Tangineering/DC-Balancer-Board-Teensy/controller_design/README.md

# controller_design — Robust H∞ / Youla-H Power Balance Controller

Design workspace for the controller that replaced `PI_Controller_Power()` in
`teensy_controller/teensy_controller.ino`, following
*A Practical Youla Gain-Tuning Framework for H∞ Controller Realization*
(`references/A_Practical_Youla_Gain_Tuning_Framework_for_H__Controller_Realization_20260603.pdf`).

**Status (2026-07-10): designed, implemented, and host-validated.** The Youla-H
controller ships in the firmware (`USE_YOULA_SHARE_CONTROLLER = 1`; legacy PI retained
as a fallback path). Remaining work is bench calibration → regenerate (see the
recalibration loop in `controller_synthesis.md` §7).

## Contents (read in this order)

| File | What it is |
|---|---|
| [`system_model.md`](system_model.md) | **Step 1 — the plant.** Droop circuit → programmable Thevenin source → parallel-source share statics → disturbance/uncertainty/noise budget → sampled-loop dynamics → design plant $G_P(s)$, parameter table with sources + `TODO(calibrate)`, bench-ID plan (§9). |
| [`validate_model.py`](validate_model.py) | Numerical validation of the plant derivation (stdlib Python; all checks pass). Found the firmware `k_eq` MDAC-saturation bug. |
| [`controller_synthesis.md`](controller_synthesis.md) | **Step 2 — the controller.** H∞ mixed-sensitivity setup, γ results, Youla-H $T(0)=1$ step, order reduction, discretization, the full validation table (60-corner sweep, margins, time domain, legacy-PI comparison), C++ mapping, recalibration loop. |
| [`hinf_synthesis.py`](hinf_synthesis.py) | Self-contained H∞ synthesis library (Riccati via Hamiltonian/Schur, DGKF central controller, H∞ norm, balanced truncation, c2d). Run directly for its self-tests. |
| [`synthesize_controller.py`](synthesize_controller.py) | **The pipeline.** Regenerates the firmware coefficients + reference vectors + figures data and re-runs every validation gate. Run after any parameter change. |
| [`plot_results.py`](plot_results.py) | Renders the three thesis figures from the CSVs. |
| [`bench_calibration_manual.md`](bench_calibration_manual.md) | **Step 3 — the bench.** Equipment, safety rules, and CAL-1…5 procedures for measuring every `TODO(calibrate)` value with State 98, plus the constant-update map and regeneration sequence, and a record-sheet template. |
| [`full_order_validation.md`](full_order_validation.md) | **Empirical validation of the simplified plant.** Full-order model (complete TPS61288 DS §9.2.2.5 dynamics, 11 states) vs the §6d design plant: derivation, 432-point envelope study, closed-loop equivalence with the shipped controller. |
| [`tps61288_full_model.py`](tps61288_full_model.py) | Builds the full-order model and runs the gate-checked comparison battery (Norton≡Eq.7, DC gain, crossover cross-check, Bode/envelope, discrete CL). Emits `fullorder_*.csv` + `fullorder_metrics.txt`. |
| [`full_order_model.m`](full_order_model.m) | MATLAB mirror of the full-order comparison (same state-space assembly); writes `MATLAB_fullorder_validation.txt` + `figures/MATLAB_fullorder_*.png`. |
| [`droop_plant.m`](droop_plant.m) | MATLAB cross-validation harness for the **shipped** controller: re-runs the synthesis with the exact shipped weights, parses `share_controller_coeffs.h`, and re-runs the corner/step/ramp battery on it. Writes `MATLAB_validation.txt` + three `figures/MATLAB_*.png` automatically. |
| `MATLAB_validation.txt` | GENERATED by `droop_plant.m` — the cross-validation log. (`MATLAB_results.txt` is the pre-alignment run kept for the record.) |
| [`reference_vectors.h`](reference_vectors.h) | GENERATED — Python-reference I/O replayed by the C++ unit test. |
| `synthesis_metrics.txt` | GENERATED — numeric summary of the current design. |
| `figures/` | Thesis figures (SVG) + raw CSV data: plant diagrams, loop shapes, controller Bode, step/ramp time domain. |

Firmware pieces live in `teensy_controller/`: `share_controller.h` (runtime),
`share_controller_coeffs.h` (GENERATED coefficients).

## Environment

```
uv venv ctrl-venv && uv pip install --python ctrl-venv numpy scipy matplotlib
ctrl-venv/Scripts/python hinf_synthesis.py        # library self-tests
ctrl-venv/Scripts/python validate_model.py        # plant-model checks
ctrl-venv/Scripts/python synthesize_controller.py # full pipeline + artifact regen
ctrl-venv/Scripts/python plot_results.py          # figures
cd ../test && mingw32-make                        # firmware host tests (MSYS2)
```

## Key results

- Plant: $\alpha = r + \Delta V_0 r(1-r)/(k_d I_{tot})$ — exactly unity nominal gain,
  delay-dominated dynamics ($T_d \approx 1$ ms at the 1 kHz loop).
- H∞: $\gamma_{opt} = 0.653$; Youla-H shifts the Y gain +0.0036 % → $T(0) = 1$ exact.
- Implemented controller: integrator ($k_I = 111.9$) + 3 biquad states at $T_s = 1$ ms.
- Robustness: all 60 parameter corners stable; worst $M_2 = 0.59$; delay margin 11.7 ms.
- vs legacy PI at the worst corner (discrete $\|S\|_\infty$): **1.87 vs 26.9**.
