Tangineering/DC-Balancer-Board-Teensy/controller_design_MIMO/mimo_comparison.md

# MIMO vs. Decentralized — Comparison Results (Phase 5)

> ## ⚠ STALE — built on a retired plant (2026-08-16)
>
> Every number in this document was produced against the **pre-calibration** drive plant.
> The drive channel was measured on 2026-08-16 (`calibration/motor_id_20260815.md`), moving
> `G22(0)` 3.7085 → 1.4112 (m/s)/A, the drive pole −0.1219 → −0.0914 rad/s and `G12(0)`
> −2.757e-2 → −1.326e-2, with the clamp 20 A → 12 A. Drive-channel and coupling figures
> throughout are therefore stale — including the "slowest closed-loop mode 0.1219 rad/s"
> row in the headline table, which *is* the old drive pole and moves with it.
>
> `compare_controllers.py` cannot regenerate this document as it stands: it hard-crashes at
> stage 6 on a 20 A clamp assertion, and the MIMO controller it compares against no longer
> passes its own synthesis gates on the calibrated plant. Restoring the comparison is a new
> synthesis round, not a re-run. Scope and per-stage detail: `README.md` staleness banner.
>
> The document is kept as the published record of the ±20 A round.

**Status:** complete. All numbers in this document are emitted by
`compare_controllers.py` into `comparison_metrics.txt`; the metric key is quoted in every
table. Figures are produced by `plot_mimo_results.py` from the CSVs in `figures/`.

**Reproduce:**

```
ctrl-venv/Scripts/python.exe compare_controllers.py     # ~50 s, writes comparison_metrics.txt + figures/*.csv
ctrl-venv/Scripts/python.exe plot_mimo_results.py       # ~5 s,  writes figures/fig_*.svg
```

This document mirrors the rigour convention of `controller_design/full_order_validation.md`:
setup first, then the metric tables with their provenance keys, then a findings section that
answers the questions posed in `papers/Droop_Control/sections/06_mimo_outlook.tex`, then the
honest caveats, then a claim-slot map. **`06_mimo_outlook.tex` itself is NOT edited by this
round** — this document is the evidence base a later writing round would draw on.

> **±20 A recalibration round — 2026-08-04.** `MOTOR_I_CMD_MAX` / `I_CLAMP` moved
> **5 A → 20 A** and both controllers were re-synthesized. **Every number in this document
> is regenerated at ±20 A.** The superseded ±5 A figures are not deleted — §14 is a dated
> summary of what changed and why, and individual tables carry the old value where the
> comparison is instructive. Read §14 first if you have the ±5 A version in mind.

---

## 1. What is compared

| | **`dec`** (decentralized baseline) | **`dec500`** (rate-confound variant) | **`mimo`** (centralized) |
|---|---|---|---|
| Structure | `blkdiag(K_share, K_drive)` | same | full 2×2 |
| Share half | shipped Youla-H share controller, **1 kHz** | same controller re-discretized (Tustin) at **500 Hz** | — |
| Drive half | Phase-3 SISO Youla-H drive controller, **500 Hz** | same | — |
| Whole | — | — | Phase-4 2×2 H∞ / Youla-H, **500 Hz** |
| Continuous states | 9 (4 share + 5 drive) | 9 | **9** (2 exact integrators + **7** modal) |
| Anti-windup | share: back-calculation on the integrator (the shipped scheme); drive: **Hanus self-conditioning** (required — see §7) | same | `Du⁻¹·δ` back-calculation on the integrator subspace + authority clamp |
| Metric keys | `ctrl.dec.*` | — | `ctrl.mimo.*` |

The essential fairness condition: **both controllers are closed against the same coupled
2×2 plant**, using the same closed-loop assembly routine (`loop_matrices`, copied verbatim
from `synthesize_mimo_controller.py`), the same corner sets, and the same simulations. The
decentralized controller is never evaluated on a diagonal plant — that would flatter it by
construction.

### 1.1 Corner sets

* **Tier 1** (stability): the full `plant_mimo.tier1_corners()` cross product, 10 OPs × 24
  share corners × 24 drive corners = 5760, of which **4992 are feasible**
  (`tier1.n_feasible`) and 768 are skipped as unidirectional-switch-clamped operating points
  (`tier1.n_infeasible_skipped`).
* **Tier 2** (performance): the rep set is **copied verbatim** from
  `synthesize_mimo_controller.py:549–596` — 6 share reps × 4 drive reps × the OP grid, minus
  infeasible combinations = **208 corners** (`tier2.n_corners`), of which **168 are
  in-envelope** (`tier2.n_corners_in_envelope`) and 40 fall in the two documented waiver
  families (24 FC-cruise, 16 K-out-of-envelope). The waiver policy and its physical
  justification are copied along with the rep set, so the two controllers are judged on
  identical terms.

### 1.2 Rates and simulation

Time-domain results use a **multirate discrete simulator**, base step **0.1 ms**, plant
ZOH-discretized at the base rate per corner, controller outputs held between ticks. `dec`
runs its two halves at their native 1 kHz / 500 Hz; `mimo` runs single-rate at 500 Hz;
`dec500` exists purely to isolate the rate difference as a confound.

Frequency-domain results use **continuous** physical-coordinate controllers, recovered from
the emitted headers by exact inverse-Tustin plus the analytic `KI/s` integrator, so the two
controllers are compared as 2×2 systems `e = [Δα_err; Δv_err] → u = [Δr; Δi_cmd]`.

**All time-domain signals are small-signal deviations about the operating point** (nominal
OP: `I_tot0 = 2 A`, `r0 = 0.5`, `ΔV0 = +0.2 V`, `v0 = 2 m/s`). Every step amplitude is stated
in the tables, and the actuator-limited cases are flagged.

---

## 2. Metric 1 — coupling quantification (plant only)

This is the evidence for "is the decentralized design justified or merely convenient".

| Quantity | nominal (2 A, r=0.5) | light load (0.5 A) | FC cruise (r=0.85) | key |
|---|---|---|---|---|
| peak \|G_s,12\|/\|G_s,11\| | 1.5710 | **25.136** | 1.0451 | `coupling.*.max_G12_over_G11` |
| same, at DC | 1.5710 | 25.136 | 1.0451 | `coupling.*.G12_over_G11_at_dc` |
| cond(G_s) at DC | 21.238 | 51.064 | 27.588 | `coupling.*.cond_Gs_at_dc` |
| cond(G_s), in-band (DC…200 rad/s) | 101.9 | 6429.5 | 67.5 | `coupling.*.max_cond_Gs_inband` |
| ∂α/∂I_tot [share/A] | −0.04167 | **−0.66667** | −0.02125 | `coupling.*.dalpha_dItot` |

Over the whole feasible OP × ΔV0 grid (26 of 30 points feasible,
`coupling.dalpha_dItot.n_feasible`):

| Quantity | Value | Where | Key |
|---|---|---|---|
| worst \|∂α/∂I_tot\| | **1.120 share/A** | 0.5 A, r0=0.7, ΔV0=−0.4 V | `coupling.dalpha_dItot.max_abs_feasible` |
| worst DC cond(G_s) | 51.15 | — | `coupling.grid.max_cond_Gs_at_dc` |
| worst in-band cond(G_s) | 8834.6 | 0.5 A, r0=0.3, ΔV0=+0.4 V | `coupling.grid.max_cond_Gs_inband` |
| worst \|G_s,12\|/\|G_s,11\| | 25.14 | 0.5 A, r0=0.5, ΔV0=+0.2 V | `coupling.grid.max_G12_over_G11` |
| max \|RGA − I\| | **2.23e−16** | all cases, all frequencies | `coupling.max_RGA_departure_from_I` |

**Structure.** The design plant is *structurally upper-triangular* (`G21 ≡ 0`: the droop
ratio does not move the wheel speed), so the RGA is the identity to machine precision at
every frequency and every corner. RGA-based interaction measures therefore say *nothing*
here — a one-directional coupling is invisible to the RGA. This is a real methodological
point for the paper: **the RGA is the wrong instrument for this plant**, and the correct
instruments are the directional ratio |G12|/|G11| and the closed-loop cross-transfer
‖T_{α←v_ref}‖ (§3).

**These ratios are SCALED quantities and moved 4× with the clamp.** `G_s,12` carries
`Du(2,2)` (5 → 20 A) while `G_s,11` carries the unchanged `Du(1,1)`. The **physical**
coupling is identical to the ±5 A round; what changed is the units the synthesis and these
tables express it in. ±5 A values: 0.393 / 6.284 / 0.261 nominal / light-load / FC-cruise.

**Magnitude.** The coupling is not negligible and is strongly operating-point-dependent: at
the nominal 2 A load the drive-to-share path is now **1.6×** the direct path — it was 39 % of
it at ±5 A — and at 0.5 A it is **25×** the direct path, because ∂α/∂I_tot scales as
1/I_tot². That the nominal ratio crossed 1 is the substantive change: at the design point a
full-authority motor transient now has **more** authority over the share than a full-authority
droop command does. It is also **sign-uncertain**:
it is exactly zero at ΔV0 = 0 and flips sign with ΔV0, whose sign is not known
(±0.4 V budget). That single fact bounds everything a MIMO feedforward can buy — see §9.

*Note on the condition number:* the "in-band" window (DC…200 rad/s) is used deliberately.
cond(G_s(jω)) → ∞ as ω → ∞ for any strictly-proper plant whose two channels roll off at
different orders, so the full-sweep maximum (`coupling.*.max_cond_Gs_full_sweep`,
3.7e3–1.9e4) measures roll-off asymmetry, not coupling, and would be misleading in a table.

**Figures:** `fig_coupling_sigma.svg` (σ̄/σ̲ of G_s + the |G12|/|G11| overlay),
`fig_coupling_cond.svg`, `fig_coupling_gain_grid.svg`.

---

## 3. Metric 2 — worst-corner sensitivity, identical Tier-2 set

### 3.1 Nominal plant

| Quantity | `dec` | `mimo` | key |
|---|---|---|---|
| ‖S_o‖∞ (σ̄ peak) | 1.3974 | **1.2287** | `nominal.*.sigma_So_peak` |
| \|S11\| peak (share) | 1.2523 | **1.2114** | `nominal.*.S11_peak` |
| \|S22\| peak (drive) | 1.3851 | **1.2285** | `nominal.*.S22_peak` |
| ‖T_{α←v_ref}‖∞ [share/(m/s)] | 0.25676 | **0.00131** | `nominal.*.T_alpha_from_vref_peak` |
| slowest closed-loop mode [rad/s] | 0.00400 | **0.1219** | `nominal.*.max_real_cl_pole` |
| σ̄(S_u) peak (input node) | 1.3852 | **1.2385** | `compute_Su.py` |

The `dec` column is **unchanged from the ±5 A round** — every quantity here is a linear
frequency-domain one, and the decentralized controller was not re-synthesized (its clamp
metadata moved, its dynamics did not). Only the MIMO column moves.

At the nominal design point the MIMO controller reduces the closed-loop cross-coupling
transfer by a factor of **195** (±5 A: 293). This is the headline "MIMO buys coupling rejection" number —
and §9 explains exactly why it does not survive the ΔV0 sign flip.

### 3.2 Tier-2 corner family (168 in-envelope corners)

| Quantity | `dec` | `mimo` | key |
|---|---|---|---|
| worst σ̄(S_o), in-envelope | 2.5535 | **1.8754** | `tier2.*.worst_sigma_So_in_envelope` |
| worst \|S11\| peak | 1.5769 | **1.3721** | `tier2.*.worst_S11_peak_in_envelope` |
| worst \|S22\| peak | 2.4062 | **1.6743** | `tier2.*.worst_S22_peak_in_envelope` |
| worst ‖T_{α←v_ref}‖∞ | 0.8480 | **0.8020** | `tier2.*.worst_T_alpha_from_vref_in_envelope` |
| continuous-unstable corners | 0 | 0 | `tier2.*.n_unstable` |
| worst σ̄(S_o), FC-cruise (waived) | 2.4960 | **1.7471** | `tier2.*.waived_FC_cruise_worst_sigma_So` |
| worst σ̄(S_o), K-out-of-envelope (waived) | **5.7702** | 4.9334 | `tier2.*.waived_K_out_of_envelope_worst_sigma_So` |
| σ̄(S_u), worst Tier-2 corner (input node) | 1.8640 | **1.4749** | `compute_Su.py` |

Head-to-head: MIMO has the lower σ̄(S_o) at **167 of 168** in-envelope corners
(`tier2.mimo_better_sigma_So_count`; ±5 A: 156 of 168). The Phase-4 numbers reproduce exactly
(worst in-envelope 1.8754; waived K-out-of-envelope 4.9334), confirming the harness assembles
the MIMO loop the same way its synthesis script did.

**Two ±20 A reversals worth naming.** (a) The MIMO controller now wins the **worst-corner
cross-coupling transfer** too (0.8020 vs 0.8480) — at ±5 A the decentralized pair won that
row (0.8480 vs 1.1467). (b) The MIMO controller is now **better than** the decentralized pair
on the waived K-out-of-envelope family (4.93 vs 5.77) where at ±5 A it was nearly 2× worse
(10.82 vs 5.77). Both are consequences of the it.5 weight re-tune
(`mimo_synthesis.md` §3.2), which bought corner robustness at the price of γ and of a little
nominal performance.
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
