Tangineering/DC-Balancer-Board-Teensy/controller_design/figures/MATLAB-Fig-1.png

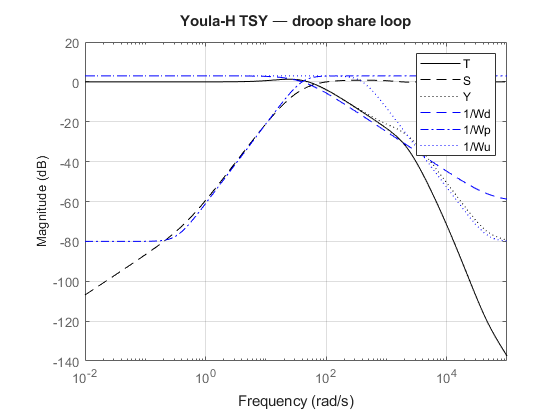
controller_design/figures/MATLAB-Fig-1.png
