Tangineering/DC-Balancer-Board-Teensy/controller_design/figures/MATLAB-Fig-2.png

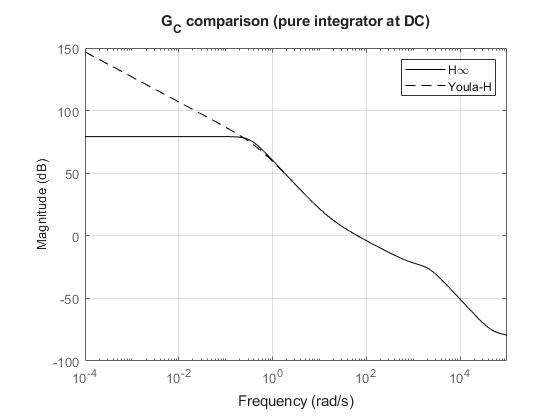
controller_design/figures/MATLAB-Fig-2.png
