Tangineering/DC-Balancer-Board-Teensy/controller_design/figures/MATLAB_Gc_shipped_vs_matlab.png

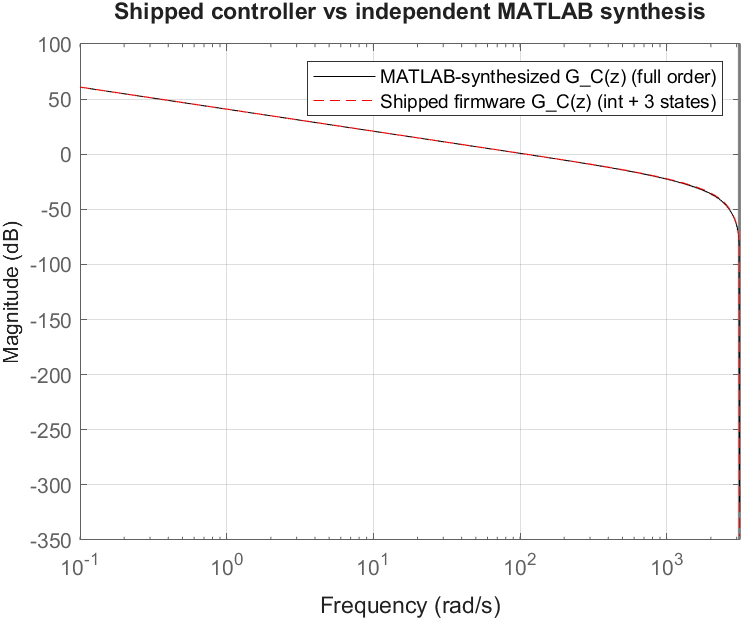
controller_design/figures/MATLAB_Gc_shipped_vs_matlab.png
