Tangineering/DC-Balancer-Board-Teensy/controller_design/figures/MATLAB_loopshapes_exactweights.png

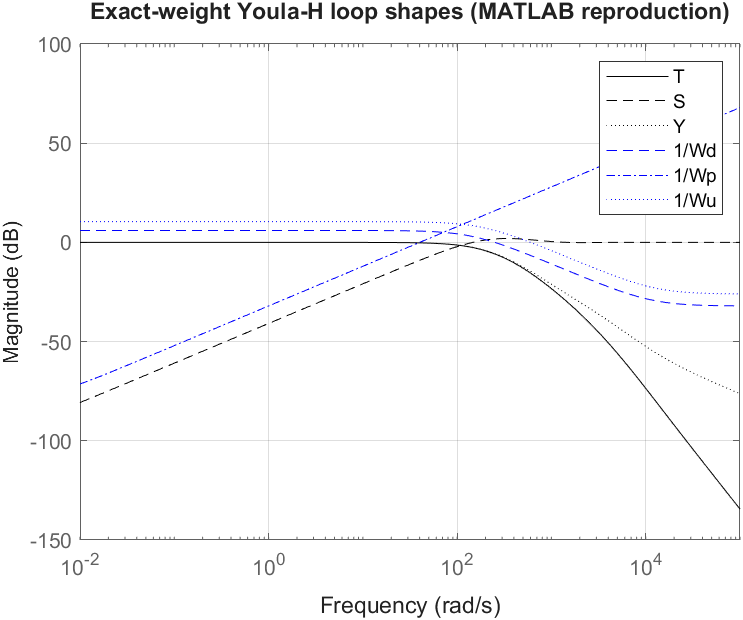
controller_design/figures/MATLAB_loopshapes_exactweights.png
