Tangineering/DC-Balancer-Board-Teensy/controller_design_MIMO/figures/MATLAB_mimo_corner_scatter.png

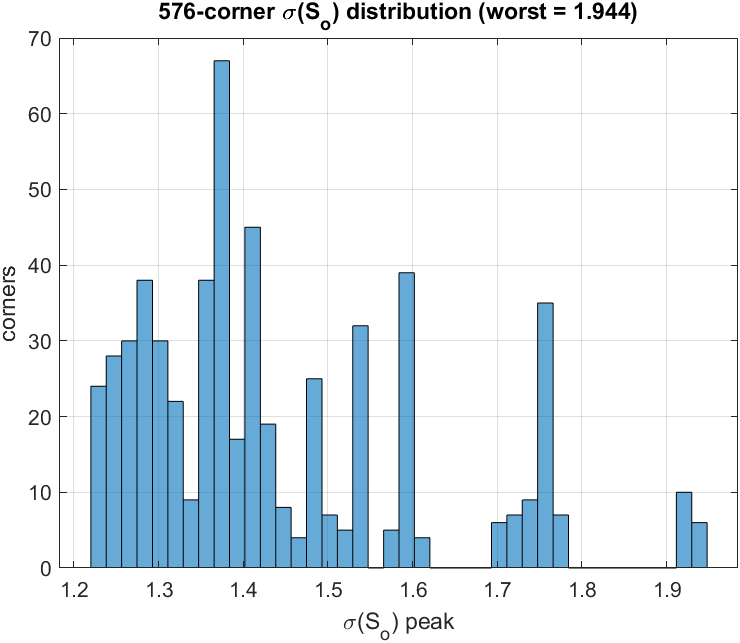
controller_design_MIMO/figures/MATLAB_mimo_corner_scatter.png
