Tangineering/DC-Balancer-Board-Teensy/controller_design_MIMO/figures/MATLAB_mimo_sigmaS.png

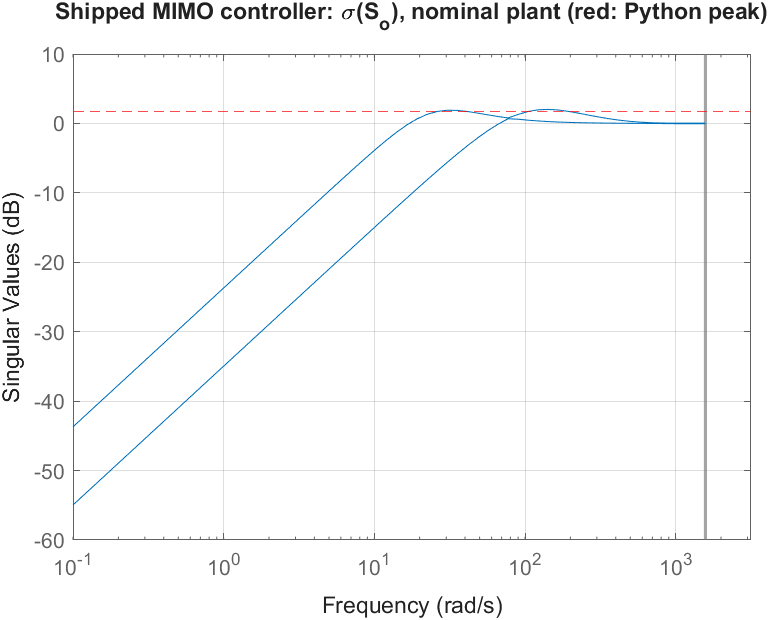
controller_design_MIMO/figures/MATLAB_mimo_sigmaS.png
