Tangineering/DC-Balancer-Board-Teensy/docs/balancer_board_showcase_20260817/balancer_board_showcase_20260817/03_setpoint_governor/TP0116/bus_and_share.png

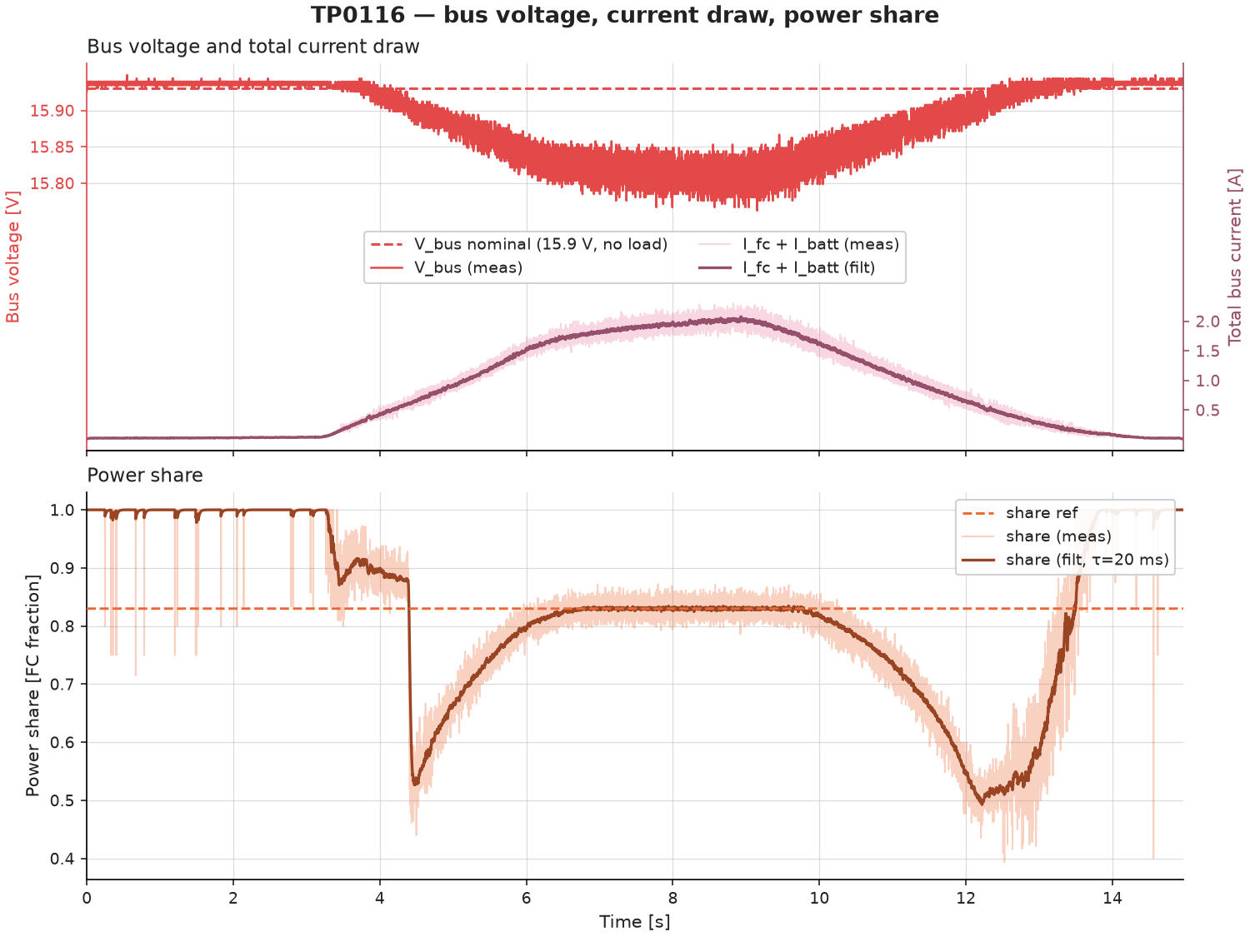
docs/balancer_board_showcase_20260817/balancer_board_showcase_20260817/03_setpoint_governor/TP0116/bus_and_share.png
