Tangineering/DC-Balancer-Board-Teensy/docs/balancer_board_showcase_20260817/balancer_board_showcase_20260817/04_open_closed_loop_handoff/handoff_threshold_bracket.png

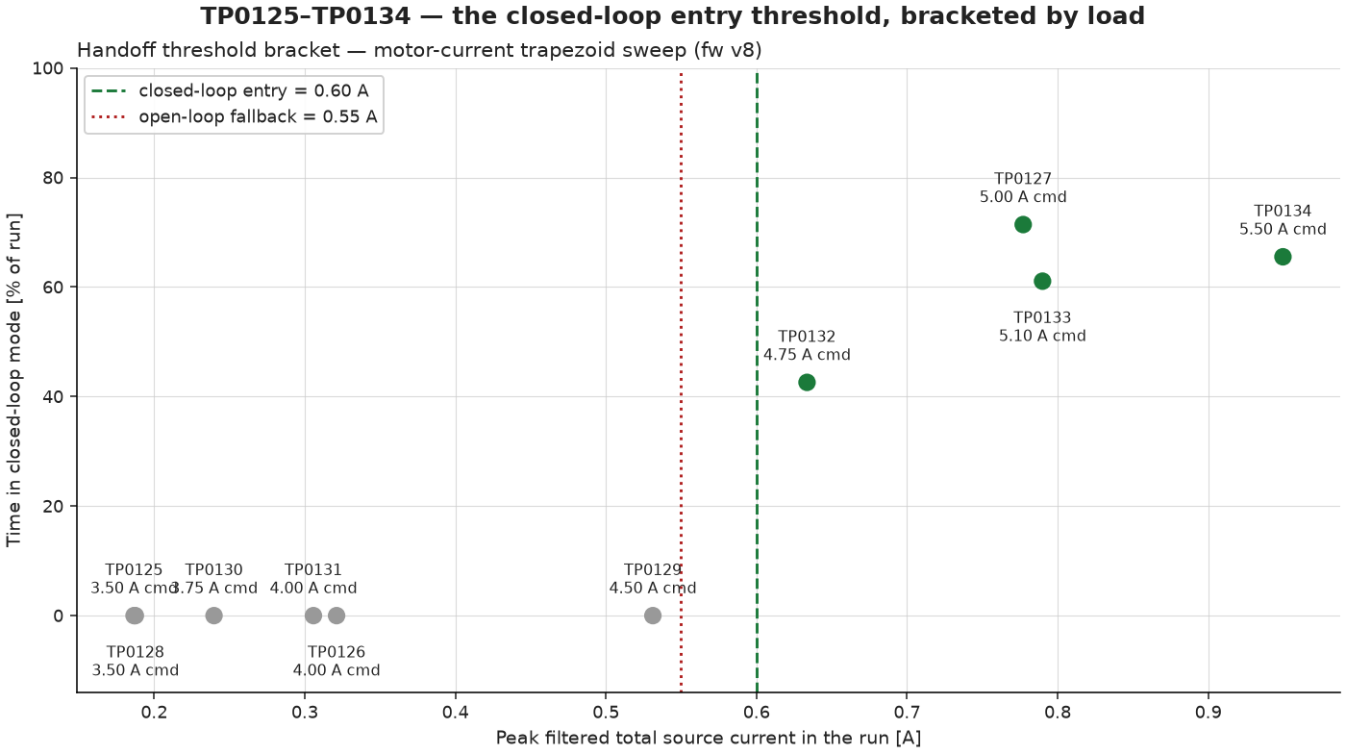
docs/balancer_board_showcase_20260817/balancer_board_showcase_20260817/04_open_closed_loop_handoff/handoff_threshold_bracket.png
