Tangineering/DC-Balancer-Board-Teensy/docs/balancer_board_showcase_20260817/balancer_board_showcase_20260817/04_open_closed_loop_handoff/TP0129/bus_and_share.png

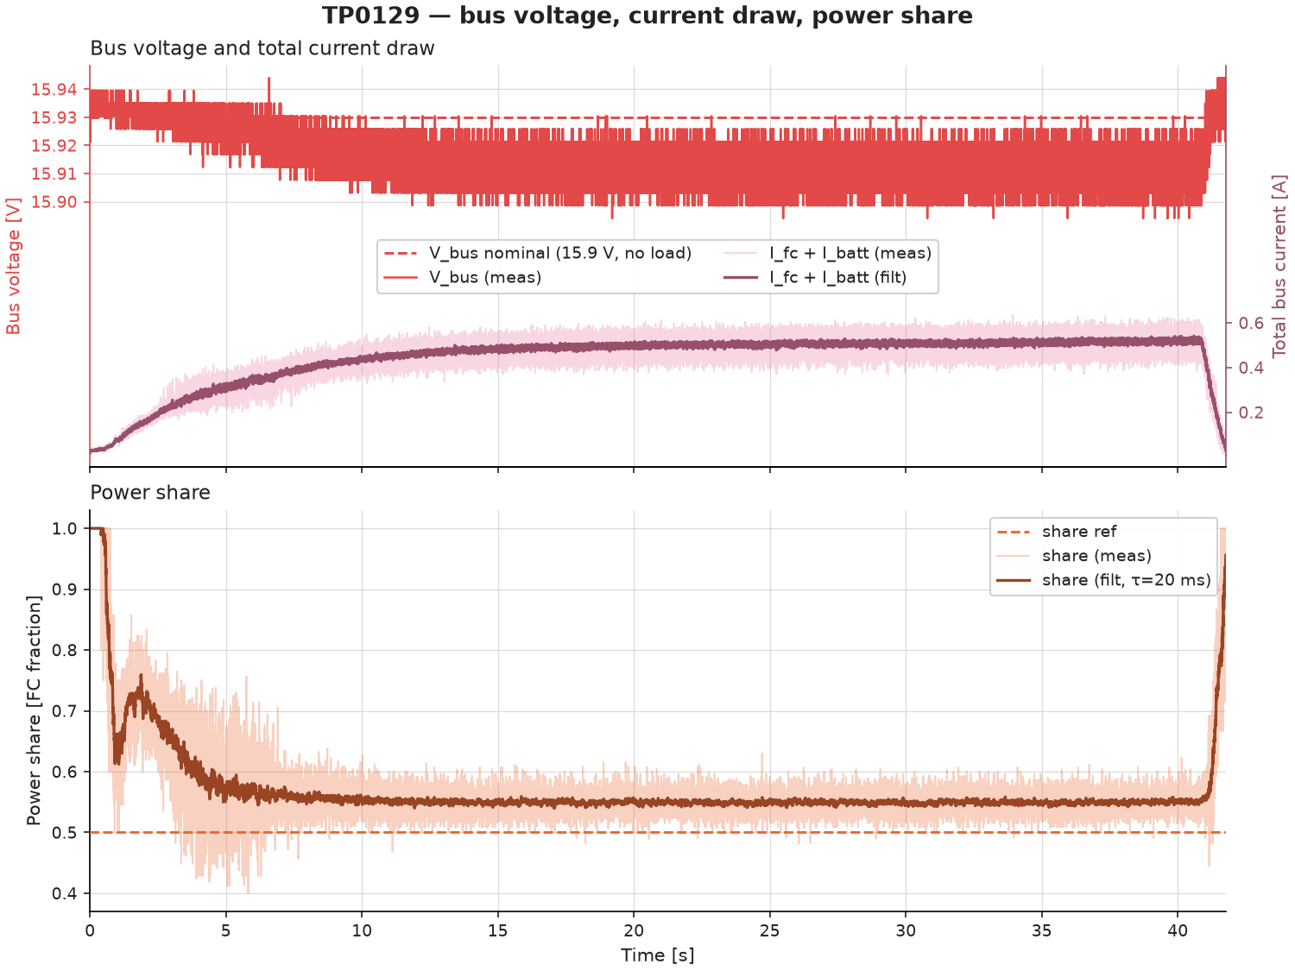
docs/balancer_board_showcase_20260817/balancer_board_showcase_20260817/04_open_closed_loop_handoff/TP0129/bus_and_share.png
