Tangineering/DC-Balancer-Board-Teensy/docs/modeling/asymmetry_fit_20260901/by_firmware.png

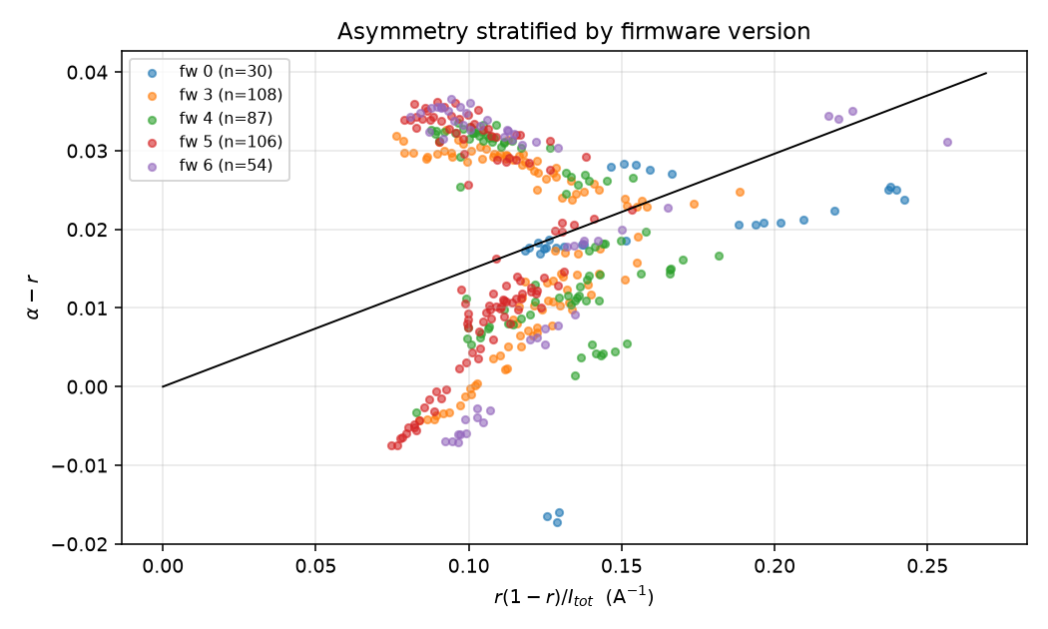
docs/modeling/asymmetry_fit_20260901/by_firmware.png
