Tangineering/DC-Balancer-Board-Teensy/docs/modeling/asymmetry_fit_20260901/r_vs_alpha.png

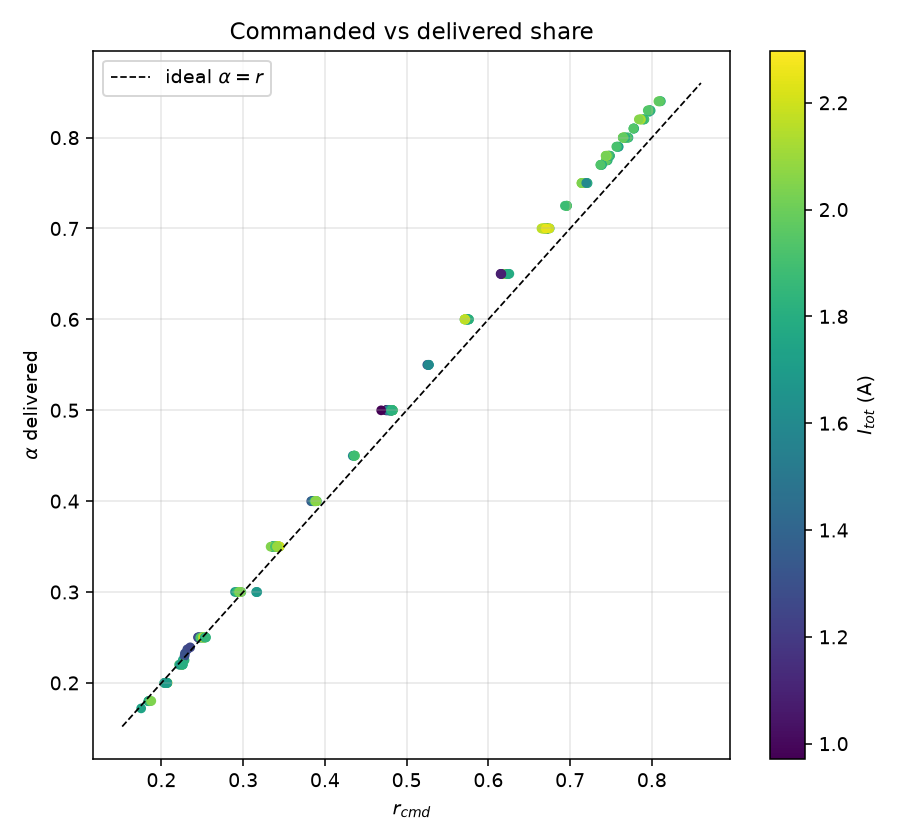
docs/modeling/asymmetry_fit_20260901/r_vs_alpha.png
