Tangineering/DC-Balancer-Board-Teensy/docs/modeling/bond-graph-bgt/00_top_level.png

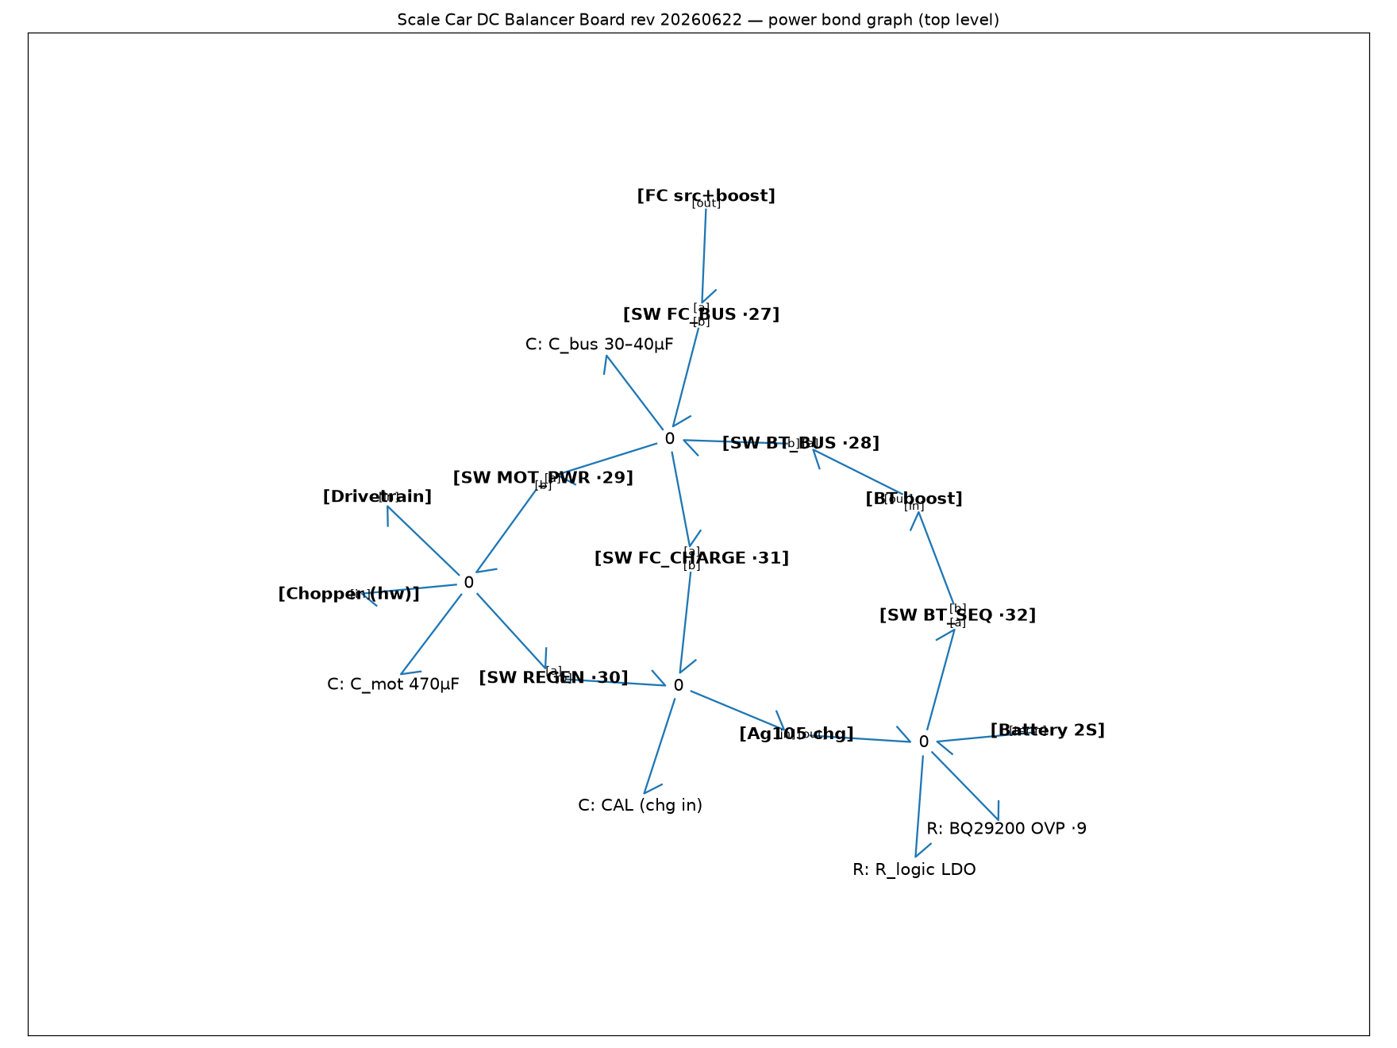
docs/modeling/bond-graph-bgt/00_top_level.png
