Tangineering/DC-Balancer-Board-Teensy/docs/modeling/bond-graph-bgt/01_fc_source_boost.png

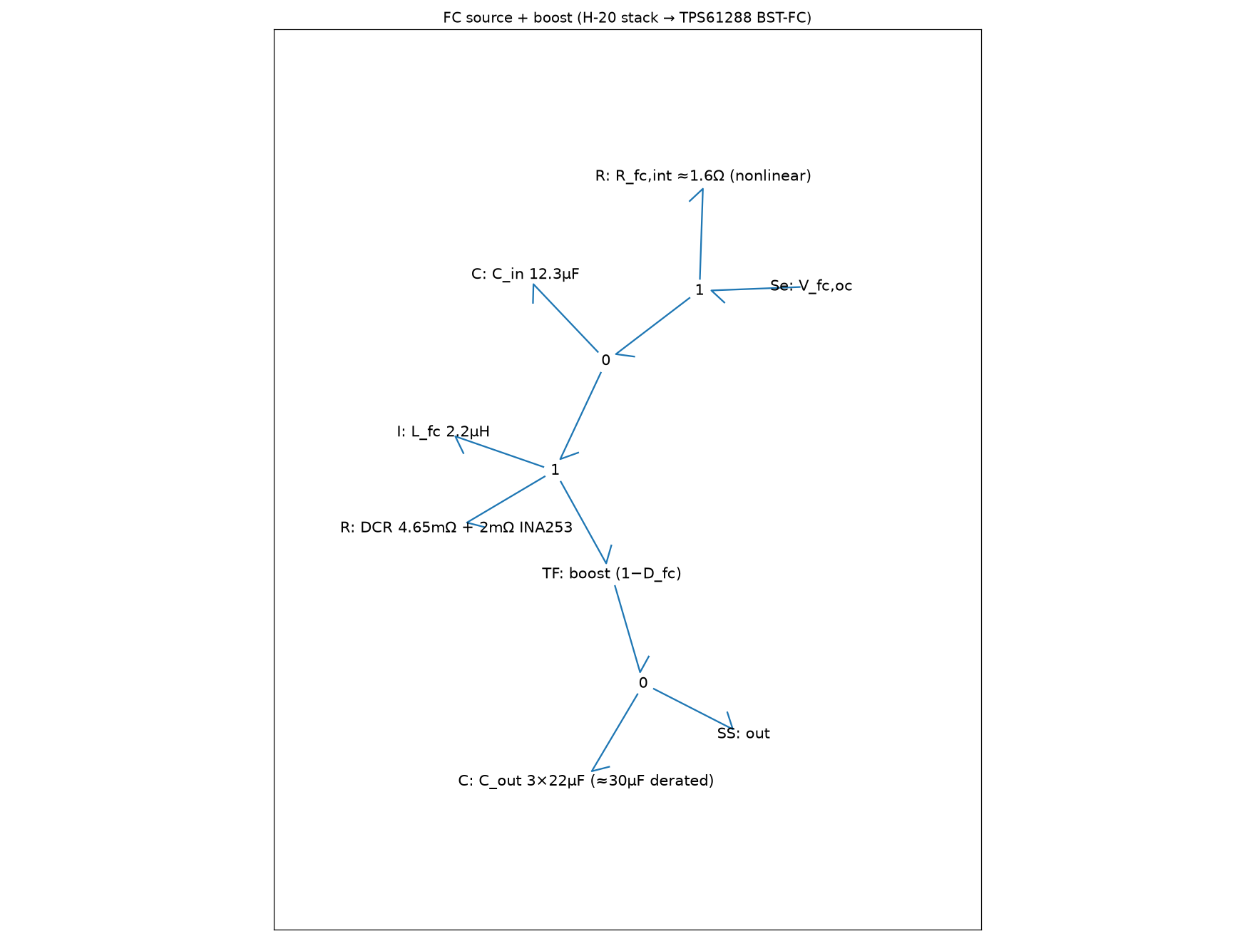
docs/modeling/bond-graph-bgt/01_fc_source_boost.png
