Tangineering/DC-Balancer-Board-Teensy/docs/modeling/bond-graph-bgt/02_bt_boost.png

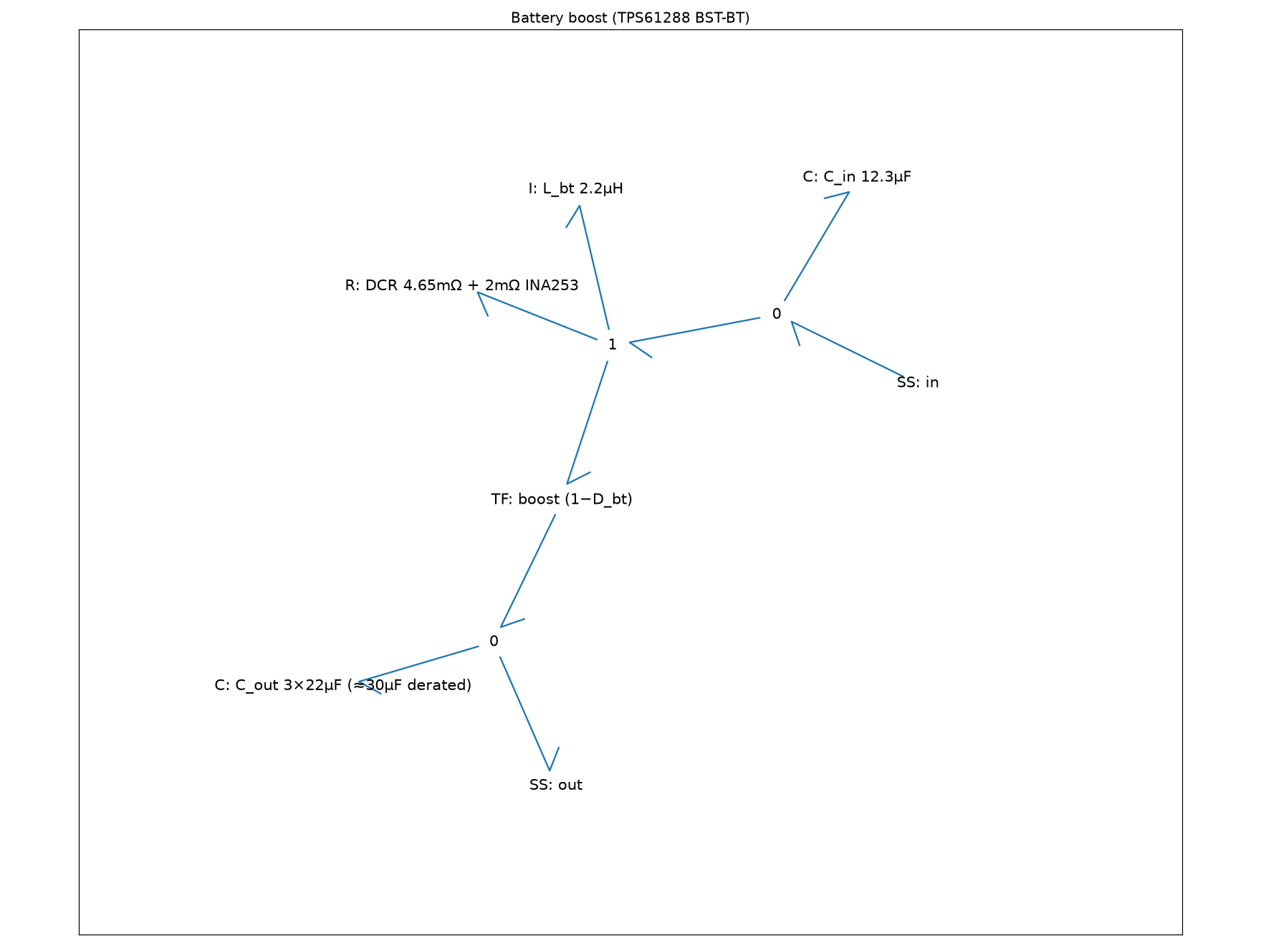
docs/modeling/bond-graph-bgt/02_bt_boost.png
