Tangineering/DC-Balancer-Board-Teensy/docs/modeling/bond-graph-bgt/03_battery_pack.png

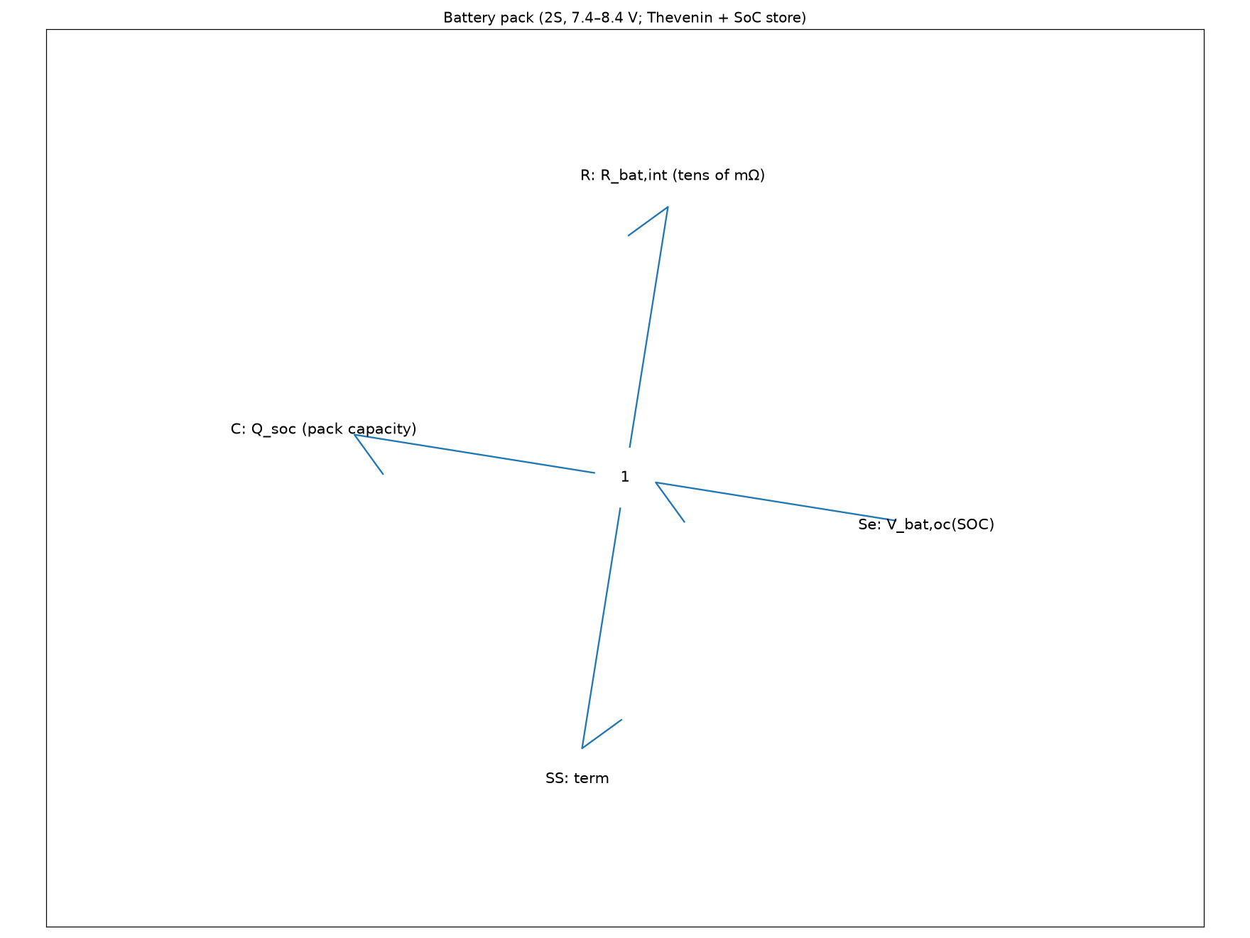
docs/modeling/bond-graph-bgt/03_battery_pack.png
