Tangineering/DC-Balancer-Board-Teensy/docs/modeling/bond-graph-bgt/05_drivetrain_vehicle.png

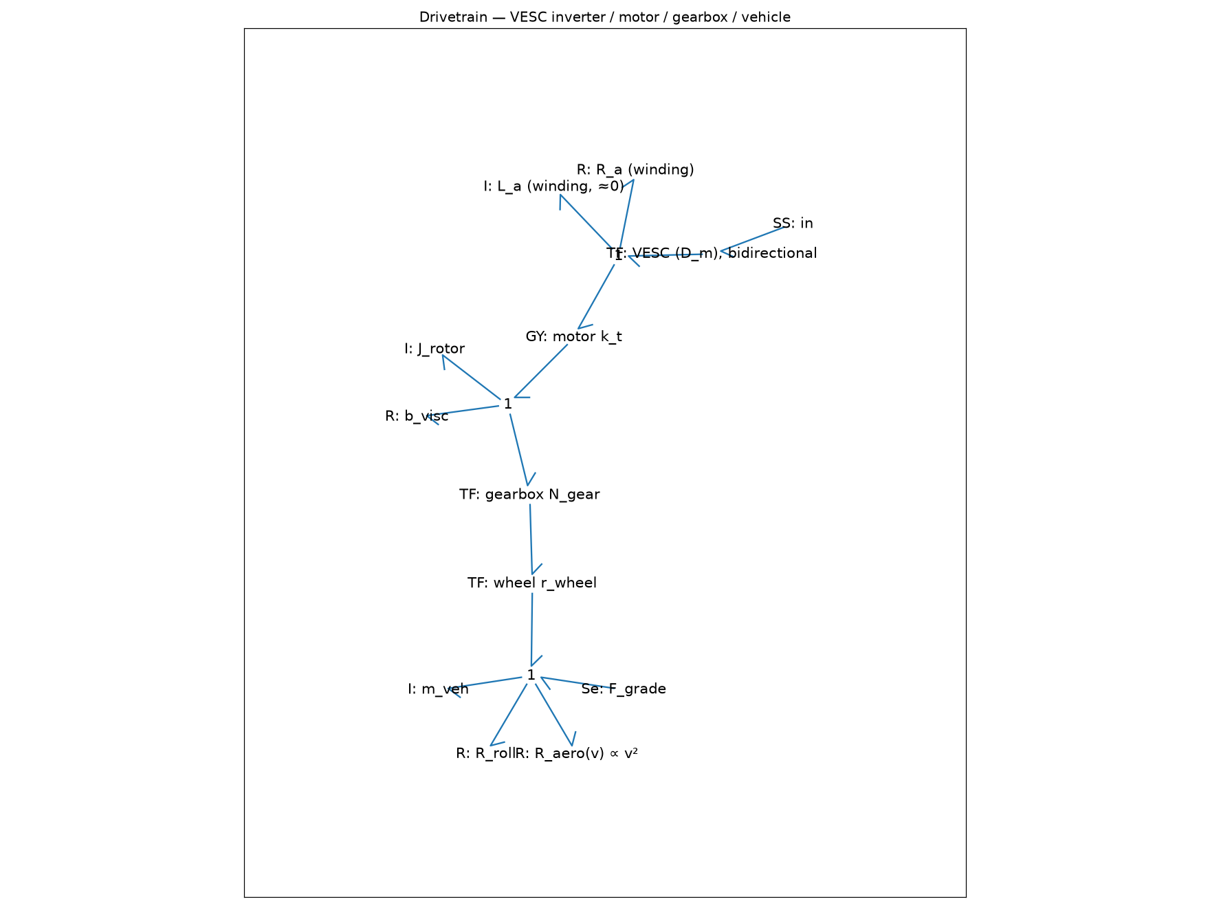
docs/modeling/bond-graph-bgt/05_drivetrain_vehicle.png
