Tangineering/DC-Balancer-Board-Teensy/docs/modeling/bond-graph-bgt/06_drivetrain_bench.png

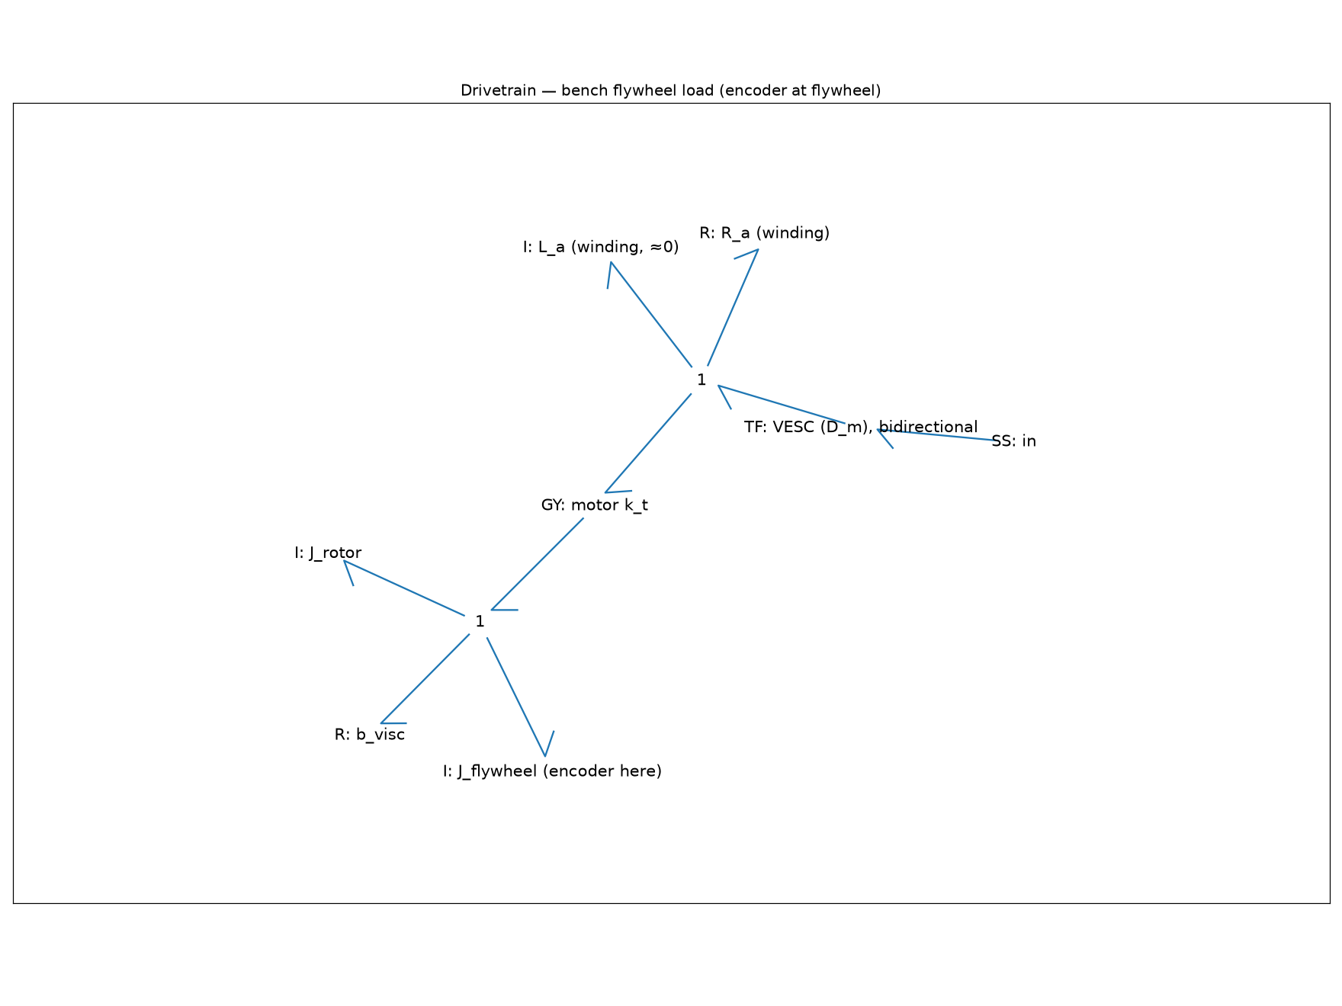
docs/modeling/bond-graph-bgt/06_drivetrain_bench.png
