Tangineering/DC-Balancer-Board-Teensy/docs/modeling/bond-graph-bgt/07_brake_chopper.png

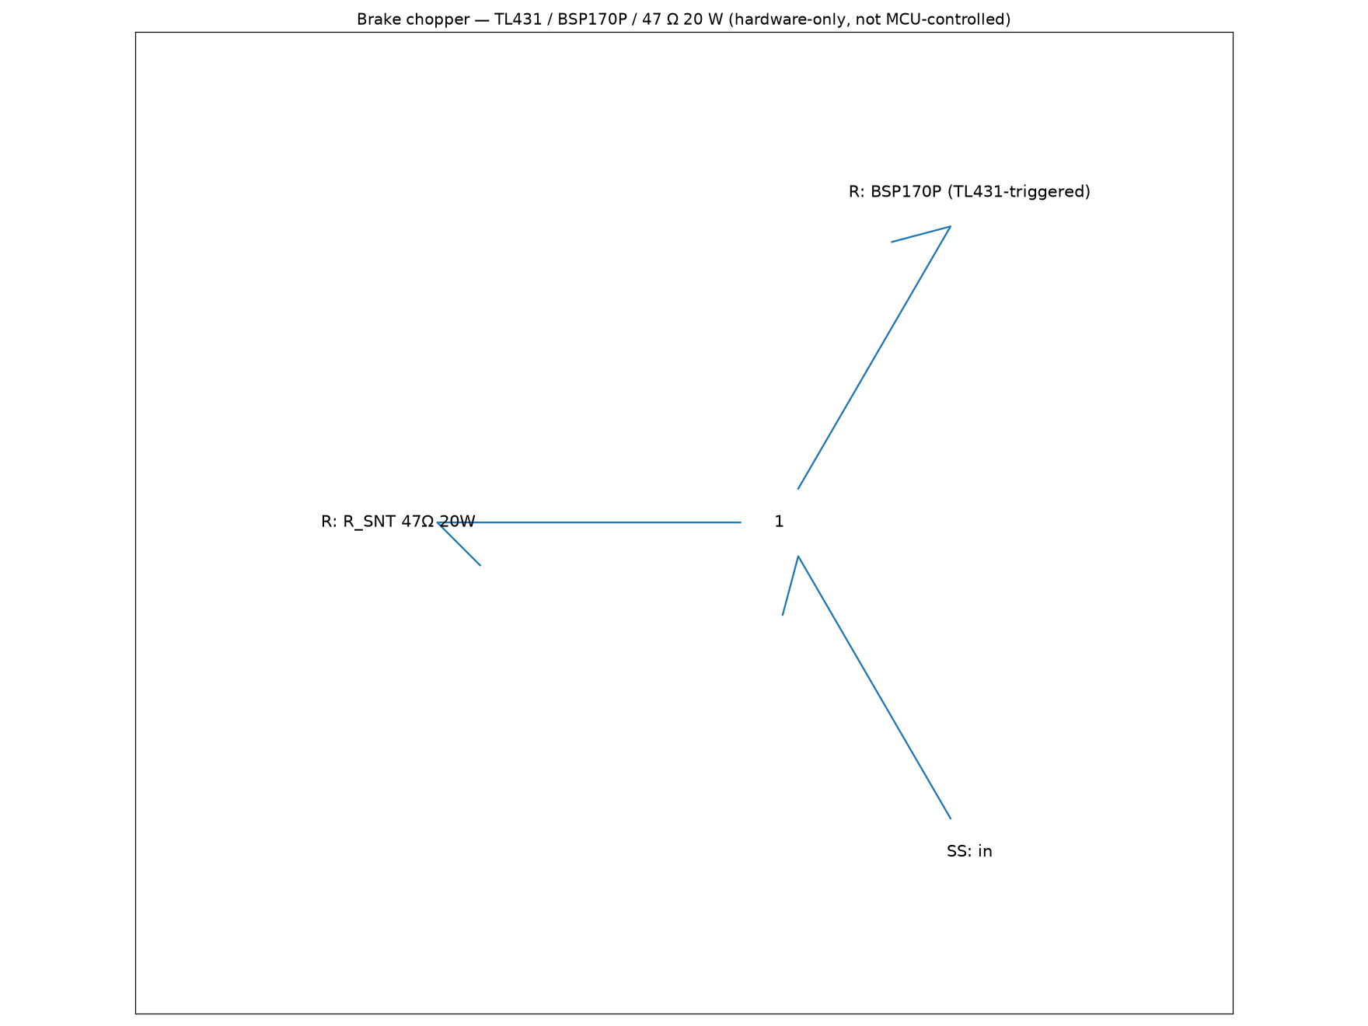
docs/modeling/bond-graph-bgt/07_brake_chopper.png
