Tangineering/DC-Balancer-Board-Teensy/docs/modeling/bond-graph-bgt/08_ag105_charger.png

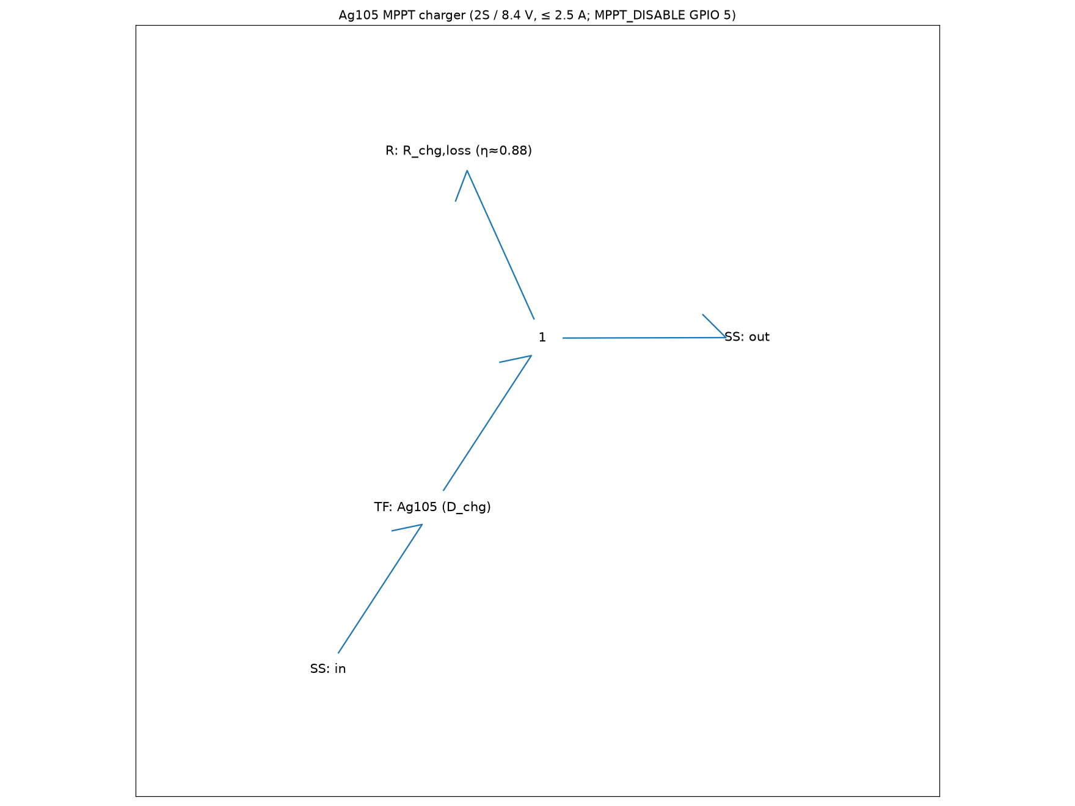
docs/modeling/bond-graph-bgt/08_ag105_charger.png
