Tangineering/DC-Balancer-Board-Teensy/docs/modeling/sdp_alpha_sweep_20260901/plots/ems-ftp75-sdp/alpha_31_0.220110/walk_hil_charger_and_soc.png

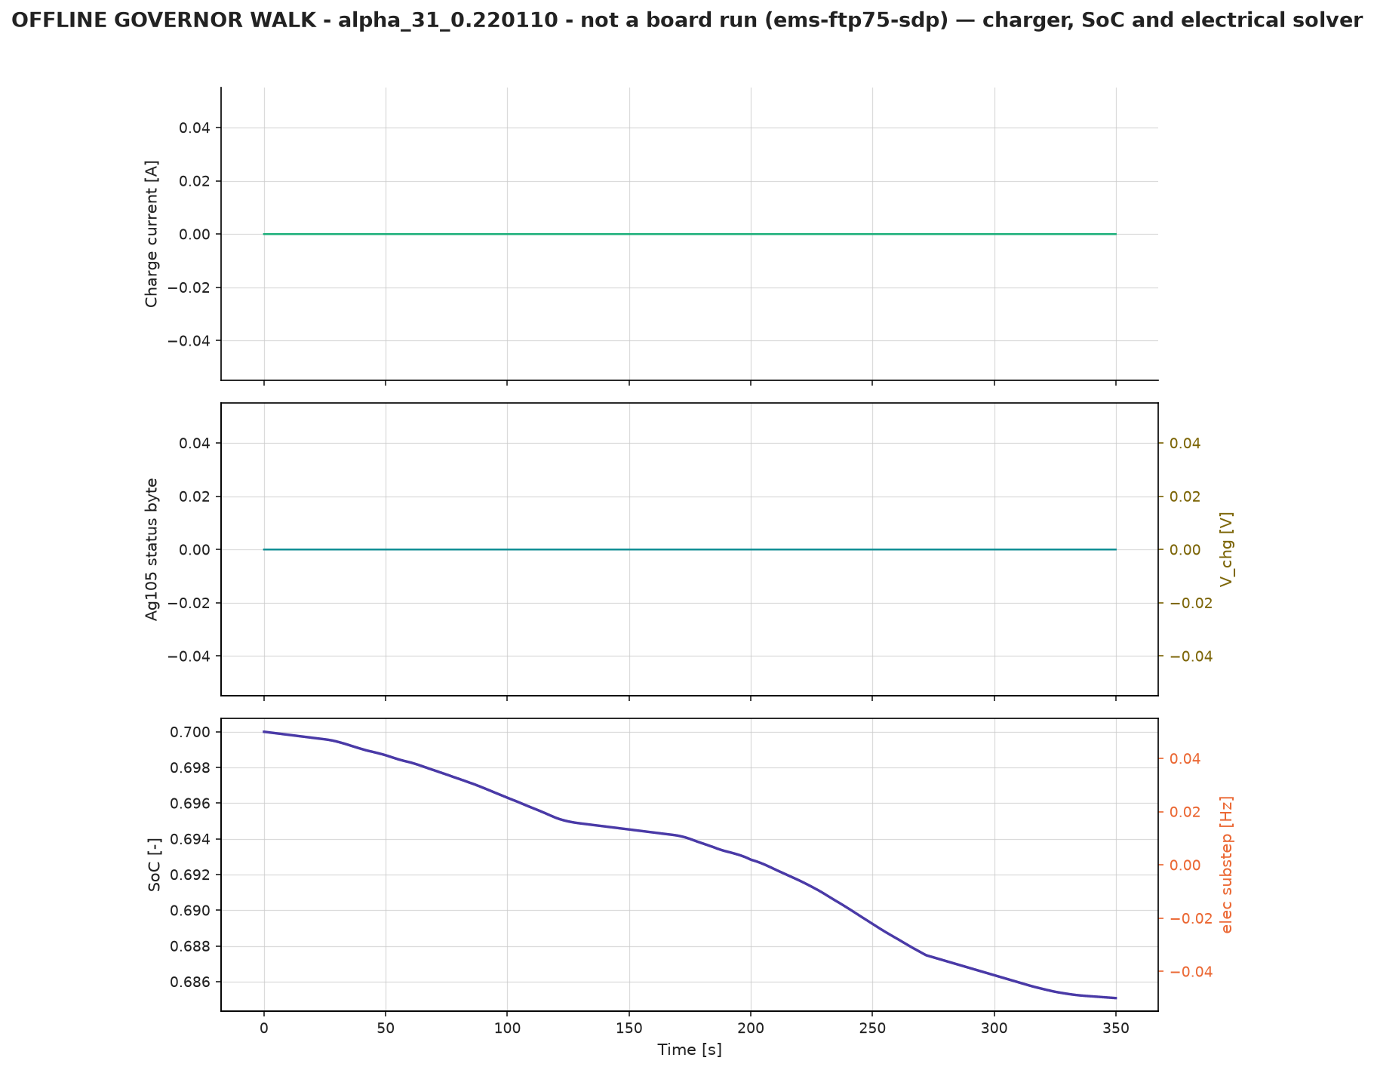
docs/modeling/sdp_alpha_sweep_20260901/plots/ems-ftp75-sdp/alpha_31_0.220110/walk_hil_charger_and_soc.png
