Tangineering/DC-Balancer-Board-Teensy/docs/modeling/sdp_alpha_sweep_20260901/plots/ems-ftp75-sdp/alpha_32_0.229680/walk_currents_and_share.png

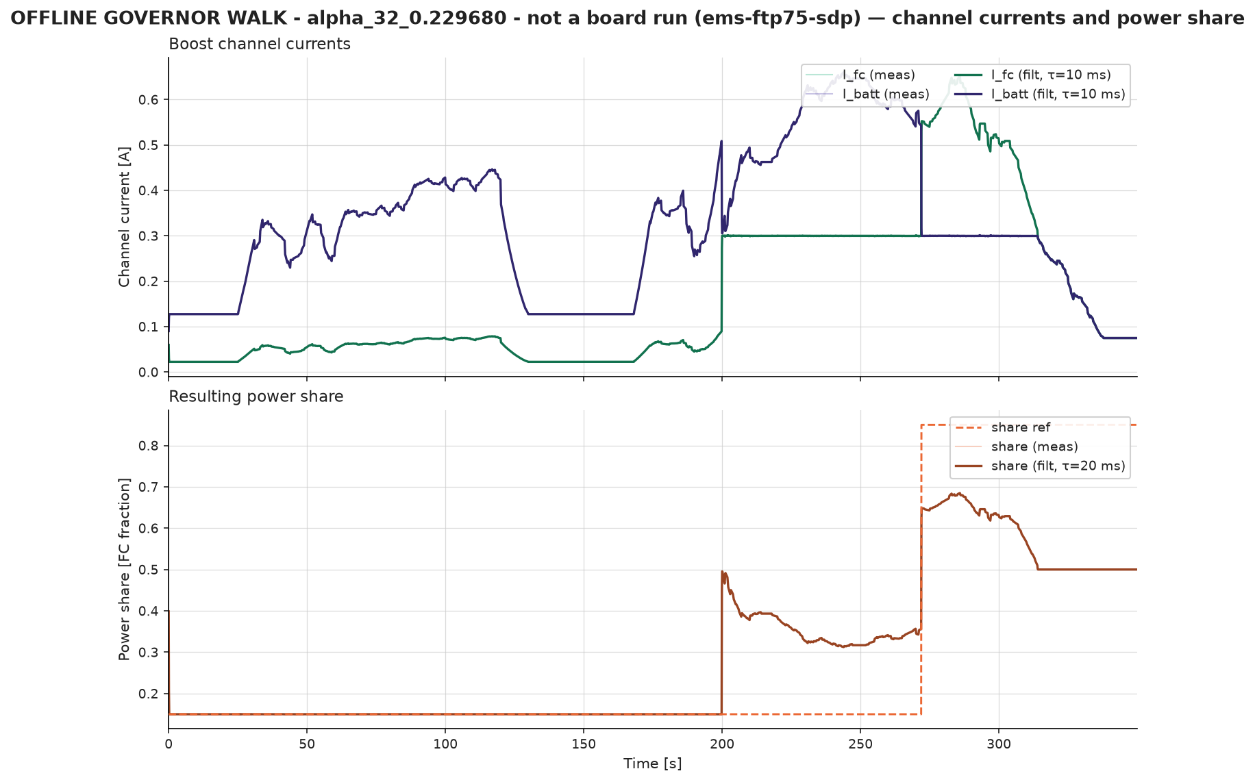
docs/modeling/sdp_alpha_sweep_20260901/plots/ems-ftp75-sdp/alpha_32_0.229680/walk_currents_and_share.png
