Tangineering/DC-Balancer-Board-Teensy/docs/modeling/sdp_alpha_sweep_20260901/plots/ems-ftp75-sdp/alpha_36_0.240446/walk_currents_and_share.png

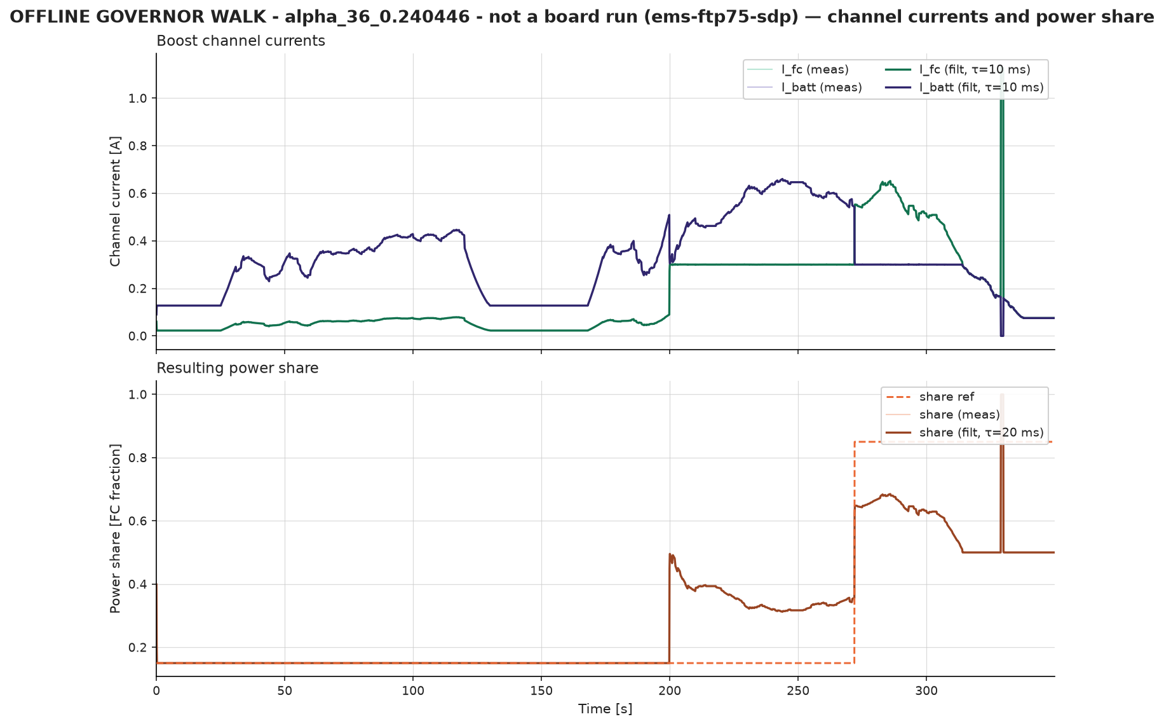
docs/modeling/sdp_alpha_sweep_20260901/plots/ems-ftp75-sdp/alpha_36_0.240446/walk_currents_and_share.png
