Tangineering/DC-Balancer-Board-Teensy/docs/modeling/sdp_alpha_sweep_20260901/plots/ems-sdp/alpha_07_0.120056/walk_hil_charger_and_soc.png

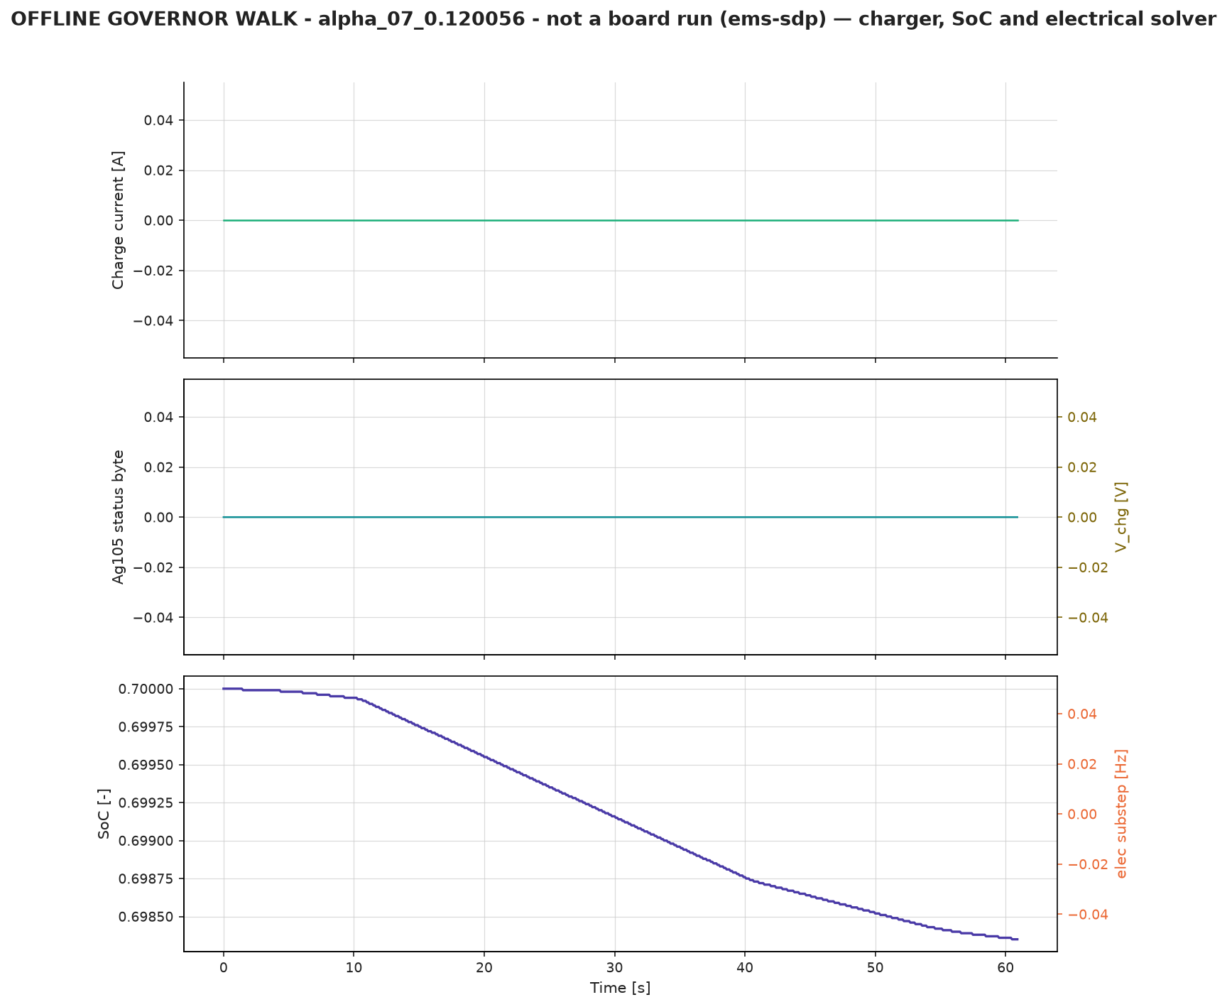
docs/modeling/sdp_alpha_sweep_20260901/plots/ems-sdp/alpha_07_0.120056/walk_hil_charger_and_soc.png
