Tangineering/DC-Balancer-Board-Teensy/docs/modeling/sdp_alpha_sweep_20260901/plots/ems-sdp/alpha_16_0.316546/walk_currents_and_share.png

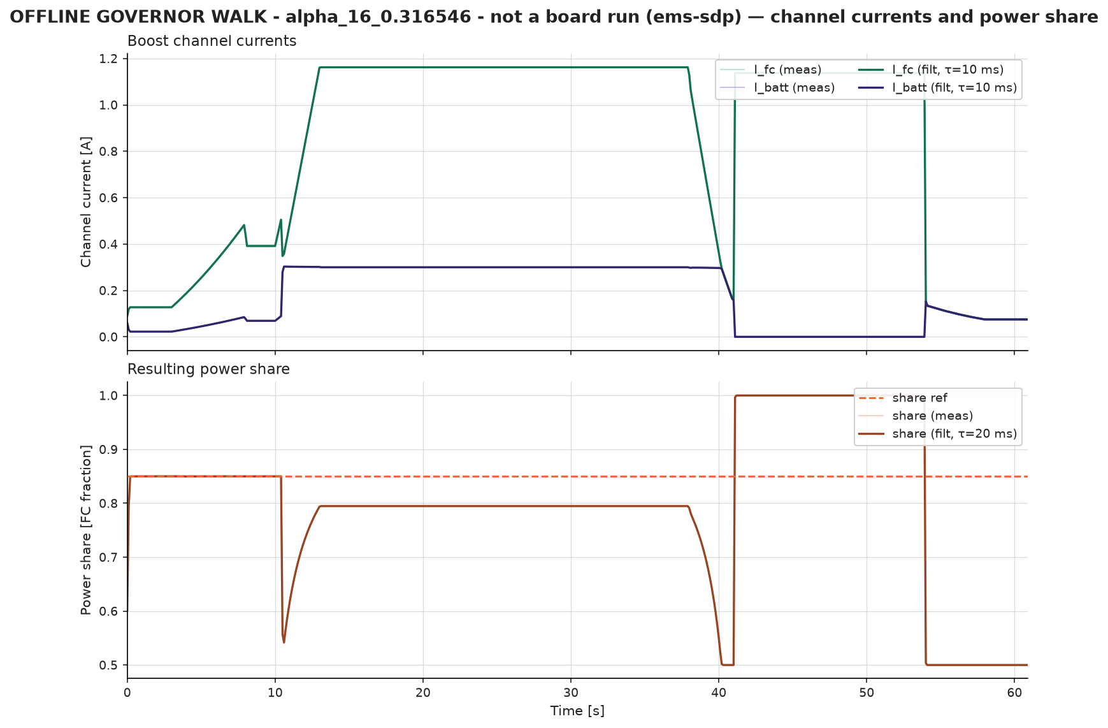
docs/modeling/sdp_alpha_sweep_20260901/plots/ems-sdp/alpha_16_0.316546/walk_currents_and_share.png
