Tangineering/DC-Balancer-Board-Teensy/docs/modeling/sdp_alpha_sweep_20260901/sweep_h2_vs_dsoc_refined_ems-sdp.png

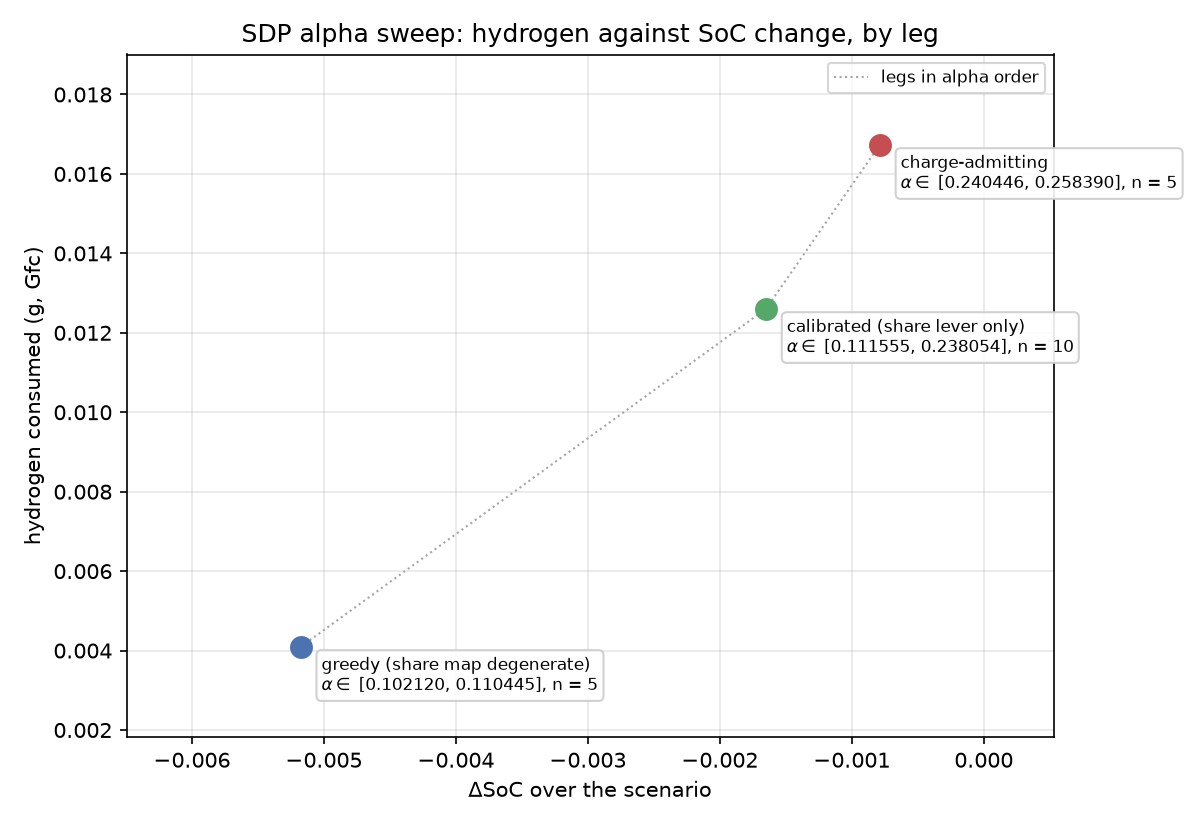
docs/modeling/sdp_alpha_sweep_20260901/sweep_h2_vs_dsoc_refined_ems-sdp.png
