Tangineering/DC-Balancer-Board-Teensy/docs/modeling/sdp_alpha_sweep_eta088_20260902/plots/ems-ftp75-sdp/alpha_00_0.051400/walk_currents_and_share.png

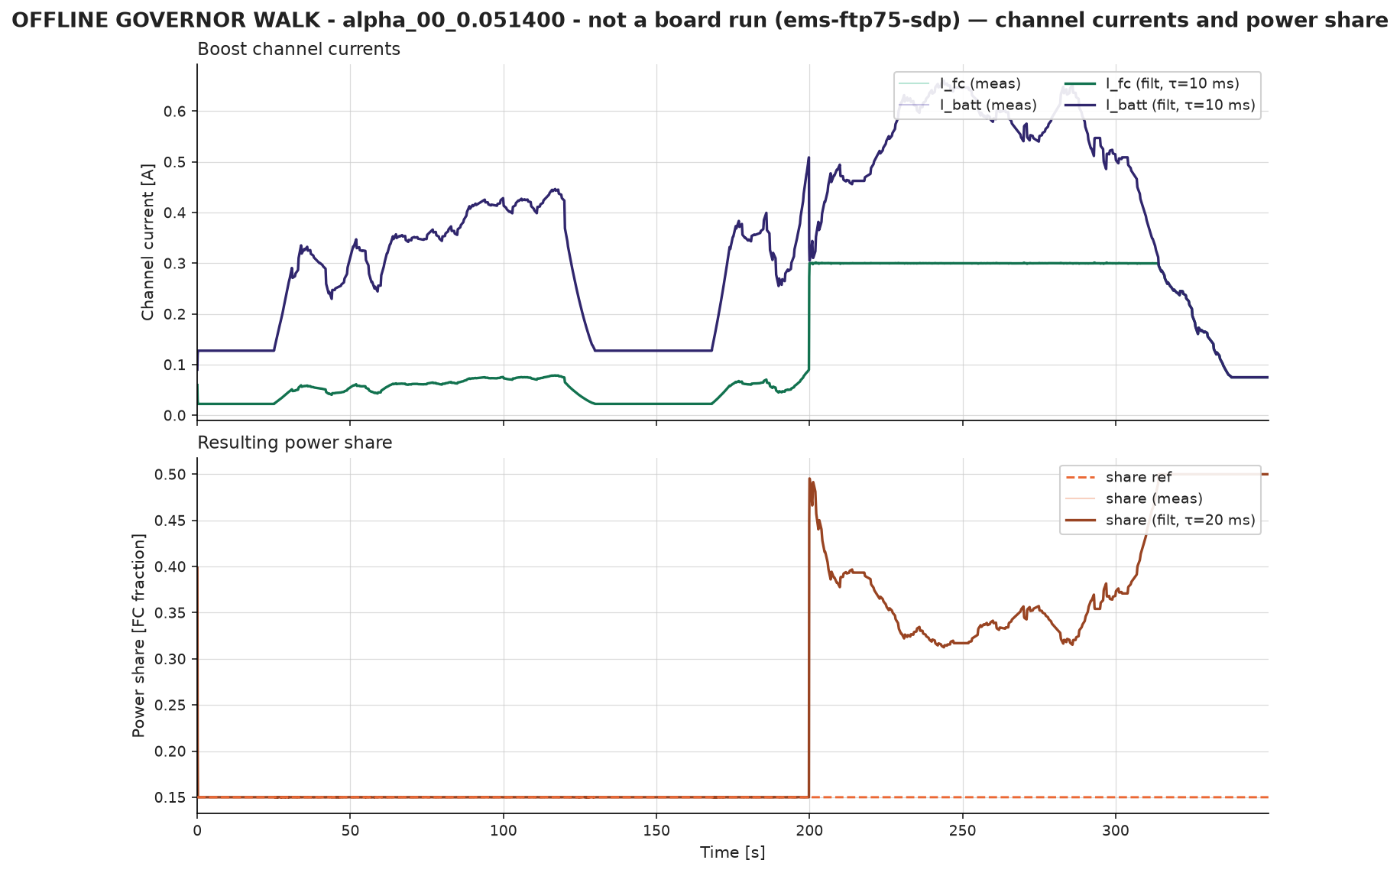
docs/modeling/sdp_alpha_sweep_eta088_20260902/plots/ems-ftp75-sdp/alpha_00_0.051400/walk_currents_and_share.png
