Tangineering/DC-Balancer-Board-Teensy/docs/modeling/sdp_alpha_sweep_eta088_20260902/plots/ems-ftp75-sdp/alpha_00_0.051400/walk_hil_charger_and_soc.png

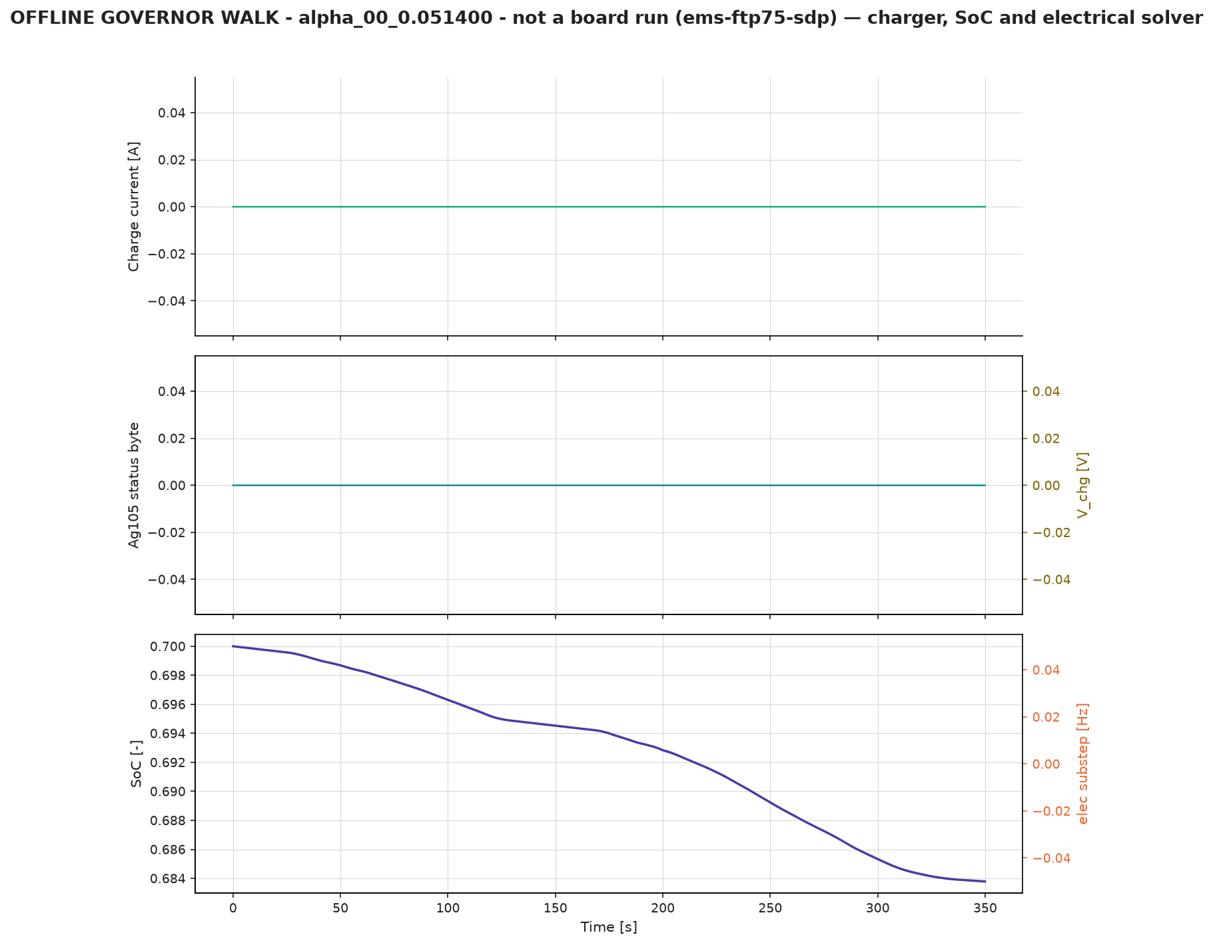
docs/modeling/sdp_alpha_sweep_eta088_20260902/plots/ems-ftp75-sdp/alpha_00_0.051400/walk_hil_charger_and_soc.png
