Tangineering/DC-Balancer-Board-Teensy/docs/modeling/sdp_alpha_sweep_h20_20260909/sweep_h2_vs_alpha_all_ems-ftp75-sdp.png

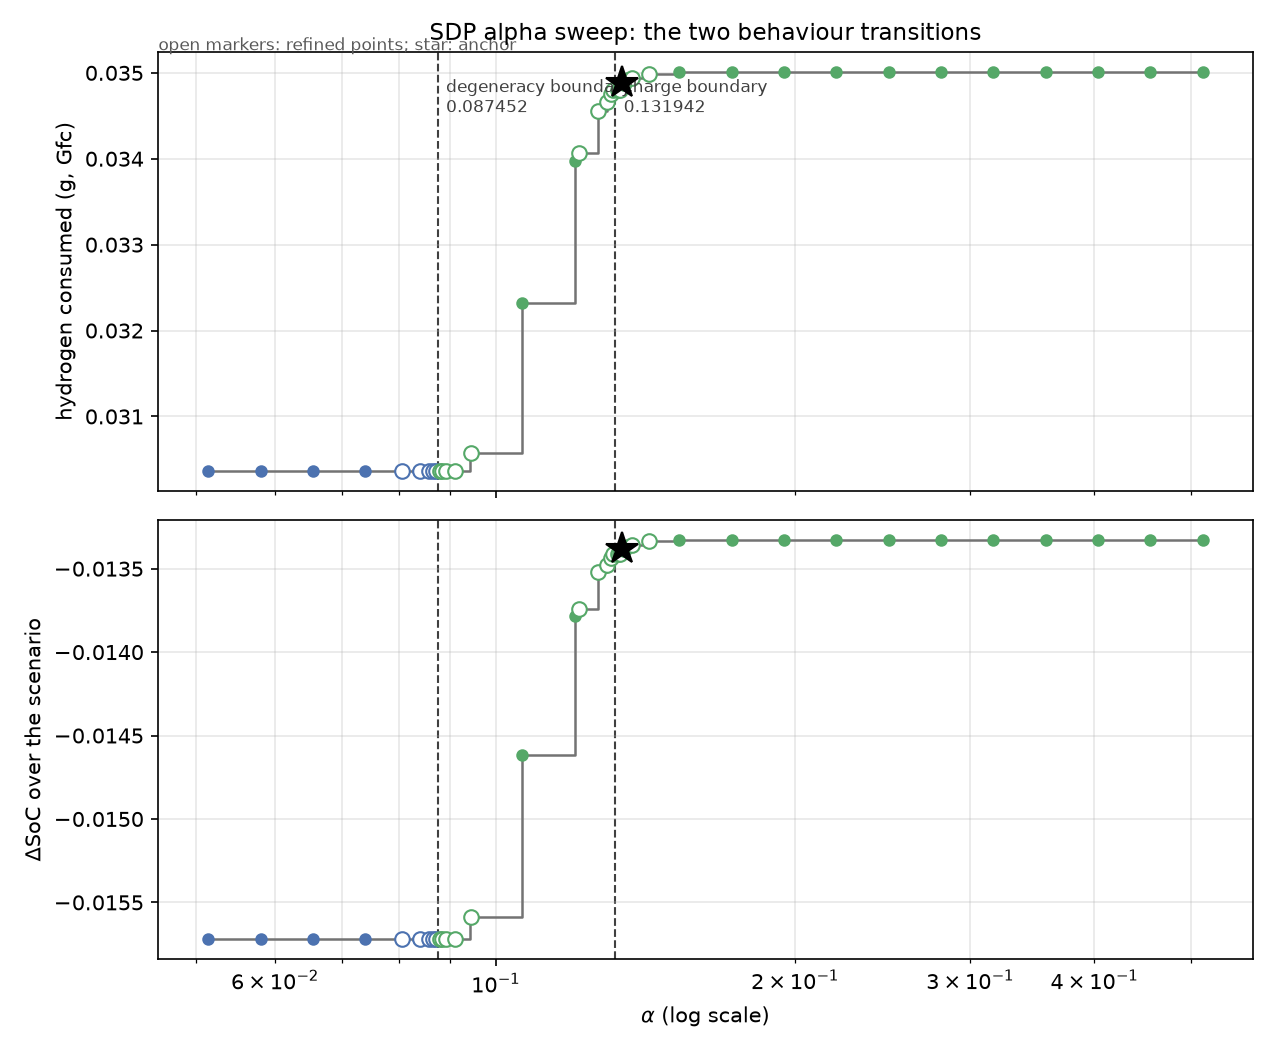
docs/modeling/sdp_alpha_sweep_h20_20260909/sweep_h2_vs_alpha_all_ems-ftp75-sdp.png
