Tangineering/DC-Balancer-Board-Teensy/docs/reviews/charger_eval_2026-11-05/round2/figs/fig4_taumax_vs_C.png

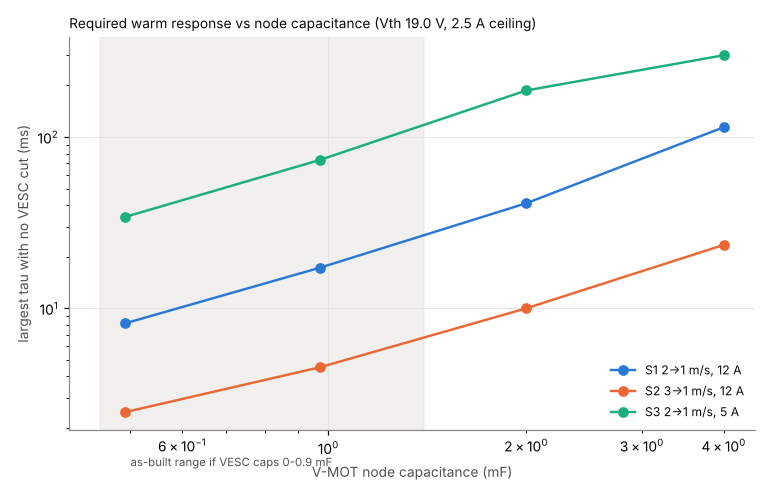
docs/reviews/charger_eval_2026-11-05/round2/figs/fig4_taumax_vs_C.png
