Tangineering/DC-Balancer-Board-Teensy/docs/reviews/charger_eval_2026-11-05/round4/work/evm/p150-15.png

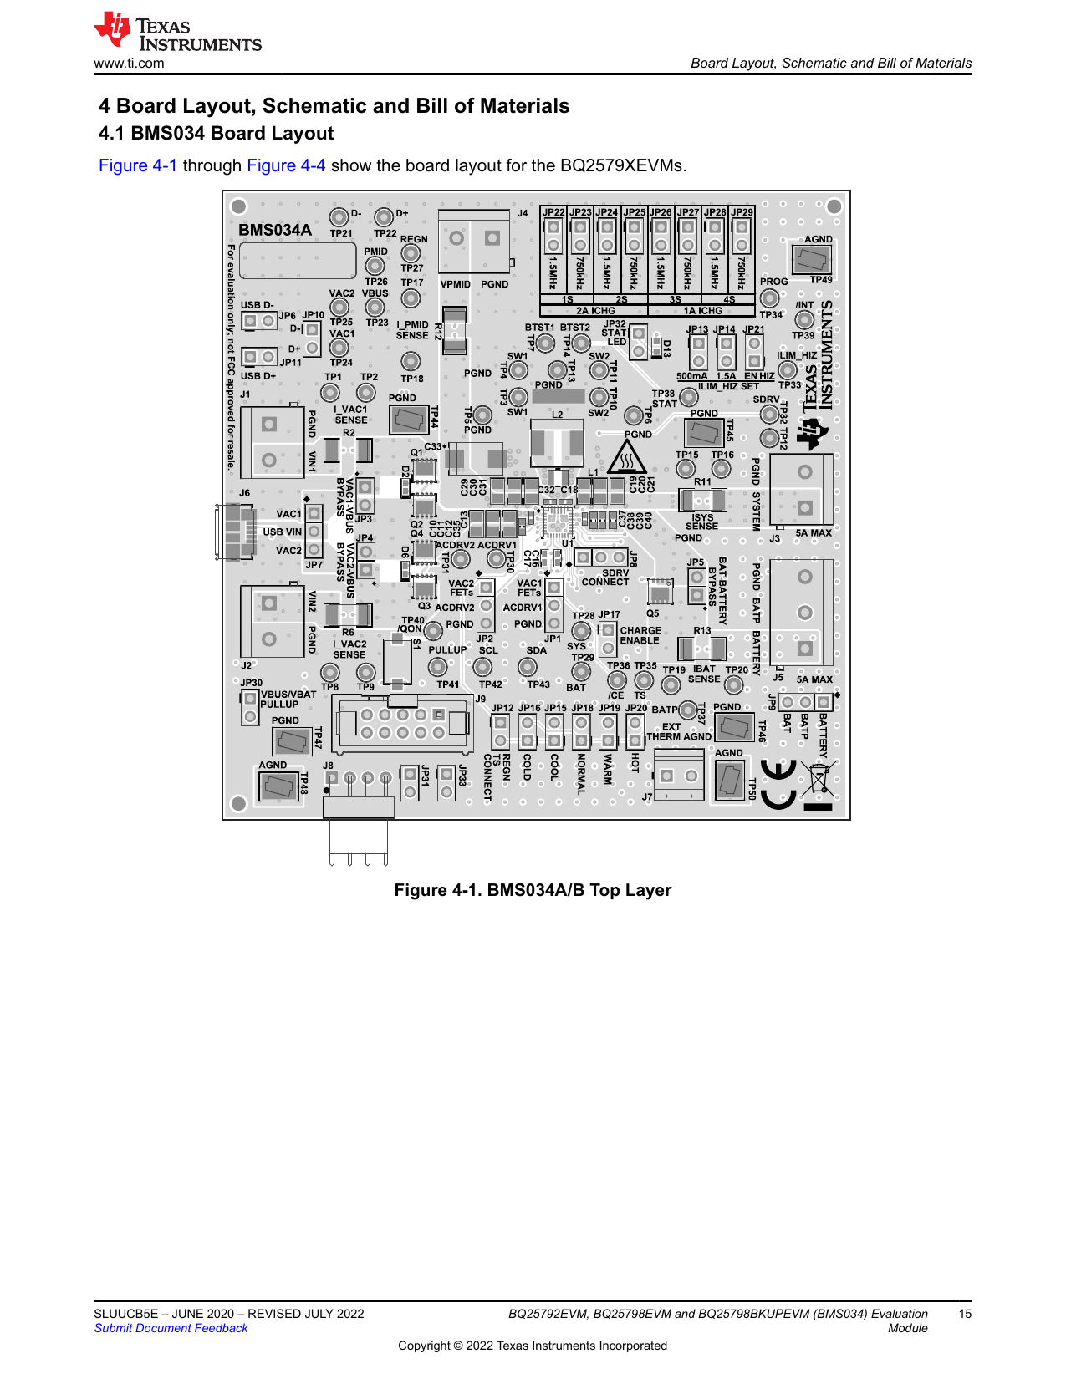
docs/reviews/charger_eval_2026-11-05/round4/work/evm/p150-15.png
