Tangineering/DC-Balancer-Board-Teensy/docs/reviews/charger_eval_2026-11-05/round4/work/evm/p150-17.png

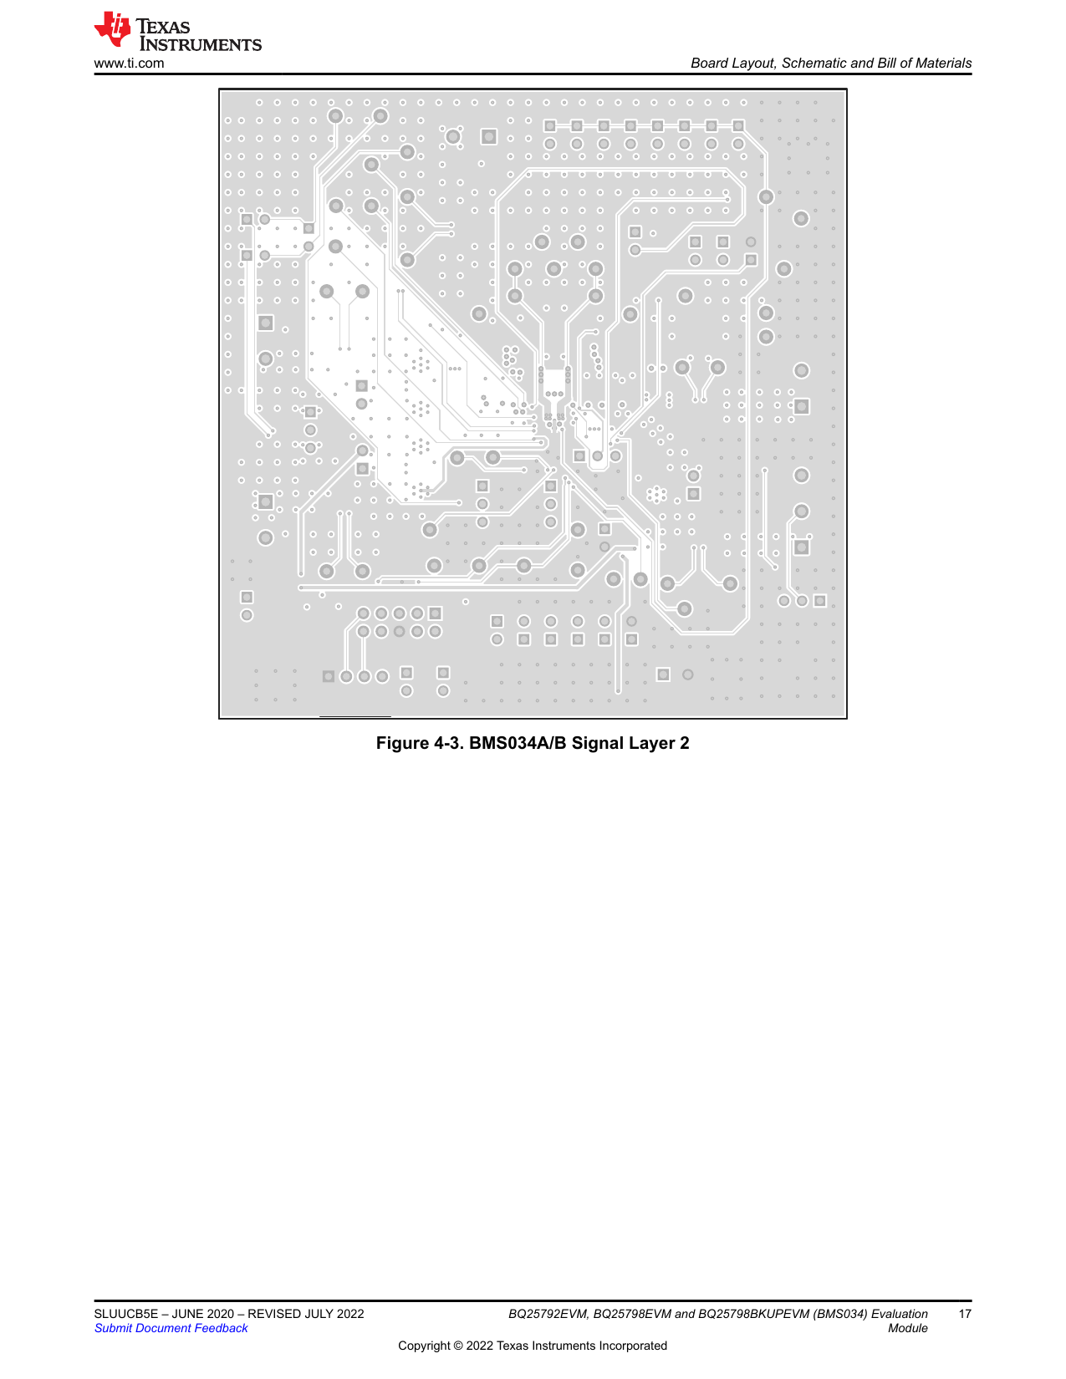
docs/reviews/charger_eval_2026-11-05/round4/work/evm/p150-17.png
