Tangineering/DC-Balancer-Board-Teensy/docs/reviews/charger_eval_2026-11-05/round4/work/mb_mech_map.png

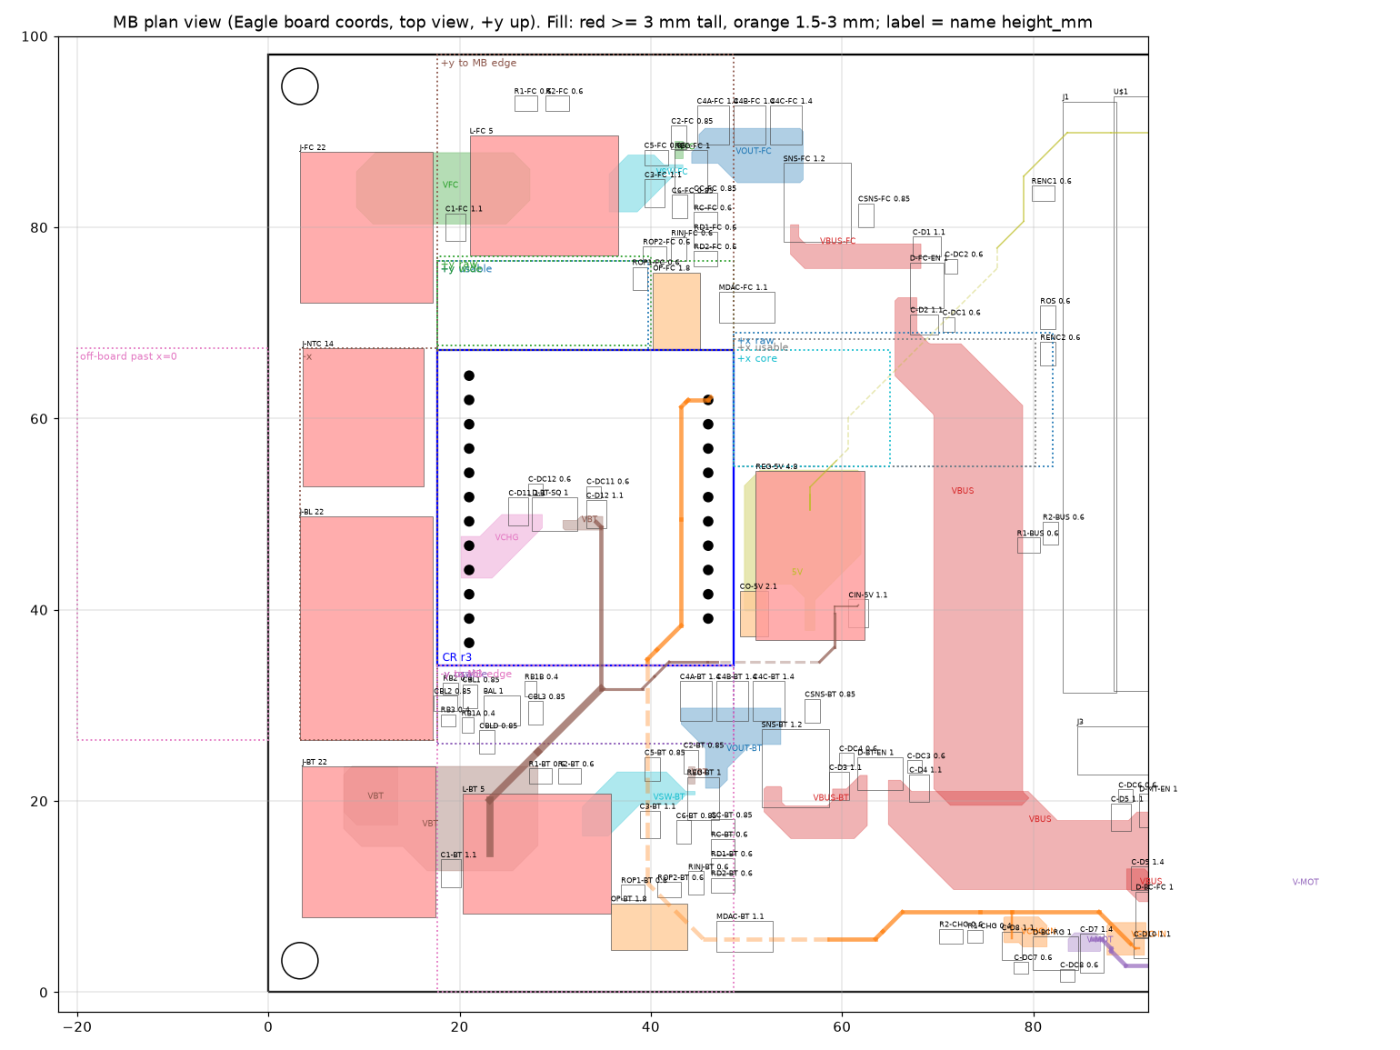
docs/reviews/charger_eval_2026-11-05/round4/work/mb_mech_map.png
