Tangineering/DC-Balancer-Board-Teensy/docs/reviews/charger_eval_2026-11-05/round4/work/r7_evm_on_cr_map.png

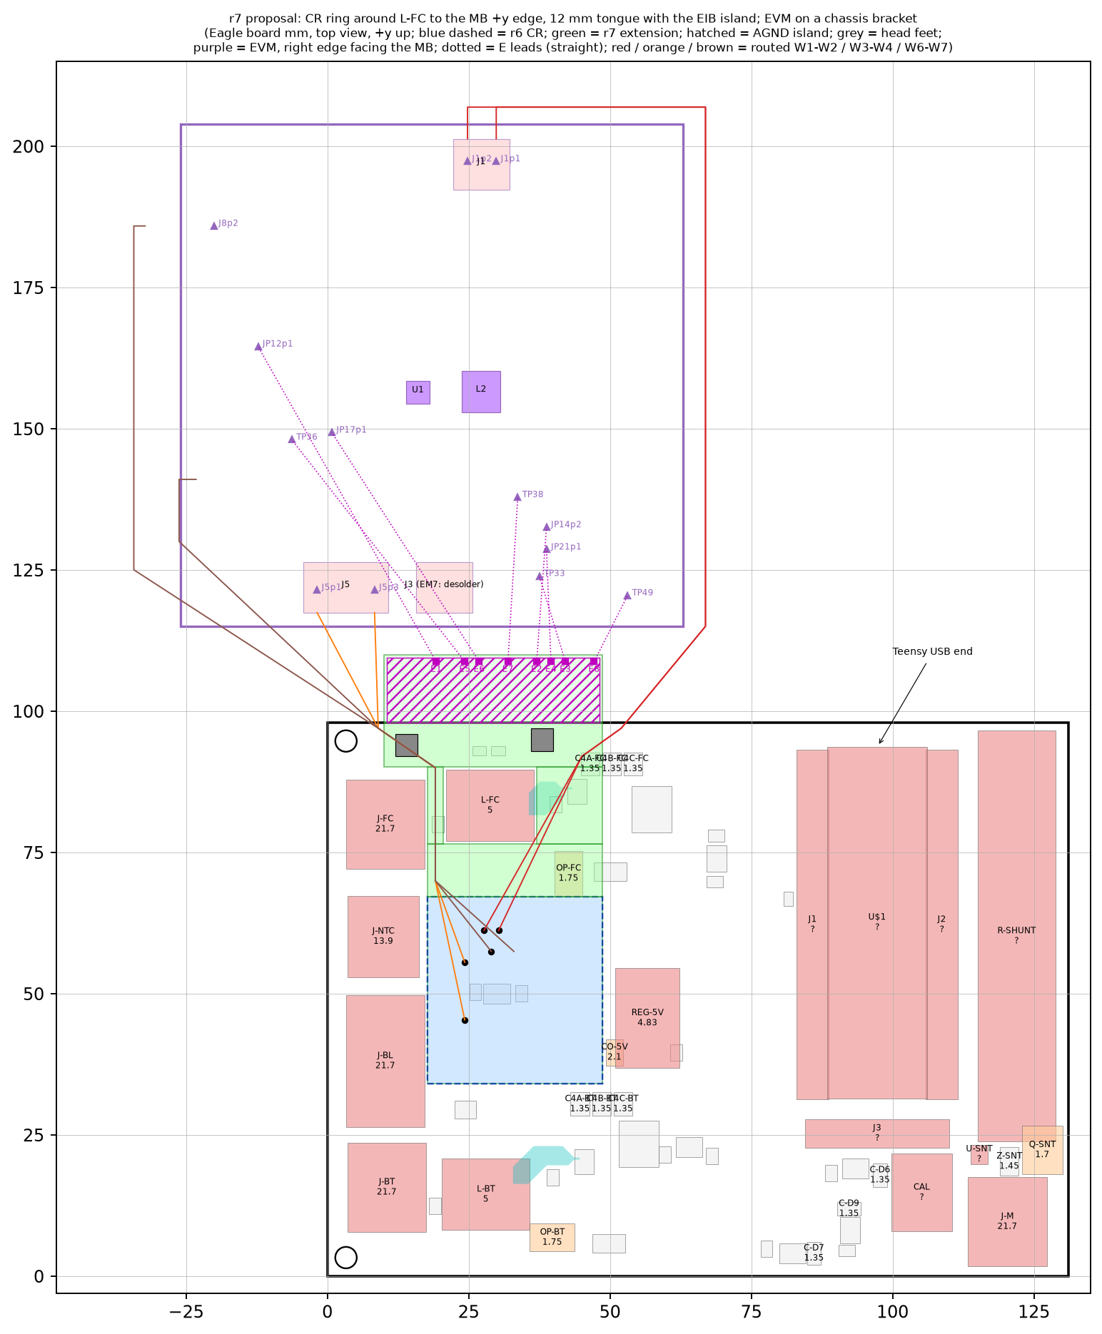
docs/reviews/charger_eval_2026-11-05/round4/work/r7_evm_on_cr_map.png
