Tangineering/DC-Balancer-Board-Teensy/docs/reviews/charger_eval_2026-11-05/round4/work/svg_png/carrier_layout_r7.png

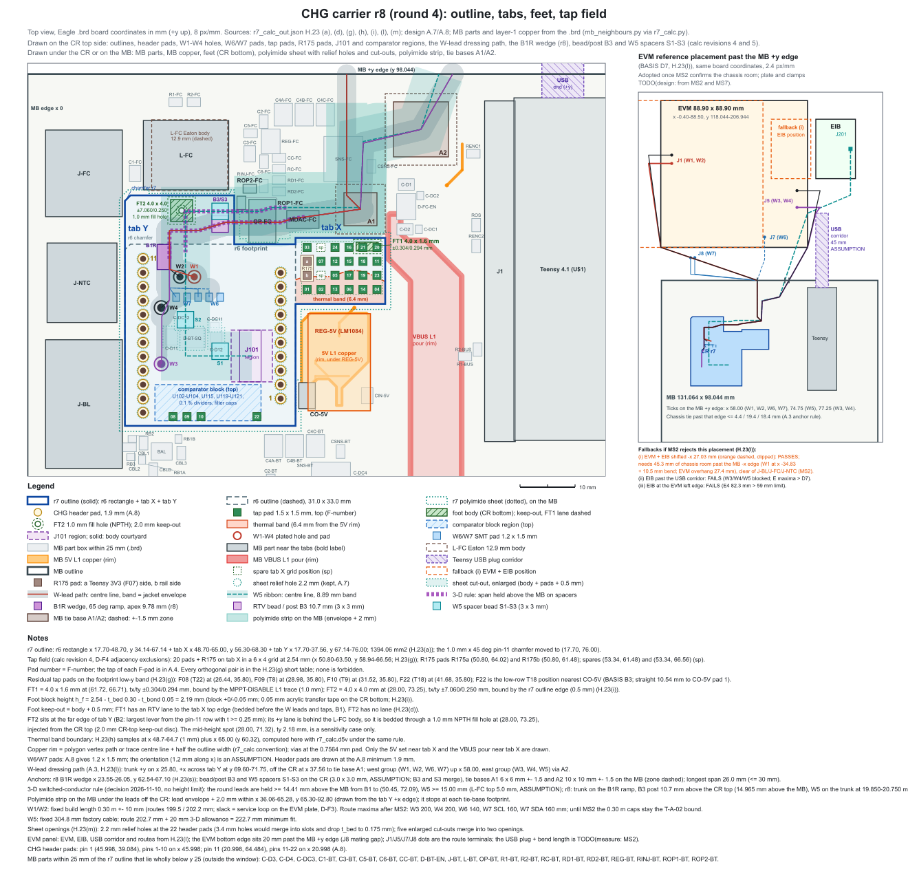
docs/reviews/charger_eval_2026-11-05/round4/work/svg_png/carrier_layout_r7.png
