Tangineering/DC-Balancer-Board-Teensy/docs/reviews/cr_routing_2026-11-12/cr_outline_request_mb_layout_2026-11-12.png

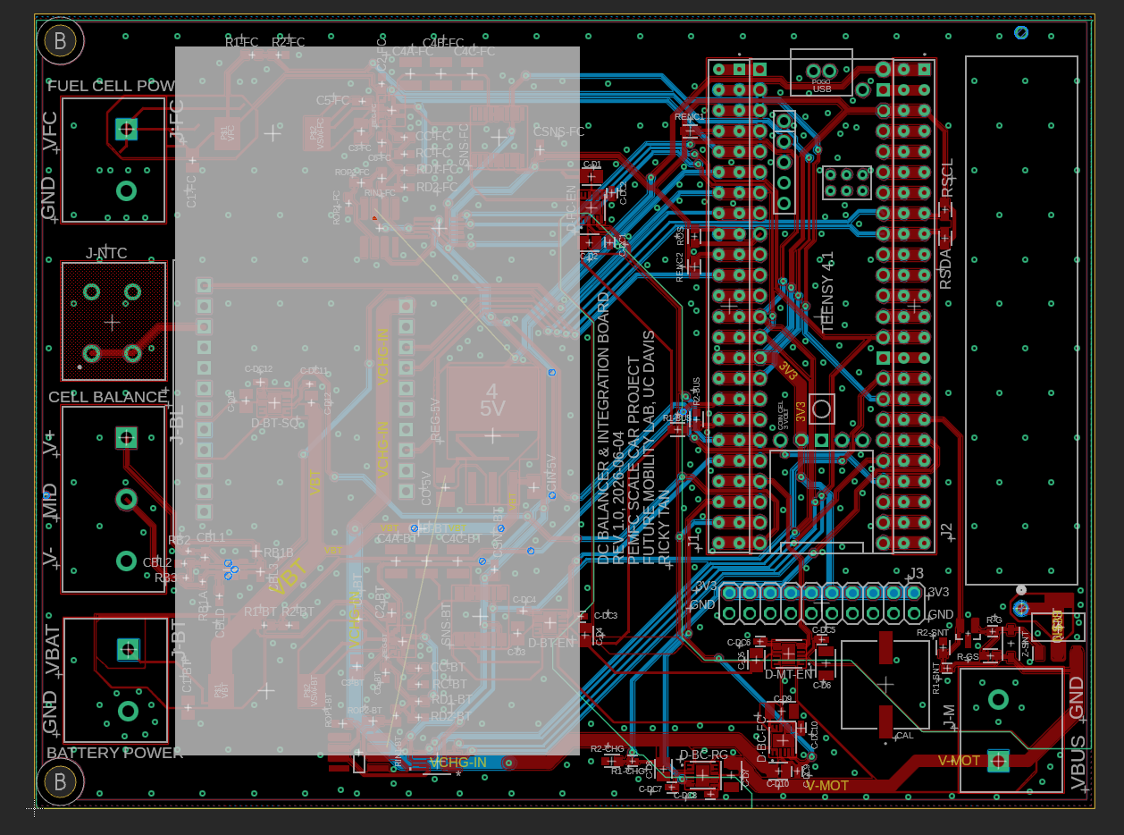
docs/reviews/cr_routing_2026-11-12/cr_outline_request_mb_layout_2026-11-12.png
