Tangineering/DC-Balancer-Board-Teensy/docs/reviews/cr_routing_2026-11-12/cr_outline_request_photo_2026-11-12.webp

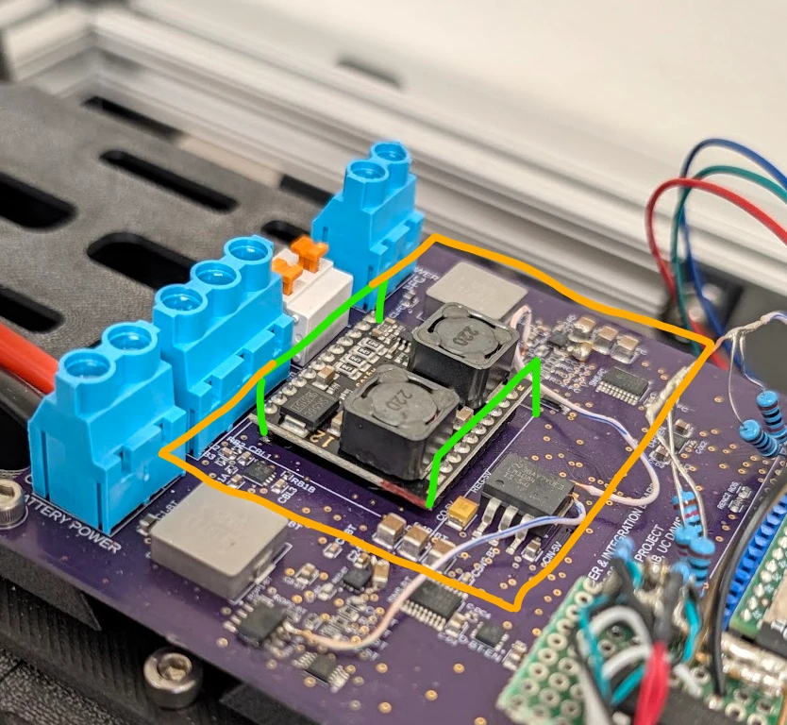
docs/reviews/cr_routing_2026-11-12/cr_outline_request_photo_2026-11-12.webp
