Tangineering/DC-Balancer-Board-Teensy/docs/reviews/fw36_regen_2026-11-04/figs/fc_batt_trend.png

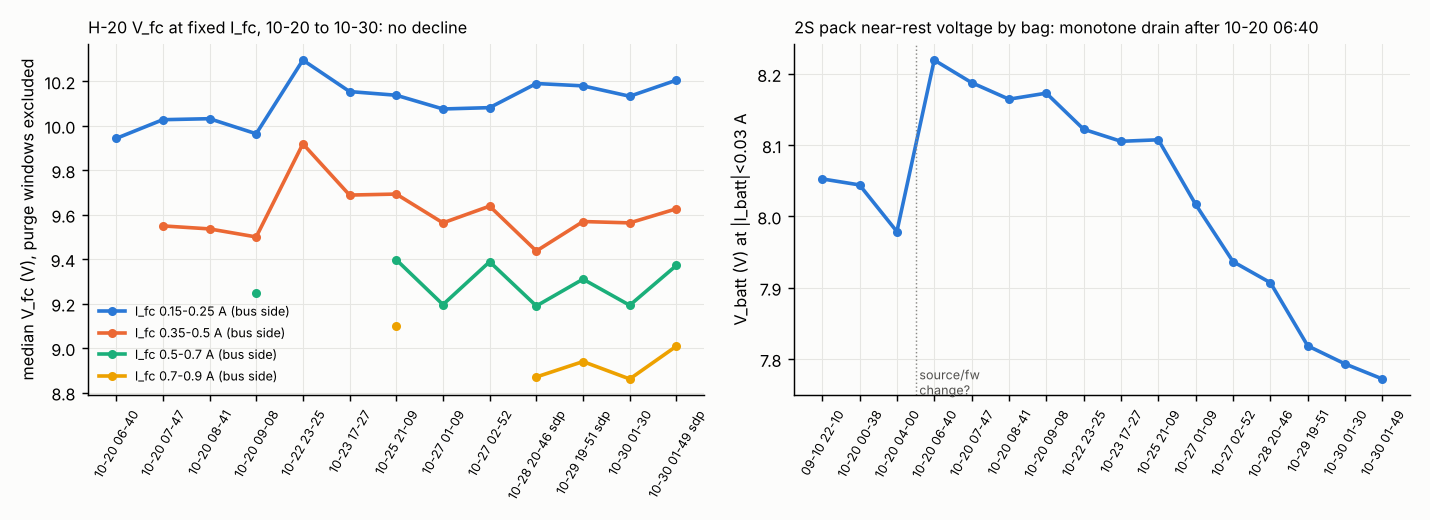
docs/reviews/fw36_regen_2026-11-04/figs/fc_batt_trend.png
