Tangineering/DC-Balancer-Board-Teensy/docs/reviews/fw36_regen_2026-11-04/figs/noise_coherence_transfer.png

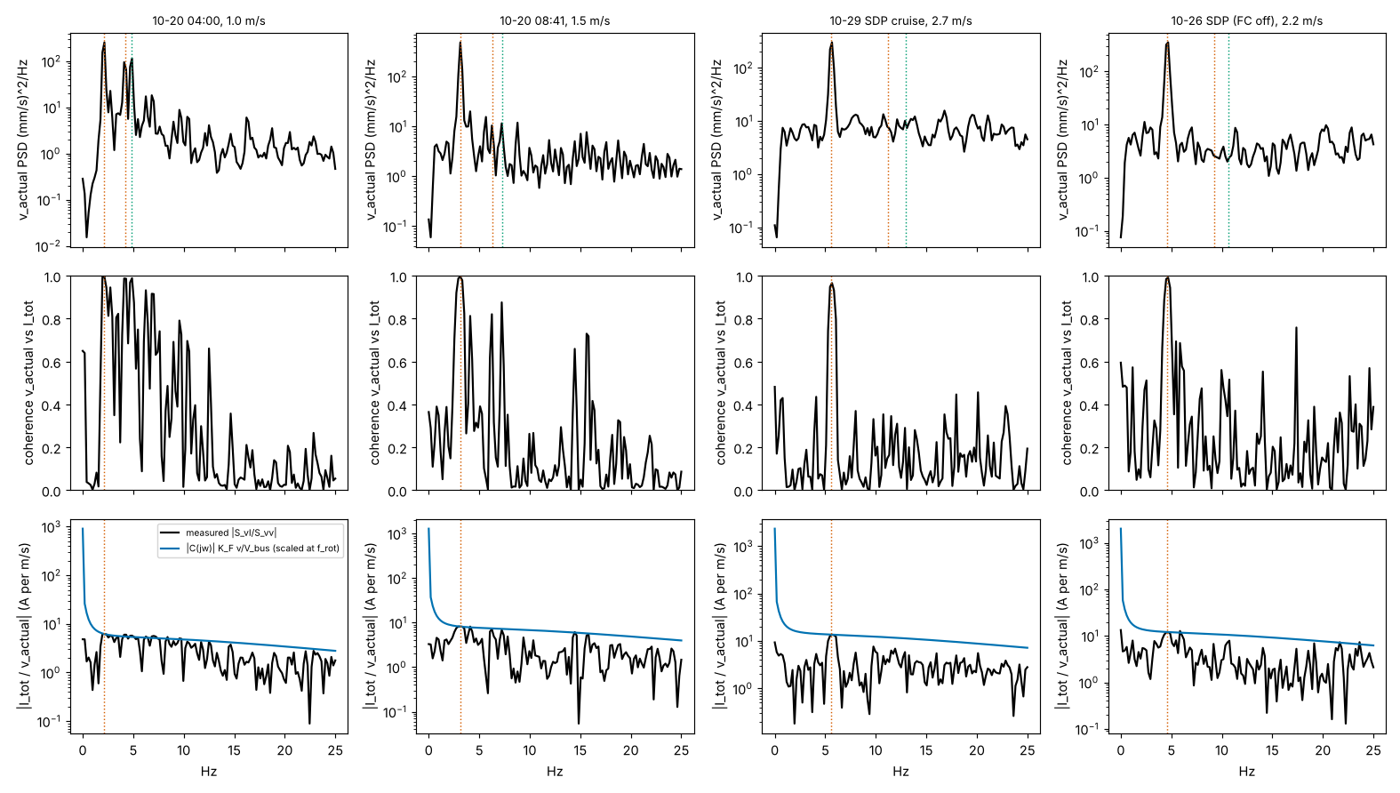
docs/reviews/fw36_regen_2026-11-04/figs/noise_coherence_transfer.png
