Tangineering/DC-Balancer-Board-Teensy/docs/reviews/fw36_regen_2026-11-04/figs/ocfc_1029.png

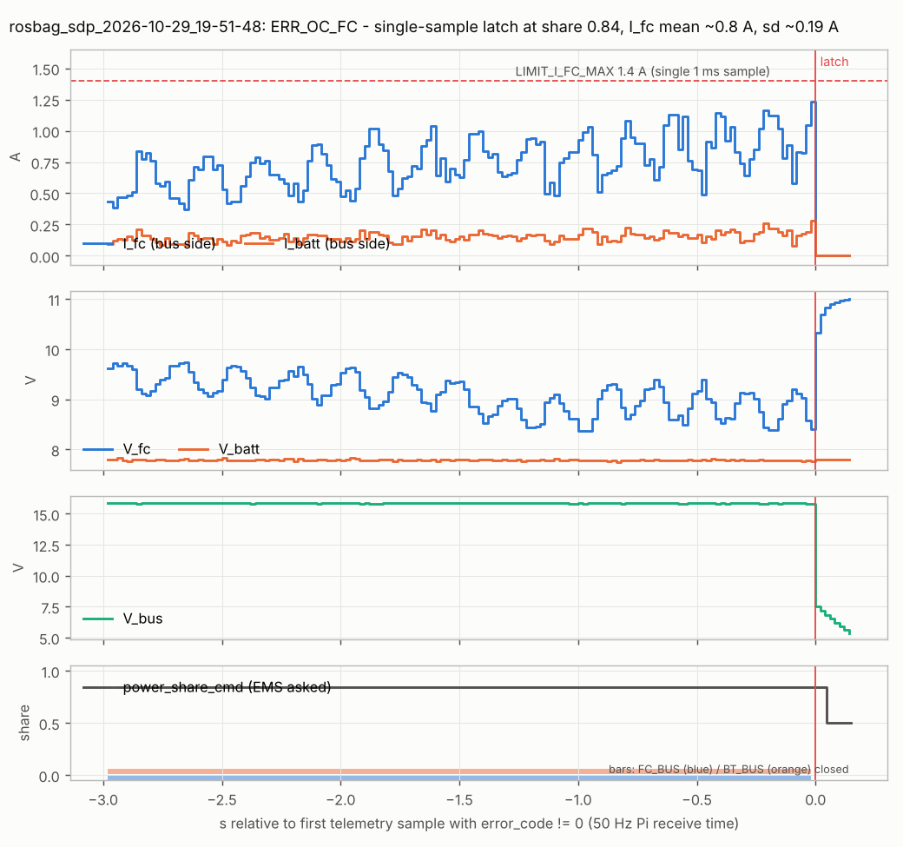
docs/reviews/fw36_regen_2026-11-04/figs/ocfc_1029.png
