Tangineering/DC-Balancer-Board-Teensy/docs/reviews/fw36_regen_2026-11-04/figs/purge_two_source_vs_fc_only.png

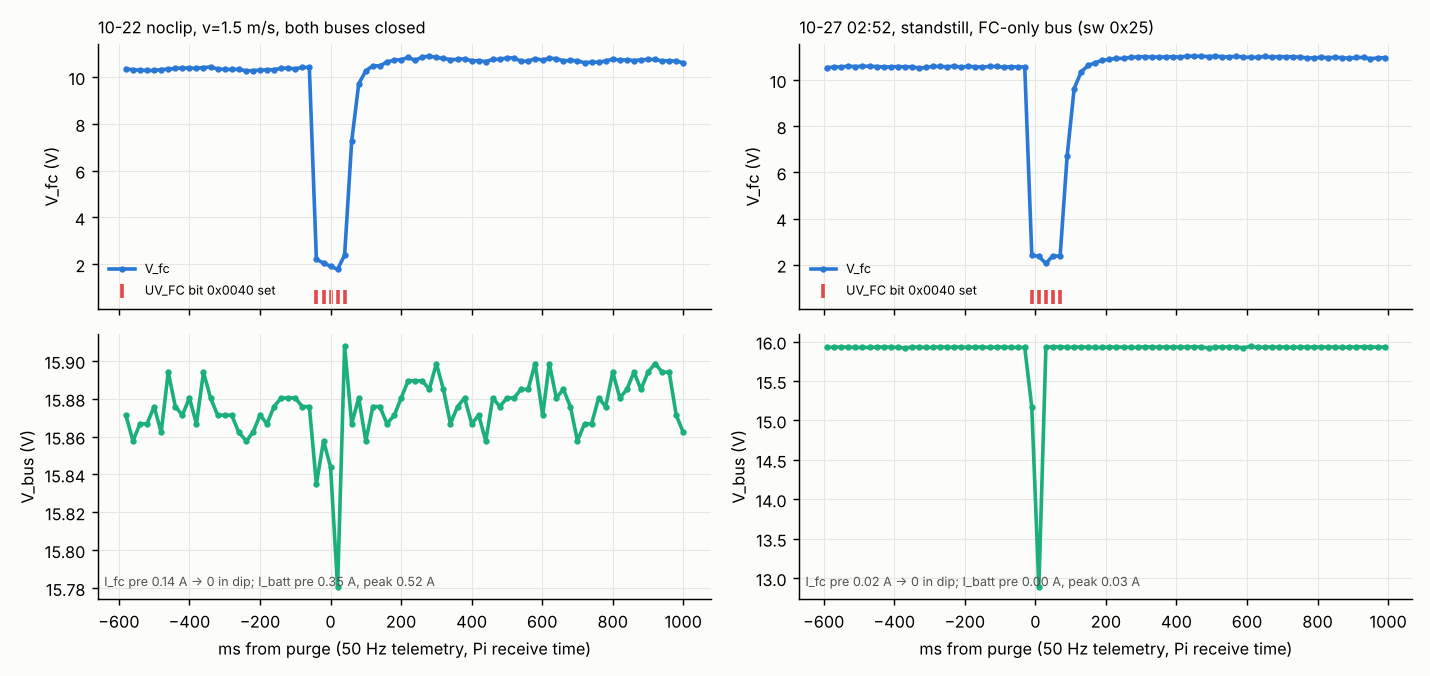
docs/reviews/fw36_regen_2026-11-04/figs/purge_two_source_vs_fc_only.png
