Tangineering/DC-Balancer-Board-Teensy/docs/reviews/fw36_regen_2026-11-04/figs/sdp1029_regen_flicker.png

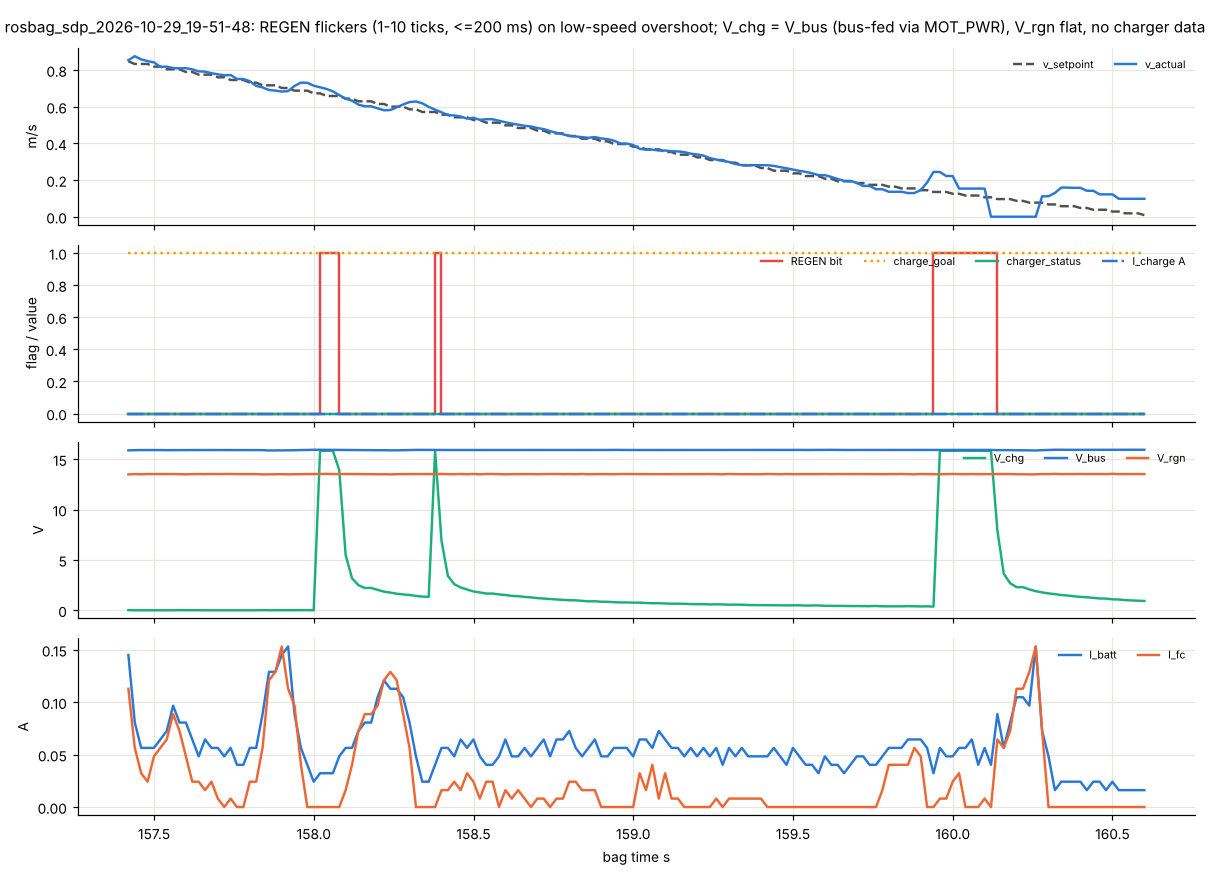
docs/reviews/fw36_regen_2026-11-04/figs/sdp1029_regen_flicker.png
