Tangineering/DC-Balancer-Board-Teensy/docs/reviews/noise_fw37_2026-11-05/figs/beforeafter_1x_vs_speed.png

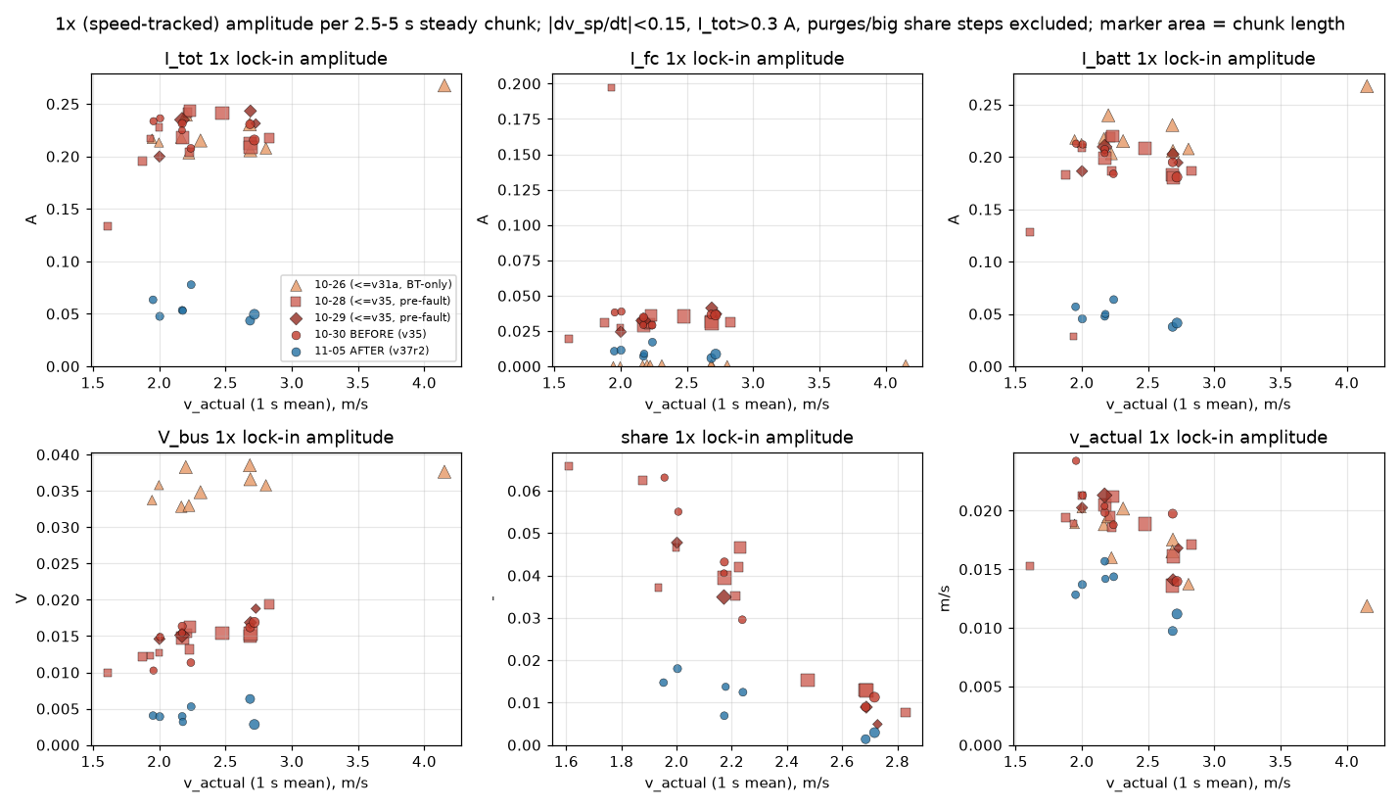
docs/reviews/noise_fw37_2026-11-05/figs/beforeafter_1x_vs_speed.png
