Tangineering/DC-Balancer-Board-Teensy/docs/reviews/noise_fw37_2026-11-05/figs/brief_share_masks.png

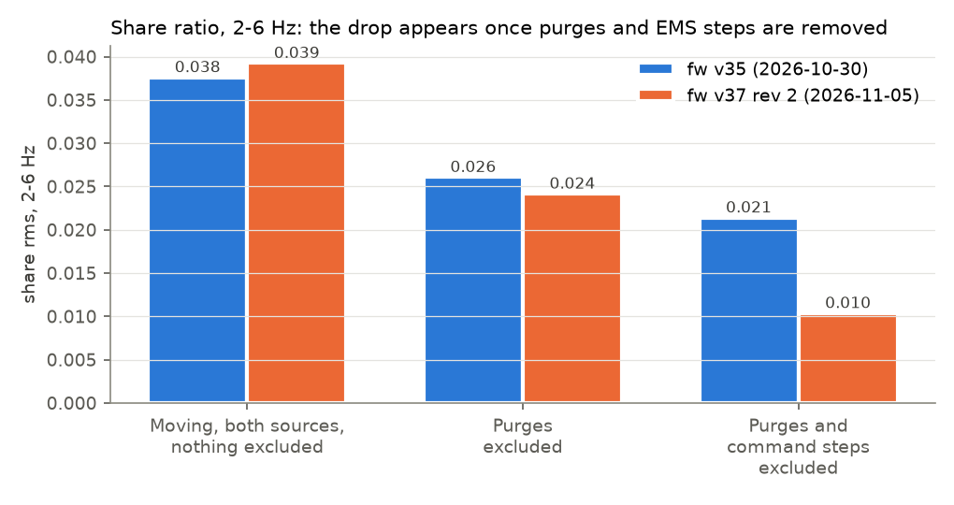
docs/reviews/noise_fw37_2026-11-05/figs/brief_share_masks.png
