Tangineering/DC-Balancer-Board-Teensy/docs/reviews/noise_fw37_2026-11-05/figs/brief_vbus_spectrogram.png

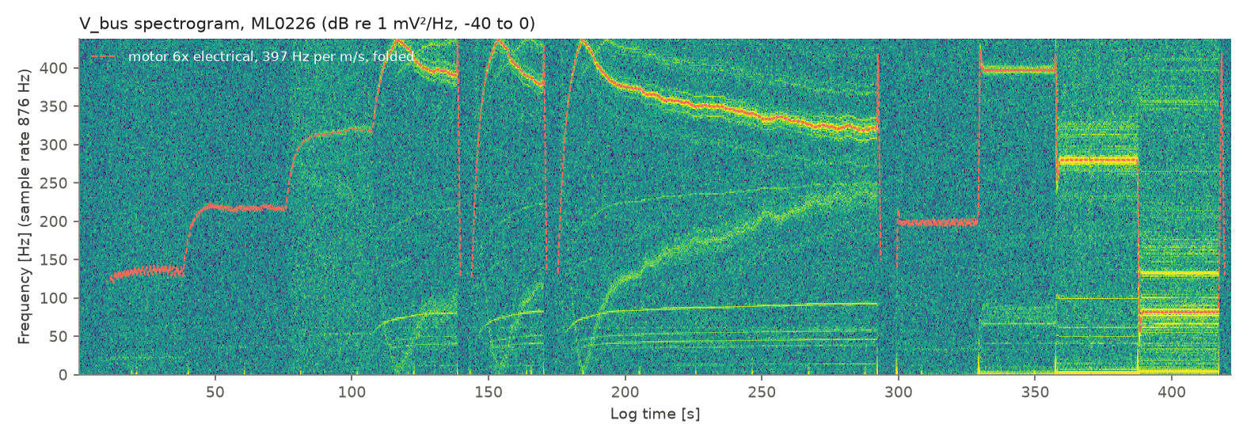
docs/reviews/noise_fw37_2026-11-05/figs/brief_vbus_spectrogram.png
