Tangineering/DC-Balancer-Board-Teensy/docs/reviews/noise_fw37_2026-11-05/figs/freeform_dup_image.png

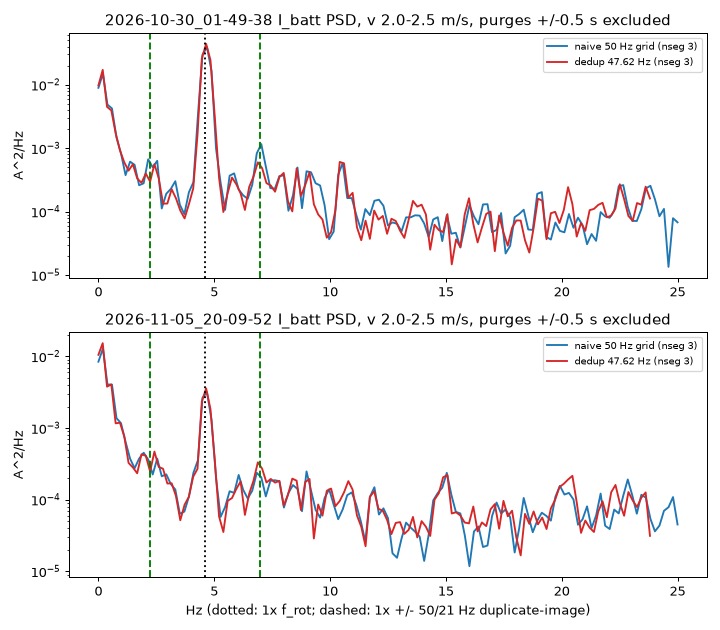
docs/reviews/noise_fw37_2026-11-05/figs/freeform_dup_image.png
