Tangineering/DC-Balancer-Board-Teensy/docs/reviews/noise_fw37_2026-11-05/figs/freeform_rail_share_vs_load.png

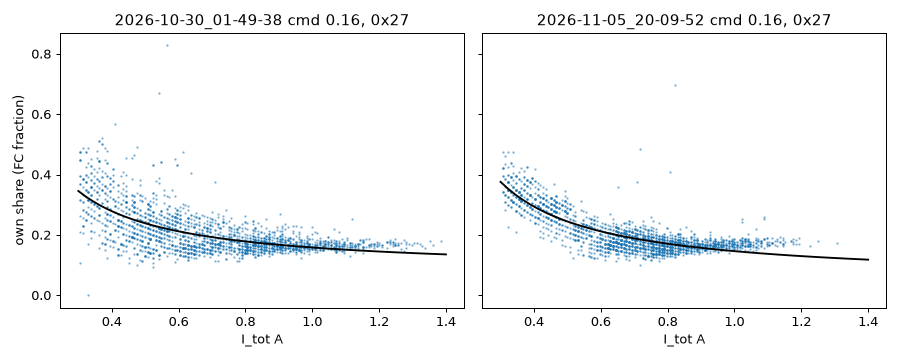
docs/reviews/noise_fw37_2026-11-05/figs/freeform_rail_share_vs_load.png
