Tangineering/DC-Balancer-Board-Teensy/docs/reviews/noise_fw37_2026-11-05/figs/sharemodel_kd_and_floor_schedule.png

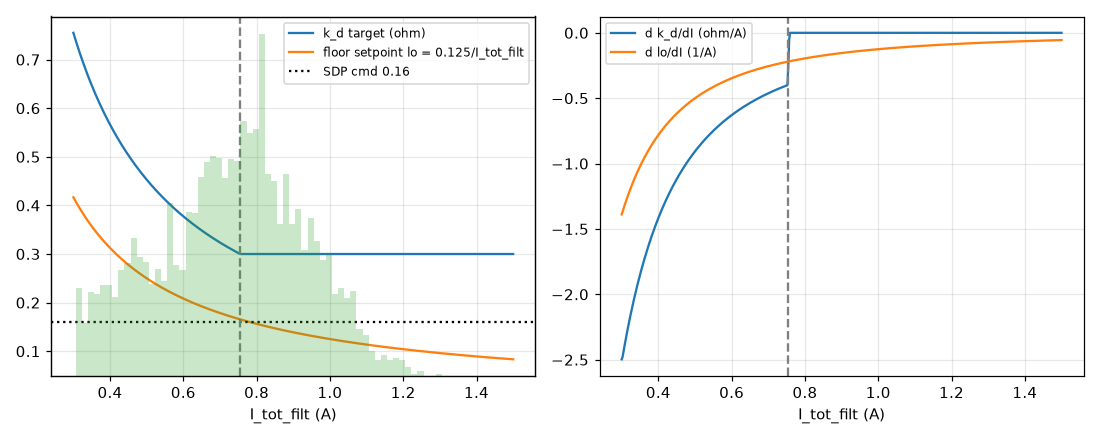
docs/reviews/noise_fw37_2026-11-05/figs/sharemodel_kd_and_floor_schedule.png
