Tangineering/DC-Balancer-Board-Teensy/docs/reviews/noise_fw37_2026-11-05/figs/sharespec_peel_psd.png

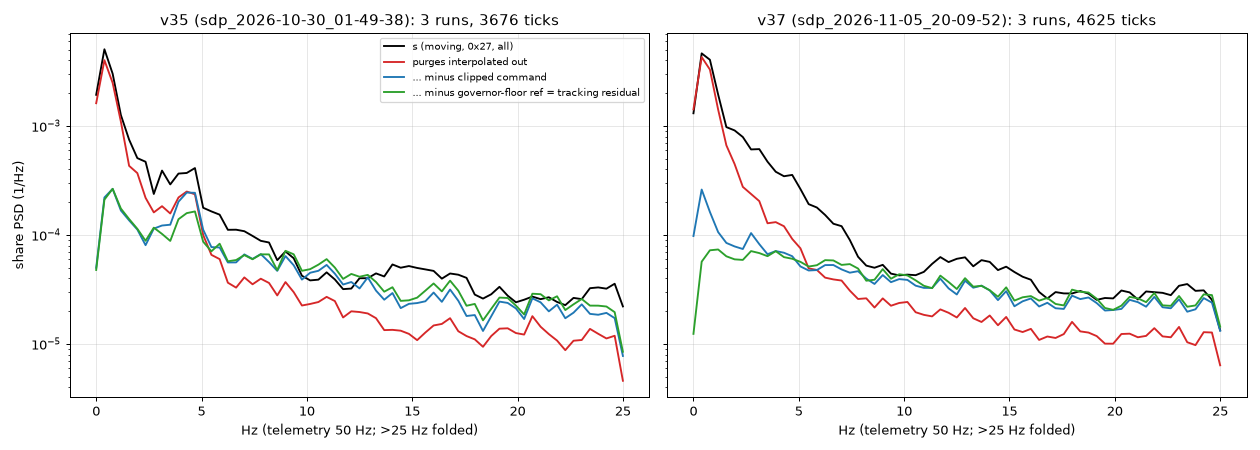
docs/reviews/noise_fw37_2026-11-05/figs/sharespec_peel_psd.png
