Tangineering/DC-Balancer-Board-Teensy/docs/reviews/noise_fw37_2026-11-05/figs/vbus_bagtest_residual_dependence.png

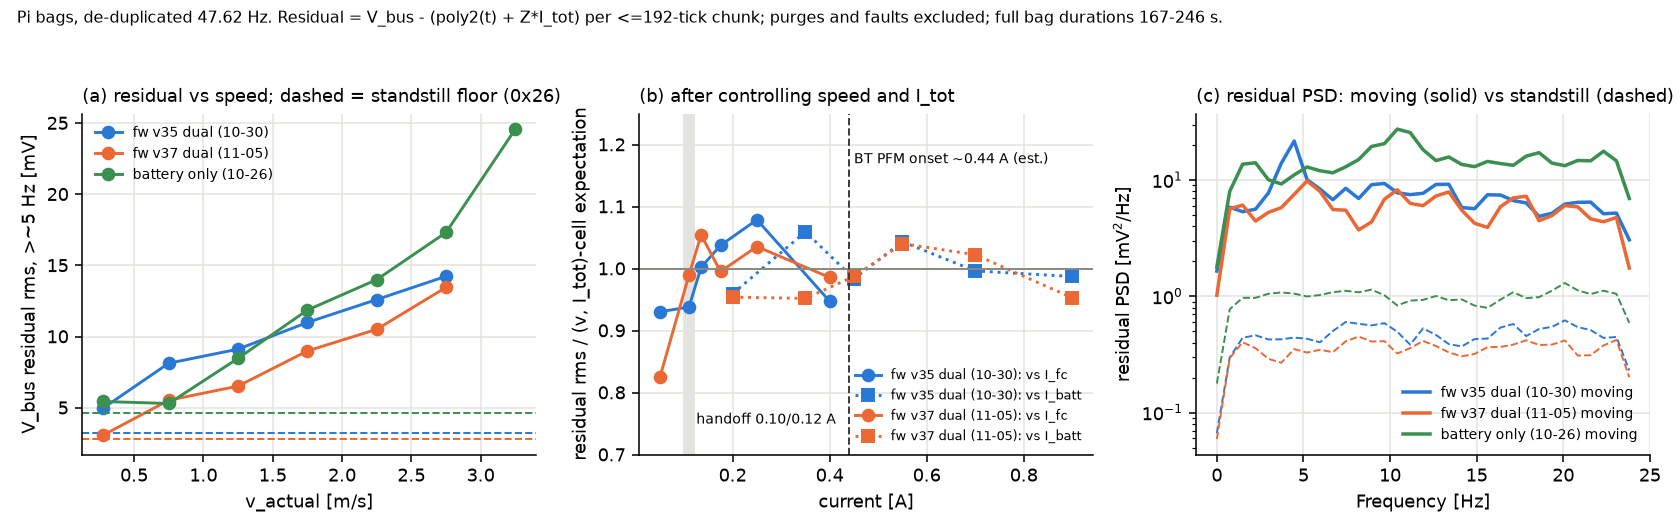
docs/reviews/noise_fw37_2026-11-05/figs/vbus_bagtest_residual_dependence.png
