Tangineering/DC-Balancer-Board-Teensy/docs/reviews/noise_fw37_2026-11-05/figs/vbus_rt1987_drop_and_spectra.png

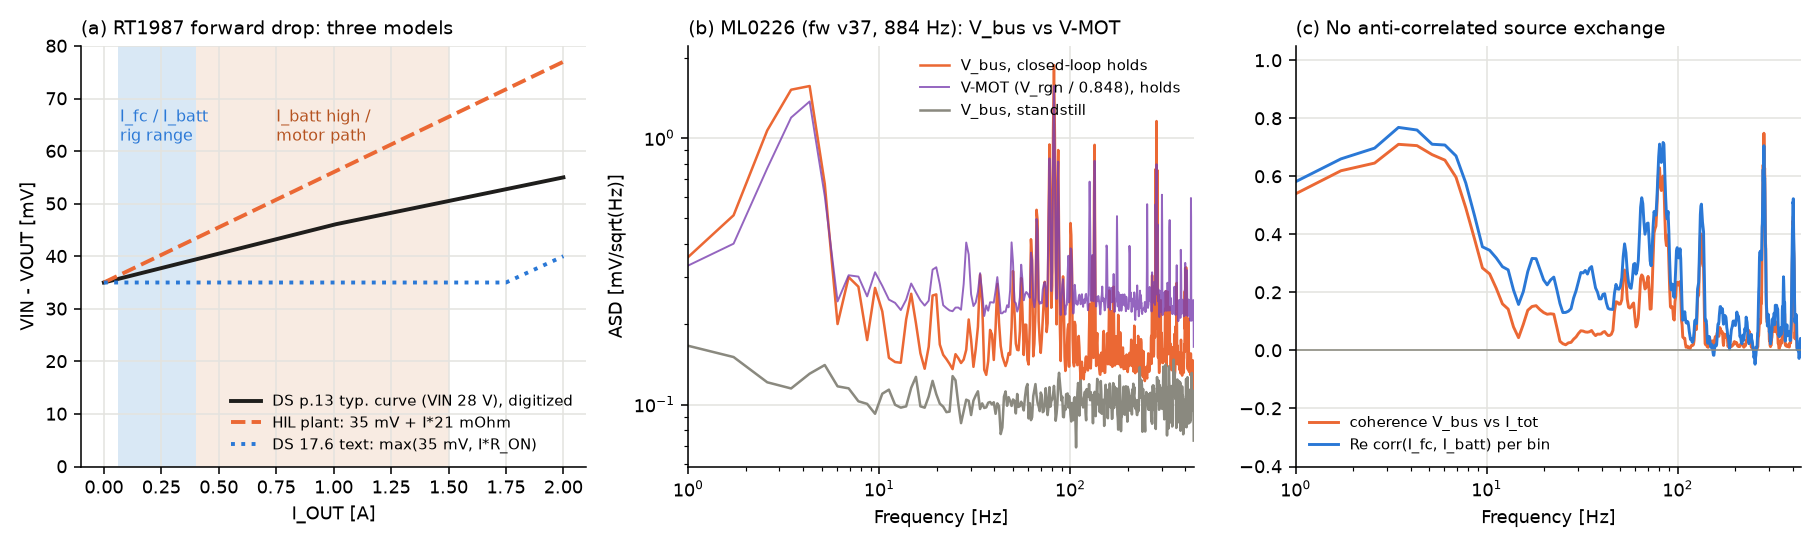
docs/reviews/noise_fw37_2026-11-05/figs/vbus_rt1987_drop_and_spectra.png
