Tangineering/DC-Balancer-Board-Teensy/docs/reviews/noise_fw37_2026-11-05/figs/vbus_switching_budget.png

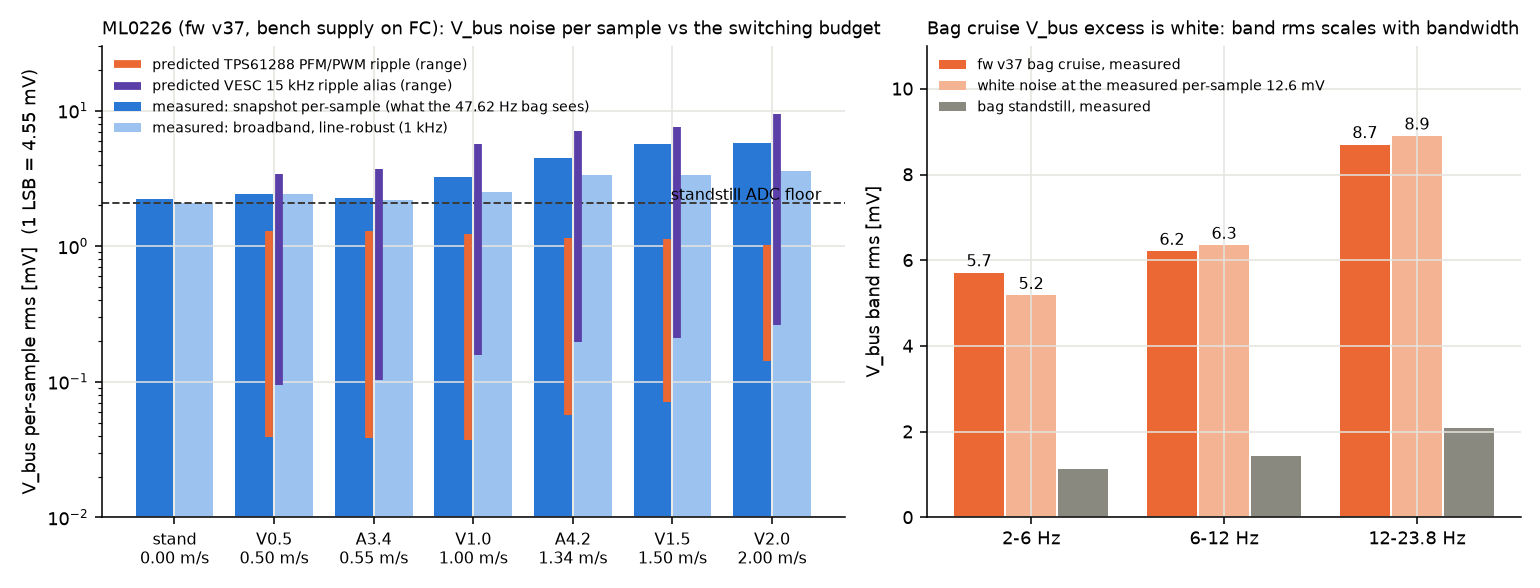
docs/reviews/noise_fw37_2026-11-05/figs/vbus_switching_budget.png
