Tangineering/DC-Balancer-Board-Teensy/docs/share_sweep_whitepaper/figs/capture12.jpg

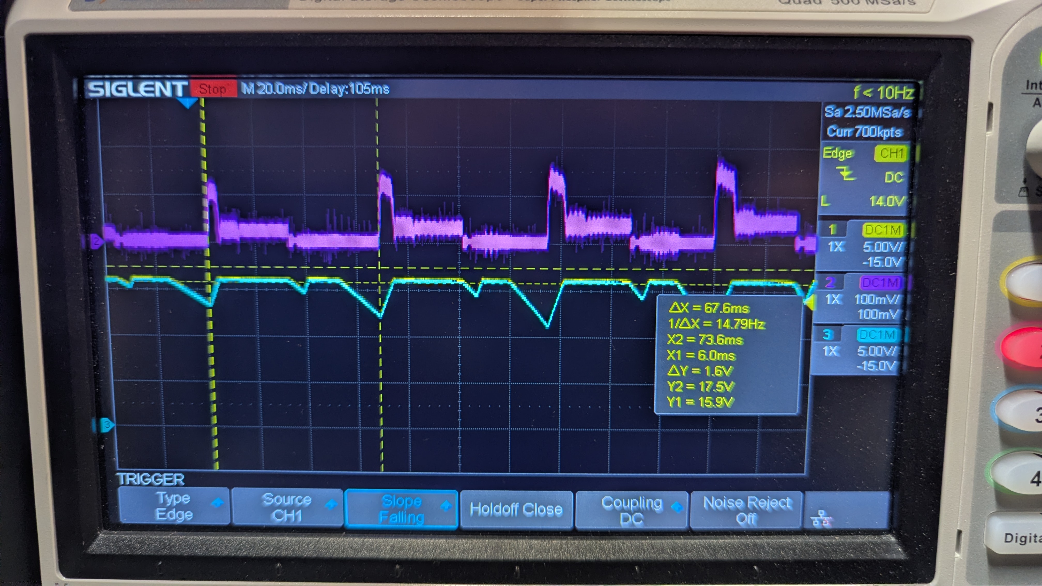
docs/share_sweep_whitepaper/figs/capture12.jpg
