Tangineering/DC-Balancer-Board-Teensy/docs/share_sweep_whitepaper/figs/fig_fc_knee.png

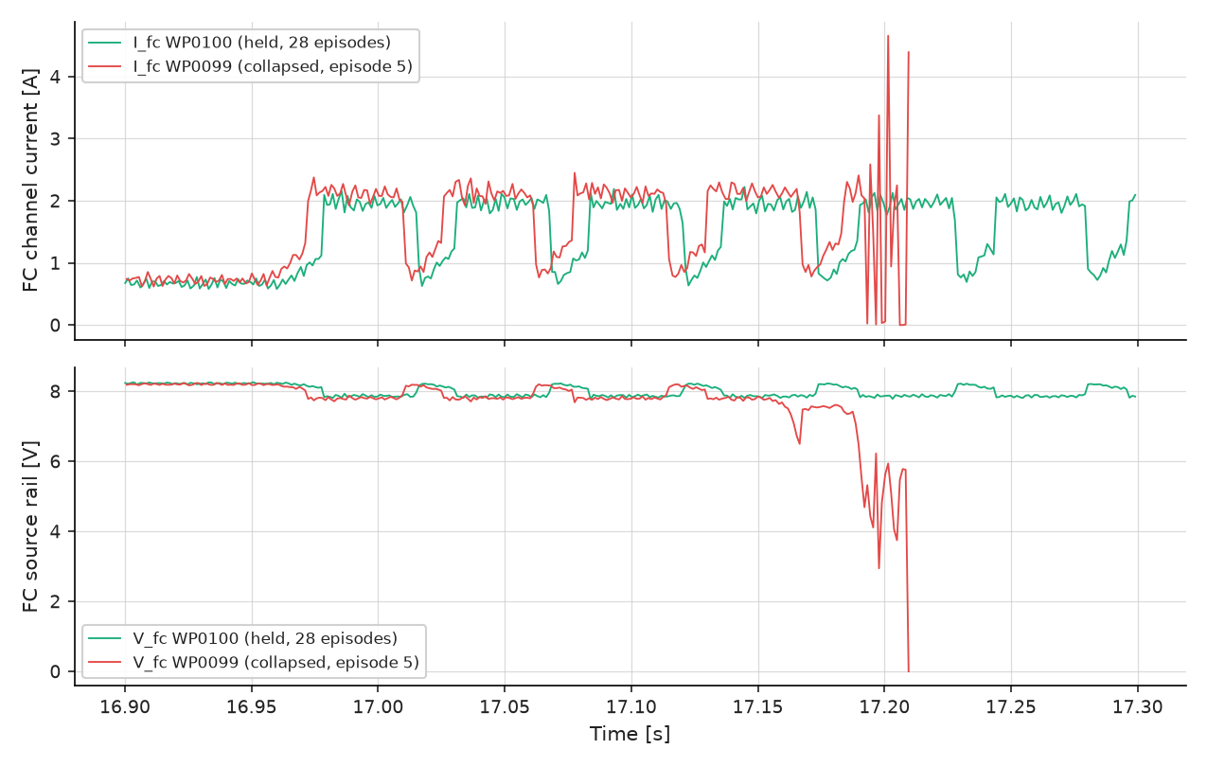
docs/share_sweep_whitepaper/figs/fig_fc_knee.png
