Tangineering/DC-Balancer-Board-Teensy/docs/share_sweep_whitepaper/figs/fig_sweep_summary.png

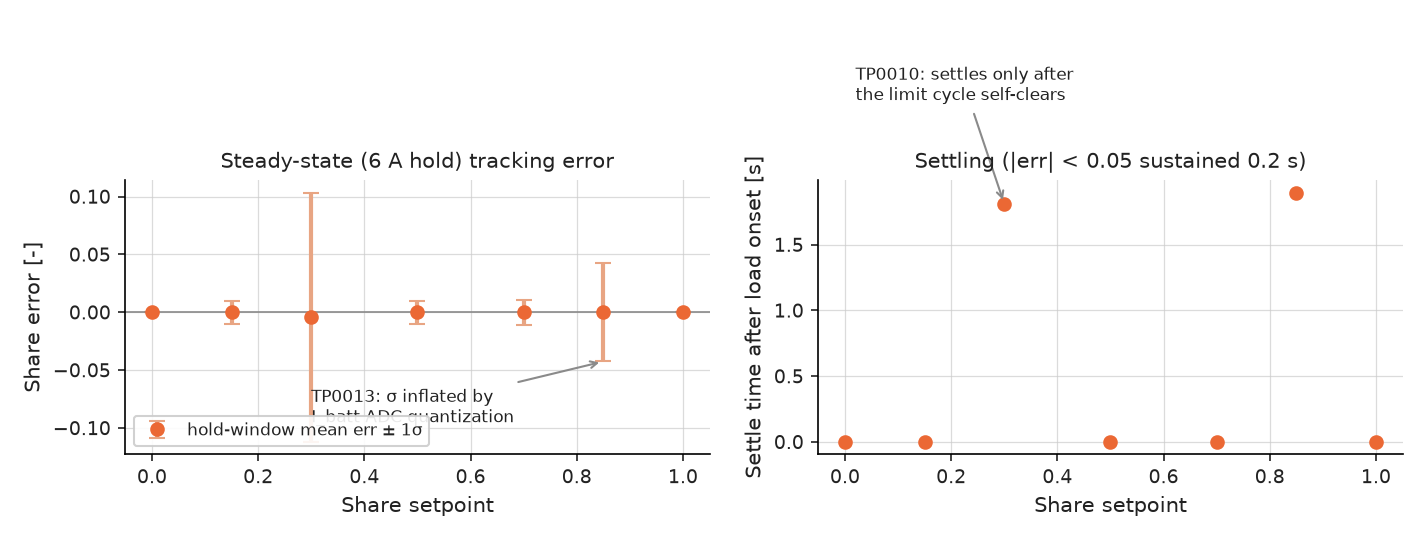
docs/share_sweep_whitepaper/figs/fig_sweep_summary.png
