Tangineering/DC-Balancer-Board-Teensy/docs/share_sweep_whitepaper/figs/fig_tp0010_cycle.png

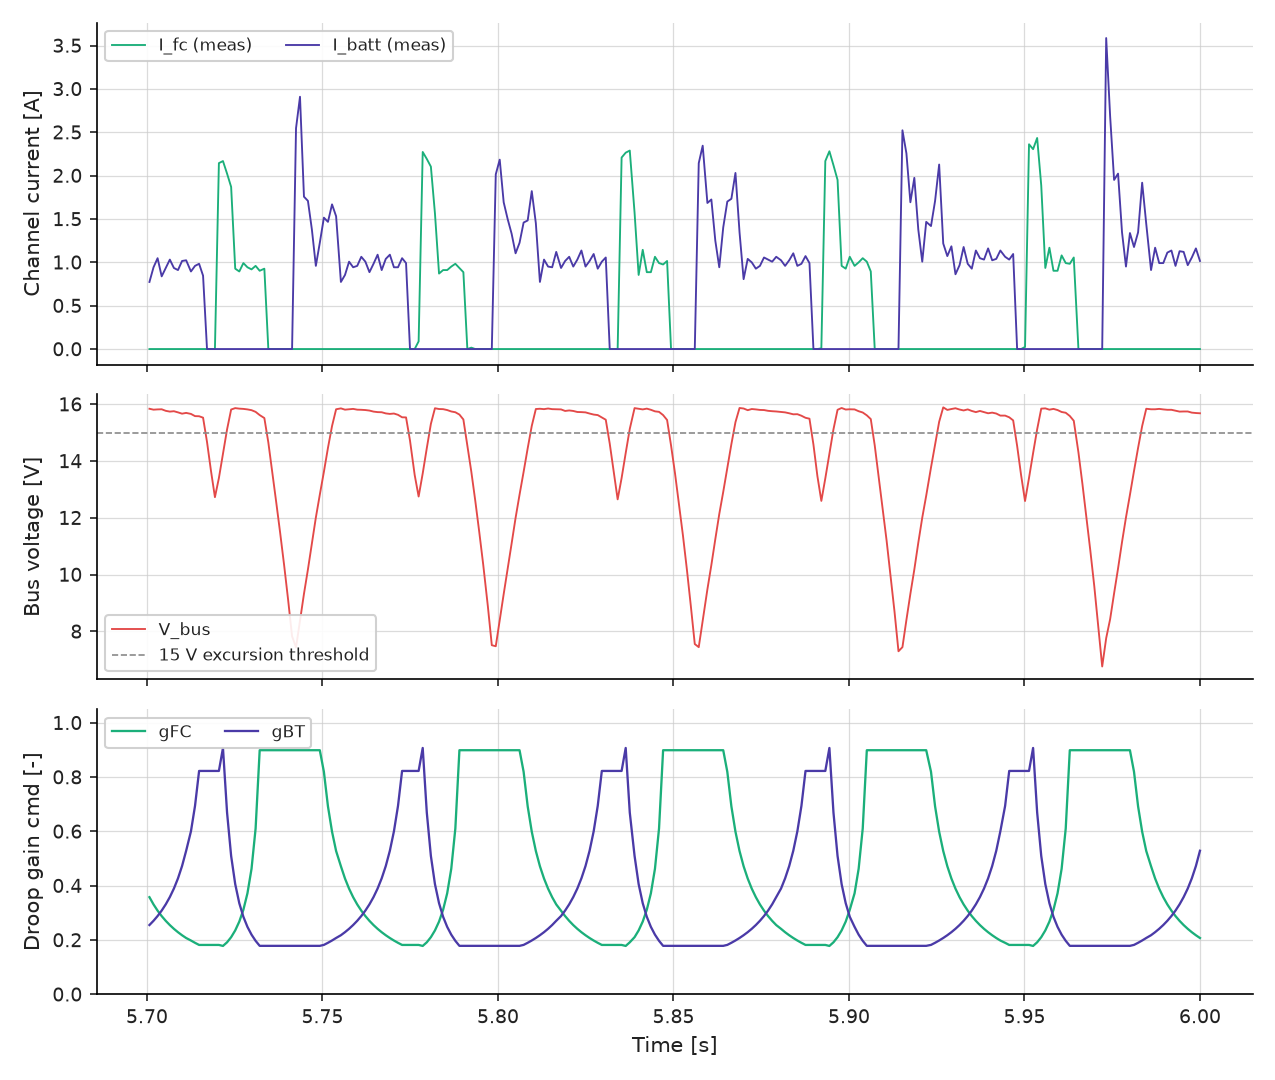
docs/share_sweep_whitepaper/figs/fig_tp0010_cycle.png
