Tangineering/DC-Balancer-Board-Teensy/docs/share_sweep_whitepaper/figs/fig_tp0013_dropout.png

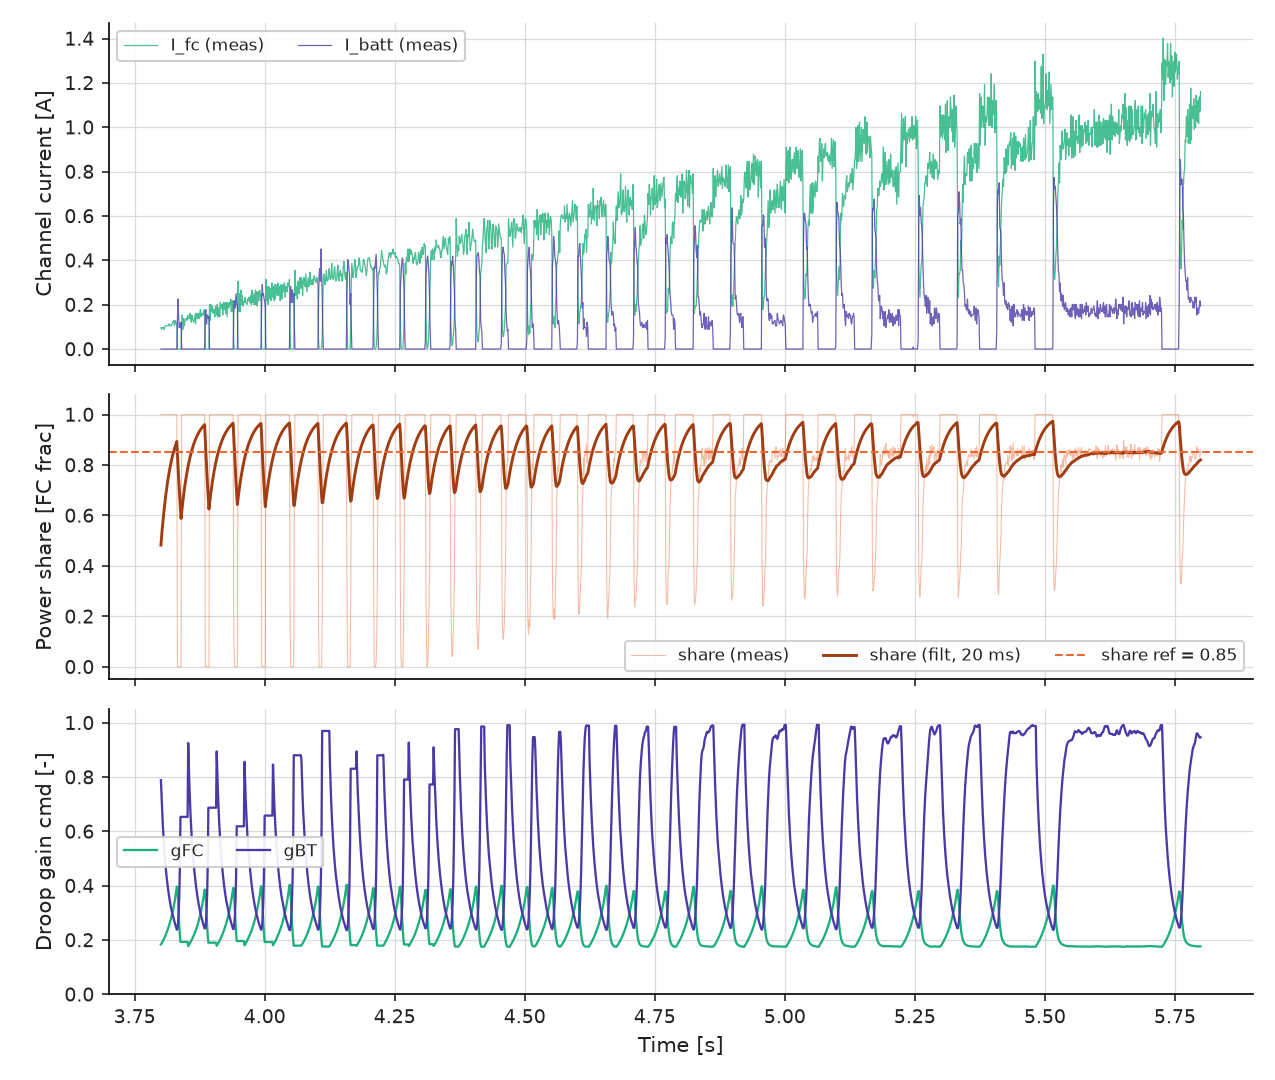
docs/share_sweep_whitepaper/figs/fig_tp0013_dropout.png
