Tangineering/DC-Balancer-Board-Teensy/docs/share_sweep_whitepaper/figs/fig_tp0016_window.png

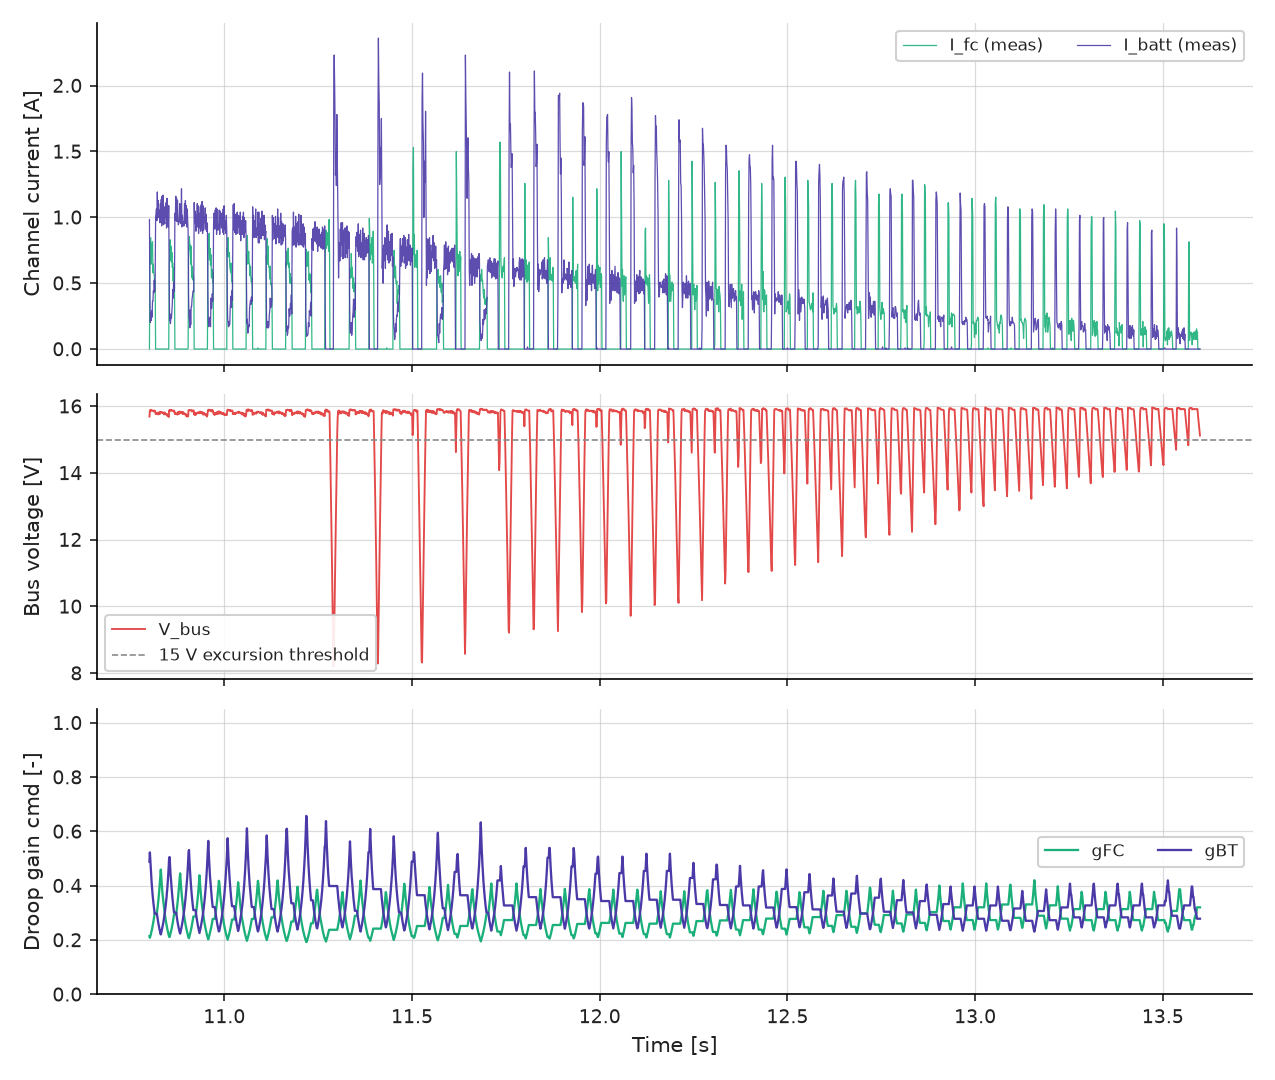
docs/share_sweep_whitepaper/figs/fig_tp0016_window.png
