Tangineering/DC-Balancer-Board-Teensy/docs/share_sweep_whitepaper/figs/fig_tp0037_gap.png

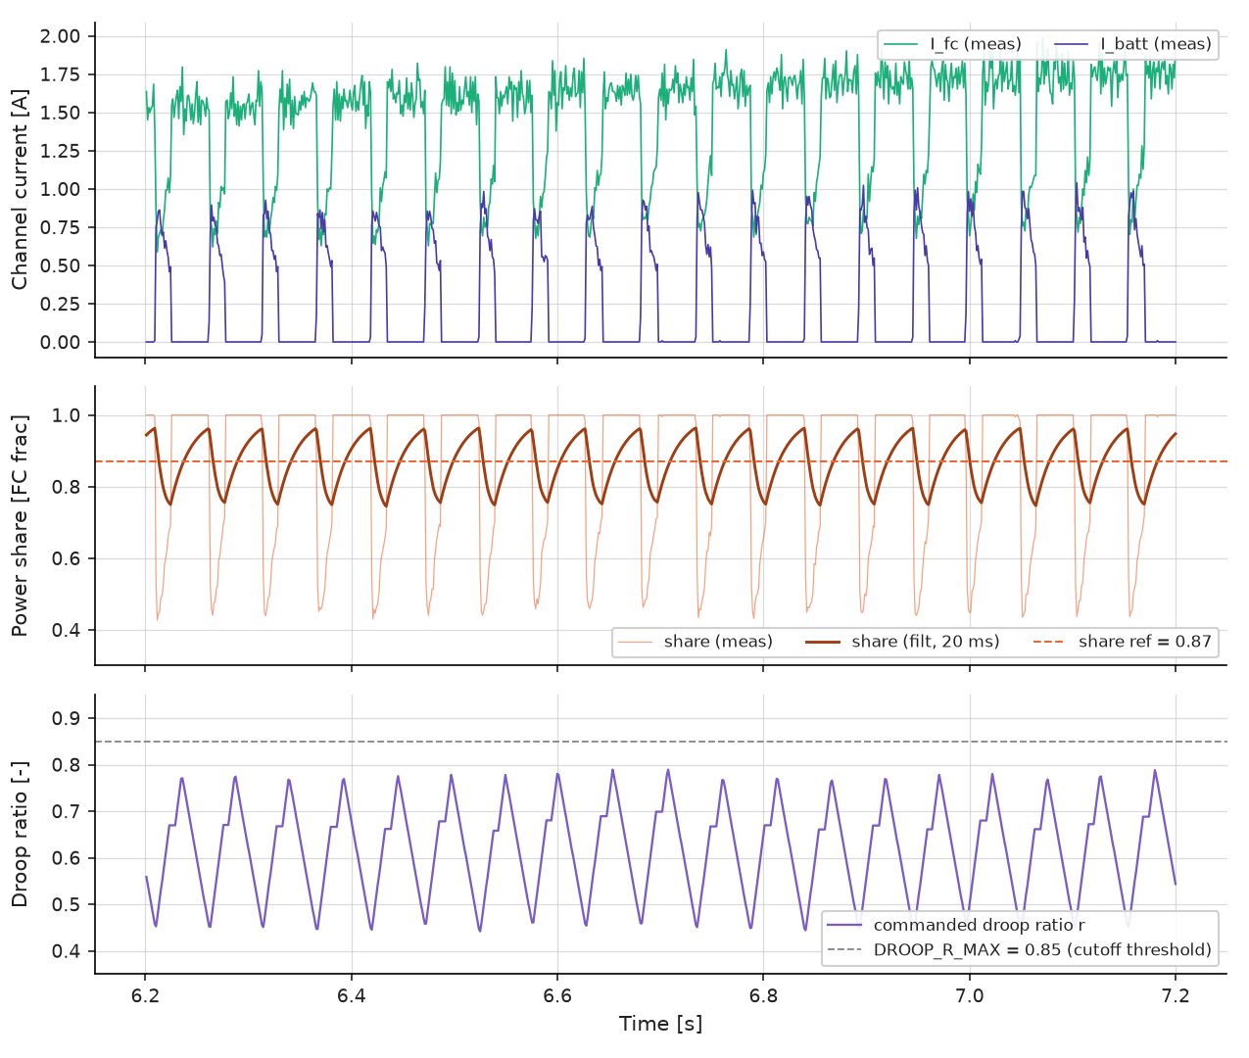
docs/share_sweep_whitepaper/figs/fig_tp0037_gap.png
