Tangineering/DC-Balancer-Board-Teensy/docs/share_sweep_whitepaper/figs/fig_tp0053_relay.png

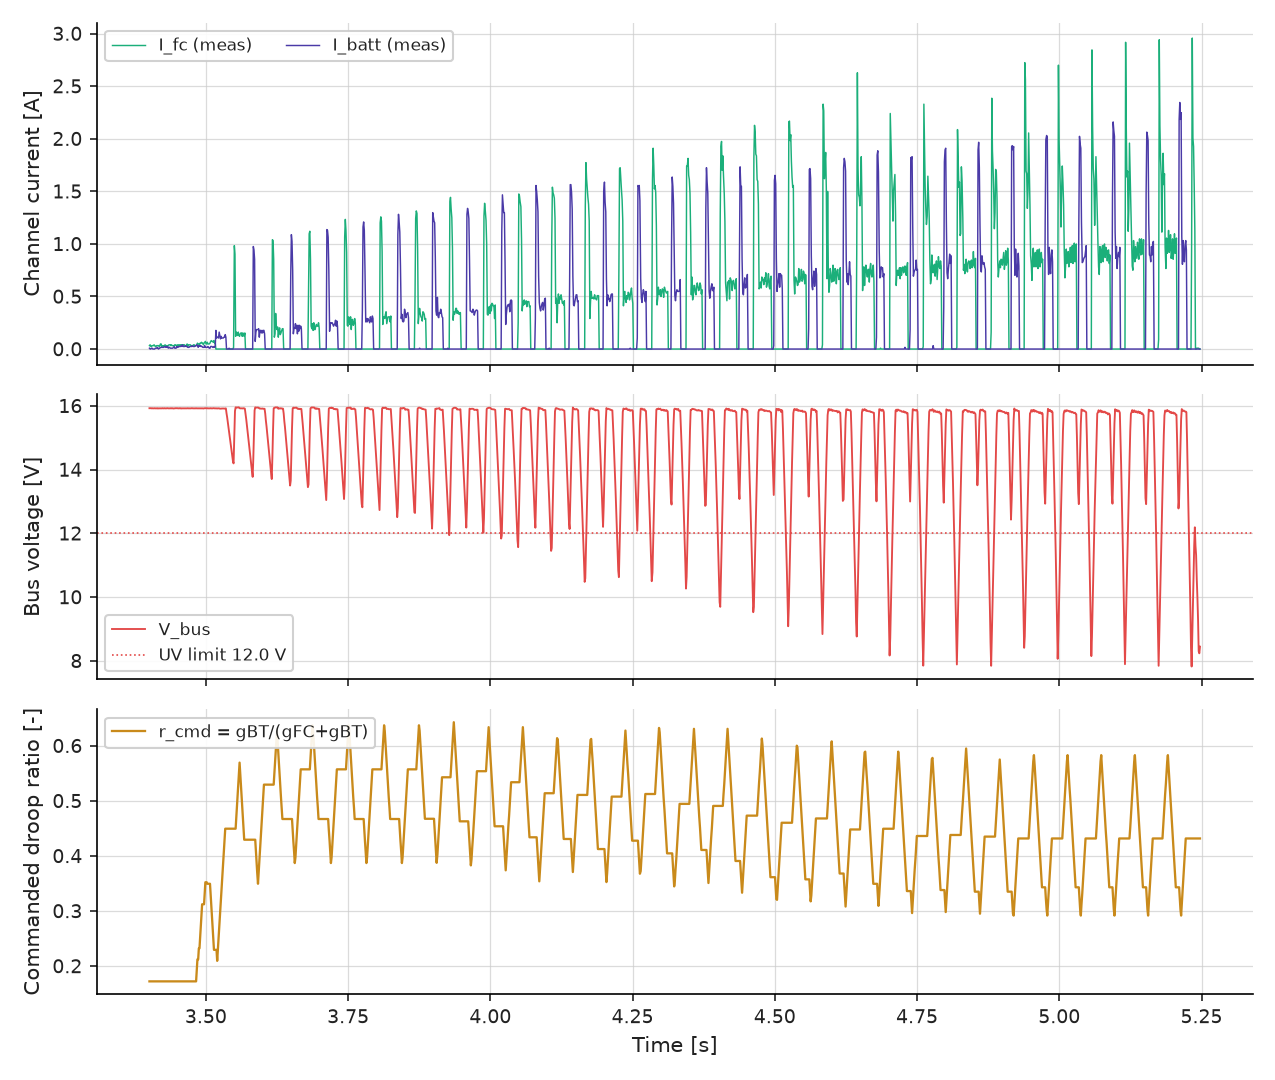
docs/share_sweep_whitepaper/figs/fig_tp0053_relay.png
