Tangineering/DC-Balancer-Board-Teensy/docs/share_sweep_whitepaper/figs/fig_tp0115_handover.png

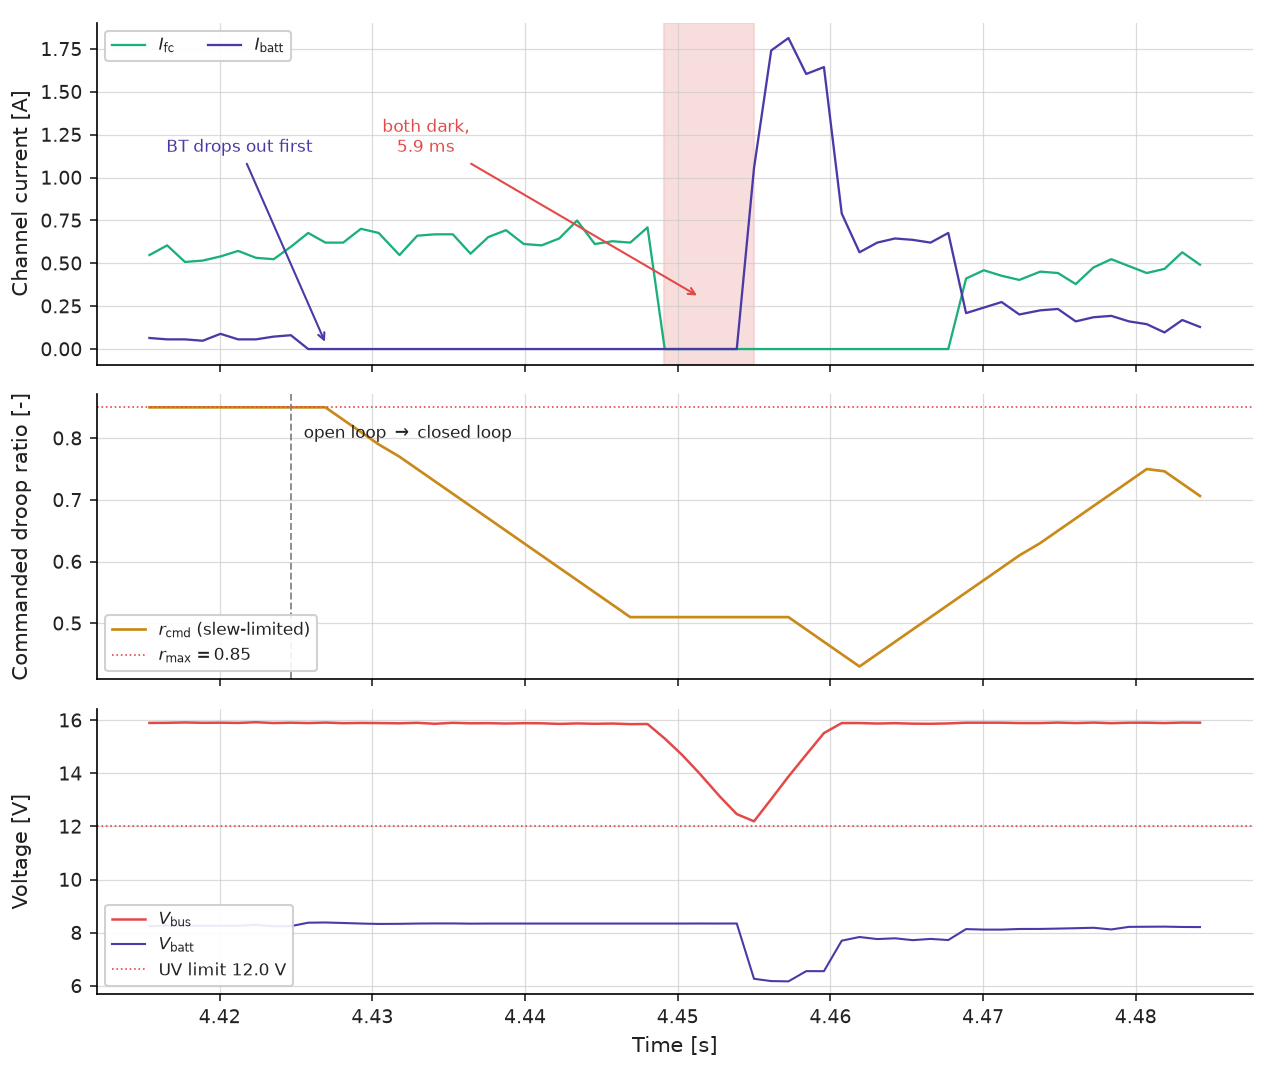
docs/share_sweep_whitepaper/figs/fig_tp0115_handover.png
