Tangineering/DC-Balancer-Board-Teensy/docs/share_sweep_whitepaper/figs/fig_v5sweep_summary.png

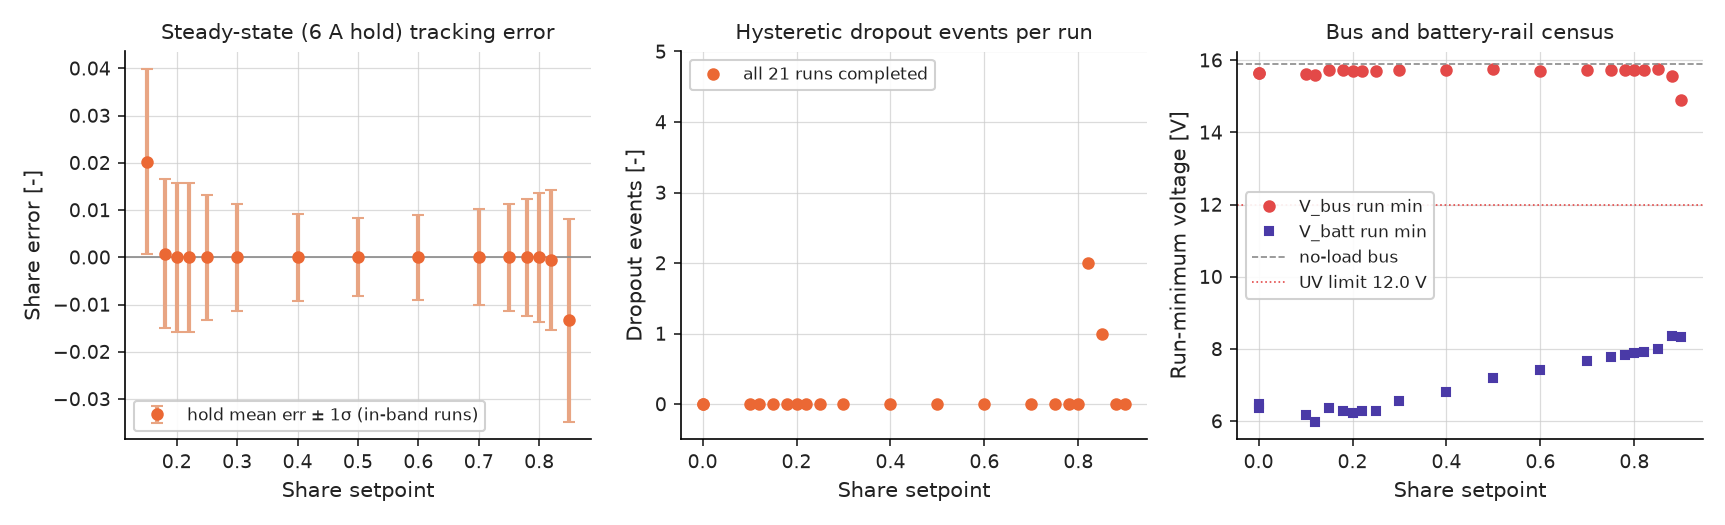
docs/share_sweep_whitepaper/figs/fig_v5sweep_summary.png
