Tangineering/DC-Balancer-Board-Teensy/docs/share_sweep_whitepaper/figs/fig_vbatt_threshold.png

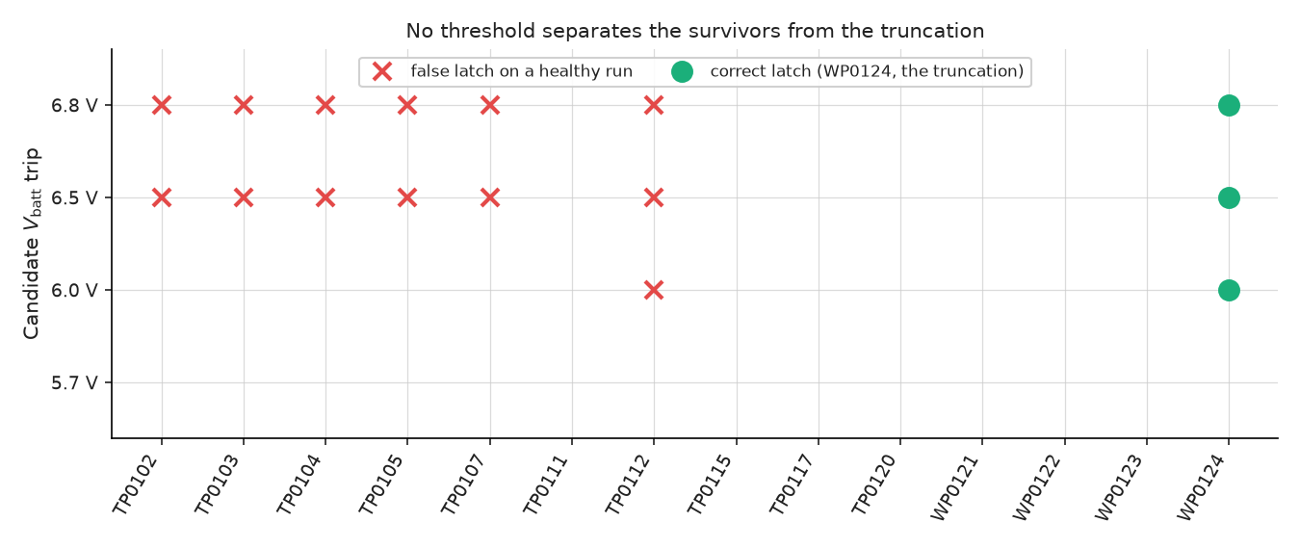
docs/share_sweep_whitepaper/figs/fig_vbatt_threshold.png
