Tangineering/DC-Balancer-Board-Teensy/docs/share_sweep_whitepaper/figs/fig_wp0039_ratchet.png

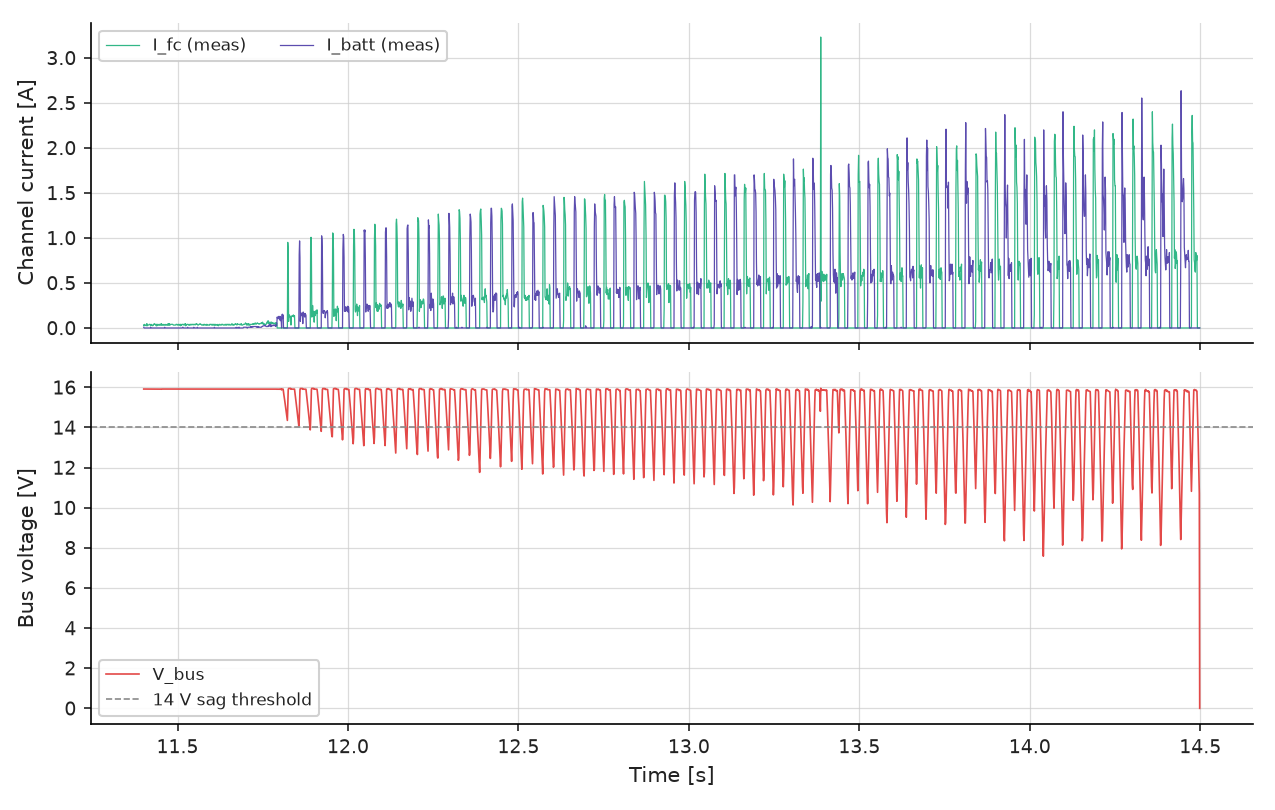
docs/share_sweep_whitepaper/figs/fig_wp0039_ratchet.png
