Tangineering/DC-Balancer-Board-Teensy/docs/share_sweep_whitepaper/figs/fig_wp0040_governor.png

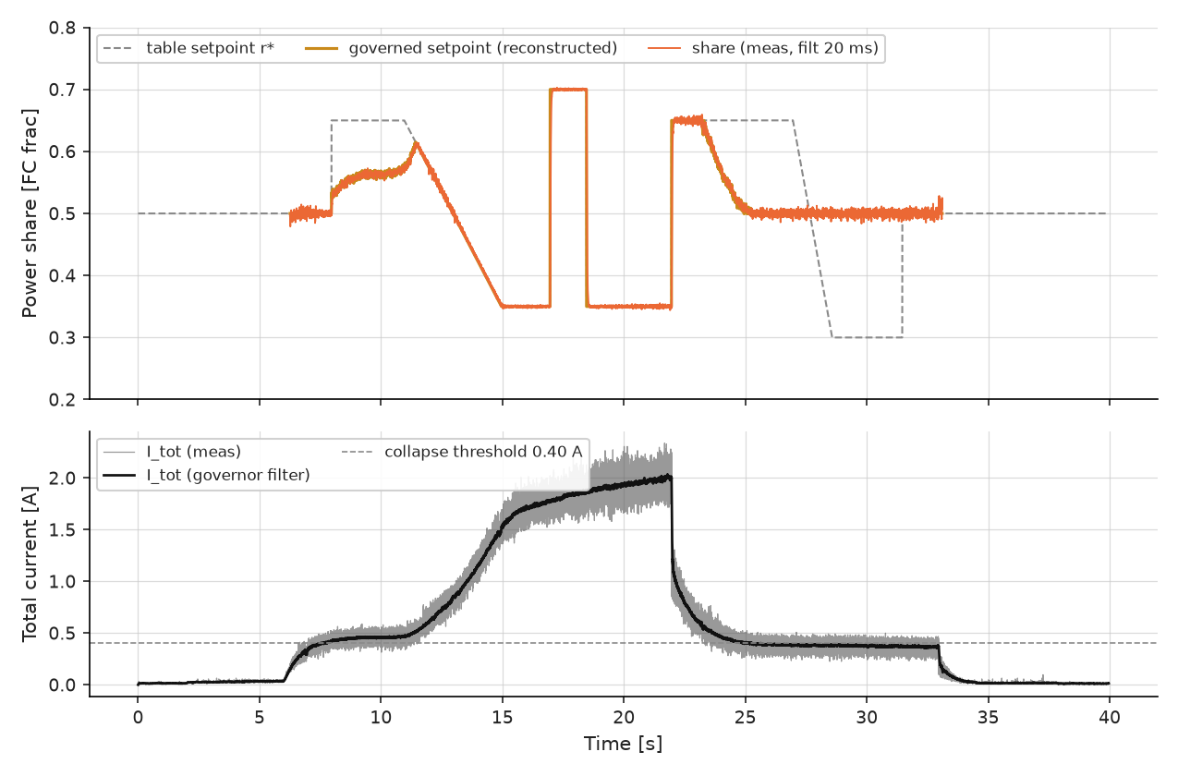
docs/share_sweep_whitepaper/figs/fig_wp0040_governor.png
