Tangineering/DC-Balancer-Board-Teensy/docs/share_sweep_whitepaper/figs/fig_wp0072_cycle.png

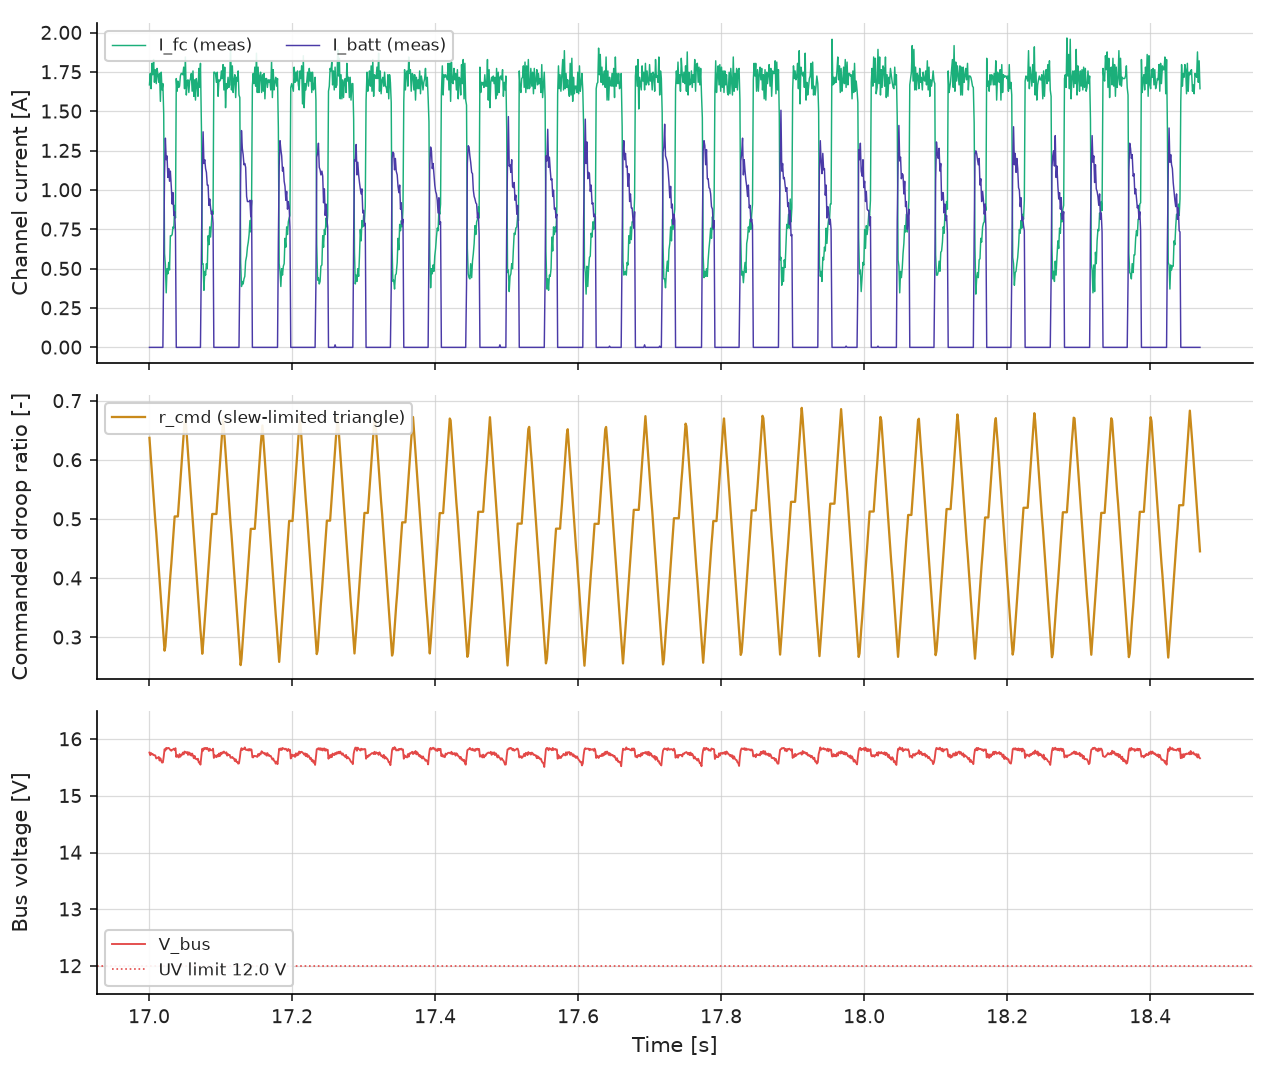
docs/share_sweep_whitepaper/figs/fig_wp0072_cycle.png
