Tangineering/DC-Balancer-Board-Teensy/docs/share_sweep_whitepaper/figs/fig_wp0100_r6.png

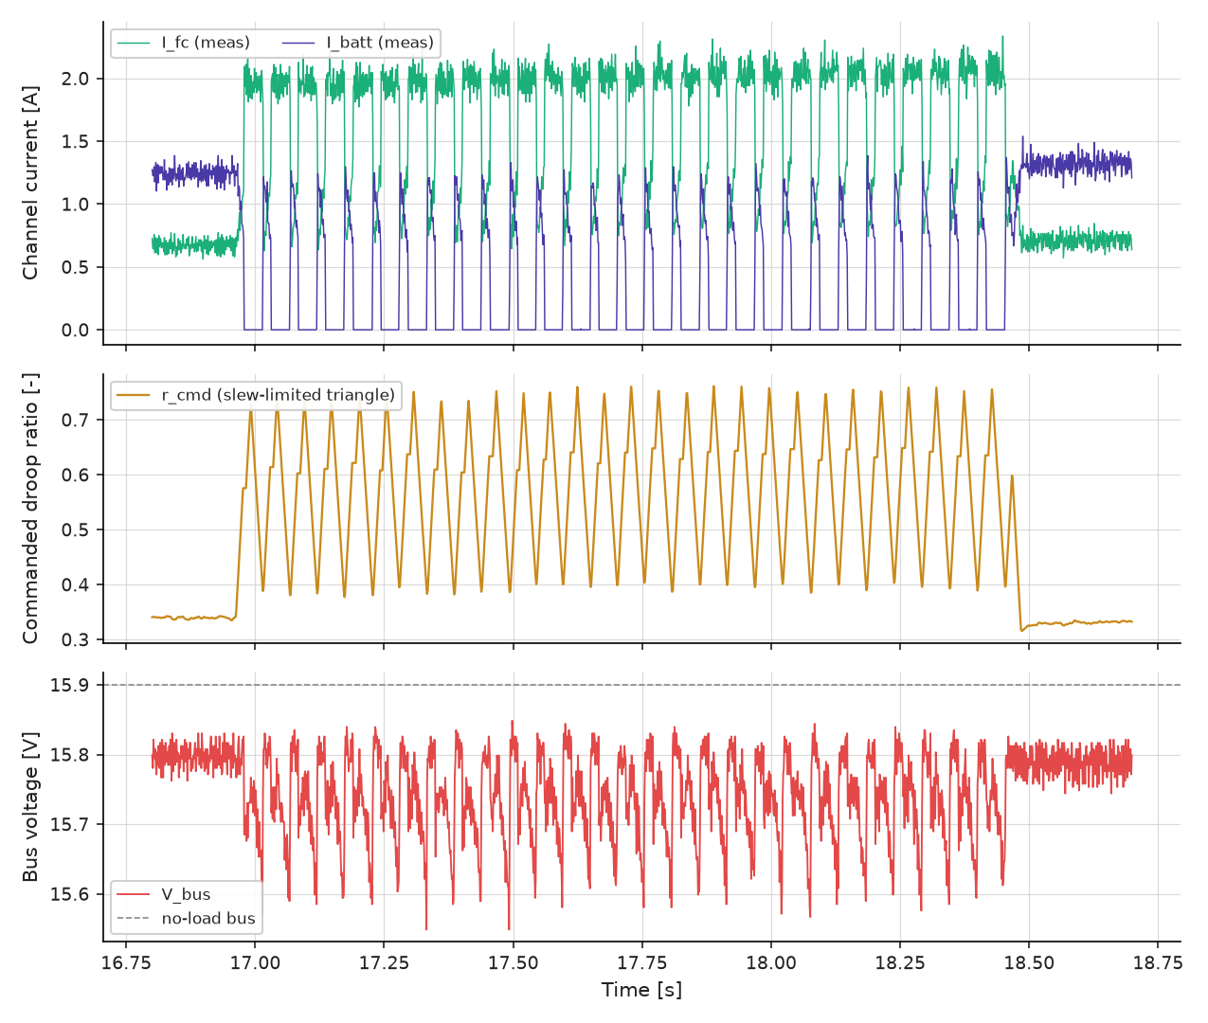
docs/share_sweep_whitepaper/figs/fig_wp0100_r6.png
