Tangineering/DC-Balancer-Board-Teensy/docs/share_sweep_whitepaper/figs/fig_wp0101_cut.png

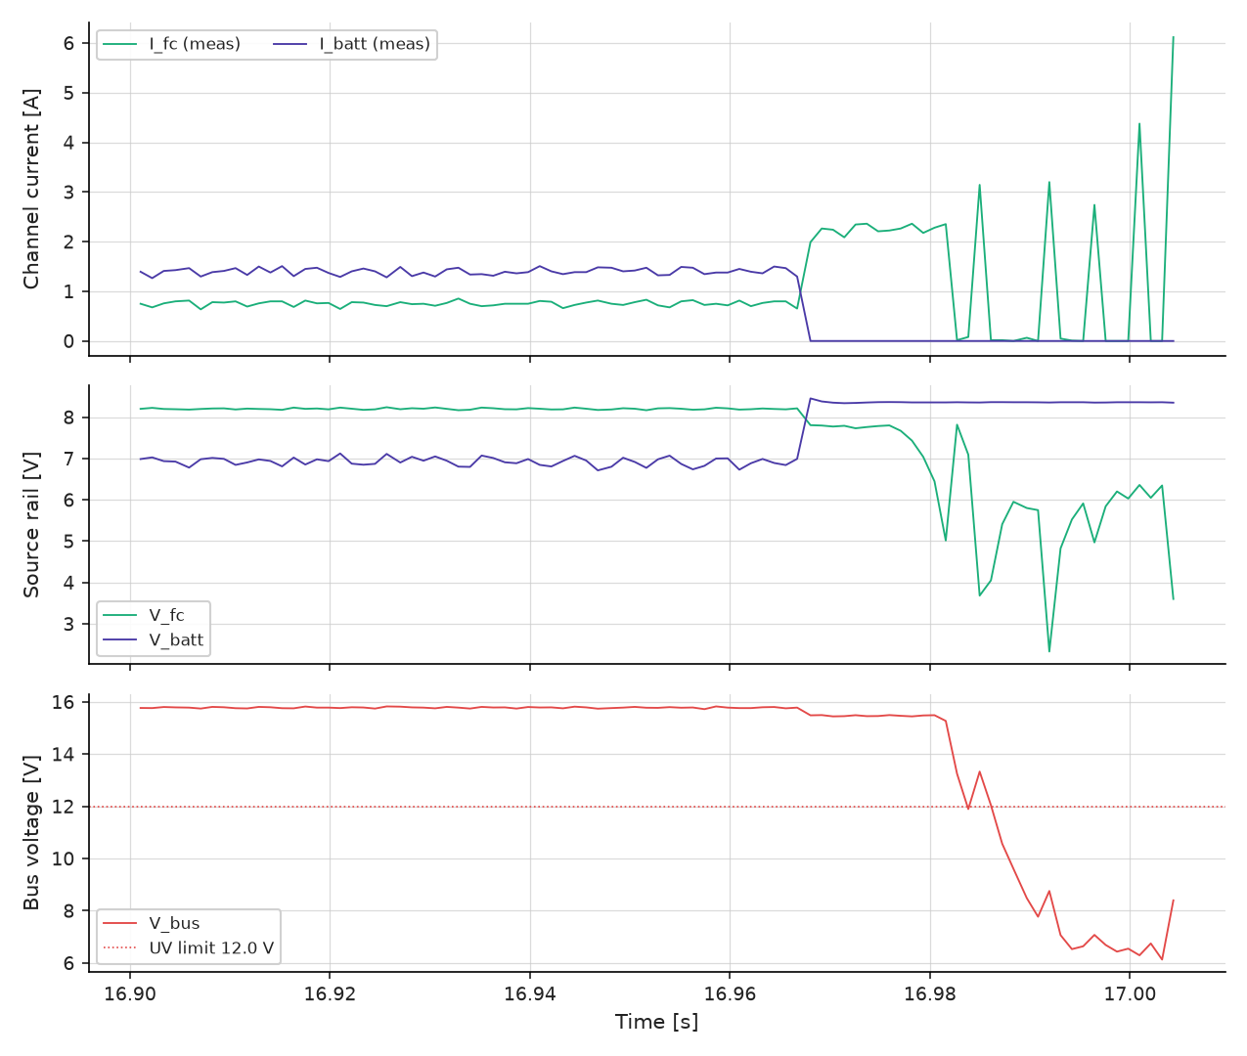
docs/share_sweep_whitepaper/figs/fig_wp0101_cut.png
