Tangineering/DC-Balancer-Board-Teensy/docs/share_sweep_whitepaper/figs/fig_wp0124_brownout.png

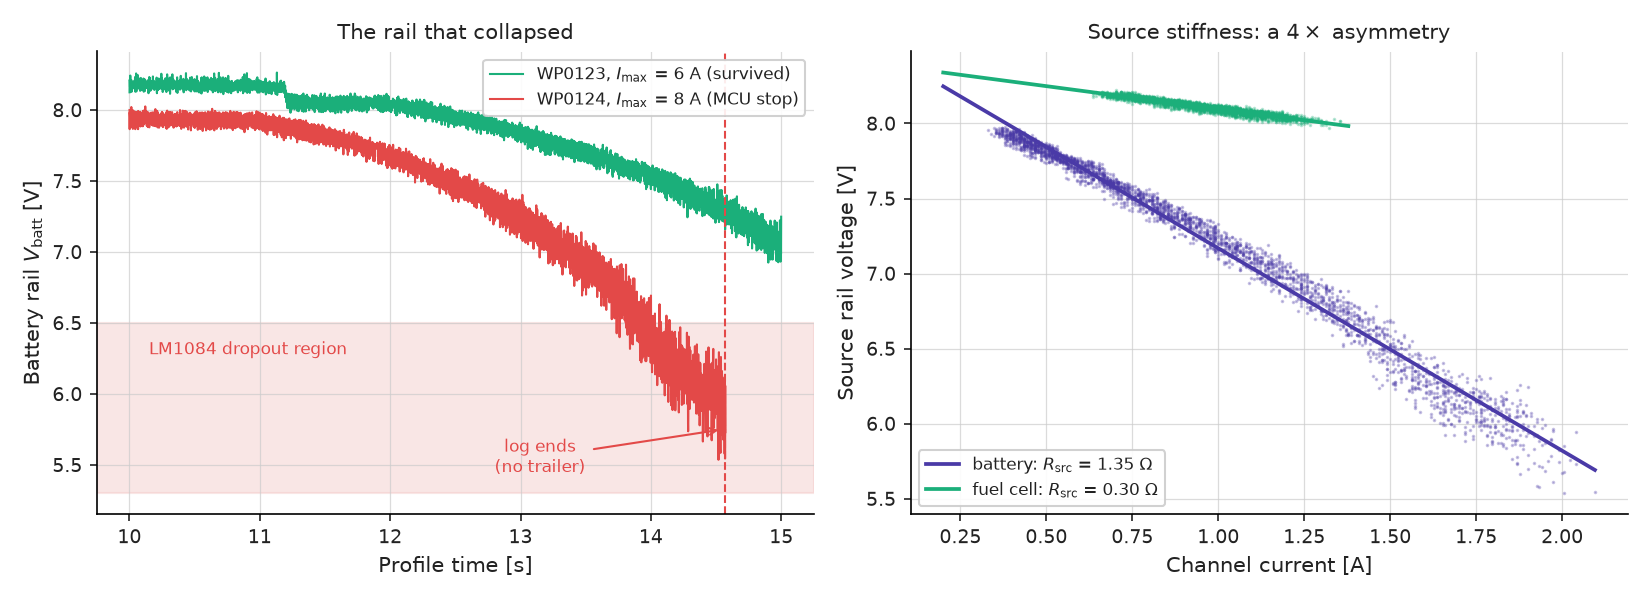
docs/share_sweep_whitepaper/figs/fig_wp0124_brownout.png
