Tangineering/DC-Balancer-Board-Teensy/docs/share_sweep_whitepaper/figs/fig_wp_boundary.png

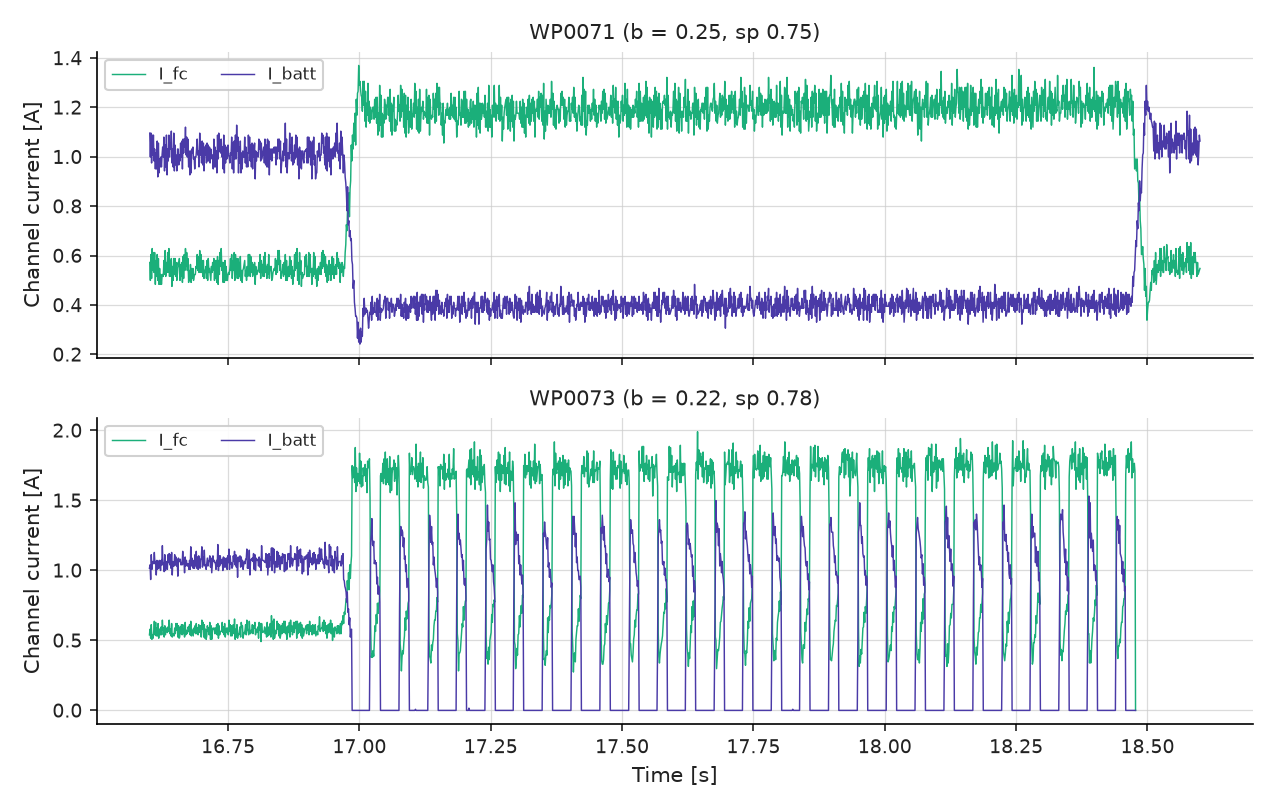
docs/share_sweep_whitepaper/figs/fig_wp_boundary.png
