Tangineering/DC-Balancer-Board-Teensy/hardware/charger_evm_r8/cr/placement_F.png

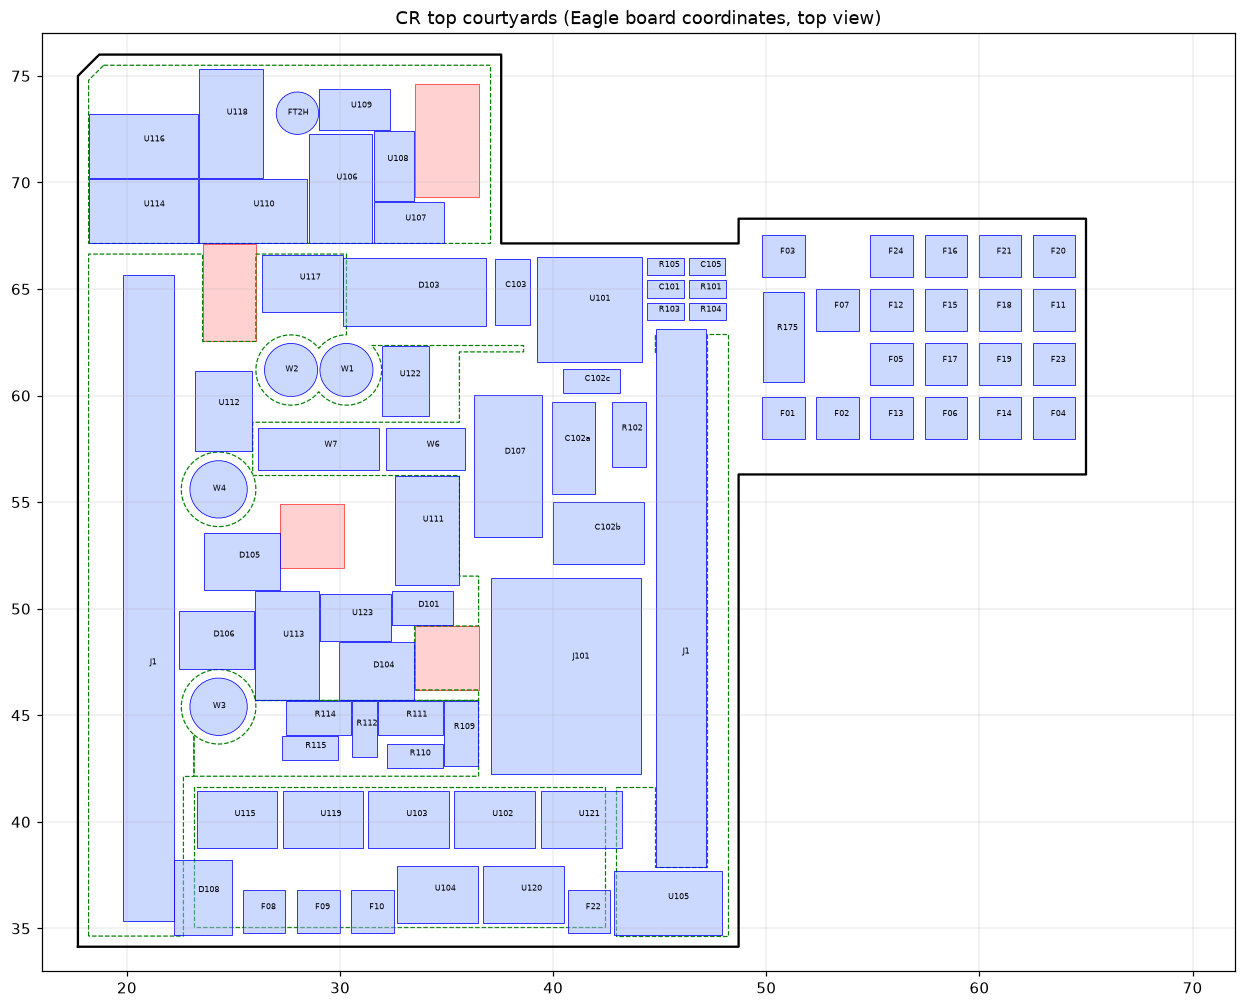
hardware/charger_evm_r8/cr/placement_F.png
