Tangineering/DC-Balancer-Board-Teensy/hardware/charger_evm_r8/cr/route_top.png

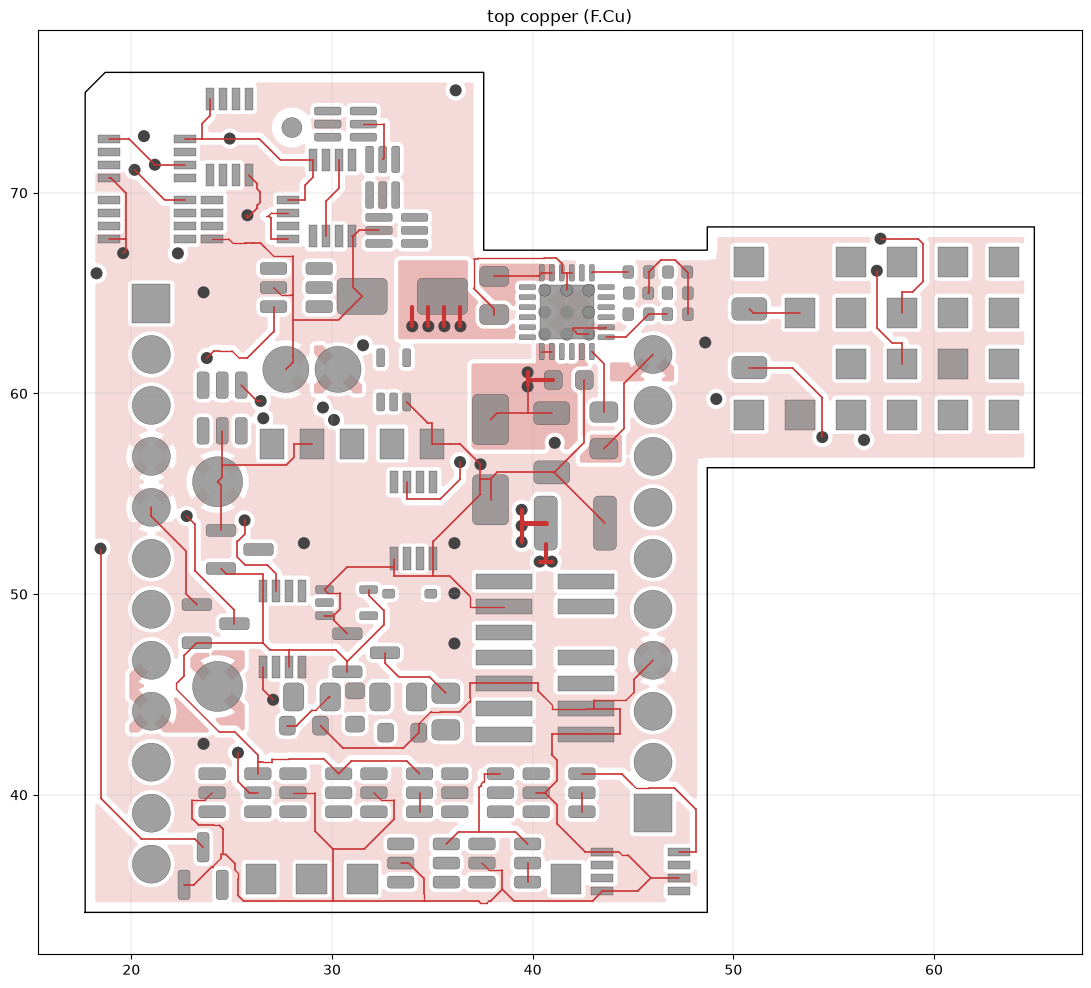
hardware/charger_evm_r8/cr/route_top.png
