Tangineering/DC-Balancer-Board-Teensy/hardware/charger_evm_r8/eib/route_bottom.png

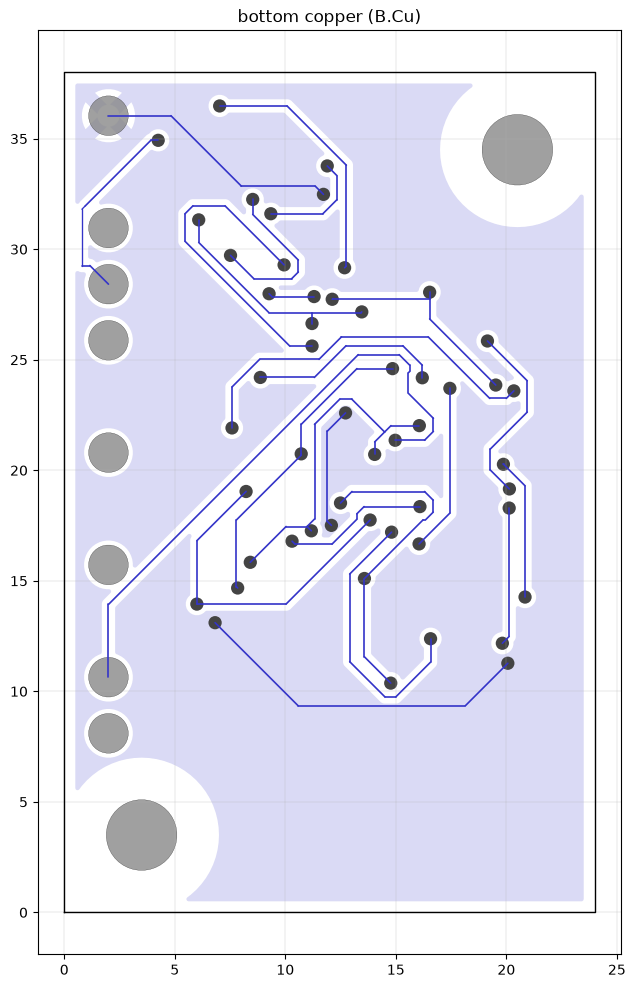
hardware/charger_evm_r8/eib/route_bottom.png
