Tangineering/DC-Balancer-Board-Teensy/hardware/charger_evm_r8/figures/cr_routed_2026-11-13/cr-F_Cu.png

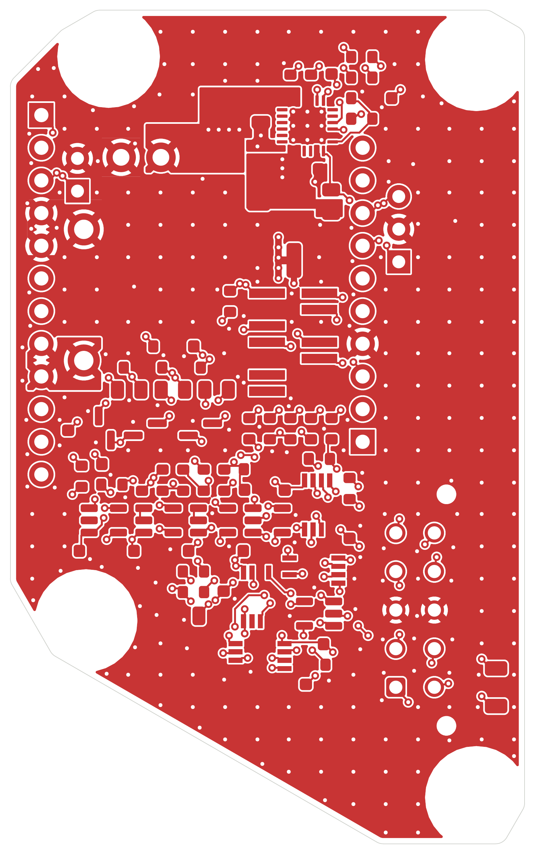
hardware/charger_evm_r8/figures/cr_routed_2026-11-13/cr-F_Cu.png
