Tangineering/DC-Balancer-Board-Teensy/hardware/charger_evm_r8/bom_2026-11-11/ordering_bom.csv

Internal SKU | Part | PCB Names | Specification | Category | Manufacturer | Mft. SKU | Vendor | Vendor SKU | Link | Datasheet | BOM Qty | BOM Units | Cost / BOM Unit | Assembly Cost | Pricing Status | MOQ (for price) | Ready to Order | Ordered | Received | Board Operating Current [mA] | Voltage Min [V] | Voltage Max [V] | Series Min Voltage [V] | Series Max Voltage [V] | Max Current [mA] | Max Power [W] | Board Power [W] | Max Pulse Current [mA] | Max Operating Temp [C] | Max Junction Temp [C] | Junction - SP Resistance [C/W] | Naive Junction Temp Rise [C] | Max Other Resistance [C/W] | Notes | Total Assembly Cost: | $0.00 | PCB components: | 98 | PCB unique parts: | 52
 | BQ25798 evaluation module | EVM | BQ25798EVM, I2C 1-4 cell 5 A buck-boost charger EVM | Charger EVM | Texas Instruments | BQ25798EVM | TI | BQ25798EVM | https://www.ti.com/tool/BQ25798EVM | https://www.ti.com/lit/pdf/sluucb5 | 2.00 | ea |  |  | not verified |  | FALSE | FALSE | FALSE |  |  |  |  |  |  |  |  |  |  |  |  |  |  | Order qty = design qty 2 (section E lists no spare). The TI tool page loaded on 2026-11-11 but its order section (price, inventory) did not render; design section E records USD 156.45 and 162 in stock from 2026-11-05 (not re-read today). Digi-Key listing not checked (site blocked). Datasheet link is the EVM user guide SLUUCB5 (TODO(verify) URL).
 | eFuse | U101 | 60 V eFuse, adjustable OVP, VQFN-24 4x4 | CR IC | Texas Instruments | TPS26630RGER | Digikey |  | https://www.digikey.com/en/products/detail/texas-instruments/TPS26630RGER/10820326 | https://www.ti.com/lit/ds/symlink/tps2663.pdf | 2.00 | ea |  |  | not verified |  | FALSE | FALSE | FALSE |  |  | 60 |  |  |  |  |  |  |  |  |  |  |  | Order qty = design qty 1 + spare 1. Link and Vendor SKU from the digikey.com search-engine index, not read on the live page; confirm before ordering. Price and stock not read: digikey.com, mouser.com, newark.com, arrow.com and octopart.com served bot-check or 403 pages to the built-in browser on 2026-11-11. Search-index snippet (undated) reported Digi-Key stock 0 with a restock date in 2027; availability is a risk - TODO(verify).
 | Comparator with 1.242 V reference | U102,U103,U119,U120 | Comparator + ref, push-pull, SOT-23-6 | CR IC | Texas Instruments | TLV3012BIDBVR | Digikey | 296-TLV3012BIDBVRCT-ND | https://www.digikey.com/en/products/detail/texas-instruments/TLV3012BIDBVR/19236305 | https://www.ti.com/lit/ds/symlink/tlv3012.pdf | 6.00 | ea |  |  | not verified |  | FALSE | FALSE | FALSE |  |  |  |  |  |  |  |  |  |  |  |  |  |  | Order qty = design qty 4 + spare 2. r9 (2026-11-12): U104, U115 and U121 are removed by the tap review (decisions_2026-11-12/cr_tap_review_2026-11-12.md); EIB U203 and U204 are DNP (round2 dec2-eib) and not ordered. U117 was removed with DNP tier 3 (D-31). Link and Vendor SKU from the digikey.com search-engine index, not read on the live page; confirm before ordering. Price and stock not read: digikey.com, mouser.com, newark.com, arrow.com and octopart.com served bot-check or 403 pages to the built-in browser on 2026-11-11.
 | Triple inverter | U105 | SN74LVC3G04, SSOP-8 (DCT) | CR IC | Texas Instruments | SN74LVC3G04DCTR | Digikey |  | https://www.digikey.com/en/products/detail/texas-instruments/SN74LVC3G04DCTR/484594 | https://www.ti.com/lit/ds/symlink/sn74lvc3g04.pdf | 2.00 | ea |  |  | not verified |  | FALSE | FALSE | FALSE |  |  |  |  |  |  |  |  |  |  |  |  |  |  | Order qty = design qty 1 + spare 1. r9 (2026-11-12): U105 uses sections 1 (FCCNN, SAFETY-1) and 2 (P5N) under the dec2-gate 5-LVC mapping, so it stays DCT (dec2-assembly rule 2b). Link and Vendor SKU from the digikey.com search-engine index, not read on the live page; confirm before ordering. Only the tape-and-reel SKU 296-13278-2-ND was seen in the index; the cut-tape SKU was not seen, so Vendor SKU is blank. Price and stock not read: digikey.com, mouser.com, newark.com, arrow.com and octopart.com served bot-check or 403 pages to the built-in browser on 2026-11-11.
 | Dual OR gate | U106,U110 | SN74LVC2G32, SSOP-8 (DCT) | CR IC | Texas Instruments | SN74LVC2G32DCTR | Digikey | 296-13267-1-ND | https://www.digikey.com/en/products/detail/texas-instruments/SN74LVC2G32DCTR/484828 | https://www.ti.com/lit/ds/symlink/sn74lvc2g32.pdf | 3.00 | ea |  |  | not verified |  | FALSE | FALSE | FALSE |  |  |  |  |  |  |  |  |  |  |  |  |  |  | Order qty = design qty 2 + spare 1. r9 (2026-11-12): U106 uses both sections (U106A buffers CE_DRV, U106B forms RFC_OFF; dec2-gate item 3), so it stays DCT; the dec2-assembly change U106 -> SN74LVC1G32DBVR is void. U110 forms GATE and ILIM_REL. Link and Vendor SKU from the digikey.com search-engine index, not read on the live page; confirm before ordering. Price and stock not read: digikey.com, mouser.com, newark.com, arrow.com and octopart.com served bot-check or 403 pages to the built-in browser on 2026-11-11.
 | 3-input AND gate | U107 | SN74LVC1G11, SOT-23-6 (DBV) | CR IC | Texas Instruments | SN74LVC1G11DBVR | Digikey |  | https://www.digikey.com/en/products/result?keywords=SN74LVC1G11DBVR | https://www.ti.com/lit/ds/symlink/sn74lvc1g11.pdf | 2.00 | ea |  |  | not verified |  | FALSE | FALSE | FALSE |  |  |  |  |  |  |  |  |  |  |  |  |  |  | Order qty = design qty 1 + spare 1. r9 (2026-11-12): U108 and U109 are removed (dec2-gate 5-LVC mapping); U107 forms QF = QUAL AND FCCN AND P5N. Package DCK -> DBV by the dec2-assembly rule 2b (single gates to SOT-23 DBV); was SN74LVC1G11DCKR. TODO(verify: TI SN74LVC1G11 Pin Functions table) the DBV pinout against the DCK pinout, and re-check B.8 pin by pin. No Digi-Key product page URL was found; Link is the Digi-Key keyword search; Vendor SKU blank. Price and stock not read: digikey.com, mouser.com, newark.com, arrow.com and octopart.com served bot-check or 403 pages to the built-in browser on 2026-11-11.
 | Dual AND gate | U118 | SN74LVC2G08, SSOP-8 (DCT) | CR IC | Texas Instruments | SN74LVC2G08DCTR | Digikey | 296-13263-1-ND | https://www.digikey.com/en/products/detail/texas-instruments/SN74LVC2G08DCTR/484829 | https://www.ti.com/lit/ds/symlink/sn74lvc2g08.pdf | 2.00 | ea |  |  | not verified |  | FALSE | FALSE | FALSE |  |  |  |  |  |  |  |  |  |  |  |  |  |  | Order qty = design qty 1 + spare 1. r9 (2026-11-12): U114 and U116 are removed (dec2-gate 5-LVC mapping); U118 forms H1U = H1 AND UVB (gate A) and FCCP = FCC_ON AND FCCNN (gate B, SAFETY-1). Link and Vendor SKU from the digikey.com search-engine index, not read on the live page; confirm before ordering. Price and stock not read: digikey.com, mouser.com, newark.com, arrow.com and octopart.com served bot-check or 403 pages to the built-in browser on 2026-11-11.
 | Triple open-drain inverter | U201 | SN74LVC3G06, SSOP-8 (DCT) | EIB IC | Texas Instruments | SN74LVC3G06DCTR | Digikey |  | https://www.digikey.com/en/products/result?keywords=SN74LVC3G06DCTR | https://www.ti.com/lit/ds/symlink/sn74lvc3g06.pdf | 2.00 | ea |  |  | not verified |  | FALSE | FALSE | FALSE |  |  |  |  |  |  |  |  |  |  |  |  |  |  | Order qty = design qty 1 + spare 1. No Digi-Key product page URL was found; Link is the Digi-Key keyword search; Vendor SKU blank. Price and stock not read: digikey.com, mouser.com, newark.com, arrow.com and octopart.com served bot-check or 403 pages to the built-in browser on 2026-11-11.
 | Single open-drain inverter | U202 | SN74LVC1G06, SC70-5 (DCK) | EIB IC | Texas Instruments | SN74LVC1G06DCKR | Digikey | 296-8484-1-ND | https://www.digikey.com/en/products/detail/texas-instruments/SN74LVC1G06DCKR/377452 | https://www.ti.com/lit/ds/symlink/sn74lvc1g06.pdf | 2.00 | ea |  |  | not verified |  | FALSE | FALSE | FALSE |  |  |  |  |  |  |  |  |  |  |  |  |  |  | Order qty = design qty 1 + spare 1. Link and Vendor SKU from the digikey.com search-engine index, not read on the live page; confirm before ordering. Price and stock not read: digikey.com, mouser.com, newark.com, arrow.com and octopart.com served bot-check or 403 pages to the built-in browser on 2026-11-11.
 | N-MOSFET 60 V logic level | Q201,Q202 | 60 V, 320 mA, SOT-23 | EIB discrete | onsemi | 2N7002KT1G | Digikey | 2N7002KT1GOSCT-ND | https://www.digikey.com/en/products/detail/onsemi/2N7002KT1G/1792138 | https://www.onsemi.com/pdf/datasheet/2n7002k-d.pdf | 5.00 | ea |  |  | not verified |  | FALSE | FALSE | FALSE |  |  | 60 |  |  |  |  |  |  |  |  |  |  |  | Order qty = design qty 2 + spare 3. Link and Vendor SKU from the digikey.com search-engine index, not read on the live page; confirm before ordering. Index snippets disagree on stock (one shows backorder). Price and stock not read: digikey.com, mouser.com, newark.com, arrow.com and octopart.com served bot-check or 403 pages to the built-in browser on 2026-11-11.
 | P-MOSFET 50 V | Q203 | 50 V, 130 mA, SOT-23, |VGS(th)| <= 2.0 V required | EIB discrete | onsemi | BSS84LT1G | Digikey | BSS84LT1GOSCT-ND | https://www.digikey.com/en/products/result?keywords=BSS84LT1G | https://www.onsemi.com/pdf/datasheet/bss84lt1-d.pdf | 3.00 | ea |  |  | not verified |  | FALSE | FALSE | FALSE |  |  | 50 |  |  |  |  |  |  |  |  |  |  |  | Order qty = design qty 1 + spare 2. Vendor SKU from the search-engine index; no product page URL found (Link is the keyword search). Index notes BSS84LT1 (without G) is obsolete: order the G part. VGS(th) max <= 2.0 V TODO(verify: onsemi datasheet), T-A-05. Price and stock not read: digikey.com, mouser.com, newark.com, arrow.com and octopart.com served bot-check or 403 pages to the built-in browser on 2026-11-11.
 | Schottky diode, SMA | D103 | 100 V, 2 A Schottky, SMA (DO-214AC); IFSM 75 A; IR <= 1 uA at 25 C / <= 1 mA at 125 C (VR = 100 V) | CR discrete | STMicroelectronics | STPS2H100A | Digikey |  | https://www.digikey.com/en/products/detail/stmicroelectronics/STPS2H100A/691857 | https://www.st.com/resource/en/datasheet/stps2h100.pdf | 2.00 | ea |  |  | not verified |  | FALSE | FALSE | FALSE |  |  | 100 |  |  |  |  |  |  |  |  |  |  |  | Order qty = design qty 1 + spare 1. candidate - T-A-05 datasheet check required. Selection: section E rule (IR at 23.6 V/60 C first, then IFSM >= 75 A, then VF at >= 20 A pulse). Datasheet DocID6115 Rev 8 (June 2013) Tables 2 and 4: VRRM 100 V; IF(AV) 2 A; IFSM 75 A (tp 10 ms sine) - meets >= 75 A with zero margin; IR max 1 uA at Tj 25 C and 1 mA max (0.4 mA typ) at Tj 125 C, both at VR = VRRM; the 23.6 V / 60 C value is not tabulated - read it from the IR(VR) curve in T-A-05. VF max 0.79 V at 2 A/25 C, 0.88 V at 4 A/25 C; no >= 20 A pulse VF point in the table (Fig. 14 curve only). ST product page shows status ACTIVE (read 2026-11-11). Bench-only fallback per design: Diodes Inc. B340A-13-F (not ordered here). Link and Vendor SKU from the digikey.com search-engine index, not read on the live page; confirm before ordering. Price and stock not read: digikey.com, mouser.com, newark.com, arrow.com and octopart.com served bot-check or 403 pages to the built-in browser on 2026-11-11. The netlist (gen/netlist.py, cr.net) and design section E leave the D103 MPN open ('selected in T-A-05', bench fallback B340A-13-F); STPS2H100A is the ordering candidate only, TODO(verify: T-A-05).
 | TVS diode, unidirectional, SMA | D107 | 400 W TVS, VRWM 33 V, VBR 36.70-40.60 V at 1 mA, Vc 53.3 V at 7.5 A, IR <= 1 uA at VRWM | CR discrete | Littelfuse | SMAJ33A | Digikey |  | https://www.digikey.com/en/products/detail/littelfuse-inc/SMAJ33A/762508 | https://www.littelfuse.com/products/overvoltage-protection/tvs-diodes/surface-mount/smaj | 2.00 | ea |  |  | not verified |  | FALSE | FALSE | FALSE |  |  | 33 |  |  |  |  |  |  |  |  |  |  |  | Order qty = design qty 1 + spare 1. candidate - T-A-05 datasheet check required. Littelfuse SMAJ series datasheet rev BA.10/21/20, Electrical Characteristics: VR 33.0 V (>= 30 V), VBR min 36.70 V (>= 36 V), VBR max 40.60 V at IT 1 mA, Vc 53.3 V at Ipp 7.5 A (<= 60 V; the T-C-04 residual current is lower than 7.5 A, so Vc there is lower), IR max 1 uA at VR and 25 C. IR at 23.6 V and 60 C is not tabulated - T-A-05 item. Product URL taken from a digikey.com.br index entry (product id 762508 is global); Price and stock not read: digikey.com, mouser.com, newark.com, arrow.com and octopart.com served bot-check or 403 pages to the built-in browser on 2026-11-11.
 | Low-leakage diode pair | D104,D105,D106 | BAV199, 75 V 160 mA series pair, SOT-23 | CR discrete | Nexperia | BAV199,215 | Digikey | 1727-2909-1-ND | https://www.digikey.com/en/products/detail/nexperia-usa-inc/BAV199-215/763223 | https://assets.nexperia.com/documents/data-sheet/BAV199.pdf | 7.00 | ea |  |  | not verified |  | FALSE | FALSE | FALSE |  |  | 75 |  |  |  |  |  |  |  |  |  |  |  | Order qty = design qty 3 + spare 2 + 2 for the T-C-15 pin-38/39 clamp fallback. D108 removed with the T22 input stage (D-38, 2026-11-12). Link and Vendor SKU from the digikey.com search-engine index, not read on the live page; confirm before ordering. Index snippet (undated) showed Digi-Key out of stock with restock 08-Dec-2026; listed direct substitutes are Diodes BAV199-7-F and onsemi BAV199LT1G - TODO(verify) leakage equivalence in T-A-05 before substituting. Price and stock not read: digikey.com, mouser.com, newark.com, arrow.com and octopart.com served bot-check or 403 pages to the built-in browser on 2026-11-11.
 | Resistor, precision | R109 | 487 kOhm 0.1 % 25 ppm/K 0805 thin film | CR resistor | Vishay Dale | TNPW0805487KBEEA | Digikey |  | https://www.digikey.com/en/products/result?keywords=TNPW0805487KBEEA | https://www.vishay.com/docs/28758/tnpw_e3.pdf | 1.00 | ea |  |  | not verified |  | FALSE | FALSE | FALSE |  |  |  |  |  |  |  |  |  |  |  |  |  |  | Order qty = design qty 1 (section E lists no spare). Range checked in Vishay TNPW e3 datasheet doc 28758 (rev 10-Apr-2026) Table 'Temperature coefficient and resistance range': 0805 0.1 %/25 ppm: 3.5 Ohm to 1 MOhm (E192); 487 k in range. No Digi-Key product page URL was found; Link is the Digi-Key keyword search; Vendor SKU blank. Price and stock not read: digikey.com, mouser.com, newark.com, arrow.com and octopart.com served bot-check or 403 pages to the built-in browser on 2026-11-11.
 | Resistor, precision | R111 | 442 kOhm 0.1 % 25 ppm/K 0805 thin film | CR resistor | Vishay Dale | TNPW0805442KBEEA | Digikey |  | https://www.digikey.com/en/products/result?keywords=TNPW0805442KBEEA | https://www.vishay.com/docs/28758/tnpw_e3.pdf | 1.00 | ea |  |  | not verified |  | FALSE | FALSE | FALSE |  |  |  |  |  |  |  |  |  |  |  |  |  |  | Order qty = design qty 1 (section E lists no spare). Range checked in Vishay TNPW e3 datasheet doc 28758 (rev 10-Apr-2026) Table 'Temperature coefficient and resistance range': 0805 0.1 %/25 ppm: 3.5 Ohm to 1 MOhm; 442 k in range. No Digi-Key product page URL was found; Link is the Digi-Key keyword search; Vendor SKU blank. Price and stock not read: digikey.com, mouser.com, newark.com, arrow.com and octopart.com served bot-check or 403 pages to the built-in browser on 2026-11-11.
 | Resistor, precision | R110,R112 | 56.2 kOhm 0.1 % 25 ppm/K 0603 thin film | CR resistor | Vishay Dale | TNPW060356K2BEEA | Digikey |  | https://www.digikey.com/en/products/result?keywords=TNPW060356K2BEEA | https://www.vishay.com/docs/28758/tnpw_e3.pdf | 2.00 | ea |  |  | not verified |  | FALSE | FALSE | FALSE |  |  |  |  |  |  |  |  |  |  |  |  |  |  | Order qty = design qty 2 (section E lists no spare). Range checked in Vishay TNPW e3 datasheet doc 28758 (rev 10-Apr-2026) Table 'Temperature coefficient and resistance range': 0603 0.1 %/25 ppm: 3.5 Ohm to 332 kOhm; 56.2 k in range. No Digi-Key product page URL was found; Link is the Digi-Key keyword search; Vendor SKU blank. Price and stock not read: digikey.com, mouser.com, newark.com, arrow.com and octopart.com served bot-check or 403 pages to the built-in browser on 2026-11-11.
 | Resistor, precision | R114 | 1.00 MOhm 0.1 % 25 ppm/K 0805 thin film | CR resistor | Vishay Dale | TNPW08051M00BEEA | Digikey |  | https://www.digikey.com/en/products/result?keywords=TNPW08051M00BEEA | https://www.vishay.com/docs/28758/tnpw_e3.pdf | 1.00 | ea |  |  | not verified |  | FALSE | FALSE | FALSE |  |  |  |  |  |  |  |  |  |  |  |  |  |  | Order qty = design qty 1 (section E lists no spare). Range checked in Vishay TNPW e3 datasheet doc 28758 (rev 10-Apr-2026) Table 'Temperature coefficient and resistance range': 0805 0.1 %/25 ppm: up to 1 MOhm; 1.00 M is the range top. No Digi-Key product page URL was found; Link is the Digi-Key keyword search; Vendor SKU blank. Price and stock not read: digikey.com, mouser.com, newark.com, arrow.com and octopart.com served bot-check or 403 pages to the built-in browser on 2026-11-11.
 | Resistor, precision | R115 | 104 kOhm 0.1 % 25 ppm/K 0603 thin film | CR resistor | Vishay Dale | TNPW0603104KBEEA | Digikey |  | https://www.digikey.com/en/products/result?keywords=TNPW0603104KBEEA | https://www.vishay.com/docs/28758/tnpw_e3.pdf | 1.00 | ea |  |  | not verified |  | FALSE | FALSE | FALSE |  |  |  |  |  |  |  |  |  |  |  |  |  |  | Order qty = design qty 1 (section E lists no spare). Range checked in Vishay TNPW e3 datasheet doc 28758 (rev 10-Apr-2026) Table 'Temperature coefficient and resistance range': 0603 0.1 %/25 ppm: up to 332 kOhm; 104 k in range. No Digi-Key product page URL was found; Link is the Digi-Key keyword search; Vendor SKU blank. Price and stock not read: digikey.com, mouser.com, newark.com, arrow.com and octopart.com served bot-check or 403 pages to the built-in browser on 2026-11-11.
 | Resistor, precision | R102 | 845 kOhm 0.1 % 25 ppm/K 0805 thin film | CR resistor | Vishay Dale | TNPW0805845KBEEA | Digikey |  | https://www.digikey.com/en/products/result?keywords=TNPW0805845KBEEA | https://www.vishay.com/docs/28758/tnpw_e3.pdf | 1.00 | ea |  |  | not verified |  | FALSE | FALSE | FALSE |  |  |  |  |  |  |  |  |  |  |  |  |  |  | Order qty = design qty 1 (section E lists no spare). Range checked in Vishay TNPW e3 datasheet doc 28758 (rev 10-Apr-2026) Table 'Temperature coefficient and resistance range': 0805 0.1 %/25 ppm: up to 1 MOhm; 845 k in range. No Digi-Key product page URL was found; Link is the Digi-Key keyword search; Vendor SKU blank. Price and stock not read: digikey.com, mouser.com, newark.com, arrow.com and octopart.com served bot-check or 403 pages to the built-in browser on 2026-11-11.
 | Resistor, precision | R103 | 66.5 kOhm 0.1 % 25 ppm/K 0603 thin film | CR resistor | Vishay Dale | TNPW060366K5BEEA | Digikey |  | https://www.digikey.com/en/products/result?keywords=TNPW060366K5BEEA | https://www.vishay.com/docs/28758/tnpw_e3.pdf | 1.00 | ea |  |  | not verified |  | FALSE | FALSE | FALSE |  |  |  |  |  |  |  |  |  |  |  |  |  |  | Order qty = design qty 1 (section E lists no spare). r9 (2026-11-12): 0402 -> 0603 (dec2-assembly item 2a; was TNPW040266K5BEED); place <= 5 mm from U101 pins 7-13. Range checked in Vishay TNPW e3 datasheet doc 28758 (rev 10-Apr-2026): 0603 0.1 %/25 ppm covers 3.5 Ohm to 332 kOhm; 66.5 k in range; packaging code EA as on the other 0603 TNPW rows. No Digi-Key product page URL was found; Link is the Digi-Key keyword search; Vendor SKU blank. Price and stock not read: digikey.com, mouser.com, newark.com, arrow.com and octopart.com served bot-check or 403 pages to the built-in browser on 2026-11-11.
 | Resistor, precision | R104 | 49.9 kOhm 0.1 % 25 ppm/K 0603 thin film | CR resistor | Vishay Dale | TNPW060349K9BEEA | Digikey |  | https://www.digikey.com/en/products/result?keywords=TNPW060349K9BEEA | https://www.vishay.com/docs/28758/tnpw_e3.pdf | 1.00 | ea |  |  | not verified |  | FALSE | FALSE | FALSE |  |  |  |  |  |  |  |  |  |  |  |  |  |  | Order qty = design qty 1 (section E lists no spare). r9 (2026-11-12): 0402 -> 0603 and moved to the top side (dec2-assembly items 1 and 2a; was TNPW040249K9BEED on the bottom; D-32 retires). Range checked in Vishay TNPW e3 datasheet doc 28758 (rev 10-Apr-2026): 0603 0.1 %/25 ppm covers 3.5 Ohm to 332 kOhm; 49.9 k in range; packaging code EA as on the other 0603 TNPW rows. No Digi-Key product page URL was found; Link is the Digi-Key keyword search; Vendor SKU blank. Price and stock not read: digikey.com, mouser.com, newark.com, arrow.com and octopart.com served bot-check or 403 pages to the built-in browser on 2026-11-11.
 | Resistor, precision (MB rework) | R170,R171 (MB joints) | 10.0 kOhm 0.1 % 25 ppm/K 0805 thin film | MB rework | Vishay Dale | TNPW080510K0BEEA | Digikey |  | https://www.digikey.com/en/products/result?keywords=TNPW080510K0BEEA | https://www.vishay.com/docs/28758/tnpw_e3.pdf | 4.00 | ea |  |  | not verified |  | FALSE | FALSE | FALSE |  |  |  |  |  |  |  |  |  |  |  |  |  |  | Order qty = design qty 2 + spare 2. Range checked in Vishay TNPW e3 datasheet doc 28758 (rev 10-Apr-2026) Table 'Temperature coefficient and resistance range': 0805 0.1 %/25 ppm: 3.5 Ohm to 1 MOhm; 10.0 k in range. No Digi-Key product page URL was found; Link is the Digi-Key keyword search; Vendor SKU blank. Price and stock not read: digikey.com, mouser.com, newark.com, arrow.com and octopart.com served bot-check or 403 pages to the built-in browser on 2026-11-11.
 | Resistor | R113 | 6.49 MOhm 1 % 100 ppm/K 0603 thick film | CR resistor | Vishay Dale | CRCW06036M49FKEA | Digikey |  | https://www.digikey.com/en/products/result?keywords=CRCW06036M49FKEA | https://www.vishay.com/docs/20035/dcrcwe3.pdf | 1.00 | ea |  |  | not verified |  | FALSE | FALSE | FALSE |  |  |  |  |  |  |  |  |  |  |  |  |  |  | Order qty = design qty 1 (section E lists no spare). Vishay D/CRCW e3 doc 20035 (rev 14-Apr-2026): 1 %/100 ppm range 10 Ohm to 10 MOhm. 6.49 M within the 10 MOhm range top. No Digi-Key product page URL was found; Link is the Digi-Key keyword search; Vendor SKU blank. Price and stock not read: digikey.com, mouser.com, newark.com, arrow.com and octopart.com served bot-check or 403 pages to the built-in browser on 2026-11-11.
 | Resistor | R184 | 20.0 kOhm 1 % 100 ppm/K 0603 thick film | CR resistor | Vishay Dale | CRCW060320K0FKEA | Digikey |  | https://www.digikey.com/en/products/result?keywords=CRCW060320K0FKEA | https://www.vishay.com/docs/20035/dcrcwe3.pdf | 1.00 | ea |  |  | not verified |  | FALSE | FALSE | FALSE |  |  |  |  |  |  |  |  |  |  |  |  |  |  | Order qty = design qty 1 (section E lists no spare). r9 (2026-11-12): R117 removed with U115 (tap review). Vishay D/CRCW e3 doc 20035 (rev 14-Apr-2026): 1 %/100 ppm range 10 Ohm to 10 MOhm. No Digi-Key product page URL was found; Link is the Digi-Key keyword search; Vendor SKU blank. Price and stock not read: digikey.com, mouser.com, newark.com, arrow.com and octopart.com served bot-check or 403 pages to the built-in browser on 2026-11-11.
 | Resistor | R107,R129,R185,R186,R274 | 10.0 kOhm 1 % 100 ppm/K 0603 thick film | CR/EIB resistor | Vishay Dale | CRCW060310K0FKEA | Digikey |  | https://www.digikey.com/en/products/result?keywords=CRCW060310K0FKEA | https://www.vishay.com/docs/20035/dcrcwe3.pdf | 5.00 | ea |  |  | not verified |  | FALSE | FALSE | FALSE |  |  |  |  |  |  |  |  |  |  |  |  |  |  | Order qty = design qty 5 (section E lists no spare). r9 (2026-11-12): R118 and R120 removed with U115 and R140 with U104 (tap review); EIB R258, R260 and R261 are DNP (dec2-eib) and not ordered; R274 stays fitted. Vishay D/CRCW e3 doc 20035 (rev 14-Apr-2026): 1 %/100 ppm range 10 Ohm to 10 MOhm. No Digi-Key product page URL was found; Link is the Digi-Key keyword search; Vendor SKU blank. Price and stock not read: digikey.com, mouser.com, newark.com, arrow.com and octopart.com served bot-check or 403 pages to the built-in browser on 2026-11-11.
 | Resistor | R187 | 3.30 MOhm 1 % 100 ppm/K 0603 thick film | CR resistor | Vishay Dale | CRCW06033M30FKEA | Digikey |  | https://www.digikey.com/en/products/result?keywords=CRCW06033M30FKEA | https://www.vishay.com/docs/20035/dcrcwe3.pdf | 1.00 | ea |  |  | not verified |  | FALSE | FALSE | FALSE |  |  |  |  |  |  |  |  |  |  |  |  |  |  | Order qty = design qty 1 (section E lists no spare). Vishay D/CRCW e3 doc 20035 (rev 14-Apr-2026): 1 %/100 ppm range 10 Ohm to 10 MOhm. Range check: 3.30 MOhm is inside the 10 Ohm to 10 MOhm 1 % range (closes the 'range checked in T-A-05' note). No Digi-Key product page URL was found; Link is the Digi-Key keyword search; Vendor SKU blank. Price and stock not read: digikey.com, mouser.com, newark.com, arrow.com and octopart.com served bot-check or 403 pages to the built-in browser on 2026-11-11.
 | Resistor | R188 | 453 kOhm 1 % 100 ppm/K 0603 thick film | CR resistor | Vishay Dale | CRCW0603453KFKEA | Digikey |  | https://www.digikey.com/en/products/result?keywords=CRCW0603453KFKEA | https://www.vishay.com/docs/20035/dcrcwe3.pdf | 1.00 | ea |  |  | not verified |  | FALSE | FALSE | FALSE |  |  |  |  |  |  |  |  |  |  |  |  |  |  | Order qty = design qty 1 (section E lists no spare). r9 (2026-11-12): R190 removed with U121 (tap review). Vishay D/CRCW e3 doc 20035 (rev 14-Apr-2026): 1 %/100 ppm range 10 Ohm to 10 MOhm. No Digi-Key product page URL was found; Link is the Digi-Key keyword search; Vendor SKU blank. Price and stock not read: digikey.com, mouser.com, newark.com, arrow.com and octopart.com served bot-check or 403 pages to the built-in browser on 2026-11-11.
 | Resistor | R130,R131A | 100 Ohm 1 % 100 ppm/K 0603 thick film | CR resistor | Vishay Dale | CRCW0603100RFKEA | Digikey |  | https://www.digikey.com/en/products/result?keywords=CRCW0603100RFKEA | https://www.vishay.com/docs/20035/dcrcwe3.pdf | 2.00 | ea |  |  | not verified |  | FALSE | FALSE | FALSE |  |  |  |  |  |  |  |  |  |  |  |  |  |  | Order qty = design qty 2 (section E lists no spare). r9-12 (2026-11-12, check-in 2 ruling R2): R131B and R132 moved to the CRCW06034K99FKEA row; R130 and R131A stay 100 Ohm. r9 (2026-11-12): R143 removed with U104 (tap review). R130 now carries the U106A buffer output (CE_DRV, dec2-gate item 3). Vishay D/CRCW e3 doc 20035 (rev 14-Apr-2026): 1 %/100 ppm range 10 Ohm to 10 MOhm. No Digi-Key product page URL was found; Link is the Digi-Key keyword search; Vendor SKU blank. Price and stock not read: digikey.com, mouser.com, newark.com, arrow.com and octopart.com served bot-check or 403 pages to the built-in browser on 2026-11-11.
 | Resistor | R131B,R132 | 4.99 kOhm 1 % 100 ppm/K 0603 thick film | CR resistor | Vishay Dale | CRCW06034K99FKEA | Digikey |  | https://www.digikey.com/en/products/result?keywords=CRCW06034K99FKEA | https://www.vishay.com/docs/20035/dcrcwe3.pdf | 2.00 | ea |  |  | not verified |  | FALSE | FALSE | FALSE |  |  |  |  |  |  |  |  |  |  |  |  |  |  | Order qty = design qty 2 (section E lists no spare). r9-12 (2026-11-12, check-in 2 ruling R2, J.2 item 70(a) option (a)): R131B and R132 raised from 100 Ohm to 4.99 kOhm (design H.24(d); round4/calc/r9_calc.py R9.H24(d)); same 0603 footprint. Vishay D/CRCW e3 doc 20035: 1 %/100 ppm range 10 Ohm to 10 MOhm. The MPN follows the CRCW0603 code pattern of the other rows, TODO(verify: Vishay doc 20035 ordering code). No Digi-Key product page URL was found; Link is the Digi-Key keyword search; Vendor SKU blank. Price and stock not read.
 | Resistor | R108,R123,R252,R254,R267,R268,R269,R270,R271,EVM R272,EVM R272b | 47.0 kOhm 1 % 100 ppm/K 0603 thick film | CR/EIB resistor + EVM rework | Vishay Dale | CRCW060347K0FKEA | Digikey |  | https://www.digikey.com/en/products/result?keywords=CRCW060347K0FKEA | https://www.vishay.com/docs/20035/dcrcwe3.pdf | 11.00 | ea |  |  | not verified |  | FALSE | FALSE | FALSE |  |  |  |  |  |  |  |  |  |  |  |  |  |  | Order qty = design qty 11 (section E lists no spare). r9 (2026-11-12): R124 (FCCEIL) removed (tap review). Vishay D/CRCW e3 doc 20035 (rev 14-Apr-2026): 1 %/100 ppm range 10 Ohm to 10 MOhm. 9 on CR/EIB plus EVM R272 and R272b (EM2). No Digi-Key product page URL was found; Link is the Digi-Key keyword search; Vendor SKU blank. Price and stock not read: digikey.com, mouser.com, newark.com, arrow.com and octopart.com served bot-check or 403 pages to the built-in browser on 2026-11-11.
 | Resistor | R106s,R122,R126,R147,R250,R251,R253,R266,R275 | 1.00 kOhm 1 % 100 ppm/K 0603 thick film | CR/EIB resistor | Vishay Dale | CRCW06031K00FKEA | Digikey |  | https://www.digikey.com/en/products/result?keywords=CRCW06031K00FKEA | https://www.vishay.com/docs/20035/dcrcwe3.pdf | 10.00 | ea |  |  | not verified |  | FALSE | FALSE | FALSE |  |  |  |  |  |  |  |  |  |  |  |  |  |  | Order qty = design qty 9 + spare 1. r9 (2026-11-12): R121, R125, R127, R128, R135 and R148 removed (tap review); the R142 select-on-test kit is removed with U104, so its two 1.00 kOhm values go; R106s moves here from the 0402 row (dec2-assembly item 2a; was CRCW04021K00FKED, design qty 1 + spare 1, the spare kept). Vishay D/CRCW e3 doc 20035 (rev 14-Apr-2026): 1 %/100 ppm range 10 Ohm to 10 MOhm. Power: the R106s design dissipation <= 11.5 mW (H.23(n)) was 18 % of the CRCW0402 P70 0.063 W; the CRCW0603 P70 figure TODO(verify: doc 20035). No Digi-Key product page URL was found; Link is the Digi-Key keyword search; Vendor SKU blank. Price and stock not read: digikey.com, mouser.com, newark.com, arrow.com and octopart.com served bot-check or 403 pages to the built-in browser on 2026-11-11.
 | Resistor | R176,R177 | 200 Ohm 1 % 100 ppm/K 0603 thick film | CR resistor | Vishay Dale | CRCW0603200RFKEA | Digikey |  | https://www.digikey.com/en/products/result?keywords=CRCW0603200RFKEA | https://www.vishay.com/docs/20035/dcrcwe3.pdf | 3.00 | ea |  |  | not verified |  | FALSE | FALSE | FALSE |  |  |  |  |  |  |  |  |  |  |  |  |  |  | Order qty = design qty 2 + spare 1. Vishay D/CRCW e3 doc 20035 (rev 14-Apr-2026): 1 %/100 ppm range 10 Ohm to 10 MOhm. No Digi-Key product page URL was found; Link is the Digi-Key keyword search; Vendor SKU blank. Price and stock not read: digikey.com, mouser.com, newark.com, arrow.com and octopart.com served bot-check or 403 pages to the built-in browser on 2026-11-11.
 | Resistor | R189 | 1.00 MOhm 1 % 100 ppm/K 0603 thick film | CR resistor | Vishay Dale | CRCW06031M00FKEA | Digikey |  | https://www.digikey.com/en/products/result?keywords=CRCW06031M00FKEA | https://www.vishay.com/docs/20035/dcrcwe3.pdf | 1.00 | ea |  |  | not verified |  | FALSE | FALSE | FALSE |  |  |  |  |  |  |  |  |  |  |  |  |  |  | Order qty = design qty 1 (section E lists no spare). r9 (2026-11-12): R144 removed with U104 and R191 with U121 (tap review); EIB R262 and R263 are DNP (dec2-eib) and not ordered. R179 removed with the T22 input stage (D-38, 2026-11-12). Vishay D/CRCW e3 doc 20035 (rev 14-Apr-2026): 1 %/100 ppm range 10 Ohm to 10 MOhm. No Digi-Key product page URL was found; Link is the Digi-Key keyword search; Vendor SKU blank. Price and stock not read: digikey.com, mouser.com, newark.com, arrow.com and octopart.com served bot-check or 403 pages to the built-in browser on 2026-11-11.
 | Resistor | R116 | 10.0 MOhm 1 % 100 ppm/K 0603 thick film | CR resistor | Vishay Dale | CRCW060310M0FKEA | Digikey |  | https://www.digikey.com/en/products/result?keywords=CRCW060310M0FKEA | https://www.vishay.com/docs/20035/dcrcwe3.pdf | 1.00 | ea |  |  | not verified |  | FALSE | FALSE | FALSE |  |  |  |  |  |  |  |  |  |  |  |  |  |  | Order qty = design qty 1 (section E lists no spare). r9 (2026-11-12): R119 removed with U115 (tap review); EIB R259 is DNP (dec2-eib) and not ordered. Vishay D/CRCW e3 doc 20035 (rev 14-Apr-2026): 1 %/100 ppm range 10 Ohm to 10 MOhm. Range check: 10.0 MOhm is the top of the 1 %/100 ppm range (inside). No Digi-Key product page URL was found; Link is the Digi-Key keyword search; Vendor SKU blank. Price and stock not read: digikey.com, mouser.com, newark.com, arrow.com and octopart.com served bot-check or 403 pages to the built-in browser on 2026-11-11.
 | Resistor | R273,R276 | 10.0 Ohm 1 % 100 ppm/K 0603 thick film | EIB resistor | Vishay Dale | CRCW060310R0FKEA | Digikey |  | https://www.digikey.com/en/products/result?keywords=CRCW060310R0FKEA | https://www.vishay.com/docs/20035/dcrcwe3.pdf | 3.00 | ea |  |  | not verified |  | FALSE | FALSE | FALSE |  |  |  |  |  |  |  |  |  |  |  |  |  |  | Order qty = design qty 2 + spare 1. Vishay D/CRCW e3 doc 20035 (rev 14-Apr-2026): 1 %/100 ppm range 10 Ohm to 10 MOhm. Spare is the R276 spare of section E. 10 Ohm is the bottom of the 1 %/100 ppm range (inside). No Digi-Key product page URL was found; Link is the Digi-Key keyword search; Vendor SKU blank. Price and stock not read: digikey.com, mouser.com, newark.com, arrow.com and octopart.com served bot-check or 403 pages to the built-in browser on 2026-11-11.
 | Resistor | R255 | 48.7 kOhm 1 % 100 ppm/K 0603 thick film | EIB resistor | Vishay Dale | CRCW060348K7FKEA | Digikey |  | https://www.digikey.com/en/products/result?keywords=CRCW060348K7FKEA | https://www.vishay.com/docs/20035/dcrcwe3.pdf | 1.00 | ea |  |  | not verified |  | FALSE | FALSE | FALSE |  |  |  |  |  |  |  |  |  |  |  |  |  |  | Order qty = design qty 1 (section E lists no spare). Vishay D/CRCW e3 doc 20035 (rev 14-Apr-2026): 1 %/100 ppm range 10 Ohm to 10 MOhm. No Digi-Key product page URL was found; Link is the Digi-Key keyword search; Vendor SKU blank. Price and stock not read: digikey.com, mouser.com, newark.com, arrow.com and octopart.com served bot-check or 403 pages to the built-in browser on 2026-11-11.
 | Resistor | R257 | 59.0 kOhm 1 % 100 ppm/K 0603 thick film | EIB resistor | Vishay Dale | CRCW060359K0FKEA | Digikey |  | https://www.digikey.com/en/products/result?keywords=CRCW060359K0FKEA | https://www.vishay.com/docs/20035/dcrcwe3.pdf | 1.00 | ea |  |  | not verified |  | FALSE | FALSE | FALSE |  |  |  |  |  |  |  |  |  |  |  |  |  |  | Order qty = design qty 1 (section E lists no spare). Vishay D/CRCW e3 doc 20035 (rev 14-Apr-2026): 1 %/100 ppm range 10 Ohm to 10 MOhm. No Digi-Key product page URL was found; Link is the Digi-Key keyword search; Vendor SKU blank. Price and stock not read: digikey.com, mouser.com, newark.com, arrow.com and octopart.com served bot-check or 403 pages to the built-in browser on 2026-11-11.
 | Resistor | EVM R21 | 0 Ohm jumper 0603 | EVM rework | Vishay Dale | CRCW06030000Z0EA | Digikey |  | https://www.digikey.com/en/products/result?keywords=CRCW06030000Z0EA | https://www.vishay.com/docs/20035/dcrcwe3.pdf | 2.00 | ea |  |  | not verified |  | FALSE | FALSE | FALSE |  |  |  |  |  |  |  |  |  |  |  |  |  |  | Order qty = design qty 1 + spare 1. r9 (2026-11-12): R137 (FCI_OK) removed (dec2-gate 5-LVC mapping); the row now carries EVM R21 (EM3) only. Section E lists one spare (+1) for the whole EVM R23/R256/R272/R272b/R21 group without naming a value; this BOM allocates it to the 0 Ohm link (allocation is a BOM choice, TODO(verify) by the operator). Jumper rating 2.0 A (doc 20035). No Digi-Key product page URL was found; Link is the Digi-Key keyword search; Vendor SKU blank. Price and stock not read: digikey.com, mouser.com, newark.com, arrow.com and octopart.com served bot-check or 403 pages to the built-in browser on 2026-11-11.
 | Resistor | EVM R23 | 49.9 kOhm 1 % 100 ppm/K 0603 thick film | EVM rework | Vishay Dale | CRCW060349K9FKEA | Digikey |  | https://www.digikey.com/en/products/result?keywords=CRCW060349K9FKEA | https://www.vishay.com/docs/20035/dcrcwe3.pdf | 1.00 | ea |  |  | not verified |  | FALSE | FALSE | FALSE |  |  |  |  |  |  |  |  |  |  |  |  |  |  | Order qty = design qty 1 (section E lists no spare). Vishay D/CRCW e3 doc 20035 (rev 14-Apr-2026): 1 %/100 ppm range 10 Ohm to 10 MOhm. EM4 replacement for EVM R23. No Digi-Key product page URL was found; Link is the Digi-Key keyword search; Vendor SKU blank. Price and stock not read: digikey.com, mouser.com, newark.com, arrow.com and octopart.com served bot-check or 403 pages to the built-in browser on 2026-11-11.
 | Resistor | EVM R256 | 200 kOhm 1 % 100 ppm/K 0603 thick film | EVM rework | Vishay Dale | CRCW0603200KFKEA | Digikey |  | https://www.digikey.com/en/products/result?keywords=CRCW0603200KFKEA | https://www.vishay.com/docs/20035/dcrcwe3.pdf | 1.00 | ea |  |  | not verified |  | FALSE | FALSE | FALSE |  |  |  |  |  |  |  |  |  |  |  |  |  |  | Order qty = design qty 1 (section E lists no spare). Vishay D/CRCW e3 doc 20035 (rev 14-Apr-2026): 1 %/100 ppm range 10 Ohm to 10 MOhm. EM5, tacked across JP21. No Digi-Key product page URL was found; Link is the Digi-Key keyword search; Vendor SKU blank. Price and stock not read: digikey.com, mouser.com, newark.com, arrow.com and octopart.com served bot-check or 403 pages to the built-in browser on 2026-11-11.
 | Resistor | MB RSDA,MB RSCL | 2.70 kOhm 1 % 100 ppm/K 0603 thick film | MB rework | Vishay Dale | CRCW06032K70FKEA | Digikey |  | https://www.digikey.com/en/products/result?keywords=CRCW06032K70FKEA | https://www.vishay.com/docs/20035/dcrcwe3.pdf | 4.00 | ea |  |  | not verified |  | FALSE | FALSE | FALSE |  |  |  |  |  |  |  |  |  |  |  |  |  |  | Order qty = design qty 2 + spare 2. Vishay D/CRCW e3 doc 20035 (rev 14-Apr-2026): 1 %/100 ppm range 10 Ohm to 10 MOhm. PM9 I2C pull-up change on the MB. No Digi-Key product page URL was found; Link is the Digi-Key keyword search; Vendor SKU blank. Price and stock not read: digikey.com, mouser.com, newark.com, arrow.com and octopart.com served bot-check or 403 pages to the built-in browser on 2026-11-11.
 | Resistor | R101 | 8.06 kOhm 1 % 100 ppm/K 0603 thick film | CR resistor | Vishay Dale | CRCW06038K06FKEA | Digikey |  | https://www.digikey.com/en/products/result?keywords=CRCW06038K06FKEA | https://www.vishay.com/docs/20035/dcrcwe3.pdf | 1.00 | ea |  |  | not verified |  | FALSE | FALSE | FALSE |  |  |  |  |  |  |  |  |  |  |  |  |  |  | Order qty = design qty 1 (section E lists no spare). r9 (2026-11-12): 0402 -> 0603 (dec2-assembly item 2a; was CRCW04028K06FKED). Vishay D/CRCW e3 doc 20035 (rev 14-Apr-2026): 1 %/100 ppm range 10 Ohm to 10 MOhm. No Digi-Key product page URL was found; Link is the Digi-Key keyword search; Vendor SKU blank. Price and stock not read: digikey.com, mouser.com, newark.com, arrow.com and octopart.com served bot-check or 403 pages to the built-in browser on 2026-11-11.
 | Resistor | R105 | 27.4 kOhm 1 % 100 ppm/K 0603 thick film | CR resistor | Vishay Dale | CRCW060327K4FKEA | Digikey |  | https://www.digikey.com/en/products/result?keywords=CRCW060327K4FKEA | https://www.vishay.com/docs/20035/dcrcwe3.pdf | 1.00 | ea |  |  | not verified |  | FALSE | FALSE | FALSE |  |  |  |  |  |  |  |  |  |  |  |  |  |  | Order qty = design qty 1 (section E lists no spare). r9 (2026-11-12): 0402 -> 0603 (dec2-assembly item 2a; was CRCW040227K4FKED). Vishay D/CRCW e3 doc 20035 (rev 14-Apr-2026): 1 %/100 ppm range 10 Ohm to 10 MOhm. No Digi-Key product page URL was found; Link is the Digi-Key keyword search; Vendor SKU blank. Price and stock not read: digikey.com, mouser.com, newark.com, arrow.com and octopart.com served bot-check or 403 pages to the built-in browser on 2026-11-11.
 | Resistor | R175 | 68.0 Ohm 1 % 100 ppm/K 1206 thick film, 0.25 W | CR resistor | Vishay Dale | CRCW120668R0FKEA | Digikey |  | https://www.digikey.com/en/products/result?keywords=CRCW120668R0FKEA | https://www.vishay.com/docs/20035/dcrcwe3.pdf | 2.00 | ea |  |  | not verified |  | FALSE | FALSE | FALSE |  |  |  |  |  |  |  |  |  |  |  |  |  |  | Order qty = design qty 1 + spare 1. Doc 20035: CRCW1206 P70 0.25 W. No Digi-Key product page URL was found; Link is the Digi-Key keyword search; Vendor SKU blank. Price and stock not read: digikey.com, mouser.com, newark.com, arrow.com and octopart.com served bot-check or 403 pages to the built-in browser on 2026-11-11.
 | Capacitor, MLCC | C110,C111,C114-C116,C119,C126,C130-C132,C201,C202,C205 | 100 nF 50 V X7R 0603 | CR/EIB capacitor | Murata Electronics | GRM188R71H104KA93D | Digikey |  | https://www.digikey.com/en/products/result?keywords=GRM188R71H104KA93D | https://www.murata.com/en-us/products/productdetail?partno=GRM188R71H104KA93D | 18.00 | ea |  |  | not verified |  | FALSE | FALSE | FALSE |  |  | 50 |  |  |  |  |  |  |  |  |  |  |  | Order qty = design qty 13 + spare 5. r9 (2026-11-12): C109, C112, C113, C120, C121 and C133 removed with the tap-review comparators and timers, and C117, C118, C122 and C123 with U108, U109, U114 and U116 (dec2-gate 5-LVC mapping); EIB C203 and C204 are DNP (dec2-eib) and not ordered. C134 and C135 removed with U122 and U123 (D-38, 2026-11-12). Voltage from the Murata part code (TODO(verify) on the spec sheet; murata.com returned 403). No Digi-Key product page URL was found; Link is the Digi-Key keyword search; Vendor SKU blank. Price and stock not read: digikey.com, mouser.com, newark.com, arrow.com and octopart.com served bot-check or 403 pages to the built-in browser on 2026-11-11.
 | Capacitor, MLCC | C102c | 100 nF 100 V X7R 0603 | CR capacitor | Murata Electronics | GRM188R72A104KA35D | Digikey |  | https://www.digikey.com/en/products/result?keywords=GRM188R72A104KA35D | https://www.murata.com/en-us/products/productdetail?partno=GRM188R72A104KA35D | 1.00 | ea |  |  | not verified |  | FALSE | FALSE | FALSE |  |  | 100 |  |  |  |  |  |  |  |  |  |  |  | Order qty = design qty 1 (section E lists no spare). Candidate per section E (checked in T-A-05). Voltage from the Murata part code (TODO(verify) on the spec sheet; murata.com returned 403). No Digi-Key product page URL was found; Link is the Digi-Key keyword search; Vendor SKU blank. Price and stock not read: digikey.com, mouser.com, newark.com, arrow.com and octopart.com served bot-check or 403 pages to the built-in browser on 2026-11-11.
 | Capacitor, MLCC | C103 | 1.0 uF 50 V X7R 0805 | CR capacitor | Murata Electronics | GRM21BR71H105KA12L | Digikey |  | https://www.digikey.com/en/products/result?keywords=GRM21BR71H105KA12L | https://www.murata.com/en-us/products/productdetail?partno=GRM21BR71H105KA12L | 1.00 | ea |  |  | not verified |  | FALSE | FALSE | FALSE |  |  | 50 |  |  |  |  |  |  |  |  |  |  |  | Order qty = design qty 1 (section E lists no spare). Voltage from the Murata part code (TODO(verify) on the spec sheet; murata.com returned 403). No Digi-Key product page URL was found; Link is the Digi-Key keyword search; Vendor SKU blank. Price and stock not read: digikey.com, mouser.com, newark.com, arrow.com and octopart.com served bot-check or 403 pages to the built-in browser on 2026-11-11.
 | Capacitor, MLCC | C125 | 10 uF 10 V X7R 0805 | CR capacitor | Murata Electronics | GRM21BR71A106KE51L | Digikey |  | https://www.digikey.com/en/products/result?keywords=GRM21BR71A106KE51L | https://www.murata.com/en-us/products/productdetail?partno=GRM21BR71A106KE51L | 1.00 | ea |  |  | not verified |  | FALSE | FALSE | FALSE |  |  | 10 |  |  |  |  |  |  |  |  |  |  |  | Order qty = design qty 1 (section E lists no spare). Voltage from the Murata part code (TODO(verify) on the spec sheet; murata.com returned 403). No Digi-Key product page URL was found; Link is the Digi-Key keyword search; Vendor SKU blank. Price and stock not read: digikey.com, mouser.com, newark.com, arrow.com and octopart.com served bot-check or 403 pages to the built-in browser on 2026-11-11.
 | Capacitor, MLCC | C101 | 22 nF 50 V X7R 0603 | CR capacitor | Murata Electronics | GRM188R71H223KA01D | Digikey |  | https://www.digikey.com/en/products/result?keywords=GRM188R71H223KA01D | https://www.murata.com/en-us/products/productdetail?partno=GRM188R71H223KA01D | 1.00 | ea |  |  | not verified |  | FALSE | FALSE | FALSE |  |  | 50 |  |  |  |  |  |  |  |  |  |  |  | Order qty = design qty 1 (section E lists no spare). r9 (2026-11-12): 0402 -> 0603 (dec2-assembly item 2a; was GRM155R71H223KA12D). TODO(verify: Murata) GRM188R71H223KA01D (22 nF 50 V X7R 0603): part number from the decision record, not read on a Murata or distributor page. No Digi-Key product page URL was found; Link is the Digi-Key keyword search; Vendor SKU blank. Price and stock not read: digikey.com, mouser.com, newark.com, arrow.com and octopart.com served bot-check or 403 pages to the built-in browser on 2026-11-11. Datasheet URL follows the Murata product-page pattern for the 0603 part, not opened, TODO(verify: Murata).
 | Capacitor, MLCC | C106,C107 | 470 pF 50 V C0G 0603 | CR capacitor | Murata Electronics | GRM1885C1H471JA01D | Digikey |  | https://www.digikey.com/en/products/result?keywords=GRM1885C1H471JA01D | https://www.murata.com/en-us/products/productdetail?partno=GRM1885C1H471JA01D | 2.00 | ea |  |  | not verified |  | FALSE | FALSE | FALSE |  |  | 50 |  |  |  |  |  |  |  |  |  |  |  | Order qty = design qty 2 (section E lists no spare). Voltage from the Murata part code (TODO(verify) on the spec sheet; murata.com returned 403). No Digi-Key product page URL was found; Link is the Digi-Key keyword search; Vendor SKU blank. Price and stock not read: digikey.com, mouser.com, newark.com, arrow.com and octopart.com served bot-check or 403 pages to the built-in browser on 2026-11-11.
 | Capacitor, MLCC | C108,C129 | 1.0 nF 50 V C0G 0603 | CR capacitor | Murata Electronics | GRM1885C1H102JA01D | Digikey |  | https://www.digikey.com/en/products/result?keywords=GRM1885C1H102JA01D | https://www.murata.com/en-us/products/productdetail?partno=GRM1885C1H102JA01D | 2.00 | ea |  |  | not verified |  | FALSE | FALSE | FALSE |  |  | 50 |  |  |  |  |  |  |  |  |  |  |  | Order qty = design qty 2 (section E lists no spare). Voltage from the Murata part code (TODO(verify) on the spec sheet; murata.com returned 403). No Digi-Key product page URL was found; Link is the Digi-Key keyword search; Vendor SKU blank. Price and stock not read: digikey.com, mouser.com, newark.com, arrow.com and octopart.com served bot-check or 403 pages to the built-in browser on 2026-11-11.
 | Capacitor, MLCC | C252 (on EVM) | 2.2 nF 50 V C0G 0603 | EVM rework | Murata Electronics | GRM1885C1H222JA01D | Digikey |  | https://www.digikey.com/en/products/result?keywords=GRM1885C1H222JA01D | https://www.murata.com/en-us/products/productdetail?partno=GRM1885C1H222JA01D | 1.00 | ea |  |  | not verified |  | FALSE | FALSE | FALSE |  |  | 50 |  |  |  |  |  |  |  |  |  |  |  | Order qty = design qty 1 (section E lists no spare). EM5, tacked across JP21. C152 (same MPN) is DNP and not ordered. Voltage from the Murata part code (TODO(verify) on the spec sheet; murata.com returned 403). No Digi-Key product page URL was found; Link is the Digi-Key keyword search; Vendor SKU blank. Price and stock not read: digikey.com, mouser.com, newark.com, arrow.com and octopart.com served bot-check or 403 pages to the built-in browser on 2026-11-11.
 | Capacitor, MLCC | C (MB) x2, C (EVM) x5 | 10 uF 35 V X5R 0805 | MB + EVM rework | Murata Electronics | GRM21BR6YA106KE43L | Digikey |  | https://www.digikey.com/en/products/result?keywords=GRM21BR6YA106KE43L | https://www.murata.com/en-us/products/productdetail?partno=GRM21BR6YA106KE43L | 12.00 | ea |  |  | not verified |  | FALSE | FALSE | FALSE |  |  | 35 |  |  |  |  |  |  |  |  |  |  |  | Order qty = design qty 7 + spare 5. Section E: C (MB) 2 (+2) and C (EVM) 5 (+3). Voltage from the Murata part code (TODO(verify) on the spec sheet; murata.com returned 403). No Digi-Key product page URL was found; Link is the Digi-Key keyword search; Vendor SKU blank. Price and stock not read: digikey.com, mouser.com, newark.com, arrow.com and octopart.com served bot-check or 403 pages to the built-in browser on 2026-11-11.
 | Capacitor, MLCC | C102a | 1.0 uF 100 V X7R 1206 | CR capacitor | Murata Electronics | GRM31CR72A105KA01L | Digikey |  | https://www.digikey.com/en/products/detail/murata-electronics/GRM31CR72A105KA01L/965923 | https://www.murata.com/en-us/products/productdetail?partno=GRM31CR72A105KA01L | 1.00 | ea |  |  | not verified |  | FALSE | FALSE | FALSE |  |  | 100 |  |  |  |  |  |  |  |  |  |  |  | Order qty = design qty 1 (section E lists no spare). Voltage rating 100 V: confirmed by distributor listings in the search index (Future Electronics, Digi-Key title '1 uF +/-10% 100V Ceramic Capacitor X7R 1206'); the Murata spec sheet and DC-bias curve were not read (T-A-04/T-A-05). FLAG: Octopart and LionCircuits mark it NRND and Future Electronics showed 0 global stock (index, undated). Nearest drop-in candidate if unavailable: TDK C3216X7R2A105K160AA (1206, 1 uF, 100 V, X7R) - TODO(verify: TDK datasheet). Product URL from a digikey.jp index entry. Price and stock not read: digikey.com, mouser.com, newark.com, arrow.com and octopart.com served bot-check or 403 pages to the built-in browser on 2026-11-11.
 | Capacitor, MLCC | C102b | 4.7 uF 100 V X7S 1210; effective >= 3 uF at 23.6 V required | CR capacitor | TDK Corporation | C3225X7S2A475K200AB | Digikey |  | https://www.digikey.com/en/products/result?keywords=C3225X7S2A475K200AB | https://product.tdk.com/en/search/capacitor/ceramic/mlcc/info?part_no=C3225X7S2A475K200AB | 1.00 | ea |  |  | not verified |  | FALSE | FALSE | FALSE |  |  | 100 |  |  |  |  |  |  |  |  |  |  |  | Order qty = design qty 1 (section E lists no spare). Full MPN of the section E 'C3225X7S2A475K class'. Voltage rating 100 V: confirmed by distributor listings in the search index (Future Electronics, Avnet, RS); TDK datasheet and DC-bias curve not read (T-A-04/T-A-05). FLAG: Buerklin marks it 'not suitable for new designs', 0 stock, 52-week lead time; LCSC 0 stock (index, undated). Nearest drop-in candidate if unavailable: Murata GRM32ER72A475KA35L (1210, 4.7 uF, 100 V, X7R) - TODO(verify: Murata spec sheet, DC bias at 23.6 V); design alternative 2 x 2.2 uF 100 V 1210. No Digi-Key product page URL was found; Link is the Digi-Key keyword search; Vendor SKU blank. Price and stock not read: digikey.com, mouser.com, newark.com, arrow.com and octopart.com served bot-check or 403 pages to the built-in browser on 2026-11-11.
 | Header, 2x7 1.27 mm SMT vertical, unshrouded, keyed by omitted pin 6 | J101 | FTSH 2x7, 1.27 mm pitch, -01 post 3.05 mm (mates FFSD), 10 uin Au post, -DV double vertical, position 6 omitted (polarized-position option) | CR connector | Samtec | FTSH-107-01-L-DV | Digikey | SAM1161-07-ND | https://www.digikey.com/en/products/detail/samtec-inc/FTSH-107-01-L-DV/1110220 | https://suddendocs.samtec.com/catalog_english/ftsh_smt.pdf | 2.00 | ea |  |  | not verified |  | FALSE | FALSE | FALSE |  |  |  |  |  |  |  |  |  |  |  |  |  |  | Order qty = design qty 1 + spare 1. candidate - T-A-05 datasheet check required. Pin 6 removal: the FTSH catalogue sheet (F-226) OPTION field '-"XXX" = Polarized Position (specify position of omitted pin)' is the factory way to omit position 6; the stock part listed here has all 14 pins, so ORDER the polarized variant from Samtec (exact suffix string, e.g. a '-06' position code, TODO(verify: Samtec quote); the sheet notes some options are non-standard and non-returnable). Fit: body length 7 x 1.27 = 8.89 mm (FTSH formula) fits the 9.4 mm (y) courtyard; body width across the rows is not dimensioned on the catalogue sheet - the design estimate is ~3.4 mm against the 3.9 mm (x) courtyard, TODO(verify: Samtec FTSH-1xx-01-x-DV footprint drawing); the SMT tails span 5.84 mm overall and the pads stay inside the 7.5 mm J101 region (x 37.0-44.5). The -K keying shroud is not chosen here because its envelope is not dimensioned on the sheet. Vendor SKU and Link: Digi-Key index (SKU SAM1161-07-ND is for the 14-pin standard part). Price and stock not read: digikey.com, mouser.com, newark.com, arrow.com and octopart.com served bot-check or 403 pages to the built-in browser on 2026-11-11.
 | Header, 2x7 1.27 mm SMT vertical, keying shroud | J201 | FTSH 2x7, 1.27 mm, -01 post, -DV, -K keying shroud for mating with FFSD notch (-N) | EIB connector | Samtec | FTSH-107-01-L-DV-K | Digikey | SAM9449-ND | https://www.digikey.com/en/products/detail/samtec-inc/FTSH-107-01-L-DV-K/6678186 | https://suddendocs.samtec.com/catalog_english/ftsh_smt.pdf | 2.00 | ea |  |  | not verified |  | FALSE | FALSE | FALSE |  |  |  |  |  |  |  |  |  |  |  |  |  |  | Order qty = design qty 1 + spare 1. candidate - T-A-05 datasheet check required. Shrouded and keyed as section E prefers: F-226 '-K = Keying Shroud for mating with FFSD (Style -01 only, 05 thru 25 pins/row only, -DV only)'; 7 pins/row is inside 05-25. The FFSD notch polarization (-N) is the matching key. Space on the EIB is not tight; shroud envelope TODO(verify: Samtec drawing). Link and Vendor SKU from the digikey.com search-engine index, not read on the live page; confirm before ordering. Price and stock not read: digikey.com, mouser.com, newark.com, arrow.com and octopart.com served bot-check or 403 pages to the built-in browser on 2026-11-11.
 | Cable assembly, 14-way 1.27 mm IDC both ends, 12.0 in | W5 | FFSD 2x7 socket strip, double end, 12.00 in (0.305 m), notch polarization, 30 AWG flat cable | Cable | Samtec | FFSD-07-D-12.00-01-N | Digikey |  | https://www.digikey.com/en/products/result?keywords=FFSD-07-D-12.00-01-N | https://suddendocs.samtec.com/catalog_english/ffsd.pdf | 2.00 | ea |  |  | not verified |  | FALSE | FALSE | FALSE |  |  |  |  |  |  |  |  |  |  |  |  |  |  | Order qty = design qty 1 + spare 1. candidate - T-A-05 datasheet check required (polarisation option and conductor-1 orientation at both ends). FFSD sheet F-226: 7 pins/row is NOT in the standard size list (04, 05, 06, 08, 10, 11, 12, 13, 15, 17, 20, 25; 'Other sizes contact Samtec'), and the series is 'non-standard, non-returnable'; however Samtec product pages for FFSD-07-D-15.19-01-N and FFSD-07-D-17.95-01-N and Digi-Key listings FFSD-07-D-06.00-01-N / -10.00-01-N (SAM11153-ND) exist, so 07 is built. Socket body 7 x 1.27 + 4.19 = 13.08 mm long, 3.05 mm wide, 5.08 mm tall (sheet); 2.7 A/pin; -40 to +105 C. No Digi-Key product page for the 12.00 length was found; a Digi-Key related-item entry showed USD 12.73 (not read on a live page; not used). Price and stock not read: digikey.com, mouser.com, newark.com, arrow.com and octopart.com served bot-check or 403 pages to the built-in browser on 2026-11-11.
 | Polarising plug for FFSD socket hole 6 | W5 key | Plug that blocks socket hole 6 to key the W5 socket against the pin-6-omitted J101 | Cable accessory | Samtec | NOT IDENTIFIED | Samtec |  | https://www.samtec.com/products/ffsd | https://suddendocs.samtec.com/catalog_english/ffsd.pdf | 4.00 | ea |  |  | not verified |  | FALSE | FALSE | FALSE |  |  |  |  |  |  |  |  |  |  |  |  |  |  | Order qty = design qty 2 + spare 2. No catalogue polarizing plug was found: the FFSD sheet F-226 lists only the notch polarization (-N, which needs the FTSH -K shroud) and no hole plug. Action: ask Samtec for an FFSD hole-6 polarizing plug or a factory-plugged position (TODO(verify: Samtec), T-A-05); otherwise fit J101 with the -K shroud if T-A-05/T-A-06 shows it fits the x 37.0-44.5 region. Design rule: no glued-pin fallback at 1.27 mm unless T-A-05 confirms it seats. MPN deliberately not invented.
 | Receptacle housing, KK 254, 4 position | W7 mate (J8) | 2.54 mm KK 254 crimp housing, 4 pos, polarizing key; terminals series 2759/6459/41572 (and 4809/8088 for parts made after 4/19/2012) | Cable | Molex | 22-01-3047 | Digikey |  | https://www.digikey.com/en/products/result?keywords=22-01-3047 | https://www.molex.com/en-us/products/part-detail/22013047 | 1.00 | ea |  |  | not verified |  | FALSE | FALSE | FALSE |  |  |  |  |  |  |  |  |  |  |  |  |  |  | Order qty = design qty 1 (section E lists no spare). Molex 0022013047. Housing accepts 22-30 AWG terminals (Molex drawing per index). No Digi-Key product page URL was found; Link is the Digi-Key keyword search; Vendor SKU blank. Price and stock not read: digikey.com, mouser.com, newark.com, arrow.com and octopart.com served bot-check or 403 pages to the built-in browser on 2026-11-11.
 | Crimp terminal, KK 254 | W7 mate (J8 pins 2/3) | Crimp socket, 22-30 AWG, tin | Cable | Molex | 08-50-0114 | Digikey | WM1114-ND | https://www.digikey.com/en/products/detail/molex/08-50-0114/WM1114-ND/26475 | https://www.molex.com/en-us/products/part-detail/08500114 | 2.00 | ea |  |  | not verified |  | FALSE | FALSE | FALSE |  |  |  |  |  |  |  |  |  |  |  |  |  |  | Order qty = design qty 2 (section E lists no spare). FLAG: Digi-Key index shows 08-50-0114 (0008500114) as OBSOLETE. Nearest drop-in: Molex 08-50-0113 (0008500113, same 2759 terminal, 22-30 AWG, reel/cut tape, ACTIVE per index, Digi-Key WM1114CT-ND) - TODO(verify). 28 AWG is inside 22-30 AWG, which answers the section E crimp-range question at catalogue level; the crimp tool and its 28 AWG setting remain a T-A-05 item. Consider ordering 5 or more because hand crimps fail. Link and Vendor SKU from the digikey.com search-engine index, not read on the live page; confirm before ordering. Price and stock not read: digikey.com, mouser.com, newark.com, arrow.com and octopart.com served bot-check or 403 pages to the built-in browser on 2026-11-11.
 | Header, Micro-Fit 3.0 2x5 through-hole (J-TAP) | J102 (J-TAP tap connector on the CR) | Molex Micro-Fit 3.0 43045-1012, vertical header, 3.00 mm pitch, dual row, 10 circuits, PCB polarizing pegs, tin, 8.5 A per contact, through-hole, hand-soldered last; mates with 43025/214755/214756 (Molex part page 430451012). Molex 43045 PCB layout matches the footprint: 1.02 mm holes, 3.00 mm pitch and row spacing, pegs 3.00 mm outboard of the end columns and 0.94 mm beyond the last-circuit row (footprint pegs at (-3, 3.94) and (15, 3.94)), recommended PCB 1.57 mm. (Superseded 2026-11-13: "orientation (vertical or right-angle), PCB pegs or locks and cavity numbering TODO(verify: Molex 43045 drawing)") | CR connector | Molex | 43045-1012 | Digikey |  | https://www.digikey.com/en/products/result?keywords=43045-1012 |  | 1.00 | ea |  |  | not verified |  | FALSE | FALSE | FALSE |  |  |  |  |  |  |  |  |  |  |  |  |  |  | Order qty = design qty 1 (no spare listed). r9 (2026-11-12): new row (round2 dec2-tapconn); refdes J102 as in the gen/netlist.py r9 working copy. Cavity map (cols 1-5; r9-13 re-map; D-46): row A T2 T17 T17r T5 T13; row B T6 T1 T7b T16 T10 (superseded in r9-13: row A T1 T7b T17r T5 T13; row B T6 T2 T17 T16 T10). Polarization required (r9-14): it excludes a 180 deg rotation of the plug, which would exchange T6/T13, T2/T10, T5/T1, T17/T16 and T17r/T7b; only a column reversal within each row (a mirrored capture, not a mating error) puts T6 on T10 (design A.8) (superseded in r9-14: a 180 deg flip puts T6 on T10). Closed 2026-11-13, operator ruling 2026-11-13 (Review 1/2: J102, J1-TSW, W6-W7 (connector and lead-pad geometry), local_923ffa1c-f985-43ad-8510-7faea2e5f5d7, chat 2026-11-13): header P/N 43045-1012 (operator: "That was a typo, I meant 43045-1012"); circuits 1-5 lie in the row away from the pegs and 6-10 in the peg-side row, 6 opposite 1; the footprint is the Molex drawing rotated 180 deg (not mirrored), so the D-46 cavity map above is physically correct; the latch is on the peg edge facing +x with about 3.6 mm to the trimmed edge (operator: "That is enough room"). T5 (A4) is diagonal to T10 (B5): the gate rule (T5/T6/T10 pairwise non-adjacent) is met, the recommended diagonal separation is not - open item for operator confirmation. Link is the Digi-Key keyword search for 43045-1012; Vendor SKU blank; price and stock not read. (Superseded 2026-11-13: "MPN deliberately no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
 | Cable assembly, Micro-Fit 3.0 2x5 (J-TAP lead set) | J102 mate: J-TAP leads T1, T2, T5, T6, T7b, T10, T13, T16, T17, T17r | Molex Micro-Fit 3.0 female-to-pigtail OTS cable assembly, 10 circuits, dual row, 150 mm, tin, active (Molex page); wire gauge, insulation and housing P/N TODO(verify: Molex 2147561101). (Superseded 2026-11-13: "Molex Micro-Fit 3.0 cable assembly; circuits, rows, single or double end, wire gauge, length and housing P/N TODO(verify: Molex 2147581101)") | Cable | Molex | 2147561101 | Digikey |  | https://www.digikey.com/en/products/result?keywords=2147561101 |  | 1.00 | ea |  |  | not verified |  | FALSE | FALSE | FALSE |  |  |  |  |  |  |  |  |  |  |  |  |  |  | Order qty = 1 (round2 dec2-tapconn). Amended 2026-11-13, operator ruling 2026-11-13 (Review 1/2: J102, J1-TSW, W6-W7 (connector and lead-pad geometry), local_923ffa1c-f985-43ad-8510-7faea2e5f5d7, chat 2026-11-13): MPN changed from 2147581101 to 2147561101 (operator: "For the cable, 2147581101 is actually the male version of the cable, and we need female." and "(A). 2147561101 is the correct cable and is in stock at Digikey"); option A keeps the 43045-1012 male header on the CR, option B (a female receptacle on the CR) is rejected. In stock at Digi-Key per the operator; Digi-Key SKU and price not verified. (Superseded 2026-11-13: "Order qty = 1 (round2 dec2-tapconn, operator: in stock)" for 2147581101.) Far ends: the operator's workshop .100 in crimp terminals into J1/J2 (not ordered; they replace TSW-101-07-G-S). T1 and T2 end at the R170/R171 MB joints C-D6/C-D2; wire gauge against those joints TODO(verify: Molex 2147561101) (A.4 assumed 26 AWG; the Molex page does not show the gauge or insulation). T1/T7b and T17/T17r are twisted by hand. Link is the Digi-Key keyword search for 2147561101; Vendor SKU blank. (Superseded 2026-11-13: "The Molex, Digi-Key and Mouser pages did not load in the decision session, so no specification was read. No Digi-Key product page URL was found; Link is the Digi-Key keyword search; Vendor SKU blank.")
 | Header strip 1x10 | J1: CR CHG column x 45.998 (pins 1-10), body on the CR underside | TSW 1x10, 2.54 mm, 0.64 mm square post, -07 (post 5.84 mm into the SSQ socket, tail 2.54 mm through the CR), -L plating (10 uin Au mating, matte Sn tail), through-hole | CR connector | Samtec | TSW-110-07-L-S | Digikey |  | https://www.digikey.com/en/products/result?keywords=TSW-110-07-L-S | https://suddendocs.samtec.com/catalog_english/tsw_th.pdf | 1.00 | ea |  |  | not verified |  | FALSE | FALSE | FALSE |  |  |  |  |  |  |  |  |  |  |  |  |  |  | Order qty = design qty 1 (section E lists no spare). r9 (2026-11-12): plating -G -> -L (cr_decision_mating_connector_2026-11-12.md item 4: Samtec 2-piece stack, SSQ sockets on the MB, TSW on the CR, 11.05 mm seated; -G is not on the current TSW sheet); was TSW-110-07-G-S with Digi-Key SKU 612-TSW-110-07-G-S-ND. Soldered from the CR top while plugged into the SSQ sockets. A 1x22 cut 10 + 12 is acceptable per section E. No Digi-Key product page URL was found; Link is the Digi-Key keyword search; Vendor SKU blank. Price and stock not read: digikey.com, mouser.com, newark.com, arrow.com and octopart.com served bot-check or 403 pages to the built-in browser on 2026-11-11.
 | Header strip 1x12 | J1: CR CHG column x 20.998 (pins 11-22), body on the CR underside | TSW 1x12, 2.54 mm, 0.64 mm square post, -07 (post 5.84 mm into the SSQ socket, tail 2.54 mm through the CR), -L plating (10 uin Au mating, matte Sn tail), through-hole | CR connector | Samtec | TSW-112-07-L-S | Digikey |  | https://www.digikey.com/en/products/result?keywords=TSW-112-07-L-S | https://suddendocs.samtec.com/catalog_english/tsw_th.pdf | 1.00 | ea |  |  | not verified |  | FALSE | FALSE | FALSE |  |  |  |  |  |  |  |  |  |  |  |  |  |  | Order qty = design qty 1 (section E lists no spare). r9 (2026-11-12): plating -G -> -L (cr_decision_mating_connector_2026-11-12.md item 4: Samtec 2-piece stack, SSQ sockets on the MB, TSW on the CR, 11.05 mm seated; -G is not on the current TSW sheet); was TSW-112-07-G-S with Digi-Key SKU 612-TSW-112-07-G-S-ND. Soldered from the CR top while plugged into the SSQ sockets. No Digi-Key product page URL was found; Link is the Digi-Key keyword search; Vendor SKU blank. Price and stock not read: digikey.com, mouser.com, newark.com, arrow.com and octopart.com served bot-check or 403 pages to the built-in browser on 2026-11-11.
 | Socket strip 1x10 | MB CHG column x 45.998 (pins 1-10) | SSQ 1x10, 2.54 mm, standard-force contacts (-01), -L plating (10 uin Au mating, matte Sn tail), body 8.51 mm on the MB top, through-hole; mates TSW-110-07-L-S | MB connector | Samtec | SSQ-110-01-L-S | Digikey |  | https://www.digikey.com/en/products/result?keywords=SSQ-110-01-L-S | https://suddendocs.samtec.com/catalog_english/ssq.pdf | 1.00 | ea |  |  | not verified |  | FALSE | FALSE | FALSE |  |  |  |  |  |  |  |  |  |  |  |  |  |  | Order qty = design qty 1 (no spare listed). r9 (2026-11-12): new row (cr_decision_mating_connector_2026-11-12.md item 4). Soldered to the MB CHG holes after the Ag105 removal, bodies flat and square. Insertion 5.84 mm against the SSQ range 3.68-6.35 mm (decision record). Datasheet URL follows the Samtec URL pattern and was not opened, TODO(verify). No Digi-Key product page URL was found; Link is the Digi-Key keyword search; Vendor SKU blank. Price and stock not read: digikey.com, mouser.com, newark.com, arrow.com and octopart.com served bot-check or 403 pages to the built-in browser on 2026-11-11.
 | Socket strip 1x12 | MB CHG column x 20.998 (pins 11-22) | SSQ 1x12, 2.54 mm, standard-force contacts (-01), -L plating (10 uin Au mating, matte Sn tail), body 8.51 mm on the MB top, through-hole; mates TSW-112-07-L-S | MB connector | Samtec | SSQ-112-01-L-S | Digikey |  | https://www.digikey.com/en/products/result?keywords=SSQ-112-01-L-S | https://suddendocs.samtec.com/catalog_english/ssq.pdf | 1.00 | ea |  |  | not verified |  | FALSE | FALSE | FALSE |  |  |  |  |  |  |  |  |  |  |  |  |  |  | Order qty = design qty 1 (no spare listed). r9 (2026-11-12): new row (cr_decision_mating_connector_2026-11-12.md item 4). Soldered to the MB CHG holes after the Ag105 removal, bodies flat and square. Insertion 5.84 mm against the SSQ range 3.68-6.35 mm (decision record). Datasheet URL follows the Samtec URL pattern and was not opened, TODO(verify). No Digi-Key product page URL was found; Link is the Digi-Key keyword search; Vendor SKU blank. Price and stock not read: digikey.com, mouser.com, newark.com, arrow.com and octopart.com served bot-check or 403 pages to the built-in browser on 2026-11-11.
 | Jumper shunt 2.54 mm | EVM JP4 | 1x2 closed-top shunt, 2.54 mm, gold flash, 3 A | EVM rework | Sullins Connector Solutions | SPC02SYAN | Digikey | S9001-ND | https://www.digikey.com/en/products/detail/sullins-connector-solutions/SPC02SYAN/76375 | https://www.digikey.com/en/products/detail/sullins-connector-solutions/SPC02SYAN/76375 | 2.00 | ea |  |  | not verified |  | FALSE | FALSE | FALSE |  |  |  |  |  |  |  |  |  |  |  |  |  |  | Order qty = design qty 1 + spare 1. Fit on the EVM JP4 header TODO(verify), T-A-05 (EM11). Datasheet column points to the product page (no PDF opened). Link and Vendor SKU from the digikey.com search-engine index, not read on the live page; confirm before ordering. Price and stock not read: digikey.com, mouser.com, newark.com, arrow.com and octopart.com served bot-check or 403 pages to the built-in browser on 2026-11-11.
 | Hook-up wire 20 AWG red | W1 (VCHGOUT) | 20 AWG stranded tinned copper 10/30, PVC UL1007/UL1569 300 V, OD 1.75 mm (listing), 100 ft | Wire | Alpha Wire | 3053 RD005 | Digikey |  | https://www.digikey.com/en/products/result?keywords=3053%20RD005 | https://www.alphawire.com/Products/Wire/Hook-Up-Wire/PVC/3053 | 1.00 | spool |  |  | not verified |  | FALSE | FALSE | FALSE |  |  |  |  |  |  |  |  |  |  |  |  |  |  | Need 1 m (r8 W1/W2 spec); sellable unit is a 100 ft (30.5 m) spool (RD005 = 100 ft). OD 1.75 mm per RS listing (index) - at the top of the 1.60-1.75 mm window; T-A-02 measures it. FLAG: stranding 10/30, not the 19/32 or 7/28 named in the r8 spec - operator ruling or alternative TODO(verify), T-A-02/T-A-05. Note the solid 3053/1 variant (OD 1.63 mm) is NOT acceptable (solid conductor). No Digi-Key product page URL was found; Link is the Digi-Key keyword search; Vendor SKU blank. Price and stock not read: digikey.com, mouser.com, newark.com, arrow.com and octopart.com served bot-check or 403 pages to the built-in browser on 2026-11-11.
 | Hook-up wire 20 AWG black | W2 (GND) | As 3053 RD005, black, 100 ft | Wire | Alpha Wire | 3053 BK005 | Digikey |  | https://www.digikey.com/en/products/result?keywords=3053%20BK005 | https://www.alphawire.com/Products/Wire/Hook-Up-Wire/PVC/3053 | 1.00 | spool |  |  | not verified |  | FALSE | FALSE | FALSE |  |  |  |  |  |  |  |  |  |  |  |  |  |  | Need 1 m; sellable unit 100 ft spool. Same flags as 3053 RD005 (stranding 10/30; OD 1.75 mm at the window top). MPN by the Alpha colour-suffix scheme, TODO(verify) the listing. No Digi-Key product page URL was found; Link is the Digi-Key keyword search; Vendor SKU blank. Price and stock not read: digikey.com, mouser.com, newark.com, arrow.com and octopart.com served bot-check or 403 pages to the built-in browser on 2026-11-11.
 | Hook-up wire 18 AWG PTFE red | W3 (VCHG) | 18 AWG stranded PTFE, UL Style 1213, 600 V, -60 to 200 C, 100 ft | Wire | Alpha Wire | 5857 RD005 | Digikey |  | https://www.digikey.com/en/products/detail/alpha-wire/5857-RD005/424172 | https://www.alphawire.com/Products/Wire/Hook-Up-Wire/PTFE/5857 | 1.00 | spool |  |  | not verified |  | FALSE | FALSE | FALSE |  |  |  |  |  |  |  |  |  |  |  |  |  |  | Need 1 m; sellable unit 100 ft spool. Conductor diameter (<= 1.35 mm for the 1.5 mm W3/W4 holes) TODO(verify: Alpha datasheet), T-A-05. Index snippet showed about USD 491.56 per 100 ft (not read today); a shorter put-up or another PTFE 18 AWG source may cost less - operator choice. Product URL from a digikey.co.uk index entry. Price and stock not read: digikey.com, mouser.com, newark.com, arrow.com and octopart.com served bot-check or 403 pages to the built-in browser on 2026-11-11.
 | Hook-up wire 18 AWG PTFE black | W4 (GND) | As 5857 RD005, black, 100 ft | Wire | Alpha Wire | 5857 BK005 | Digikey |  | https://www.digikey.com/en/products/result?keywords=5857%20BK005 | https://www.alphawire.com/Products/Wire/Hook-Up-Wire/PTFE/5857 | 1.00 | spool |  |  | not verified |  | FALSE | FALSE | FALSE |  |  |  |  |  |  |  |  |  |  |  |  |  |  | Need 1 m; sellable unit 100 ft spool. MPN by the Alpha colour-suffix scheme, TODO(verify) the listing. Same conductor-diameter check as 5857 RD005. No Digi-Key product page URL was found; Link is the Digi-Key keyword search; Vendor SKU blank. Price and stock not read: digikey.com, mouser.com, newark.com, arrow.com and octopart.com served bot-check or 403 pages to the built-in browser on 2026-11-11.
 | Hook-up wire 26 AWG colour A (white) | W6 conductor | 26 AWG stranded hook-up wire, 100 ft | Wire | Alpha Wire | 3049 WH005 | Digikey |  | https://www.digikey.com/en/products/detail/alpha-wire/3049-WH005/266595 | https://www.alphawire.com/Products/Wire/Hook-Up-Wire/PVC/3049 | 1.00 | spool |  |  | not verified |  | FALSE | FALSE | FALSE |  |  |  |  |  |  |  |  |  |  |  |  |  |  | r9 (2026-11-12): the taps now run in the J-TAP cable assembly (Molex 2147561101; superseded 2026-11-13: Molex 2147581101), so this spool serves W6 only (26 AWG twisted pair, <= 0.30 m until MS2, then <= 150 mm); sellable unit 100 ft spool. Was 'Need >= 2.5 m per colour (section E: >= 5 m in two colours)' for taps T1-T24. Insulation/UL style TODO(verify). Product URL from an azcus.digikey.com index entry. Price and stock not read: digikey.com, mouser.com, newark.com, arrow.com and octopart.com served bot-check or 403 pages to the built-in browser on 2026-11-11.
 | Hook-up wire 26 AWG colour B (blue) | W6 shield conductor | 26 AWG stranded hook-up wire, 100 ft | Wire | Alpha Wire | 3049 BL005 | Digikey |  | https://www.digikey.com/en/products/detail/alpha-wire/3049-BL005/266585 | https://www.alphawire.com/Products/Wire/Hook-Up-Wire/PVC/3049 | 1.00 | spool |  |  | not verified |  | FALSE | FALSE | FALSE |  |  |  |  |  |  |  |  |  |  |  |  |  |  | r9 (2026-11-12): the tap shields T7b and T17r now run in the J-TAP cable assembly and T9 is removed (tap review), so this spool serves the W6 second conductor only (bonded at the CR end); sellable unit 100 ft spool. Was 'Need >= 2.5 m'. Product URL from a digikey.com.mx index entry. Price and stock not read: digikey.com, mouser.com, newark.com, arrow.com and octopart.com served bot-check or 403 pages to the built-in browser on 2026-11-11.
 | Kynar (PVDF) wire 28 AWG red | E leads (EVM to EIB), twisted triple conductor 1 | 28 AWG silver-plated copper, PVDF (Kynar) jacket ~0.005 in, UL 1422, 105 C, 100 ft | Wire | Jonard Tools | R28R-0100 | Digikey | K391-ND | https://www.digikey.com/en/products/detail/jonard-tools/R28R-0100/K391-ND/221676 | https://www.digikey.com/en/products/detail/jonard-tools/R28R-0100/K391-ND/221676 | 1.00 | spool |  |  | not verified |  | FALSE | FALSE | FALSE |  |  |  |  |  |  |  |  |  |  |  |  |  |  | Need 2 m (E leads; r9: E4 and E6 are not built, dec2-eib, so 2 m is an upper bound) + 1 m (one conductor of the twisted triple) + allowance; sellable unit 100 ft spool. FLAG: the r7 spec prefers stranded 7/36; the Jonard listing gives a 0.32 mm conductor with no strand count, which matches SOLID 28 AWG - stranded PVDF 28 AWG was found only as TE 44A0111-28-x on 3000 m spools. TODO(verify: stock listing). Link and Vendor SKU from the digikey.com search-engine index, not read on the live page; confirm before ordering. Price and stock not read: digikey.com, mouser.com, newark.com, arrow.com and octopart.com served bot-check or 403 pages to the built-in browser on 2026-11-11.
 | Kynar (PVDF) wire 28 AWG black | Twisted triple conductor 2 | As R28R-0100, black | Wire | Jonard Tools | R28BLK-0100 | Digikey |  | https://www.digikey.com/en/products/detail/jonard-tools/R28BLK-0100/221675 | https://www.digikey.com/en/products/detail/jonard-tools/R28BLK-0100/221675 | 1.00 | spool |  |  | not verified |  | FALSE | FALSE | FALSE |  |  |  |  |  |  |  |  |  |  |  |  |  |  | Need 1 m + twist allowance for the 3-conductor 28 AWG twisted triple (no ready-made 3-conductor twisted 28 AWG cable was found; the triple is workshop-twisted from the three colours). Sellable unit 100 ft spool. Same solid-conductor flag as R28R-0100. Link and Vendor SKU from the digikey.com search-engine index, not read on the live page; confirm before ordering. Price and stock not read: digikey.com, mouser.com, newark.com, arrow.com and octopart.com served bot-check or 403 pages to the built-in browser on 2026-11-11.
 | Kynar (PVDF) wire 28 AWG yellow | Twisted triple conductor 3 | As R28R-0100, yellow | Wire | Jonard Tools | R28Y-0100 | Digikey | K392-ND | https://www.digikey.com/en/products/detail/jonard-tools/R28Y-0100/K392-ND/221677 | https://www.digikey.com/en/products/detail/jonard-tools/R28Y-0100/K392-ND/221677 | 1.00 | spool |  |  | not verified |  | FALSE | FALSE | FALSE |  |  |  |  |  |  |  |  |  |  |  |  |  |  | Need 1 m + twist allowance (twisted triple). Sellable unit 100 ft spool. Link and Vendor SKU from the digikey.com search-engine index, not read on the live page; confirm before ordering. Price and stock not read: digikey.com, mouser.com, newark.com, arrow.com and octopart.com served bot-check or 403 pages to the built-in browser on 2026-11-11.
 | Bus wire 24 AWG (0.51 mm) tinned copper | T-F-13 via fallback; PM4 step 1a MB overlay | 24 AWG solid tinned copper bus bar wire (0.51 mm), 100 ft | Wire | Alpha Wire | 299 SV005 | Digikey | 299SV005-ND | https://www.digikey.com/en/products/detail/alpha-wire/299-SV005/1666206 | https://www.alphawire.com/Products/Wire/Hook-Up-Wire/Bus-Bar/299 | 1.00 | spool |  |  | not verified |  | FALSE | FALSE | FALSE |  |  |  |  |  |  |  |  |  |  |  |  |  |  | Need 0.2 m (T-F-13) + 0.05 m (+0.05) overlay wire (kept separate on the spool); sellable unit 100 ft spool. 24 AWG nominal 0.511 mm = the 0.5 mm spec (TODO(verify) the overlay finished height <= 0.8 mm). Product URL from a digikey.co.uk index entry. Price and stock not read: digikey.com, mouser.com, newark.com, arrow.com and octopart.com served bot-check or 403 pages to the built-in browser on 2026-11-11.
 | Bus wire 20 AWG tinned copper | EVM JP3 link | 20 AWG solid tinned copper bus bar wire | Wire | Alpha Wire | 297 | Digikey |  | https://www.digikey.com/en/products/result?keywords=Alpha%20Wire%20297 | https://www.alphawire.com/Products/Wire/Hook-Up-Wire/Bus-Bar/297 | 1.00 | spool |  |  | not verified |  | FALSE | FALSE | FALSE |  |  |  |  |  |  |  |  |  |  |  |  |  |  | EM11 JP3 soldered link (section E 'EVM JP3 / JP5 links'). Alpha 297 is 20 AWG solid tinned copper, 0.032 in (Alpha product page, index). Mft. SKU is the series number; the length suffix of the smallest put-up is TODO(verify). A few cm needed. No Digi-Key product page URL was found; Link is the Digi-Key keyword search; Vendor SKU blank. Price and stock not read: digikey.com, mouser.com, newark.com, arrow.com and octopart.com served bot-check or 403 pages to the built-in browser on 2026-11-11.
 | Bus wire 18 AWG tinned copper | EVM JP5 link | 18 AWG solid tinned copper bus bar wire | Wire | Alpha Wire | 296 | Digikey |  | https://www.digikey.com/en/products/result?keywords=Alpha%20Wire%20296 | https://www.alphawire.com/Products/Wire/Hook-Up-Wire/Bus-Bar/296 | 1.00 | spool |  |  | not verified |  | FALSE | FALSE | FALSE |  |  |  |  |  |  |  |  |  |  |  |  |  |  | EM11 JP5 soldered link. Alpha 296 is 18 AWG solid tinned copper (AWC listing, index). Length suffix TODO(verify). A few cm needed. No Digi-Key product page URL was found; Link is the Digi-Key keyword search; Vendor SKU blank. Price and stock not read: digikey.com, mouser.com, newark.com, arrow.com and octopart.com served bot-check or 403 pages to the built-in browser on 2026-11-11.
 | Electronics RTV, non-slumping, alkoxy cure | A.3 W1-W4 strain-relief beads | DOWSIL 3145 RTV MIL-A-46146 adhesive/sealant, clear, 90 ml tube | Material | Dow | DOWSIL 3145 RTV Clear 90 ml (Dow 2768003) | Graco Roberts |  | https://www.gracoroberts.com/silicones/dowsil-3145-rtv-clear-silicone-adhesive-sealant-90ml/ | https://www.dow.com/en-us/pdp.dowsil-3145-rtv-mil-a-46146-adhesive-sealant-clear.html | 1.00 | tube |  |  | not verified |  | FALSE | FALSE | FALSE |  |  |  |  |  |  |  |  |  |  |  |  |  |  | 1 tube. Distributor listings (index) describe it as one-part, non-sag, non-corrosive, MIL-A-46146; the Dow TDS statement 'non-corrosive to copper' and the alkoxy cure system TODO(verify: Dow TDS), T-A-05. Not found on Digi-Key; Dow material number 2768003 from Rapid Online (index). Datasheet URL is the Dow product page pattern, TODO(verify). Price and stock not read: digikey.com, mouser.com, newark.com, arrow.com and octopart.com served bot-check or 403 pages to the built-in browser on 2026-11-11. r9 (2026-11-12): the A.4 tap beads are removed with the tap field (r9-4; design section E 'Adhesive (r5)' row), so this tube serves the A.3 W1-W4 strain-relief beads only.
 | Adhesive transfer tape 0.05 mm acrylic | B1R wedge bond (A.3, H.23(s)) | 3M 467MP, 200MP acrylic adhesive, 0.05 mm (2 mil) without liner, 1/2 in wide piece | Material | 3M | 467MP 0.5" x 4" | Digikey |  | https://www.digikey.com/en/products/detail/3m-tc/467MP-0-5-4-5/4341011 | https://www.3m.com/3M/en_US/p/d/b40071696/ | 1.00 | ea |  |  | not verified |  | FALSE | FALSE | FALSE |  |  |  |  |  |  |  |  |  |  |  |  |  |  | Section E: 1 sheet. 3M lists 0.05 mm total thickness without liner (Digi-Key data shows 2.3 mil adhesive - TODO(verify) which applies to this SKU). Exact Digi-Key listing (title '0.50 in x 4.00 in', id 4341011, from a digikey.de index entry) and its pack quantity TODO(verify); index notes it is not kept in stock. Adhesion to PA66/PBT and solder mask, temperature rating: T-A-05. Price and stock not read: digikey.com, mouser.com, newark.com, arrow.com and octopart.com served bot-check or 403 pages to the built-in browser on 2026-11-11. r9 (2026-11-12): the FT1/FT2 CR-side bond and the T-A-09 step 0 coupon are withdrawn (r9-5: no feet, no sheet, no coupon); the sheet serves the B1R wedge bond only and retires with B1R if the lead decisions remove it (design section E 'Foot transfer tape (r7)' row).
 | Kapton tape | Hardware line; pin 7-10 tip patch | 3M 5413 polyimide film tape, 1 mil film, silicone adhesive, 2.7 mil total, 1/4 in x 36 yd | Material | 3M | 5413 AMBER 1/4 IN X 36 YD | Digikey | 3M15375-ND | https://www.digikey.com/en/products/detail/3m/5413-AMBER-1-4-IN-X-36-Y/1819260 | https://www.3m.com/3M/en_US/p/d/b40071645/ | 1.00 | roll |  |  | not verified |  | FALSE | FALSE | FALSE |  |  |  |  |  |  |  |  |  |  |  |  |  |  | 1 roll. r9 (2026-11-12): the thermocouple-bond use is removed with the thermocouple (stackup_fabrules_decisions_2026-11-12.md section 3a); the tape stays. Link and Vendor SKU from the digikey.com search-engine index, not read on the live page; confirm before ordering. 3M datasheet URL TODO(verify). Price and stock not read: digikey.com, mouser.com, newark.com, arrow.com and octopart.com served bot-check or 403 pages to the built-in browser on 2026-11-11.
 | Standoff M3 x 10 mm nylon | EIB mount on the EVM plate | Hex standoff, M3 thread, female-female, 10.00 mm, natural nylon | Hardware | Keystone Electronics | 25510 | Digikey | 36-25510-ND | https://www.digikey.com/en/products/detail/keystone-electronics/25510/1532188 | https://www.keyelco.com/product.cfm/product_id/1102 | 2.00 | ea |  |  | not verified |  | FALSE | FALSE | FALSE |  |  |  |  |  |  |  |  |  |  |  |  |  |  | Order qty = design qty 2 (section E lists no spare). r7: x 2 (EIB pair only; the four EVM standoffs are deleted). Keystone datasheet URL TODO(verify). Link and Vendor SKU from the digikey.com search-engine index, not read on the live page; confirm before ordering. Price and stock not read: digikey.com, mouser.com, newark.com, arrow.com and octopart.com served bot-check or 403 pages to the built-in browser on 2026-11-11.
 | Screw M3 x 6 mm nylon pan head | EIB standoff screws | M3x0.5, 6.00 mm below head, slotted pan head, nylon | Hardware | Keystone Electronics | 29341 | Digikey | 36-29341-ND | https://www.digikey.com/en/products/detail/keystone-electronics/29341/1532216 | https://www.keyelco.com/ | 4.00 | ea |  |  | not verified |  | FALSE | FALSE | FALSE |  |  |  |  |  |  |  |  |  |  |  |  |  |  | 4 screws for 2 female-female standoffs (EIB side and plate side); screw length vs the EIB and plate thickness TODO(verify), T-A-06. Link and Vendor SKU from the digikey.com search-engine index, not read on the live page; confirm before ordering. Price and stock not read: digikey.com, mouser.com, newark.com, arrow.com and octopart.com served bot-check or 403 pages to the built-in browser on 2026-11-11.
 | Wire ferrule 0.75 mm2 | W3/W4 or W1/W2 terminal ends (if terminated in a screw terminal) | Insulated ferrule, 0.75 mm2 (18 AWG), 8 mm sleeve, gray, AI 0,75-8 GY | Hardware | Phoenix Contact | 3200894 | Digikey |  | https://www.digikey.com/en/products/detail/phoenix-contact/3200894/349956 | https://www.phoenixcontact.com/en-us/products/ferrule-ai-075-8-gy-3200894 | 10.00 | ea |  |  | not verified |  | FALSE | FALSE | FALSE |  |  |  |  |  |  |  |  |  |  |  |  |  |  | Section E lists ferrules 0.5/0.75 mm2 without a count; 10 assumed (ASSUMPTION). Link and Vendor SKU from the digikey.com search-engine index, not read on the live page; confirm before ordering. Price and stock not read: digikey.com, mouser.com, newark.com, arrow.com and octopart.com served bot-check or 403 pages to the built-in browser on 2026-11-11.
 | Wire ferrule 0.5 mm2 | 20 AWG lead ends (if terminated in a screw terminal) | Insulated ferrule, 0.5 mm2 (20 AWG), 8 mm sleeve, white, AI 0,5-8 WH | Hardware | Phoenix Contact | AI 0,5-8 WH | Digikey |  | https://www.digikey.com/en/products/result?keywords=AI%200%2C5-8%20WH | https://www.phoenixcontact.com/ | 10.00 | ea |  |  | not verified |  | FALSE | FALSE | FALSE |  |  |  |  |  |  |  |  |  |  |  |  |  |  | Count assumed 10 (ASSUMPTION). Phoenix order number for the loose (non-taped) AI 0,5-8 WH TODO(verify); 1200104 found in the index is the taped S1 variant and 3203066 is a 0.34 mm2 part (not this). No Digi-Key product page URL was found; Link is the Digi-Key keyword search; Vendor SKU blank. Price and stock not read: digikey.com, mouser.com, newark.com, arrow.com and octopart.com served bot-check or 403 pages to the built-in browser on 2026-11-11.
 | Heat-shrink tubing | Tap lead far ends, W-lead ends | Polyolefin heat-shrink, 2:1, sizes for 26-18 AWG | Hardware | NOT IDENTIFIED | NOT IDENTIFIED | Digikey |  | https://www.digikey.com/en/products/result?keywords=heat%20shrink%20tubing%20kit |  | 1.00 | kit |  |  | not verified |  | FALSE | FALSE | FALSE |  |  |  |  |  |  |  |  |  |  |  |  |  |  | Section E Hardware line, no size or MPN given; no candidate was verified this round (search did not return a usable listing). Select a 2:1 polyolefin kit covering 1.0-3.2 mm recovered sizes - TODO(verify), T-A-05. r9 (2026-11-12): the TSW-101 tap pins are retired; the far ends use the operator's crimp terminals.
 | Cable tie, miniature | W-lead anchors A1/A2, chassis tie | Panduit Pan-Ty miniature, 2.5 mm wide, natural, 100-pack | Hardware | Panduit Corp | PLT1M-C | Digikey | 298-1020-ND | https://www.digikey.com/en/products/detail/panduit-corp/PLT1M-C/280033 | https://www.panduit.com/ | 1.00 | pack |  |  | not verified |  | FALSE | FALSE | FALSE |  |  |  |  |  |  |  |  |  |  |  |  |  |  | One 100-pack (PLT1M-C is a 100-piece pack, TODO(verify)). Fit through the 6 x 6 mm tie base TODO(verify). Link and Vendor SKU from the digikey.com search-engine index, not read on the live page; confirm before ordering. Price and stock not read: digikey.com, mouser.com, newark.com, arrow.com and octopart.com served bot-check or 403 pages to the built-in browser on 2026-11-11.
 | Adhesive cable-tie base 6 x 6 mm | A1 (on MB solder mask) | Adhesive-backed tie mount, ~6 x 6 mm footprint | Hardware | NOT IDENTIFIED | NOT IDENTIFIED | Digikey |  | https://www.digikey.com/en/products/result?keywords=adhesive%20cable%20tie%20mount |  | 2.00 | ea |  |  | not verified |  | FALSE | FALSE | FALSE |  |  |  |  |  |  |  |  |  |  |  |  |  |  | Section E: 2 tie bases (+2) = one A1 and one A2 plus spares; this row is A1 + spare. No adhesive mount <= 6 x 6 mm was found (smallest seen: 12.7 x 12.7 mm Essentra MFTH class). Tie-base size, adhesive and temperature rating TODO(verify: adhesive tie-base datasheet), T-A-05.
 | Adhesive cable-tie base 10 x 10 mm | A2 (on MB solder mask) | Adhesive-backed tie mount, ~10 x 10 mm footprint | Hardware | NOT IDENTIFIED | NOT IDENTIFIED | Digikey |  | https://www.digikey.com/en/products/result?keywords=adhesive%20cable%20tie%20mount |  | 2.00 | ea |  |  | not verified |  | FALSE | FALSE | FALSE |  |  |  |  |  |  |  |  |  |  |  |  |  |  | A2 + spare. No adhesive mount <= 10 x 10 mm was found this round (smallest seen 12.7 mm square). TODO(verify), T-A-05.
 | B1R wedge | B1R (trunk ramp) | Machined G10/FR-4 or PEEK wedge, footprint x 23.55-26.05, y 62.54-67.10, ramp 65 deg to apex 9.78 mm above CR top | Workshop | workshop |  |  |  |  |  | 2.00 | ea |  |  | not verified |  | FALSE | FALSE | FALSE |  |  |  |  |  |  |  |  |  |  |  |  |  |  | Section E: 1 (+1). Workshop-made; no Digi-Key or Mouser raw-stock listing was found this round (search returned only McMaster-Carr/Rock West stock pages), so Manufacturer = workshop and the MPN is blank. Candidate stock: G-10/FR-4 bar (McMaster-Carr G-10/FR4 bars) or PEEK; temperature rating checked in T-A-05; workshop cost TODO(verify).
 | Insulating posts | B3, S1, S2 | Insulating posts: B3 holds trunk jacket bottom 10.7 mm above CR top; S1, S2 at the 8 mm W5 fold | Workshop | workshop |  |  |  |  |  | 6.00 | ea |  |  | not verified |  | FALSE | FALSE | FALSE |  |  |  |  |  |  |  |  |  |  |  |  |  |  | Section E: 3 (+3). Workshop-made; no Digi-Key or Mouser raw-stock listing was found this round (search returned only McMaster-Carr/Rock West stock pages), so Manufacturer = workshop and the MPN is blank. Heights from A.3 and the T-A-06 dry fit.
 | Off-CR insulating support | Off-CR support (3-D switched-conductor rule) | Insulating support, geometry TODO(design: T-A-06 dry fit) | Workshop | workshop |  |  |  |  |  | 1.00 | ea |  |  | not verified |  | FALSE | FALSE | FALSE |  |  |  |  |  |  |  |  |  |  |  |  |  |  | Section E: 1. Workshop-made; no Digi-Key or Mouser raw-stock listing was found this round (search returned only McMaster-Carr/Rock West stock pages), so Manufacturer = workshop and the MPN is blank.
 | EVM plate and clamps | EVM plate, 2 clamp bars or 4 corner L-clamps, lateral stops | Insulating plate carrying the EVM on its bumpons and the EIB on two M3 standoffs; clamps press <= 2.0 mm EVM edge lips; stops <= 0.3 mm play | Workshop | workshop |  |  |  |  |  | 1.00 | set |  |  | not verified |  | FALSE | FALSE | FALSE |  |  |  |  |  |  |  |  |  |  |  |  |  |  | Section E: 1 set. Workshop-made; no Digi-Key or Mouser raw-stock listing was found this round (search returned only McMaster-Carr/Rock West stock pages), so Manufacturer = workshop and the MPN is blank. Geometry TODO(design: from MS2, MS5 and MS7); materials and temperature ratings checked in T-A-05.
 | Silicone pads 0.5 mm | EVM plate clamp pads | 0.5 mm silicone pad sheet for the EVM clamps | Workshop | workshop |  |  |  |  |  | 1.00 | sheet |  |  | not verified |  | FALSE | FALSE | FALSE |  |  |  |  |  |  |  |  |  |  |  |  |  |  | Section E (EVM plate row). No catalogue item verified this round; MPN blank. TODO(verify).
 | Carrier PCB (CR) | CR | 4-layer, 1.6 mm, 1 oz outer / 0.5 oz inner (OSH Park 4-layer, D-29), ENIG; plug-on rectangle x 18.584-67, y 7-94 (MB frame), 48.416 x 87 mm, 4212 mm2, no NPTH | PCB | OSH Park | CR PCB (from PM0 Gerbers) | OSH Park |  |  |  | 5.00 | board |  |  | not verified |  | FALSE | FALSE | FALSE |  |  |  |  |  |  |  |  |  |  |  |  |  |  | Section E: 5 boards. r9 (2026-11-12, r9-5): the plug-on outline and the OSH Park 4-layer rule file (D-29) replace the r7 outline (bounding box 47.30 x 41.86 mm, 1394.06 mm2, three concave corners, one 1.0 mm NPTH), the 2 oz outer / 1 oz inner copper and 'OSH Park / PCBWay' (design section E 'CR PCB' row). Price TODO(verify: fab quote) (design allowance USD 70, not used in the total).
 | EVM interface PCB (EIB) | EIB | 2-layer, 1 oz, ENIG, 36.0 x 24.0 mm | PCB | OSH Park / PCBWay | EIB PCB (from PM0 Gerbers) | OSH Park / PCBWay |  |  |  | 5.00 | board |  |  | not verified |  | FALSE | FALSE | FALSE |  |  |  |  |  |  |  |  |  |  |  |  |  |  | Section E: 5 boards (same panel as the CR). Price TODO(verify: fab quote).
 | Stencil and solder paste | CR top side (reflow assembly) | Stencil for the CR top side with window-pane apertures on the U101 exposed pad; solder paste for the reflow oven; stencil thickness, aperture rules and paste type TODO(verify: stencil vendor and paste datasheet) | Assembly | NOT IDENTIFIED | NOT IDENTIFIED | stencil vendor / distributor |  |  |  | 1.00 | set |  |  | not verified |  | FALSE | FALSE | FALSE |  |  |  |  |  |  |  |  |  |  |  |  |  |  | r9 (2026-11-12, r9-5): new row; design section E 'Stencil and solder paste (r9-5)': 1 stencil (CR top) + paste, no candidate MPN; stencil thickness, aperture rules and paste type TODO(verify: stencil vendor and paste datasheet), T-A-05. Allowance TODO(verify: quote).
