Tangineering/DC-Balancer-Board-Teensy/docs/reviews/charger_bq25798_custom_board_2026-11-10/bom.csv

refdes | qty_per_board | spares_for_5_board_build | value | rating | package | MPN | manufacturer | distributor | unit_price_usd_qty1 | unit_price_usd_qty5 | price_basis | stock | date_checked | source_url | class_IC | carried_over_from_round3_refdes | scope
U501 | 1 | 2 | BQ25798 charger | VBUS/PMID/VAC/SW1 30 V abs max | VQFN-HR 29 (RQM) 4x4x1.0 | BQ25798RQMR | Texas Instruments | TI store | 5.038 | 5.038 | verified, TI store 2026-11-10, 1-99 tier | 415146 | 2026-11-10 | https://www.ti.com/product/BQ25798/part-details/BQ25798RQMR ; https://www.ti.com/storeservices/cart/opninventory?opn=BQ25798RQMR | S | EVM U1 | b
L501 | 1 | 1 | 1.0 uH | Isat >= 6.5 A required; 11.1 A per UG Table 4-1, basis TODO(verify: TDK DS) | 7.1x6.5x3.0 mm | SPM6530T-1R0M120 | TDK | distributor | 3.0 | 3.0 | allowance set in design document section 4, not a quote | TODO(verify: stock) | 2026-11-10 |  | S | EVM L2 | b
C511 C512 C529 C530 C531 | 5 | 3 | 10 uF X7R | 50 V (input side, >= 35 V rule; VBUS/PMID <= 23.63 V eFuse OVP) | 1210 (1206 acceptable) | GRM32ER71H106KA12L (candidate, TODO(verify: Murata DS and DC-bias at 23.6 V; T-A-04 gates C_VBUS >= 2 uF and C_PMID >= 4 uF, SLUSDV2C 6.3)); no 0805 fallback (35 V X5R 0805 deleted: outside the 1210/1206 footprint and area plan, DC-bias case not made) | Murata | distributor | 1.0 | 1.0 | allowance set in design document section 4, not a quote | TODO(verify: stock) | 2026-11-10 |  | S | EVM C11 C12 C29-C31 | b
C513 C514 C532 C518 | 4 | 4 | 0.1 uF X7R | 50 V (TDK code 1H, TODO(verify: TDK DS)); C513 VBUS, C514 VAC1/VAC2 and C532 PMID are input side: >= 35 V rule, node max 23.63 V eFuse OVP (PMID follows VBUS through the RBFET); C518 SYS is output side (SYS 23 V abs max, SLUSDV2C 6.1) and shares the 0402 MPN | 0402 | C1005X7R1H104K050BE | TDK | distributor | TODO(verify: price) | TODO(verify: price) | TODO(verify: price) | TODO(verify: stock) | 2026-11-10 |  | S | EVM C13 C14(+C15) C32 C18 | b
C519 C520 C521 C522 C523 | 5 | 3 | 10 uF X5R | 25 V | 0805 | C2012X5R1E106K125AB | TDK | distributor | TODO(verify: price) | TODO(verify: price) | TODO(verify: price) | TODO(verify: stock) | 2026-11-10 |  | S | EVM C19-C23 | b
C538 C539 | 2 | 2 | 10 uF X5R | 25 V | 0603 | GRT188R61E106ME13D | Murata | distributor | TODO(verify: price) | TODO(verify: price) | TODO(verify: price) | TODO(verify: stock) | 2026-11-10 |  | S | EVM C38 C39 | b
C506 C508 | 2 | 2 | 47 nF X7R | 25 V | 0402 | GRM155R71E473KA88D | Murata | distributor | TODO(verify: price) | TODO(verify: price) | TODO(verify: price) | TODO(verify: stock) | 2026-11-10 |  | S | EVM C6 C8 | b
C535 | 1 | 2 | 4.7 uF X5R | 16 V | 0603 | GRM188R61C475KAAJD | Murata | distributor | TODO(verify: price) | TODO(verify: price) | TODO(verify: price) | TODO(verify: stock) | 2026-11-10 |  | S | EVM C35 | b
C536 | 1 | 2 | 1.0 nF C0G, SDRV to GND | 50 V | 0402 | GRM1555C1H102JA01D | Murata | distributor | TODO(verify: price) | TODO(verify: price) | TODO(verify: price) | TODO(verify: stock) | 2026-11-10 |  | S | EVM C36 (re-wired, SLUSDV2C rev C) | b
R515 | 1 | 2 | 100 Ohm 1 % | - | 0603 | RC0603FR-07100RL | Yageo | distributor | TODO(verify: price) | TODO(verify: price) | TODO(verify: price) | TODO(verify: stock) | 2026-11-10 |  | S | EVM R15 | b
R529 | 1 | 2 | 6.04 kOhm 1 %, PROG 2S 1.5 MHz | - | 0603 | CRCW06036K04FKEA (candidate, TODO(verify: Vishay range)) | Vishay | distributor | TODO(verify: price) | TODO(verify: price) | TODO(verify: price) | TODO(verify: stock) | 2026-11-10 |  | S | EVM R29 (EVM BOM lists 6.20 k) | b
R507 R510 (DNP) | 0 | 2 | 2.0 Ohm | - | 0603 | CRCW06032R00JNEA | Vishay | distributor | TODO(verify: price) | TODO(verify: price) | TODO(verify: price) | - | 2026-11-10 |  | S | EVM R7 R10 | b
C505 C507 (DNP) | 0 | 2 | 2.2 nF C0G | 50 V | 0603 | GRM1885C1H222JA01D | Murata | distributor | TODO(verify: price) | TODO(verify: price) | TODO(verify: price) | - | 2026-11-10 |  | S | EVM C5 C7 | b
R541 C541 (DNP) | 0 | 0 | 2.0 Ohm + 2.2 uF | C541 >= 50 V | 1206/1210 | TODO(verify) | - | - | TODO(verify: price) | TODO(verify: price) | TODO(verify: price) | - | 2026-11-10 |  | S | EVM RSNUB1 CSNUB1 | b
R506 (DNP) | 0 | 0 | 0 Ohm | - | 0402 | - | - | - | TODO(verify: price) | TODO(verify: price) | TODO(verify: price) | - | 2026-11-10 |  | S | new | b
U301 | 1 | 1 | eFuse 60 V, adjustable OVP | IN abs max 67 V | VQFN-24 (RGE) 4x4 | TPS26630RGER | Texas Instruments | TI store | 4.812 | 4.812 | TI store 2026-11-10, price of the TPS26630RGERG4 page; TODO(verify: TPS26630RGER price) | 53000 (RGER) | 2026-11-10 | https://www.ti.com/product/TPS2663/part-details/TPS26630RGERG4 (price of RGERG4; no RGER part-details page) ; https://www.ti.com/storeservices/cart/opninventory?opn=TPS26630RGER | I | U101 | b
R301 | 1 | 1 | 8.06 kOhm 1 % | - | 0402 | CRCW04028K06FKED | Vishay | distributor | TODO(verify: price) | TODO(verify: price) | TODO(verify: price) | TODO(verify: stock) | 2026-11-10 |  | I | R101 | b
R305 | 1 | 1 | 27.4 kOhm 1 % | - | 0402 | CRCW040227K4FKED | Vishay | distributor | TODO(verify: price) | TODO(verify: price) | TODO(verify: price) | TODO(verify: stock) | 2026-11-10 |  | I | R105 | b
R302 | 1 | 1 | 845 kOhm 0.1 % | limiting element voltage TODO(verify: Vishay TNPW DS) | 0805 | TNPW0805845KBEEA | Vishay | distributor | 0.5 | 0.5 | round-3 allowance (wiring design E), not verified | TODO(verify: stock) | 2026-11-10 |  | I | R102 | b
R303 | 1 | 1 | 66.5 kOhm 0.1 % | - | 0402 | TNPW040266K5BEED | Vishay | distributor | 0.5 | 0.5 | round-3 allowance (wiring design E), not verified | TODO(verify: stock) | 2026-11-10 |  | I | R103 | b
R304 | 1 | 1 | 49.9 kOhm 0.1 % | - | 0402 | TNPW040249K9BEED | Vishay | distributor | 0.5 | 0.5 | round-3 allowance (wiring design E), not verified | TODO(verify: stock) | 2026-11-10 |  | I | R104 | b
C301 | 1 | 1 | 22 nF X7R | 50 V | 0402 | GRM155R71H223KA12D | Murata | distributor | TODO(verify: price) | TODO(verify: price) | TODO(verify: price) | TODO(verify: stock) | 2026-11-10 |  | I | C101 | b
C302a | 1 | 1 | 1.0 uF X7R | 100 V | 1206 | GRM31CR72A105KA01L (candidate) | Murata | distributor | 0.3 | 0.3 | round-3 allowance (wiring design E), not verified | TODO(verify: stock) | 2026-11-10 |  | I | C102a | b
C302b | 1 | 1 | 4.7 uF X7R/X7S | 100 V | 1210 | C3225X7S2A475K class (candidate) | TDK | distributor | 0.8 | 0.8 | round-3 allowance (wiring design E), not verified | TODO(verify: stock) | 2026-11-10 |  | I | C102b | b
C302c | 1 | 1 | 100 nF X7R | 100 V | 0603 | GRM188R72A104KA35D (candidate) | Murata | distributor | TODO(verify: price) | TODO(verify: price) | TODO(verify: price) | TODO(verify: stock) | 2026-11-10 |  | I | C102c | b
D307 | 1 | 1 | TVS, unidirectional | VRWM >= 30 V, VBR(min) >= 36 V | SMA | SMAJ33A class (MPN selected in T-A-05) | TODO(verify) | distributor | 0.5 | 0.5 | round-3 allowance (wiring design E), not verified | TODO(verify: stock) | 2026-11-10 |  | I | D107 | b
C303 | 1 | 1 | 1.0 uF X7R | 50 V | 0805 | GRM21BR71H105KA12L | Murata | distributor | TODO(verify: price) | TODO(verify: price) | TODO(verify: price) | TODO(verify: stock) | 2026-11-10 |  | I | C103 | b
D303 | 1 | 1 | Schottky | >= 40 V; IR <= 0.1 mA at 23.6 V / 60 C | SMA | selected in T-A-05; bench-only fallback B340A-13-F | Diodes Inc. (fallback) | distributor | 0.5 | 0.5 | round-3 allowance (wiring design E), not verified | TODO(verify: stock) | 2026-11-10 |  | I | D103 | b
C305 R306 (DNP) | 0 | 0 | footprints | - | 0402/0603 | - | - | - | TODO(verify: price) | TODO(verify: price) | TODO(verify: price) | - | 2026-11-10 |  | I | C105 R106 | b
U401 | 1 | 1 | triple open-drain inverter | VCC 3.3 V | SSOP-8 (DCT) | SN74LVC3G06DCTR | Texas Instruments | TI store | 0.83 | 0.83 | verified, TI store 2026-11-10, 1-99 tier | 43837 | 2026-11-10 | https://www.ti.com/product/SN74LVC3G06/part-details/SN74LVC3G06DCTR | S | U201 | b
U402 | 1 | 1 | single open-drain inverter | VCC 3.3 V | SC70-5 (DCK) | SN74LVC1G06DCKR | Texas Instruments | TI store | 0.109 | 0.109 | verified, TI store 2026-11-10, 1-99 tier | 874 | 2026-11-10 | https://www.ti.com/product/SN74LVC1G06/part-details/SN74LVC1G06DCKR | S | U202 | b
Q401 Q402 | 2 | 3 | N-MOSFET, logic level | 60 V | SOT-23 | 2N7002KT1G | onsemi | distributor | 0.2 | 0.2 | round-3 allowance (wiring design E), not verified | TODO(verify: stock) | 2026-11-10 |  | S | Q201 Q202 | b
Q403 | 1 | 2 | P-MOSFET, |VGS(th)| <= 2.0 V | 50 V | SOT-23 | BSS84LT1G | onsemi | distributor | 0.2 | 0.2 | round-3 allowance (wiring design E), not verified | TODO(verify: stock) | 2026-11-10 |  | S | Q203 | b
R518 | 1 | 1 | 5.23 kOhm 1 % | - | 0402 | CRCW04025K23FKED | Vishay | distributor | TODO(verify: price) | TODO(verify: price) | TODO(verify: price) | TODO(verify: stock) | 2026-11-10 |  | S | EVM R18 | b
R524 | 1 | 1 | 30.1 kOhm 1 % | - | 0402 | CRCW040230K1FKED | Vishay | distributor | TODO(verify: price) | TODO(verify: price) | TODO(verify: price) | TODO(verify: stock) | 2026-11-10 |  | S | EVM R24 | b
R525 (XOR R526, by T-E-09) | 1 | 1 | 10.0 kOhm 1 %, NTC simulator | - | 0402 | CRCW040210K0FKED | Vishay | distributor | TODO(verify: price) | TODO(verify: price) | TODO(verify: price) | TODO(verify: stock) | 2026-11-10 |  | S | EVM R25 via JP18 | b
R526 (XOR R525, by T-E-09) | 0 | 2 | 0 Ohm, pack NTC link | - | 0603 | CRCW06030000Z0EA | Vishay | distributor | TODO(verify: price) | TODO(verify: price) | TODO(verify: price) | TODO(verify: stock) | 2026-11-10 |  | S | EVM J7 / lead W6 | b
R523 | 1 | 1 | 49.9 kOhm 1 % | - | 0603 | CRCW060349K9FKEA | Vishay | distributor | TODO(verify: price) | TODO(verify: price) | TODO(verify: price) | TODO(verify: stock) | 2026-11-10 |  | S | EVM R23 (EM4) | b
R456 | 1 | 1 | 200 kOhm 1 % | - | 0603 | CRCW0603200KFKEA | Vishay | distributor | TODO(verify: price) | TODO(verify: price) | TODO(verify: price) | TODO(verify: stock) | 2026-11-10 |  | S | R256 (EM5) | b
C452 | 1 | 1 | 2.2 nF C0G | 50 V | 0603 | GRM1885C1H222JA01D | Murata | distributor | TODO(verify: price) | TODO(verify: price) | TODO(verify: price) | TODO(verify: stock) | 2026-11-10 |  | S | C252 (EM5) | b
R455 | 1 | 1 | 48.7 kOhm 1 % | - | 0603 | CRCW060348K7FKEA | Vishay | distributor | TODO(verify: price) | TODO(verify: price) | TODO(verify: price) | TODO(verify: stock) | 2026-11-10 |  | S | R255 | b
R457 | 1 | 1 | 59.0 kOhm 1 % | - | 0603 | CRCW060359K0FKEA | Vishay | distributor | TODO(verify: price) | TODO(verify: price) | TODO(verify: price) | TODO(verify: stock) | 2026-11-10 |  | S | R257 | b
R521 (DNP) | 0 | 0 | 10.0 kOhm | - | 0603 | - | - | - | TODO(verify: price) | TODO(verify: price) | TODO(verify: price) | - | 2026-11-10 |  | S | new | b
U302 U303 U304 U315 U319 U320 U321 U403 U404 | 9 | 2 | comparator + 1.242 V reference, push-pull | V+ 3.3 V | SOT-23-6 (DBV) | TLV3012BIDBVR | Texas Instruments | TI store | 2.079 | 2.079 | verified, TI store 2026-11-10, 1-99 tier | 29409 | 2026-11-10 | https://www.ti.com/product/TLV3012B/part-details/TLV3012BIDBVR | M (7 I; U403 U404 S) | U102-U104 U115 U119-U121 U203 U204 | b
U317 (DNP) | 0 | 0 | comparator, FCI_OK option | - | SOT-23-6 (DBV) | TLV3012BIDBVR | Texas Instruments | TI store | 2.079 | 2.079 | verified, TI store 2026-11-10, 1-99 tier | 29409 | 2026-11-10 | https://www.ti.com/product/TLV3012B/part-details/TLV3012BIDBVR | I | U117 (DNP) | b
R309 | 1 | 1 | 487 kOhm 0.1 % | - | 0805 | TNPW0805487KBEEA | Vishay | distributor | 0.5 | 0.5 | round-3 allowance (wiring design E), not verified | TODO(verify: stock) | 2026-11-10 |  | I | R109 | b
R311 | 1 | 1 | 442 kOhm 0.1 % | - | 0805 | TNPW0805442KBEEA | Vishay | distributor | 0.5 | 0.5 | round-3 allowance (wiring design E), not verified | TODO(verify: stock) | 2026-11-10 |  | I | R111 | b
R310 R312 | 2 | 1 | 56.2 kOhm 0.1 % | - | 0603 | TNPW060356K2BEEA | Vishay | distributor | 0.5 | 0.5 | round-3 allowance (wiring design E), not verified | TODO(verify: stock) | 2026-11-10 |  | I | R110 R112 | b
R314 | 1 | 1 | 1.00 MOhm 0.1 % | - | 0805 | TNPW08051M00BEEA | Vishay | distributor | 0.5 | 0.5 | round-3 allowance (wiring design E), not verified | TODO(verify: stock) | 2026-11-10 |  | I | R114 | b
R315 | 1 | 1 | 104 kOhm 0.1 % | - | 0603 | TNPW0603104KBEEA | Vishay | distributor | 0.5 | 0.5 | round-3 allowance (wiring design E), not verified | TODO(verify: stock) | 2026-11-10 |  | I | R115 | b
R313 | 1 | 1 | 6.49 MOhm 1 % | - | 0603 | CRCW06036M49FKEA | Vishay | distributor | TODO(verify: price) | TODO(verify: price) | TODO(verify: price) | TODO(verify: stock) | 2026-11-10 |  | I | R113 | b
R341 | 1 | 1 | 61.9 kOhm 1 % | - | 0603 | CRCW060361K9FKEA | Vishay | distributor | TODO(verify: price) | TODO(verify: price) | TODO(verify: price) | TODO(verify: stock) | 2026-11-10 |  | I | R141 | b
R342 (select-on-test kit) | 1 | 0 | 0.604 / 0.715 / 0.825 / 1.00 / 1.21 / 1.40 kOhm 1 %, 2 of each per build | - | 0603 | CRCW0603xxxxFKEA kit | Vishay | distributor | TODO(verify: price) | TODO(verify: price) | TODO(verify: price) | TODO(verify: stock) | 2026-11-10 |  | I | R142 kit | b
R343 | 1 | 1 | 100 Ohm 1 % | - | 0603 | CRCW0603100RFKEA | Vishay | distributor | TODO(verify: price) | TODO(verify: price) | TODO(verify: price) | TODO(verify: stock) | 2026-11-10 |  | I | R143 | b
R387 | 1 | 1 | 3.30 MOhm 1 % | - | 0603 | CRCW06033M30FKEA | Vishay | distributor | TODO(verify: price) | TODO(verify: price) | TODO(verify: price) | TODO(verify: stock) | 2026-11-10 |  | I | R187 | b
R388 R390 | 2 | 1 | 453 kOhm 1 % | - | 0603 | CRCW0603453KFKEA | Vishay | distributor | TODO(verify: price) | TODO(verify: price) | TODO(verify: price) | TODO(verify: stock) | 2026-11-10 |  | I | R188 R190 | b
R317 R384 | 2 | 1 | 20.0 kOhm 1 % | - | 0603 | CRCW060320K0FKEA | Vishay | distributor | TODO(verify: price) | TODO(verify: price) | TODO(verify: price) | TODO(verify: stock) | 2026-11-10 |  | I | R117 R184 | b
R316 R319 R459 | 3 | 1 | 10.0 MOhm 1 % | - | 0603 | CRCW060310M0FKEA | Vishay | distributor | TODO(verify: price) | TODO(verify: price) | TODO(verify: price) | TODO(verify: stock) | 2026-11-10 |  | M (R459 S) | R116 R119 R259 | b
R337 | 1 | 1 | 0 Ohm, FCI_OK link | - | 0603 | CRCW06030000Z0EA | Vishay | distributor | TODO(verify: price) | TODO(verify: price) | TODO(verify: price) | TODO(verify: stock) | 2026-11-10 |  | I | R137 | b
R334 R360-R363 C324 C327 (DNP) | 0 | 0 | FCI_OK option parts | - | 0603 | per WD E | - | - | TODO(verify: price) | TODO(verify: price) | TODO(verify: price) | - | 2026-11-10 |  | I | R134 R160-R163 C124 C127 | b
C336 C337 C453 (DNP) | 0 | 0 | 100 pF C0G, comparator-input filter footprints at N_FNP, N_RNP, N_CSP; fit per T-K-09 step 5 (design document section 2.5.6) | 50 V | 0603 | GRM1885C1H101JA01D (candidate, TODO(verify: Murata DS)) | Murata | distributor | TODO(verify: price) | TODO(verify: price) | TODO(verify: price) | - | 2026-11-10 |  | M (C453 S) | new | b
D304 D305 D306 D308 | 4 | 2 | low-leakage diode pair | - | SOT-23 | BAV199,215 | Nexperia | distributor | 0.2 | 0.2 | round-3 allowance (wiring design E), not verified | TODO(verify: stock) | 2026-11-10 |  | I | D104-D106 D108 | b
C306 C307 | 2 | 1 | 470 pF C0G | 50 V | 0603 | GRM1885C1H471JA01D | Murata | distributor | TODO(verify: price) | TODO(verify: price) | TODO(verify: price) | TODO(verify: stock) | 2026-11-10 |  | I | C106 C107 | b
C308 C329 | 2 | 1 | 1.0 nF C0G | 50 V | 0603 | GRM1885C1H102JA01D | Murata | distributor | TODO(verify: price) | TODO(verify: price) | TODO(verify: price) | TODO(verify: stock) | 2026-11-10 |  | I | C108 C129 | b
C340 | 1 | 1 | 10 nF X7R | 50 V | 0603 | GRM188R71H103KA01D | Murata | distributor | TODO(verify: price) | TODO(verify: price) | TODO(verify: price) | TODO(verify: stock) | 2026-11-10 |  | I | C140 | b
U305 | 1 | 1 | triple inverter | 3.3 V | SSOP-8 (DCT) | SN74LVC3G04DCTR | Texas Instruments | TI store | 0.818 | 0.818 | verified, TI store 2026-11-10, 1-99 tier | 21705 | 2026-11-10 | https://www.ti.com/product/SN74LVC3G04/part-details/SN74LVC3G04DCTR | I | U105 | b
U306 U310 | 2 | 1 | dual OR | 3.3 V | SSOP-8 (DCT) | SN74LVC2G32DCTR | Texas Instruments | TI store | 0.761 | 0.761 | verified, TI store 2026-11-10, 1-99 tier | 1801 | 2026-11-10 | https://www.ti.com/product/SN74LVC2G32/part-details/SN74LVC2G32DCTR | I | U106 U110 | b
U307 U308 U309 | 3 | 1 | 3-input AND | 3.3 V | SC70-6 (DCK) | SN74LVC1G11DCKR | Texas Instruments | TI store | 0.161 | 0.161 | verified, TI store 2026-11-10, 1-99 tier | 2547 | 2026-11-10 | https://www.ti.com/product/SN74LVC1G11/part-details/SN74LVC1G11DCKR | I | U107-U109 | b
U311 U313 | 2 | 1 | retriggerable monostable | 3.3 V | SSOP-8 (DCT) | SN74LVC1G123DCTR | Texas Instruments | TI store | 1.703 | 1.703 | verified, TI store 2026-11-10, 1-99 tier | 2735 | 2026-11-10 | https://www.ti.com/product/SN74LVC1G123/part-details/SN74LVC1G123DCTR | M (U311 S, U313 I) | U111 U113 | b
U314 U316 U318 | 3 | 1 | dual AND | 3.3 V | SSOP-8 (DCT) | SN74LVC2G08DCTRE4 (DCTR stock 0 on 2026-11-10) | Texas Instruments | TI store | 0.861 | 0.861 | verified, TI store 2026-11-10, 1-99 tier | DCTRE4 142215; DCTRG4 5103; DCTR 0 | 2026-11-10 | https://www.ti.com/product/SN74LVC2G08/part-details/SN74LVC2G08DCTRE4 | I | U114 U116 U118 | b
U322 | 1 | 1 | single AND | 3.3 V | SC70-5 (DCK) | SN74LVC1G08DCKR | Texas Instruments | TI store | 0.069 | 0.069 | verified, TI store 2026-11-10, 1-99 tier | 734408 | 2026-11-10 | https://www.ti.com/product/SN74LVC1G08/part-details/SN74LVC1G08DCKR | I | U122 | b
U323 | 1 | 1 | single Schmitt inverter | 3.3 V | SC70-5 (DCK) | SN74LVC1G14DCKR | Texas Instruments | TI store | 0.108 | 0.108 | verified, TI store 2026-11-10, 1-99 tier | 596127 | 2026-11-10 | https://www.ti.com/product/SN74LVC1G14/part-details/SN74LVC1G14DCKR | I | U123 | b
C350 | 1 | 1 | 3.3 uF X7R, QUAL timing | 16 V | 0805 | GRM21BR71C335KA73L | Murata | distributor | TODO(verify: price) | TODO(verify: price) | TODO(verify: price) | TODO(verify: stock) | 2026-11-10 |  | S | C150 | b
C351 | 1 | 1 | 330 nF X7R, heartbeat timing | 16 V | 0603 | GRM188R71C334KA01D | Murata | distributor | TODO(verify: price) | TODO(verify: price) | TODO(verify: price) | TODO(verify: stock) | 2026-11-10 |  | I | C151 | b
R375 | 1 | 1 | 68.0 Ohm 1 % 0.25 W | - | 1206 | CRCW120668R0FKEA | Vishay | distributor | TODO(verify: price) | TODO(verify: price) | TODO(verify: price) | TODO(verify: stock) | 2026-11-10 |  | I | R175 | b
C325 | 1 | 1 | 10 uF X7R | 10 V | 0805 | GRM21BR71A106KE51L | Murata | distributor | TODO(verify: price) | TODO(verify: price) | TODO(verify: price) | TODO(verify: stock) | 2026-11-10 |  | I | C125 | b
R345 R346 (DNP) | 0 | 0 | I2C pull-up footprints | - | 0603 | - | - | - | TODO(verify: price) | TODO(verify: price) | TODO(verify: price) | - | 2026-11-10 |  | I | R145 R146 | b
R307 R318 R320 R329 R340 R385 R386 R458 R460 R461 R474 | 11 | 3 | 10.0 kOhm 1 % | - | 0603 | CRCW060310K0FKEA | Vishay | distributor | TODO(verify: price) | TODO(verify: price) | TODO(verify: price) | TODO(verify: stock) | 2026-11-10 |  | M (R458 R460 R461 S) | R107 R118 R120 R129 R140 R185 R186 R258 R260 R261 R274 | b
R308 R323 R324 R452 R454 R467 R468 R469 R470 R471 R472 R472b | 12 | 3 | 47.0 kOhm 1 % | - | 0603 | CRCW060347K0FKEA | Vishay | distributor | TODO(verify: price) | TODO(verify: price) | TODO(verify: price) | TODO(verify: stock) | 2026-11-10 |  | M (R4xx and R323 S) | R108 R123 R124 R252 R254 R267-R271 R272 R272b | b
R321 R322 R325 R326 R327 R328 R335 R347 R348 R475 | 10 | 3 | 1.00 kOhm 1 % | - | 0603 | CRCW06031K00FKEA | Vishay | distributor | TODO(verify: price) | TODO(verify: price) | TODO(verify: price) | TODO(verify: stock) | 2026-11-10 |  | M (R325 R347 R348 R475 S) | R121 R122 R125-R128 R135 R147 R148 R275 | b
R333 R336 R350 R351 R378 | 5 | 2 | 100 kOhm 1 % | - | 0603 | CRCW0603100KFKEA | Vishay | distributor | TODO(verify: price) | TODO(verify: price) | TODO(verify: price) | TODO(verify: stock) | 2026-11-10 |  | M (R350 S) | R133 R136 R150 R151 R178 | b
R344 R379 R389 R391 R462 R463 | 6 | 2 | 1.00 MOhm 1 % | - | 0603 | CRCW06031M00FKEA | Vishay | distributor | TODO(verify: price) | TODO(verify: price) | TODO(verify: price) | TODO(verify: stock) | 2026-11-10 |  | M (R462 R463 S) | R144 R179 R189 R191 R262 R263 | b
C309 C330 C310-C323 C326 C331-C335 C401-C404 | 26 | 5 | 100 nF X7R | 50 V | 0603 | GRM188R71H104KA93D | Murata | distributor | TODO(verify: price) | TODO(verify: price) | TODO(verify: price) | TODO(verify: stock) | 2026-11-10 |  | M (C401-C404 S) | C109 C130 C110-C123 C126 C131-C135 C201-C204 | b
U312 (DNP) | 0 | 1 | load switch 18 V | - | SOT-23-6 (DBV) | TPS22810DBVR | Texas Instruments | TI store | 0.492 | 0.492 | verified, TI store 2026-11-10, 1-99 tier | 105 | 2026-11-10 | https://www.ti.com/product/TPS22810/part-details/TPS22810DBVR | I | U112 (DNP) | b
D301 C352 R392 (DNP) | 0 | 0 | Schottky; 2.2 nF C0G; 680 Ohm 0.25 W | - | SOD-323 / 0603 / 1206 | BAT54HT1G; GRM1885C1H222JA01D; CRCW1206680RFKEA | onsemi; Murata; Vishay | distributor | TODO(verify: price) | TODO(verify: price) | TODO(verify: price) | - | 2026-11-10 |  | I | D101 C152 R_KA (DNP) | b
H301 pads 1-10 | 1 | 1 | 1x10 0.64 mm square-pin header, 2.54 mm pitch, tall stack: pin length >= 10.8 mm (H_u 5.1 mm) to >= 13.8 mm (H_u 8.1 mm) | pin current >= 3 A (pins 4, 10) TODO(verify: Samtec, O-10) | TH | TSW-110 long-post lead style (S1) or MTSW-110 movable body (S2), class only; TODO(verify: Samtec drawing, lead style for the chosen H_u) | Samtec | distributor | 3.0 | 3.0 | allowance set in design document section 4, not a quote | TODO(verify: stock) | 2026-11-10 |  | I | CHG header pins (TSW-110-07-G-S in r1) | b
H301 pads 11-22 | 1 | 1 | 1x12 0.64 mm square-pin header, 2.54 mm pitch, tall stack as pads 1-10 | >= 2.0 A (pins 14, 15, 18, 19) TODO(verify: Samtec) | TH | TSW-112 long-post lead style (S1) or MTSW-112 movable body (S2), class only; TODO(verify: Samtec drawing) | Samtec | distributor | 3.0 | 3.0 | allowance set in design document section 4, not a quote | TODO(verify: stock) | 2026-11-10 |  | I | CHG header pins (TSW-112-07-G-S in r1) | b
MB socket strips, option K | 2 | 0 | 1x10 + 1x12 elevated female socket strips for 0.64 mm posts, seat height h_k = H_u - 2.54 mm (2.6-5.6 mm) | tail fits the 1.10 mm MB drill TODO(verify: drawing) | TH | ESQ-110 / ESQ-112 elevated class (K2) or Harwin M20 female + long-pin male (K3), candidates only; TODO(verify: Samtec/Harwin drawing, tail, accepted pin range, seat height) | Samtec / Harwin (candidate) | distributor | 6.0 | 6.0 | allowance set in design document section 4, not a quote | TODO(verify: stock) | 2026-11-10 |  | I | new (sec_mechanics 1.3.4 option K; SSW class in r1) | mb
F01-F21 tap pins (F22 F23 DNP; F24 spare, no pin) | 21 | 10 | single 0.64 mm male pin, wire soldered | - | TH | TSW-101-07-G-S | Samtec | distributor | 0.5 | 0.5 | allowance set in design document section 4, not a quote | TODO(verify: stock) | 2026-11-10 |  | I | Tap pins | b
Support feet | 2 | 2 | nylon M3 female-female hex spacer (length = H_u from dry fit M3; 5-8 mm for the r2 gap band, standard catalogue lengths), one end bonded to the MB mask, so the top thread is blind; nylon M3 pan-head screw + nylon M3 flat washer from the CCB top | no threadlocker and no nut (blind female thread); thread engagement <= spacer thread depth - 0.5 mm TODO(verify: spacer drawing); tighten to T_s with a torque screwdriver, T_s TODO(verify: nylon screw datasheet; T_s below the bond torsion breakaway of T-K-18) | - | TODO(verify: spacer length after the dry fit; screw length from engagement rule) | - | distributor | 1.0 | 1.0 | allowance set in design document section 4, not a quote | - | 2026-11-10 |  | I | Hardware (6 standoffs become 2 feet) | b
Foot adhesive | 1 | 0 | epoxy with a datasheet shear strength and solder-mask adhesion; no threadlocker on the foot screws | - | - | TODO(verify: adhesive datasheet) | - | distributor | 15.0 | 15.0 | allowance set in design document section 4, not a quote | - | 2026-11-10 |  | I | new | build
Torque screwdriver (tool, not in the roll-up) | 0 | 0 | adjustable, range covering T_s for M3 nylon screws | - | - | TODO(verify: operator tool availability) | - | distributor | TODO(verify: price) | TODO(verify: price) | TODO(verify: price) | - | 2026-11-10 |  | I | new | build
Polyimide sheet | 1 | 1 | 0.125 mm polyimide film, silicone PSA, CCB outline + 1 mm including rect A | - | - | no MPN (WD E) | - | distributor | 10.0 | 10.0 | round-3 allowance (wiring design E), not verified | - | 2026-11-10 |  | I | Polyimide sheet (r5) | build
RTV | 1 | 0 | neutral-cure silicone RTV: tap strain relief and inductor staking | - | - | Dow 3145 / 3140 class (WD E) | Dow (class) | distributor | 15.0 | 15.0 | round-3 allowance (wiring design E), not verified | - | 2026-11-10 |  | I | Adhesive (r5) | build
Thermocouple | 1 | 0 | fine type-K, Kapton-bondable | - | - | - | - | distributor | 15.0 | 15.0 | round-3 allowance (wiring design E), not verified | - | 2026-11-10 |  | I | Thermocouple (r6) | build
Fan | 1 | 0 | axial DC fan for the low-y inlet, 25-30 mm frame class; >= 3.9-11.8 CFM free-air rating; static pressure above the bare-channel 5.4-12.7 Pa by the duct and obstacle losses (layout_calc_out.txt 8.9; design document 1.6.3); supply voltage matched to the bench supply | not on the LM1084 / CO-5V rail | - | TODO(verify: fan MPN, airflow and static-pressure curve, current) | - | distributor | 10.0 | 10.0 | allowance set in design document section 4, not a quote | - | 2026-11-10 |  | I | new (r2) | build
Fan lead and connector | 1 | 0 | 2-wire fan lead with an inline 2-pin connector to the bench supply (or to the optional own regulator); no CCB or MB connector | - | - | TODO(verify: connector MPN) | - | distributor | 3.0 | 3.0 | allowance set in design document section 4, not a quote | - | 2026-11-10 |  | I | new (r2) | build
Fan mount and duct | 1 | 0 | bracket or printed frame holding the fan at the low-y edge, frame edge >= 2.35 mm above the MB; optional side baffles; no contact with MB copper | - | - | no MPN (operator-made) | - | distributor | 5.0 | 5.0 | allowance set in design document section 4, not a quote | - | 2026-11-10 |  | I | new (r2) | build
Fan regulator (DNP option) | 0 | 0 | own regulator for the fan when the bench supply voltage does not match the fan; never the LM1084 / CO-5V rail | - | - | TODO(verify: only if needed) | - | - | TODO(verify: price) | TODO(verify: price) | TODO(verify: price) | - | 2026-11-10 |  | I | new (r2) | build
Soak thermocouples | 1 | 0 | lot of 6 fine type-K thermocouples for the fan-on / fan-off soak (U501 top, L1 PGND pour, L501, MB under the cell, inlet air, outlet air; design document 3.7.3a) | - | - | - | - | distributor | 20.0 | 20.0 | allowance set in design document section 4, not a quote | - | 2026-11-10 |  | I | new (r2) | build
Anemometer (tool, not in the roll-up) | 0 | 0 | vane or hot-wire anemometer for the inlet and gap velocity | - | - | TODO(verify: instrument availability) | - | - | TODO(verify: price) | TODO(verify: price) | TODO(verify: price) | - | 2026-11-10 |  | I | new (r2) | build
U501 heatsink (DNP option) | 0 | 0 | top-side heatsink on the U501 mould compound, R_sa <= 60 C/W, clear of L501; thermal adhesive or clip | - | - | TODO(verify: heatsink and adhesive datasheets) | - | - | TODO(verify: price) | TODO(verify: price) | TODO(verify: price) | - | 2026-11-10 |  | S | new (r2) | b
Gap pad (not fitted) | 0 | 0 | compressed thermal gap pad of r1 (section 3.7.4); superseded by forced air on the testbench (operator statement, 2026-11-10); never booked in r1 | - | - | - | - | - | TODO(verify: price) | TODO(verify: price) | TODO(verify: price) | - | 2026-11-10 |  | I | r1 option, not fitted | b
Wire | 1 | 0 | 26 AWG two colours >= 5 m; 28 AWG Kynar 2 m; 30 AWG Kynar 0.3 m; 28 AWG twisted triple 1 m; 0.5 mm tinned Cu 0.25 m | - | - | - | - | distributor | 10.0 | 10.0 | allowance set in design document section 4, not a quote | - | 2026-11-10 |  | I | Wire (18/20 AWG lead wire deleted) | build
Stencil | 1 | 0 | stainless top-side SMT stencil; U501 apertures per SLUSDV2C p.150 | - | - | fab quote TODO(verify) | - | PCB fab | 25.0 | 25.0 | allowance set in design document section 4, not a quote | - | 2026-11-10 |  | S (U501 apertures) / I | new | build
MB C-D8 C-D10 (PM2) | 2 | 2 | 10 uF X5R | 35 V | 0805 | GRM21BR6YA106KE43L | Murata | distributor | 0.5 | 0.5 | round-3 allowance (wiring design E), not verified | TODO(verify: stock) | 2026-11-10 |  | I | C (MB) | mb
MB R170 R171 (PM3) | 2 | 2 | 10.0 kOhm 0.1 % | - | 0805 | TNPW080510K0BEEA | Vishay | distributor | 0.5 | 0.5 | round-3 allowance (wiring design E), not verified | TODO(verify: stock) | 2026-11-10 |  | I | R170 R171 | mb
MB RSDA RSCL (PM9) | 2 | 2 | 2.70 kOhm 1 % | - | 0603 | CRCW06032K70FKEA | Vishay | distributor | TODO(verify: price) | TODO(verify: price) | TODO(verify: price) | TODO(verify: stock) | 2026-11-10 |  | I | MB RSDA RSCL | mb
MB R172 F101 (DNP keep-alive) | 0 | 1 | 33 Ohm 0.25 W + ~50 mA fast fuse | - | 1206 / 0603 | CRCW120633R0FKEA + fuse TODO(verify: T-A-05) | - | distributor | TODO(verify: price) | TODO(verify: price) | TODO(verify: price) | - | 2026-11-10 |  | I | R172 F101 | mb
Overlay wire (PM4 step 1a, conditional) | 0 | 1 | 0.5 mm tinned copper 0.05 m | - | - | - | - | - | TODO(verify: price) | TODO(verify: price) | TODO(verify: price) | - | 2026-11-10 |  | I | Overlay wire (r6) | mb
Fallback-2 fused link (DNP) | 0 | 0 | SMD fuse >= 5 A + 20 AWG link | - | 1206-2410 | selected in T-A-05 | - | - | TODO(verify: price) | TODO(verify: price) | TODO(verify: price) | - | 2026-11-10 |  | I | Fallback-2 fused link | mb
CCB PCB | 1 | 0 | L-shaped ~1219 mm2 (31.0 x 42.26 mm bounding box), 4-layer, 1.6 mm, 1 oz outer / 1 oz inner (stack ST1) or 2 oz inner (stack ST2), ENIG (design document section 3.1.3) | - | - | fab quote TODO(verify) | - | PCB fab | 70-120 per lot of 5 | 70-120 per lot of 5 | allowance set in design document section 4 (round-3 CR allowance USD 70); not a quote | - | 2026-11-10 | https://docs.oshpark.com/services/four-layer/ (published 1 oz-outer reference, USD 10 per sq in per 3 copies) | I | CR PCB (EIB panel deleted) | lot
