Tangineering/DC-Balancer-Board-Teensy/hardware/charger_evm_r8/fab/eib_2026-11-11/assembly/eib-bom.csv

Refs | Value | Footprint | MPN | Manufacturer | DNP | Qty
C201,C202,C203,C204,C205 | 100nF 50V X7R | charger_r8_eib:C_0603_1608Metric_CrtYd0.10 | GRM188R71H104KA93D | Murata |  | 5
E1 | E1 REGN (JP12) | charger_r8_eib:LeadPad_PTH_D1.0mm_P1.8mm |  |  |  | 1
E2 | E2 ILIM feed | charger_r8_eib:LeadPad_PTH_D1.0mm_P1.8mm |  |  |  | 1
E3 | E3 ILIM hold | charger_r8_eib:LeadPad_PTH_D1.0mm_P1.8mm |  |  |  | 1
E4 | E4 ILIM sense | charger_r8_eib:LeadPad_PTH_D1.0mm_P1.8mm |  |  |  | 1
E5 | E5 nCE drive | charger_r8_eib:LeadPad_PTH_D1.0mm_P1.8mm |  |  |  | 1
E6 | E6 nCE sense | charger_r8_eib:LeadPad_PTH_D1.0mm_P1.8mm |  |  |  | 1
E7 | E7 STAT (TP38) | charger_r8_eib:LeadPad_PTH_D1.0mm_P1.8mm |  |  |  | 1
E8 | E8 AGND (TP49) | charger_r8_eib:LeadPad_PTH_D1.0mm_P1.8mm |  |  |  | 1
J201 | W5 header | charger_r8_eib:Samtec_FTSH-107-01-DV_2x07_P1.27mm_SMD | Samtec FTSH/SHF-107 class (T-A-05) | Samtec |  | 1
Q201,Q202 | 2N7002K | charger_r8_eib:SOT-23_CrtYd0.10 | 2N7002KT1G | onsemi |  | 2
Q203 | BSS84 | charger_r8_eib:SOT-23_CrtYd0.10 | BSS84LT1G | onsemi |  | 1
R250,R251,R253,R266,R275 | 1.00k 1% | charger_r8_eib:R_0603_1608Metric_CrtYd0.10 | CRCW06031K00FKEA | Vishay Dale |  | 5
R252,R254,R267,R268,R269,R270,R271 | 47.0k 1% | charger_r8_eib:R_0603_1608Metric_CrtYd0.10 | CRCW060347K0FKEA | Vishay Dale |  | 7
R255 | 48.7k 1% | charger_r8_eib:R_0603_1608Metric_CrtYd0.10 | CRCW060348K7FKEA | Vishay Dale |  | 1
R257 | 59.0k 1% | charger_r8_eib:R_0603_1608Metric_CrtYd0.10 | CRCW060359K0FKEA | Vishay Dale |  | 1
R258,R260,R261,R274 | 10.0k 1% | charger_r8_eib:R_0603_1608Metric_CrtYd0.10 | CRCW060310K0FKEA | Vishay Dale |  | 4
R259 | 10.0M 1% | charger_r8_eib:R_0603_1608Metric_CrtYd0.10 | CRCW060310M0FKEA | Vishay Dale |  | 1
R262,R263 | 1.00M 1% | charger_r8_eib:R_0603_1608Metric_CrtYd0.10 | CRCW06031M00FKEA | Vishay Dale |  | 2
R264,R265 | 470 1% | charger_r8_eib:R_0603_1608Metric_CrtYd0.10 | CRCW0603470RFKEA | Vishay Dale |  | 2
R273,R276 | 10.0 1% | charger_r8_eib:R_0603_1608Metric_CrtYd0.10 | CRCW060310R0FKEA | Vishay Dale |  | 2
U201 | SN74LVC3G06 | charger_r8_eib:Texas_DCT0008A_SSOP-8_TI-land_CrtYd0.10 | SN74LVC3G06DCTR | Texas Instruments |  | 1
U202 | SN74LVC1G06 | charger_r8_eib:Texas_DCK-5_SC-70-5_CrtYd0.10 | SN74LVC1G06DCKR | Texas Instruments |  | 1
U203,U204 | TLV3012B | charger_r8_eib:SOT-23-6_CrtYd0.10 | TLV3012BIDBVR | Texas Instruments |  | 2
