Tangineering/DC-Balancer-Board-Teensy/hardware/charger_evm_r8/fab/eib_2026-11-11/kikit_pcbway/bom.csv

Item # | Designator | Qty | Manufacturer | Mfg Part # | Description / Value | Footprint | Type | Your Instructions / Notes
1 | C201,C202,C203,C204,C205 | 5 | Murata | GRM188R71H104KA93D | 100nF 50V X7R | charger_r8_eib:C_0603_1608Metric_CrtYd0.10 | SMD
2 | E1 | 1 |  |  | E1 REGN (JP12) | charger_r8_eib:LeadPad_PTH_D1.0mm_P1.8mm | thru-hole
3 | E2 | 1 |  |  | E2 ILIM feed | charger_r8_eib:LeadPad_PTH_D1.0mm_P1.8mm | thru-hole
4 | E3 | 1 |  |  | E3 ILIM hold | charger_r8_eib:LeadPad_PTH_D1.0mm_P1.8mm | thru-hole
5 | E4 | 1 |  |  | E4 ILIM sense | charger_r8_eib:LeadPad_PTH_D1.0mm_P1.8mm | thru-hole
6 | E5 | 1 |  |  | E5 nCE drive | charger_r8_eib:LeadPad_PTH_D1.0mm_P1.8mm | thru-hole
7 | E6 | 1 |  |  | E6 nCE sense | charger_r8_eib:LeadPad_PTH_D1.0mm_P1.8mm | thru-hole
8 | E7 | 1 |  |  | E7 STAT (TP38) | charger_r8_eib:LeadPad_PTH_D1.0mm_P1.8mm | thru-hole
9 | E8 | 1 |  |  | E8 AGND (TP49) | charger_r8_eib:LeadPad_PTH_D1.0mm_P1.8mm | thru-hole
10 | J201 | 1 | Samtec | Samtec FTSH/SHF-107 class (T-A-05) | W5 header | charger_r8_eib:Samtec_FTSH-107-01-DV_2x07_P1.27mm_SMD | SMD
11 | Q201,Q202 | 2 | onsemi | 2N7002KT1G | 2N7002K | charger_r8_eib:SOT-23_CrtYd0.10 | SMD
12 | Q203 | 1 | onsemi | BSS84LT1G | BSS84 | charger_r8_eib:SOT-23_CrtYd0.10 | SMD
13 | R250,R251,R253,R266,R275 | 5 | Vishay Dale | CRCW06031K00FKEA | 1.00k 1% | charger_r8_eib:R_0603_1608Metric_CrtYd0.10 | SMD
14 | R255 | 1 | Vishay Dale | CRCW060348K7FKEA | 48.7k 1% | charger_r8_eib:R_0603_1608Metric_CrtYd0.10 | SMD
15 | R257 | 1 | Vishay Dale | CRCW060359K0FKEA | 59.0k 1% | charger_r8_eib:R_0603_1608Metric_CrtYd0.10 | SMD
16 | R259 | 1 | Vishay Dale | CRCW060310M0FKEA | 10.0M 1% | charger_r8_eib:R_0603_1608Metric_CrtYd0.10 | SMD
17 | R262,R263 | 2 | Vishay Dale | CRCW06031M00FKEA | 1.00M 1% | charger_r8_eib:R_0603_1608Metric_CrtYd0.10 | SMD
18 | R264,R265 | 2 | Vishay Dale | CRCW0603470RFKEA | 470 1% | charger_r8_eib:R_0603_1608Metric_CrtYd0.10 | SMD
19 | R252,R254,R267,R268,R269,R270,R271 | 7 | Vishay Dale | CRCW060347K0FKEA | 47.0k 1% | charger_r8_eib:R_0603_1608Metric_CrtYd0.10 | SMD
20 | R258,R260,R261,R274 | 4 | Vishay Dale | CRCW060310K0FKEA | 10.0k 1% | charger_r8_eib:R_0603_1608Metric_CrtYd0.10 | SMD
21 | R273,R276 | 2 | Vishay Dale | CRCW060310R0FKEA | 10.0 1% | charger_r8_eib:R_0603_1608Metric_CrtYd0.10 | SMD
22 | U201 | 1 | Texas Instruments | SN74LVC3G06DCTR | SN74LVC3G06 | charger_r8_eib:Texas_DCT0008A_SSOP-8_TI-land_CrtYd0.10 | SMD
23 | U202 | 1 | Texas Instruments | SN74LVC1G06DCKR | SN74LVC1G06 | charger_r8_eib:Texas_DCK-5_SC-70-5_CrtYd0.10 | SMD
24 | U203,U204 | 2 | Texas Instruments | TLV3012BIDBVR | TLV3012B | charger_r8_eib:SOT-23-6_CrtYd0.10 | SMD
