Tangineering/DC-Balancer-Board-Teensy/references/TI_BQ25798_design_files/TIDA-050047/altium_TIDM752/REV_A1/Project Outputs/PD_BQ_Ref_Design_PD_BQ_Ref_Design_BOM.xlsx

Line # | Designator | Fitted | Quantity | Value | PartNumber | Manufacturer | Description | PackageReference | Manufacturer 1 | Manufacturer Part Number 1 | Manufacturer Lifecycle 1 | Supplier 1 | Supplier Part Number 1 | Supplier Unit Price 1 | Supplier Subtotal 1 | Supplier 2 | Supplier Part Number 2 | Supplier Unit Price 2 | Supplier Subtotal 2
 | !PCB1 | Fitted | 1 |  | BMS046_ | Any | Printed Circuit Board
 | C1, C7 | Fitted | 2 | 0.047uF | GRM155R71E473KA88D | MuRata | CAP, CERM, 0.047 uF, 25 V, +/- 10%, X7R, 0402 | 0402 | Murata (https://octopart-clicks.com/click/altium?sku=490-3254-6-ND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) | GRM155R71E473KA88D (https://octopart-clicks.com/click/altium?sku=490-3254-6-ND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) | Volume Production | Digi-Key | 490-3254-6-ND (https://octopart-clicks.com/click/altium?sku=490-3254-6-ND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) | 0.0249 | 4.98 | Digi-Key | 490-3254-1-ND (https://octopart-clicks.com/click/altium?sku=490-3254-1-ND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) | 0.0249 | 4.98
 | C2, C3, C4, C5, C8, C9, C10, C20, C21, C23, C24 | Fitted | 11 | 10uF | GRT188R61E106ME13D | MuRata | CAP, CERM, 10 uF, 25 V, +/- 20%, X5R, 0603 | 0603 | Murata (https://octopart-clicks.com/click/altium?sku=490-12323-6-ND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) | GRT188R61E106ME13D (https://octopart-clicks.com/click/altium?sku=490-12323-6-ND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) | Volume Production | Digi-Key | 490-12323-6-ND (https://octopart-clicks.com/click/altium?sku=490-12323-6-ND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) | 0.13089 | 143.98 | Digi-Key | 490-12323-1-ND (https://octopart-clicks.com/click/altium?sku=490-12323-1-ND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) | 0.13089 | 143.98
 | C6, C11, C12, C19, C25 | Fitted | 5 | 0.1uF | C1005X7R1H104K050BE | TDK | CAP, CERM, 0.1 uF, 50 V,+/- 10%, X7R, 0402 | 0402 | TDK (https://octopart-clicks.com/click/altium?sku=445-173610-6-ND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) | C1005X7R1H104K050BE (https://octopart-clicks.com/click/altium?sku=445-173610-6-ND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) | Volume Production | Digi-Key | 445-173610-6-ND (https://octopart-clicks.com/click/altium?sku=445-173610-6-ND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) | 0.04204 | 21.02 | Digi-Key | 445-173610-1-ND (https://octopart-clicks.com/click/altium?sku=445-173610-1-ND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) | 0.04204 | 21.02
 | C13, C14, C15, C16, C17 | Fitted | 5 | 10uF | C2012X5R1E106K125AB | TDK | CAP, CERM, 10 uF, 25 V, +/- 10%, X5R, 0805 | 0805 | TDK (https://octopart-clicks.com/click/altium?sku=445-5984-1-ND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) | C2012X5R1E106K125AB (https://octopart-clicks.com/click/altium?sku=445-5984-1-ND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) | Volume Production | Digi-Key | 445-5984-1-ND (https://octopart-clicks.com/click/altium?sku=445-5984-1-ND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) | 0.11434 | 57.17 | Digi-Key | 445-5984-6-ND (https://octopart-clicks.com/click/altium?sku=445-5984-6-ND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) | 0.11434 | 57.17
 | C18 | Fitted | 1 | 4.7uF | GRM188R61C475KAAJ | MuRata | CAP, CERM, 4.7 uF, 16 V, +/- 10%, X5R, 0603 | 0603 | Murata (https://octopart-clicks.com/click/altium?sku=490-10481-6-ND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) | GRM188R61C475KAAJD (https://octopart-clicks.com/click/altium?sku=490-10481-6-ND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) | Volume Production | Digi-Key | 490-10481-6-ND (https://octopart-clicks.com/click/altium?sku=490-10481-6-ND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) | 0.155 | 15.5 | Digi-Key | 490-10481-1-ND (https://octopart-clicks.com/click/altium?sku=490-10481-1-ND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) | 0.155 | 15.5
 | C22 | Fitted | 1 | 1000pF | C0402C102K5RACTU | Kemet | CAP, CERM, 1000 pF, 50 V, +/- 10%, X7R, 0402 | 0402 | Kemet (https://octopart-clicks.com/click/altium?sku=399-1032-1-ND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) | C0402C102K5RAC-TU (https://octopart-clicks.com/click/altium?sku=399-1032-1-ND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) |  | Digi-Key | 399-1032-1-ND (https://octopart-clicks.com/click/altium?sku=399-1032-1-ND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) |  |  | Newark | 53M7151
 | C26 | Fitted | 1 | 100uF | T520B107M006ATE015 | Kemet | CAP, TA, 100 uF, 6.3 V, +/- 20%, 0.015 ohm, SMD | 3528-21 | KEMET (https://octopart-clicks.com/click/altium?sku=399-5306-6-ND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) | T520B107M006ATE015 (https://octopart-clicks.com/click/altium?sku=399-5306-6-ND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) | Volume Production | Digi-Key | 399-5306-6-ND (https://octopart-clicks.com/click/altium?sku=399-5306-6-ND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) | 0.8366 | 83.66 | Digi-Key | 399-5306-1-ND (https://octopart-clicks.com/click/altium?sku=399-5306-1-ND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) | 0.8366 | 83.66
 | C27, C28 | Fitted | 2 | 47uF | GRM32ER61A476KE20L | MuRata | CAP, CERM, 47 uF, 10 V, +/- 10%, X5R, 1210 | 1210 | Murata (https://octopart-clicks.com/click/altium?sku=490-3887-1-ND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) | GRM32ER61A476KE20L (https://octopart-clicks.com/click/altium?sku=490-3887-1-ND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) | Volume Production | Digi-Key | 490-3887-1-ND (https://octopart-clicks.com/click/altium?sku=490-3887-1-ND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) | 0.9439 | 188.78 | Digi-Key | 490-3887-6-ND (https://octopart-clicks.com/click/altium?sku=490-3887-6-ND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) | 0.9439 | 188.78
 | C29, C30 | Fitted | 2 | 4.7uF | GRM32ER71H475KA88L | MuRata | CAP, CERM, 4.7 uF, 50 V, +/- 10%, X7R, 1210 | 1210 | Murata (https://octopart-clicks.com/click/altium?sku=490-1864-6-ND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) | GRM32ER71H475KA88L (https://octopart-clicks.com/click/altium?sku=490-1864-6-ND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) | Volume Production | Digi-Key | 490-1864-6-ND (https://octopart-clicks.com/click/altium?sku=490-1864-6-ND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) | 0.2744 | 54.88 | Digi-Key | 490-1864-1-ND (https://octopart-clicks.com/click/altium?sku=490-1864-1-ND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) | 0.2744 | 54.88
 | C31 | Fitted | 1 | 0.01uF | GRM216R71H103KA01D | MuRata | CAP, CERM, 0.01 uF, 50 V, +/- 10%, X7R, 0805 | 0805 | Murata (https://octopart-clicks.com/click/altium?sku=490-1664-1-ND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) | GRM216R71H103KA01D (https://octopart-clicks.com/click/altium?sku=490-1664-1-ND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) | Volume Production | Digi-Key | 490-1664-1-ND (https://octopart-clicks.com/click/altium?sku=490-1664-1-ND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) | 0 | 0 | Digi-Key | 490-1664-6-ND (https://octopart-clicks.com/click/altium?sku=490-1664-6-ND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) | 0 | 0
 | C32 | Fitted | 1 | 2200pF | GRM188R71H222KA01D | MuRata | CAP, CERM, 2200 pF, 50 V, +/- 10%, X7R, 0603 | 0603 | Murata (https://octopart-clicks.com/click/altium?sku=490-1500-2-ND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) | GRM188R71H222KA01D (https://octopart-clicks.com/click/altium?sku=490-1500-2-ND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) | Volume Production | Digi-Key | 490-1500-2-ND (https://octopart-clicks.com/click/altium?sku=490-1500-2-ND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) | 0 | 0 | Digi-Key | 490-1500-1-ND (https://octopart-clicks.com/click/altium?sku=490-1500-1-ND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) | 0 | 0
 | C33 | Fitted | 1 | 0.01uF | 06031C103KAT2A | AVX | CAP, CERM, 0.01 uF, 100 V, +/- 10%, X7R, 0603 | 0603 | AVX (https://octopart-clicks.com/click/altium?sku=478-1205-1-ND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) | 06031C103KAT2A (https://octopart-clicks.com/click/altium?sku=478-1205-1-ND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) |  | Digi-Key | 478-1205-1-ND (https://octopart-clicks.com/click/altium?sku=478-1205-1-ND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) |  |  | Newark | 96K4758
 | C34 | Fitted | 1 | 22pF | GRM1885C1H220JA01D | MuRata | CAP, CERM, 22 pF, 50 V, +/- 5%, C0G/NP0, 0603 | 0603 | Murata (https://octopart-clicks.com/click/altium?sku=490-1411-6-ND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) | GRM1885C1H220JA01D (https://octopart-clicks.com/click/altium?sku=490-1411-6-ND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) | Volume Production | Digi-Key | 490-1411-6-ND (https://octopart-clicks.com/click/altium?sku=490-1411-6-ND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) | 0.0367 | 3.67 | Digi-Key | 490-1411-1-ND (https://octopart-clicks.com/click/altium?sku=490-1411-1-ND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) | 0.0367 | 3.67
 | C35, C36, C37 | Fitted | 3 | 10uF | CL05A106MP5NUNC | Samsung Electro-Mechanics | CAP, CERM, 10 uF, 10 V, +/- 20%, X5R, 0402 | 0402 | Samsung (https://octopart-clicks.com/click/altium?sku=1276-1450-6-ND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) | CL05A106MP5NUNC (https://octopart-clicks.com/click/altium?sku=1276-1450-6-ND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) | Volume Production | Digi-Key | 1276-1450-6-ND (https://octopart-clicks.com/click/altium?sku=1276-1450-6-ND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) | 0.0754 | 22.62 | Digi-Key | 1276-1450-1-ND (https://octopart-clicks.com/click/altium?sku=1276-1450-1-ND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) | 0.0754 | 22.62
 | C38, C39 | Fitted | 2 | 22uF | C2012X5R1V226M125AC | TDK | CAP, CERM, 22 uF, 35 V, +/- 20%, X5R, 0805 | 0805 | TDK (https://octopart-clicks.com/click/altium?sku=445-14428-1-ND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) | C2012X5R1V226M125AC (https://octopart-clicks.com/click/altium?sku=445-14428-1-ND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) | Volume Production | Digi-Key | 445-14428-1-ND (https://octopart-clicks.com/click/altium?sku=445-14428-1-ND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) | 0.5908 | 118.16 | Digi-Key | 445-14428-6-ND (https://octopart-clicks.com/click/altium?sku=445-14428-6-ND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) | 0.5908 | 118.16
 | C40, C43 | Fitted | 2 | 0.1uF | GMK105BJ104KV-F | Taiyo Yuden | CAP, CERM, 0.1 uF, 35 V, +/- 10%, X5R, 0402 | 0402 | Taiyo Yuden (https://octopart-clicks.com/click/altium?sku=587-1994-6-ND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) | GMK105BJ104KV-F (https://octopart-clicks.com/click/altium?sku=587-1994-6-ND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) | Volume Production | Digi-Key | 587-1994-6-ND (https://octopart-clicks.com/click/altium?sku=587-1994-6-ND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) | 0.0526 | 10.52 | Digi-Key | 587-1994-1-ND (https://octopart-clicks.com/click/altium?sku=587-1994-1-ND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) | 0.0526 | 10.52
 | C41, C42 | Fitted | 2 | 330pF | GRM033R71H331KA12D | MuRata | CAP, CERM, 330 pF, 50 V, +/- 10%, X7R, 0201 | 0201 | Murata (https://octopart-clicks.com/click/altium?sku=490-17085-1-ND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) | GRM033R71H331KA12D (https://octopart-clicks.com/click/altium?sku=490-17085-1-ND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) | Volume Production | Digi-Key | 490-17085-1-ND (https://octopart-clicks.com/click/altium?sku=490-17085-1-ND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) | 0.0154 | 3.08 | Digi-Key | 490-17085-6-ND (https://octopart-clicks.com/click/altium?sku=490-17085-6-ND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) | 0.0154 | 3.08
 | C44 | Fitted | 1 | 4.7uF | GRM188R6YA475KE15D | MuRata | CAP, CERM, 4.7 uF, 35 V, +/- 10%, X5R, 0603 | 0603 | Murata (https://octopart-clicks.com/click/altium?sku=490-7205-6-ND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) | GRM188R6YA475KE15D (https://octopart-clicks.com/click/altium?sku=490-7205-6-ND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) | Volume Production | Digi-Key | 490-7205-6-ND (https://octopart-clicks.com/click/altium?sku=490-7205-6-ND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) | 0.2004 | 20.04 | Digi-Key | 490-7205-1-ND (https://octopart-clicks.com/click/altium?sku=490-7205-1-ND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) | 0.2004 | 20.04
 | C45, C46, C47, C48 | Fitted | 4 | 0.01uF | C0402C103J5RACTU | Kemet | CAP, CERM, 0.01 uF, 50 V, +/- 5%, X7R, 0402 | 0402 | KEMET (https://octopart-clicks.com/click/altium?sku=399-7758-1-ND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) | C0402C103J5RACTU (https://octopart-clicks.com/click/altium?sku=399-7758-1-ND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) | Volume Production | Digi-Key | 399-7758-1-ND (https://octopart-clicks.com/click/altium?sku=399-7758-1-ND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) | 0.16688 | 83.44 | Digi-Key | 399-7758-6-ND (https://octopart-clicks.com/click/altium?sku=399-7758-6-ND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) | 0.16688 | 83.44
 | D1 | Fitted | 1 | Green | LTST-C190GKT | Lite-On | LED, Green, SMD | 1.6x0.8x0.8mm | Lite-On | LTST-C190GKT
 | D2 | Fitted | 1 | 40V | CDBC540-G | Comchip Technology | Diode, Schottky, 40 V, 5 A, SMC | SMC | Comchip (https://octopart-clicks.com/click/altium?sku=641-1126-1-ND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) | CDBC540-G (https://octopart-clicks.com/click/altium?sku=641-1126-1-ND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) | Volume Production | Digi-Key | 641-1126-1-ND (https://octopart-clicks.com/click/altium?sku=641-1126-1-ND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) | 0.396 | 39.6 | Digi-Key | 641-1126-6-ND (https://octopart-clicks.com/click/altium?sku=641-1126-6-ND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) | 0.396 | 39.6
 | J1, J2 | Fitted | 2 |  | ED120/2DS | On-Shore Technology | Terminal Block, 5.08 mm, 2x1, Brass, TH | 2x1 5.08 mm Terminal Block |  |  |  | Digi-Key | ED1609-ND
 | J3 | Fitted | 1 |  | N2510-6002-RB | 3M | Header (shrouded), 100mil, 5x2, High-Temperature, Gold, TH | 5x2 Shrouded header | 3M (https://octopart-clicks.com/click/altium?sku=MHC10K-ND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) | N2510-6002-RB (https://octopart-clicks.com/click/altium?sku=MHC10K-ND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) |  | Digi-Key | MHC10K-ND (https://octopart-clicks.com/click/altium?sku=MHC10K-ND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) |  |  | Newark | 18M6808
 | J4 | Fitted | 1 |  | 0393570002 | Molex | Terminal Block, 3.5 mm, 2x1, Tin, TH | Terminal Block, 3.5 mm, 2x1, TH |  |  |  | Digi-Key | WM7877-ND |  |  | Newark | 72K2104
 | J5 | Fitted | 1 |  | TSM-105-01-L-DV-P | Samtec | Header, 2.54mm, 5x2, Gold, SMT | Header, 2.54mm, 5x2, SMT | Samtec (https://octopart-clicks.com/click/altium?sku=SAM8741-ND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) | TSM-105-01-L-DV-P (https://octopart-clicks.com/click/altium?sku=SAM8741-ND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) | Volume Production | Digi-Key | SAM8741-ND (https://octopart-clicks.com/click/altium?sku=SAM8741-ND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) | 1.24 | 124.32 | Newark | 77P7037 (https://octopart-clicks.com/click/altium?sku=77P7037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) | 0.697 | 69.7
 | J6 | Fitted | 1 |  | DX07S024JJ2R1300 | JAE Electronics | Receptacle, USB 3.1 Type C, R/A, Gold, SMT | Receptacle, USB 3.1 Type C, R/A, SMT | JAE Electronics (https://octopart-clicks.com/click/altium?sku=670-2794-1-ND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) | DX07S024JJ2R1300 (https://octopart-clicks.com/click/altium?sku=670-2794-1-ND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) | Volume Production | Digi-Key | 670-2794-1-ND (https://octopart-clicks.com/click/altium?sku=670-2794-1-ND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) | 2.03 | 203.28 | Digi-Key | 670-2794-6-ND (https://octopart-clicks.com/click/altium?sku=670-2794-6-ND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) | 2.03 | 203.28
 | J7 | Fitted | 1 |  | PEC04SAAN | Sullins Connector Solutions | Header, 100mil, 4x1, Tin, TH | Header, 4x1, 100mil, TH |  |  |  | Digi-Key | S1012E-04-ND
 | JP1, JP2, JP3, JP4 | Fitted | 4 |  | PEC02SAAN | Sullins Connector Solutions | Header, 100mil, 2x1, Tin, TH | Header, 2 PIN, 100mil, Tin |  |  |  | Digi-Key | S1012E-02-ND
 | L1 | Fitted | 1 | 1uH | IHLP2020BZER1R0M11 | Vishay-Dale | Inductor, Shielded Drum Core, Powdered Iron, 1 uH, 7 A, 0.0181 ohm, SMD | 5.49x2x5.18mm |  |  |  | Digi-Key | 541-1218-1-ND
 | L2 | Fitted | 1 | 4.7uH | 74437368047 | Wurth Elektronik | Inductor, Shielded Drum Core, Powdered Iron, 4.7 uH, 7 A, 0.015 ohm, SMD | 10x3.8x10mm |  |  |  | Digi-Key | 732-3389-1-ND |  |  | Newark | 82T3283
 | L3 | Fitted | 1 | 21 ohm | FBMJ2125HM210NT | Taiyo Yuden | Ferrite Bead, 21 ohm @ 100 MHz, 6 A, 0805 | 0805 |  |  |  | Digi-Key | 587-1765-1-ND
 | R1 | Fitted | 1 | 100 | RC0603FR-07100RL | Yageo | RES, 100, 1%, 0.1 W, 0603 | 0603 | Yageo (https://octopart-clicks.com/click/altium?sku=311-100HRCT-ND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) | RC0603FR-07100RL (https://octopart-clicks.com/click/altium?sku=311-100HRCT-ND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) | Volume Production | Digi-Key | 311-100HRCT-ND (https://octopart-clicks.com/click/altium?sku=311-100HRCT-ND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) | 0.009 | 0.9 | Digi-Key | 311-100HRDKR-ND (https://octopart-clicks.com/click/altium?sku=311-100HRDKR-ND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) | 0.009 | 0.9
 | R2 | Fitted | 1 | 2.21k | CRCW04022K21FKED | Vishay-Dale | RES, 2.21 k, 1%, 0.063 W, AEC-Q200 Grade 0, 0402 | 0402 |  |  |  | Digi-Key | 541-2.21KLCT-ND |  |  | Newark | 52K6795
 | R3 | Fitted | 1 | 5.23k | CRCW04025K23FKED | Vishay-Dale | RES, 5.23 k, 1%, 0.063 W, AEC-Q200 Grade 0, 0402 | 0402 |  |  |  | Digi-Key | 541-5.23KLCT-ND |  |  | Newark | 52K7121
 | R4 | Fitted | 1 | 137k | RC0603FR-07137KL | Yageo | RES, 137 k, 1%, 0.1 W, 0603 | 0603 | Yageo (https://octopart-clicks.com/click/altium?sku=311-137KHRCT-ND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) | RC0603FR-07137KL (https://octopart-clicks.com/click/altium?sku=311-137KHRCT-ND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) | Volume Production | Digi-Key | 311-137KHRCT-ND (https://octopart-clicks.com/click/altium?sku=311-137KHRCT-ND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) | 0.009 | 0.9 | Digi-Key | 311-137KHRDKR-ND (https://octopart-clicks.com/click/altium?sku=311-137KHRDKR-ND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) | 0.009 | 0.9
 | R5 | Fitted | 1 | 30.1k | CRCW040230K1FKED | Vishay-Dale | RES, 30.1 k, 1%, 0.063 W, AEC-Q200 Grade 0, 0402 | 0402 |  |  |  | Digi-Key | 541-30.1KLCT-ND |  |  | Newark | 52K6954
 | R6 | Fitted | 1 | 100k | RC0603FR-07100KL | Yageo | RES, 100 k, 1%, 0.1 W, 0603 | 0603 | Yageo (https://octopart-clicks.com/click/altium?sku=311-100KHRDKR-ND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) | RC0603FR-07100KL (https://octopart-clicks.com/click/altium?sku=311-100KHRDKR-ND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) | Volume Production | Digi-Key | 311-100KHRDKR-ND (https://octopart-clicks.com/click/altium?sku=311-100KHRDKR-ND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) | 0.009 | 0.9 | Digi-Key | 311-100KHRCT-ND (https://octopart-clicks.com/click/altium?sku=311-100KHRCT-ND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) | 0.009 | 0.9
 | R7 | Fitted | 1 | 10.0k | CRCW040210K0FKED | Vishay-Dale | RES, 10.0 k, 1%, 0.063 W, AEC-Q200 Grade 0, 0402 | 0402 | Vishay / Dale (https://octopart-clicks.com/click/altium?manufacturer=Vishay%20%2F%20Dale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) | CRCW040210K0FKED (https://octopart-clicks.com/click/altium?manufacturer=Vishay%20%2F%20Dale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) |  | Digi-Key | 541-10.0KLCT-ND (https://octopart-clicks.com/click/altium?manufacturer=Vishay%20%2F%20Dale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) |  |  | Newark | 52K6595
 | R8 | Fitted | 1 | 6.04k | RC0603FR-076K04L | Yageo | RES, 6.04 k, 1%, 0.1 W, 0603 | 0603 | Yageo (https://octopart-clicks.com/click/altium?sku=311-6.04KHRCT-ND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) | RC0603FR-076K04L (https://octopart-clicks.com/click/altium?sku=311-6.04KHRCT-ND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) | Volume Production | Digi-Key | 311-6.04KHRCT-ND (https://octopart-clicks.com/click/altium?sku=311-6.04KHRCT-ND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) | 0.009 | 0.9 | Digi-Key | 311-6.04KHRDKR-ND (https://octopart-clicks.com/click/altium?sku=311-6.04KHRDKR-ND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) | 0.009 | 0.9
 | R9 | Fitted | 1 | 10.5k | CRCW060310K5FKEA | Vishay-Dale | RES, 10.5 k, 1%, 0.1 W, AEC-Q200 Grade 0, 0603 | 0603 | Vishay/Dale (https://octopart-clicks.com/click/altium?sku=541-10.5KHCT-ND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) | CRCW060310K5FKEA (https://octopart-clicks.com/click/altium?sku=541-10.5KHCT-ND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) |  | Digi-Key | 541-10.5KHCT-ND (https://octopart-clicks.com/click/altium?sku=541-10.5KHCT-ND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) |  |  | Newark | 52K8068
 | R10 | Fitted | 1 | 17.4k | CRCW060317K4FKEA | Vishay-Dale | RES, 17.4 k, 1%, 0.1 W, AEC-Q200 Grade 0, 0603 | 0603 | Vishay/Dale (https://octopart-clicks.com/click/altium?sku=541-17.4KHCT-ND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) | CRCW060317K4FKEA (https://octopart-clicks.com/click/altium?sku=541-17.4KHCT-ND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) |  | Digi-Key | 541-17.4KHCT-ND (https://octopart-clicks.com/click/altium?sku=541-17.4KHCT-ND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) |  |  | Newark | 52K8186
 | R11 | Fitted | 1 | 10.0 | ERJ-8ENF10R0V | Panasonic | RES, 10.0, 1%, 0.25 W, AEC-Q200 Grade 0, 1206 | 1206 | Panasonic (https://octopart-clicks.com/click/altium?sku=P10.0FCT-ND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) | ERJ8ENF10R0V (https://octopart-clicks.com/click/altium?sku=P10.0FCT-ND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) | Volume Production | Digi-Key | P10.0FCT-ND (https://octopart-clicks.com/click/altium?sku=P10.0FCT-ND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) | 0.0329 | 3.29 | Digi-Key | P10.0FDKR-ND (https://octopart-clicks.com/click/altium?sku=P10.0FDKR-ND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) | 0.0329 | 3.29
 | R12 | Fitted | 1 | 51.1 | CRCW060351R1FKEA | Vishay-Dale | RES, 51.1, 1%, 0.1 W, AEC-Q200 Grade 0, 0603 | 0603 | Vishay / Dale (https://octopart-clicks.com/click/altium?manufacturer=Vishay%20%2F%20Dale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) | CRCW060351R1FKEA (https://octopart-clicks.com/click/altium?manufacturer=Vishay%20%2F%20Dale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) |  | Digi-Key | 541-51.1HCT-ND (https://octopart-clicks.com/click/altium?manufacturer=Vishay%20%2F%20Dale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) |  |  | Newark | 52K8594
 | R13 | Fitted | 1 | 665k | CRCW0603665KFKEA | Vishay-Dale | RES, 665 k, 1%, 0.1 W, AEC-Q200 Grade 0, 0603 | 0603 | Vishay/Dale (https://octopart-clicks.com/click/altium?sku=541-665KHCT-ND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) | CRCW0603665KFKEA (https://octopart-clicks.com/click/altium?sku=541-665KHCT-ND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) |  | Digi-Key | 541-665KHCT-ND (https://octopart-clicks.com/click/altium?sku=541-665KHCT-ND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) |  |  | Mouser | 71-CRCW0603-665K-E3
 | R14 | Fitted | 1 | 10.2k | CRCW060310K2FKEA | Vishay-Dale | RES, 10.2 k, 1%, 0.1 W, AEC-Q200 Grade 0, 0603 | 0603 | Vishay/Dale (https://octopart-clicks.com/click/altium?sku=541-10.2KHCT-ND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) | CRCW060310K2FKEA (https://octopart-clicks.com/click/altium?sku=541-10.2KHCT-ND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) |  | Digi-Key | 541-10.2KHCT-ND (https://octopart-clicks.com/click/altium?sku=541-10.2KHCT-ND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) |  |  | Newark | 52K8067
 | R15 | Fitted | 1 | 130k | CRCW0603130KFKEA | Vishay-Dale | RES, 130 k, 1%, 0.1 W, AEC-Q200 Grade 0, 0603 | 0603 | Vishay/Dale (https://octopart-clicks.com/click/altium?sku=541-130KHCT-ND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) | CRCW0603130KFKEA (https://octopart-clicks.com/click/altium?sku=541-130KHCT-ND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) |  | Digi-Key | 541-130KHCT-ND (https://octopart-clicks.com/click/altium?sku=541-130KHCT-ND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) |  |  | Newark | 52K8127
 | R16 | Fitted | 1 | 1.96k | CRCW06031K96FKEA | Vishay-Dale | RES, 1.96 k, 1%, 0.1 W, AEC-Q200 Grade 0, 0603 | 0603 | Vishay / Dale (https://octopart-clicks.com/click/altium?manufacturer=Vishay%20%2F%20Dale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) | CRCW06031K96FKEA (https://octopart-clicks.com/click/altium?manufacturer=Vishay%20%2F%20Dale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) |  | Digi-Key | 541-1.96KHCT-ND (https://octopart-clicks.com/click/altium?manufacturer=Vishay%20%2F%20Dale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) |  |  | Newark | 52K8051
 | R17 | Fitted | 1 | 37.4k | CRCW060337K4FKEA | Vishay-Dale | RES, 37.4 k, 1%, 0.1 W, AEC-Q200 Grade 0, 0603 | 0603 | Vishay/Dale (https://octopart-clicks.com/click/altium?sku=541-37.4KHCT-ND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) | CRCW060337K4FKEA (https://octopart-clicks.com/click/altium?sku=541-37.4KHCT-ND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) |  | Digi-Key | 541-37.4KHCT-ND (https://octopart-clicks.com/click/altium?sku=541-37.4KHCT-ND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) |  |  | Newark | 52K8462
 | R21, R22, R24, R25 | Fitted | 4 | 2.20k | CRCW02012K20FKED | Vishay-Dale | RES, 2.20 k, 1%, 0.05 W, 0201 | 0201 | Vishay/Dale (https://octopart-clicks.com/click/altium?sku=541-2.20KAABCT-ND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) | CRCW02012K20FKED (https://octopart-clicks.com/click/altium?sku=541-2.20KAABCT-ND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) |  | Digi-Key | 541-2.20KAABCT-ND (https://octopart-clicks.com/click/altium?sku=541-2.20KAABCT-ND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) |  |  | Newark | 01X1849
 | R23, R28, R30, R31, R32 | Fitted | 5 | 10.0k | CRCW020110K0FKED | Vishay-Dale | RES, 10.0 k, 1%, 0.05 W, 0201 | 0201 | Vishay/Dale (https://octopart-clicks.com/click/altium?sku=541-10.0KAABCT-ND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) | CRCW020110K0FKED (https://octopart-clicks.com/click/altium?sku=541-10.0KAABCT-ND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) |  | Digi-Key | 541-10.0KAABCT-ND (https://octopart-clicks.com/click/altium?sku=541-10.0KAABCT-ND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) |  |  | Newark | 71R4422
 | R26, R27, R29 | Fitted | 3 | 0 | CRCW02010000Z0ED | Vishay-Dale | RES, 0, 5%, 0.05 W, 0201 | 0201 | Vishay / Dale (https://octopart-clicks.com/click/altium?sku=72M6743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) | CRCW02010000Z0ED (https://octopart-clicks.com/click/altium?sku=72M6743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) |  | Newark | 72M6743 (https://octopart-clicks.com/click/altium?sku=72M6743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)
 | TP1 | Fitted | 1 |  | 5000 | Keystone | Test Point, Miniature, Red, TH | Red Miniature Testpoint | Keystone Electronics (https://octopart-clicks.com/click/altium?sku=36-5000-ND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) | 5000 (https://octopart-clicks.com/click/altium?sku=36-5000-ND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) | Volume Production | Digi-Key | 36-5000-ND (https://octopart-clicks.com/click/altium?sku=36-5000-ND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) | 0.3015 | 30.15 | Newark | 07J9695 (https://octopart-clicks.com/click/altium?sku=07J9695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) | 0.23 | 23
 | TP2, TP3 | Fitted | 2 |  | 5016 | Keystone | Test Point, Compact, SMT | Testpoint_Keystone_Compact | Keystone Electronics (https://octopart-clicks.com/click/altium?sku=36-5016CT-ND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) | 5016 (https://octopart-clicks.com/click/altium?sku=36-5016CT-ND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) | Volume Production | Digi-Key | 36-5016CT-ND (https://octopart-clicks.com/click/altium?sku=36-5016CT-ND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) | 0.2897 | 57.94 | Digi-Key | 36-5016DKR-ND (https://octopart-clicks.com/click/altium?sku=36-5016DKR-ND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) | 0.2897 | 57.94
 | U1 | Fitted | 1 |  | BQ25792RQM | Texas Instruments | BQ2579x HotRod | VQFN-HR29 | Texas Instruments | BQ25792RQM
 | U2 | Fitted | 1 |  | TLV75533PDBVR | Texas Instruments | 500-mA, Low IQ, Small Size, Low Dropout Regulator, DBV0005A (SOT-23-5) | DBV0005A
 | U3 | Fitted | 1 |  | TPS54531DDAR | Texas Instruments | 3.5V to 28V Input, 5A, 570kHz Step-Down Converter with Eco-mode, DDA0008E (SOIC-8) | DDA0008E
 | U4 | Fitted | 1 |  | TPS25750DRJK | Texas Instruments | USB Type-C and USB PD Controller with Integrated Power Switches Optimized for Power Applications | VQFN32 | Texas Instruments | TPS25750DRJK
 | U5 | Fitted | 1 |  | CAT24C256WI-G | ON Semiconductor | 256 kb I2C CMOS Serial EEPROM, SOIC-8 | SOIC-8 | ON Semiconductor (https://octopart-clicks.com/click/altium?sku=06R0552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) | CAT24C256WI-G (https://octopart-clicks.com/click/altium?sku=06R0552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) | Volume Production | Newark | 06R0552 (https://octopart-clicks.com/click/altium?sku=06R0552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) | 0.662 | 66.2 | Mouser | 698-CAT24C256WI-G (https://octopart-clicks.com/click/altium?sku=698-CAT24C256WI-G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) | 0.662 | 66.2
 | U6 | Fitted | 1 |  | TVS2200DRVR | Texas Instruments | 22-V Precision Surge Protection Clamp, DRV0006A (WSON-6) | DRV0006A
