Tangineering/DC-Balancer-Board-Teensy/docs/operations/checklists/FCHEV_NextSteps_Plan_2026-04-16A.xlsx

Sheet: Master Plan
FCHEV Scaled Car — What's Done & What's Next | Rev 2026-04-16A
Pi 5 + Ubuntu 24.04 + ROS2 Jazzy | Waiting for: Teensy 4.1 + Windows 11 Laptop
COMPLETED ✓ — Everything done on Pi today
Phase | What was done | Status | Notes
Phase 1 | Pi OS flash (Ubuntu 24.04 Server), SSH setup, timezone | ✓ Done | Username: pi5 Hostname: kuro
Phase 2 | Static IP 192.168.1.100 on eth0 via nmcli | ✓ Done | Activates when Ethernet cable plugged in
Phase 3 | Python + scipy/numpy, project folders created, all code files scp'd | ✓ Done | ~/fchev/ folder structure complete
Phase 4 | Simple EMS script confirmed starts and stops cleanly | ✓ Partial | Full test needs Teensy hardware
Phase 5 | ROS2 Jazzy base installed on Pi, ROS_DOMAIN_ID=42 | ✓ Done | source /opt/ros/jazzy/setup.bash in .bashrc
Phase 6 | fchev_ems ROS2 package built, all 4 nodes registered | ✓ Done | sdp, simple, teensy_bridge, drive_cycle
Phase 7 | WSL2 + Ubuntu installed on Windows 10 laptop | ⏸ Partial | ROS2 installed but multi-machine blocked by WSL2 networking
Phase 8 | Multi-machine Pi + Laptop same ROS2 graph | ⏸ Blocked | Needs Windows 11 laptop — WSL2 mirrored networking required
NEXT STEPS — In order of priority
Priority | Task | Needs | Est. Time | Phase | Notes
1 — NOW | Order Teensy 4.1 + W5500 Ethernet module | Amazon/PJRC | — | Hardware | pjrc.com/teensy41 — get W5500 shield or breakout
2 — NOW | Get Windows 11 laptop | Any Win11 PC | — | Hardware | Needed for WSL2 mirrored networking + rqt GUI
3 — NOW | Write Teensy firmware (.ino file) | Arduino IDE | 2-3 hrs | Phase 4 | 54-byte UDP packet, static IP 192.168.1.50
4 — NEXT | Install WSL2 + ROS2 on Windows 11 laptop | Win11 laptop | 30 min | Phase 7 | One command: wsl --install. WSLg handles GUI automatically.
5 — NEXT | Multi-machine test: Pi topics on laptop | Win11 + Pi on WiFi | 20 min | Phase 8 | ros2 topic list on laptop should show /vehicle_state etc.
6 — NEXT | Flash Teensy, connect to Pi via Ethernet | Teensy + cable | 30 min | Phase 4 | ping 192.168.1.50 from Pi confirms connection
7 — NEXT | Run simple EMS bring-up test with real Teensy | Teensy connected | 30 min | Phase 4 | python3 simple_ems_test_2026-03-16A.py
8 — NEXT | Test ROS2 nodes individually + full launch file | Teensy + Win11 | 30 min | Phase 9 | ros2 launch fchev_ems fchev_launch.py ems:=simple
9 — NEXT | rosbag2 recording + rqt live dashboard setup | Teensy + Win11 | 20 min | Phase 10 | 5 rqt plot panels: speed, power, SOC, voltages, EMS perf
10 — LATER | Hardware bring-up: connect FC + battery | Full hardware rig | 30 min | Phase 11 | Safety critical — read all red rows in checklist first
11 — LATER | Post-run analysis: bag → CSV → MATLAB | rosbag2 recording | 20 min | Phase 12 | pip install rosbags on laptop, run data_analysis.py
12 — LATER | Write Fuzzy EMS ROS2 node | MATLAB fuzzy logic | 1-2 days | Future | Same interface as sdp_ems_node, swap with ems:=fuzzy
13 — LATER | Write SMPC EMS ROS2 node | SMPC solver | 1-2 wks | Future | Most complex — needs prediction model + optimizer
14 — LATER | Dissertation comparison runs | All hardware working | — | Future | SDP vs Simple vs Fuzzy vs SMPC on same drive cycle

Sheet: Teensy Firmware Plan
Teensy 4.1 Firmware Plan — What to Write and How
The Teensy firmware is the last major piece of code needed before hardware bring-up
HARDWARE NEEDED
Item | Part | Where to buy | Approx Cost | Notes
1 | Teensy 4.1 | pjrc.com or Amazon | $30 | Get with pins soldered if possible
2 | W5500 Ethernet module | Amazon | $10 | WIZnet W5500 breakout board — NOT W5100
3 | Ethernet cable | Any | $5 | Short patch cable, direct Pi eth0 to W5500
4 | Jumper wires | Amazon/Adafruit | $5 | Female-female, 6 needed for W5500 wiring
5 | USB micro cable | Any | $5 | For flashing Teensy from laptop
W5500 WIRING TO TEENSY 4.1
W5500 Pin | Teensy 4.1 Pin | Wire Color (suggest) | Notes
MOSI | Pin 11 | Yellow | SPI data out
MISO | Pin 12 | Green | SPI data in — most common swap mistake
SCK | Pin 13 | Orange | SPI clock
CS/SS | Pin 10 | Blue | Chip select — active LOW
3.3V | 3.3V | Red | Do NOT use 5V — W5500 is 3.3V
GND | GND | Black | Any GND pin on Teensy
FIRMWARE STRUCTURE — What the .ino file must do
Section | What it does | Key variables / functions
Network config | Set static IP, MAC, Pi IP address | byte ip[]={192,168,1,50} byte pi_ip[]={192,168,1,100} byte mac[]={0xDE,0xAD,0xBE,0xEF,0xFE,0xED}
setup() | Init Ethernet, open UDP socket, init ADCs | Ethernet.begin(mac,ip) Udp.begin(5001) // listen for Pi commands Serial.begin(115200)
Read sensors (loop) | Read ADC pins, convert to physical units using calibration constants | V_batt = analogRead(A0) * SCALE_VBATT I_fc = analogRead(A1) * SCALE_IFC V_fc = analogRead(A2) * SCALE_VFC V_bus = analogRead(A3) * SCALE_VBUS
Build TX packet | Pack all sensor readings into 54-byte struct, compute XOR checksum | struct.header = 0xAA struct.V_batt = V_batt // float32 // ... all 10 float fields struct.checksum = xor(bytes 1-52)
Send to Pi (50Hz) | Send 54-byte UDP packet to Pi port 5000 | Udp.beginPacket(pi_ip, 5000) Udp.write(tx_buf, 54) Udp.endPacket()
Receive from Pi | Check for 22-byte command packet from Pi, validate checksum | if(Udp.parsePacket()){ Udp.read(rx_buf, 22) if(rx_buf[0]==0xBB && checksum_ok) parse_command()
Apply commands | Set droop MDACs, motor speed, charger enable based on Pi command | power_share = rx.power_share mode = rx.mode_cmd set_droop_mdac(power_share) set_motor_speed(rx.v_setpoint)
Safety watchdog | If no Pi packet for >500ms, enter SAFE mode | if(millis()-last_rx_ms > 500) enter_safe_mode() // stop motor, disable FC
Fault detection | Check overcurrent, undervoltage, overvoltage every loop | if(I_fc > 3.5) fault |= FAULT_OC_FC if(V_batt < 6.2) fault |= FAULT_UV_BATT if(V_bus > 18.5) fault |= FAULT_OV_BUS
Calibration constants | ADC raw counts to physical units — MUST measure for your resistor dividers | #define SCALE_VBATT (8.4/1023.0 * ADC_REF) // Measure actual R1/R2 values with multimeter // Then calculate: SCALE = Vmax / 1023.0

Sheet: Windows 11 Laptop Plan
Windows 11 Laptop Setup — Phase 7 & 8 (Will Take ~1 Hour Total)
Everything that was painful on Windows 10 is automatic on Windows 11
WHAT WINDOWS 11 FIXES AUTOMATICALLY
Problem on Win10 | How Win11 fixes it
rqt GUI needs VcXsrv + DISPLAY config | WSLg built-in — Linux GUI apps open on Windows desktop automatically
WSL2 on 172.23.x.x subnet, Pi on 192.168.x.x | Mirrored networking — WSL2 gets same IP as Windows (192.168.1.59)
ROS2 DDS discovery blocked across subnets | Same subnet = DDS multicast works, no CycloneDDS config needed
X11 forwarding through WSL2 broken | Not needed — WSLg handles everything
Port proxy rules needed for communication | Not needed — direct communication on same subnet
STEP BY STEP — Windows 11 Setup (Phase 7 + 8)
✓ | Step | Command / Action | Expected Result | Time
☐ | 7.1 | Open PowerShell as Admin: wsl --install -d Ubuntu-24.04 | Ubuntu 24.04 downloads and installs Restart when prompted | 10 min
☐ | 7.2 | After restart — Ubuntu opens automatically Set username and password | yourname@laptop:~$ prompt | 2 min
☐ | 7.3 | In Ubuntu: sudo apt update && sudo apt upgrade -y | All packages updated | 5 min
☐ | 7.4 | sudo curl -sSL https://raw.githubusercontent.com/ros/rosdistro/master/ros.key -o /usr/share/keyrings/ros-archive-keyring.gpg echo "deb [arch=$(dpkg --print-architecture) signed-by=/usr/share/keyrings/ros-archive-keyring.gpg] http://packages.ros.org/ros2/ubuntu $(. /etc/os-release && echo $UBUNTU_CODENAME) main" | sudo tee /etc/apt/sources.list.d/ros2.list > /dev/null | ros2.list created | 2 min
☐ | 7.5 | sudo apt update sudo apt install ros-jazzy-desktop -y | ROS2 Jazzy desktop installed (~2GB) | 20 min
☐ | 7.6 | echo 'source /opt/ros/jazzy/setup.bash' >> ~/.bashrc echo 'export ROS_DOMAIN_ID=42' >> ~/.bashrc source ~/.bashrc | ros2 topic list works echo $ROS_DOMAIN_ID shows 42 | 1 min
☐ | 7.7 | rqt | rqt GUI opens on Windows desktop automatically (no VcXsrv needed!) | 1 min
☐ | 8.1 | On Pi SSH: ros2 run demo_nodes_py talker On laptop WSL2: ros2 topic list | /chatter visible on laptop! (KEY MILESTONE — multi-machine working) | 5 min
☐ | 8.2 | On laptop WSL2: ros2 topic echo /chatter | Hello World messages streaming from Pi | 1 min
☐ | 8.3 | Stop talker on Pi (Ctrl+C) Launch full system on Pi: ros2 launch fchev_ems fchev_launch.py ems:=simple | All nodes start on Pi /vehicle_state /ems_command visible on laptop | 2 min
☐ | 8.4 | On laptop WSL2 — open rqt and add plots: Plugins → Visualization → Plot Add: /ems_diagnostics/data[0] (P_fc) Add: /vehicle_state/data[14] (SOC) | Live scrolling plots of Pi EMS data on your Windows 11 screen | 5 min
☐ | 8.5 | On laptop WSL2 — tune alpha live: ros2 param set /sdp_ems_node alpha 5000.0 | Parameter changes on Pi immediately No restart needed | 1 min

Sheet: Pi File Structure
Current Pi File Structure — What's on the Pi Right Now
Path on Pi | File / Folder | Status | Purpose
~/fchev/EMS/Simple_1/ | simple_ems_test_2026-03-16A.py | ✓ Ready | Standalone UDP simple EMS — Phase 4 test
~/fchev/EMS/SDP/ | sdp_ems_standalone_2026-03-16A.py | ✓ Ready | Standalone UDP SDP — no ROS2 needed
~/fchev/EMS/SDP/ | CostToGo_J_scaled_2026-03-16A.mat | ✓ Ready | Precomputed SDP cost-to-go matrix
~/fchev/EMS/SMPC/ | (empty) | ⬜ Future | SMPC algorithm files go here
~/fchev/EMS/Fuzzy/ | (empty) | ⬜ Future | Fuzzy logic files go here
~/fchev/EMS/Simple_2/ | (empty) | ⬜ Future | Second simple EMS variant
~/fchev/ROS2/ | teensy_bridge_node_2026-03-16A.py | ✓ Ready | UDP ↔ ROS2 bridge
~/fchev/ROS2/ | drive_cycle_node_2026-03-16A.py | ✓ Ready | Drive cycle CSV publisher
~/fchev/ROS2/ | sdp_ems_node_2026-03-16A.py | ✓ Ready | SDP ROS2 node
~/fchev/ROS2/ | simple_ems_node_2026-04-06A.py | ✓ Ready | Simple EMS ROS2 node
~/fchev/ROS2/ | fchev_launch_2026-03-16A.py | ✓ Ready | Full system launch file
~/fchev/logs/ | (empty — fills during runs) | ✓ Ready | rosbag2 recordings + CSV logs
~/fchev/drive_cycles/ | (empty) | ⬜ Needed | Add UDDS.csv and other drive cycles here
~/ros2_ws/src/fchev_ems/fchev_ems/ | teensy_bridge_node.py | ✓ Built | In ROS2 package — ros2 run works
~/ros2_ws/src/fchev_ems/fchev_ems/ | sdp_ems_node.py | ✓ Built | In ROS2 package
~/ros2_ws/src/fchev_ems/fchev_ems/ | simple_ems_node.py | ✓ Built | In ROS2 package
~/ros2_ws/src/fchev_ems/fchev_ems/ | drive_cycle_node.py | ✓ Built | In ROS2 package
~/ros2_ws/src/fchev_ems/launch/ | fchev_launch.py | ✓ Built | In ROS2 package
⚠ IMPORTANT: Add a drive cycle CSV to ~/fchev/drive_cycles/ before running Phase 9. Format: two columns — time_s, v_mps
