Tangineering/DC-Balancer-Board-Teensy/docs/operations/checklists/FCHEV_SSH_ROS2_Plan_2026-04-06A.xlsx

Sheet: Architecture Overview
FCHEV Scaled Car — SSH + ROS2 Data Architecture Plan | Rev 2026-04-06A
Pi 5 runs EMS + ROS2 nodes | Laptop connects via SSH + ROS2 over WiFi/Ethernet | All data logged via rosbag2 on Pi, viewed live on laptop via rqt
ARCHITECTURE DECISION: Where does ROS2 run?
Option | ROS2 Location | EMS Location | Laptop Role | Pros | Cons | Latency Risk
A | Pi only | Pi only | SSH terminal + rqt over network | Simple setup. No ROS2 install on laptop. Pi fully autonomous. | Pi CPU does everything. If Pi overloads, EMS suffers. | Low
B | Pi + Laptop (same ROS_DOMAIN_ID) | Pi only | Full ROS2 node — rqt, rosbag2, topic echo, param set | Best monitoring. Swap EMS params live from laptop. Rich tooling. | ROS2 must be installed on laptop. More setup. | Low (UDP)
C | Laptop only | Laptop only | Runs EMS. Sends commands to Pi bridge node. | More compute for EMS (SMPC). Laptop does heavy lifting. | Network latency in EMS loop. Pi becomes dumb bridge. | Medium
WHAT THIS MEANS FOR YOUR SETUP (Option A → then B)
Layer | Device | What runs there | Connection to next layer | Notes
1 | Teensy 4.1 | Firmware: sensors, actuators, UDP packets (54 bytes @ 50Hz) | Ethernet UDP → Pi port 5000 | Already written. Unchanged.
2 | Raspberry Pi 5 | teensy_bridge_node → /vehicle_state @ 50Hz drive_cycle_node → /drive_cycle @ 20Hz sdp_ems_node → /ems_command @ 20Hz rosbag2 record → all topics saved to disk | WiFi or direct Ethernet → Laptop Same ROS_DOMAIN_ID=42 | Pi is master. All EMS + logging here.
3 | Laptop (Windows) | SSH terminal for Pi control rqt for live plots rosbag2 play for data replay Matlab/Python for post-analysis | SSH (port 22) ROS2 UDP (port 7400+) | ROS2 on laptop = Option B SSH only = Option A
DATA FLOW: What gets logged and where you see it
Signal / Topic | Source Node | Rate (Hz) | Stored on Pi rosbag2 | Live on Laptop rqt | Post-analysis | Units
/vehicle_state[0] v_actual | teensy_bridge | 50 | ✓ | ✓ Plot | ✓ CSV export | m/s
/vehicle_state[1] V_batt | teensy_bridge | 50 | ✓ | ✓ Plot | ✓ CSV export | V
/vehicle_state[2] I_batt | teensy_bridge | 50 | ✓ | ✓ Plot | ✓ CSV export | A
/vehicle_state[3] I_charge | teensy_bridge | 50 | ✓ | ✓ Plot | ✓ CSV export | A
/vehicle_state[4] V_fc | teensy_bridge | 50 | ✓ | ✓ Plot | ✓ CSV export | V
/vehicle_state[5] I_fc | teensy_bridge | 50 | ✓ | ✓ Plot | ✓ CSV export | A
/vehicle_state[6] V_bus | teensy_bridge | 50 | ✓ | ✓ Plot | ✓ CSV export | V
/vehicle_state[7] P_motor | teensy_bridge | 50 | ✓ | ✓ Plot | ✓ CSV export | W
/vehicle_state[8] share_echo | teensy_bridge | 20 | ✓ | ✓ Plot | ✓ CSV export | 0–1
/vehicle_state[9] share_actual | teensy_bridge | 50 | ✓ | ✓ Plot | ✓ CSV export | 0–1
/vehicle_state[10] droop_FC | teensy_bridge | 20 | ✓ | Optional | ✓ CSV export | counts
/vehicle_state[11] droop_BT | teensy_bridge | 20 | ✓ | Optional | ✓ CSV export | counts
/vehicle_state[12] charger_status | teensy_bridge | 10 | ✓ | Optional | ✓ CSV export | enum
/vehicle_state[13] fault_flags | teensy_bridge | 20 | ✓ | ✓ Alert | ✓ CSV export | bits
/vehicle_state[14] SOC | teensy_bridge | 20 | ✓ | ✓ Plot | ✓ CSV export | 0–1
/drive_cycle[0] v_ref | drive_cycle_node | 20 | ✓ | ✓ Plot | ✓ CSV export | m/s
/drive_cycle[1] P_demand | drive_cycle_node | 20 | ✓ | ✓ Plot | ✓ CSV export | W
/drive_cycle[2] elapsed_s | drive_cycle_node | 20 | ✓ | Optional | ✓ CSV export | s
/ems_command[0] v_setpoint | sdp_ems_node | 20 | ✓ | ✓ Plot | ✓ CSV export | m/s
/ems_command[1] power_share | sdp_ems_node | 20 | ✓ | ✓ Plot | ✓ CSV export | 0–1
/ems_command[3] mode | sdp_ems_node | 20 | ✓ | ✓ Plot | ✓ CSV export | enum
/ems_diagnostics[0] P_fc | sdp_ems_node | 20 | ✓ | ✓ Plot | ✓ CSV export | W
/ems_diagnostics[1] P_batt | sdp_ems_node | 20 | ✓ | ✓ Plot | ✓ CSV export | W
/ems_diagnostics[5] solve_ms | sdp_ems_node | 20 | ✓ | ✓ Plot | ✓ CSV export | ms
/comms_status[0] pkts_rx | teensy_bridge | 1 | ✓ | Optional | ✓ CSV export | count
/comms_status[1] pkts_dropped | teensy_bridge | 1 | ✓ | ✓ Alert | ✓ CSV export | count
/comms_status[3] link_ok | teensy_bridge | 1 | ✓ | ✓ Alert | ✓ CSV export | 0/1
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
