Tangineering/DC-Balancer-Board-Teensy/references/PCB Manufacturing Files/Scale Car Board BOM.txt

Partlist exported from Fusion Hub: Tangineering   Project: Future Mobility Lab  Board: Scale Car Board at 6/9/2026 4:01 PM

Qty Value                           Device                             Package              Parts                                                                              Description                                                           AVAILABILITY CATEGORY  CATEGORY_L1 CATEGORY_L2 CHECK_PRICES                                                       COPYRIGHT                                                DATASHEET                                                                                DESCRIPTION                                                                                                                                                               HEIGHT                           MANUFACTURER       MANUFACTURER_NAME          MANUFACTURER_PART_NUMBER                     MAXIMUM_PACKAGE_HEIGHT MF               MOUSER_PART_NUMBER   MOUSER_PRICE-STOCK                                                                                             MP                                                                                                         MPN OPERATING_TEMP OPERATING_TEMPERATURE PACKAGE PARTREV PART_STATUS PITCH PRICE  RATING          REFDES ROHS_COMPLIANCE ROHS_COMPLIANT SERIES  SNAPEDA_LINK                                                        SNAPEDA_PACKAGE_ID STANDARD                     SUB-CATEGORY THERMALLOSS TOLERANCE TYPE       VALUE VENDOR VOLTAGE_RATING          VPN
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
