Tangineering/DC-Balancer-Board-Teensy/docs/reviews/charger_eval_2026-11-05/round4/work/evm/parts/onshore_ED120XDS-1.png

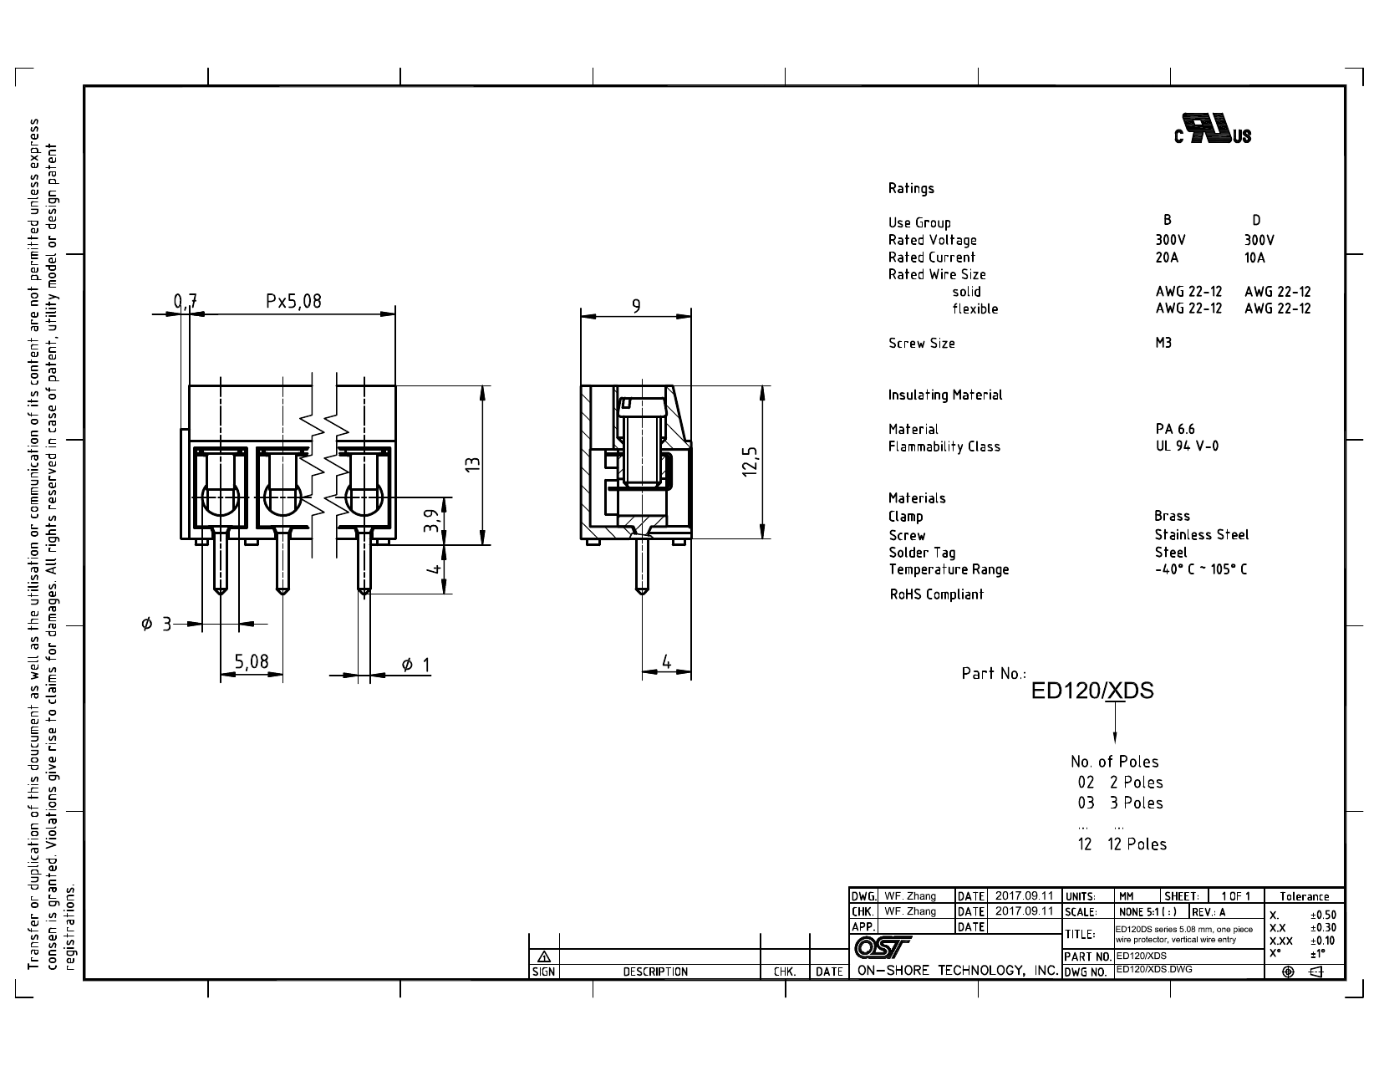
docs/reviews/charger_eval_2026-11-05/round4/work/evm/parts/onshore_ED120XDS-1.png
