Tangineering/DC-Balancer-Board-Teensy/docs/reviews/noise_fw37_2026-11-05/figs/beforeafter_matched_order_spectra.png

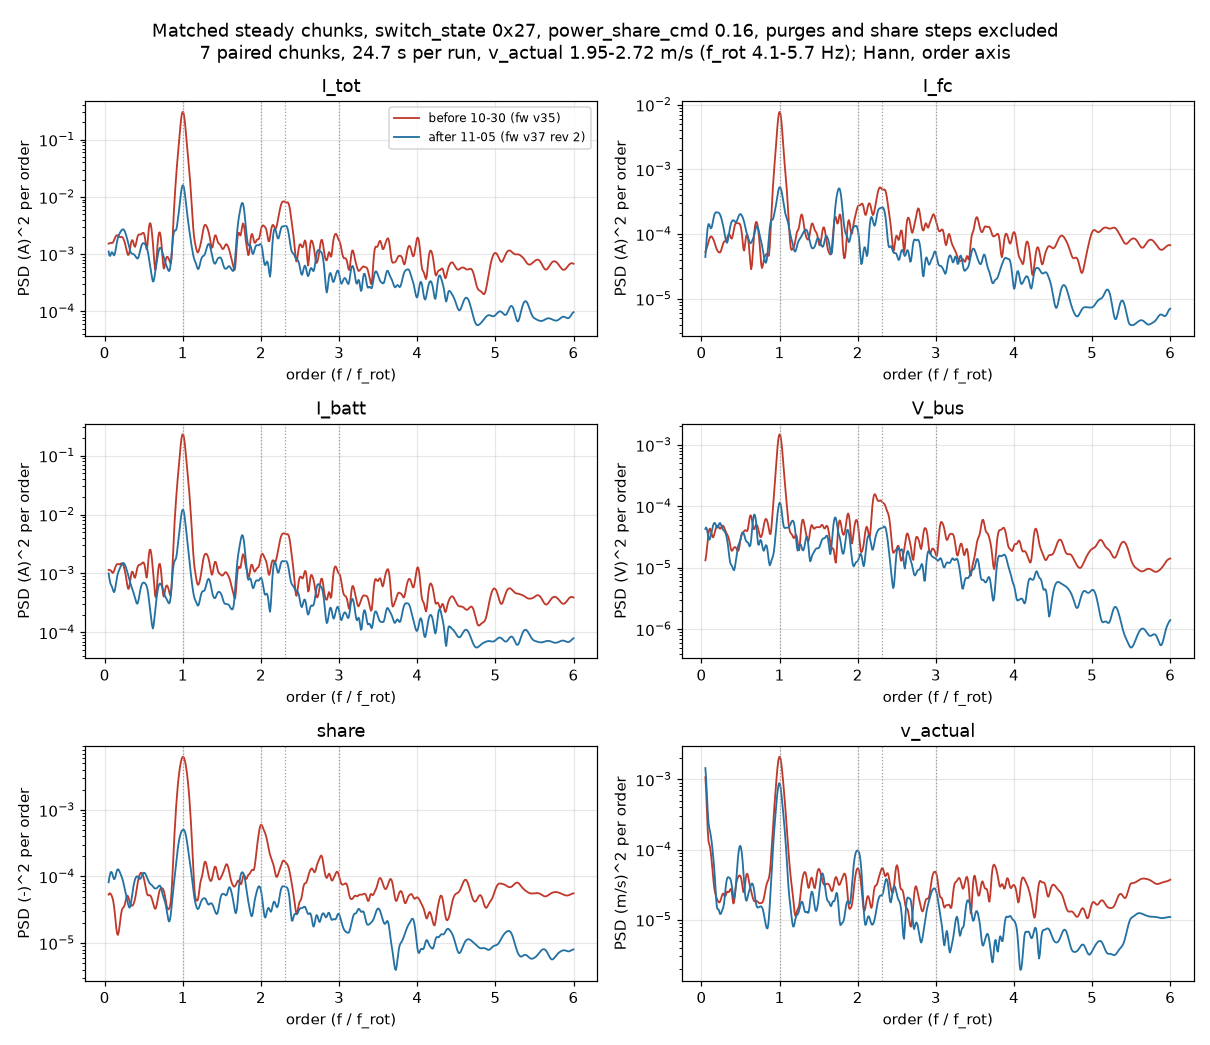
docs/reviews/noise_fw37_2026-11-05/figs/beforeafter_matched_order_spectra.png
