Tangineering/DC-Balancer-Board-Teensy/docs/share_sweep_whitepaper/figs/fig_run_order.png

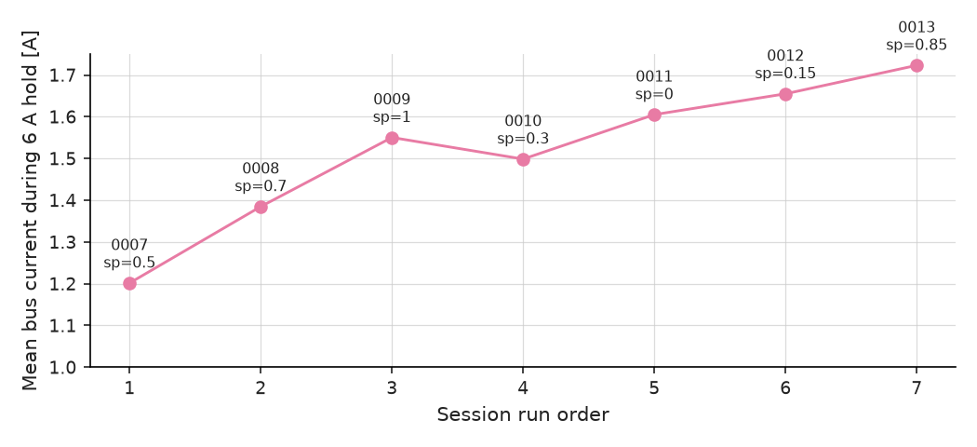
docs/share_sweep_whitepaper/figs/fig_run_order.png
