Tangineering/DC-Balancer-Board-Teensy/hardware/charger_evm_r8/fab/eib_2026-11-11/docs/eib.step

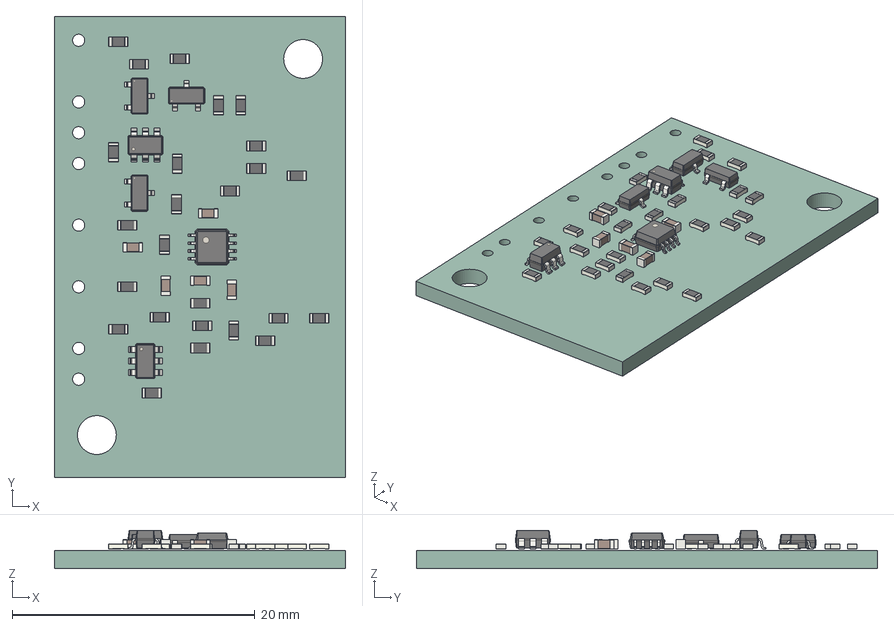
[picture p122: CAD file, 2026-11-11]
hardware/charger_evm_r8/fab/eib_2026-11-11/docs/eib.step
24.0 x 38.0 x 3.15 mm
R_0603_1608Metric x 25
C_0603_1608Metric x 5
SOT-23 x 3
SSOP-8_2.95x2.8mm_P0.65mm
SOT-23-6 x 2
eib_PCB
