Tangineering/DC-Balancer-Board-Teensy/(list of files, cad)

Other CAD files:
hardware/charger_evm_r8/fab/eib_2026-11-13/docs/eib.step
