Tangineering/DC-Balancer-Board-Teensy/docs/charger_bq25798_wiring_design_2026-11-05.md

# BQ25798EVM in place of the Ag105: wiring, carrier and operating design (board rev 20260622), round 4 r8

**Status (2026-11-10, revision r8 after the final independent audit run 001 (`docs/reviews/charger-design/run-001-2026-11-10.md`); r7 after the round-4 carrier change and review round 7; r6 after review round 6; r5 after review round 5; r4 after review round 4; r3 after review round 3; r2 after review round 2; r1 after review round 1).** Round 4 (r7) lets the carrier extend past the 31 x 33 mm Ag105 footprint; the EVM stays the power stage. Design document, not built. Nothing has been ordered,
desoldered or flashed. fw v37 rev 2 stays on the bench board (`AG105_VBATN_ISOLATED 0`, no regen charging). This file is
the **single source of truth** for Path A with the BQ25798EVM. Where it disagrees with
`docs/reviews/charger_eval_2026-11-05/round2/design_BQ25798.md` (the round-2 designer's record), this file wins. It does not
replace the decision record `docs/charger_replacement_evaluation_2026-11-05.md`. It implements that study's chosen part
under the operator's 2026-11-05 rulings R1-R9 below.

Supporting files, round 3 (all under `docs/reviews/charger_eval_2026-11-05/round3/`). **r7:** these files stay the record of r1-r6; the r6 SVGs and `calc/r3_calc.py` remain in `round3/`:

| File | Content |
|---|---|
| `wiring_bq25798.svg` | Wiring diagram: motherboard, carrier, EVM interface board, EVM, every lead and tap |
| `carrier_schematic.svg` | Schematic of the carrier and the EVM interface board (net labels; pin numbers in section B.8) |
| `calc/r3_calc.py` (+ `r3_calc_out.txt`, `r3_calc_out.json`) | Every number in section H, stdlib Python, sources in the header |
| `calc/make_svgs.py` | Generator for the two SVGs (edit the generator, not the SVGs) |
| `calc/pin_identity_check.py` | r6: CHG header pin-identity gate (parses the `.brd`, compares a KiCad pad export; catches a y-mirrored capture, T-A-06 step 0) |
| `review_loop.md` | The review-design loop: round-3 self-review passes and the round-1 to round-6 independent reviews with dispositions |

**r7:** supporting files, round 4 (all under `docs/reviews/charger_eval_2026-11-05/round4/`):

| File | Content |
|---|---|
| `carrier_layout_r7.svg` | Top view of the carrier on the r7 outline over the motherboard (tab X, tab Y, FT1/FT2, tap field, comparator block), with the EVM reference placement as a second panel |
| `wiring_bq25798.svg` | The round-3 wiring diagram with the r7 changes; it supersedes `round3/wiring_bq25798.svg` for r7 |
| `carrier_schematic.svg` | The round-3 carrier and EIB schematic with the r7 changes (R276); it supersedes `round3/carrier_schematic.svg` for r7 |
| `calc/r7_calc.py` (+ `r7_calc_out.txt`, `r7_calc_out.json`) | Every number in section H.23, stdlib Python; reads the `.brd` through `calc/mb_neighbours.py` and the MB solder-mask Gerbers; it also reads the `.brd` directly and the round-4 notes and scripts tagged BASIS (`work/r7_design_basis.md`), EVMG (`work/evm_geometry.md`, `work/evm_calc/evm_geom_out.txt`), MBM (`work/mb_mechanical.md`, `work/mb_pinload.py`), STK, MIN (`work/proposal_minimal.md`, `work/minimal_calc/*.py`) and EIBM (`work/eib_merge_calc.py`, `work/eib_merge_failsafe.md` Table 9); sources in the header |
| `calc/make_svgs_r7.py` | Generator for the three r7 SVGs (edit the generator, not the SVGs) |
| `calc/mb_neighbours.py` (+ `mb_neighbours_out.txt`, `mb_neighbours_out.json`) | MB geometry around the CHG footprint from the `.brd`: board outline, plain holes, neighbouring parts and top- and bottom-layer copper |
| `calc/stackup_area.py` (+ `stackup_area_out.txt`) | Area booking, single-sided placement test and the 2-layer versus 4-layer electrical comparison of `work/stackup_area.md` |
| `work/evm_geometry.md` | EVM outline, mounting provisions (fiducials, bumpons), connector, test-point and JP21 positions from the SLUUCB5E rev E vector figures |
| `work/evm_calc/evm_geom.py` (+ `evm_geom_out.txt`) | Extraction of the EVM positions from the SLUUCB5E rev E vector layer figures (Figs 4-1 to 4-4) with a per-axis scale calibration; source of `work/evm_geometry.md` and of the A.5 and H.23(k) EVM positions |
| `work/mb_mechanical.md` | MB mechanical, thermal and copper map around the CHG footprint: extension zones and their rejection reasons, thermal estimate, pin-load model |
| `work/eib_merge_failsafe.md` | Effect of an EIB merge onto the carrier on each fail-safe argument; pickup criterion (Table 9); G1 island merge conditions |
| `work/stackup_area.md` | Layer count, stack-up and area booking of the extended carrier |
| `review_loop.md` | The round-4 review-design loop: the design phase (fact-finding, proposals and assessment, decisions and calculation, in-place revision), review round 7 and the final independent audit |
| `work/r7_design_basis.md` | The r7 decisions D1-D11 with their addenda (sections 10 and 11) and the coined terms; the inputs tagged BASIS in `calc/r7_calc.py` |
| `work/proposal_minimal.md`, `work/proposal_tapside.md`, `work/proposal_evm_on_cr.md` (+ `work/minimal_calc/`, `work/tapside_calc.py` with `tapside_calc_out.txt`, `work/r7_evm_on_cr_calc.py` with `r7_evm_on_cr_calc_out.txt` and `r7_evm_on_cr_map.png`) | The three candidate carrier layouts and their calculations; the minimal proposal was adopted (tag MIN in `calc/r7_calc.py`) |
| `work/mb_pinload.py`, `work/eib_merge_calc.py` (+ `eib_merge_calc_out.txt`) | The pin-group load model (tag MBM) and the E1/C205 loop-inductance model (tag EIBM) that `calc/r7_calc.py` uses |
| `work/r7_review7_findings.json`, `work/r7_review7_dispositions.md` | Review round 7: the verified findings with the verifier's fix, and the dispositions D-F1 to D-F7 that settle conflicting fixes, with D-H, the operator statement of 2026-11-10 that the MB and its PCBs have no maximum height |
| `work/r7_check/`, `work/r7_check2/`, `work/r7_check3/`, `work/r7_check4/` | Independent re-computations of the H.23 figures |
| `work/mb_mech_calc.py` (+ `mb_mech_calc_out.txt`, `mb_mech_calc_out.json`, `mb_mech_map.png`), `work/mb_support_spots.py` (+ `mb_support_spots_out.txt`), `work/heights_40mm.txt` | The calculations behind `work/mb_mechanical.md`: the MB part heights near the CHG footprint, the extension-zone map and the candidate far-end support spots |
| `work/evm/` | SLUUCB5E rev E (`sluucb5e.pdf`, its text extract and page renders) and the EVM BOM extract, the inputs of `work/evm_geometry.md` |
| `work/svg_png/` | PNG renders of the three r7 SVGs |
| `calc/apply_patches.py`, `work/r7_patches/` | The text patch sets of the r7 revision rounds and the script that applies each set to this document atomically |
| `work/r8_patches/` (r8) | The r8 patch sets (r8_E hardware FLT path and K; r8_G firmware requirements, F/G/H.16/H.21 and their tests; r8_M mechanics, W leads and marker conversions; r8_T tests, records and relabels; r8_Z integration) and `design_pre_r8.md`, the r7 text before r8 |
| `calc/r7_calc.py` revisions 5 and 6 (r8) | H.23(n)-(w) for the audit fixes (revision 5) and H.23(x) for the r8 integration figures (revision 6); every line printed by revision 4 is unchanged |

## 0. Rulings applied, verdict, and what changed

### 0.1 Operator rulings (2026-11-05)

| ID | Ruling | Where it lands |
|---|---|---|
| R1 | Regen harvesting and FC charging are both hard requirements | F, H.7, H.8 |
| R2 | Path A on the current board with the BQ25798EVM | whole document |
| R3' | No circular charging loop (bus -> charger -> pack -> BT boost -> bus) and no runaway. The charger may stay powered through Run only with a fail-safe Teensy-commanded hard inhibit plus a hardware comparator backstop | B.1, B.6, F.3 |
| R4 | PCB and pack survived 2026-11-04 | D (no damage repair) |
| R5 | MCU hardware watchdog is required future work; no unattended charger session until its forced-hang test passes. **r4 consequence:** a Teensy hang inside an FC window cannot survive the next purge (F.4), so **no FC-charge window, attended or not, runs before T-W-01 passes**; R1's FC charging therefore depends on R5, and this design treats the watchdog as a precondition of FC charging, not as future work | G.3, F.4, T-W-01, T-D-14 |
| R6 | FC charging only in windows between H-20 purges. A predicted purge interrupts the window so the battery is back on the bus before the dip | F.4, H.8 |
| R7 | Regen and FC charging may run concurrently (IO CSV row 31 to be amended) | F.2, F.3, D.3 |
| R8 | The BT-current trip residual (INA253 floor ~0.1 A, residual loop up to ~0.29 A) is accepted for now | J.1 |
| R9 | The VBT->VCHG keep-alive is last resort. Design without it, give the test that decides it and any lower-drain alternative | B.5, H.9-H.10, H.15, T-B-09 |

### 0.2 Verdict

**On paper the design is feasible. No datasheet fact blocks it. The circular loop is impossible by construction in every
mode, with any single fault (section F.3), except the R8 residual, which the operator has accepted.** **r6:** the pack can no
longer be overcharged by a corrupted charger register with live but faulty firmware: the board's own BQ29200 cell OVP (4.35 V/cell,
factory-trimmed) now drops /CE and holds ILIM_HIZ in hardware through the carrier (B.1 term OVN, 1.6-4.9 s response), so the
BQ25798 VBAT_OVP, which follows VREG, is no longer the only voltage backstop (finding vreg-corruption-no-fixed-pack-ovp). The hard inhibit no
longer depends on a live MCU: a hardware heartbeat monostable drops /CE and holds ILIM_HIZ within TW_HB_MAX of a Teensy
hang (20-46 ms widened band, H.17, set by T-C-10), and the Run-entry qualification window is time-limited in hardware (B.1,
U111). Every inhibit node is observed at the far end, on the EVM pin itself (B.6). The ILIM_HIZ hard converter-off depends
on EN_EXTILIM = 1, which firmware never writes and verifies every 20 ms (G.1); whether HIZ survives EN_EXTILIM = 0 is open
until T-B-21.

**r7 (round 4):** the carrier (CR) now extends past the 31 x 33 mm Ag105 footprint by two tabs, tab X toward the Teensy and
tab Y toward L-FC. A bonded foot supports the far end of each tab (FT1, FT2; A.7). The EVM and the EIB are unchanged in
function; both move onto one insulating EVM plate on the chassis (A.7, C EM23). Every fail-safe argument of r1-r6 holds
unchanged (the J.1 mechanical mitigation of the VCHG-IN segment holds with the A.3 W-lead dressing path of r7 review 7, which keeps every W lead >= 2 mm in plan from the pin-10 joint and the IN strip); the only EIB circuit change is the damping resistor R276 in series with E1 (A.5, B.6). Revision r7 settles six design
points:

- Side, extent and support: tab X (x 48.70-65.00, y 56.30-68.30) and tab Y (x 17.70-37.56, y 67.14-76.00) give a
  1394.06 mm² r7 outline, and FT1 and FT2 carry the tab ends (H.23(a), H.23(i)).
- EVM on or beside the CR: no; the 88.90 x 88.90 mm EVM fits neither on the CR nor beside it on the MB, so the EVM plate
  stands past the MB +y edge (A.7, H.23(l)).
- EIB merge onto the CR: no; the EVM plate stands on the chassis and the CR sits on the MB, so the two are not one rigid
  co-mount, which is a G1 condition (J.2 item 60). At the H.23(l) reference placement, seven of the eight EVM points of the
  E leads lie 64.3-129.4 mm from the CR edge, and JP12 pin 1 (E1) lies 55.8 mm from it (`round4/calc/r7_calc.py` H.23(u), revision 5 (**superseded in r8:** hand calculation): the plan
  distance from each `round4/work/evm_geometry.md` Table 1 point to the nearest r7 outline point, the tab Y corner
  (37.56, 76.00); **superseded in r7:** 69.4-130.1 mm, of which every point but E1 was measured to the tab X top edge). A merge would export the
  unbuffered ILIM_HIZ node, REGN, /CE and STAT over those lengths, so the EIB stays (B.6).
- Layer count: the CR stays a 4-layer, 1.6 mm, double-sided board at 73.55 % top and 69.04 % bottom area use, against
  101.8-109.9 % single-sided (H.23(e)).
- Retired constraints: the footprint confinement, the r6 area budget, the named bottom keep-out and the MB power-copper shadow
  retire; the bottom clearance rule replaces the last two (A.7).
- Modifications: every EVM modification (EM) and every MB modification (PM) stays necessary; the text of EM5 and EM23 changes,
  and PM0, PM1, PM3, PM4, PM6 and PM7 gain r7 steps (C, D.1).

The r7 outline is not frozen before the operator survey T-A-08 (MS1-MS8) passes. MS2 decides the EVM placement and the W-lead
maxima (A.3, A.7).

**r8 (audit run 001, `docs/reviews/charger-design/run-001-2026-11-10.md`):** the adjudicated findings change no fail-safe
argument of r1-r7. Revision r8 settles seven points:

- FLT pad bridges: R106s 1.00 kOhm 1 % between U101 FLT and the F17 pad holds the FLT sink current at <= 3.377 mA, a factor
  of 2.96 below the 10 mA absolute maximum (tps2663.pdf sec 6.1), and the FLT LOW readback at <= 0.325 V (H.23(n); A.4, A.8, B.4).
- T3 timing: the REG03-05 raise write completes 1.359 ms after the edge at 100 kHz, against the 1.5 ms FR-07 deadline; the
  REG01-07 verification follows the write as four field reads, outside that deadline (H.23(o); G.1, FR-46).
- Flash and SD admission: the flash commit and the SD close have separate gates; Idle admits on battery support, and only
  the SD close and sync may run in State 99 phase 3 (G.3, FR-43).
- W1/W2 conductor: 20 AWG stranded copper, insulation OD 1.60-1.75 mm, twisted at a 20-25 mm pitch; in the modelled
  envelope the IN peak at a hard short is 33.79 V at 290 mm, against the 36 V limit (H.23(p); A.3).
- B1 riser and stacking: a machined insulating wedge B1R replaces the B1 spot and holds the trunk on the full requirement
  profile (minimum margin 0.504 mm, H.23(s)); W5 rests on the trunk, and the stack top is 20.750 mm above the MB, which is
  information under D-H (H.23(t); A.3).
- Firmware and test definitions: the FR-12(b) pin-38 criterion separates the stuck-path test from complete discharge
  (H.23(q)); the FR-12(b3) Idle probe (FR-23 exception EX1) and the FR-23 FLT-LOW diagnostic read (EX2) become explicit
  exceptions to the FR-23 gate; T1 steps 8b-8c (F.5), T-B-16 and T-F-16 are restated (F.5, I) (**superseded in r8:** "the
  FR-48 Idle probe"; "T1 step 8b, T-B-16 and T-F-16 are restated (G.2, I)").
- Traceability: every hand calculation of the r7 closing pass is a calc row of `round4/calc/r7_calc.py` revision 5
  (H.23(u)-(w)), the r8 integration figures are revision 6 (H.23(x)), the r8 verification-round figures are revision 7 (H.23(y)), and the TPS26630 datasheet is local (`references/Datasheets/tps2663.pdf`, K).

The design is not yet *proven*, because some of the numbers that decide whether regen is captured come from no primary
document. Each one is in the test registry (section I) with a pass criterion and a named design change if it fails. The
decisive tests are:

1. **T-E-03** (VESC over-voltage behaviour with V-MOT held at 19 V): decides regen for any charger on this rig.
2. **T-B-09** (keep-alive decision, R9): VCHG decays below the RT1987 UVLO and the BQ25798 battery-short threshold within
   0.17-0.78 s of cruise (H.9). Whether a burst then restarts fast enough is not in any datasheet. The pass criterion is the
   V-MOT peak (<= 20.5 V) with a current source into the measured C_VMOT (T-E-04 first) behind a series resistor equal to the
   input-path resistance (r3); the regen-armed budget for dead time plus response is only 0.33-0.80 ms once the 0.12-0.19 ohm
   input path is counted (H.7, H.19). The analysis says a keep-alive is **likely needed for regen in the regen-armed
   cruise mode**, and **not needed** for FC charging or for regen inside an FC window. The design carries a Run-gated
   keep-alive as a do-not-populate option (B.5) that draws nothing when parked.
3. **T-B-06 / T-B-10 / T-B-12** (inhibit latency, warm response, VINDPM reload after a raise): none is specified by TI.
4. **T-B-19 / T-E-11** (charge current 3.10 A accepted by the pack, and the efficiency at 19 V in): the regen capability
   margin rests on them (H.7).
5. **T-E-01 / T-E-12 / T-E-06** (purge statistics at 1 kHz, under window load and under traction swings; BT boost output
   against the FC-only bus; RT1987 hand-off delay): they size the pre-emption lead and decide whether the battery picks up a
   purge in time. **r3:** an FC-only bus cannot ride through a purge (the purging stack is its only source), so every early
   purge inside a window, and every pre-emption that misses the hand-off, is a State 99 (F.4). T_LEAD is sized from the
   measured onset-error tail against an operator-set State-99 ceiling per hour of window time. **r6:** until T-F-07/T-F-07b and
   T-E-01 have measured the battery rescue at 1 kHz, the rescue close is compiled out (`PURGE_RESCUE_ENABLED 0`) and every
   early purge inside a window is a State 99 counted against that ceiling (F.4).
6. **T-F-08** (BT_BUS close transient from an FC-only bus): decides lever 3(i) or 3(ii) in F.4 before any FC window runs
   with traction load.
7. **T-B-21** (does ILIM_HIZ < 0.75 V still stop switching with EN_EXTILIM = 0?) and **T-A-01b** (is the pin-7 tap free of
   the encoder nets?): they decide whether the hard converter-off is register-independent and whether the /CE readback pin
   is clean.
8. **T-B-20** (r3: VBUS valid -> REGN -> PG_STAT -> ILIM ADC read timing, no maximum in SLUSDV2C): sets T_REGN_MAX, on which the
   Run-entry sequence and the far-end monitors are now anchored.
9. **T-C-04** (r3: eFuse IN-side spike at a hard short): the r2 100 nF on U101 IN let the IN pin reach up to 134 V in the ideal
   simulation (H.19); the r3 local bulk brings it to <= 33 V, which T-C-04 confirms at reduced voltage first.
10. **T-W-01** (r4: MCU watchdog forced-hang test, R5): **gates every FC-charge window.** With the MCU hung in a window the
   heartbeat stops the charger, but BT_BUS stays open and FC_BUS/MOT_PWR stay closed, so the next purge (period 10.34 s)
   collapses the FC-only bus under a frozen MCU, and D-MT-EN can then re-energise the drained V-MOT node by itself (F.4
   "Teensy hang inside a window"). Only a watchdog reset that drops every EN before the stack recovers removes that path
   (RTWDOG target 50 ms against a 100-140 ms purge, G.3). The alternative is the hot-standby battery option (F.4). Until T-W-01
   passes, R1's FC charging is not available; regen harvesting is unaffected.
11. **T-A-05b / T-E-13** (r4): the D-BC-RG OVP trip measured against the D107 TVS breakdown (D107 must never become the regen
   sink), and the Teensy BT_VOLTAGE calibration that decides whether VREG may return from the interim 8.32 V to 8.40 V without a
   nuisance OV_BATT latch at the end of every charge (H.20).
12. **T-F-17 / T-C-09** (r6): the BQ29200 pack-OV permit (OUT high level at an 8.7 V pack against the Schmitt threshold, the open-tap
   and unpowered cases) and the timer-domain latency (<= 1 ms with SD, USB and I2C stress) that the brake feed-forward, T3 and the
   pre-emption step budget now rest on (FR-45).

### 0.3 What changed

Round 3 r0 against the round-2 record (kept for history):

| # | Change | Reason |
|---|---|---|
| 1 | Permit network rewritten for R6/R7 (B.1) | R7 lets REGEN stay closed in an FC window |
| 2 | Concurrent regen + FC mode with a firmware-raised, hardware-blanked input ceiling (F.2) | R7; a static FC ceiling would trip the VESC on the 3 -> 1 m/s brake (H.7) |
| 3 | Purge scheduler and pre-emption (F.4); bus-sag comparator UVB | R6 |
| 4 | FC windows open warm from REGEN (no cold FC close) | R7 |
| 5 | No M8 keep-alive in the baseline; Run-gated keep-alive option | R9 |
| 6 | eFuse TI TPS26630RGER | study condition 7 |
| 7 | Carrier in the vacated CHG footprint | removes six bodge wires at the pads |
| 8-11 | SN74LVC3G06 open-drain stages from REGN; BQ25798 trickle and 2.5 V/cell findings; JP7 removal; C-D8/C-D10 are 0805 | datasheet findings |

**Round 3 r1 (this revision), from the 53 verified findings of review round 1** (about 45 distinct issues; several were raised twice under different keys) (the per-finding log is in
`round3/review_loop.md`, "Review round 1"; disagreements are in section L of this document):

| # | Change | Finding keys |
|---|---|---|
| r1-1 | **Purge pre-emption, early purge and Run exit re-ordered:** P5 LOW, then FC_CHARGE and FCCEIL LOW in one tick, then VINDPM 19.0 V read back, then BT_BUS HIGH. New invariant **I-9: the FC_CHARGE and BT_BUS EN nets are never HIGH together**; the existing single-sample `FAULT_SWITCH_CONFLICT` stays as the backstop | preempt-fcc-btb-overlap, preempt-switch-conflict-latch |
| r1-2 | **ILIM_HIZ release now needs two healthy switches in series:** EVM R21 removed, JP14 opened; an EIB P-MOSFET Q203 feeds the release current from REGN through R255, and Q201 still holds the pin down from a separate driver (U202) on its own ribbon conductor. A broken lead, an open resistor or a dead driver now leaves the converter in HIZ | eib-wireoff-releases-converter |
| r1-3 | **Far-end readbacks on the EVM pins:** ILIM_HIZ through a comparator (U203) on a separate sense joint, re-sourcing pin 33; /CE through a comparator (U204) to pin 8 | readback-misses-evm-side, eib-wireoff-releases-converter |
| r1-4 | **Hardware heartbeat:** CHG_HB (pin 21) retriggers a monostable U113; /CE drive and ILIM release are both ANDed with it. A Teensy hang inhibits charging and stops the converter within 30-40 ms in every mode | p5-static-arm-hang |
| r1-5 | **QUAL is a hardware one-shot (U111, SN74LVC1G123, ~0.3-0.4 s) cleared by P5;** firmware raises QUAL only after EN_CHG = 0 is written and read back | qual-window-single-barrier |
| r1-6 | **BTB sensed by a comparator (U115) at 0.39-0.44 V**, below the RT1987 VEN_F minimum 0.6 V, failing to "BT may be on" | btb-sense-threshold-gap, permit-tap-failsafe-and-en-threshold |
| r1-7 | **Every input on a removable conductor fails safe:** pull-downs on every EIB driver input, BTB and T8 pull-ups, RGN/FCC pull-downs, H1q gated by UVB so a lost VBUS tap drops the regen permit, Kelvin T9 backed by R143 | open-input-failsafe, comparator-divider-open-faults, btok-sense-wire-open |
| r1-8 | **H2c = FCC . BTB_OFF . BT_OK . FCI_OK . ((UVB . FCCEIL) + H1)**: a bus sag no longer cuts a raised regen burst | uvb-blocks-raised-regen |
| r1-9 | **FR-08 trips only in the dangerous direction**; the safe direction is a non-latching window shed | fr08-uvb-unobservable |
| r1-10 | **Regen image ICHG 3.10 A (0x0136)**; capability = min(input limit, ICHG limit), restated in H.7; CV-taper regen derate (FR-25) | regen-capability-ichg-bound, regen-capability-ignores-ichg |
| r1-11 | **T3 raise is level-sensitive and staged** (IINDPM, ICHG, then VINDPM 18.2 V, ratcheted to 19.0 V); FR-24 hold-off deleted; T4 restore re-keyed on charger state; false-restore guard | raise-vindpm-unload-transient, restore-threshold-vindpm-band |
| r1-12 | **FR-07 normative:** pin-34 interrupt, one non-blocking I2C engine, transaction cap, EEPROM commit deferred in windows, 2.7 kOhm extra pull-ups and 400 kHz; I2C goes straight to EVM J8 on its own cable W7 | raise-latency-i2c-budget, t3-latency-blocking-i2c, eib-mounting-and-tp-placement |
| r1-13 | **BT_BUS close transient quantified** (H.6) and the RT1987 enabled-but-blocking state analysed; pre-emption readiness no longer requires battery current before the purge; purge-rescue predicate with a 12.0 V floor bounded by the RT1987 SCP envelope | btbus-reclose-inrush-unquantified, preempt-bt-trcb-conduction, early-purge-refusal-band |
| r1-14 | **eFuse output Schottky D103 + C103 1 uF; OVP re-selected to 23.1 V (22.6-23.6 V)**; IMON clamp diode removed (R129 10 kOhm + C129) | efuse-out-schottky-missing, efuse-ovp-above-bq-rating, imon-clamp-leakage |
| r1-15 | **ILIM bands recomputed with leakage**; EVM R23 replaced by 49.9 kOhm to halve the leakage error | ilim-band-leakage-omitted |
| r1-16 | **FC-window traction margin:** window admission bound on the commanded current, an upstream setpoint hold, a peak-hold governor, optional hardware FC-current shed (U117, DNP) | ocfc-margin-traction-transient-fc-window |
| r1-17 | **Divider tops protected:** 10.0 kOhm series resistors (R170/R171) at the V-MOT and VBUS solder joints; BAV199 input clamps | t1-t2-unprotected-power-taps, comparator-divider-open-faults |
| r1-18 | **Buildability:** pin-level netlist (B.8), layout constraints with the 22 hole coordinates (A.8), KiCad capture gate PM0 + T-A-06, fabricated EIB on chassis standoffs, kitted BOM, copper weight, second VIN+ link W8 | carrier-no-buildable-layout, eib-mounting-and-tp-placement, bom-mpns-incomplete, carrier-copper-unspecified |
| r1-19 | EVM JP30 removed; EM IDs unique; carrier designators renumbered into 1xx (no collision with MB RB1/RB2); stale designators fixed; tap returns terminated | evm-c43-25v-vbus-ldo, evm-c43-25v-on-input, duplicate-em-ids, rb2-designator-collides-with-mb, stale-designators-*, tap-twisted-gnd-unterminated |
| r1-20 | Telemetry v5 fields for the new modes; BT_BUS ownership in windows; FC-window POR flag; standby draw line; pin 34 / WDOG1_B rule; registry pass/fail for every row; T9 to the SNS-BT ground | telemetry-ems-gaps, t2-bt-bus-ownership, fc-window-por-latches-fc-clamp, run-quiescent-draw-unaccounted, pin34-wdog1b-pad, registry-missing-pass-fail, btok-kelvin-* |

**Round 3 r2 (this revision), from the verified findings of review round 2** (44 finding keys, about 38 distinct issues; the
per-finding log is in `round3/review_loop.md`, "Review round 2"; dispositions that differ from the finding are in section L):

| # | Change | Finding keys |
|---|---|---|
| r2-1 | **EVM ILIM feed joint fixed (blocker):** EVM R21 is now a 0 ohm link (not removed), the JP14 shunt stays out and JP14 pin 1 (REGN) is removed, so E2 on JP14 pin 2 reaches ILIM_HIZ | evm-jp14-feed-joint-floating |
| r2-2 | **REG14 never written:** read-only masked verify every 20 ms and before every EN_CHG/QUAL edge; a mismatch drops P5 and latches a trip; one token-gated corrective write is the only recovery; T-B-21 tests whether HIZ survives EN_EXTILIM = 0 | reg14-write-reopens-extilim |
| r2-3 | **Pre-emption, T5 and T6 keep P5 HIGH (T2 drops it only across the FCC close):** FC_CHARGE and FCCEIL drop together, the regen soft layer is written, then BT_BUS closes; a brake in progress (above or below H1) keeps being absorbed. P5 LOW only on the VINDPM-write failure branch, T1, T7, T8 and trips. I-1 rewritten | preempt-p5-low-drops-brake-absorption, preempt-drops-subh1-regen |
| r2-4 | **T2 needs a live FC survivor** before BT_BUS opens: selector disarmed, FC_BUS re-closed through the guarded release, unblanked, FC_REG HIGH, BT current <= 0.5 A; post-drop V_bus check; the window latch owns FC_BUS HIGH too | t2-btbus-open-without-fc-conduction |
| r2-5 | **Early-purge rescue predicate evaluated at conduction**, with a 0.2 V/ms sag floor: at the H.8 sag rates it always refuses (H.6), so an early purge rides through on the FC or ends in State 99 (**superseded by r3-13: no FC ride-through exists**); an SCP gap is a fault outcome; "never a hot-plug" deleted; early-purge classification needs V_bus < 14.16 V or a V_fc onset | rescue-predicate-checked-before-tdon, early-purge-trigger-misattribution |
| r2-6 | **Setpoint hold released on the readiness predicate** (no I_batt condition), derived timeout T_HOLD_MAX, slew-limited release on timeout | setpoint-hold-conduction-deadlock |
| r2-7 | **Window rules:** windows re-open mid-interval (schedule locked, T_LEAD + T_WIN_MIN before t_pred); one admission/close test G with hysteresis, in stack power against the H-20 P_MAX; churn bound; duty restated as an upper bound | window-reopen-rule-limits-fc-duty, fc-window-budget-vs-h20-pmax |
| r2-8 | **FR-08 uses HB_dead and TW_QQ_MAX** from T-C-10; monostable bands widened for X7R tempco and DC bias (H.17); no mask in the T1 self-test | fr08-hb-latency-false-trip |
| r2-9 | **/CE readback moved to pin 7** (MB ROS removed, tap on its pin-7 pad; no pull-up on that net); pin 8 and RENC2 left on the encoder net; readbacks `INPUT_PULLDOWN`; EIB 3V3 on two ribbon conductors with a 10 kOhm bleed; I2C pull-ups moved to the MB (RSDA/RSCL 2.7 kOhm, CR R145/R146 DNP), so no external source back-powers the carrier rail | eib-pin8-backpower-unpowered-outputs, cr-3v3-single-tap-backpower, pin8-encoder-net-occupancy, pin8-tap-on-encoder-net |
| r2-10 | **Permit logic:** H1 term in H2c and RFC_OFF qualified by RGN; the QUAL one-shot only acts with FCC LOW (ILIM_PRE = GATE OR (QQ AND FCCN)); one added SN74LVC2G08 (U118); R119 10.0 MOhm; U203 threshold 0.59-0.65 V (below VIL_ILIM_HIZ 0.75 V) | h2c-h1-term-not-rgn-qualified, qual-clr-edge-bypasses-gate, btb-pullup-backdrives-en, ilim-sense-threshold-above-hiz-vil |
| r2-11 | **eFuse output:** D103 sized for the hard short; OUT below -0.3 V in a hard short accepted under SLVSE94G §9.5.1 pending TI E2E; T-C-04 records and checks survival; TVS branch deleted; D103 chosen by IR at 23.6 V/60 C in T-A-05 | efuse-out-schottky-missing-reopen, tc04-out-spike-criterion-unattainable |
| r2-12 | **W8 deleted** (no unfused flying lead on the unprotected VCHG-IN segment); J.1 entry | w8-unfused-hot-lead |
| r2-13 | **Single-point grounds:** ribbon GND through R273 10 ohm, W7 a twisted triple with GND at the CR end only, T7 omitted, T7b/T17r CR-end shields; T-F-11 measures signal-ground currents; T-F-04c the INA253 FC offset | ground-loops-parallel-returns, evm-agnd-parallel-return, ina253-adc-offset-from-charger-return, w7-gnd-termination |
| r2-14 | **Telemetry:** BQ25798 ADC continuous whenever the charger is powered in Run (IBAT/IBUS, 12 ms scan); pack-side charge counter and charger-input energy counter | telemetry-ems-gaps-reopen |
| r2-15 | **Buildability:** 10-pin and 12-pin header strips; 3 x 8 tap field placed between the columns; SMT J101; bottom keep-out; area budget (H.18, double-sided); four divider tops moved to TNPW0805; R116 10.0 MOhm; designators added | chg-header-strips-10-12, carrier-no-buildable-layout-reopen, bom-resistor-mpns-out-of-range, svg-netlist-designator-gaps, p5-name-collision (tap holes renamed F01-F24) |
| r2-16 | **Standby and 3V3 budgets recomputed:** Run draw 3.4-4.9 mA, 55-78 mW; 3V3 1.82 mA | run-quiescent-draw-unaccounted-reopen, h15-3v3-load-understated |
| r2-17 | **Smaller fixes:** TP41 not TP42; JP3/JP5 soldered links (R13 in the CV drop); EVM input 50.4 uF; T-A-04 criterion from §6.3; CSV row 16 with FCI_OK and H1 . RGN; I2C bus clear; LVC slow-edge exception with a test; every TODO tied to a test | evm-tp42-is-scl, evm-power-shunts-unsourced, evm-input-cap-figure, t-a-04-criterion-not-datasheet, csv-h2-text-omits-fciok, csv-row16-omits-fciok, i2c-bus-recovery-missing, lvc-slow-edges-reset, todo-outside-registry, warm-response-pass-criteria-inconsistent |

**Round 3 r3 (this revision), from the verified findings of review round 3** (34 finding keys, about 31 distinct issues; the
per-finding log is in `round3/review_loop.md`, "Review round 3"; dispositions that differ from the finding are in section L.3):

| # | Change | Finding keys |
|---|---|---|
| r3-1 | **Run entry and the far-end monitors re-anchored on REGN.** One predicate `regnExpected` (FR-23) replaces "V_chg > 10.2 V for > 200 ms": PG_STAT = 1, or a /CE-sense HIGH seen with P5 LOW, or T_REGN_MAX elapsed since VBUS_PRESENT / the last EN_HIZ clear, with EN_HIZ (shadow) 0, FLT HIGH, fresh I2C (stale I2C fails toward the trip after T_REGN_MAX). T1 step 5 waits for it; PG_STAT = 1 with /CE sense still LOW latches the trip; no marker by T_REGN_MAX -> retry, 3 misses -> `CHG_NO_REGN`. FR-08(b) merged into FR-08(b); a non-latching "charger unbiased" state with a cause code covers HIZ, poor source, eFuse latch | t1-ce-check-before-regn, fr08-powered-predicate-ignores-regn, ce-sense-gating-before-regn |
| r3-2 | **Redundant /CE pull-up:** R272 (R42 site, link to TP27) and R272b (TP36, own link to the JP12 REGN pin), each 47.0 kOhm; U204's ground-referenced sense kept so a lifted E6 still reads "/CE LOW" | ce-pullup-link-sense-divider-fails-low |
| r3-3 | **Heartbeat is a completion token:** CHG_HB toggles only inside the 1 kHz monitor tick when FR-08, the timed `detectFaults()` checks and fresh ADC samples all completed; same rule for the R5 watchdog feed | heartbeat-proves-loop-not-monitor |
| r3-4 | **Run-entry proof of the ILIM release chain:** pin 33 HIGH within 5 ms of QQ start and LOW within TW_QQ_MAX x 1.1 after QUAL (T1 step 6) | u203-stuck-held-latent-no-entry-test |
| r3-5 | **BTB_OFF stuck HIGH is latent** (H2c cannot reveal it under I-9): F.3 and FR-08(c) corrected; bench proof T-C-12 at every rebuild and every 6 months; J.2 entry | btb-off-stuck-high-undetectable |
| r3-6 | **Bus sag vs H1:** T3 is qualified by "V_bus not falling" (dV/dt > -0.1 V/ms over 2 ms and V_bus > 14.16 V); otherwise the event is a sag (FCCEIL LOW, VINDPM 18.2 V, chg_src `sag`); T8 added to the I-4 exemptions; F.4 early-purge step 1 restated | early-purge-sag-asserts-h1, h1-asserts-on-bus-sag |
| r3-7 | **T3/T4 FCCEIL race closed:** the raise worker re-asserts FCCEIL LOW before each raising write; T4 step 2 only with no raise pending and H1 rb LOW in one critical section | t3-t4-fcceil-race |
| r3-8 | **BT sense common cause:** FR-38 flags a dead INA253 BT channel from the share loop's commanded battery current and refuses FC windows until reboot; J.1 entry next to R8 | ina253-bt-common-cause |
| r3-9 | **eFuse IN spike:** C102a 1 uF 100 V 1206 + C102b 4.7 uF 50 V 1210 + C102c 100 nF 100 V at U101 IN, D107 TVS fitted by default; IN peak 134 V -> 33 V worst in the ideal simulation (H.19); T-C-04 at 8/12 V first | efuse-in-spike-c102-undersized |
| r3-10 | **CR underside:** whole CR footprint controlled; tails flush <= 0.5 mm everywhere; tap field F01-F24 becomes top-side SMT pads (no holes, no cable-tie slot); bottom parts passives only, <= 1.0 mm, outside the MB power-copper shadow (+1 mm); polyimide sheet on the MB under the CR; T-A-06 overlay against all MB layer-1 copper; T-F-12 low-voltage DMM tap-net checks | cr-bottom-over-mb-power-traces |
| r3-11 | **Input-path resistance** R_PATH_RG 0.12-0.19 ohm counted: warm budget 0.33/0.80 ms regen-armed, 0.63/1.52 ms raised (H.19); V-MOT static max 19.72 V (VESC margin 1.63 V); false-restore guard 19.91 V; bench rigs carry a physical series resistor; T-F-13 measures R_path and the MB via heating | input-path-ir-drop-omitted, mb-vchgin-vias-current-rating |
| r3-12 | **BT_OK self-test split:** a BT_OK failure refuses FC windows only; R142 select-on-test per unit (falling trip >= measured floor + 4 mV, rising <= 29 mV) | btok-selftest-floor-overlap |
| r3-13 | **Early purge = State 99, stated plainly:** FC ride-through deleted; pre-emption exposure sized from the measured onset-error tail against an operator-set State-99 ceiling; hot-standby battery path recorded as an operator option | early-purge-fc-ridethrough-infeasible |
| r3-14 | **Window admission follows the Pi:** rule (h) charge_goal > 0.05; a `chgFull` latch on CHG_STAT 111b; FC_CHG_MAX_MS / FC_CHG_COOLDOWN_MS restored as backstops; windows override the share command and say so in telemetry | window-ignores-ems-intent-and-termination |
| r3-15 | **Scheduler unlock** chosen per purge model (time-, charge- or load-bin based); no unlock on traction swings; T-E-01 traction run; locked fraction scored on UDDS and full-scale FTP-75 | scheduler-unlock-on-load-starves-windows |
| r3-16 | **CR power pads placed:** W1/W2 (31.5/28.9, 61.2), W3/W4 (24.3, 45.4/55.6), W6/W7 as SMT pads at y 57.5; U101 centred (41.8, 64.1); J101 y 43.2-61.1 | cr-power-pad-coords-on-pin-column |
| r3-17 | **EVM R20 and JP13 pin 1 removed** (second stray-shunt REGN path to ILIM_HIZ); R256/C252 across JP21 pins 1-2; J3/J4 insulated | evm-jp13-regn-pin-stray-shunt, r256-c252-agnd-landing-unspecified, evm-j3-j4-live-terminals |
| r3-18 | **Ribbon keyed:** J101 position 6 (a GND) omitted, a polarising plug in socket hole 6, pin-1 marks; power-off continuity and a 20 mA-limited first power-up (T-C-13) | j101-unkeyed-ribbon-reversal |
| r3-19 | **U203 pin-referred:** R258 100 kOhm -> 10.0 kOhm; pin trip 0.587-0.650 V (17 mV above the R23-open held level) | u203-threshold-ignores-sense-offset |
| r3-20 | **Smaller fixes:** TPS26630PWPR fallback deleted (it does not exist); IO CSV row 20 reserved and row 19 note; T18 behind R172 10 ohm; D103 class >= 40 V and the B340A labelled bench-only; FR-20 TODO tied to T-B-14b; FR-33..e renamed FR-33..36; BAV199 rail residual restated (T-C-07 < 0.8 V); EIB 36 x 24 mm with a layout table and H.18b; U117 values with R161 select-on-test | tps26630-pwp-alternate-nonexistent, csv-pin20-reservation-missing, t18-5v-tap-unprotected, d103-fallback-contradicts-criteria, todo-outside-registry-reopen, fr08b-label-collision, bav199-clamps-backfeed-cr-rail, eib-layout-unbudgeted, u117-option-values-missing |

**Round 3 r4 (this revision), from the verified findings of review round 4** (32 finding keys, about 31 distinct issues; two keys,
i2-vs-preempt-stepb-failure-branch and preempt-vindpm-failure-blocks-step-d, describe one defect; the per-finding log is in
`round3/review_loop.md`, "Review round 4"; dispositions that differ from the finding are in section L.4):

| # | Change | Finding keys |
|---|---|---|
| r4-1 | **FC windows gated on the R5 watchdog:** T-W-01 is a decisive test and a precondition of every FC window (attended or not); RTWDOG target 50 ms (below the 100 ms minimum purge duration, so a hang before or during a purge resets the MCU before the stack recovers); T-D-02(a) checks the hang -> heartbeat path only and ends the hang before the predicted purge; the hang-in-a-purge residual is characterised on a bench FC emulator (new T-D-14), never on the vehicle; all-EN release order on a watchdog reset checked in T-W-01; J.2 residual for a purge-coincident hang | hang-fc-window-r5-gates-r1, hang-fc-window-purge-reclose-death5 |
| r4-2 | **I-2 rewritten** with a proven barrier in place of the VINDPM read-back (P5 LOW >= 1 ms with /CE sense HIGH, or after an FR-08(b) trip REGEN read back LOW, FCC read back LOW in both); step D guard at max(A + 2 ms, P5-LOW edge + 1 ms); a VINDPM failure is not a refusal; `soft_layer_missing` holds P5 LOW and refuses windows until a verified image; four FR-22 cases | i2-vs-preempt-stepb-failure-branch, preempt-vindpm-failure-blocks-step-d |
| r4-3 | **I-4 split:** inhibit-only signals (P5, QUAL, FCCEIL LOW, HB stop) and fault paths (T7, the latch actions of FR-08/FR-33/FR-35/FR-36/FR-14(d) and the new T10) are never gated by H1; normal REGEN/FCC drops stay gated | i4-blocks-state99-under-h1 |
| r4-4 | **FR-12 split:** the INA253 BT floor and BT_OK are captured at bring-up P0 with both bus switches LOW, the D-MT-EN short check runs between P0 and the end of P2 (MOT_PWR LOW anyway, ratio test), inside the shared `busBringupTick()`; nothing toggles MOT_PWR or BT_BUS in Idle | fr12-idle-selftests-need-motpwr-btbus-low |
| r4-5 | **New T10 "charger trip inside a window":** P5/QUAL/FCCEIL/FC_CHARGE/REGEN LOW in one tick, an independent proof that the charger cannot convert (/CE sense HIGH, or V_chg decayed), then BT_BUS HIGH through the pre-emption path, window latch released; deadline -> controlled State 99 before the purge | charger-trip-in-window-leaves-bt-bus-open |
| r4-6 | **ILIM leg of the heartbeat self-tested** at Run entry (second QUAL pulse after the image is verified, HB paused while QQ releases) | hb-selftest-skips-ilim-leg |
| r4-7 | **Pin 35 `INPUT_PULLUP` as the only FLT pull-up, R106 DNP** (an open T16 now reads "no fault", no back-feed into the CR rail); FLT plausibility checks | pin35-flt-floats-on-open-tap |
| r4-8 | **EIB E-pad row** with empty pads around E1 (REGN); bare-EIB isolation check | eib-e1-regn-adjacent-to-ilim-feed |
| r4-9 | I-2 sub-bus clause restated on observable signals; B.5 fallback-2 trade-off restated (the loss is the reverse block, not a forward disconnect) | i2-btboff-precondition-unobservable, fallback2-dbtsq-disconnect-claim |
| r4-10 | **D107 re-specified** VBR(min) >= 36 V, VRWM >= 30 V, Vc <= 60 V (SMBJ33A/SMCJ33A class); C102b 4.7 uF **100 V**; T-C-04 limit < 60 V and below every IN-side rating; new T-A-05b measures the D-BC-RG OVP trip against D107 | d107-tvs-crowbars-vmot-regen |
| r4-11 | **OV_BATT error budget:** interim VREG 8.32 V (0x0340, ~4.16 V/cell) until T-E-13 calibrates the BT_VOLTAGE chain (`BT_CAL_GAIN`, FR-40); 10 min CV hold test T-F-14 | ov-batt-cv-margin-ignores-adc-error |
| r4-12 | **ILIM POR conversion error** measured (T-B-23); the register IINDPM already caps the regen clamp at 1.70 A | ilim-clamp-por-adc-error-omitted |
| r4-13 | **Rail and ribbon protection:** R175 68 ohm 1206 in the CR 3V3 feed (decoupling downstream), R176/R177 200 ohm per ribbon 3V3 conductor, R264/R265 470 ohm, ribbon conductors 9/10 swapped (ILIM_REL_B between REL_A and GND); T18 behind F101 fuse + R172 33 ohm 1206 | cr-eib-3v3-feed-unprotected-short, ribbon-adjacent-short-ilimrelb-rfcoff, tlv3012-ribbon-driver-short-current, r172-0805-short-dissipation |
| r4-14 | **Pin 22 `INPUT_DISABLE`** (keeper off) before any analogRead | pin22-adc-keeper-imon-error |
| r4-15 | **FC-window raise race fixed at its cause:** brake feed-forward writes the FC-image maximum IINDPM 0.90 A at the `vesc.setCurrent()` chokepoint before a brake reaches the VESC; F.3/H.7 figures corrected (integrated: 18.91 V at 1.5 ms, 18.9 W, 0.90 A, 0.4 mF; 19.65 V at 23 W); false-restore guard becomes a state predicate | fc-window-raise-ignores-governor-floor |
| r4-16 | **Purge lock tolerance split and tied to T_LEAD:** PURGE_EARLY_MAX = T_LEAD - T_HANDOFF_MAX - margin = 55 ms (static_assert), late bound 100 ms; T-E-01 scored with one number | purge-lock-tolerance-exceeds-tlead |
| r4-17 | **FR-15b: no FC-only bus outside a window while FC_REG is HIGH and a purge is possible** (`fcPurgeExposure()` defers every share-loop BT cut); the pre-emption also re-closes any FC-only topology standing at t_pred - T_LEAD | preempt-btbus-not-owned-through-purge |
| r4-18 | **FR-11 one-sided and evaluated only in quiet intervals** (suspended while braking, H1 or V-MOT near VBUS) | fr11-trips-on-concurrent-regen |
| r4-19 | **Sag-to-raise re-entry** after a sag that turns out to be a brake; `chg_src` from calibrated V_rgn - V_bus; split charge counters | sag-path-no-return-to-raise, chg-src-misattributes-subh1-regen |
| r4-20 | **CR high-y band re-planned:** U101 rotated 90 degrees CCW (IN toward the freed strip), J101 a 1.27 mm 2x7 (y 43.2-52.5), C102a/b/c + D107 in x 37-45 / y 52.5-61.6, D103/C103 region >= 7.5 x 3 mm; per-region placement table (A.8) | efuse-cluster-no-room-at-pad10 |
| r4-21 | **Smaller fixes:** SVG W5 legend (pin 6 = KEY) and carrier title; 26 AWG >= 5 m in two colours; W3/W4 holes 1.5 mm; JP3/JP5 links into the plated holes with a rating check; PM4 as an ordered procedure | svg-w5-pin6-legend-gnd, bom-26awg-wire-quantity, w3w4-hole-vs-18awg-silicone, evm-jp3-jp5-link-pin-rating, pm4-header-solder-sequence-ambiguous |

**Round 3 r5 (this revision), from the verified findings of review round 5** (24 finding keys, about 20 distinct issues; two
pairs are duplicates, rt1987-ovp-otp-restart-contradiction / rt1987-ovp-latch-vs-autorestart-contradiction and
ribbon-4-5-stat-sink-abs-max / ribbon-adjacent-short-stat-cedrv, and two clusters overlap, the three brake feed-forward keys and the
two flash/watchdog keys; the per-finding log is in `round3/review_loop.md`, "Review round 5"; dispositions that differ from the
finding are in section L.5):

| # | Change | Finding keys |
|---|---|---|
| r5-1 | **Brake feed-forward rewritten (FR-41, F.3 items 1-5):** fires only below -I_ff = 1.0 A (same tick, no duration test); the brake command goes out unmodified while IINDPM ramps **measurement-gated** (I_fc held <= I_cap - m_ff, H.21(b)); the traction peak-hold is never cleared on the brake edge; a BRAKE state suspends only the G-based close (every non-G close stays live); a positive command is held (<= 1 ms, else P5 LOW) until IINDPM = min(0.90 A, G) is ACKed; reversal-headroom test; the governor proxy is traction-only and duty-weighted; new T-B-24, T-G-02d | ff-brake-edge-clears-peakhold-on-ripple, gov-cmd-proxy-abs-closes-window-on-brake, ff-iindpm-step-overlaps-traction-ocfc |
| r5-2 | **Independent pre-emption backstop FR-42** in the 1 kHz monitor (frozen deadlines, T_BACKSTOP 85 ms static_assert, age and step-dwell caps, the shared `forcePreemptToBattery()`), a stage-mask term of FR-28; T-C-14 | preempt-deadline-outside-completion-token |
| r5-3 | **Flash writes gated to quiescent states and the watchdog windowed (FR-43, G.3):** PJRC eeprom.c masks interrupts for up to ~1.2 s per commit; RTWDOG 50 ms only while the charger heartbeat runs; `mcuFlashOpBegin()` bracket; never in State 2/3/99; armed-state stall budget 5 ms; T-W-01 extended, new T-W-02 | rtwdog-50ms-vs-blocking-flash-ops, flash-commit-stalls-hb-and-wdt-in-run |
| r5-4 | **Early purge restated from the bags:** no FC ride-through (I_fc 0 A), but a load-dependent battery rescue (4 of 4 held at aux load); the step-2 shed clamps the motor command <= 0; `SAG_MIN_POST_ONSET` provisional; T_LEAD sized with P(rescue fails \| load); T-E-01/T-F-07 per load bin | purge-fc-only-ridethrough-bag-evidence |
| r5-5 | **T10 proof for FR-08(b):** far-end ILIM held + CHG_IIN/IBUS < 0.1 A; the V_chg decay (37-102 ms) kept for the shorted-input suspicion | t10-fr08b-proof-relies-on-slow-decay |
| r5-6 | **RT1987 OVP/OTP latch vs auto-restart:** FR-30/T9 restart-mode independent (any V_chg collapse-and-return with REGEN HIGH is a POR); T-A-05b measures the mode | rt1987-ovp-otp-restart-contradiction, rt1987-ovp-latch-vs-autorestart-contradiction |
| r5-7 | **Fallback 2 is a fused link** C-D12 pad 1 -> C-D11 pad 1 (>= 5 A, >= 16 V, interrupting rating >= the T-A-05c pack fault current), never a 0 ohm bridge | fallback2-pack-unfused-on-w3-and-bridge-rating |
| r5-8 | **EIB R275 1.00 kOhm in series with STAT** (4-5 short 2.6-2.9 mA vs 6 mA abs max); ribbon short list complete; FR-44 STAT plausibility | ribbon-4-5-stat-sink-abs-max, ribbon-adjacent-short-stat-cedrv |
| r5-9 | **CR high-y band re-planned and courtyard-checked** (H.21(k)): W1/W2 to (30.3/27.7, 61.2), D103/D107 SMA, C102b and D103 by a <= 2 nH loop rule, pocket parts 0402 top-only, J101 y 42.13-51.53 | efuse-cluster-no-room-at-pad10-reopen |
| r5-10 | **Build procedure and mechanics:** PM4 step 2b trims and measures W1-W4 before seating; adhesive strain relief + chassis tie within 30 mm and a pull check; polyimide sheet specified (silicone adhesive, cut-outs) and on the BOM with the RTV; mated-socket dry fit and cable exit | pm4-header-solder-sequence-ambiguous-reopen, cr-end-strain-relief-anchor, bom-polyimide-adhesive-unspecified, j101-mated-socket-envelope |
| r5-11 | **Smaller fixes:** IMON/CHG_VOLTAGE ground offset (A.6, T-F-15); ICHG upper bound 3.21 A in the ratings (H.11, H.14, EM12, T-B-16); EIB E-pad row with E7 isolated (12 positions, 27.94 mm); JP17 pin 2 removed; IO CSV rows 28, 30, 41; B.8 power holes/pads, U112 pins, BAV199 pinning marked unverified; W1/W2 pad 2.3 mm | imon-vchg-ground-offset-under-charge-current, ichg-upper-tolerance-omitted-in-ratings, eib-e6-e7-ce-stat-bridge, layout-table-dimension-gaps, evm-jp17-stray-shunt, csv-rows-28-30-41-carrier-taps-unrecorded, b8-netlist-omits-cr-holes-pads |

**Round 3 r6, from the verified findings of review round 6** (16 finding keys, 16 distinct issues, none a blocker;
the per-finding log is in `round3/review_loop.md`, "Review round 6"; dispositions that differ from the finding are in section L.6):

| # | Change | Finding keys |
|---|---|---|
| r6-1 | **Firmware-independent pack-OV permit:** the fitted BQ29200 OUT (net BAL-NOK, pin 8) reaches the carrier on tap T22 (F08) through R178 100 kOhm, a BAV199 clamp and an R179 1.00 MOhm pull-up into a Schmitt inverter U123 (SN74LVC1G14) -> OVN; U122 (SN74LVC1G08) forms ARM_OK' = ARM_OK AND OVN, which replaces ARM_OK at both U114 inputs, so a cell above 4.35 V for 1.6-4.9 s, an open T22 or an unpowered BQ29200 forces /CE HIGH and holds ILIM_HIZ in every mode; firmware latches `CHG_PACK_OV` on the unexpected /CE-sense HIGH (FR-47). FR-46: same-transaction read-back of REG01:02 and REG05 after every VINDPM/IINDPM/ICHG write and before every P5/QUAL/EN_CHG rising edge. FR-40 corrected (VBAT_OVP follows VREG). New F.3/B.7 rows, T-F-17, T-B-25, T-A-01c | vreg-corruption-no-fixed-pack-ovp |
| r6-2 | **D-BT-SQ short detected in Idle and in service:** an ACK from 0x6B in Idle, or a BQ25798 VBAT ADC within 0.2 V of pin-25 V_batt after >= 1 s of regen-armed cruise, latches `CHG_DBTSQ_SHORT` (operator pack disconnect); F.3 row; T-D-15 (FR-48) | dbtsq-short-unfused-pack-on-vchg |
| r6-3 | **Battery-side copper on a 3.21 A basis:** A.8 restated (CR VCHG / W3-W4 tie / GND star >= 3.5 A; 1 oz fallback 2.0 mm); VBAT+ and GND header pins >= 2.0 A each; MB VBT path 4-wire Kelvin measurement before PM4 (T-A-06c) with a tinned-copper overlay branch; a thermocouple bonded under the polyimide sheet in PM4 and logged in T-F-16 | cr-and-mb-battery-path-copper-sized-below-ichg |
| r6-4 | **T-C-04 step 2 probes the MB end:** scope U101 IN, the C-D8 pad and pin 38 on a feed that reproduces the minimum MB capacitance; pass C-D8 node < 35 V, every VCHG-IN node < 40 V; D107 restated as protecting U101 only; H.5 MB-end row; fail branch = an RC snubber or more MB-side capacitance, never a low-VBR TVS and never more C102 alone | tc04-in-spike-criterion-omits-mb-vchgin-ratings |
| r6-5 | **C105 deleted (DNP footprint):** SLVSE94G §8.3.9 forbids an IMON bypass capacitor; R129/C129 remain the only filter; IMON calibrated at 0.3/0.6/0.9/1.7 A in T-B-14 and the FR-11 band set from the measured gain and offset at the window currents | imon-bypass-cap-against-datasheet |
| r6-6 | **FCC and RGN read through comparators:** U119 FCC_OFF (EN < REF/3, 3.30 MOhm pull-up, R134 DNP) drives FCCN for W, QQF and RFC_OFF; U120 FCC_ON and U121 RGN_ON (EN > 1.75-1.88 V, above VEN_R max 1.4 V) drive H2c, H1R and H1q; U105 sections 1 and 3 spare; pins 27, 29, 30, 31, 32 never `INPUT_PULLUP` (CSV rows, FR-01, FR-49 boot pad check); T-C-12/T-D-01 sweep 0.5-2.2 V and open taps | fcc-rgn-lvc-threshold-vs-rt1987-en-band |
| r6-7 | **Pins 38/39 over range:** above 29.3 V of source the pins exceed 3.3 V (14-52 uA of clamp current at 33-36 V); no FR-08/FR-30/T10 decision is taken from a pin reading at full scale, or within 5 ms after; BAV199 clamp fallback; bench test T-C-15 | pin38-39-adc-overvoltage-on-vmot-excursion |
| r6-8 | **Two time budgets:** a 1 kHz timer domain (FR-45, sole owner of the pin 38-41 / V_bus ADC acquisition, double-buffered) runs the feed-forward ramp, the FR-41(vii) deadline, the FR-14(d) shed, T3 and its raise worker, FR-08(a)/(b) timing, the FR-42 compare and the A-D step transitions; FR-27's 5 ms applies to `loop()` only; t_exec re-derived from T_TICK_MAX (4.0 ms; T_HANDOFF_MAX 27.4 ms, margin 17.6 ms, PURGE_EARLY_MAX 55 ms unchanged, T_BACKSTOP >= 77.4 ms); T-C-09 latency rows | loop-budget-5ms-breaks-1ms-tick-deadlines |
| r6-9 | **Rescue predicate without the fixed 0.2 V/ms floor:** SAG_FLOOR[C_VMOT] (provisional 0.005 V/ms, static_assert < the survivable rate), slope measured after the step-2 shed, V_bus at the evaluation tick; an H2c/V_bus < 14.16 V classification is always refused at 0.97 mF; `PURGE_RESCUE_ENABLED 0` until T-F-07/T-F-07b and T-E-01 pass, so each in-window early purge is a State 99 meanwhile; the bags' 0.02 A is withdrawn as a measurement; new T-F-07b (close transient at the bag deltas) | purge-fc-only-ridethrough-bag-evidence-reopen |
| r6-10 | **`chg_src` gated on braking and auto-zeroed:** regen only while braking (or H1 rb HIGH), against a learned offset + slope baseline of V_rgn - V_bus (learned in VFWD regulation, VESC \|I_in\| < 0.5 A); sub-threshold braking charge to a third counter `chg_q_mixed_mc`; `uncal` before convergence; T-E-05b, T-B-12 VFWD bound | chg-src-misattributes-subh1-regen-reopen |
| r6-11 | **Reversal headroom is a BRAKE-exit close only (Option A):** G stays the sole admission test; F.3 item 5, F.4, FR-14(a), FR-41(viii), H.21 and J.2 item 32 aligned; host tests pin it | ff-headroom-admission-contradicts-single-g-test |
| r6-12 | **Reversal hold completes on the write ACK** (deadline 1.0 ms at 400 kHz, 1.5 ms at 100 kHz, + the T-B-24 settle); the read-back is checked on the next tick before any further raise; fallback-induced closes counted | ff-reversal-hold-unattainable-at-100khz |
| r6-13 | **Coordinate convention stated (Eagle, top view, +y up);** PM0 imports the `.brd` and copies the CHG footprint; scripted pin-identity gate `calc/pin_identity_check.py` and a physical punch-through print check in T-A-06; outline chamfer at the pin-11 corner | cr-coordinate-convention-mirror-ambiguity |
| r6-14 | **EIB E-pad row re-ordered and lead maxima re-derived** from a drawn placement (SLUUCB5E Fig 4-1 scaled): E8 - E3 E4 E2 - E7 - E1 - E5 E6; per-lead pass/fail with criticality classes in T-A-02/T-A-06 | eib-e-lead-max-lengths-geometrically-infeasible |
| r6-15 | T-A-05 J101 region restated (x 37.0-44.5, y 42.13-51.53 = 7.5 x 9.4 mm) | t-a-05-stale-j101-region-dims |
| r6-16 | A.6: W2 lands ~8 mm from pad 14; a >= 2.5 mm L1 GND pour W2 -> pads 14/15 outside the analog divider bottoms, checked in T-A-06 | a6-w2-not-beside-star-pads |

**Round 4 r7 (this revision), from the operator's 2026-11-10 constraint change** (the carrier may extend sideways past the
footprint) and the round-4 calculation H.23 (`round4/calc/r7_calc.py`). Superseded r6 text stays in place, marked inline. The
Source column names the constraint change, the H.23 row, or the finding key of an error that r7 corrects:

| # | Change | Source |
|---|---|---|
| r7-1 | **Carrier outline extended:** r7 outline = r6 rectangle + tab X (x 48.70-65.00, y 56.30-68.30) + tab Y (x 17.70-37.56, y 67.14-76.00), 1394.06 mm², bounding box 47.30 x 41.86 mm; tab Y trimmed clear of ROP1-FC (0.501 mm) and L-FC (0.862 mm to the 12.9 mm Eaton body, TODO(verify: Eaton HCM1A1305V3 drawing)); no MB part under either tab; pin-11 chamfer relocated to (17.70, 76.00); the three concave tab-root corners take the fab router radius (MS8); the r6 31.0 x 33.0 mm outline is superseded (A.1, A.7, D.1 PM0) | constraint change; H.23(a), H.23(b) |
| r7-2 | **Far-end feet fitted by default:** FT1 4.0 x 1.6 mm at (61.72, 66.705) under tab X, FT2 4.0 x 4.0 mm at (28.00, 73.250) under tab Y, PA66/PBT, h_f 2.19 mm (+0/-0.05 mm; **superseded in r7:** h_f 2.24 mm with an unstated bond line); each foot is bonded to the CR underside with 0.05 mm acrylic transfer tape and gap-checked dry before the 22 MB joints (PM4 (2d), bed 0.15-0.45 mm), then bedded on a flowable alkoxy-cure RTV (nominal 0.30 mm) after them; FT2 is bedded through a 1.0 mm fill hole; worst pin under a 10 N tab X tip push 2.69 N without foot, 0.52-1.99 N with foot (ORDER OF MAGNITUDE); the relaxed 4 x 4 mm FT1 spot is an operator option only; the feet are fitted by operator ruling, with the rationale and the FT2 decision rule in A.7 (A.7, D.1 PM4, E, J.2 items 55 and 58) | constraint change; H.23(i) |
| r7-3 | **Polyimide sheet kept** and cut to the r7 sheet outline: r7 outline + 1 mm, trimmed to >= 0.5 mm from every MB part body and MB pad at CO-5V, J-NTC, L-FC, OP-FC and ROP1-FC; 29 vertices, 1554.6 mm², bounding box 49.30 x 43.86 mm (A.7, D.1 PM4, E) | H.23(m) |
| r7-4 | **Bottom clearance rule:** every CR bottom-side courtyard stays >= 1.0 mm in plan from every non-GND MB layer-1 feature (measured on copper rims) and from every MB part box, on the footprint and both tabs; it replaces the r3 MB power-copper shadow (+1 mm) and the named bottom keep-out x 24.5-36.0, y 48.5-53.5; bottom area 569.1 mm² (footprint 391.6 + tab X 44.3 + tab Y 133.2) (A.7, D.1 PM0, H.18, T-A-06) | constraint change; H.23(d) |
| r7-5 | **Layer count and allocation:** the 4-layer 1.6 mm build is unchanged; R175 and the 0.1 % divider resistors R109, R110, R111, R112, R114, R115 move to the top, and C106, C107, C108 and C140 stay on the bottom; the comparators U102-U104, U115, U119-U121 move to the footprint low-y band (the freed r6 tap-field area), and the six 0.1 % dividers sit in the footprint interior directly above it, in the divider strip x 23.15-36.50, y 42.14-45.69; the LVC gates U105, U106, U107, U110, U114, U116 and U118 go to tab Y top and U108/U109 to the footprint interior (new in r7; r6 gave the gates no region), each with its 100 nF decoupler directly underneath on the bottom; U111, U113, U122, U123, D104-D106 and D108 sit in the footprint interior; per-region top booking: band 69.5 %, interior 63.2 %, tab X 52.5 %, tab Y top 73.45 %, tab Y bottom 29.4 %, each <= 75 % (H.23(e2)); top 73.55 % (795.1 mm²), bottom 69.04 % (392.9 of 569.1 mm²); the r6 "~678 of ~881 mm²" booking and its 95-103 % use of the strict usable area (A.8) retire; the farthest outline point is 25.66 mm from the U101 loop against 36.5 mm for 2-layer parity (A.8, H.23(f)) | H.23(e), H.23(e2), H.23(f) |
| r7-6 | **Tap field moved to tab X; T18 on the footprint:** 20 pads on a 6 x 4 grid at 2.54 mm on tab X plus R175; residual pads F08 (T22), F09 (T8), F10 (T9) and F22 (T18) on the footprint low row y 35.80; F22 at (41.68, 35.80), 10.54 mm to CO-5V pad 1, joint 0.172 mm from the REG-5V box (F101/R172 derating check in T-A-05); straight-length sum 1308.0 -> 859.3 mm (-34.3 %), 898.7 mm dressed (-31.3 %; **superseded in r7:** 895.5 mm with the review-7 low-edge lane of T8, which calc revision 4 found infeasible, A.4); the assignment keeps the A.8 adjacency exclusions and has an adjacent-pad short table; tab X wires take the A.4 gap path (**superseded in r7:** 850.9 mm (-34.9 %); dressed toward +y until x > 63); the A.4 maxima stay upper bounds (A.4, A.8, B.8, D.1 PM6/PM7, H.20) | constraint change; H.23(g) |
| r7-7 | **Thermal band:** the part of tab X within 6.4 mm of the MB 5V copper rim (boundary y 60.5-62.34, 84.9 mm²) carries only pads, wires, the RTV bead and temperature-insensitive passives; MS4 confirms the split (A.7, T-A-06) | H.23(h) |
| r7-8 | **EVM mount on the EVM plate:** the EVM rests on its stock bumpons on an insulating plate, held by edge clamps with silicone pads; no drilling and no bond to EVM copper; the EIB stands on its two M3 nylon standoffs on the same plate (one mounting plate; the bumpons allow 0.03-0.12 mm of E-lead relative motion at 30 g, ASSUMED materials, and lateral stops with <= 0.3 mm play per axis bound it; each bumpon compresses <= 1.0 mm under the clamps); EVM copper to plate and chassis > 1 MOhm (T-A-02, repeated after the vehicle run in T-F-18b); the four EVM M3 standoffs are deleted; plate, clamp and stop geometry TODO(design: from MS2, MS5 and MS7) (A.1, A.7, C EM23, E, J.2 item 54) | constraint change; evm-corner-circles-are-fiducials |
| r7-9 | **EVM reference placement, corridor fallbacks and W-lead maxima:** EVM plate past the MB +y edge, EVM x -0.40-88.50, 4.97 mm from the Teensy USB corridor; corridor fallback (i) (EVM and EIB shifted -x by 27.03 mm) passes and needs 45.3 mm of chassis room past the MB -x edge; fallbacks (ii) and (iii) fail; MS2 decides; W leads keep the 0.30 m cap until MS2; the A.3 W-lead dressing path with RTV beads, MB tie bases A1/A2 and a polyimide strip (r7 review 7); spans <= 30 mm between anchors; W1/W2 fixed at 0.30 m +- 10 mm (D-F3); after MS2 W3 200, W4 200, W6 140, W7 SCL 160, W7 SDA 160 mm (fallback (i) 190/190/150/190/200 mm); W5 the fixed 304.8 mm cable with a 222.7 mm minimum fit, routed around the W3/W4 channel; J.2 item 62; **review 7 close (calc revision 4, D-H):** the 10 mm switched-conductor rule is applied as a 3-D distance with spacer heights, S1 and S2 move, and the chassis tie closes the last span, <= 2.4 / 16.4 / 17.4 mm past the MB +y edge (A.3, A.7, H.11, T-A-02, J.2 item 57) (r8: the B1R wedge, the B3 post and the W5-on-trunk stack, r8-8 and r8-9) (**superseded in r7:** the route rule after MS2: W1 230/260, W2 240/270, W3 180/170, W4 180/170, W6 110/120, W7 SCL 140/180, W7 SDA 130/170 mm (reference placement / fallback (i)); W1/W2 15.66 mOhm and W3/W4 7.54 mOhm at the reference route maxima against 19.99 and 12.57 mOhm at 0.30 m; chassis tie at the MB +y edge, 29.744 mm from the tab X top edge; W5 dressed toward +y over tab X) | constraint change; H.23(l) |
| r7-10 | **E-lead maxima, JP21 pin 1 and R276:** the unchanged r6 rule re-runs on the SLUUCB5E rev E vector positions: E8 20, E3 25, E4 30, E2 35, E7 40, E1 90 (r6 85), E5 65 (r6 60), E6 60 mm; JP21 pin 1 is the lower square post (75.312, 64.769) EVM mm, and the r6 point (902, 408) px is pin 2 (AGND); R276 10.0 ohm 1 % 0603 (CRCW060310R0FKEA) in series with E1 at the EIB E1 pad damps the E1/E8/C205 resonance (1.430 MHz at 90 mm; undamped Q 19.1, an upper bound, about 13.0 with skin effect; 0.111 with R276); static drop 1.02 mV held, worst 3.96 mV, release level 1.786 mV lower = IINDPM 2.23 mA lower (the safe direction for the converter and the eFuse; 0.13-0.17 % of the 1.33-1.76 A regen clamp, so no H.7 effect); without R276 the E1 loop current also shifts EIB AGND through the shared E8 return (20-31 mV per 10 mV of REGN ripple, 0.17 mV with R276); T-C-16 with an abort limit and a 0.2 ratio criterion (A.5, A.9, B.6, B.8, C EM5; H.22(i) is superseded by H.23(k)) | H.23(k); jp21-pin1-is-lower-post |
| r7-11 | **EIB merge onto the CR not adopted:** every r6 fail-safe argument stays on the EIB as built (EIB, W5 pin list, U203/U204, R272/R272b, E8/R273); the G1 island merge (EVM within 10-60 mm of a CR edge on one rigid co-mount) and a mezzanine over the MB are recorded as options for a later round (B.6, J.2 items 60 and 61) | constraint change |
| r7-12 | **MB vias not tented:** 368 of 368 MB vias have a 0.9596 mm stop-mask opening; the A.7 "16 tented GND vias" is superseded; the polyimide sheet and the bottom clearance rule cover the exposed via rings, and the L4 mask keeps the tab undersides off them (A.6, A.7, T-A-06, T-F-12) | mb-vias-not-tented; H.23(c2) |
| r7-13 | **r6 sheet over CO-5V:** the r6 sheet outline (outline + 1 mm) overlapped the CO-5V body by 0.400 x 3.700 mm (1.48 mm²), a drape onto the tantalum against the r5 rule "cut-outs, not a drape"; the r7 sheet trims fix it and the J-NTC clearance (A.7, D.1 PM4) | r6-sheet-overlaps-co5v; H.23(m) |
| r7-14 | **E1 load statement corrected:** E1 feeds R252, R254, R271 and the release feed through Q203/R255; of the H.15 "REGN pull-ups R254/R272/R272b" only R254 passes through E1, and R272/R272b sit on the EVM (A.5, B.6, H.15) | e1-load-misattributed |
| r7-15 | **Tap lengths from the `.brd` pads:** the r7 tap lengths run to the MB pad centres from the `.brd` (for example C-D6 pad 1 and SNS-BT pad 15), not to the part centres (A.4) | tap-points-from-brd-pads; H.23(g) |
| r7-16 | **Build procedure, BOM and records:** PM0 captures on the r7 outline with the bottom clearance rule, the foot keep-outs and the FT2 fill hole; PM1 records MS1a first, then MS1b and the MS6 CHG-hole thickness after the removal; PM3 notes C-D2 2.181 mm from tab X; PM4 keeps the W1-W4 joints in step (2b), bonds the feet in (2c), supports both tabs while the 22 MB joints are soldered, beds and cures the feet in (5), and fits the W-lead dressing, W5-W7 and the taps in (6); E adds R276, the EVM plate and the feet (total about USD 505-590; **superseded in r7:** about USD 520-630 after review round 7, which adds the foot transfer tape, the bed RTV and the W-lead anchors, spacers and strip, E); the D.4 record gains the tabs, the feet and the r7 sheet; D.3 has no IO CSV change (D.1, D.3, D.4, E) | constraint change |
| r7-17 | **Tests and open items:** T-A-02, T-A-05, T-A-06, T-A-06c, T-F-12 and T-F-16 changed; new T-A-08 (pre-capture survey MS1-MS8; MS1a is taken before PM1 because the module must be fitted, and it gates nothing (D-H); gate D-2 and the MS2 lid clearance retire; the MS6 reading at the CHG holes gates PM4, the other items gate PM0; J.2 items 46-63) (**superseded in r8:** MS1a gates PM1), T-A-09 (foot fit and bond check), T-C-16 (E1/C205 ring with and without R276), T-C-16b (comparator band pickup from the MB BT boost and the VCHG-IN hard short) and T-F-18 (tab vibration and joint integrity) with T-F-18b (EVM plate retention and E-lead joints after the same vehicle run); J.2 items 46-63; K gains the round-4 sources (I, J.2, K) | constraint change; H.23 |
| r7-18 | **Proposals for files this design does not edit (new D.5):** CLAUDE.md gains the D.4 record only once built; no `teensy_controller.ino` change; one WORK_QUEUE.md item for MS1-MS8 with their gates; no IO CSV change (D.5) | constraint change |

**Round 4 r7, review round 7 and its close** (60 verified findings: 33 confirmed and 27 partially confirmed, 0 refuted, none a
blocker; by the verifier's severity 10 major and 50 minor; 7 nits unverified and applied as well; dispositions D-F1 to D-F7 and
D-H in `round4/work/r7_review7_dispositions.md`; the close re-ran `round4/calc/r7_calc.py` as revision 4; dispositions that
differ from the finding as written are in section L.7):

| # | Change | Finding keys |
|---|---|---|
| rv7-1 | **Feet, controlled bond and gated bed (D-F1):** each foot is taped to the CR with 0.05 mm acrylic transfer tape, h_f 2.19 mm (+0/-0.05 mm); the t_bed tolerance budget (header body, CR bow, block, tape) is printed (FT1 RSS 0.171-0.529 mm); PM4 (2d) dry-seats the CR before the 22 joints with 0.05 / 0.15 / 0.45 mm feelers; bottom-silkscreen outlines, an FT1 axis tick and an FT2 locating pin place the feet; PM4 (3) is an ordered fixture procedure; the beds use a flowable alkoxy-cure RTV only (no oxime, no acetoxy, no paste), and FT2 is filled through its hole until a witness shows at three faces; T-A-09 pulls 0.4 N at each grip; the taps over FT1 are soldered last and FT1 is re-checked; the feet effect is stated (7-21 % worst-pin cut at 30 g, ORDER OF MAGNITUDE), and the propped first modes are labelled as neither bound; T-A-06 gets an FT1/FT2 exception to its air rule (A.7, D.1, E, H.23(i), I) | foot-height-stackup-unbounded, foot-height-ignores-cr-side-bond-line, foot-bed-stackup-omits-bond-line, foot-bond-thickness-assumption-dropped, foot-placement-no-locator-or-check, foot-placement-tolerance-no-aid-no-test, bed-injection-process, ft2-bed-uninspectable-and-unfillable, rtv-bom-admits-oxime-cure, ta09-pull-overloads-psa-path, feet-not-justified-by-own-numbers, vibration-figures-not-bounds, tap-pads-over-ft1-soldered-after-bond-check, tap-soldering-over-ft1-after-ta09, pm4-seating-fixture-undefined, pm4-step3-props-unspecified |
| rv7-2 | **W-lead dressing path and anchors (D-F2):** a trunk across tab Y to the MB tie base A1 replaces the straight segment to tab X; every W lead keeps >= 2 mm in plan from the pin-10 joint, the IN strip, the U101 courtyard, the +x pocket, every post tip and every tap pad, and none lies over tab X; the pin 7-10 tips get an RTV dome or a Kapton patch; the anchor rule (<= 30 mm between anchors along the lead) with the RTV beads B1/B3, the W5 spacer beads S1-S3 and the MB tie bases A1/A2 replaces the 30 mm chassis-tie rule; a polyimide strip covers the MB parts and the untented non-GND vias under the leads; MS3 covers the W-lead path (A.3, A.7, D.1 PM4, E, I T-F-12) | w-leads-cross-unfused-vchgin, w-leads-and-ribbon-cross-pin10-vchgin-post, w-lead-unsupported-span-over-mb, chassis-tie-30mm-unbuildable, chassis-tie-30mm-unachievable, chassis-tie-0p02mm-margin-untested, chassis-tie-margin-0p02mm, w1-w4-over-tap-field, w-band-over-mb-bodges |
| rv7-3 | **W5 and the USB corridor (D-F2):** W5 is the fixed 304.8 mm factory cable; its route is a minimum-fit check (222.7 mm with a 20 mm 3-D allowance), and the slack is a service loop anchored on the EVM plate; the corridor width is the Teensy receptacle silkscreen, and MS2 measures the plug overmold; W5 runs around the 4.97 mm W3/W4 channel over the EVM plate (A.3, A.7, H.23(l), J.2 item 57) | w5-cable-exceeds-route-max-untested, w5-build-max-semantics, w5-w3w4-channel-and-crush, usb-corridor-width-is-receptacle |
| rv7-4 | **W1/W2 fixed at 0.30 m +- 10 mm (D-F3):** a lead cut to its route raises the hard-short IN-side spike to 34.4 V (199.5 mm) or 34.9 V (181.6 mm), against 32.8-32.9 V at 290-300 mm and the D107 VBR(min) of 36 V; the slack is an anchored service loop; W3/W4, W6 and W7 take their route maxima after MS2 (A.3, H.23(l)) | hard-short-shorter-w1w2-not-bounded |
| rv7-5 | **Tab X tap assignment and dressing (D-F4):** the assignment minimises the straight-length sum under six adjacency exclusions (none violated); an adjacent-pad short table names the consequence and the detector of every pair; the dressed lengths run on the legal gap path, and the LM1084 crossing is tested for every tap; T8 takes a dedicated lane; T-F-12 states attainable tap-isolation criteria; PM3 routes the T2 wire on the gap path (A.4, A.8, D.1, H.23(g), I) | tabx-tap-pad-adjacency-unanalysed, tap-adjacency-hv-taps-next-to-teensy-pins, dressed-length-path-crosses-pads, a4-dressing-rule-vs-calc-path, t8-residual-tap-crosses-lm1084-misreported, t8-crosses-lm1084-unflagged, tf12-r7-tap-isolation-criterion-unattainable, pm3-t2-away-from-tab-x-contradiction |
| rv7-6 | **Per-region booking (D-F5):** H.23(e2) books the footprint low-y band, the footprint interior, tab X and tab Y (top and bottom) against 75 % each; the band keeps the comparators and the residual pads, the 0.1 % dividers sit in the interior divider strip, and U109 and then U108 move from tab Y to the interior; the gate decouplers sit underneath on tab Y bottom; the band's distances to the MB BT boost and the 5V copper are printed, and T-C-16b measures the pickup; MS4a (the CO-5V joint) and MS4b (the band end) are added, with the R175 and F101/R172 derating in T-A-05; the T-A-06 L4 mask criterion admits the bottom-side pads (0.3 r7-5, A.8, H.23(e2), H.23(f), I) | low-y-band-overbooked, r7-table-omits-tab-y-allocation, comparator-band-near-mb-bt-boost, thermal-rule-misses-comparator-band, r175-thermal-band-no-derating, ms4-survey-misses-co5v-joint-and-comparator-region, f101-r172-derating-input-not-measured, ta06-l4-mask-criterion-contradicts-bottom-parts, t-a-06-l4-mask-criterion-single-sided |
| rv7-7 | **E leads, EIB and EVM plate (D-F6):** T-C-16 gets an abort limit and a criterion tied to the prediction, with the E8 shared-return pickup booked against the E3/E4 budgets; E1 takes a bent route below U1 and L2 (70.8 mm against 90 mm); Kapton covers the E-pad joints against the USB corridor; the EVM and the EIB share one plate (not one rigid body), with a retention specification, lateral stops and the T-F-18b re-check; the G1 distance rationale is re-quantified; the one-sided R276 effect on regen absorption is stated (A.5, A.7, B.6, H.23(k), I, J.2 item 60) | r276-shared-e8-budget-tc16-criterion, tc16-bridged-run-no-abort-loose-pass, e1-dressing-vs-90mm-and-fault-limit, eib-epads-inside-usb-corridor-band, evm-eib-not-one-rigid-body, evm-plate-mount-untested-in-vibration, g1-distance-rationale-misquantified, r276-safe-direction-one-sided |
| rv7-8 | **Procedure and documentation (D-F7):** the T-A-08 gates are ordered so that none is circular (MS1b after PM1 gates nothing; MS6 at the CHG holes gates PM4), and MS2 has a pass criterion; MS5 and T-F-18 get measurable criteria and an accelerometer mass limit; the supporting-files table is complete; the superset claim of the bottom clearance rule is corrected; the sheet trims also clear the MB pads by >= 0.5 mm; small numbers, the JP21 post and the PM3 C-D2 reference are corrected (A.7, D.1, H.23(m), I, J.2) | ta08-gates-circular-or-unexecutable, ta08-ms2-no-pass-criterion, ms1-mass-after-removal-gates-removal, ms5-tf18-criteria-not-measurable, tf18-accelerometer-mass-loading-and-soft-criteria, supporting-files-table-incomplete, bottom-rule-superset-claim, sheet-trims-ignore-pads, procedure-ste-and-measurement-nits, pm3-cd2-distance-wrong-reference, stale-jp21-bottom-terminal-and-small-number-drift |
| rv7-9 | **No height limit (D-H, operator statement 2026-11-10):** the 13.14 mm Ag105 envelope and the lid clearance stop being limits; the stack top becomes information (H.23(j)); gate D-2 and the MS2 lid item retire, MS1a keeps the standoff reading, and J.2 item 59 closes; every rejection that rested on height is re-assessed on its remaining reasons, and each stays rejected (A.7, J.2 item 61) | w5-stack-height-fails-by-construction |
| rv7-10 | **Close of review 7 (calc revision 4):** the 10 mm switched-conductor rule is applied as a 3-D distance with spacer heights (trunk jacket bottom >= 10.14 mm and W5 ribbon bottom >= 10.735 mm above the CR top; J.2 item 62); S1 and S2 move clear of the J101 region and the W3/W4 jacket (longest span 26.0 mm); the chassis tie closes the last span (<= 2.4 / 16.4 / 17.4 mm past the MB +y edge with a 2 mm margin); the cut-outs clear their own pads by 0.5 mm, and the 2.2 mm relief holes stay (3.4 mm holes merge into slots); T8 takes the upper lane (89.2 mm; a low-edge lane is infeasible by 0.59 mm); the open adjacent pairs are computed, and the extended exclusion set goes to a ruling (J.2 item 63); the E1 route distances come from the calc; the E total becomes about USD 520-630 (A.3, A.4, A.5, A.7, A.8, D.1, E, H.23, I, J.2) | close round, no finding key |

**Round 4 r8 (this revision), from the final independent audit run 001** (`docs/reviews/charger-design/run-001-2026-11-10.md`, ledger
`docs/reviews/charger-design/ledger.md`; 13 adjudicated findings, 0 blocker, 3 major and 10 minor, and CHG-R1-W01 from the round-4
walkthrough; `round4/calc/r7_calc.py` revisions 5 and 6; superseded r7 text stays in place inside "superseded in r8" markers; the
dispositions that differ from the finding as written are in section L.8):

| # | Change | Finding |
|---|---|---|
| r8-1 | **R106s 1.00 kOhm 1 % between U101 FLT and the F17 pad:** an F05-F17 or F06-F17 bridge drives at most 3.377 mA into FLT (0.338 of the 10 mA absolute maximum, SLVSE94G §6.1), and the EN net stays >= 3.017 V, so the switch follows its command and the fault is masked while that EN is HIGH; FLT LOW readback = V_OL + pull-up drop, 0.153 V typical / 0.325 V maximum (H.23(n)); the A.8 rows and the A.8 placement rule, B.4, B.8, E, the A.4 T16 row and the new test T-C-05c | CHG-R1-01 |
| r8-2 | **FR-23 exception EX2, the bounded FLT-LOW diagnostic read:** one REG1B read when FLT reads LOW and V_chg > 10.2 V for > 250 ms (tCL_PLIM 202 ms maximum, SLVSE94G §6.6); NACK expected; ACK with VBUS_PRESENT_STAT 1 latches the carrier fault; the unreachable r4 plausibility rule and the F.3 T16-open row are superseded; new F.3 bridge row, H.21 row and FR-22 (xxx) | CHG-R1-01 (A-01) |
| r8-3 | **T3 write-first, read-back-after exception in G.1 and FR-46:** the REG06:07 and REG03-05 raise writes complete 1.359 ms (100 kHz) / 0.565 ms (400 kHz) after the edge, against 1.5 ms; the read-back follows as four field reads, each inside the FR-07 cap; a mismatch takes the immediate P5-LOW path; H.16 recomputed from the published schedule (H.23(o)); no V-MOT peak is published; T-C-06 adds the 100 kHz run and the ISR latency; FR-22 (xxxiii) | CHG-R1-02 |
| r8-4 | **FR-43 split into `flashWriteAllowed` and `sdOpAllowed`:** flash is admitted with FC_BUS LOW or in battery-supported Idle (BT_BUS HIGH with its EN read back HIGH, BT_REG HIGH, V_bus >= `V_BUS_CHARGED_THRESH`, `busHotPlugUnsafe()` false, selector disarmed, no cut), never in State 99, and never through `fcPurgeExposure()`; SD close and sync have their own gate, which admits State 99 phase 3; G.3, J.2 item 33, the FR-43 host tests, T-W-01 and T-W-02 | CHG-R1-D01 |
| r8-5 | **W1/W2 wire specified:** 20 AWG stranded copper (19/32 or 7/28), insulation OD 1.60-1.75 mm, twisted at a 20-25 mm pitch with the jackets touching; L' 0.399-0.661 uH/m from (mu0/pi) acosh(s/2a); IN peak 33.79 / 33.64 / 33.51 V at 290 / 300 / 310 mm (margin >= 2.21 V to 36 V); thin-wall PTFE (38.23 V) and 600 V-class insulation (plan rule) excluded; "no pair reaches 36 V" limited to the modelled envelope; A.3, B.4 (D103), H.5, H.23(l), E, T-A-02, L.7 | CHG-R1-D04 |
| r8-6 | **FR-23 exception EX1, the FR-12(b) Idle probe:** one address poll in State 1 with every charger path LOW; NACK ignored; on ACK, the ADC_EN one-shot write, the REG3B read, then ADC_EN cleared and REG2E read back; FR-22 (xxii) and T-D-15 through the production gate | CHG-R1-03 (A-07) |
| r8-7 | **T1 step 8b split, new step 8c:** after the heartbeat exercise, P5 rises with QUAL already LOW, so CLR = P5N clears QQ (pin 33 LOW within 5 ms); end-of-T1 check of P5, /CE sense, EN_CHG, QUAL and pin 33; T1 budget ~0.58-0.73 s (+128.5 ms, H.23(y) row (7); **superseded in r8:** +126.7 ms, H.23(x)); T9 inherits it; T-F-03 extended; T-C-10 to the P5 rise; FR-22 (xxxii) | CHG-R1-04 (A-03) |
| r8-8 | **B1R wedge and the CR-end strain relief:** a machined insulating wedge (x 23.55-26.05, y 62.54-67.10, 65 deg ramp face, apex 9.78 mm above the CR top) replaces the B1 bead; B3 becomes a post 10.7 mm above the CR top; the r5 bead covers >= 5.0 mm of jacket on the copper and on along the ramp; full-profile minimum margin 0.504 mm (H.23(s)); interior booking 64.0 %; A.3, A.8, D.1 PM4, E, T-A-06, T-F-12 | CHG-R1-D03 |
| r8-9 | **W5 above the trunk:** W5 rests on the trunk with RTV from (28.70, 64.01) to A1; trunk 14.965-19.850 mm and W5 19.850-20.750 mm above the MB at the B3 level; stack top 20.750 mm, information under D-H (H.23(t)); A.3, A.7, H.23(j), PM4 (6), T-A-06, T-F-12 | CHG-R1-W01 |
| r8-10 | **Foot-bond fallback:** a re-made foot h_f' = 2.19 mm + the measured removed stack t_rm (film + PSA; 2.315 mm at 0.125 mm), the PM4 (2d) gate repeated, the decision moved before soldering by the T-A-09 step 0 bond coupon, FT2 repair access after soldering limited to an RTV re-bed through the fill hole (H.23(r)); PSA thickness TODO(verify); A.7, PM4, T-A-09, J.2 item 55 | CHG-R1-05 (A-04) |
| r8-11 | **FR-12(b) split into (b1) stuck-path test, (b2) discharge wait and (b3) Idle probe:** (b1) V_chg < 12.0 V once both EN read-backs have been LOW for >= 0.5 s, a proposed criterion, TODO(verify: T-C-04) (0.183 s at the typical IQ(ON), no datasheet lower bound, H.23(q); **superseded in r8:** "worst case 0.183 s with the eFuse enabled"); (b2) no pass/fail on time, 5 s timeout (3.695 s worst case, H.23(x)); T-C-04, T-F-02, H.21, FR-22 (xxxi), J.2 item 65 | CHG-R1-D02 |
| r8-12 | **T-B-16 waveform:** 0.6 s at max(ICHG, 3.21 A) and 1.4 s at the 1.6 A FC-window ICHG (30 % duty), an optional run B at 60 % recorded separately, T-F-16 synchronised, the waveform and the TDIE < 100 C criterion labelled as qualification choices (J.2 item 64); H.14 note | CHG-R1-08 (A-05) |
| r8-13 | **Superseded markers converted:** at each listed location the live text is the current instruction and the marker holds the old text (A.1, A.3, A.4 heading, A.5, A.7, B.4 D103, C EM5/EM23, D.1 PM0/PM4, D.4 record, E CR PCB, sheet and cost lines, 0.3 r7-9 and r7-17 (verification round), H.5, H.11, H.22(i), H.23(l)/(m), T-A-02, T-A-06, T-C-04, T-F-12, J.2 item 47); the rev-2 W-lead tables are labelled history; a marker converted in r8 carries the label "superseded in r8" whichever revision first withdrew the text it holds, and a marker that r8 did not touch keeps its own label | CHG-R1-06 (A-06) |
| r8-14 | **Hand calculations moved into the calc:** E1-E8 distances (H.23(u)), the E8 pickup with and without R276 (H.23(v)), the closing-pass figures (H.23(w)) and the r8 integration figures (H.23(x)); the T-C-16 abort ratio now uses the built E1 length (17.80 at 85 mm, 9.20 at 90 mm) | CHG-R1-07 |
| r8-16 | **Verification round (r8):** the F17-F15 bridge level is undefined with R106s (A.8, T-C-05c step 8, H.23(y) row (1)); the FR-07 queue-priority rule for a posted raise, FR-41(iii), FR-22 (xxxiii) and T-C-06 (H.23(y) row (2)); FR-43: no State-99 exit to Idle in production, so a commit requested in State 99 is lost at the reset (T-W-01, J.2 item 33, T-C-06); B.4 D103 criterion (4), a 130 A pulse for <= 1 us (H.23(y) row (3)); the FR-23 exceptions renamed EX1/EX2 (the EVM leads keep E1/E2), at most four transactions after the EX1 poll and a fixed T_ADC_ONESHOT wait, at most five per EX2 episode; T-F-03 brake and fail branch, FR-04 step 8c, the T1 increment 128.5 ms (H.23(y) row (7)); B1R lateral support by the bound bundle (A.3, PM4 (6), T-F-12, H.23(y) row (4)); W5 rests on the trunk only from (28.70, 64.01), its margins located, the FT2 re-bed releases W5 (A.3, J.2 item 62, D.4, T-F-12, T-A-09, H.23(y) row (5)); J.2 item 55 coupon mandatory, t_coupon, a mask block on the coupon, PSA residue removed (T-A-09, PM4 (2c)); IQ(ON) 1.38 mA is typical, T-C-04 in the ON and latched states, the stuck-path figures in order, FR-20 `vchg_slow_decay`; T-B-16 and H.14 wording; 0.3 r7-17 marker direction; T-C-16 uses 25.6 at another built length (H.23(y) row (6)); markers that held r8 rationale now hold only old text; J.2 item 68 (f)-(i) | CHG-R1-01, -02, -D01, -D04, -03, -04, -D03, -W01, -05, -D02, -08, -06, -07 (verification round) |
| r8-15 | **TPS26630 datasheet local:** `references/Datasheets/tps2663.pdf` (SLVSE94G) is cited in K and wherever SLVSE94G values are used; item closed | CHG-R1-A02 |
| r8-16 | **Records:** D.4 record and D.5 proposals gain R106s, B1R and the W1/W2 wire; BOM lines for R106s, the B1R wedge, the B3 post, the W1/W2 wire and the bond coupon; J.2 items 64-68; supporting files, 0.2, 0.4 and L.8 | integration |

### 0.4 Review-design loop

Round 3 r0 was self-reviewed in three passes (safety, electrical, integration). Round 1 of the independent review then
produced 53 findings (about 45 distinct issues), each verified against the primaries by a second agent. All were found real.
All are applied: most as written or as amended by their verifier, ten with a different implementation, which section L
explains. Round 2 produced 44 verified findings (one blocker); all are applied (r2 table above), the differing
implementations are in section L, and the r2 closing pass re-ran `calc/r3_calc.py`, regenerated both SVGs and re-checked the
test-ID cross-references. Round 3 produced 34 verified finding keys (about 31 distinct issues, none a blocker); all are applied
(r3 table above), the differing implementations are in section L.3, and the r3 closing pass re-ran `calc/r3_calc.py` (new
section H.19), regenerated both SVGs and re-checked the FR and test-ID cross-references. Round 4 produced 32 verified finding
keys (about 31 distinct issues, none a blocker); all are applied (r4 table above), the differing implementations are in section
L.4, and the r4 closing pass re-ran `calc/r3_calc.py` (new section H.20), regenerated both SVGs and re-checked the FR and
test-ID cross-references. Round 5 produced 24 verified finding keys (about 20 distinct issues, none a blocker); all are applied
(r5 table above), the differing implementations are in section L.5, and the r5 closing pass re-ran `calc/r3_calc.py` (new section
H.21, H.11/H.14/H.15/H.18 re-booked), regenerated both SVGs and re-checked the FR and test-ID cross-references. Round 6 produced
16 verified finding keys (16 distinct issues, none a blocker); all are applied (r6 table above), the differing implementations are in
section L.6, and the r6 closing pass re-ran `calc/r3_calc.py` (new section H.22; H.8 lead table and the H.20/H.21 timing rows
re-derived), added `calc/pin_identity_check.py`, regenerated both SVGs and re-checked the FR and test-ID cross-references.
The closing consistency pass of r1 re-ran `calc/r3_calc.py`, regenerated both SVGs, checked every designator against the
EVM BOM and the MB part list, and checked that every test ID cited is defined in section I. What remains open is in
section I.

**r7:** round 4 began with a design phase, before any review round. It produced four fact-finding notes, three candidate
carrier layouts with an independent assessment of each, and the calculation H.23 (`round4/calc/r7_calc.py`). The notes are in
`round4/work/`, and the r7 table in 0.3 lists the resulting changes. The decisions are recorded in `round4/work/r7_design_basis.md`. The round-4 log, including review round 7, is `round4/review_loop.md`. **Review round 7** produced 60 verified findings (33 confirmed, 27 partially confirmed, 0 refuted, none a blocker; by the verifier's severity 10 major and 50 minor) and 7 unverified nits. All are applied (review-round-7 block in 0.3), and the differing implementations are in section L.7. The closing pass re-ran `round4/calc/r7_calc.py` as revision 4, applied the operator statement of 2026-11-10 that the MB and its PCBs have no maximum height (D-H), and applied the 10 mm switched-conductor rule as a 3-D distance (A.3).

**r8:** the final independent audit, run 001 of 2026-11-10 (`docs/reviews/charger-design/run-001-2026-11-10.md`), reviewed the r7 text in two rounds: a Codex review with finding-verifier agents and an independent first-pass reviewer, then a Codex counter-review in the same thread. It produced 13 adjudicated findings (0 blocker, 3 major, 10 minor) and seven adjacent items A-01 to A-07, each folded into one finding. The round-4 walkthrough raised one more finding, CHG-R1-W01 (the W5 and trunk vertical order). All 14 are applied in r8 (r8 block in 0.3). The agreed fix and its rejected parts in the run-001 adjudication table are binding; the dispositions that differ from the finding as written, and the choices that the agreed fix left open, are in section L.8. The r8 closing pass extended `round4/calc/r7_calc.py` to revision 6 (H.23(n)-(x); every revision-4 line unchanged), regenerated the three round-4 SVGs (R106s, the B1R wedge, the W1/W2 wire) and re-checked the test-ID cross-references of section I.

## A. Block diagram and wiring

### A.1 Assemblies

| Tag | Assembly | Notes |
|---|---|---|
| MB | Motherboard rev 20260622 with the Ag105 (`CHG`) removed | No trace cuts. Two divider-tap joints with series resistors R170/R171 (V-MOT, VBUS), one Kelvin tap at SNS-BT, two 0805 capacitor swaps, ROS removed (pin-7 tap), RSDA/RSCL changed to 2.7 kOhm; **a 0.125 mm polyimide sheet bonded over the MB area under the CR** (r3, PM4; **r7:** cut to the r7 outline + 1 mm with trims at CO-5V, J-NTC, L-FC and ROP1-FC, A.7, H.23(m)); **r6: one 30 AWG tap on BQ29200 pin 8 (net BAL-NOK) to the CR (T22, PM11), and a thermocouple under the sheet on the MB VBT trace (T-F-16)** |
| CR | **CHG adapter carrier** (r4: U101 rotated, 1.27 mm J101, 3V3 feed limiter R175), new 4-layer PCB on the r7 outline: the r6 rectangle (board x 17.70-48.70, y 34.14-67.14) + tab X toward the Teensy (x 48.70-65.00, y 56.30-68.30) + tab Y toward L-FC (x 17.70-37.56, y 67.14-76.00); bounding box x 17.70-65.00, y 34.14-76.00 = 47.30 x 41.86 mm, area 1394.06 mm² (H.23(a); A.7) (**superseded in r8:** 31.0 x 33.0 mm (board x 17.70-48.70, y 34.14-67.14)), 2 oz outer / 1 oz inner copper (4-layer build unchanged in r7), ICs on the top side, passives-only bottom side (<= 1.0 mm) inside the bottom clearance rule, which covers the footprint and both tabs (A.7, H.23(d)) (**superseded in r8:** outside a bottom keep-out and the MB power-copper shadow (A.7, H.18)); **r7: two fitted far-end support feet, FT1 (4.0 x 1.6 mm, centre (61.72, 66.705)) under tab X and FT2 (4.0 x 4.0 mm, centre (28.00, 73.250), bedded through a 1.0 mm fill hole) under tab Y, both non-conductive (A.6, A.7, H.23(i))**; 22 header pins (one 1x10 and one 1x12 strip) on the Ag105 footprint, 2.54 mm plastic body | eFuse with input bulk and TVS, **seven comparators (r6: + U119 FCC_OFF, U120 FCC_ON, U121 RGN_ON)**, permit logic with the **BQ29200 pack-OV term (r6: U122, U123)**, two monostables, top-side SMT tap pads F01-F24 (**r7:** 20 pads in a 6 x 4 grid on tab X; F08, F09, F10 and F22 on the footprint; A.4); keep-alive and FC-current-shed footprints DNP; **outline chamfer at the tab Y -x/+y corner (17.70, 76.00)**, the only chamfered corner and on the pin-11 side (r7, H.23(a)) (**superseded in r8:** r6: outline chamfer at the pin-11 corner (17.70, 67.14)) |
| EIB | **EVM interface board**, fabricated 2-layer PCB, **36 x 24 mm** (r3, H.18b: 30 x 22 mm was 84 % full), on two M3 nylon standoffs on the EVM plate, so the EIB and the EVM share one mounting plate; the bumpons allow a small relative motion, bounded by lateral stops (r7; A.5, A.7) (**superseded in r8:** on two M3 nylon standoffs on the chassis), just off the EVM's right edge (beside TP33/TP49/TP38); layout table in A.9 | U201 SN74LVC3G06, U202 SN74LVC1G06, U203/U204 TLV3012B, Q201-Q203, release and FC-leg resistors, R273 10 ohm ground link, R274 10 kOhm 3V3 bleed; **r7: R276 10.0 ohm in series with E1 at the EIB E1 pad (A.5)** |
| EVM | TI BQ25798EVM (BMS034A/B-003), SLUUCB5E | Off-board on the EVM plate, an insulating plate fixed to the chassis; the EVM rests on its stock bumpons H1-H4 and is held by edge clamps with silicone pads; no drilling of the EVM and no corner-hole standoffs, because the corner circles are fiducials, not holes (SLUUCB5E Figs 4-1 to 4-4); reference placement just past the MB +y edge, corridor fallback (i) if MS2 requires it (A.7, H.23(l)); W1/W2 at the fixed 0.30 m +- 10 mm, the other W leads at 0.30 m until MS2 and then at the route maxima of A.3 (r7) (**superseded in r8:** on M3 nylon standoffs on the chassis, >= 20 mm from the LM1084 side of MB, leads <= 0.30 m; the r7 wording 'W-lead maxima 0.30 m until MS2, then the route maxima of A.3') |

```
              VBUS tap (C-D2, R171)  V-MOT tap (C-D6, R170)    J1/J2 Teensy breakout taps (EN nets, 3V3, BT-CURR, pins
                     |                    |                     10/16/17/21/22/23/33/34/35), pin 7 at the ROS pad, Kelvin at SNS-BT
                     v                    v                                  |
  MB  D-BC-FC --+    +--------------------+----------------------------------+
  (VBUS)        |    |                                                       |
  D-BC-RG ------+--> VCHG-IN --(CHG pad 10 pin)-------> CR: eFuse U101 (+D103) --W1/W2 20 AWG pair--> EVM J1 VIN1/GND
  (V-MOT)            pin 38 divider                       | H1, UVB, BT_OK, BTB comparators; permit logic; QUAL one-shot; heartbeat
                                                          |--W5 14-way ribbon (2x 3V3, STAT, CE_DRV, ILIM_REL_A/B, RFC_OFF, ILIM/CE sense)--> EIB --> EVM TP27/TP33/TP36/TP38/TP49, JP14 pin 2, JP17, JP21
                                                          |--W7 twisted triple (SCL, GND shield, SDA)--> EVM J8 pins 2/3
  D-BT-SQ <-------- VCHG <--(CHG pads 18/19)------------- CR <--W3/W4 18 AWG pair-- EVM J5 BATTERY/GND
  (to VBT pack)
  Teensy 5 (CHG_ARM) / 6 (STAT) / 18-19 (I2C) reach CR through CHG pads 11 / 3 / 8-7.
```

The full drawing is `round3/wiring_bq25798.svg`. **r7:** the regenerated drawing is `round4/wiring_bq25798.svg`; the r7 carrier layout is `round4/carrier_layout_r7.svg` and the schematic `round4/carrier_schematic.svg` (generator `round4/calc/make_svgs_r7.py`).

### A.2 Carrier header pins (the 22 Ag105 holes)

Pad coordinates and nets: `references/Scale_Car_Board_20260624.sch`, `.brd` 20260625 (element CHG at (47.498, 34.544) mm,
R180; 2.54 mm pitch, one column of 10 pins (1-10) and one column of 12 pins (11-22), 25.00 mm apart, 1.1 mm drill). Pin numbers are the Ag105 pin numbers; board coordinates are in
A.8. **r6 (finding cr-coordinate-convention-mirror-ambiguity): every coordinate in this document is an Eagle `.brd` board coordinate,
top view, origin at the MB origin, +x right, +y UP.** KiCad's PCB editor counts y downward, so a hand-typed coordinate must be
entered as -y, or (PM0) the capture is done in the frame of the imported `.brd`; the 22-hole pattern is symmetric under a y-mirror,
so a mirrored capture still fits the MB with every pin reversed in its column and only the pin-identity gate of T-A-06 catches it.

| CHG pin (pad) | MB net | CR net | Function on CR |
|---|---|---|---|
| 10 (VIN+) | VCHG-IN (D-BC-FC/D-BC-RG VOUT, C-D8, C-D10, R1-CHG to pin 38) | `VCHGIN` | eFuse U101 IN/IN_SYS; UVLO/OVP divider top. The only input path (W8 deleted in r2: the segment has no current limit in Run, J.1) |
| 4 (VIN-) | GND | `GND` | **Power star point** (input return) |
| 14, 15 (VBAT-1/2) | GND | `GND` | **Power star point** (battery return), both pins |
| 18, 19 (VBAT+1/2) | VCHG (C-D11, D-BT-SQ VIN) | `VCHG` | Battery lead W3; keep-alive option output |
| 8 (SDA) | SDA, Teensy 18, RSDA (10 kOhm as built, **2.7 kOhm after PM9**) to 3V3 | `SDA` | W7; CR R145 footprint DNP (pull-ups live on the MB 3V3 side only, so the CR rail is never fed through I2C) |
| 7 (SCL) | SCL, Teensy 19, RSCL (10 kOhm as built, **2.7 kOhm after PM9**) to 3V3 | `SCL` | W7; CR R146 footprint DNP |
| 3 (STAT) | CHRG-STAT, Teensy 6 | `STAT` | R107 10 kOhm pull-up to 3V3; ribbon W5 pin 4 |
| 11 (MPPTD) | MPPT-DISABLE, Teensy 5 | `CHG_ARM` (logic net, written "P5" in the equations) | R108 47 kOhm pull-down; logic input to U105 and U114 |
| 13 (THERM) | N$34 -> J-NTC pin 1 | `TS_EXT` | Lead W6 to EVM J7 pin 1, only if a pack NTC is fitted (T-E-09) |
| 1, 2, 5, 6, 9, 12, 16, 17, 20, 21, 22 | unconnected on MB | none | Mechanical anchors only (soldered) |

### A.3 Power and signal leads (CR <-> EVM, CR <-> EIB, MB <-> CR)

| ID | From | To | Net | Wire | Max length | Routing / termination |
|---|---|---|---|---|---|---|
| W1 | CR hole `VCHGOUT` at board **(30.3, 61.2)** (after U101/D103; r5: moved 1.2 mm -x to free the OUT strip, finding efuse-cluster-no-room-at-pad10-reopen) | EVM **J1 pin 2 (VIN1)** | charger input | **r8 (H.23(p)):** 20 AWG stranded copper, 19/32 or 7/28 strands, insulation OD 1.60-1.75 mm as measured (PVC 300 V hook-up class, UL1007/UL1569; any insulation whose measured OD lies in that range is admissible; the class name alone does not guarantee the range, because its H.23(p) row spans OD 1.55-1.80 mm, so the T-A-02 measured OD decides), red. Thin-wall PTFE/ETFE (OD 1.10-1.45 mm) is excluded: its L' minimum of 0.164 uH/m gives an IN peak of 38.23 V at 290 mm, above D107 VBR(min) 36 V. 600 V-class PVC or silicone (OD 1.95-2.60 mm) is excluded unless the dressing path is re-routed: an OD above 1.787 mm breaks the 2.0 mm plan dressing rule (**superseded in r8:** 20 AWG, PTFE or silicone, red) | a fixed build length of 0.30 m +- 10 mm at every placement; the slack is a service loop anchored on the EVM plate (r7 review 7 note below, D-F3) (**superseded in r8:** 0.30 m (r7: until MS2; then 230 mm, or 260 mm in corridor fallback (i))) | Twisted with W2 at a pitch of 20-25 mm, jackets touching (r8, H.23(p)) (**superseded in r8:** >= 1 twist / 25 mm). CR end soldered into a 1.3 mm plated hole with a 2.3 mm pad (fully inserted, no splayed strands, trimmed and measured before the CR is seated, PM4 step 2b, T-F-12). **r5 strain relief (finding cr-end-strain-relief-anchor):** the CR has no tie slot, so the CR end is held by an adhesive bead (the RTV of BOM line "Adhesive") that bonds >= 5.0 mm of jacket from the joint, on the CR top copper and on along the B1R ramp face where the copper run is shorter (r8, H.23(s): W1 has 4.71 mm and W2 2.36 mm of copper run; A.3 r8 riser note), and by the anchor rule of the A.3 r7 review 7 note: every unsupported span between two anchors is <= 30 mm along the lead, and the chassis tie closes the last span and sits <= 2.4 mm past the MB +y edge for W1/W2 (A.3 review 7 close note) (**superseded in r8:** over the wire jackets and the CR top copper for >= 5 mm, plus a chassis cable tie within 30 mm of the CR edge (r7: at the MB +y edge, 29.744 mm from the tab X top edge, H.23(l)); the intermediate r7 rule: the chassis tie is an extra anchor with no distance limit); pull check in T-F-12; EVM end 0.5 mm² ferrule in the J1 screw terminal (ED120/2DS, UG BOM p.22) |
| W2 | CR hole `GND` at **(27.7, 61.2)** (beside W1, r5) | EVM **J1 pin 1 (GND)** | input return | as W1 (r8 wire specification, H.23(p)), black (**superseded in r8:** 20 AWG, black) | fixed 0.30 m +- 10 mm, as W1 (D-F3) (**superseded in r8:** 0.30 m (r7: until MS2; then 240 / 270 mm)) | As W1 |
| W3 | CR hole `VCHG` at **(24.3, 45.4)** (inboard of pins 18/19; over the MB VCHG pour, same net) | EVM **J5 pin 1 (BATTERY)** | charger output | 18 AWG, red/white | 0.30 m until MS2; then 200 / 190 mm on the W-lead dressing path (r7 review 7 note below) (**superseded in r8:** r7 rev-2: until MS2; then 180 / 170 mm) | Twisted with W4; 0.75 mm² ferrules; J5 is ED120/3DS. **r4 (finding w3w4-hole-vs-18awg-silicone):** CR end in a **1.5 mm** finished plated hole with a 2.5 mm pad (fine-strand 18 AWG silicone is ~1.2-1.35 mm), fully inserted with no splayed strands (T-A-06, T-F-12) |
| W4 | CR hole `GND` at **(24.3, 55.6)** (inboard of pins 14/15) | EVM **J5 pin 3 (GND)** | battery return | 18 AWG, black | 0.30 m until MS2; then 200 / 190 mm, as W3 (**superseded in r8:** r7 rev-2: until MS2; then 180 / 170 mm) | As W3. J5 pin 2 (EXT_BATP) stays empty (JP9 2-3, EM9) |
| W5 | CR **J101** (r4: **2x7 SMT, 1.27 mm pitch**, keyed; position 6 omitted if unshrouded) | EIB **J201** (r4: mating 2x7 1.27 mm header, keyed) | signal bundle | r4 (finding efuse-cluster-no-room-at-pad10): **14-way 0.635 mm (0.025 in) flat cable with 1.27 mm-pitch IDC sockets at both ends** (a factory cable assembly of the Samtec FFSD class, 0.30 m; MPN, keying option and polarising plug checked in T-A-05), **red stripe = conductor 1**. **r5 (finding j101-mated-socket-envelope):** the socket is a straight (top-entry) IDC; the flat cable leaves the mated socket vertically, folds once toward -x at >= 8 mm above the CR top and follows the W5 branch of the W-lead dressing path (r7 review 7 note below); it never crosses tab X; **r8 (H.23(t)):** S1 and S2 hold it at the 8 mm fold, and from (28.70, 64.01) to A1 it rests on top of the round-lead trunk, bonded with RTV (A.3 r8 stacking note) (**superseded in r8:** is folded once toward -x over the tap field at >= 8 mm above the CR top, and runs along W1/W2; the r7 rev-2 route: folded once toward +y, over tab X at the same fold height with W1/W2, crossing the MB +y edge in the W-lead band x 56-68.91, dressed clear of the tap pads; the r7 review 7 close rule: from S2 on, spacers hold it >= 10.735 mm above the CR top); it never bears on LM1084/CO-5V (+x side) or on the IN-strip parts; the mated envelope is dry-fitted in T-A-06 | a fixed 0.30 m (304.8 mm) factory cable; the route sets a minimum fit, not a build maximum: route + 20 mm 3-D allowance (ASSUMPTION) = 222.7 mm, or 204.6 mm in fallback (i); the 82.1 mm (100.2 mm) slack is a service loop anchored on the EVM plate (D-F2) (**superseded in r8:** 0.30 m (r7: factory cable kept; route-rule maximum 200 mm, or 180 mm in fallback (i), so the cable fits)) | **1 3V3 (B, via CR R176 200 ohm), 2 3V3 (A, via CR R177 200 ohm)**, 3 GND, 4 STAT (**r5: through EIB R275 1.00 kOhm at the E7 end**), 5 CE_DRV, **6 KEY (no pin at J101, no net at J201)**, 7 ILIM_REL_A, 8 ILIM_REL_B, **9 GND, 10 RFC_OFF** (r4: swapped so ILIM_REL_B's only neighbours are ILIM_REL_A and a GND, finding ribbon-adjacent-short-ilimrelb-rfcoff), 11 ILIM_SENSE, 12 GND, 13 CE_SENSE, 14 GND. Keying: a shrouded keyed J101/J201 pair is preferred where it fits the A.7 J101 region; an unshrouded J101 keeps position 6 pulled with a polarising plug in socket hole 6 (finding j101-unkeyed-ribbon-reversal): a 180 degree rotation puts the plug on pin 9 and a shift of up to two rows on pin 2, 4, 8 or 10, and none of them mates; a larger shift leaves rows hanging off and fails T-C-13. Pin-1 triangles on both silkscreens. The four GND conductors (3, 9, 12, 14) are bonded to the CR plane at J101; at J201 they join and reach EIB AGND only through **R273 10 ohm** (single DC ground of the EIB = E8/TP49, A.6). **Adjacent-conductor shorts (r4):** 2-3 (3V3-GND) is held to 16 mA by R177; 7-8 is the same signal; 8-9 pulls ILIM_REL_B LOW (held, safe); 9-10 pulls RFC_OFF LOW (FC clamp, safe); 10-11 makes pin 33 follow RFC_OFF (100 ohm against 470 ohm): released while GATE expected 0 trips FR-08(a), held while released expected is caught by the T1 step-6 proof; 12-13 / 13-14 read /CE LOW and trip FR-08(b). **r5 (findings ribbon-4-5-stat-sink-abs-max, ribbon-adjacent-short-stat-cedrv): the list is now complete.** 1-2 is one rail; 5-6 and 6-7 touch the key position (no net); **3-4** (STAT to GND): pin 6 reads "charging" permanently, no damage (R275 caps any STAT-pin current at 3.2 mA), caught by the FR-44 STAT plausibility rule; **4-5** (STAT to CE_DRV): without R275 the open-drain STAT pin would sink 14.6-31.8 mA against its 6 mA absolute maximum (SLUSDV2C §6.1) and /CE would sit in the LVC undefined band; with R275 the STAT current is 2.6-2.9 mA and U201 1A stays >= 2.72 V (VIH 2.0 V), so /CE keeps following the command; pin 6 then reads CE_DRV while STAT is released, caught by FR-44 (H.21); **11-12** (ILIM_SENSE to GND): U203 sinks 6.7 mA through R265 (<= 10 mA), pin 33 reads held: FR-08 safe-direction "permit stuck LOW" while released is expected, and the T1 step-6 proof fails, so no arming (T-C-05, T-C-07 sweep every n / n+1 pair; 3-4 and 4-5 only after R275 is fitted and checked). On the CR it runs on S1 and S2 and then on top of the trunk (r8, H.23(t)); from the MB tie base A1 it runs with the east group; past the MB +y edge it runs over the EVM plate, apart from W3/W4 and clear of L2, TODO(verify: EVM L2 position, MS2) (**superseded in r8:** Lay it along W1/W2, not across the EVM inductor L2; the r7 wording 'on the CR it runs on spacers beside the trunk') |
| W6 | CR SMT pads `TS_EXT` (33.0, 57.5) + `GND` (35.0, 57.5) | EVM **J7 pin 1 (EXT_TS)** | thermistor | 26 AWG twisted pair; second conductor bonded at the CR end only (shield), cut back and insulated at J7; J7 pin 2 empty | 0.30 m until MS2; then 140 / 150 mm (A.3 r7 review 7 table) (**superseded in r8:** r7 rev-2: until MS2; then 110 / 120 mm) | **Only if** an NTC is fitted at J-NTC (T-E-09); then EVM JP18 removed (EM18) |
| W7 | CR SMT pads `SCL` (27.0, 57.5), `GND` (29.0, 57.5), `SDA` (31.0, 57.5) (r3; traces from pins 7/8) | EVM **J8 pins 2 (SCL), 3 (SDA)** | I2C | 3-conductor 28 AWG twisted triple SCL-GND-SDA; Molex KK 254 housing 22-01-3047 with two crimps 08-50-0114 at J8 pins 2/3 | 0.30 m until MS2; then SCL 160 / 190 mm, SDA 160 / 200 mm (A.3 r7 review 7 table) (**superseded in r8:** r7 rev-2: until MS2; then SCL 140 / 180 mm, SDA 130 / 170 mm) | **GND conductor bonded at the CR pad only**, cut back and insulated at the J8 end (shield; J8 pins 1 and 4 empty), so I2C rides the power-return offset (<= ~20 mV at 3.1 A, H.11) and adds no parallel ground path (finding ground-loops-parallel-returns, w7-gnd-termination). Separate from W5 so the far-corner J8 is reached directly |
| W8 | - | - | - | **do not populate (r2)** | - | Deleted: it was an unfused flying lead on the VCHG-IN segment that has no current limit in Run (B.4, J.1). Conditional fallback only if T-A-05 rates the pad-10 pin below 3 A and no better pin exists: 20 AWG from C-D8 pad 1 to a re-added CR pad, with a ~3 A fast fuse within 10 mm of C-D8 (fuse I2t checked against the eFuse 202 ms limit dwell at 2.41 A, T-A-05), sleeved, tied away from the board edge |

Currents: W1/W2 carry at most the eFuse limit (2.41 A for <= 202 ms, H.5) and normally <= 1.76 A (the regen ILIM clamp
maximum, H.4). W3/W4 carry <= **3.21 A** (r5, finding ichg-upper-tolerance-omitted-in-ratings: regen-image ICHG 3.10 A + 3.5 %, the
SLUSDV2C §6.5 buck-mode ICHG_ACC upper bound at 2 A extrapolated; unspecified above 2 A, T-B-19 measures). Drops and losses in H.11.

**r8 (marker conversion):** the r7 review 7 notes below replace the straight route from each CR hole to the tab X top edge, the chassis tie at the MB +y edge with its 0.256 mm and 0.02 mm margins and the maxima of the following table (D-F2, D-F3); the straight route crossed the pin-10 post, the IN strip and the tap field. The paragraph, the table and the resistance paragraph that follow are the r7 rev-2 basis and are kept as history only (**superseded in r8:** **r7 (W-lead routes and maxima, H.23(l)):** the CR ends of W1-W7 are unchanged; the tabs do not shorten the EVM leads, only the EVM placement does. Every W lead leaves the CR over tab X and crosses the MB +y edge at x 56-68.91 mm. The upper limit keeps the chassis cable tie at the MB +y edge within 30 mm of the CR edge: the tie sits 29.744 mm from the tab X top edge where a lead crosses at x <= 65.00 (margin 0.256 mm) and 29.98 mm from the tab X corner (65.00, 68.30) where W3, W4 and W5 cross at x 68.75 at the reference placement (margin 0.02 mm). Until MS2 confirms the EVM reference placement (A.7), the 0.30 m caps of the table stay the T-A-02 bound. The **route rule** sets the build maximum of a W lead to 1.25 x its routed length (CR pad, tab X, MB +y edge, terminal approach on its wire-entry side, terminal), rounded up to 10 mm. After MS2, the route-rule maxima become the build maxima. The table below gives the route-rule figures for the reference placement and for corridor fallback (i), in which the EVM and the EIB shift 27.03 mm toward -x (45.3 mm of chassis room past the MB -x edge, A.7). Corridor fallbacks (ii) and (iii) fail (H.23(l)).)

| Lead (**superseded in r8:** r7 rev-2 basis, history only) | Reference placement: route / build max (mm) | Corridor fallback (i): route / build max (mm) |
|---|---|---|
| W1 | 181.6 / **230** | 207.5 / **260** |
| W2 | 189.1 / **240** | 215.1 / **270** |
| W3 | 139.2 / **180** | 128.2 / **170** |
| W4 | 143.8 / **180** | 133.3 / **170** |
| W6 | 81.9 / **110** | 92.8 / **120** |
| W7 SCL | 109.2 / **140** | 136.2 / **180** |
| W7 SDA | 103.0 / **130** | 129.9 / **170** |
| W5 (0.30 m factory cable) | 159.8 / **200** | 141.6 / **180** |

(**superseded in r8:** r7 rev-2 basis, history only; the r7 review 7 notes below give the live resistance, clearance and channel figures: At the reference build maxima the W1/W2 pair has 15.66 mOhm (28.2 mV and 50.7 mW at 1.80 A). The W3/W4 pair has 7.54 mOhm (23.4 mV and 72.5 mW at 3.10 A; 24.2 mV and 77.7 mW at 3.21 A). At the 0.30 m caps used in H.11, the pairs have 19.99 mOhm and 12.57 mOhm. Every fallback (i) maximum of W1-W4, W6 and W7 is <= 0.30 m, so H.11 bounds it as well. Every reference route keeps >= 10.10 mm from the MB switched conductors (VSW-FC/VSW-BT pours, L-FC/L-BT bodies, REG-FC/REG-BT boxes). At the reference placement W3/W4 pass between the EVM right edge and the USB corridor in a channel 4.97 mm wide; the outer size of the twisted 18 AWG pair is TODO(measure: MS2/MS7).)

**r7 review 7 (W-lead dressing path, D-F2; H.23(l)).** The **W-lead dressing path** replaces the straight segment from each CR hole to the tab X top edge. Every W lead leaves its CR joint inside the A.3 RTV bead and joins the **trunk**, which runs +y on the footprint along x 25.80. W3 runs up x 24.40 from its hole and pairs with W4 at y 57.00; W6/W7 join at y 59.20 and W1/W2 at y 62.60. The trunk passes onto tab Y and turns +x at y 69.60, on the -y side of the FT2 fill-hole disc. It rises to y 71.10 past the U101 courtyard and the +x pocket, and to y 71.75 past the tap pads. It leaves the CR at the tab Y +x edge (x 37.56) and reaches the MB tie base A1 at (60.50, 73.50) without crossing tab X.

From A1 the **west group** (W1, W2, W6, W7) runs to (58.00, 76.00) and straight up x 58.00 to the MB +y edge. The **east group** (W3, W4, W5) runs up x 61.00 to (61.00, 85.50), clear of D-FC-EN and C-D1, and then to the MB tie base A2 at (71.50, 88.00). It crosses the MB +y edge within 30 mm of A2. W5 rises at J101 and folds once toward -x at >= 8 mm above the CR top to (28.70, 46.83). It runs +y over the footprint interior to (28.70, 73.10), then +x at y 73.10. It steps to y 73.80 over x 42.00-44.50, clear of the tap pads, and from (28.70, 64.01) rests on top of the trunk until A1 (r8, H.23(t); stacking note below) (**superseded in r8:** and stays at its fold height until A1; the r7 review 7 close text 'at >= 15.00 mm above the MB over tab Y and down to the fold height at (47.25, 73.80), under the 3-D rule below'). From A1 it lies flat on the MB with the east group.

The **dressing rule** keeps every W lead >= 2 mm in plan from the pin-10 joint, the IN strip (C102a/b/c, R102, D107), the U101 courtyard and the +x pocket. The same 2 mm applies to every 1x10 and 1x12 post tip and every tap pad, and no W lead lies over the tab X tap field. The designed path meets the rule at the jacket edge: minimum 2.02 mm (W5), 2.08 mm (W3) and 2.09 mm for the other leads. It keeps 2.03 mm from the tap-field courtyard. **r8 (H.23(p)):** with the r8 W1/W2 insulation OD of up to 1.75 mm the worst lead is W1 at 2.017 mm from the +x pocket and the trunk half-width is 2.443 mm; the largest W1/W2 OD that keeps the 2.0 mm rule on this path is 1.787 mm. The r7 jacket envelopes are ASSUMPTIONS (half-width 2.37 mm for the trunk, 1.73 mm for the west group, 2.00 mm for the east group and the W3/W4 pair, 1.00 mm for one 18 AWG lead; TODO(measure: MS2/MS7)). The MB rework points C-D2 with R171, D-FC-EN with its EN bodge resistor, and C-D1 keep >= 1.5 mm: 4.21 mm, and 2.03 mm for W5.

W5 has two exceptions to the 2 mm rule. Over the J101 region (x 37.00-40.75) the ribbon edge lies 0.775 mm in plan from C102b, because A.8 sets the J101 region 0.50 mm below the IN strip. There the ribbon is >= 8 mm above the CR top, held by the spacer bead S1. On tab Y the ribbon overlaps the L-FC body by 0.68 mm in plan; the 3-D rule below sets the ribbon bottom there >= 15.00 mm above the MB, and in r8 the ribbon rests on the trunk at 19.850 mm above the MB (H.23(t)). The 3-D rule closes the L-FC overlap; the C102b exception stays open (J.2 item 62) (**superseded in r8:** >= 12.3 mm above the MB (L-FC body height TODO(verify: L-FC datasheet)). Both exceptions wait for an operator ruling (J.2 item 62)). r8 (H.23(y) row (5)): W5 passes over the FT2 fill hole on top of the trunk, 19.41 mm above the MB, bonded to the trunk with RTV. To re-bed FT2 after PM4 (6), cut the W5-to-trunk RTV locally over the fill hole and lift W5; re-bond W5 to the trunk after the bed cures (T-F-12, T-A-09) (**superseded in r8:** "W5 also passes over the FT2 fill hole at its fold height, so a re-bed of FT2 first lifts W5 from S2 and S3.")

The 10 mm switched-conductor clearance of the r7 rev-2 routes cannot be met on the CR. The designed path keeps 3.39 mm from the L-FC body, and W5 overlaps it in plan by 0.68 mm. The L-FC body lies 0.862 mm past the tab Y +y edge, and the 2 mm dressing rule closes every other exit from the footprint. A raster search over every plan path that keeps the 2 mm rule gives at best 5.12 mm for the trunk bundle and 9.34 mm for a single lead. From A1 on, every lead keeps 10.38-13.01 mm. The 10 mm figure has no stated pickup basis; the decision of 2026-11-10 below applies the rule as a 3-D distance (**superseded in r8:** so its acceptance on the CR is an open operator ruling (J.2 item 62)).

**r7 review 7 close (3-D switched-conductor rule, decision 2026-11-10; H.23(l)).** The 10 mm switched-conductor rule is applied
as a 3-D distance. The switched conductors are the VSW-FC and VSW-BT pours, the L-FC and L-BT bodies and the REG-FC and REG-BT
boxes. Where the plan distance d from a jacket edge to a switched conductor is < 10 mm, insulating spacers or RTV beads hold
the jacket bottom at >= H + sqrt(10² - d²) above the MB top, and at >= H + 10 mm where the two overlap in plan. H is the
conductor top: 0 mm for the pours, 1.0 mm for REG-FC/REG-BT (VQFN-HR, `TPS61288LRQQR.pdf`) and 5.0 mm for L-FC/L-BT
(ASSUMPTION from the HCM1A1305V3 size code, TODO(verify: Eaton HCM1A1305V3 drawing), MS3 caliper). The decision rests on the
operator statement of 2026-11-10 that the MB and its PCBs have no maximum height (D-H). The L-FC body controls every lead:

- The round leads W1-W4, W6 and W7 share one run from B1 (25.80, 64.50) to (50.45, 72.09). On the CR the jacket bottom must be
  >= 14.41 mm above the MB, that is 10.14 mm above the CR top; the worst point is (36.00, 71.10), 3.39 mm in plan from L-FC.
  Off the CR, from (37.75, 71.10) to (50.45, 72.09), it must be >= 14.35 mm above the MB. The required height is 5.48 mm at
  B1, 13.72 mm at y 69.60, 14.41 mm at x 36.5, 13.45 mm at x 41.5, 11.95 mm at x 44.0, 8.61 mm at x 46.7 and 3.27 mm at
  x 49.2. **r8 (H.23(s), H.23(t)):** these figures use the r7 trunk half-width 2.374 mm. With the r8 half-width 2.443 mm
  (W1/W2 OD 1.75 mm, H.23(p)) the requirement starts at (25.80, 64.450), 0.050 mm before B1, and reaches its CR maximum of
  14.433 mm above the MB (10.168 mm above the CR top) at (36.00, 71.10); it is 14.432 mm at x 36.5, 13.495 mm at x 41.5 and
  12.018 mm at x 44.0.
- W5, from (28.70, 65.67) to (47.25, 73.80), needs a ribbon bottom >= 15.00 mm above the MB. **r8 (H.23(t)):** the ribbon
  rests on the trunk there, 19.850 mm above the MB at the B3 level, 4.850 mm above that requirement; the W5 minimum
  margin over its own requirement, 1.866 mm, lies at (28.70, 64.01) (H.23(y) row (5); **superseded in r8:** "and meets its
  own requirement with 1.866 mm of margin").
  It still overlaps L-FC by 0.68 mm in plan (**superseded in r8:** The ribbon therefore rises from its 8 mm fold to
  >= 10.735 mm above the CR top (+2.73 mm).)
- From A1 on, no spacer is needed (10.38-13.01 mm in plan).

**r8 (B1 riser and CR-end strain relief, CHG-R1-D03; H.23(s)).** On the r7 trunk the requirement rises from 1.216 mm above
the CR top at B1 to 7.555 mm, reached 2.675 mm past B1 (H.23(w)(1)). A level post at B1 and the r5 jacket bead cannot both
hold: W2 reaches B1 4.26 mm from its joint, so its 5.0 mm bead ends at (25.80, 65.24), 0.74 mm past B1, where the jacket must
stand 4.538 mm above the CR top (H.23(s)). The trunk therefore climbs a ramp from the CR copper. The **B1 riser (B1R)** is a
machined insulating wedge (G10/FR-4 laminate or PEEK, ASSUMPTION) bonded to the CR top with the 0.05 mm acrylic transfer tape
of the feet (A.7). B1R replaces the 3.0 x 3.0 mm B1 bead spot. Its footprint is x 23.55-26.05, y 62.54-67.10 (11.40 mm²; the
+x edge lies on the W2 pad exclusion x 26.05). Its ramp face rises at 65 degrees from the toe at y 62.54 to an apex 9.78 mm
above the CR top at y 67.10 (H.23(s)). r8 (lateral support, H.23(y) row (4)): the 2.50 mm face supports 51 % of the 4.885 mm
trunk width; the trunk centreline x 25.80 lies 0.25 mm inside the +x face edge, so the trunk overhangs 2.19 mm on +x and
0.19 mm on -x. The H.23(s) profile check holds for a cohesive round bundle whose lowest line lies on the face, because its
lower surface then stands at or above the face plane across the whole width (0.013 mm at the +x face edge). RTV therefore
binds every trunk lead into one round bundle and bonds the bundle to the ramp face from the toe to the apex, so no lead
overhangs the face edge on its own. The wedge is not widened: a wider block in the footprint interior needs a new part-box
and exclusion check (J.2 item 68).

The leads leave the CR copper at the toe and lie on the ramp face. From the apex the trunk spans free for 10.4 mm along its
path, through T2 at a rise of 5.1 degrees, to B3. **B3** becomes an insulating post that holds the trunk jacket bottom
10.7 mm above the CR top (14.965 mm above the MB): the CR maximum of the requirement, 10.168 mm, plus a 0.50 mm design margin
(ASSUMPTION: sag, wedge and post height tolerance), rounded up to 0.1 mm. From B3 the trunk runs level to the tab Y +x edge
(x 37.56). The full profile meets the requirement plus the margin at every 0.05 mm from T1 to x 37.56. The minimum margin is
0.504 mm at T2 (25.80, 69.60), where 9.497 mm is required and 10.001 mm is built above the CR top (H.23(s)).

The 65 degree slope is chosen because it is the shallowest computed slope at which W1 and W2 still join the trunk on the CR
copper: the ramp height at T1 is 0.13 mm, below the 0.800 mm W1/W2 jacket radius. At 55 and 60 degrees the latest toe is
y 60.25 and 61.45, and W1/W2 would join a raised trunk; at 70 degrees the apex rises to 10.39 mm (H.23(s)). Lead stiffness
can only lift a lead above the ramp face, so a lead that does not follow the face still meets the 3-D rule. The T-A-06
item (8) dry fit confirms that the leads can be dressed onto the 65 degree face.

**Strain relief (r8 restatement of the r5 bead).** RTV bonds >= 5.0 mm of each lead jacket from its joint, on the CR copper
up to the toe and on along the ramp face. The wedge is bonded to the CR, so the bead keeps its CR-end function on the ramp.
W1 and W2 have 4.71 mm and 2.36 mm of copper run, so their bead continues on the ramp face. W3, W4, W6 and W7 have
5.42-17.45 mm of copper run and complete the bead on the copper. The jacket length from the joint to the apex is 15.36 mm
(W1), 13.01 mm (W2) and >= 16.21 mm for the other leads (H.23(s)). With B1R in place of the B1 spot the footprint interior
books 184.9 of 288.8 mm² = 64.0 % (<= 75 %); the tab Y booking is unchanged, because B3 keeps its spot (H.23(s)).

**r8 (W5 and trunk stacking, CHG-R1-W01; H.23(t)).** The W5 ribbon (8.89 mm wide, 0.9 mm thick, ASSUMPTION) and the
round-lead trunk overlap in plan from the trunk start at y 57.00 on the x 25.80 run to A1. W5 lies above the trunk over the
whole overlap. Below the riser the trunk top (9.150 mm above the MB) lies under the W5 fold (12.265 mm above the MB). From
(28.70, 64.01), where the trunk top passes the fold height, W5 rests on the trunk top and is bonded to it with RTV; the B3/S3
union spot carries both runs. The W5 bottom is the largest of the fold height, the W5 3-D requirement and the trunk top. The
trunk bundle thickness T_b is 4.885 mm, twice the r8 trunk half-width of 2.443 mm (H.23(p); ASSUMPTION as in H.23(l),
TODO(measure: MS2/MS7)). At the B3 level the trunk occupies 14.965-19.850 mm and W5 19.850-20.750 mm above the MB. The stack
top is 20.750 mm above the MB (16.485 mm above the CR top) at (32.80, 73.10); it is information only (D-H). W5 meets its own
3-D requirement everywhere with >= 1.866 mm of margin; the minimum lies at (28.70, 64.01), where W5 first rides on the
trunk (requirement 10.416 mm above the MB); over tab Y the margin is 4.850 mm (19.850 - 15.00) (H.23(y) row (5);
**superseded in r8:** "requirement (>= 15.00 mm above the MB over tab Y) with 1.866 mm of margin"). At the off-CR controlling points the requirement,
the trunk bottom and the W5 bottom are 13.495, 14.399 and 19.285 mm above the MB at x 41.5, and 12.018, 12.527 and 17.412 mm
at x 44.0 (H.23(t)). S1 and S2 hold the ribbon at the 8 mm fold, because both lie before the trunk start (y 57.00).

A lead that runs straight from 14.41 mm above the MB at B3 down to the MB top at A1 stands 10.751 mm above the MB at x 41.5,
against the 13.452 mm required there (H.23(w)(2), r7 basis). An insulating support therefore holds the trunk, with W5 on it,
on the profile off the CR. Its position and form are TODO(design: T-A-06 dry fit): a support on the MB clear of every MB part
box (the OP-FC box x 40.22-45.12, y 67.30-75.28 lies under the run), or a rigid insulating bridge from the tab Y +x edge. As
information (H.23(s)): with the trunk held 14.965 mm above the MB from the tab Y +x edge, a straight descent to the MB top at
A1 meets the requirement plus 0.50 mm when the support reaches (40.75, 71.10), 3.1 mm along the trunk past the CR edge.
T-F-12 measures the jacket-bottom heights over the full profile: the B1R check points of H.23(s), T2, B3 and the off-CR
controlling points. The plan raster bound (5.12 mm for the bundle, 9.34 mm for one lead) stays as information.

(**superseded in r8:** The requirement reaches 7.56 mm above the CR top only 2.7 mm past B1 (hand calculation from the H.23(l) profile). B1 and B3
are therefore insulating spacer posts that hold the trunk level at >= 10.14 mm above the CR top from B1 to the tab Y +x edge.
S2 and S3 hold the W5 ribbon level at >= 10.735 mm above the CR top, and S1 keeps the 8 mm fold at J101. A lead that runs
straight from 14.41 mm at B3 down to the MB top at A1 stands at about 10.8 mm at x 41.5, against the 13.45 mm required there
(hand calculation along the path). An insulating support therefore holds both runs on the H.23(l) profile off the CR,
between x 37.75 and 46.7. Its position and form are TODO(design: T-A-06 dry fit): a support on the MB clear of every MB part
box (the OP-FC box x 40.22-45.12, y 67.30-75.28 lies under the run), or a rigid insulating bridge from the tab Y +x edge to
past x 46.7. T-F-12 measures the jacket-bottom heights at the controlling points. The plan raster bound (5.12 mm for the
bundle, 9.34 mm for one lead) stays as information.)

The **anchor rule** replaces the r5 chassis-tie rule: the unsupported lead length between two anchors is <= 30 mm, measured along the lead. The anchors are the A.3 joint beads, the B1R riser and the B3 bead on the CR (r8; **superseded in r8:** two CR RTV beads), three W5 spacer beads and two MB tie bases:

- the **B1R** riser wedge (r8, footprint x 23.55-26.05, y 62.54-67.10; it carries the CR-end bead of every lead that reaches it) and the RTV bead **B3** at (35.00, 70.80) (3.0 x 3.0 mm footprint, ASSUMPTION) on the B3 post that holds the trunk jacket bottom 10.7 mm above the CR top (r8, H.23(s)) (**superseded in r8:** RTV beads (3.0 x 3.0 mm footprint, ASSUMPTION): B1 at (25.80, 64.50) and B3 at (35.00, 70.80) (r7 review 7 close: each also an insulating spacer post that holds the trunk >= 10.14 mm above the CR top, 3-D rule above));
- W5 **spacer beads**: **S1** at (35.00, 47.69) and **S2** at (28.70, 53.42), each an RTV bead onto an insulating spacer on the CR that holds the ribbon at its fold height, and **S3** at (35.00, 73.10), which merges with B3 into one spot where W5 rests on the trunk and one bead bonds both runs (r8, H.23(t); **superseded in r8:** "each an RTV bead onto an insulating spacer on the CR that holds the ribbon at its fold height: S1, S2 and S3") (**superseded in r7:** S1 at (36.00, 46.83) and S2 at (28.70, 55.00); calc revision 4 moved them, below);
- **tie base A1**, 6 x 6 mm, centred at (60.50, 73.50) +- 1.5 mm, and **tie base A2**, 10 x 10 mm, centred at (71.50, 88.00) +- 1.5 mm, each bonded on the MB solder mask (sizes ASSUMPTION, TODO(verify: adhesive tie-base datasheet)).

The longest span between anchors is 26.0 mm, S2 to S3, with the revision-4 S2; the W5 spans are S1-S2 12.9, S2-S3 26.0, S3-A1 25.6, A1-A2 22.7 and A2 to the MB +y edge 10.6 mm, measured in plan; the r8 trunk span from the B1R apex to the B3 post edge is 10.4 mm (H.23(s)) (**superseded in r8:** 25.8 mm (B3 to A1)). Each tie-base zone (the base +- 1.5 mm) lies on the MB outside the CR shadow, clear of every MB part box (A1 0.51 mm from SNS-FC, A2 1.72 mm from CSNS-FC) and of every non-GND via. Under A1 the VBUS-FC layer-1 copper lies under solder mask; under A2 there is only the GND pour. Calc revision 4 moved S1 to (35.00, 47.69) and S2 to (28.70, 53.42). The old S2 also overlapped the W3/W4 trunk jacket by 0.51 mm. S1 now keeps 0.50 mm from the J101 region and from the divider strip and 7.33 mm from the nearest jacket. S2 keeps 1.33 mm from the W6/W7 pad exclusion and 0.51 mm from the W3/W4 jacket, against the >= 0.5 mm rule. The 3.0 x 3.0 mm footprints stay ASSUMPTIONS, and the T-A-06 dry fit confirms them. (**superseded in r8:** The S1 and S2 footprints are ASSUMPTIONS that reach 0.50 mm into the J101 region and 0.25 mm from the W6/W7 pads; the T-A-06 dry fit places them clear of both). The chassis tie past the MB +y edge is no longer exempt. It closes the last span from the last MB anchor, so it sits <= 4.4 mm past the MB +y edge for the west group (W1, W2, W6, W7; last span 25.6 mm), <= 18.4 mm for W3/W4 (11.6 mm) and <= 19.4 mm for W5 (10.6 mm). With a 2 mm margin the limits are 2.4, 16.4 and 17.4 mm, so the west-group tie sits effectively at the MB +y edge. No further MB tie base is added: a 6 x 6 mm +- 1.5 mm base, the A1 size, has no position on the west run, because C4C-FC, SNS-FC and the FC-CURR vias at (58.93, 83.57) and (60.71, 90.42) block it. The only fit is a 4 x 4 mm +- 1.0 mm base at (58.80, 95.00), 0.03 mm from C4C-FC (H.23(l)). MS2 records the tie positions against these limits. (**superseded in r8:** The chassis tie past the MB +y edge is an extra anchor with no distance limit, so the run from the last tie base to the chassis tie is exempt from the 30 mm rule. That run also meets the rule when the chassis tie sits within 4.4 mm (west group), 18.4 mm (W3/W4) or 19.4 mm (W5) past the MB +y edge; MS2 records the position.)

A **polyimide strip** (0.125 mm film with silicone adhesive, cut from the polyimide sheet stock) lies on the MB under the leads, from the tab Y +x edge to the MB +y edge. It follows the lead path within x 36.06-65.28, y 65.30-92.80 (lead envelope + 2.0 mm, via pad rims included) and stops at each tie-base footprint, so each base bonds to the MB solder mask. It covers CSNS-FC, MDAC-FC, OP-FC, ROP1-FC and SNS-FC where the leads cross them. It also covers nine untented non-GND vias (H.23(c2)): 3V3 (43.43, 71.63), (46.23, 71.63) and (61.79, 79.18); CS-MDAC-FC (49.99, 72.60); FC-CURR (51.16, 74.67), (58.93, 83.57) and (60.71, 90.42); MOSI (53.46, 73.29); and SCK (53.85, 72.14). It further covers 3V3 (51.10, 69.13) and MISO (54.00, 69.60), which W5 would cross if it touched down before A1. Both lie inside the strip extent, so the strip covers 11 non-GND vias (calc revision 4). The CR-top tips of pins 7-10 (pin 10 VCHG-IN, 0.940 mm proud, H.23(j)) get a cured dome of the BOM RTV or a Kapton patch before any lead is dressed (PM4 (6), T-F-12).

**r7 review 7 (lengths, D-F2 and D-F3; H.23(l)).** The following table gives the routes on the dressing path and the build length or maximum of each lead.

| Lead | Reference placement: route / build length or maximum (mm) | Corridor fallback (i): route / build length or maximum (mm) |
|---|---|---|
| W1 | 199.5 / fixed **0.30 m +- 10 mm** (slack 100.5) | 225.5 / fixed **0.30 m +- 10 mm** (slack 74.5) |
| W2 | 202.2 / fixed **0.30 m +- 10 mm** (slack 97.8) | 228.2 / fixed **0.30 m +- 10 mm** (slack 71.8) |
| W3 | 156.6 / **200** | 150.8 / **190** |
| W4 | 156.3 / **200** | 151.0 / **190** |
| W6 | 106.8 / **140** | 119.2 / **150** |
| W7 SCL | 123.7 / **160** | 150.7 / **190** |
| W7 SDA | 125.8 / **160** | 152.8 / **200** |
| W5 (fixed 304.8 mm factory cable) | 202.7 / minimum fit **222.7** (slack 82.1) | 184.6 / minimum fit **204.6** (slack 100.2) |

W1 and W2 keep a fixed build length of 0.30 m +- 10 mm at every placement (D-F3). A shorter W1/W2 lowers the lead inductance and raises the hard-short IN-side spike at U101 (H.5). **r8 (H.23(p)):** with the r8 W1/W2 wire of the table above (L' 0.399-0.661 uH/m from L' = (mu0/pi) acosh(s/2a) over the specified conductor, insulation OD and twist pitch) the IN peak at the lowest L' is 33.79 V at 290 mm, 33.64 V at 300 mm and 33.51 V at 310 mm, with a lead peak of up to 130 A; the margin to D107 VBR(min) 36 V is 2.21 V at 290 mm. The OUT-ring quarter period is <= 0.711 us, below the 1 us fast-trip response. The statement that no W1/W2 pair reaches 36 V holds only inside this modelled envelope (20 AWG 19/32 or 7/28, OD 1.60-1.75 mm, pitch 20-25 mm, 290-310 mm, the H.19(b) source grid); thin-wall PTFE at 290 mm would reach 38.23 V. The r3-r6 basis of H.5, H.19 and T-C-04 still holds. The r8 wire was not evaluated at a shortened route, so W1/W2 are never shortened (**superseded in r8:** on the unsourced 0.5 uH/m basis: cut to the 199.5 mm route, W1 gives 34.4 V; cut to the r7 rev-2 route of 181.6 mm, it gives 34.9 V, 1.1 V below D107 VBR(min) 36 V. At 290-300 mm the spike stays at 32.8-32.9 V, so the r3-r6 basis of H.5, H.19 and T-C-04 holds). The W1/W2 slack is a service loop anchored on the EVM plate. W3/W4, W6 and W7 keep the 0.30 m cap until MS2 and then take their route maxima; corridor fallbacks (ii) and (iii) still fail.

The route of W5 is a minimum-fit check, not a build maximum: route + a 20 mm 3-D allowance for the J101 rise and fold and the J201 drop (ASSUMPTION, T-A-06). The 0.30 m factory cable leaves 82.1 mm of slack at the reference placement and 100.2 mm in fallback (i). The slack is a service loop anchored on the EVM plate beside the EIB, and no slack lies over the CR. At 310 mm each, the W1/W2 pair has 20.65 mOhm (37.2 mV and 66.9 mW at 1.80 A), 0.66 mOhm above the H.11 figure at 0.30 m. At the 200 mm route maxima the W3/W4 pair has 8.38 mOhm (26.0 mV and 80.5 mW at 3.10 A; 26.9 mV and 86.3 mW at 3.21 A).

The USB corridor width is the Teensy 4.1 receptacle silkscreen outline from the MB `.brd`, not the plug overmold. The overmold width, thickness and length, the boot width and the bend direction are TODO(measure: MS2). W3/W4 use the 4.97 mm channel between the EVM right edge (x 88.50) and the corridor. W5 is routed around the channel over the EVM plate, so W3/W4 and W5 do not share it. The channel criterion is a clear width over y 118.04-138.73, between the EVM right edge with any clamp body and the measured plug envelope, of >= the measured W3/W4 pair OD + 1.0 mm (MS2). When it fails, corridor fallback (i) applies (A.7).

### A.4 Taps from CR to MB (CR tap solder field F01-F24: top-side SMT pads 1.5 x 1.5 mm, no holes, 6 x 4 grid at 2.54 mm on tab X plus residual pads F08, F09, F10 and F22 on the footprint (r7; **superseded in r7:** 3 x 8 grid at 2.54 mm); strain relief by an adhesive bead over the wire jackets, no cable-tie slot; r3)

All 26 AWG unless stated. Lengths from the `.brd` coordinates (CR centre about (33.5, 50.5) mm; J1 at (85.9, 62.0), J2 at
(108.7, 62.0), C-D2 at (68.6, 69.9), C-D6 at (97.8, 17.9), SNS-BT at (55.1, 23.6) mm). J1/J2 are Amphenol 87606-324LF
**female** Dubox receptacles (MB BOM; 2 x 24, two positions per Teensy pin). Position map derived from the Teensy 4.1 pin
order and checked against the nets the `.sch` gives for J1.07/08 (pin 2, net ENC_A with RENC1), J1.19/20 (pin 8, net ENC_B
with RENC2), J1.17/18 (net ENC-EN, the far side of ROS); **T-A-01** confirms every position used here and **T-A-01b** the
pin-7 tap. Pin 7 has no J1/J2 position: its net N$21 is only Teensy pin 7 and ROS pad 2 (`.sch`), so T20 lands on the ROS pad
after ROS is removed (PM10). A tap ends in a single 0.64 mm square male pin (Samtec TSW-101-07-G-S cut
header pin, wire soldered and heat-shrunk) pushed into the second position of the pair; if T-A-01 finds a position
unusable, solder the tap to the pin's second position on the MB pad.

**r7 (tap field on tab X, H.23(g)):** the r6 tap field (3 x 8 grid, envelope x 23.15-42.43, y 35.05-41.63, A.7) is superseded. Twenty pads (F01-F07, F11-F21, F23, F24) and R175 occupy a 6 x 4 grid at 2.54 mm on tab X, with centres at x 50.80 / 53.34 / 55.88 / 58.42 / 60.96 / 63.50 mm and y 58.94 / 61.48 / 64.02 / 66.56 mm. The pad envelope is x 50.050-64.250, y 58.190-67.310. Its low pad edge is 2.233 mm from the MB 5V copper rim (rule >= 2.0 mm). R175 stands vertical in grid column 1, rows 2-3 (courtyard x 49.650-51.950, y 60.375-65.125). Its pad R175a (row 3, y 64.02) is the F07 / Teensy 3V3 side and sits beside F07; its pad R175b (row 2, y 61.48) is the CR rail side. Two grid positions stay spare: (53.34, 61.48) and (53.34, 66.56) (**superseded in r7:** (53.34, 64.02) and (50.80, 66.56)). A.8 gives the pad assignment, its adjacency exclusions and the adjacent-pad short table. Four residual pads stay on the footprint low row y 35.80: F08 (T22) at x 26.44, F09 (T8) at x 28.98, F10 (T9) at x 31.52 and F22 (T18) at x 41.68. The CR field column of the table gives each pad centre. Grid row 1, part of row 2 and part of the R175 courtyard lie inside the thermal band (A.7); the band admits pads, wires, the RTV bead and temperature-insensitive passives such as R175. The F20 (T20) and F21 (T21) pads lie over the FT1 body on the CR underside (x 59.720-63.720, y 65.905-67.505); D.1 (PM4, PM6) and T-A-09 set their soldering order against the FT1 bed check.

**r7 lengths (information):** each r7 straight length runs from the pad centre to the `.brd` pad of the MB point, for example C-D6 pad 1 at (97.790, 16.412) and SNS-BT pad 15 at (55.443, 26.492), not to the part centres above. The sum over the 20 taps (T7b follows T1; T18, T19 and F24 are options) falls from 1308.0 mm (r6) to 859.3 mm straight (-34.3 %) and 898.7 mm dressed (-31.3 %) on the path that the dressing rule allows (**superseded in r7:** 895.5 mm dressed with the review-7 T8 lane; before review 7, 850.9 mm straight (-34.9 %) and 856.7 mm dressed, on a dressed path that ran over the row-1 pads). The Length column keeps the r6 maxima. They stay valid upper bounds, because every r7 straight and dressed length is at most 59.5 % of its maximum (T8, 89.2 mm dressed against 0.15 m) (**superseded in r7:** 57 %, T8 86.0 mm in the review-7 lane) (**superseded in r7:** "because every r7 straight and dressed length is shorter"; the T8 dressed length exceeds its r6 straight length).

**r7 dressing rule:** wires from tab X stay at y > 56 until x > 63. No tap wire passes over the REG-5V box (x 50.97-62.31, y 36.87-54.51: the LM1084 leads, body and tab), over CO-5V or over a CR header post (**superseded in r7:** "never pass over the LM1084 body", scoped to wires from tab X). The straight lines of T1 and T7b cross the REG-5V box (**superseded in r7:** "T1, T7b and T5"; T5 now sits at (58.42, 58.94) and its straight line clears the box). A tab X wire whose straight jacket crosses another pad, R175, the REG-5V box or CO-5V takes the **gap path**. The gap path leaves the pad into the adjacent inter-row gap (y 60.21, 62.75 or 65.29) and runs toward +x in that gap to x 64.77. x 64.77 lies half a pitch past column 6 and beyond the 64.50 mm courtyard edge; only there does the wire turn to its MB point (**superseded in r7:** "These three wires are dressed toward +y in the inter-row gaps, never across neighbouring pads"; the r7 dressed lengths were computed on a pad -> (63.50, pad y) path that ran over the row-1 pads). The gap y 60.21 carries 8 wires (T1, T7b, T4, T5, T12, T13, T16, T17r), the gap y 62.75 carries T6 and the gap y 65.29 carries 7 (T2, T11, T14, T15, T17, T21, F24). One 26 AWG jacket (OD ~1.0 mm, ASSUMPTION) fills a 1.04 mm gap, so the further wires of a gap stack above it; no stripped conductor extends past its own pad. The residual row is checked by the same rule. The straight T8 path from F09 to J2.31 crosses the REG-5V box and CO-5V and passes over the pin-1 post. T8 therefore takes the **upper lane** (calc revision 4): from F09 (28.98, 35.80) toward +y to (28.98, 37.55), along y 37.55 to x 43.43, down to (43.43, 34.64), along y 34.64 to x 63.50, then to J2.31 (89.2 mm dressed, 82.8 mm straight). The jacket (radius 0.5 mm, ASSUMPTION) keeps 0.50 mm from the F22 pad and lies inside the CR low edge (0 mm). It keeps 1.73 mm from the REG-5V box, 2.13 mm from CO-5V and 2.05 mm from the pin-1 post square (1.22 mm from its 1.9 mm CR pad land). It passes over the comparator band at y 37.55 over x 28.98-42.43, a wire over parts that is not booked as area, and it crosses the T18 option path. (**superseded in r7:** the review-7 **low-edge lane**, from F09 toward -y to y 34.40, 86.0 mm dressed; its jacket overhung the CR low edge by up to 0.24 mm and passed 0.15 mm below the F10 and F22 pads. A low-edge lane is infeasible by 0.59 mm: the jacket centre needs y >= 34.64 to stay on the CR and y <= 34.05 to keep 0.5 mm from the pads.) The straight T22 and T9 paths clear the REG-5V box, CO-5V and every header post. The tap wires are fitted after the FT1 bed has cured (PM4 order, A.7). T18 could not follow the dressing rule from tab X, so F22 sits on the footprint low row. Its straight path (10.54 mm) passes beside the pin-1 post, 0.240 mm from the post square, and crosses that post's 1.9 mm CR pad land; the wire is dressed over the CR top there. The F22 pad courtyard is 5.33 mm from the J101 box. The T18 joint at CO-5V pad 1 sits 0.172 mm (centreline end) from the REG-5V box, so F101 and R172 at that joint receive a temperature-derating check in T-A-05.

| ID | CR field | MB point | Net (Teensy pin) | CR use | Length | Notes |
|---|---|---|---|---|---|---|
| T1 | F01 (**r7:** (50.80, 58.94); 63.4 mm straight, 70.1 mm dressed on the gap path (**superseded in r7:** 67.3 mm dressed)) | **C-D6 pad 1** (V-MOT) through **R170 10.0 kOhm 0.1 % 0805** soldered at the joint | V-MOT | H1 IN+ divider top (R109) | 0.15 m | The tap wire carries only a high-impedance signal; twisted with T7b |
| T7b | F02 (**r7:** (53.34, 58.94); 59.5 mm straight, 65.2 mm dressed on the gap path (**superseded in r7:** 62.5 mm dressed)) | **C-D6 pad 2** (GND) | GND | shield of the T1 pair, **bonded at the CR end only** (insulated at C-D6) | 0.15 m | Twisted with T1; carries no return current (A.6) |
| T2 | F03 (**r7:** (50.80, 66.56), beside R175a; 17.2 mm straight, 20.7 mm dressed (**superseded in r7:** (58.42, 66.56), 9.9 mm straight)) | **C-D2 pad 1** (VBUS) through **R171 10.0 kOhm 0.1 % 0805** at the joint | VBUS | H1 IN- (R111) and UVB (R114) divider tops; one wire for both (B.2) | 0.10 m | A lost T2 drops UVB and with it H1q |
| T3 | F04 (**r7:** (63.50, 58.94); 28.5 mm straight (**superseded in r7:** (55.88, 61.48), 36.3 mm)) | J1.39 | D-BT-EN net (28, BT_BUS_ENABLE) | `BTB` into U115 IN- via R120 10 kOhm; R119 10.0 MOhm pull-up (r2) | 0.12 m | |
| T4 | F05 (**r7:** (55.88, 61.48); 39.2 mm straight, 41.8 mm dressed (**superseded in r7:** (58.42, 58.94), 35.6 mm)) | J1.43 | D-BC-RG net (30, REGEN_ENABLE) | `RGN` tap via R121 1 kOhm into **U121 RGN_ON** (r6: divider R190 453 kOhm / R191 1.00 MOhm, trip 1.75-1.88 V at the EN net, above VEN_R max 1.4 V); R133 100 kOhm pull-down kept (open tap = off); KA option enable on the raw tap | 0.12 m | r6: pin 30 never `INPUT_PULLUP` (FR-49) |
| T5 | F06 (**r7:** (58.42, 58.94); 37.2 mm straight, 41.1 mm dressed (**superseded in r7:** (55.88, 58.94), 39.2 mm straight, 41.0 mm dressed)) | J1.45 | D-BC-FC net (31, FC_CHARGE_ENABLE) | `FCC` tap via R122 1 kOhm into **U119 FCC_OFF** (R186 10.0 kOhm, R187 3.30 MOhm pull-up: an open tap reads "may be on") and **U120 FCC_ON** (R188 453 kOhm / R189 1.00 MOhm); **R134 DNP** (r6, finding fcc-rgn-lvc-threshold-vs-rt1987-en-band: a pull-down there would make an open tap read "proven off") | 0.12 m | r6: pin 31 never `INPUT_PULLUP` (FR-49) |
| T6 | F07 (**r7:** (53.34, 64.02), beside R175a; 34.8 mm straight, 36.2 mm dressed (**superseded in r7:** (53.34, 61.48), 34.3 mm)) | J1.29 | 3V3 | CR + EIB logic supply (the only source of that rail) **through R175 68 ohm 1206 at F07** (r4, finding cr-eib-3v3-feed-unprotected-short: a CR or ribbon short is held to <= 48.5 mA, 0.16 W, instead of browning out the Teensy, INA253 and MDAC 3.3 V net; CR rail 3.18 V at 1.82 mA, H.20) | 0.12 m | <= 1.82 mA (H.15); no other conductor feeds the rail (r2: I2C pull-ups on the MB, CE_RB on a pull-up-free pin; r4: no CR pull-up on pin 35) |
| T22 | F08 (r6; the capture puts F08 at the low-y tap-field position nearest BAL, x ~26.4; **r7:** residual pad on the footprint low row, (26.44, 35.80); 5.4 mm straight) | **BQ29200 (BAL) pin 8 OUT, net BAL-NOK** (board (25.86, 30.44), the outer toe of the 0.85 x 0.35 mm DRB pad; no trace leaves it), **30 AWG Kynar**, RTV dot over the joint, Kapton over BAL (PM11) | BAL-NOK (no Teensy pin; hardware only, CLAUDE.md §4 forbids only a firmware BAL-NOK input) | R178 100 kOhm -> N_BAL (D108 BAV199 clamp, R179 1.00 MOhm pull-up to 3V3) -> U123 Schmitt inverter -> **OVN** (r6, finding vreg-corruption-no-fixed-pack-ovp) | 0.05 m | A bridge to pin 7 (VDD, 0.3 mm gap) reads OV permanently (charging refused, announces itself); an open joint reads OV (R179). T-A-01c checks pad access and that J-BL is plugged |
| T8 | F09 (**r7:** residual pad on the footprint, (28.98, 35.80); 82.8 mm straight, 89.2 mm dressed in the upper lane (**superseded in r7:** 86.0 mm in the low-edge lane)) | J2.31 | BT-CURR (41, BT_CURRENT, INA253 BT out) | U104 IN- via R140 10 kOhm; R144 1.00 MOhm pull-up on the CR side | 0.15 m | Twisted with T9 at F09/F10 only: the T8 upper lane and the T9 straight path part there (**superseded in r7:** the T8 low-edge lane) |
| T9 | F10 (**r7:** residual pad on the footprint, (31.52, 35.80); 25.7 mm straight to SNS-BT pad 15) | **SNS-BT GND / REF1 pad** (or its nearest via; T-A-01) | GND, Kelvin | U104 reference divider bottom (R142); R143 100 ohm to the CR plane as backup | 0.12 m | Not to J2.03 (finding btok-kelvin); twisted with T8 |
| T10 | F11 (**r7:** (63.50, 64.02); 23.6 mm straight) | J1.23 | pin 10 -> `CHG_QUAL` | U111 B input via R147 1 kOhm, R123 47 kOhm pull-down | 0.12 m | |
| T11 | F12 (**r7:** (55.88, 64.02); 54.3 mm straight, 55.5 mm dressed (**superseded in r7:** (58.42, 64.02), 51.7 mm)) | J2.19 | pin 17 -> `CHG_FCCEIL` | logic input, R124 47 kOhm pull-down | 0.15 m | |
| T12 | F13 (**r7:** (55.88, 58.94); 60.1 mm straight, 63.0 mm dressed (**superseded in r7:** (60.96, 58.94), 55.6 mm)) | J2.47 | pin 33 <- `CHG_ILIM_RB` (far-end ILIM_HIZ sense, U203) | readback, R125 1 kOhm | 0.15 m | |
| T13 | F14 (**r7:** (60.96, 58.94); 54.4 mm straight, 56.7 mm dressed (**superseded in r7:** (63.50, 58.94), 52.1 mm)) | J2.45 | pin 34 <- `CHG_H1_RB` | readback, R126 1 kOhm | 0.15 m | pin 34 must stay GPIO (G.3); `INPUT_PULLDOWN` |
| T14 | F15 (**r7:** (58.42, 64.02); 51.6 mm straight, 52.8 mm dressed (**superseded in r7:** (63.50, 61.48), 46.7 mm)) | J2.21 | pin 16 <- `CHG_H2_RB` (H2c) | readback, R127 1 kOhm | 0.15 m | |
| T15 | F16 (**r7:** (58.42, 66.56); 54.3 mm straight, 56.4 mm dressed (**superseded in r7:** (55.88, 66.56), 56.7 mm)) | J2.07 | pin 23 <- `CHG_BTOK_RB` | readback, R128 1 kOhm | 0.15 m | |
| T16 | F17 (**r7:** (58.42, 61.48); 56.7 mm straight, 58.1 mm dressed) | J2.43 | pin 35 <- `CHG_EFUSE_FLT` | readback; **r4: pull-up is the Teensy pad (`INPUT_PULLUP`), CR R106 DNP** (finding pin35-flt-floats-on-open-tap: an open T16 or a missing pull-up now reads "no fault", which keeps FR-08 armed; a CR-side pull-up would back-feed the CR rail through the Teensy pad pull-up when T6 opens); **r8 (CHG-R1-01):** CR **R106s 1.00 kOhm 1 %** in series between U101 FLT and the F17 pad, placed on the tab X bottom beside the F17 pad (A.8 r8 R106s placement; **superseded in r8:** placed behind the pad), holds a powered F05-F17 or F06-F17 bridge to <= 3.377 mA of FLT sink current against the 10 mA absolute maximum (tps2663.pdf sec 6.1; H.23(n), B.4, A.8) | 0.15 m | |
| T17 | F18 (**r7:** (60.96, 64.02); 51.9 mm straight, 53.0 mm dressed (**superseded in r7:** (60.96, 66.56), 51.1 mm)) | J2.09 | pin 22 (A8) <- `CHG_IIN` | eFuse IMON via R129 10 kOhm, C129 1 nF at the pin side | 0.15 m | Twisted with T17r |
| T17r | F19 (**r7:** (60.96, 61.48); 49.4 mm straight, 50.5 mm dressed (**superseded in r7:** (60.96, 64.02), 49.7 mm)) | J2.29 | GND | shield of the T17 pair, **bonded at the CR end only** (insulated at J2.29) | 0.15 m | Twisted with T17 |
| T20 | F20 (**r7:** (63.50, 66.56), over the FT1 body; 18.3 mm straight (**superseded in r7:** (55.88, 64.02), 26.3 mm)) | **MB ROS pad 2** (net N$21, Teensy pin 7; ROS removed, PM10) | pin 7 <- `CHG_CE_RB` (far-end /CE sense, U204) | via **CR R148 1.00 kOhm** (+ EIB R264 470 ohm, r4); Teensy `INPUT_PULLDOWN` | 0.10 m | No pull-up on this net, so a dead U204 or an open conductor reads LOW = "/CE LOW" (announces itself through FR-08(b)); pin 8 / RENC2 / the encoder net are untouched |
| T21 | F21 (**r7:** (60.96, 66.56), over the FT1 body; 50.5 mm straight, 52.2 mm dressed (**superseded in r7:** (63.50, 66.56), 48.0 mm)) | J2.11 | pin 21 -> `CHG_HB` (heartbeat) | U113 B input via R135 1 kOhm, R136 100 kOhm pull-down | 0.15 m | |
| T18 | F22 (**r7:** residual pad on the footprint low row, (41.68, 35.80); 10.5 mm straight) | **CO-5V pad 1** (+5 V) through **F101 (0603 fast fuse, ~50 mA class) + R172 33 ohm 1206** soldered at the joint (r4), Kapton over them | 5V (battery-derived, LM1084) | keep-alive option source | 0.05 m | **Fit only if T-B-09 fails.** r4 (finding r172-0805-short-dissipation): the r3 10 ohm 0805 would have taken 2.5 W in a tap short; now the prospective short is 152 mA and F101 opens it (opening time at 0.15 A <= the R172 short-time overload rating, both from their datasheets in T-A-05); drop 46 mV at 1.4 mA, KA VCHG minimum 3.58 V > the RT1987 UVLO-rising maximum 3.35 V (H.20) |
| T19 | F23 (**r7:** (63.50, 61.48); 47.8 mm straight (**superseded in r7:** (60.96, 61.48), 50.2 mm)) | J2.33 | pin 40 FC_CURRENT (INA253 FC out) | U117 option input | 0.15 m | **Fit only with the U117 option** (FR-14 fail branch) |
| - | F24 (**r7:** (55.88, 66.56); 35.6 mm straight, 39.0 mm dressed (**superseded in r7:** (53.34, 66.56), 37.8 mm)) | J1.07 (pin 2) | spare | - | - | Optional `PURGE_SENSE` (T-E-02) **only if pin 2 passes T-A-01b** (J1.07 is the ENC_A net with RENC1) |

Teensy pins 5, 6, 18, 19 need no tap: they reach CR through CHG pads 11, 3, 8, 7. Pin 20 stays free for the MCU watchdog
WDOG1_B (G.3). **Pin 8 is not used (r2):** its net ENC_B still carries RENC2 and, after the 2026-08-16 reroute and the fitted
74HC14 (both unrecorded as to wiring), possibly the live encoder-B signal; a push-pull U204 output there could fight it and
back-power the EIB through RENC2 (findings pin8-tap-on-encoder-net, eib-pin8-backpower-unpowered-outputs). **Pin 7 is used
instead** through the ROS pad: removing ROS isolates pin 7 from the retired ENC-EN net whatever that net now carries. Pin 2
(ENC_A, RENC1) stays free unless T-A-01b clears it. With pin 7 assigned and pin 20 reserved, the only spare Teensy pins are 2 and 8, both on
encoder nets (recorded, J.2).

### A.5 EIB wiring to the EVM (28 AWG Kynar; EIB on the EVM plate beside the EVM's right edge, r7; on the chassis in r6)

**r6 (finding eib-e-lead-max-lengths-geometrically-infeasible): positions and lengths re-derived from a drawn placement.** SLUUCB5E
Fig 4-1 (top layer, silkscreen) rendered at 150 dpi and scaled from the J8 2.54 mm pitch (8.66 px/mm; read from the render, about
+-2 mm, `calc/r3_calc.py` H.22(i)): EVM right edge x = 1017 px; TP49 (970, 308), TP33 (941, 441), JP21 pin 2, the upper post (AGND), (902, 408) (r7: pin 1 is the lower square post; **superseded in r7:** JP21 pin 1 (902, 408)), JP14 pin 2
(869, 432), TP38 (822, 474), TP27 (490, 300), JP12 REGN pin (598, 862), TP36 (740, 812), JP17 /CE pin (727, 752) px (y down in the
render). **JP13/JP14/JP21** sit top-right in a row under the "ILIM_HIZ SET" legend, left of TP33 and above TP38; **JP17** ("CHARGE
ENABLE") is centre-bottom, directly above TP36 (/CE) and TP35 (TS). **Drawn placement:** the EIB pad column runs vertically 7 mm off
the EVM right edge, top to bottom E8, (empty), E3, E4, E2, (empty), E7, (empty), E1, (empty), E5, E6 (A.9), with E3 5 mm above the
level of TP33. The r5 row (E3 at one end, E8 at the other, 27.94 mm apart) put E8 above TP49 and every other pad above TP33, so E5
landed ~57 mm from TP36, E7 ~33 mm from TP38 and E1 ~66 mm from TP27, past their r5 maxima; the r6 order puts E8 and E3 together at
the top and runs the row downward toward TP38 and TP36. Build maximum = straight distance x 1.25 (routing around parts), rounded up
to 5 mm. **T-A-02** confirms each point by net and **T-A-06** records every final length against these maxima on the dry fit.

**r7 (vector EVM positions, H.23(k)):** the EVM points now come from the SLUUCB5E rev E vector layer figures (Figs 4-1 to 4-4), in the EVM frame of `round4/work/evm_geometry.md` Table 1 (mm, top view, origin at the lower-left board corner, +y up). The r6 rendered-figure scale (8.66 px/mm) was 2.5 % (x) and 2.2 % (y) high (`round4/work/evm_geometry.md` section 7.1), so the r6 straight distances were 0.7-2.9 % short (E8 to E5); the r6 pixel positions above are superseded. JP21 pin 1 (ILIM_HIZ) is the lower square post at (75.312, 64.769) EVM mm; the r6 point (902, 408) px is the upper post, pin 2 (AGND). The EIB placement relative to the EVM is unchanged: pad column 7 mm off the EVM right edge (x 95.90 EVM mm), E3 at y 68.499 (5 mm above TP33), rows 2.54 mm apart downward. The r6 rule (straight x 1.25, rounded up to 5 mm) re-runs on the vector positions. E1 rises from 85 to 90 mm and E5 from 60 to 65 mm; the other six maxima are unchanged. The three sense and hold leads E3, E4 and E6 have a pickup criterion (`round4/work/eib_merge_failsafe.md` Table 9: sustained EMF <= 10 % of the smallest margin). Each uses at most 0.51 of its length limit: E3 0.27 of 92 mm, E4 0.51 of 59 mm, E6 0.31 of 196 mm. The EIB stands on the EVM plate with the EVM (A.7), so the two ends of every E lead share one mount. The EVM is held by friction on compliant bumpons, so the E leads see a small relative motion: 0.03-0.12 mm at 30 g without slip (ASSUMED: bumpon stiffness 50-200 N/mm, EVM mass 50-80 g, TODO(measure: MS7)). If the clamp friction is exceeded, the lateral stops bound the motion at 0.3 mm (A.7). Both values are far below the smallest slack within a build maximum, 6.4 mm in plan for E8, so the loop areas and the pickup ratios above stay valid.

| ID | EIB point (row position) | EVM point | Net | Straight / **build max** | Class | Notes |
|---|---|---|---|---|---|---|
| E8 | `AGND` (1) | **TP49** (AGND) | ground for the stages | 13.5 / **20 mm** (**r7:** 13.6 / **20 mm**) | length-critical (ground reference) | TP49 replaces TP48 (TP48 is ~88 mm away in the far corner) |
| E3 | `ILIM_HOLD` (Q201 drain, R257 bottom via Q202) (3) | **TP33** | ILIM_HIZ hold-down and FC leg | 16.5 / **25 mm** (r5: 20) (**r7:** 16.7 / **25 mm**) | length-critical (high-impedance node) | Away from SW and L2 |
| E4 | `ILIM_SNS` (U203 input via R258) (4) | **JP21 pin 1 (ILIM_HIZ)** (JP21 open; R256/C252 share the post on their own joint; **r7:** the lower square post, (75.312, 64.769) EVM mm) | far-end sense | 20.3 / **30 mm** (**r7:** 20.6 / **30 mm**) | length-critical (10 MOhm pull-up sense) | Separate joint from E2/E3, so a detached control joint is seen |
| E2 | `ILIM_FEED` (R255 output) (5) | **JP14 pin 2** (on ILIM_HIZ through EVM R21 = 0 ohm; JP14 shunt out, JP14 pin 1 removed, EVM R20 and JP13 pin 1 removed, EM3) | release current | 24.1 / **35 mm** (**r7:** 24.6 / **35 mm**) | semi-critical (48.7 kOhm feed) | Lead off = no release current = HIZ |
| E7 | `STAT` (7) | **TP38** | STAT | 29.5 / **40 mm** (r5: 30) (**r7:** 29.9 / **40 mm**) | static (R275 in series) | To ribbon pin 4 through R275 |
| E1 | `REGN` (9) | **JP12 REGN pin** (r6: shorter than TP27, 67 vs 77 mm straight, rendered-figure distances; **r7:** JP12 pin 1, the square post, at (39.370, 13.741) EVM mm) | REGN | **r7:** 69.0 / **90 mm** (**superseded in r7:** 67.3 / **85 mm**; r5: 65) | static (gate pull-up supply, 100 nF C205 at the EIB) | **r7:** E1 supplies the Q201/Q202 gate pull-ups R252 and R254, the Q203 gate resistor R271 and the release feed through Q203/R255 (B.6); of the H.15 "REGN pull-ups R254/R272/R272b", only R254 passes through E1, because R272/R272b sit on the EVM (**superseded in r7:** Supply for the Q201-Q203 gate pull-ups only); **r7: E1 enters the EIB through R276 (below)**; **r7:** an EVM-edge route is at least 96.05 mm long, over the 90 mm maximum (**superseded in r7:** dressed along the EVM bottom edge, away from L2 and the SW nodes). E1 runs from the E1 pad to one bend near (51.0, 30.6) EVM mm and then to JP12 pin 1, below U1 and L2; its length is 70.8 mm against the 90 mm maximum. The bend keeps E1 5.02 mm from the JP17 pin-1 joint (E6, /CE), 6.57 mm from the centre of the vacated JP17 pin-2 hole, 10.20 mm from TP36 (E5), 9.03 mm from the U1 outline and 17.12 mm from the L2 outline. The straight line (69.0 mm) would pass 1.97 mm from JP17 pin 1 and 0.11 mm from the centre of the vacated JP17 pin-2 hole, that is through the hole. `round4/calc/r7_calc.py` H.23(k), revision 4, on the `round4/work/evm_geometry.md` Table 1 positions (**superseded in r7:** a hand calculation that stated the pin-2 figure as a distance to the hole); T-A-06 records the length |
| E5 | `nCE_DRV` (U201 1Y) (11) | **TP36** | /CE drive | **r7:** 49.1 / **65 mm** (**superseded in r7:** 47.7 / **60 mm**; r5: 50) | static (open drain, 47k pull-ups) | |
| E6 | `nCE_SNS` (U204 input via R262) (12) | **JP17 pin on the /CE side** (JP17 removed, EM1) | far-end sense | 44.3 / **60 mm** (**r7:** 45.4 / **60 mm**) | length-critical (1 MOhm divider sense) | Separate joint from E5; twisted loosely with E5 (same net, no crosstalk concern) and kept >= 10 mm from L2 |

**r7: R276 (E1 damping, H.23(k)).** The EIB carries **R276 10.0 ohm 1 % 0603 (CRCW060310R0FKEA, the R273 MPN)** in series with E1 at the EIB E1 pad, between the E1 lead and the EIB REGN node (C205). Without R276, E1 with its E8 return and C205 (100 nF) is a series LC at 1.471 MHz (85 mm) or 1.430 MHz (90 mm), against the 1.5 MHz BQ25798 switching frequency (JP24/EM19). On the DC wire resistance the undamped Q is 19.3 (85 mm) and 19.1 (90 mm), or 25.5 and 25.6 with the E8 return at its 20 mm maximum. With the skin-effect resistance (Rac/Rdc 1.71 at 1.43 MHz) these fall to 13.1 and 13.0 (18.4 and 18.5). All are upper bounds, because the model omits the proximity effect and the frequency dependence of the C205 ESR. With R276 the Q is 0.108 (85 mm) and 0.111 (90 mm): the loop is overdamped (zeta 4.6 and 4.5). R276 with C205 is also a 159 kHz low-pass, so a 1.5 MHz REGN ripple reaches C205 at 0.106 of its EVM amplitude; T-C-16 checks the ring. E8 is the only DC ground of the EIB (A.6), so the E1 loop current returns through it. Without R276, the E8 drop at f0 is 20.0-31.4 mV per 10 mV of REGN ripple with a return of the E1 length, and up to 41.7 mV with the E8 return at its 20 mm maximum (E8 partial inductance 19.09 nH at its 20 mm maximum; `round4/calc/r7_calc.py` H.23(v), revision 5, on the H.23(k) loop; **superseded in r8:** 20-31 mV per 10 mV of REGN ripple (E8 partial inductance 19.1 nH at its 20 mm maximum; hand calculation on the H.23(k) loop)). That drop shifts EIB AGND, which carries the U203/U204 REF and the Q201 hold, against TP49. It therefore draws on the E3 (75 mV) and E4 (48 mV) budgets of `round4/work/eib_merge_failsafe.md` Table 8. With R276 the drop is 0.170-0.176 mV per 10 mV of ripple (H.23(v); **superseded in r8:** 0.17 mV). The static drop across R276 is 1.02 mV at the H.15 E1 load (0.102 mA, held, R254 only, REGN 4.8 V) and at most 3.96 mV (0.396 mA, released into the regen clamp, REGN 5.2 V). In the held states Q203 is off and Q201 sets the hold level, so the drop changes nothing. In the released states the drop lowers the ILIM_HIZ release level by at most 1.786 mV, which lowers IINDPM by at most 2.23 mA. This is the safe direction for the converter and the eFuse (less input current). For regen absorption (H.7) it is the adverse direction, but 2.23 mA is 0.13-0.17 % of the 1.33-1.76 A regen clamp, so no H.7 margin changes. The gate drives are unaffected at the mV level.

Parts fitted on the EVM itself (not on the EIB): **R256 200 kOhm and C252 2.2 nF C0G (0603) tacked between the JP21 header
posts, pin 1 (ILIM_HIZ) to pin 2 (AGND)** (r3, finding r256-c252-agnd-landing-unspecified: JP21 pin 2 is the AGND end of the
"ENABLE HIZ" shunt position, SLUUCB5E Fig 4-6, so the parts land on AGND and not on PGND, SLUUCB5E layout note 7); **R272
47.0 kOhm** from the /CE pad of the vacated R42 footprint to **TP27 (REGN)** with a <= 10 mm Kynar link L1, and **R272b
47.0 kOhm** from the **TP36 (/CE)** loop base to the **JP12 REGN pin** with its own <= 15 mm Kynar link L2 (r3, finding
ce-pullup-link-sense-divider-fails-low). The two pull-ups share no joint and no conductor, so /CE stays >= 4.17 V with either
one open (H.19); with both open, R263 pulls /CE LOW and U204 announces it (B.6). R272b is deliberately not on the EIB: there it
would pull the EIB side of E6 up and make a lifted E6 read "/CE HIGH", masking a stuck-LOW /CE. Identify every point by net with
a meter before soldering (T-A-02).

### A.6 Ground scheme (single-point bonding, r2)

- **Power star:** CR GND plane, tied to MB GND at CHG pads 4 (VIN-) and 14/15 (VBAT-). W4 returns between pads 14 and 15. **r6
  (finding a6-w2-not-beside-star-pads):** since r5, W2 sits at (27.7, 61.2), ~18.4 mm from pad 4 and ~8.0 mm from pad 14, so the
  input return reaches the star through the CR GND copper: a >= 2.5 mm L1 GND pour (2 oz) runs from W2 to pads 14/15, routed
  outside the H1/UVB/CHG divider bottoms and the R105/IMON ground end (so the 1.76 A input return does not pass under an analog
  return), with the L2 plane below it; T-A-06 checks this copper. On 2 oz copper the extra ~8 mm adds < 1 mOhm (no budget change).
  The BQ25798EVM joins PGND and AGND at net-tie NT1 (SLUUCB5E Fig 4-5, next to C41/AGND) and senses current high-side only (R2,
  R13 and internal RSNS; study §1.1 H1), so VIN- = VBAT- is the requirement R-GND and is met. The pack negative is PCB ground
  by design (operator, 2026-11-04).
- **Logic return:** the CR plane itself, bonded to MB GND at CHG pads 4/14/15 (T7 omitted in r2). The divider bottoms of H1 and
  UVB are on the CR plane. T7b and T17r are shields bonded at the CR end only, so no tap wire carries motor or charger return
  current. A plane offset delta shifts the H1
  trip by only about 0.07 x delta (both inputs see it), so 10 mV costs 0.7 mV.
- **Kelvin for BT_OK:** the INA253 BT output is 6-34 mV at the threshold, so a few mV of offset matters. The INA253 output is
  referenced to its own GND/REF1/REF2 pins at SNS-BT (`.sch` net GND includes SNS-BT.GND, .REF1, .REF2). The U104 reference
  divider bottom (R142) therefore returns to the **T9 wire landed on the SNS-BT GND/REF1 pad**, twisted with T8. R143 (100
  ohm) ties R142's bottom to the CR plane, so an open T9 shifts the trip only to about 22 mV instead of floating it; with T9
  intact the plane offset couples with a ratio of about 2e-4. T-E-10 measures the residual offset under load.
- **EIB and EVM: one DC ground each, no parallel return (r2).** The EIB's DC ground is E8 at TP49 (EVM AGND). The four ribbon
  GND conductors (3, 9, 12, 14; position 6 is the key, r3; 9/10 swapped in r4) are bonded to the CR plane at J101 and reach EIB AGND only through R273 10 ohm: the EIB
  supply and signal returns (<= ~1 mA, H.15) drop <= 10 mV across it, while the share of the 1.4-1.6 A net EVM ground current
  that would otherwise cross the EVM AGND copper, E8 and the ribbon (finding estimate 0.1-0.3 A through 25-40 mOhm) falls below
  ~2 mA (10 ohm against W2 || W4 ~4 mOhm). W7's GND conductor is bonded at the CR end only (J8 pin 1 empty) and W6's likewise, so
  I2C and TS reference the EVM through the power returns: offset <= ~20 mV at 3.1 A (H.11), against the BQ25798 0.4 V VIL margin
  and the TS divider ratio. TI asks that ILIM and TS ground terminals stay away from high-current returns (SLUUCB5E layout note
  7); R256/C252 sit across the JP21 posts (ILIM_HIZ to AGND, r3), away from PGND. **T-F-11** measures the residual signal-ground currents (pass < 20 mA
  DC in any signal-ground conductor, < 2 mV AGND-PGND).
- **Analog taps referenced to the CR plane (r5, finding imon-vchg-ground-offset-under-charge-current):** the eFuse IMON voltage
  (R105 to the CR plane, T17r bonded at the CR end) and the CHG_VOLTAGE divider are read by the Teensy against its own AGND. The
  CR plane is bonded to MB GND at CHG pads 4/14/15, which carry the charger input return (<= 1.76 A) and the net EVM ground
  current (~1.5 A), so any MB-GND drop between those pads and the Teensy AGND appears directly on pin 22 at 1.31 A per volt
  (5 mV = 6.5 mA, 15 mV = 19.6 mA, i.e. 13-40 % of the provisional +-50 mA FR-11 band; H.21) and on pin 38 at x8.87. **T-F-15**
  measures the offset on the vehicle under charge current; FR-11 carries the measured offset in its threshold; if it exceeds
  10 mV at 1.7 A input, the fallback is a Kelvin IMON return: R105's ground end lifted off the plane and returned through T17r
  landed at the Teensy AGND end (instead of the CR end) with a 100 ohm tie to the CR plane, as T9/R143 do for BT_OK.
- **r7 (tabs, feet and the EVM plate; the topology is unchanged):** the CR L2 GND plane continues without a break into tab X and tab Y. Every tab-side pad, part and bottom passive therefore returns to the same plane, which still bonds to MB GND only at CHG pads 4/14/15. The far-end feet FT1 and FT2 are non-conductive (PA66 or PBT blocks on neutral-cure RTV beds) and add no ground contact between the CR and the MB. The MB vias are not tented (H.23(c2)); the polyimide sheet and the L4 solder mask keep the tab undersides off the exposed via rings. The EVM plate is insulating, and no fastener, clamp or adhesive bonds EVM copper to the plate, the CR or the chassis (checked in T-A-02). The single-point scheme above therefore holds as written: the EVM ground reaches the CR only through W2 and W4, and the EIB ground reaches the EVM only through E8 at TP49 and the CR only through R273.

### A.7 Mechanical

- **r7 outline (round 4, H.23(a)).** The **r7 outline** is the r6 rectangle x 17.70-48.70, y 34.14-67.14 plus two tabs, with the
  pin-11 chamfer relocated. **Tab X** is the CR extension toward the Teensy, x 48.70-65.00, y 56.30-68.30 (195.60 mm²). **Tab Y**
  is the CR extension toward L-FC, x 17.70-37.56, y 67.14-76.00 (175.96 mm²). The gross area is 1394.06 mm² (r6 rectangle 1023.00
  + tab X 195.60 + tab Y 175.96 - chamfer 0.50 mm²); the bounding box is x 17.70-65.00, y 34.14-76.00 = 47.30 x 41.86 mm. The
  following table lists the vertices in board coordinates (A.8 convention), counter-clockwise from the -x/-y corner.

| Vertex | x | y | Corner |
|---|---|---|---|
| V1 | 17.70 | 34.14 | convex |
| V2 | 48.70 | 34.14 | convex |
| V3 | 48.70 | 56.30 | concave |
| V4 | 65.00 | 56.30 | convex |
| V5 | 65.00 | 68.30 | convex |
| V6 | 48.70 | 68.30 | convex |
| V7 | 48.70 | 67.14 | concave |
| V8 | 37.56 | 67.14 | concave |
| V9 | 37.56 | 76.00 | convex |
| V10 | 18.70 | 76.00 | convex (chamfer end) |
| V11 | 17.70 | 75.00 | convex (chamfer end) |

- **Concave corners (r7):** V3 (48.70, 56.30), V7 (48.70, 67.14) and V8 (37.56, 67.14) are the tab-root inside corners. The
  router leaves a fillet of its minimum inside-corner radius in each of them, TODO(verify: MS8 minimum inside-corner radius);
  T-A-06 checks the courtyard inset and the bottom clearance rule on the filleted outline.
- **Tab content (r7; per-region rules in A.8).** Tab X carries on its top the tap field (20 SMT pads on a 6 x 4 grid at 2.54 mm,
  x 50.80-63.50, y 58.94-66.56), R175 and two spare grid positions; on its bottom, only the passive classes that the thermal band admits, under the bottom
  clearance rule; and FT1. Tab Y carries on its top the LVC gates U105, U106, U107, U110, U114, U116 and U118 (U108 and U109 sit in the footprint interior, A.8, H.23(e2)); on its
  bottom, logic pull-downs, series resistors and decouplers; and FT2 with its fill hole. The residual tap pads F08 (T22), F09
  (T8), F10 (T9) and F22 (T18) stay on the footprint low row y 35.80, and the rest of the freed r6 tap-field area becomes the
  comparator region (A.8). The straight-length sum of the 20 taps falls from 1308.0 mm to 859.3 mm (-34.3 %; 898.7 mm dressed with the T8 upper lane, 895.5 mm before calc revision 4,
  H.23(g); **superseded in r7:** 850.9 mm, 856.7 mm dressed). Tap wires from tab X take the A.4 gap path and never pass over the
  REG-5V box, CO-5V or a header post (A.4). W5 folds toward -x over the footprint interior
  and joins the W-lead dressing path across tab Y; no W lead crosses tab X (A.3 r7 review 7 note) (**superseded in r8:** W5 leaves J101 toward +y and crosses tab X at its fold height with W1/W2, clear of the tap pads (A.3)). The CR ends of W1-W4, the W6/W7 pads and the
  J101 region are unchanged.
- **Tab trims and neighbours (r7, H.23(b)).** No MB part box overlaps either tab. Tab Y ends at x 37.56 so that ROP1-FC (box
  0.501 mm from the tab) and ROP2-FC (1.664 mm) stay uncovered and reachable: they set the OPA197 gain of the FC droop network,
  whose AD5443/OPA197 DMM block measurement is an open bench item. OP-FC lies 2.659 mm from tab Y. Tab Y ends at y 76.00 so that
  the L-FC body keeps 0.862 mm with the Eaton 12.9 mm body centred on its footprint origin (ASSUMPTION, TODO(verify: Eaton
  HCM1A1305V3 drawing), MS3 caliper). With the 12.6 mm silkscreen body the gap is 1.012 mm. A tab Y edge at y 76.51, 0.5 mm
  short of the L-FC silkscreen line (y 77.01), would leave only 0.352 / 0.502 mm.
  The tab X neighbours are MDAC-FC (box 1.701 mm from the top edge), REG-5V (box 1.786 mm, body 3.953 mm from the low edge) and
  C-D2 (box 2.181 mm from the right edge). The tab Y neighbours are J-FC (box 0.470 mm, body 1.570 mm from the chamfer) and
  J-NTC (1.448 mm). Neither tab covers a named rework point: the R171/T2 joint on C-D2 pad 1 lies 3.118 mm from tab X, ROP1-FC
  and ROP2-FC 0.501 and 1.664 mm from tab Y, and RENC2, BAL pad 8, RB1A, CBL2, CO-5V and the T18 point >= 14.318 mm from both.
- **Clearances on copper rims (r7, H.23(b)).** Every plan clearance to MB copper is computed on the copper rim: a trace by half
  its width, a polygon by half its outline width beyond its vertex path, a via by its 0.7564 mm pad and an MB CHG header pad by its
  1.650 mm square. The VBUS L1 polygon (outline width 1.016 mm) reaches 0.024 mm from the tab X right edge x 65.00, and the
  MPPT-DISABLE via pad at (65.024, 61.722) reaches 0.354 mm over it. The 5V via pad at (59.389, 55.579) and the 5V L1 trace rim
  lie 0.343 mm and 0.467 mm below the tab X low edge. These rims bear on nothing, because the tab underside carries no exposed
  copper over them (bottom clearance rule, L4 solder mask, polyimide sheet).
- **Rejected extension zones (r7; `round4/work/mb_mechanical.md` sections 3 and 6.4).** The -x zone and the zone past x = 0 lie
  over or beside J-BL/J-FC (21.70 mm) and J-NTC (13.90 mm), whose wire entries and screws must stay reachable. The -y zone covers
  the rework points BAL pad 8 (T22, PM11), RB1A and CBL2 and lies 2.96 mm from VSW-BT. Wide or edge-reaching +y zones cover the
  FC droop analog or a boost switching node; their raised stack is no longer an objection (D-H, re-assessment below) (**superseded in r8:** Wide or edge-reaching +y zones need a raised stack and cover the FC droop analog or a boost switching node). An extension past x 65.00 is a 34.2 mm cantilever (first
  mode estimated at 0.51-0.73 kHz) over 139 mm² of the 16 V VBUS pour, with its tip 0.5 mm from RENC2 in the unrecorded
  encoder-bodge area. Mounting the EVM on the CR covers the whole FC boost channel, which has an open undiagnosed fault.
- **Rejected zones re-assessed without a height limit (r7 review 7 close, D-H).** The operator statement of 2026-11-10 removes
  every maximum height for the MB and its PCBs. A raised stack, a taller header body or a taller connector therefore stops
  being an objection by itself. Each rejection is re-assessed on its remaining reasons (`round4/work/mb_mechanical.md`
  Table 1, `round4/work/proposal_evm_on_cr.md` section 2.1); no new layout is adopted:
  - the -x zone and the zone past x = 0 cover the J-BL/J-FC wire entries and screws and the J-NTC push buttons; a header body
    of >= 22.7 mm would clear the blocks in height, but not the access: still rejected;
  - the -y zone covers BAL pad 8 (T22, PM11), RB1A and CBL2 and lies 2.96 mm from VSW-BT; it had no height reason: still
    rejected;
  - the +y wide zone (x 17.70-48.70, y 67.14-76.51) had one height reason, a 2.75 mm header body over OP-FC. It still covers
    the FC droop analog (OP-FC, MDAC-FC, RD/RINJ and the VDROOP-FC, N$7 and N$8 nets) and blocks OP-FC and MDAC-FC, whose
    AD5443/OPA197 DMM block measurement is an open bench item: still rejected;
  - the +y and -y zones to the MB edge lie over a boost switching node (L-FC, REG-FC and VSW-FC; L-BT, REG-BT and VSW-BT) and
    cover the boost, droop or BAL parts: still rejected;
  - the extension past x 65.00 is a 34.2 mm cantilever over the 16 V VBUS pour with its tip 0.5 mm from RENC2; it had no
    height reason: still rejected;
  - the EVM on the CR covers the FC boost channel and puts the EVM mass on the 22 pins; it had no height reason: still
    rejected;
  - the mezzanine over the MB loses its height objection; its remaining reasons still reject it for this round (J.2 item 61).
- **Outline freeze (r7):** the tab outlines are frozen only after the T-A-08 survey passes (MS3: unrecorded items inside each tab
  outline + 0.5 mm and under each foot spot, L-FC body by caliper). A fail trims the tab and re-runs `round4/calc/r7_calc.py`.
- **Pin-11 chamfer (r7, relocated):** the 1.0 mm x 45 degree chamfer moves to the tab Y -x/+y corner (17.70, 76.00), edge
  (18.70, 76.00)-(17.70, 75.00). It stays the only chamfered corner and marks the pin-11 side on the CR, on the polyimide sheet
  print and on the T-A-06 1:1 print. The r6 chamfer corner (17.70, 67.14) is now a point on the straight left edge x 17.70. A
  y-mirrored capture moves the chamfer to a low-y corner and puts tab X over REG-5V (4.83 mm tall), so the mirrored CR cannot
  seat; the print check (T-A-06 step 0) still catches the mirror before ordering. The pads are unchanged, so
  `calc/pin_identity_check.py` is unchanged.
- **Header stack (r7, unchanged from r6; H.23(j)).** The strips stay Samtec TSW-110-07-G-S (column x 45.998, pins 1-10) and
  TSW-112-07-G-S (column x 20.998, pins 11-22): 2.54 mm PBT body, 0.64 mm square post, no spacer and no raised stack. The body
  seats on the 0.125 mm polyimide sheet, so the CR underside is 2.665 mm and the CR top 4.265 mm above the MB top (CR 1.6 mm,
  TODO(verify: CR fab stack-up); MB 1.6 mm, TODO(measure: MS6 caliper at the CHG holes)). The r6 PM4 orientation stays (short end
  B up through the CR, long end C down through the MB; Samtec F-226: A 10.92, B 2.54, C 5.84 mm): CR-top protrusion 0.940 mm,
  MB-bottom protrusion 4.115 mm before the PM4 step-4 cut. The W5 IDC socket and ribbon fold (>= 8.0 mm above the CR top, A.3)
  stay the tallest item. At J101 the stack top is >= 12.265 mm plus the cable thickness (TODO(verify: cable assembly drawing)). The
  nominal Ag105 envelope is 13.14 mm (`AG105_Silvertel.pdf` Figure 11 p.21) and is a reference only. **r7 review 7 close (D-H,
  operator statement 2026-11-10):** the MB and its PCBs have no maximum height, so neither the Ag105 envelope nor a lid
  clearance is a limit, and the stack top is information (H.23(j)). At J101 it is >= 12.265 mm plus the cable, that is 13.165 / 14.065 mm
  with one / two 0.9 mm ribbon thicknesses (ASSUMPTION). **r8 (H.23(t)):** W5 rests on the round-lead trunk over tab Y; at the B3 level the trunk occupies
  14.965-19.850 mm and W5 19.850-20.750 mm above the MB, so the stack top is 20.750 mm above the MB (16.485 mm above the CR
  top) at (32.80, 73.10), the highest point of the stack (information, D-H) (**superseded in r8:** Under the 3-D
  switched-conductor rule (A.3) the W5 run over tab Y sits >= 10.735 mm above the CR top, with its bottom >= 15.00 mm and its
  top >= 15.90 mm above the MB; the round leads run >= 10.14 mm above the CR top near L-FC. The W5 run over tab Y is
  therefore the highest point of the stack (information).)
  (**superseded in r7 (D-H):** the margin <= 0.875 mm before the cable, the expected
  margin of -0.03 to -0.93 mm, gate D-2, which MS1a decided before PM1, and its fallback of a right-angle or low-profile IDC
  or an MS2 lid-clearance basis, J.2 item 59.) MS1a still records the Ag105 standoff at the four corners before PM1 as the
  seating reference (`docs/reviews/battery_isolation_2026-11-07/detailed_design_IC1.md` section 15.2), with no pass/fail. The tabs and feet add no height: the header bodies set the CR height.
- The r6 rectangle is the footprint part of the r7 outline, and tab X and tab Y extend the CR past the CHG silkscreen
  (32.0 x 34.8 mm); the header-body statement below stands (r7) (**superseded in r8:** CR outline 31.0 x 33.0 mm stays inside
  the CHG silkscreen (32.0 x 34.8 mm)). The r6 rectangle is pulled 0.5 mm in on the OP-FC side,
  which still overlaps the outline by 0.3 mm (`spec.md` §7). The 2.54 mm header body clears D-BT-SQ, C-D11, C-D12, C-DC11,
  C-DC12 under the footprint (<= 1.10 mm).
- **CR outline (r3):** board x 17.70-48.70, y 34.14-67.14 mm (0.5 mm in from the silkscreen on the left/right and on the high-y
  OP-FC side, 1.3 mm in on the low-y side). Every courtyard >= 0.5 mm from it. **r7:** the pin-11 chamfer sits at the tab Y -x/+y corner (17.70, 76.00); see the r7 pin-11 chamfer bullet above (**superseded in r8:** r6 (finding cr-coordinate-convention-mirror-ambiguity):
  a 1.0 mm x 45 degree chamfer at the -x/+y corner (17.70, 67.14), next to pin 11, the only asymmetric feature of the outline: it
  marks pin 11 on the CR, on the polyimide sheet print and on the T-A-06 1:1 print, and a y-mirrored capture moves it to the -x/-y
  corner where the print check sees it. Nothing sits within 1.5 mm of that corner (pin 11 pad edge at (20.05, 64.48)).)
- **The whole CR footprint is a controlled interface (r3, finding cr-bottom-over-mb-power-traces).** MB layer-1 copper under
  the CR (`.brd`, parsed): **VBT** x 34.04-35.56 from y 31.75 to 48.65 and a 1.016 mm run at y 34.54 from x 41.9 to 47.0;
  **VCHG-IN** (no current limit in Run, J.1) on the diagonal (39.62, 34.80)-(43.18, 38.35) and x 42.42-43.94 from y 38.35 to
  61.2, then to pad 10; the **VCHG pour** x 20.14-28.65, y 43.31-49.96; the **VBT pour** x 30.81-34.98, y 48.34-49.76; logic
  traces CB-DISABLE (x 33.27, x 41.40, y 63.75), MPPT-DISABLE (y 64.48, the full width), the D-BT-SQ EN trace (x 36.32,
  y 41.7-52.3); the board-wide GND pour and 16 GND vias (**superseded in r7:** "tented"; the MB vias are not tented, H.23(c2), r7 via bullet
  below). **r7:** the controlled interface now covers both tabs (MB content under the tabs below). Rules:
  - every through-hole tail on the CR bottom (22 header pins, W1-W4) is flush-cut to <= 0.5 mm **everywhere**, not only in the
    keep-out (PM4, checked in T-A-06); **r7:** W1-W4 are the only CR through-hole parts with a tail on the CR underside (the header
    bodies cover the pin rings), and the rule applies to the whole r7 underside;
  - no bottom-side tap tails: F01-F24, W6 and W7 are top-side SMT pads (r7: unchanged; tab X lies over the MB MPPT-DISABLE,
    CB-DISABLE, CHRG-STAT, SCL, SDA and 3V3 traces);
  - bottom-side parts are **passives only, <= 1.0 mm tall** (0603/0805; >= 1.5 mm air under a 2.54 mm body), and meet the
    bottom clearance rule below (r7; bottom area H.23(d), booking A.8) (**superseded in r8:** stay outside the bottom keep-out
    and outside the projected outlines of MB VBT, the VBT pour, the VCHG pour and VCHG-IN, each grown by 1 mm (H.18: 591 mm²
    of bottom area remains for 366 mm² of passives));
  - a **0.125 mm polyimide sheet** is bonded over the MB area under the CR in PM4 step 1; it is a secondary barrier, inspected for
    chafe in T-F-12. **r5 (finding bom-polyimide-adhesive-unspecified):** polyimide film 0.125 mm (5 mil) with a silicone pressure-
    sensitive adhesive (BOM line "Polyimide sheet"), cut to the r7 sheet outline below (r7) (**superseded in r8:** cut to the CR outline + 1 mm on every side
    (x 16.70-49.70, y 33.14-68.14); this rectangle overlapped the CO-5V body),
    with 2.2 mm relief holes centred on the 22 header pads (A.8) and **cut-outs, not a drape, over the five parts under the
    footprint** (D-BT-SQ, C-D11, C-D12, C-DC11, C-DC12, each cut to its part body joined with its own pads + 0.5 mm, in two
    openings (r7 review 7 close; relief-hole bullet below) (**superseded in r8:** each cut to the part body + 0.5 mm, i.e. inside
    the bottom keep-out x 24.5-36.0, y 48.5-53.5; r7: the named keep-out retires and the five cut-outs are unchanged)) so the sheet lies flat on copper and solder mask; drawn to scale from these coordinates and
    checked on the 1:1 print in T-A-06. The parts in the cut-outs are protected by the >= 1.4 mm air gap under the 2.54 mm
    body (<= 1.10 mm parts) and by the bottom keep-out (r7: the bottom clearance rule), not by the sheet.
  - **r7 sheet outline (H.23(m)):** the r7 outline + 1 mm on every side (mitred offset), trimmed to >= 0.5 mm from every MB part
    body and every MB copper pad it would otherwise meet (SMD pads as rotated in the `.brd`, through-hole pads by their
    diameter). A sheet sliver shorter than 1.0 mm beside a trim is cut away with it. The five trims are CO-5V (x 49.700 ->
    48.800 over y 36.766-42.482), J-NTC (x 16.700 -> 16.752 over y 52.414-67.854), L-FC with the Eaton 12.9 mm body (y
    77.000 -> 76.362 over x 22.064-36.864), OP-FC (y 68.140 -> 67.480 over x 39.719-45.624) and ROP1-FC (x 38.560 -> 37.561
    from y 72.934 to the sheet top y 77.000). The trimmed sheet has 29 vertices: (16.700, 33.140), (49.700, 33.140), (49.700, 36.766), (48.800, 36.766), (48.800, 42.482), (49.700, 42.482), (49.700, 55.300), (66.000, 55.300), (66.000, 69.300), (47.700, 69.300), (47.700, 68.140), (45.624, 68.140), (45.624, 67.480), (39.719, 67.480), (39.719, 68.140), (38.560, 68.140), (38.560, 72.934), (37.561, 72.934), (37.561, 77.000), (36.864, 77.000), (36.864, 76.362), (22.064, 76.362), (22.064, 77.000), (18.286, 77.000), (16.700, 75.414), (16.700, 67.854), (16.752, 67.854), (16.752, 52.414), (16.700, 52.414).
    Its area is 1554.6 mm² and its bounding box 49.30 x 43.86 mm (r6: 33.0 x 35.0 mm; T-A-05 checks the sheet stock size).
    After the trims no MB part body or MB pad lies within 0.5 mm of the sheet. The nearest is CO-5V pad 1 at 0.500 mm, which
    a +-0.2 mm hand-cut tolerance reduces to 0.300 mm. No trimmed vertex lies inside the CR outline. The 22 relief holes are unchanged. The five cut-outs grow to their part body joined with its own pads + 0.5 mm (next bullet) (**superseded in r7:** the five cut-outs unchanged). The two foot fallback cut-outs (feet bullets below) are the only further openings.
  - **Relief holes and cut-outs against the MB pads (r7, H.23(m)):** the 22 relief holes are an exception to the pad rule.
    Each 2.2 mm hole clears the flats of its 1.650 mm square CHG pad by 0.275 mm and covers each pad corner by up to
    0.067 mm. Calc revision 4 evaluated the compliant hole. A hole that clears the pad corners by >= 0.5 mm needs a diameter
    >= 3.333 mm; a 3.4 mm hole clears the corners by 0.533 mm and the flats by 0.875 mm. At the 2.54 mm pitch the web between
    two such holes is -0.86 mm, so each column merges into one slot (x 19.30-22.70, y 34.84-66.18 and x 44.30-47.70,
    y 37.38-63.64). The 3.40 mm slot is wider than the 2.54 mm header body, so the bodies lose their seat on the sheet and
    stand 0.125 mm lower on the MB mask, while FT1 and FT2 stay on the sheet. The nominal t_bed then falls from 0.300 to
    0.175 mm, against the 0.15 mm lower limit of the PM4 (2d) gate. A square opening that clears the pad by 0.5 mm (2.65 mm)
    merges as well. The 2.2 mm holes therefore stay; the nearest hole edge lies 1.10 mm from the sheet outline.
    The five r5 cut-outs (part body + 0.5 mm) cleared their own pads by only 0.100-0.285 mm. Each now grows to its part body
    joined with its own pads + 0.5 mm, so it clears its own pads by 0.500 mm: D-BT-SQ x 27.318-32.118, y 47.849-52.226
    (+0.400 mm), C-D11 x 24.615-27.709, y 48.334-52.250 (+0.358 mm), C-D12 x 32.743-35.837, y 48.080-51.996 (+0.358 mm),
    C-DC11 x 32.771-35.301, y 51.195-53.453 (+0.215 mm) and C-DC12 x 26.675-29.205, y 51.449-53.707 (+0.215 mm). They merge
    into two openings: D-BT-SQ, C-D11 and C-DC12 on the left, and C-D12 and C-DC11 on the right. The web between the two
    openings is 0.625 mm wide (x 32.118-32.743; H.23(w)(3); **superseded in r8:** hand calculation from these coordinates). T-A-06 checks on the 1:1 print that
    the web lies flat; otherwise the web is cut away and the openings join. The nearest enlarged cut-out (C-D11) lies 2.52 mm
    from a relief-hole edge, and no other MB body lies within 0.5 mm of an enlarged cut-out. (**superseded in r7:** the five
    cut-outs kept the part body + 0.5 mm, cleared their own pads by 0.100-0.285 mm, and only the D-BT-SQ and C-DC12 cut-outs
    overlapped, x 27.718-28.990, y 51.449-52.226.)
  - **Latent r6 defect, corrected in r7 (H.23(m)):** the r6 sheet x 16.70-49.70, y 33.14-68.14 overlapped the CO-5V body
    (x 49.300-52.300, y 37.774-41.474) by 0.400 x 3.700 mm (1.48 mm²), so the r6 drawing draped the sheet onto the 2.1 mm
    tantalum against the r5 rule "cut-outs, not a drape", and it kept only 0.448 mm from the J-NTC body. The r7 trims remove both.
- **Bottom keep-out (retired in r7):** the bottom clearance rule below covers the five parts of the former keep-out
  (**superseded in r8:** board x 24.5-36.0 mm, y 48.5-53.5 mm (D-BT-SQ (29.7, 50.0), C-D11 (26.2, 50.3), C-D12 (34.3, 50.0),
  C-DC11 (34.0, 52.3), C-DC12 (27.9, 52.6), plus 0.5 mm): no bottom-side part.)
- **Bottom clearance rule (r7; replaces the r3 power-copper shadow (+1 mm) and the named bottom keep-out x 24.5-36.0,
  y 48.5-53.5).** Under the **bottom clearance rule** every CR bottom-side courtyard stays >= 1.0 mm in plan from every MB layer-1
  feature that is not GND (traces, pours and vias of any other net, measured on the copper rim including the polygon outline
  width) and from every MB part box. It applies on the footprint and on both tabs. It is a superset of the shadow. It covers the
  five parts of the retired keep-out (D-BT-SQ, C-D11, C-D12, C-DC11, C-DC12) by their MB part boxes + 1.0 mm, which exceeds
  the keep-out's part + 0.5 mm. However, it releases 2.4 mm² of the keep-out rectangle between those boxes (H.23(d): footprint
  376.9 -> 379.3 mm²); that area is >= 1.0 mm from every non-GND MB copper rim. The rule leaves 569.1 mm² of bottom area: footprint 391.6,
  tab X 44.3 and tab Y 133.2 mm², after the header bodies, the W1-W4 pads and the FT1/FT2 keep-outs (H.23(d); the foot
  keep-outs remove 34.6 mm², the 1.0 mm ring around the non-GND MB CHG header pads 4.1 mm²). The polyimide sheet stays as the
  second layer of the barrier. T-A-06 overlays the rule on the `.brd` layer-1 copper rims.
- **MB vias (r7, H.23(c2)):** the MB vias are **not tented**. All 368 vias carry the Eagle `alwaysstop` flag, and both stop-mask
  Gerbers (`soldermask_top.gbr`, `soldermask_bottom.gbr`) show a 0.9596 mm opening at every via. Under the CR the exposed via
  rings are covered by the polyimide sheet, and the bottom clearance rule keeps 1.0 mm from every non-GND via rim.
- **MB content under the tabs (r7, H.23(c)).** No MB part lies under either tab. Under tab X the MB layer 1 carries 29.16 mm² of
  non-GND copper, all logic nets: 3V3 3.41, CB-DISABLE 4.59, CHRG-STAT 4.52, CS-MDAC-FC 1.76, MPPT-DISABLE 4.63, SCL 5.11 and
  SDA 5.14 mm² (each +-0.3 mm², raster bias). Fifteen via pads overlap tab X; five are non-GND: 3V3 (56.431, 60.663), CS-MDAC-FC
  (58.420, 60.038), SCL (64.651, 58.809), CHRG-STAT (63.500, 58.928) and MPPT-DISABLE (65.024, 61.722), the last by its rim only.
  The rest is the board-wide GND pour. Under tab Y the MB carries only the GND pour: no non-GND copper and no via.
- **Area (r7, A.8, H.23(e)):** the r7 booking on the r7 outline is top 73.55 %, bottom 69.04 %; a single-sided CR needs
  101.8-109.9 %, so the CR stays double-sided and 4-layer (L2 GND plane kept intact under the bottom-side parts). U101 with
  C102a/b/c, D107, D103 and C103 stays on the top side (**superseded in r8:** **Area (H.18, r5 re-booked with the 1.27 mm J101, SMA D103/D107 and the six 0402 pocket parts):** courtyard estimate ~963 mm²
  (top-side ICs, U101, D103/D107, C102a/b, J101, SMT pads, W1-W4 holes, pocket ~624 mm² against ~881 mm² top-side free; passives
  ~340 mm² on the bottom against ~591 mm²; r3 booked ~1060 mm² with the 2.54 mm J101), so the CR is **double-sided**
  and **4-layer** (L2 GND plane kept intact under the bottom-side parts). U101 with C102a/b/c, D107, D103 and C103 stays on the
  top side.)
- Neighbours: CO-5V 0.1 mm right, LM1084 1.8 mm right (4.83 mm tall), J-NTC/J-BL left. CR parts are low-power (eFuse <= 0.17
  W, H.14). (r7: these are the neighbours of the r6 rectangle; the tab neighbours are in the r7 trims bullet above.)
- **Thermal band (r7, H.23(h)).** The **thermal band** is the part of tab X within 6.4 mm of the MB 5V layer-1 copper rim
  around REG-5V (LM1084). Its boundary runs at y 60.5-62.34 across x 48.7-65.0, and it covers 84.9 of the 195.6 mm² of tab X
  (43 %). The band carries only pads, wires, the RTV bead and temperature-insensitive passives (R175, 1 % logic series resistors
  and pull-downs); no comparator, reference, 0.1 % divider, BAV199 or timing capacitor is placed in it. Row 1 of the tap field
  (low pad edges 2.233-4.190 mm from the rim), part of row 2 (4.773-7.808 mm) and part of the R175 courtyard (5.511-10.408 mm)
  lie in the band; rows 3-4 and the FT1 body (9.953-12.310 mm) lie outside it. The estimated MB surface rise is 4.5-23.5 C at
  1 mm, 3.3-17.0 C at 5 mm and 2.4-11.9 C at 10 mm from the rim (`round4/work/mb_mechanical.md` Table 4, ESTIMATE); MS4 replaces
  the estimate and confirms the split. The 6.4 mm width is the geometric Band A (1.4-6.4 mm) of
  `round4/work/proposal_tapside.md`, carried forward; it is not a thermal criterion. At 6.4 mm the Table 4 worst estimate is
  a 15.6 C rise (linear between 17.0 C at 5 mm and 11.9 C at 10 mm). The comparator band on the footprint lies 7.10-26.38 mm
  from the same rim (H.23(f)). There the `round4/work/mb_mechanical.md` 5.3 rule applies: comparators, references, BAV199
  clamps and dividers at >= 10 mm from the rim. The 0.1 % dividers sit in the interior divider strip (>= 13.03 mm), and
  D104-D106, U123 and D108 sit in the footprint interior. A comparator courtyard at x 39.53-42.43 (7.10-10.0 mm from the rim,
  worst estimated rise 14.9 C) stands only on the MS4b reading (A.8, T-A-08).
- **Far-end support feet (r7, H.23(i)).** Each tab carries a fitted foot by default (operator ruling; rationale in the feet-effect bullet below): **FT1** under tab X near its tip and **FT2**
  under tab Y near its far edge. A foot body stays >= 0.5 mm inside the r7 outline, has no MB via pad of any net under it, and
  keeps >= 1.0 mm from every non-GND MB copper rim and every MB part box. FT1 is the largest bed area whose placement tolerance
  is >= +-0.25 mm in x and in y against that rule, at the exact max-min centre. FT2 is the 4 x 4 mm body at the largest lever
  from the pin-11 row (y 64.484) that keeps the same tolerance. The following table gives the adopted feet.

| Foot | Body (x by y), bed area | Centre | Body extent | Tolerance t (tx / ty) | Binding feature, nearest items | Keep-out (body + 0.5 mm) | Bed access |
|---|---|---|---|---|---|---|---|
| FT1 | 4.0 x 1.6 mm, 6.40 mm² | (61.72, 66.705) | x 59.720-63.720, y 65.905-67.505 | 0.294 mm (0.304 / 0.294) | MPPT-DISABLE L1 trace (nearest non-GND rim 1.294 mm); nearest part box C-D2 3.64 mm; no via pad under the body | x 59.220-64.220, y 65.405-68.005 (5.0 x 2.6 mm) | RTV lane x 59.220-64.220, y 68.005-68.300 to the tab X top edge |
| FT2 | 4.0 x 4.0 mm, 16.00 mm² | (28.00, 73.250) | x 26.000-30.000, y 71.250-75.250 | 0.250 mm (7.060 / 0.250) | r7 outline edge (0.5 mm); no non-GND copper within 3 mm; nearest part box L-FC 1.76 mm; no via pad under the body; lever 8.766 mm from the pin-11 row | x 25.500-30.500, y 70.750-75.750 (5.0 x 5.0 mm) | 1.0 mm NPTH fill hole at the foot centre; no edge lane |

  The MB signal bundle (SDA, SCL, CHRG-STAT, MPPT-DISABLE, CB-DISABLE, 3V3, CS-MDAC-FC) crosses the whole tab X tip, so no
  4 x 4 mm FT1 meets the rule there. The next FT1 height, 4.0 x 1.7 mm, reaches only t 0.244 mm. A 4 x 4 mm FT1 at (62.50,
  61.40) over masked signal traces violates the rule (copper clearance -0.127 mm); it remains an operator option only, without
  the MB-mask fallback. FT2 alternative M, the mid-height spot (28.00, 71.320) with a lever of 6.836 mm and t 2.180 mm, is
  recorded but not adopted.
- **Foot construction and bedding (r7).** Each foot is a PA66 or PBT block of height h_f = 2.54 mm - t_bed - t_bond = 2.19 mm
  at t_bed 0.30 mm and t_bond 0.05 mm (block tolerance +0/-0.05 mm). The CR-side bond is a 0.05 mm acrylic transfer tape
  (TODO(verify: tape datasheet, temperature rating)). (**superseded in r7:** h_f = 2.54 mm - t_bed = 2.24 mm with an RTV bond
  of unstated thickness, cured before seating.) The header bodies and the feet both stand on the sheet, so t_bed does not
  depend on the MB, CR or sheet thickness. The tape bonds each foot before seating, the header bodies set the CR height, and
  no wet adhesive is present while the 22 MB joints are soldered.

  The tolerance budget of t_bed (H.23(i)) has four contributors: the header body +-0.13 mm (TODO(verify: Samtec TSW
  drawing)), the CR local bow (IPC-6012 0.75 % of the lever: +-0.118 mm at FT1, +-0.066 mm at FT2), the block
  +0/-0.05 mm and the tape 0-0.05 mm. The nominal bed is 0.300 mm and the mean is 0.350 mm. The worst case is
  0.052-0.648 mm at FT1 and 0.104-0.596 mm at FT2; the RSS bands are 0.171-0.529 mm and 0.200-0.500 mm. The worst case
  therefore falls outside the 0.15-0.45 mm bed range on both sides. A foot that is too tall becomes a hard prop and
  preloads the joints; a foot that is too short leaves a bed thicker than the stiffness range of H.23(i).

  The measured gate PM4 (2d) dry-seats the CR on the sheet after the feet are taped and before the 22 joints are
  soldered. A 0.05 mm feeler must not enter under any header body; at each foot a 0.15 mm feeler must enter and a
  0.45 mm feeler must not. A Monte-Carlo estimate with uniform contributors (ORDER OF MAGNITUDE) passes 79.7 % of FT1
  builds (2.2 % too tall, 18.1 % too short) and 85.8 % of FT2 builds (0.2 % and 14.0 %). A rejected foot is re-made.
  The 0.15-0.45 mm bed range is therefore a gated range, and "the feet take no preload" holds for a build that passes (2d).

  As the placement aid, the CR bottom silkscreen carries the outline of each foot body, a long-axis tick on FT1 (long axis
  along x) and a ring around the FT2 fill hole (A.8). FT2 is square, so the outline also sets its orientation. A pin of
  0.9-1.0 mm through the CR fill hole and the foot hole locates FT2. PM4 (2c) measures the three edge distances that the
  A.7 placement tolerance bounds (FT1 0.294 / 0.304 mm, FT2 0.250 mm).

  After the 22 MB joints are soldered and inspected, a flowable alkoxy-cure silicone RTV bed fills the gap between each foot
  and the polyimide sheet (nominal 0.30 mm, gated 0.15-0.45 mm). FT1 is bedded with a syringe through its lane at the tab X top edge, before the W1-W4 leads are dressed and before W5-W7 and the
  tap wires are fitted (PM4 order: W1-W4 joints in step (2b) before seating, the feet taped (2c) and gap-checked dry (2d), 22 MB joints, inspection, FT1/FT2 beds, cure, T-A-09, then the W1-W4 dressing, W5-W7 and the taps). The +y side of FT2
  lies behind the L-FC body, so FT2 is bedded through a 1.0 mm NPTH fill hole at the foot centre (28.00, 73.250). The hole
  passes through tab Y and the foot. The RTV is injected from the CR top with a 21-22 G blunt needle (OD <= 0.82 mm) seated
  in the CR hole, until it appears at the FT2 -y, -x and +x faces; that witness, sighted from under the tab, is the FT2 fill
  inspection (the +y face lies behind L-FC). FT1 is complete when RTV shows along its -y and +x faces, sighted from the
  tab X tip. The hole lies 1.500 mm inside the foot body edge, and the CR top
  keeps a 2.0 mm copper and part keep-out disc around it (0.5 mm ring, 1.750 mm inside the r7 outline, booked in H.23(e)).
  L2-L4 keep a >= 0.5 mm copper pull-back around the hole (L2 solid GND, L4 GND pour). Under
  the hole the MB carries GND pour under solder mask (nearest non-GND rim 7.18 mm, via pad 9.89 mm, part box 3.26 mm from the
  hole edge). Each bed cures for the RTV datasheet through-cure time of a 2.0 mm path from an open edge (the FT2 centre), and
  for at least 24 h, before the T-A-09 bond check (**superseded in r7:** >= 24 h alone). The beds use the flowable
  alkoxy-cure RTV of E only. Acetoxy-cure and oxime-cure RTV are excluded (acetic acid and 2-butanone oxime attack copper),
  and a non-flowing paste is excluded (it does not wick into the gap).
  TODO(verify: RTV datasheet: alkoxy cure, copper corrosivity, viscosity, deep-section cure rate, temperature rating,
  adhesion to polyimide without primer).
- **Foot removal and bond fallback (r7; r8 re-made foot and repair access, H.23(r)).** The polyimide sheet is the sacrificial
  layer: removal means cutting the bed and peeling the sheet, and in the baseline the MB solder mask is never bonded. The bond
  of the bed RTV to polyimide is qualified before the CR is soldered, by the T-A-09 step 0 bond coupon (r8). If the coupon
  fails, the sheet gets a cut-out within the foot keep-out coordinates (FT1 x 59.220-64.220, y 65.405-68.005; FT2
  x 25.500-30.500, y 70.750-75.750), never sized to an as-found foot, and the bed bonds to the MB solder mask. The FT1 cut-out
  is no larger than its 5.0 x 2.6 mm keep-out: it exposes no non-GND copper rim and no via pad, and the sheet still covers the
  MPPT-DISABLE trace by 0.794 mm (H.23(i)). The FT2 cut-out is its 5.0 x 5.0 mm keep-out over GND pour only.

  The cut-out removes the sheet stack, film and PSA, under that foot, while the header bodies keep their seat on the sheet.
  An unchanged foot would then leave a bed of 0.275-0.575 mm and a bed stiffness down to x0.783 of the gated minimum (FT1
  11.13 against 14.22 N/mm, FT2 27.83 against 35.56 N/mm at E 1 MPa; H.23(r)). The foot is therefore re-made at
  h_f' = h_f + t_rm, where t_rm is the measured thickness of the removed stack, film and PSA together, read to +-0.01 mm:
  2.315, 2.340 and 2.365 mm at t_rm 0.125, 0.150 and 0.175 mm (block tolerance +0/-0.05 mm, H.23(r)). The sheet is 0.125 mm
  of polyimide film plus a silicone PSA whose thickness is not stated (TODO(verify: polyimide tape datasheet)); the fallback
  uses the measured t_rm, never a nominal figure. The PM4 (2d) feeler gate is repeated with the re-made foot (pass estimate
  79.7 % at FT1 and 85.8 % at FT2, ORDER OF MAGNITUDE, H.23(r)). A sheet that lifts from the MB mask in T-A-09 is a PSA
  failure, not an RTV failure: the sheet is re-pressed and T-A-09 repeated before this fallback.

  **Repair access after soldering (r8, H.23(r)).** After the 22 MB joints are soldered, the sheet under a foot cannot be
  removed without lifting the CR. At FT2 the +y face lies 0.75 mm from the tab Y +y edge and 1.612 mm in plan from the L-FC
  body (5.0 mm tall, ASSUMPTION), so no tool and no new foot pass on that side; the slot under the CR is 2.540 mm high, and
  the -x face lies 8.30 mm from the tab Y -x edge, under the tab Y bottom parts (height cap 1.0 mm). The cut-out fallback is
  therefore executable only before the 22 joints are soldered. After soldering, a failed bed is re-bedded by RTV injection
  only, FT2 through its fill hole and FT1 through its lane at the tab X top edge. A bond to polyimide that fails after
  soldering needs the CR desoldered (22 joints) before the cut-out fallback.

  (**superseded in r8:** **Foot removal and bond fallback (r7).** The polyimide sheet is the sacrificial layer: removal means cutting the bed and
  peeling the sheet, and in the baseline the MB solder mask is never bonded. If the T-A-09 bond check fails on polyimide, the
  sheet gets a cut-out within the foot keep-out coordinates (FT1 x 59.220-64.220, y 65.405-68.005; FT2 x 25.500-30.500,
  y 70.750-75.750), never sized to an as-found foot, and the bed bonds to the MB solder mask. A sheet that lifts from the MB
  mask in T-A-09 is a PSA failure, not an RTV failure: the sheet is re-pressed and T-A-09 repeated before this fallback. The FT1 cut-out is no larger than its 5.0 x
  2.6 mm keep-out: it exposes no non-GND copper rim and no via pad, and the sheet still covers the MPPT-DISABLE trace by
  0.794 mm (H.23(i)). The FT2 cut-out is its 5.0 x 5.0 mm keep-out over GND pour only.)
- **Tab stiffness and pin loads (r7, H.23(i); ORDER OF MAGNITUDE).** These figures assume a 20 GPa laminate, a clamped root and
  an RTV modulus of 1-3 MPa (ASSUMPTION, TODO(verify: RTV datasheet)); MS5, MS6 and T-F-18 decide. The unpropped resonance
  figures are upper estimates (clamped root). For tab Y the clamp along the pin-11 row y 64.484 is held by pin 11 alone within
  the tab width, so the tab Y figures are the least conservative. Tab X has a tip stiffness of 35.8 N/mm and 63.2 N/mm at the
  foot, against an RTV bed of 14-128 N/mm; its first mode is 1664-2353 Hz unpropped. Tab Y has 266.3 / 603.8 N/mm against a
  bed of 36-320 N/mm; its first mode is 4531-6407 Hz unpropped. The propped first modes are neither upper nor lower bounds.
  With k_s = E A / t (t_bed 0.30 mm) they are 1924-3336 Hz (tab X) and 4726-7204 Hz (tab Y). The bonded-thin-layer (Gent)
  factor 1 + 2S^2 raises k_s up to x8 at FT1 (S 1.90) and x23 at FT2 (S 3.33); with it the propped first modes are
  3235-7190 Hz (tab X) and 7905-17112 Hz (tab Y). (**superseded in r7:** "every resonance figure is an upper estimate".)
  The MS5 comparison uses the lowest unpropped figure, tab X 1664 Hz. The worst header-pin load at 30 g is 0.208-0.322 N
  without the feet and 0.168-0.297 N with them (r6 CR alone 0.067-0.134 N). The with-feet pin loads are upper estimates on
  the bed axis, because a stiffer (confined) bed unloads the pins. A 10 N push at the tab X tip loads the worst pin with
  2.69 N without FT1 and 0.52-1.99 N with it. At the tab Y tip (28.00, 76.00) the figures are 3.05 N and 1.63-2.82 N
  (**superseded in r7:** 3.06 N and 1.64-2.83 N).
- **Feet effect and the fitting decision (r7, H.23(i); ORDER OF MAGNITUDE, bed confinement not modelled).** The feet are
  fitted by default by operator ruling. Their effect on the distributed load is small: at 30 g they cut the worst-pin load
  by 7-21 %. Their effect on a tip push is larger. FT1 takes 2.41-8.79 N of a 10 N tab X tip push and cuts the worst-pin
  load by 26-81 %. FT1 also props the softer tab (35.8 N/mm), whose unpropped first mode 1664-2353 Hz lies inside the MS5
  band of 0.1-8 kHz. FT2 takes 0.82-5.09 N of a 10 N tab Y tip push and cuts the worst-pin load by 7-47 %. Tab Y is stiff
  (266.3 N/mm, unpropped first mode 4531-6407 Hz). FT2 is therefore kept as a margin against handling loads at the tab Y
  far edge until MS5 and T-F-18 report. When the MS5 spectrum shows no MB excitation above the logger noise floor within
  2.3-8 kHz (0.5-2 times the tab Y unpropped band, clipped at 8 kHz), FT2 may be omitted by operator ruling. Its
  footprint, keep-out and fill hole then stay on the CR.
- **CR pad placement (r3, finding cr-power-pad-coords-on-pin-column; board coordinates, checked against the A.8 hole table
  and the MB copper above):**
  - **Tap field F01-F24 (r7):** top-side SMT pads 1.5 x 1.5 mm, no hole. F01-F07, F11-F21, F23 and F24 lie on tab X (A.4,
    H.23(g)); F08 (T22), F09 (T8) and F10 (T9) keep their r3 positions (26.44, 28.98 and 31.52, y 35.80), and F22 (T18) moves
    to (41.68, 35.80) on the same low row; the rest of the r3 field becomes the comparator region (A.8, H.23(g))
    (**superseded in r8:** Tap field F01-F24: 3 x 8 top-side SMT pads 1.5 x 1.5 mm at 2.54 mm, centres x = 23.90 + k x 2.54 mm (k = 0..7),
    y = 35.80 / 38.34 / 40.88 mm (shifted 0.5 mm toward high y in r3 for the outline courtyard); envelope x 23.15-42.43,
    y 35.05-41.63. No hole, so its position over the MB VBT and VCHG-IN copper no longer matters; >= 1.15 mm to the pin-22 pad.)
  - **J101 (r4, finding efuse-cluster-no-room-at-pad10; r5 region):** SMT vertical **2x7 at 1.27 mm pitch** (A.3 W5), lengthwise
    along y, **body courtyard x 38.55-42.45, y 42.13-51.53 mm** (0.50 mm above the tap field (r7: the comparator region, same boundary y 41.63), 0.50 mm below the IN strip; unshrouded
    body ~8.9 x ~3.4 mm; a shrouded keyed 1.27 mm part is preferred if its body fits the region x 37.0-44.5, y 42.13-51.53,
    TODO(verify: Samtec FTSH/SHF drawing), T-A-05). **r5 (finding j101-mated-socket-envelope): the mated IDC socket is larger
    than the header** and may overhang the tap field (26 AWG wires, adhesive bead; r7: the comparator region and F22, whose pad courtyard lies 5.33 mm
    from the J101 region, H.23(g)) and the IN-strip parts (D107 SMA ~2.3 mm,
    C102b 1210 ~2.5 mm tall); T-A-05 records the socket's length, width and seated height from the chosen assembly drawing, and
    T-A-06 dry-fits it mated with the taps and adhesive in place (pass: >= 0.5 mm to every neighbour in plan, or the socket
    underside >= 0.5 mm above any part it overhangs; the cable exit of A.3 W5 bears on nothing). Fail: rotate J101 90 degrees
    (lengthwise along x in x 30-40, y 42.13-46.0) or shift the tap-field / IN-strip boundaries and re-run H.21(k). The r3 2.54 mm J101 (body 17.8 mm, to
    y 61.1) left the U101 IN side only a 14.6 mm² pocket at pad 10 for C102a/b/c and D107, which need ~45-50 mm² (H.20): the
    r3 placement rules could not all be met.
  - **Battery holes (r4: 1.5 mm plated, 2.5 mm pad; finding w3w4-hole-vs-18awg-silicone):** W3 `VCHG` at (24.3, 45.4), between
    the pin-19 and pin-18 rows, over the MB VCHG pour (same net); W4 `GND` at (24.3, 55.6), between the pin-15 and pin-14 rows.
    Pad edge 1.1 mm from the pin pads (x 21.95 vs 23.05), W3 1.85 mm and W4 0.85 mm from the keep-out (r7: the named keep-out retires; the bottom clearance rule governs the bottom
    courtyards around W3/W4). Each tied to its pins by a
    >= 2.5 mm pour.
  - **Input chain (r4 re-plan, r5 courtyard-checked):** **U101 rotated 90 degrees counter-clockwise** (top view) about its centre
    (41.8, 64.1) (body x 39.8-43.8, y 62.1-66.1; courtyard x 39.3-44.3, y 61.6-66.6): pins 1-6 (IN 1/2, IN_SYS 5, UVLO 6) face **-y**
    toward the freed strip (pins 1/2 at x 40.55/41.05, pin 5 at 42.55, pin 6 at 43.05, y 62.1), pins 7-12 (OVP, GND, dVdT, ILIM,
    MODE, SHDN) face **+x** toward pad 10 (x 43.8, y 62.55-65.05), pins 13-18 face +y with OUT 17/18 at the -x end (x 41.05/40.55,
    y 66.1), N.C. 19-24 face -x (SLVSE94G Table 5-1 / Fig 5-1 pin order, counter-clockwise from pin 1). VCHG-IN copper from pad 10
    to IN_SYS (pin 5) is ~3.5 mm (<= 5 mm), bridged to IN 1/2 under C102c. Placement regions and every courtyard are in the A.8 table
    (r5: checked by `calc/r3_calc.py` H.21(k) for overlaps, the CR courtyard limit, >= 0.5 mm to every pad and region gaps >= 0.5 mm;
    the r4 table failed four of its own rules). W1 `VCHGOUT` hole at **(30.3, 61.2)** and W2 `GND` hole at **(27.7, 61.2)** (r5:
    both moved 1.2 mm -x so the OUT strip can start at x 30.8; 2.3 mm pads), side by side so the twisted pair starts together, >= 2.0 mm from the MB MPPT-DISABLE trace (y 64.48) that a tail would
    otherwise approach; VCHGOUT is fused copper, so its distance from pad 10 is free. U101 never moves away from pad 10.
    **Fallback** only if the operator rejects the pitch change: the 2.54 mm J101 lengthwise along x elsewhere on the top side,
    valid only if T-A-06 shows a free 18 x 5.5 mm courtyard; a 2x6 that drops the key is not acceptable.
  - **W6 / W7 SMT pads:** a row at y 57.5: SCL (27.0), GND (29.0), SDA (31.0), TS_EXT (33.0), GND (35.0); short CR traces
    from pins 7/8/13.
  - **Overhang (r7):** none; the defined tab X and tab Y replace the conditional overhang, and the low-y and high-y edges are
    rejected extension zones (r7 bullets above) (**superseded in r8:** Overhang, only if the capture needs it: low-y edge over C4A/B-BT (1210, 1.35 mm) or high-y edge over OP-FC (SOIC, ~1.75
    mm, UNVERIFIED), no bottom-side parts in the overhang; never on the J-NTC/J-BL side or over LM1084/CO-5V (T-A-06 measures
    the heights).)
- EVM: on the EVM plate (EVM mount bullet below; the EVM has no corner holes); J2 terminal block removed (EM7); cable-tie
  W1-W7 to the chassis at 0.10 m intervals (**superseded in r8:** 4 M3 nylon standoffs in the corner holes (stock bumpons
  H1-H4 removed; hole diameter checked in T-A-02), 10 mm tall, on the chassis).
- EIB: two M3 x 10 mm nylon standoffs on the EVM plate (EIB mount bullet below) (**superseded in r8:** on the chassis), pad column 7 mm off the EVM's right edge (5-15 mm allowed), the E3 pad
  5 mm above the level of TP33 (r6 placement, A.5, A.9). W3/W4 enter EVM J5 below the EIB; the dry fit (T-A-06) confirms >= 3 mm
  between the EIB and the J5 wire entry, else the EIB moves up to 5 mm higher (E8 and E3 stay within their maxima).
- **EVM mount (r7).** The BQ25798EVM has no mounting holes: the corner circles are fiducials (SLUUCB5E Figs 4-1 to 4-4; BOM
  FID1-FID6; `round4/work/evm_geometry.md` section 3), and a hole drilled at a bumpon centre would cut the ground pour and 7-17
  stitching vias. The **EVM plate** is an insulating plate, fixed to the chassis, that carries the EVM and the EIB. The stock
  bumpons H1-H4 (3M SJ-5303, 11.18 mm diameter, 5.08 mm tall) stay fitted and rest on the plate. Two nylon clamp bars, or four
  corner L-clamps, with 0.5 mm silicone pads press edge lips of <= 2.0 mm; the clamps are notched at J8 and stay clear of
  TP48/TP49, the terminal wire faces and the fiducials. No fastener or adhesive bonds EVM copper to the plate, the CR or the
  chassis, and the EVM is not drilled. Positive lateral stops (edge fences, locating pins or the clamp lips) sit at the
  EVM board edges with at most 0.3 mm of play per axis, clear of FID1-FID6, the terminal wire faces and J8. The clamp
  preload holds the EVM by friction against the MS5 peak acceleration times the MS7 mass; the stops bound the motion if
  the friction is exceeded or the pads relax. The preload is limited so that each bumpon compresses by no more than
  1.0 mm. This keeps the 2.4 mm terminal tails at least 1 mm off the plate (2.68 mm nominal; MS7 confirms the tail
  protrusion and the board thickness). Plate, clamp and stop geometry: TODO(design: from MS2, MS5 and MS7). J2 stays removed (EM7), and
  W1-W7 stay cable-tied to the chassis at 0.10 m intervals. T-A-02 checks the clamp fit, the stop play, the bumpon
  compression and the insulation of the EVM copper (TP49, J1 pin 1) to the plate and the chassis (> 1 MOhm with W1-W7
  disconnected). T-F-18b repeats these checks after the vehicle run.
- **EIB mount (r7).** The two M3 x 10 mm nylon standoffs stand on the EVM plate, so the EVM and the EIB share one mounting
  plate. The EVM is held by friction on compliant bumpons, so the E leads see a small relative motion (0.03-0.12 mm at
  30 g, ASSUMED materials; at most the 0.3 mm stop play; A.5). Each E lead keeps at least 3 mm of slack within its A.5
  build maximum and is tacked to the EIB with an RTV dot within 10 mm of its pad. T-F-18b inspects the E-lead joints
  after the vehicle run. The r6 placement rule (pad column 7 mm off the EVM right edge, E3 5 mm above TP33) is
  unchanged. At the reference placement the EIB bottom edge lies 4.84 mm from the J5 body top (>= 3 mm, H.23(l)). The E-lead
  build maxima follow A.5 (E1 90 mm, E5 65 mm; H.23(k)).
- **EVM reference placement (r7, H.23(l)).** The EVM plate sits on the chassis just past the MB +y edge (y 98.044). The EVM
  bottom edge faces the MB with a 20.0 mm gap for the J8 housing (J8 mates from -y; its pins end 13.76 mm short of the MB edge,
  which leaves room for the KK housing and the wire exit, TODO(verify: Molex 22-01-3047 mated length), MS2). The EVM right edge
  is at x 88.50, and the board rectangle is x -0.40-88.50, y 118.044-206.944 (0.40 mm past the MB -x edge). The right edge keeps
  4.97 mm from the Teensy 4.1 USB plug corridor (x 93.47-101.09 from y 93.73; 45.0 mm plug + bend, ASSUMPTION,
  TODO(measure: MS2); **r7 review 7:** the corridor width is the Teensy 4.1 receptacle silkscreen outline from the MB `.brd`, not the plug overmold, whose width, thickness and length are TODO(measure: MS2)). The EIB, placed by the r6 rule, occupies x 93.50-117.50, y 159.65-195.65. It lies 20.92 mm beyond the end of the assumed
  corridor but inside its x band, so a USB cable that runs straight +y for more than 65.9 mm would meet it. Only the insulated cable jacket can reach the
  EIB, because the plug shell (MB GND) ends inside the 45 mm corridor, 20.92 mm short of the EIB. The USB cable is
  dressed and tied >= 5 mm clear of the EIB (T-A-02). After T-A-06, Kapton tape covers the E-pad joints on both EIB
  faces, so that loose metal (an unplugged plug or a tool) cannot short E1 (REGN) or E5 (nCE_DRV) to GND. W3/W4 pass
  between the EVM right edge and the corridor in a 4.97 mm channel (pair outer size TODO(measure: MS2/MS7)). The W leads follow the A.3 dressing path to the MB tie bases A1 and A2, every span between anchors is <= 30 mm along the lead, and the chassis tie closes the last span, <= 2.4 mm (west group), 16.4 mm (W3/W4) and 17.4 mm (W5) past the MB +y edge with a 2 mm margin (calc revision 4; it superseded 'an extra anchor with no distance limit'). W5 does not use the W3/W4 channel: it crosses the MB +y edge at x 74.75 and runs over the EVM plate to J201, A.3. The W-lead route maxima for this placement are in A.3; until MS2 confirms the placement, the r6 0.30 m caps
  stay the T-A-02 bound for W3/W4, W6 and W7, and W1/W2 keep the fixed 0.30 m +- 10 mm (D-F3) (**superseded in r8:** The chassis tie at
  the MB +y edge lies 29.744 mm from the tab X top edge, and 29.98 mm from its corner (65.00, 68.30) for W3, W4 and W5,
  which cross at x 68.75 (<= 30 mm, A.3).)
- **USB corridor fallbacks (r7, H.23(l)).** For an open-ended corridor (x 93.47-101.09 from y 93.73, no end) three fallbacks
  were evaluated:
  - (i) the EVM + EIB group shifted -x by 27.03 mm (EVM x -27.43-61.47, EIB x 66.47-90.47, E leads unchanged) passes
    geometrically: no lead is blocked; on the A.3 dressing path the maxima are W3 190, W4 190, W6 150, W7 SCL 190 and W7 SDA 200 mm; W1/W2 keep the fixed 0.30 m +- 10 mm (routes 225.5 / 228.2 mm); the W5 minimum fit is 204.6 mm on the 304.8 mm cable; the anchor rule of A.3 replaces the chassis-tie distance (**superseded in r8:** every chassis tie is <= 30 mm, and the build maxima are W1 260, W2 270, W3 170, W4 170,
    W6 120, W7 SCL 180 and W7 SDA 170 mm, with W5 at 1.25 x route = 177 mm, all within 0.30 m). It needs 45.3 mm of chassis room
    past the MB -x edge (the W1 approach point at x -34.83 plus a 10.5 mm 20 AWG bend allowance, ASSUMPTION), clear of the
    J-BL/J-FC/J-NTC harness volume;
  - (ii) the EIB on the corridor +x side (EIB x 104.09-128.09) fails. The E-lead bundle and the shared EVM plate must span the
    corridor band, and the W3/W4 J5 approach points (96.09, 142.24) and (96.09, 152.40) fall inside the corridor. W5 has no path on
    the +x side, and every E-lead maximum grows (E1 100 mm, E5 75 mm; E4 at 0.68 of its pickup-criterion limit);
  - (iii) the EIB at the EVM left edge fails: E4 (JP21 pin 1) needs a straight 82.3 mm against its 59 mm pickup-criterion limit.
  MS2 measures the chassis room and the USB plug + bend. The design adopts the reference placement, or fallback (i) when MS2
  shows that the corridor reaches the EIB or the W3/W4 channel. The "EVM rotated" variant is not evaluated (open item).

### A.8 CR layout constraints (for the KiCad capture, PM0)

Hole positions (board coordinates in mm, from the `.brd` element CHG at (47.498, 34.544), R180; pad x/y in the package are
rotated 180 degrees). Drill 1.1 mm, plated, pad >= 1.9 mm. **r6: coordinates are Eagle `.brd` board coordinates, top view, origin
at the MB origin, +x right, +y UP. In KiCad (+y down) enter y as -y, or better, capture in the frame of the imported `.brd` (PM0);
`calc/pin_identity_check.py` prints this table with the KiCad y column and checks a pad export against it (T-A-06 step 0).**

| Pin | Name | x | y | Pin | Name | x | y |
|---|---|---|---|---|---|---|---|
| 1 | VSEL | 45.998 | 39.084 | 12 | MPPTSEL | 20.998 | 61.944 |
| 2 | CSEL | 45.998 | 41.624 | 13 | THERM | 20.998 | 59.404 |
| 3 | STAT | 45.998 | 44.164 | 14 | VBAT-1 | 20.998 | 56.864 |
| 4 | VIN- | 45.998 | 46.704 | 15 | VBAT-2 | 20.998 | 54.324 |
| 5 | NC1 | 45.998 | 49.244 | 16 | VLOAD-1 | 20.998 | 51.784 |
| 6 | NC2 | 45.998 | 51.784 | 17 | VLOAD-2 | 20.998 | 49.244 |
| 7 | SCL | 45.998 | 54.324 | 18 | VBAT+1 | 20.998 | 46.704 |
| 8 | SDA | 45.998 | 56.864 | 19 | VBAT+2 | 20.998 | 44.164 |
| 9 | NC3 | 45.998 | 59.404 | 20 | LDIS | 20.998 | 41.624 |
| 10 | VIN+ | 45.998 | 61.944 | 21 | VLOAD+1 | 20.998 | 39.084 |
| 11 | MPPTD | 20.998 | 64.484 | 22 | VLOAD+2 | 20.998 | 36.544 |

Added CR pads (r3; the pin columns and the A.7 MB copper set the positions):

| Pad | Net | Type | x | y |
|---|---|---|---|---|
| W1 | VCHGOUT | 1.3 mm plated hole, **2.3 mm pad** (r5) | **30.3** (r5) | 61.2 |
| W2 | GND | 1.3 mm plated hole, **2.3 mm pad** (r5) | **27.7** (r5) | 61.2 |
| W3 | VCHG | **1.5 mm** plated hole, 2.5 mm pad (r4) | 24.3 | 45.4 |
| W4 | GND | **1.5 mm** plated hole, 2.5 mm pad (r4) | 24.3 | 55.6 |
| W7 SCL / GND / SDA | SCL, GND, SDA | SMT 1.2 x 1.5 mm | 27.0 / 29.0 / 31.0 | 57.5 |
| W6 TS_EXT / GND | TS_EXT, GND | SMT 1.2 x 1.5 mm | 33.0 / 35.0 | 57.5 |
| F01-F24 (r6; **superseded in r7:** next two rows) | taps | SMT 1.5 x 1.5 mm | ~~23.90 + k x 2.54~~ | ~~35.80 / 38.34 / 40.88~~ |
| **r7:** F01-F07, F11-F21, F23, F24 (tab X) | taps | SMT 1.5 x 1.5 mm, 6 x 4 grid at 2.54 mm (assignment below) | 50.80 + j x 2.54 (j = 0..5) | 58.94 / 61.48 / 64.02 / 66.56 |
| **r7:** F08 (T22), F09 (T8), F10 (T9), F22 (T18) (footprint low row) | taps | SMT 1.5 x 1.5 mm | 26.44 / 28.98 / 31.52 / 41.68 | 35.80 |
| **r7:** R175 (tab X, column 1, rows 2-3) | 3V3 feed limiter | 1206, vertical; courtyard x 49.650-51.950, y 60.375-65.125 | 50.80 | rows 2-3 (61.48 / 64.02) |
| **r7:** FT1 (CR underside) | foot, PA66/PBT | 4.0 x 1.6 mm body; keep-out x 59.220-64.220, y 65.405-68.005 + RTV lane to y 68.300; bottom silkscreen outline of the body (x 59.720-63.720, y 65.905-67.505) with a long-axis tick (long axis along x), the PM4 (2c) placement guide | 61.72 | 66.705 |
| **r7:** FT2 (CR underside) + fill hole | foot, PA66/PBT; 1.0 mm NPTH at its centre | 4.0 x 4.0 mm body; keep-out x 25.500-30.500, y 70.750-75.750; 2.0 mm CR-top keep-out disc around the hole; >= 0.5 mm copper pull-back around the hole on L2-L4 (L2 solid GND, L4 GND pour); bottom silkscreen outline of the body (x 26.000-30.000, y 71.250-75.250) and a ring around the fill hole, the PM4 (2c) placement guide (the square body takes its orientation from the outline) | 28.00 | 73.250 |
| U101 (centre) | - | VQFN-24, **rotated 90 degrees CCW (r4): IN/IN_SYS edge facing -y** | 41.8 | 64.1 |
| J101 (region) | - | 2x7 1.27 mm SMT (r4); r5 region (body courtyard x 38.55-42.45) | 37.0-44.5 | **42.13-51.53** (r5) |

**r7 tab X pad assignment (H.23(g); finding tabx-tap-pad-adjacency-unanalysed).** Row y 58.94: F01 T1 (50.80), F02 T7b (53.34),
F13 T12 (55.88), F06 T5 (58.42), F14 T13 (60.96), F04 T3 (63.50). Row y 61.48: R175b (50.80, the CR rail pad), spare (53.34),
F05 T4 (55.88), F17 T16 (58.42), F19 T17r (60.96), F23 T19 (63.50). Row y 64.02: R175a (50.80, the F07 / Teensy 3V3 pad),
F07 T6 (53.34), F12 T11 (55.88), F15 T14 (58.42), F18 T17 (60.96), F11 T10 (63.50). Row y 66.56: F03 T2 (50.80), spare (53.34),
F24 option (55.88), F16 T15 (58.42), F21 T21 (60.96), F20 T20 (63.50). (**superseded in r7:** the length-only assignment: Row y 58.94: F01 T1 (50.80), F02 T7b (53.34), F06 T5 (55.88), F05 T4 (58.42), F13 T12 (60.96), F14 T13 (63.50). Row y 61.48: R175 (50.80, rows 2-3), F07 T6 (53.34), F04 T3 (55.88), F17 T16 (58.42), F23 T19 (60.96), F15 T14 (63.50). Row y 64.02: R175, spare (53.34), F20 T20 (55.88), F12 T11 (58.42), F19 T17r (60.96), F11 T10 (63.50). Row y 66.56: spare (50.80), F24 option (53.34), F16 T15 (55.88), F03 T2 (58.42), F18 T17 (60.96), F21 T21 (63.50). T1/T7b and T17/T17r sit on adjacent positions, and F07 (T6) sits beside R175. It put F07 (T6) beside F02 (T7b, GND) and F04 (T3), the EN taps T3/T5 and T4/T5 side by side, F11 (T10) beside F21 (T21) and F03 (T2) beside F12, F16 and F18.)
The assignment minimises the straight-length sum under six adjacency exclusions:

- no two of T3, T4 and T5 (the RT1987 EN taps) on orthogonally adjacent positions;
- F07 (T6, the raw Teensy 3V3) beside R175, with no GND (T7b, T17r) and no EN (T3, T4, T5) neighbour;
- T10 (`CHG_QUAL`) not beside T21 (`CHG_HB`);
- T1 and T2 (the V-MOT and VBUS divider taps) not beside a raw Teensy-pin pad;
- T1/T7b and T17/T17r on adjacent positions;
- T18 off tab X.

H.23(g) finds none of the six violated. F01 (T1) has the neighbours R175b and F02 (T7b), F03 (T2) has only R175a, and F07 (T6)
has R175a and F12 (T11). R175a is the Teensy 3V3 supply node (J1.29), not a GPIO, so the T2 exclusion holds; the F03-R175a row of
the short table below gives the back-feed. F20 (T20) and F21 (T21) lie over the FT1 body (A.4). The pad envelope is x 50.050-64.250, y 58.190-67.310 (courtyard
x 49.800-64.500, y 57.940-67.560; margins to the outline: right 0.500, top 0.740, low 1.640 mm), and the low pad edge lies
2.233 mm from the MB 5V copper rim (rule >= 2.0 mm). F22 (T18) at (41.68, 35.80) runs 10.54 mm straight to CO-5V pad 1, beside
(not over) the pin-1 post (0.240 mm from the post square), and its pad courtyard lies 5.33 mm from the J101 region.

**r7 adjacent-pad short table (finding tabx-tap-pad-adjacency-unanalysed, H.23(g)).** The pad gap is 2.54 - 1.50 = 1.04 mm. Each
row assumes one hand-solder bridge or one stray strand across that gap. The 6 x 4 grid has 38 orthogonal pairs. Seven of them
contain a spare position and cannot bridge: (50.80, 61.48)-(53.34, 61.48), (53.34, 61.48)-(55.88, 61.48), (50.80, 66.56)-(53.34, 66.56),
(53.34, 66.56)-(55.88, 66.56), (53.34, 58.94)-(53.34, 61.48), (53.34, 61.48)-(53.34, 64.02) and (53.34, 64.02)-(53.34, 66.56). The
other 31 pairs and the residual-row pairs are listed below. A **push-pull pad** is a pad whose tap wire runs straight to a Teensy
output pin. The CR series resistors of A.4 sit behind the pads, so they do not limit a bridge between two tap wires. r8: R106s
(1.00 kOhm, B.4) sits between the U101 FLT output and the F17 pad, so it limits the current that a bridge at F17 drives
into FLT; it does not limit the contention between the two tap wires (H.23(n)). The
contention figures take about 40 ohm per i.MX output driver (ASSUMPTION, not measured). The T-F-12 tap-to-tap check detects
every row before the first power-up; the last column names the detector in service.

| Pair | Nets | Consequence of a bridge | Detector in service |
|---|---|---|---|
| F01 T1 - F02 T7b | V-MOT (R170 10 kOhm at the MB end) - GND | R170 carries <= 2.0 mA at 19.7 V V-MOT (the tap-to-GND case of B.2 and H.1); H1 IN+ reads 0 V | H1 state against V-MOT (T-C-02) |
| F02 T7b - F13 T12 | GND - pin 33 (ILIM_SENSE readback, R125 1 kOhm) | pin 33 reads LOW; U203 drives GND through R265 + R125 (1.47 kOhm, <= 2.3 mA) | readback plausibility (FR-08/FR-44) |
| F13 T12 - F06 T5 | pin 33 - pin 31 push-pull (FC_CHARGE_ENABLE) | pin 33 reads the pin-31 level; U203 contends with pin 31 through 1.47 kOhm (<= 2.3 mA), so the EN net follows pin 31 | readback plausibility (FR-08/FR-44) |
| F06 T5 - F14 T13 | pin 31 push-pull - pin 34 (H1 readback, R126 1 kOhm) | pin 34 reads the pin-31 level; U102 contends through R126 (<= 3.3 mA), so the EN net follows pin 31 | readback plausibility (FR-08/FR-44) |
| F14 T13 - F04 T3 | pin 34 - pin 28 push-pull (BT_BUS_ENABLE) | pin 34 reads the pin-28 level; U102 contends through R126 (<= 3.3 mA), so the EN net follows pin 28 | readback plausibility (FR-08/FR-44) |
| F05 T4 - F17 T16 | pin 30 push-pull (REGEN_ENABLE) - pin 35 (`CHG_EFUSE_FLT`, open drain, Teensy pull-up) | pin 35 reads the pin-30 level, so an eFuse fault reads "no fault" while pin 30 is HIGH; r8: an asserted FLT draws 2.657-3.377 mA from pin 30 through R106s (0.338 of the 10 mA FLT sink absolute maximum at the worst tolerance corner, SLVSE94G §6.1), and the EN net stays >= 3.017 V, above the RT1987 VEN_R maximum 1.4 V, so the switch follows its command (H.23(n)); without R106s the FLT current would be 18.4-45.6 mA with the 40 ohm driver and up to 96.2 mA with a 0 ohm driver, with the EN net at 1.48-2.65 V, so the r7 switch also stayed as commanded (H.23(n)) (**superseded in r8:** "an asserted FLT sinks pin 30 without a series resistor, which pulls the REGEN EN net only toward off") | announces itself as an apparent eFuse fault: pin 35 reads "fault" whenever pin 30 is LOW (FR-08); r8: with pin 30 LOW and the charger powered through the FC path, the FR-23 FLT-LOW diagnostic read finds the charger answering and latches the carrier fault; T-F-12 before power-up and T-C-05c (powered injection) |
| F06 T5 - F17 T16 | pin 31 push-pull (FC_CHARGE_ENABLE) - pin 35 | as the F05-F17 row, with pin 31 and the FC_CHARGE EN net (r8: FLT current and EN level through R106s as there, H.23(n)) | announces itself as an apparent eFuse fault: pin 35 reads "fault" whenever pin 31 is LOW (FR-08); r8: with pin 31 LOW and the charger powered through the regen path, the FR-23 FLT-LOW diagnostic read latches the carrier fault; T-F-12 and T-C-05c |
| F17 T16 - F19 T17r | pin 35 - GND | pin 35 reads "eFuse fault" permanently; charging is refused | announces itself (FR-08) |
| F17 T16 - F15 T14 | pin 35 - pin 16 (H2C readback, R127 1 kOhm) | r8: with FLT released, pins 35 and 16 read the U108 H2C level; with FLT asserted and U108 H2C HIGH, the node sits at 1.60-1.93 V through R127 and R106s, inside the i.MX undefined band (VIL 0.94-1.04 V, VIH 2.19-2.43 V, ASSUMPTIONs), so pins 35 and 16 can read either level (H.23(y) row (1)); an asserted FLT sinks U108 H2C through R127 and R106s (<= 1.719 mA, H.23(n); 3.377 mA without R106s) (**superseded in r8:** "pins 35 and 16 read one level"; "through R127 (<= 3.3 mA)") | readback plausibility (FR-08/FR-44); r8: T-F-12 before power-up is the detector of this pair, because the asserted-FLT level is undefined |
| F19 T17r - F23 T19 | GND - pin 40 (FC_CURRENT, INA253 FC output; U117 option) | option fitted: the INA253 FC output and pin 40 held at GND, FC current reads 0 A; option not fitted: no consequence | FC current plausibility (firmware) |
| F14 T13 - F19 T17r | pin 34 - GND | pin 34 reads LOW; U102 drives GND through R126 (<= 3.3 mA) | readback plausibility (FR-08/FR-44) |
| F19 T17r - F18 T17 | GND - pin 22 (`CHG_IIN`, eFuse IMON through R129 10 kOhm) | pin 22 reads 0 A; the IMON current returns to GND through R129 | `CHG_IIN` plausibility against the charge current (firmware) |
| R175a - F07 T6 | one net (Teensy 3V3) | none: designed 0 ohm | - |
| F07 T6 - F12 T11 | Teensy 3V3 - pin 17 push-pull (`CHG_FCCEIL`) | while pin 17 drives LOW, its output sinks the Teensy 3V3 directly: about 82.5 mA and 272 mW in the driver (40 ohm per driver ASSUMPTION, 12.3 mOhm of wire; calc revision 4; driver rating TODO(verify: i.MX RT1062 datasheet, pad output current rating), Teensy 3V3 regulator load TODO(verify: PJRC)); the node stays at the rail, so FCCEIL reads HIGH ("FC ceiling confirmed") whatever the firmware commands | none in service (no FCCEIL readback); **open, see below** |
| F12 T11 - F15 T14 | pin 17 push-pull - pin 16 (H2C readback) | pin 16 reads FCCEIL; U108 contends with pin 17 through R127 (<= 3.3 mA) | readback plausibility (FR-08/FR-44) |
| F15 T14 - F18 T17 | pin 16 - pin 22 (IMON) | pin 22 reads the H2C level; U108 drives N_IMON through R127 + R129 (11 kOhm, <= 0.3 mA) | `CHG_IIN` plausibility (firmware) |
| F18 T17 - F11 T10 | pin 22 - pin 10 push-pull (`CHG_QUAL`) | pin 22 reads the QUAL level; pin 10 drives N_IMON through R129 (<= 0.33 mA) | `CHG_IIN` plausibility (firmware) |
| F05 T4 - F12 T11 | pin 30 push-pull (REGEN_ENABLE) - pin 17 push-pull | two outputs tied without a series resistor; with the outputs opposite, 41.2 mA flows through both drivers (68 mW in each), and the EN net sits at 1.647 V with the 10 kOhm EN bodge, above the RT1987 VEN_R maximum 1.4 V (calc revision 4). D-BC-RG therefore turns on whenever pin 30 or pin 17 is HIGH: pin 17 HIGH closes REGEN while pin 30 commands it off, and pin 17 reads HIGH. U121 RGN_ON (trip 1.75-1.88 V) reads OFF at 1.65 V | none in service (U121 cannot see 1.65 V); **open, see below** |
| F12 T11 - F24 | pin 17 - J1.07 (pin 2, option) | F24 not fitted (baseline): no consequence; F24 fitted: pin 2 reads FCCEIL and pin 17 drives the ENC_A net (RENC1) | - |
| F13 T12 - F05 T4 | pin 33 - pin 30 push-pull | pin 33 reads the pin-30 level; U203 contends through 1.47 kOhm (<= 2.3 mA), so the EN net follows pin 30 | readback plausibility (FR-08/FR-44) |
| F01 T1 - R175b | V-MOT (R170) - CR 3V3 rail | R170 back-feeds <= 2.0 mA into the CR rail (rail load 1.82 mA, H.20; the surplus flows through R175 into the Teensy 3V3); H1 IN+ sees the rail, not V-MOT | H1 state against V-MOT (T-C-02) |
| R175b - R175a | CR 3V3 rail - Teensy 3V3 | R175 bypassed: a later CR or ribbon short is no longer held to 48.5 mA (r4) | none in service; T-F-12 reads R175 (68 ohm) |
| R175a - F03 T2 | Teensy 3V3 - VBUS (R171 10 kOhm at the MB end) | R171 back-feeds <= 2.0 mA into the 3V3; UVB and H1 IN- see 3.3 V in place of VBUS, so UVB drops as for a lost T2 (A.4) | announces itself (UVB LOW, T-C-02) |
| F15 T14 - F16 T15 | pin 16 - pin 23 (BT_OK readback, R128 1 kOhm) | pins 16 and 23 read one level; U108 and U104 contend through R127 + R128 (2 kOhm, <= 1.7 mA) | readback plausibility (FR-08/FR-44) |
| F18 T17 - F21 T21 | pin 22 - pin 21 push-pull (`CHG_HB`) | pin 22 reads the heartbeat; pin 21 drives N_IMON through R129 (<= 0.33 mA) | `CHG_IIN` plausibility (firmware) |
| F04 T3 - F23 T19 | pin 28 push-pull - pin 40 (U117 option) | option fitted: pin 28 and the INA253 FC output tied without a series resistor, FC current reads the EN level; option not fitted: no consequence | FC current plausibility (firmware) |
| F23 T19 - F11 T10 | pin 40 (U117 option) - pin 10 push-pull | as the F04-F23 row, with pin 10 | FC current plausibility (firmware) |
| F11 T10 - F20 T20 | pin 10 push-pull - pin 7 (CE_SENSE readback, R148 + R264, 1.47 kOhm) | pin 7 reads the QUAL level; U204 contends through 1.47 kOhm (<= 2.3 mA) | readback plausibility (FR-08(b)) |
| F24 - F16 T15 | J1.07 (pin 2, option) - pin 23 | F24 not fitted (baseline): no consequence; F24 fitted: pin 2 reads BT_OK | - |
| F16 T15 - F21 T21 | pin 23 - pin 21 push-pull | pin 23 reads the heartbeat; U104 contends through R128 (<= 3.3 mA) | readback plausibility (FR-08/FR-44) |
| F21 T21 - F20 T20 | pin 21 push-pull - pin 7 | pin 7 reads the heartbeat; U204 contends through 1.47 kOhm (<= 2.3 mA) | readback plausibility (FR-08(b)) |
| F08 T22 - F09 T8 (residual row) | BAL-NOK (BQ29200 OUT) - pin 41 / U104 IN- (BT-CURR) | no pack OV: OUT is LOW and sinks only 30-85 uA at 0.05 V, so the INA253 output (0.1 V/A x I_BT) dominates: pin 41 reads the BT current, N_BAL (via R178) follows the INA253 level below the U123 threshold, and OVN stays correct. Pack OV: OUT sources >= 100 uA at 1.75 V and up to 8 mA into a short, against the INA253 output, which `INA253A1IPWR.pdf` Figure 14 characterises only to 7 mA. Either the INA253 holds the node near its own level, so N_BAL stays LOW and the BQ29200 pack-OV term OVN is **masked** while the pack is over voltage, or OUT lifts the node toward its 6.0-9.5 V drive level and drives pin 41 above its 3.3 V supply through the pad clamp (calc revision 4) (**superseded in r7:** 'a false BT current and a false BT_OK state') | **none in service** for the masked OVN (it appears only at a pack OV); T-A-01c and the T-F-12 tap-to-tap check before power-up; **open, see below** |
| F09 T8 - F10 T9 (residual row) | BT-CURR - GND (Kelvin) | the INA253 BT output is shorted to the Kelvin GND (its current limit is not in `INA253A1IPWR.pdf`, whose Figure 14 ends at 7 mA): pin 41 and U104 IN- read 0 A, U104 BT_OK takes the 'no current' state, and the share loop loses its BT current feedback; the short current returns through the T9 wire (3.44 mOhm), so the U104 reference bottom moves by < 0.1 mV (calc revision 4) | BT current plausibility (firmware) |
| F10 T9 - F22 T18 (residual row) | not adjacent (pad gap 8.66 mm) | - | - |

Three rows carry a hazard that the H.23(g) exclusion set does not exclude. F05-F12 ties two push-pull outputs on an RT1987 EN
net, as an EN-EN pair does. F07-F12 lets a push-pull output sink the unlimited Teensy 3V3, as a GND neighbour of F07 does. The
residual-row pair F08-F09 can mask the BQ29200 pack-OV term. None of the three has a detector in service, and each stands
only behind the T-F-12 tap-to-tap check before power-up. Calc revision 4 computed the consequences in the rows above (40 ohm
per i.MX driver is an ASSUMPTION). It also ran the proposed closure, an extended exclusion set: no EN tap (T3, T4, T5) and no
F07 (T6) beside a push-pull pad (T10, T11, T21) (**superseded in r7:** TODO(calc: r7_calc.py H.23(g) with the added
exclusion)). The adopted assignment violates the extended set at T4 and T6, both beside T11. The search found a candidate with
no violation (H.23(g)). Its tab X straight sum is 887.2 mm, 1.0 mm below the adopted 888.2 mm, so the adopted assignment is
not the minimum of its own objective. Its 20-tap straight sum is 860.5 mm (+1.2 mm), and it creates the new adjacent pairs
T10-T11, T6-T2 and T6-T17. The single F12/F24 swap of review 7 also satisfies the extended set; by hand calculation it
changes the 20-tap sum by -0.14 mm (not printed by `r7_calc.py`). Neither candidate is adopted in this revision, because the
map, the short table, the dressed lengths and the PM6 dressing above are the calc-printed basis of the adopted assignment.
The choice is an operator ruling (J.2 item 63). An adopted candidate re-runs H.23(g) and replaces the map, the short table
and the T-F-12 pair list together. F08-F09 lies on the residual row, which no tab X assignment changes.

**r8 R106s placement (CHG-R1-01).** R106s (B.4, B.8) sits between U101 FLT (pin 14, net `N_FLT`) and the F17 pad (net
`CHG_EFUSE_FLT`). The H.23(n) bound holds at any position of R106s, provided that the F17 pad is the only exposed copper of
`CHG_EFUSE_FLT` apart from the R106s terminal. The layout therefore meets these rules:

- the `CHG_EFUSE_FLT` copper from the F17 pad to R106s is solder-masked over its full length and carries no test pad;
- the `N_FLT` copper from pin 14 to R106s is solder-masked over its full length and carries no test pad;
- every via on either net is tented on both sides;
- the R106s courtyard meets the courtyard rules of the region that holds it, and the T-A-06 DRC is the gate.

The placement target is the tab X bottom beside the F17 pad, joined to the pad by one tented via. The tab X bottom admits
1 % logic series resistors (the Tab X bottom row below; the A.7 thermal band rule). On the bottom, the polyimide sheet
covers the R106s terminals, and a hand-solder bridge on the top tap field cannot reach them; a top-side position in the tap
field would add new pairs to the short table above. The position must meet the bottom clearance rule (A.7, H.23(c)) and
stay out of the FT1 keep-out and its RTV lane; TODO(calc: H.23(d) bottom-clearance check of the R106s 0402 courtyard,
1.9 x 1.0 mm). If no tab X bottom position meets the rule, R106s goes on the footprint interior top as near to pin 14 as
the courtyard check allows, under the same masking rules. Booking: one 0402 courtyard (1.90 mm², the courtyard list below)
is added to the H.23(e) adopted bottom total of 392.9 mm² of 569.1 mm² (69.04 %); TODO(calc: H.23(e) and H.23(e2) with
R106s on the tab X bottom).

**Per-region placement (r5, finding efuse-cluster-no-room-at-pad10-reopen; supersedes the r4 table, which failed four of its own
rules: C102b 0.35 mm from the pad-7..10 column, the OUT strip overlapping the IN strip at D107, J101 ending where the IN strip
started, and the +x pocket 6 um from the pad-10 annulus with a bottom overflow onto the 1x10 header body).** Courtyards are IPC-7351
nominal land patterns + 0.25 mm (0402 1.9 x 1.0, 0603 3.0 x 1.45, 0805 3.4 x 1.8, 1206 4.75 x 2.3, 1210 4.75 x 3.2, SMA 6.6 x 3.1 mm),
checked by `calc/r3_calc.py` H.21(k) against each other, the CR courtyard limit (x 18.2-48.2, y 34.64-66.64; r7: the r7 outline inset 0.5 mm on its free edges, the tab roots
interior, H.23(d)), >= 0.5 mm to the
pin-3..10, W1 and W2 pads and the W6/W7 pads, and with >= 0.5 mm between regions (result: no violation). T-A-06 repeats the check
on the KiCad courtyards (the gate); a coordinate here is a placement target, not a substitute for that DRC.

| Region (board mm) | Part: courtyard x0-x1, y0-y1 | Distance rule (r5) |
|---|---|---|
| **J101** x 37.0-44.5, y 42.13-51.53 | J101 body 38.55-42.45, 42.13-51.53; mated socket per T-A-05/T-A-06 (A.7) | 0.50 mm above the tap field (top y 41.63; r7: the comparator region, same boundary), 0.50 mm below the IN strip |
| **IN strip** x 36.1-44.55, y 52.03-61.55 (below U101; x 44.55 = pad-column edge 45.05 - 0.5) | C102c 0603 horizontal 40.3-43.3, 60.10-61.55 (under pins 1-5); C102a 1206 vertical 39.8-42.1, 55.30-60.05 (VCHGIN pad at the top); R102 0805 vertical 42.65-44.45, 56.65-60.05 (N_UV pad at the top, 2.1 mm from pin 6; VCHGIN pad at the bottom); C102b 1210 horizontal 39.75-44.50, 52.05-55.25; D107 **SMA** vertical 36.60-39.70, 53.40-60.00, cathode pad at the top | C102c, C102a and the D107 cathode pad <= 3 mm (pad edge to pin-pad edge: ~1.0, 1.95 and 2.4 mm) from pins 1/2/5; **C102b by loop inductance, not distance:** its VCHGIN pad joins the pad-10/C102c pour on **L3 over the L4 GND pour (0.2 mm), 2.5 mm wide, <= 8 mm, 6 vias each end = ~0.8 nH + vias, <= 2 nH added** against the 50-150 nH MB path, which leaves the H.19 IN-spike result unchanged within ~4 % (H.21(k)); >= 0.5 mm from the pin-3..10 pads (C102b 0.55 mm from pin 7) |
| **OUT strip** x 30.8-39.3, y 62.85-66.64 (-x of U101, above the IN strip; W1/W2 moved, r5) | C103 0805 vertical 37.45-39.25, 63.20-66.60 (VCHGOUT pad at the top, ~1.3 mm from pin 18); D103 **SMA** horizontal 30.80-37.40, 63.50-66.60, cathode at the +x end | **re-derived from loop inductance (r5):** OUT 17/18 -> C103/D103 -> GND vias to the U101 thermal pad <= 2 nH added (the D103 cathode run is ~4 mm of 2.5 mm L1 pour over L2 = 0.4 nH; the hard-short lead is ~150 nH); C103 pad <= 3 mm from pins 17/18 kept; >= 0.5 mm from the W1 annulus (edge x 31.45) |
| **+x pocket** x 44.3-48.2, y 63.40-66.64, **top only** | R101, C101, R103, R104, R105 in **0402**, and the **C105 footprint DNP** (r6, SLVSE94G §8.3.9: no IMON bypass capacitor) (2 x 3 grid of 1.9 x 1.0 courtyards) | starts 0.51 mm above the pin-10 pad edge (y 62.894); ILIM/dVdT/OVP/IMON nodes <= 5 mm from pins 7-13; **no bottom overflow** (the 1x10 body occupies the CR underside to y 63.21). 0402 values and the 0.1 % TNPW0402 range for R103/R104 are checked in T-A-05 (TODO(verify: Vishay TNPW datasheet range)); fallback: 0603 R103/R104 on the bottom at y >= 63.71, x 44.3-48.2, outside the power-copper shadow (**superseded in r7:** under the bottom clearance rule, A.7) |
| **Tab X top** (r7) x 48.70-65.00, y 56.30-68.30 | the 20 tap pads, R175 and the two spare positions of the assignment above | courtyards >= 0.5 mm inside the outline (margins right 0.500, top 0.740, low 1.640 mm); thermal-band content rule (A.7): below the band boundary y 60.5-62.34 only pads, wires, the RTV bead and the passive classes of A.7; tap wires on the A.4 gap path (into the adjacent inter-row gap, toward +x to x 64.77; **superseded in r7:** "dressed toward +y until x > 63") |
| **Tab X bottom** (r7) | only the passive classes that the thermal band admits (A.7): 1 % logic series resistors and pull-downs (no comparator, reference, 0.1 % divider, BAV199 or timing capacitor), inside the 44.3 mm² left by the bottom clearance rule (H.23(d)) | bottom clearance rule (A.7) against the MB 3V3, CB-DISABLE, CHRG-STAT, CS-MDAC-FC, MPPT-DISABLE, SCL and SDA copper rims (H.23(c)); the FT1 keep-out x 59.220-64.220, y 65.405-68.005 and its RTV lane x 59.220-64.220, y 68.005-68.300 stay free |
| **Tab Y top** (r7) x 17.70-37.56, y 67.14-76.00 | LVC gates U105, U106, U107, U110, U114, U116 and U118 (driven logic only); U108 and U109 go to the footprint interior (row below) so that tab Y top stays <= 75 %; the W-lead RTV bead B3 and the W5 spacer bead S3 (H.23(l)); the 100 nF decouplers C114-C119, C122, C123 and C126 (B.8) sit directly underneath each VCC pin on the bottom; booked 112.9 of 153.7 mm² = 73.45 % (H.23(e2)); B3 and S3 lie 2.30 mm apart, so their 3 x 3 mm spots overlap and book 15.90 mm² as one union; with U108 kept on tab Y the booking is 78.0 %; with the decouplers on the top it is 93.3 % (the seven gates) or 100.6 % (U108 kept); none is adopted (**superseded in r7:** 97.7 % with the decouplers on the top, which calc revision 4 does not reproduce: it is the nine gates and their decouplers without the bead spot, 111.0 + 39.15 = 150.2 of 153.7 mm², hand calculation; r8: `round4/calc/r7_calc.py` H.23(w) row (4) reproduces 150.15 mm² = 97.7 %) | no comparator input and no timing node within 10 mm of the L-FC body; courtyards >= 0.5 mm from the outline and the chamfer; the 2.0 mm FT2 fill-hole keep-out disc at (28.00, 73.250) carries no copper and no part |
| **Tab Y bottom** (r7) | logic pull-downs, series resistors and decouplers of the tab Y gates, inside the 133.2 mm² left by the bottom clearance rule (H.23(d)); the nine gate decouplers book 39.15 mm² = 29.4 % (an upper bound, because the decouplers of U108 and U109 sit under those gates in the interior); 60.8 mm² remain for the pull-downs and series resistors at the 75 % target (H.23(e2); the T-A-06 DRC is the gate) | bottom clearance rule (tab Y has no non-GND MB copper and no MB via under it, H.23(c)); the FT2 keep-out x 25.500-30.500, y 70.750-75.750 stays free (no edge lane) |
| **Footprint low-y band** (r7: the comparator region) x 23.15-42.43, y 35.05-41.63 (126.86 mm²) | top: comparators U102-U104, U115 and U119-U121 (already top-side) and the residual tap pads F08 (T22), F09 (T8), F10 (T9) and F22 (T18) on the low row y 35.80; booked 88.2 mm² = 69.5 % (H.23(e2)); the 0.1 % dividers and U123 with D108 sit in the footprint interior (row below), because with them the band books 114 %. Bottom: the comparator input filter capacitors C106, C107, C108 and C140 and the other comparator passives of the r3 bottom set (C110-C113 and C131-C133 directly underneath their comparators) | 10.40 mm from the U101 loop band (y >= 52.03); 7.10-26.38 mm from the MB 5V copper rim (x 49.53) and 8.54-27.82 mm from the LM1084 box (x 50.97) (H.23(f)); comparators at x <= 39.53 (>= 10 mm from the 5V copper rim, `round4/work/mb_mechanical.md` 5.3) where the placement DRC allows; a comparator courtyard at x 39.53-42.43 (7.10-10.0 mm from the rim, worst estimated rise 14.9 C) stands only on the MS4b reading (T-A-08), else it moves into the interior; MB aggressors beside the band: the BT boost output loop (C4A-BT 2.58 mm, VOUT-BT copper 5.13 mm) and the VBT and VCHG-IN layer-1 traces under it (H.23(f), T-C-16b); bottom courtyards under the bottom clearance rule against the MB VBT and VCHG-IN copper; 0.50 mm below the J101 region |
| **Footprint interior** (r7, H.23(e2)): the footprint top outside the band, the J101 region, the IN and OUT strips, the U101 courtyard and the +x pocket (each + 0.5 mm), the W1-W4 pads and the W6/W7 pads (each + 0.5 mm); 288.8 mm² | top: the 0.1 % dividers R109, R110, R111, R112, R114 and R115 (moved from the bottom in r7) in the **divider strip** x 23.15-36.50, y 42.14-45.69, directly above the band and outside the W3 pad exclusion; U123 with D108, U122, the BAV199 clamps D104-D106, the monostables U111 and U113, the gates U108 and U109 (from tab Y), the DNP footprints U112, U117 and D101, the B1R wedge (r8: x 23.55-26.05, y 62.54-67.10, 11.40 mm², H.23(s)) and the W5 spacer beads S1 and S2 (H.23(l)); booked 184.9 mm² = 64.0 % (H.23(s)) (**superseded in r8:** and the W-lead RTV bead B1 and the W5 spacer beads S1 and S2 (H.23(l)); booked 182.5 mm² = 63.2 % (H.23(e2))). Bottom: R178/R179 under U123 and the decouplers C120, C121, C134 and C135 and those of U108/U109 directly underneath their ICs (r3 bottom set kept) | divider strip 6.37 mm from the U101 loop region; the interior's loop-facing corner (36.12, 51.52) lies 0.52 mm from that region (the A.8 region gap), so the dividers stay in the strip, not at that corner (H.23(f)); divider strip >= 13.03 mm from the MB 5V copper rim; bottom courtyards under the bottom clearance rule; region gaps >= 0.5 mm |

**Routing notes (r5):** SCL/SDA from pins 7/8 to the W7 pads and TS_EXT from pin 13 run on L3 under the IN strip (the strip is
VCHGIN/GND copper on L1); the N_UV node joins R102's top pad, pin 6 and R103 in the pocket; VCHGOUT runs from OUT 17/18 along the
+y edge to C103, D103 and W1 as a >= 2.5 mm L1 pour.

**r6 additions (no change to the courtyard-checked high-y band):** U119-U121 (SOT-23-6), U122/U123 (SC70-5) and D108 (SOT-23) go on
the top side in the interior between the tap field (r7: the comparator region) and the W6/W7 row (x 24-36, y 42-56, outside J101 and the W3/W4 pads), U123 and
its R178/R179/D108 input network beside F08 at the low-y edge; their 16 passives (R134 becomes DNP) go on the bottom under the same rules as the r3
passives (H.22(k): top ~678 of ~881 mm², bottom ~404 of ~591 mm²) (**superseded in r7:** U119-U121 move to the footprint low-y
band with the other comparators, U122, U123 and D108 sit in the footprint interior with R178/R179 on the bottom under U123,
and the area booking follows H.23(e) and H.23(e2), below). T-A-06 runs the placement DRC on the whole outline
(r7: the r7 outline).

**r7 area booking (H.23(e); supersedes the H.18 / H.22(k) figures).** The strict usable area (`round4/work/stackup_area.md`
section 2.2) is the courtyard limit less the header-column keep-outs, the outboard strips and the chamfer clearance. On that
area the r6 footprint build used 95 % of the top side (103 % with the power pours booked), and the r7 outline offers 1081.1 mm² of usable top area (footprint 754.1, tab X 173.3, tab Y
153.7 mm², after the 3.14 mm² FT2 fill-hole keep-out disc) and 569.1 mm² of bottom area under the bottom clearance rule (A.7).
The adopted allocation moves R175 and the six 0.1 % divider resistors R109, R110, R111, R112, R114 and R115 (42.34 mm²) from the
r3 bottom set to the top; the comparator input filter capacitors C106, C107, C108 and C140 stay on the bottom. The dividers are
the high-impedance threshold nodes and belong beside the comparators, away from the MB copper; a filter capacitor is the
low-impedance end of its node. The following table lists the adopted case beside the sensitivity cases (H.23(e)).

| Case | Top mm² | Top U | Bottom mm² | Bottom U |
|---|---|---|---|---|
| r3 bottom set kept | 752.8 | 69.63 % | 435.2 | 76.48 % |
| r7 allocation, core (0.1 % dividers + filter capacitors) + R175 | 812.5 | 75.16 % | 375.5 | 65.99 % |
| r7 allocation, extended (core + reference, REF/3, FCC_ON and RGN_ON dividers and tap capacitors) + R175 | 864.7 | 79.98 % | 323.3 | 56.81 % |
| **r7 adopted** (R175 + R109, R110, R111, R112, R114, R115) | **795.1** | **73.55 %** | **392.9 of 569.1** | **69.04 %** |

The adopted case meets the <= 75 % target on both sides. A single-sided CR would need 101.8 % (all DNP footprints removed) to
109.9 % (all footprints) of the top area, so the CR stays double-sided. The comparators U102-U104, U115 and U119-U121 were
already top-side in the r3 booking; r7 moves their placement region to the footprint low-y band, not their side.

**r7 per-region booking (H.23(e2)).** The whole-side booking above hides a local overrun. With the dividers and the U123
group, the footprint low-y band books 145.3 mm², which is 114 % of its area. Each placement region is therefore booked on its
own, against the same <= 75 % target. The courtyards are those of H.23(e), and each region is cut from the strict usable
mask. The following table lists the adopted case.

| Region | Area mm² | Content (top unless stated) | Booked mm² | U |
|---|---|---|---|---|
| Footprint low-y band | 126.86 | U102-U104, U115, U119-U121; residual pads F08-F10, F22 | 88.2 | 69.5 % |
| Footprint interior | 288.8 | R109-R112, R114, R115 (divider strip); U122, U123, D108, D104-D106, U111, U113, U108, U109; DNP U112, U117, D101; B1R wedge (r8), beads S1, S2 | 184.9 | 64.0 % (r8, H.23(s); **superseded in r8:** bead B1, 182.5 mm², 63.2 %) |
| Tab X top | 173.3 | 20 tap pad courtyards, R175 | 90.9 | 52.5 % |
| Tab Y top | 153.7 | U105, U106, U107, U110, U114, U116, U118; bead spot B3/S3 (union 15.90 mm²) | 112.9 | 73.45 % |
| Tab Y bottom | 133.2 | the nine gate decouplers (upper bound) | 39.15 | 29.4 % |

Every region meets the target. The nine LVC gates alone book 111.0 mm² = 72.2 % of tab Y top, and with the B3/S3 spot they exceed 75 %. U109 and then U108 therefore move to the interior (driven logic; the interior booking passes). The seven remaining gates book 97.0 mm² = 63.1 %, and 112.9 mm² = 73.45 % with the spot. With U108 kept on tab Y the tab Y top booking is 78.0 %. The flexible
passives R178, R179, C110, C120, C121, C134 and C135 stay on the bottom under their ICs, so the whole-side figures above do not
change. Region bookings alone would admit seven of them to the top (R178, R179, C135, C134, C120 and C121 to the interior, C110 to the band; 30.45 mm²). With those seven passives on the top, the top side would book 825.5 mm² = 76.4 % of 1081.1 mm², above the whole-side target (**superseded in r7:** 825.6 mm², a rounding difference). The
tab X figure books pad courtyards; booked as the 6 x 4 grid envelope, tab X reaches 81.6 %, but the inter-row gaps carry the
dressed wires, not parts. The bead spots B1, S1, S2 and B3/S3 are booked as 3 x 3 mm courtyards at their H.23(l) positions.

- **Header strips:** one 1x10 single-row strip in the x 45.998 column (pins 1-10, y 39.084-61.944) and one 1x12 in the
  x 20.998 column (pins 11-22, y 36.544-64.484). The 10-pin column starts one pitch in from the 12-pin column's ends, so the two
  strips are never one aligned 2-row body; each sits on its own column.
- **Copper (r6 restated, finding cr-and-mb-battery-path-copper-sized-below-ichg):** 2 oz (70 um) outer layers, 1 oz inner (4-layer,
  L2 GND). Two current bases: **`VCHGIN` and `VCHGOUT` carry the input side, <= 2.41 A** (the eFuse I_OL); **`VCHG` (pins 18/19 to
  W3), the W3/W4 tie pours and the GND star (W4 and W2 to pads 4/14/15) carry the battery-side charge current, <= 3.21 A** (regen ICHG
  3.10 A + 3.5 %, A.3, H.11), designed to >= 3.5 A. All as pours >= 2.5 mm wide on 2 oz (IPC-2221 external ~7.7 A at 10 C rise,
  H.22(c)); **fallback on 1 oz >= 2.0 mm** (~4.0 A at 10 C; the r5 1.5 mm on 1 oz, ~3.2 A, is withdrawn); the IPC-2152 chart check
  stays TODO(verify: IPC-2152 chart) in T-A-06. GND poured on the bottom layer, stitched at <= 5 mm. The W2 -> pads 14/15 pour is
  >= 2.5 mm and routed outside the analog divider bottoms (A.6).
- **Stack-up (r7, unchanged):** 4-layer, 1.6 mm: L1 2 oz (1 oz allowed by the PM0 DFM check, with the pour widths above), L2
  1 oz solid GND continuous into both tabs, L3 1 oz signals, L4 2 oz GND pour around the bottom-side parts, stitched at <= 5 mm, every L4 via tented
  (`round4/work/stackup_area.md` section 7.2). A single-sided CR needs 101.8-109.9 % of the top area (H.23(e)). A 2-layer CR
  raises the commutation-loop inductance 4-7x per mm and the coupling into the comparator inputs 46-53x. To match the 4-layer
  coupling at 5 mm, a 2-layer CR needs 36.5 mm of separation, but the farthest r7 outline point (17.70, 34.14) lies only
  25.66 mm from the U101 loop (H.23(f)). W3/W4 stay at the pin columns, so the 3.21 A battery-side current stays out of the tabs. MS8 supplies the
  fab stack-up table, the L4 tenting and the 2 oz minimum space at the U101 0.5 mm pitch.
- **MB battery path under the CR (r6):** the charge current leaves D-BT-SQ VOUT through the MB VBT pour neck (y 48.34-49.76, ~1.42 mm
  tall) and a 1.524 mm layer-1 trace from (34.29, 49.16) to (34.798, 31.75), ~14.5 mm of it under the CR and the polyimide sheet,
  laid out for the Ag105's 2.5 A. At 1 oz it is at its IPC-2221 10 C rise in free air at 3.21 A (3.2 A, H.22(c)), with less
  convection under the carrier; the `.brd` DRC assumes 1 oz (mtCopper 0.035 mm), the fab copper weight is not recorded. RT1987 is
  rated 8 A continuous, so D-BT-SQ itself is not the limit. **T-A-06c** measures the path resistance before PM4 (4-wire Kelvin,
  6.8 mOhm expected at 1 oz, 3.4 mOhm at 2 oz, H.22(c)); a thinner result, or an operator ruling for margin, takes the tinned-copper
  overlay of PM4 step 1a **before the sheet is bonded** (the last point at which the trace can be reached); a thermocouple bonded
  to the trace in PM4 step 1b is read in **T-F-16**, whose fail branch caps the regen ICHG image until the carrier is removed for the
  overlay.
- **U101 thermal pad:** >= 9 vias, 0.3 mm, to the bottom GND pour (SLVSE94G §11 layout example).
- **D103 and C103** per the OUT-strip row (r5: C103 within 3 mm of OUT 17/18; D103 by the <= 2 nH loop rule), via cluster to the bottom pour (SLVSE94G §11).
- **U101 input (r3, finding efuse-in-spike-c102-undersized; r4 placement and ratings):** C102a (1 uF 100 V 1206), C102b
  (**4.7 uF 100 V 1210**, r4), C102c (100 nF 100 V 0603) and D107 (TVS, **SMA**, r5) in the IN strip of the table above (C102a, C102c and the
  D107 cathode within 3 mm of pins 1/2/5, C102b by the <= 2 nH loop rule, r5), each with its own via pair to the L2 GND
  and the U101 thermal-pad GND (SLVSE94G §9.5.1 recommends >= 1 uF and a TVS where transients can exceed the absolute maximum).
- **Header-pin current:** the single 0.64 mm pin at pad 10 carries the full input current (<= 2.41 A, the eFuse I_OL); its
  rating is checked in T-A-05 (>= 3 A required). **r6:** the two VBAT+ pins (18/19) carry the 3.21 A battery-side current and the
  two GND pins 14/15 its return; with 60/40 sharing that is 1.93 A per pin, so **each is rated >= 2.0 A** (T-A-05), and T-F-16 logs one
  VBAT+ joint (rise < 20 C); pin 4 (VIN-) carries the input return (<= 2.41 A). **VCHG-IN copper from the pad-10 pin to U101 IN/IN_SYS <= 5 mm, solder-masked on
  both sides, no exposed test pad**; the R102 divider top taps at U101 IN_SYS (finding w8-unfused-hot-lead).
- **Analog:** U102-U104 and their dividers away from the U101 OUT/D103 loop (r7: all seven comparators and their 0.1 %
  dividers sit on the top of the footprint low-y band, 10.40 mm from the loop band, H.23(f)); the 0805 divider tops R102/R109/R111/R114 at
  least 2 mm from any logic trace; U104 divider bottom routed to the F10 (T9) pad (top-side SMT, no hole since r3; r7: residual row at (31.52, 35.80)) and to R143 only.
- Hand assembly: the VQFN-24 eFuse needs hot air or reflow; **the CR cannot be built without one of them** (or a PCB assembly
  service for U101). There is no leaded TPS26630: SLVSE94G offers it in RGE (VQFN-24) only; the PWP (HTSSOP-20) parts are the
  TPS26631/33/36/37, and the TPS26631 has 2x pulse-current support instead of the 1x active limit H.5 relies on (SLVSE94G §4).
  The r2 "TPS26630PWPR" fallback did not exist and is deleted (r3, finding tps26630-pwp-alternate-nonexistent). A leaded
  alternative would need I_OL, the fault response and the B.8 pin map re-derived and its own T-A-05/T-C-04 pass.

### A.9 EIB layout constraints (r3, finding eib-layout-unbudgeted)

| Item | Constraint |
|---|---|
| Outline | 36.0 x 24.0 mm, 2-layer, 1 oz, single-sided placement (H.18b: ~555 mm² courtyard = 64 % of 864 mm²; 30 x 22 mm was 84 %) |
| Mounting | two M3 holes at diagonally opposite corners, centres 3.5 mm in from both edges; 7 mm copper-free keep-out each (r7: the M3 nylon standoffs stand on the EVM plate, A.7) |
| E1-E8 pads | one row of 1.0 mm plated holes along the long edge facing the EVM (EVM right edge), 2.54 mm pitch, **r6 order, top to bottom (finding eib-e-lead-max-lengths-geometrically-infeasible): E8, (empty), E3, E4, E2, (empty), E7, (empty), E1, (empty), E5, E6** (12 positions, 27.94 mm between the outer centres, 30.48 mm envelope, unchanged from r5). The r5 order (E3 at one end, E8 at the other) could not meet its own E5/E7/E1 maxima from any placement that kept E3 <= 20 mm from TP33 and E8 <= 25 mm from TP49, because TP49 sits above TP33 and TP36 41 mm below it; r6 keeps E8 and E3 together at the top and runs toward TP38 and TP36 (A.5 table, H.22(i)). Isolation rules kept: **E1 (REGN)** has an empty position on both sides and is four pitches from E2 (ILIM feed) and two from E5 (/CE drive): an E1-E2 bridge would feed REGN onto ILIM_HIZ through R21 = 0 ohm and bypass Q203 + R255 (the single-switch release EM3 removed); **E7 (STAT)** has an empty position on both sides: an E6-E7 bridge would lift STAT/pin 6 to ~3.8 V and make /CE self-latching, an E7-E8 bridge would hold pin 6 at "charging" (both now impossible by adjacency: E6 and E8 are four and six pitches away); **E8-E3** are separated by an empty position (a bridge would ground ILIM_HIZ: held, safe, but it would mask a lifted E3). Remaining adjacent pairs: E3-E4 and E4-E2 (all on the ILIM_HIZ node, as in r5) and E5-E6 (both on /CE, as in r5). EIB R275 (1.00 kOhm, STAT series) sits at the E7 pad end of the E7-J201.4 trace. **r7: R276 (10.0 ohm 1 % 0603, CRCW060310R0FKEA, the R273 MPN) sits at the E1 pad, in series between the E1 lead and the EIB REGN node (C205)**; the pad order and the isolation pairs are unchanged. R276 damps the E1 + E8 + C205 series loop: at the 90 mm E1 maximum its resonance is 1.430 MHz, near the 1.5 MHz switching frequency, with an undamped Q of 19.1 (an upper bound; 13.0 with the skin-effect resistance) and 0.111 with R276 (overdamped; H.23(k), T-C-16). The empty positions carry no pad (no copper to bridge to). Bare-EIB isolation, power off, before the E leads are fitted (T-A-06): E1 to E2/E3/E5, E7 to E1/E2/E5/E6/E8, E8 to E3, each > 1 MOhm |
| J201 | r4: **2x7 1.27 mm header mating the W5 cable-assembly socket** (shrouded and keyed preferred), on the opposite long edge, keyway facing the board edge, pin-1 triangle on the silkscreen; MPN and body checked in T-A-05 (TODO(verify: Samtec FTSH/SHF drawing)); the 1.27 mm part is smaller than the r3 2.54 mm N2514, so H.18b's 64 % utilisation is an upper bound |
| REGN parts | Q201-Q203, R252, R254, R255, R257, R271 and C205 between E1/E2/E3 and the analog block, REGN traces <= 10 mm; **r7:** R276 at the E1 pad, so the order is E1 pad -> R276 -> REGN node at C205 |
| Analog | U203/U204 with R258-R263 next to the E4/E6 pads; their REF dividers and C203/C204 away from the E3/E2 nodes |
| Ground | AGND pour on the bottom layer joined to E8 only; R273 between the J201 GND pins and that pour (A.6) |
| Check | T-A-06 runs placement DRC on this outline, a 1:1 print against the EVM right edge, and measures every E-lead length on a dry fit against the A.5 build maximum (r7: E1 90 mm and E5 65 mm on the vector EVM positions; the r6 85 / 60 mm are superseded, H.23(k)) (r6: one pass/fail per lead; a length-critical lead over its maximum fails the gate, a static lead over its maximum is re-routed or the EIB moved) |

## B. Carrier and EVM interface board

### B.1 Permit logic (R6/R7; review rounds 1 and 2)

Inputs (3.3 V logic; EN nets from the RT1987 enable lines, comparators, Teensy):

| Name | Source | HIGH means | Level if its source or conductor dies |
|---|---|---|---|
| `H1` | U102 TLV3012B: V-MOT > 1.089 x VBUS + 0.30 V hysteresis | regen: the bus cannot feed V-MOT | LOW during POR (<= 1.9 ms after V+ crosses its minimum, or while V+ is below it, SBOS300C §9.4.5; nothing is specified at V+ = 0, see B.7). T1 open: R110 pulls IN+ low -> LOW. T2 open: IN- -> 0 -> **HIGH**, covered by UVB (below) |
| `UVB` | U103 TLV3012B: VBUS > 13.33 V (fall) / 13.72 V (rise), nominal | bus healthy | LOW (POR). T2 open -> LOW |
| `BT_OK` | U104 TLV3012B: INA253 BT out < 19.75 mV (I_BT < 0.06-0.34 A) | the pack is not feeding the bus | LOW. T8 open: R144 pulls IN- to 3.3 V -> LOW |
| `BTB_OFF` | U115 TLV3012B: D-BT-EN net < REF/3 (0.39-0.44 V) | the RT1987 is guaranteed off (EN < VEN_F min 0.6 V) | LOW (POR). T3 open: R119 (10.0 MOhm) pulls IN- to 3.3 V -> LOW |
| `FCC_OFF` (= net FCCN) | **r6:** U119 TLV3012B: D-BC-FC EN net (T5) < REF/3 (0.39-0.44 V) | D-BC-FC guaranteed off (EN below VEN_F min 0.6 V) | LOW = "may be on" (POR; T5 open: R187 3.30 MOhm lifts the tap to ~0.97 V) |
| `FCC_ON` | **r6:** U120 TLV3012B: D-BC-FC EN net > 1.75-1.88 V | D-BC-FC guaranteed commanded on (EN above VEN_R max 1.4 V) | LOW (POR; T5 open: 0.97 V < trip) |
| `RGN_ON` | **r6:** U121 TLV3012B: D-BC-RG EN net (T4) > 1.75-1.88 V | D-BC-RG guaranteed commanded on | LOW (POR; T4 open: R133 100 kOhm pulls the tap to 0 V) |
| `OVN` | **r6:** U123 SN74LVC1G14 Schmitt inverter of BQ29200 OUT (T22, net BAL-NOK) | no cell above VPROTECT 4.35 V for the CBLD delay | LOW = "OV" (T22 open or BQ29200 unpowered: R179 1.00 MOhm pulls the input HIGH) |
| `P5` | Teensy 5 `CHG_ARM` (via CHG pad 11) | firmware has armed after a verified image | LOW (R108 47 kOhm) |
| `QUAL` | Teensy 10 `CHG_QUAL` (one-shot trigger) | input-qualification request | LOW (R123 47 kOhm) |
| `FCCEIL` | Teensy 17 `CHG_FCCEIL` | the IINDPM/ICHG registers hold FC-window values, read back | LOW (R124 47 kOhm) = "not confirmed" |
| `HB` | Teensy 21 `CHG_HB` (heartbeat; r3: toggled only by the 1 kHz monitor tick after it has completed FR-08, the timed `detectFaults()` checks and a fresh ADC set, FR-28) | - | no edges (R136 100 kOhm pull-down) -> ARM_OK falls after tw |
| `FCI_OK` | U117 option (FC current < 1.30 A), else R137 0 ohm to 3V3 | FC channel inside its OC margin | option fitted: LOW when unpowered |

Sequential elements (SN74LVC1G123, SCES586E: Schmitt-trigger A/B inputs, glitch-free power-up reset with Q LOW, Ioff):

- **U111 QUAL one-shot:** B = QUAL (rising edge), A = GND, CLR = P5N, Rext/Cext = R150 100 kOhm / C150 3.3 uF:
  **QQ** is HIGH for tw_QQ = 0.20-0.46 s (H.17, widened for X7R tempco and DC bias; firmware constant TW_QQ_MAX, set by
  T-C-10) after a QUAL rising edge, cleared at once while P5 is HIGH. A QUAL pin frozen HIGH by a hang makes no new edge, so QQ
  ends by itself. CLR also triggers on its own rising edge if B is HIGH (SCES586E pin table): every P5 falling edge with QUAL
  HIGH fires QQ. **r2: QQ only acts through QQF = QQ AND FCCN (U118B)**, so that retrigger cannot release ILIM_HIZ in any
  topology with FCC HIGH (FC window, concurrent, ceiling blank); with FCC LOW, /CE HIGH and the VINDPM soft layer remain, and
  firmware still keeps QUAL LOW on every P5 change (I-5, T-D-13).
- **U113 heartbeat monostable:** B = HB (rising edge), A = GND, CLR tied to 3V3, Rext/Cext = R151 100 kOhm / C151 330 nF:
  **ARM_OK** stays HIGH while rising edges arrive within tw_HB = 20-46 ms (retriggerable; H.17; firmware constant TW_HB_MAX
  47 ms until T-C-10 measures it).

Equations (r6: FCCN is now the U119 comparator output FCC_OFF, the FCC term of H2c is FCC_ON, the RGN terms are RGN_ON, and
ARM_OK' = ARM_OK AND OVN replaces ARM_OK at U114):

```
FCCN     = FCC_OFF                   (U119: D-BC-FC EN < REF/3)                     r6, replaces U105 section 1
UF       = UVB AND FCCEIL                                              U116A
H1R      = H1 AND RGN_ON                                               U118A    (r2: the H1 bypass needs D-BC-RG commanded on; r6: proven on)
X        = UF OR H1R                                                   U106A
W        = FCCN AND UVB                                                U116B
H1q      = H1 AND RGN_ON AND W       (= H1 . RGN_ON . FCC_OFF . UVB)   U109     regen path; C7 qualifier; lost T2 drops it
Y1       = BT_OK AND X AND FCI_OK                                      U107
H2c      = FCC_ON AND BTB_OFF AND Y1 (= FCC_ON . BTB_OFF . BT_OK . FCI_OK . ((UVB . FCCEIL) + H1 . RGN_ON))   U108
GATE     = H1q OR H2c                                                  U110A
QQF      = QQ AND FCCN                                                 U118B    (r2: the one-shot acts only with FCC proven off)
ILIM_PRE = GATE OR QQF                                                 U110B
OVN      = NOT(BAL OUT)              (U123 Schmitt; T22 via R178 100k, D108 clamp, R179 1M pull-up)   r6
ARM_OK'  = ARM_OK AND OVN                                              U122     r6
ILIM_REL = ILIM_PRE AND ARM_OK'  -> W5 pins 7 (A) and 8 (B) -> EIB U201 ch2 -> Q203 (feed) and U202 -> Q201 (hold) -> ILIM_HIZ
CE_DRV   = P5 AND ARM_OK'        -> W5 pin 5 -> EIB U201 ch1 -> /CE                          U114A / U114B
RFC_OFF  = FCCN OR H1R           -> W5 pin 10 -> EIB U201 ch3 -> Q202 -> R257 (FC leg)        U106B
```

What each term does:
- `BTB_OFF AND BT_OK` in H2c is the **loop barrier for every mode with FCC = 1** (F.3). BTB_OFF is an analog threshold below
  the RT1987's own turn-off level, so no EN level that can leave D-BT-EN conducting reads as "off".
- `H1q` is the loop barrier for regen with the pack on the bus. `UVB` in H1q makes a lost VBUS tap (which forces H1 HIGH)
  drop the permit: UVB's divider hangs on the same T2 wire. Cost: no regen harvest while VBUS < 13.4 V, which in Run is a
  fault state anyway.
- `(UVB AND FCCEIL) OR (H1 AND RGN)` in H2c: UVB sheds the charger in microseconds if the FC-only bus sags (early purge,
  traction overload, FC boost dropout), **except** while H1 proves V-MOT > 1.089 x VBUS **and** D-BC-RG is commanded on, i.e.
  VCHG-IN is fed from V-MOT and D-BC-FC and D-MT-EN are reverse-biased, so the FC is not loaded. A sag during a raised burst
  therefore does not cut the converter mid-brake. **r2:** without the RGN term, a brake with REGEN LOW and FCC HIGH (State 98
  `J` with REGEN 0, or D-BC-RG in an OTP latch with its EN still HIGH, RT1987 DS-00 §17.8) set H1, bypassed the UVB shed and the
  FCCEIL blank and removed the FC clamp leg while VCHG-IN was fed from VBUS alone (finding h2c-h1-term-not-rgn-qualified). The
  OTP-latch case keeps RGN HIGH; there VCHG-IN follows neither source above VBUS - 35 mV, the charger draws from VBUS through
  D-BC-FC, and the FC image register, VINDPM 14.5 V and OC_FC bound it (no loop: BT_BUS LOW). T-F-09 covers REGEN LOW.
- The **ceiling blank:** in an FC window, if firmware has raised the registers to the regen values (FCCEIL LOW) and V-MOT falls
  back toward VBUS (H1 = 0), H2c = 0 and the converter stops until firmware has restored the FC values and confirms with FCCEIL
  HIGH.
- `QQF` releases ILIM_HIZ for the ADC qualification read only while the charge inhibit is on (CLR = P5N), only for tw_QQ, and
  only with FCC LOW (the Run-entry topology). A QUAL pin stuck HIGH (pin 10 fault, T10 tap shorted HIGH) can then retrigger
  QQ on a P5 fall only in regen-armed topologies, where /CE HIGH (P5 LOW) and the VINDPM 19.0 V soft layer still bar charging
  (F.3 single-fault row, T-D-13).
- `ARM_OK` qualifies both the charge enable and the converter release: no heartbeat, no charging and no switching.
- **`OVN` (r6, finding vreg-corruption-no-fixed-pack-ovp)** is the pack-voltage term no other node observed. The charger's VREG is a
  volatile register on a bus with no CRC: a single-bit address error turns a VINDPM write (0x05, written on every mode change) into a
  REG01 write that sets VREG to 16.00 V (0xBE or 0xB6 -> VREG_10:8 = 110b with REG02 0x40), and a REG09 or REG00 write into 13.44 V or
  10.88 V (H.22(a)); the BQ25798 VBAT_OVP follows VREG (103-105 %, SLUSDV2C §6.5), so it moves to ~16.5 V with it. The board's
  BQ29200 compares each cell with a factory-trimmed 4.35 V (+-10 mV at 25 C, +-25 mV over 0-60 C, SLUSA52C §7.5) after the CBLD
  330 nF delay (1.6-4.9 s with XDELAY 5.5-13.5 s/uF and +-10 % capacitance), and its OUT pin, unused until now (orphan net
  BAL-NOK), now drives OVN. ARM_OK' = ARM_OK AND OVN takes /CE HIGH and holds ILIM_HIZ in every mode with one added gate and no change
  to U114. The trip (pack 8.65-8.75 V with balanced cells) sits above `LIMIT_V_BATT_MAX` 8.5 V and the 8.646 V ADC ceiling and far
  below any corrupted VREG; the 300 mV hysteresis would let the charger cycle, so firmware latches `CHG_PACK_OV` on the first
  unexpected /CE-sense HIGH (pin 7 HIGH while P5 is HIGH, the heartbeat runs and `regnExpected`) and takes P5 LOW (FR-47). Firmware
  also reads REG01:02 and REG05 back in the same transaction after every limit write (FR-46), so a corrupted VREG lives for one
  transaction, not 20 ms. The cost is that charging needs the balance lead plugged in (J-BL, J.1), and the delay makes this a
  backstop for an overcharge that builds over seconds to minutes, not a fast clamp.
- **`FCC_OFF`, `FCC_ON`, `RGN_ON` (r6, finding fcc-rgn-lvc-threshold-vs-rt1987-en-band):** the RT1987 can turn on anywhere up to
  VEN_R 1.4 V and is guaranteed off only below VEN_F 0.6 V (DS-00 EC p.7), while a plain SN74LVC input reads 0.8-2.0 V either way.
  FCC is used with both polarities (FCC = 0 is the unsafe reading for W, H1q, QQF and RFC_OFF; FCC = 1 for H2c), so each use now has
  its own comparator whose threshold lies on the safe side of the RT1987 band: FCC_OFF only below REF/3 (0.39-0.44 V), FCC_ON and
  RGN_ON only above 1.75-1.88 V. Any intermediate EN level (a pin left `INPUT_PULLUP`, ~1 V, H.22(h)), an open tap or a comparator in
  POR reads FCC_OFF = FCC_ON = RGN_ON = 0: W = 0 and H1q = 0, QQF = 0, RFC_OFF = H1R = 0 (FC clamp kept), H2c = 0. U115 BTB_OFF was
  already built this way for D-BT-EN. The comparators add their 2-4 us propagation delay (SBOS300C §6.10) to the FCC/RGN paths,
  against the RT1987's own EN response; F.4 step A now reads "H2c = 0 within the U120 propagation delay".
- `RFC_OFF` keeps the FC clamp (0.65-0.95 A, H.4) in hardware whenever FCC = 1 and not (H1 AND RGN). It acts at any charger POR, and at
  run time **if** the BQ25798 re-reads the pin continuously (T-B-07; SLUSDV2C §7.3.4.3 says "at POR", the pin table says
  "lower of pin and register").

Truth table (X = don't care; ARM_OK' = 1 and FCI_OK = 1 unless a row says otherwise; QQ shown as the one-shot output; RFC_OFF
follows FCCN OR (H1 AND RGN_ON); r6: the FCC column means a driven EN net (FCC = 1: FCC_ON = 1, FCC_OFF = 0; FCC = 0: FCC_ON = 0,
FCC_OFF = 1) and RGN likewise; the rows marked r6 cover intermediate EN levels and the pack-OV term):

| FCC | RGN | BTB_OFF | H1 | BT_OK | UVB | FCCEIL | P5 | QQ | GATE | ILIM_REL | /CE | RFC_OFF | Meaning |
|---|---|---|---|---|---|---|---|---|---|---|---|---|---|
| 0 | 0 | X | X | X | X | X | 0 | 0 | 0 | 0 | HIGH | 1 | Idle / Init: everything off |
| 0 | 1 | X | 0 | X | X | X | 0 | 1 (<= tw) | 0 | **1** | HIGH | 1 | Run-entry qualification: pin released, charge inhibited (/CE HIGH and EN_CHG = 0 written first), time-limited |
| 0 | 1 | X | 0 | X | X | X | 1 | 0 (cleared) | 0 | 0 | LOW | 1 | firmware fault (QUAL with P5): **still converter-off** |
| 0 | 1 | 0 | 0 | X | 1 | X | 1 | 0 | 0 | 0 | LOW | 1 | regen armed, cruise: converter off |
| 0 | 1 | 0 | 1 | X | 1 | X | 1 | 0 | 1 | 1 | LOW | 1 | regen burst: converter on |
| 0 | 1 | X | 1 | X | 0 | X | 1 | 0 | 0 | 0 | LOW | 1 | regen with the bus below UVB (or T2 lost): **off** |
| 1 | X | 0 | X | X | X | X | X | 0 | 0 | 0 | P5 | H1R | BT may be on the bus with FCC: **forced off** (loop barrier) |
| 1 | X | 1 | X | 0 | X | X | X | 0 | 0 | 0 | P5 | H1R | pack current seen: off |
| 1 | X | 1 | 0 | 1 | 0 | X | X | 0 | 0 | 0 | P5 | 0 | bus sag, no brake: off |
| 1 | X | 1 | 0 | 1 | 1 | 1 | 1 | 0 | 1 | 1 | LOW | 0 | FC window charging, FC clamp in hardware |
| 1 | 1 | 1 | 1 | 1 | X | X | 1 | 0 | 1 | 1 | LOW | 1 | brake inside an FC window: converter on, regen clamp (even if UVB = 0) |
| 1 | 0 | 1 | 1 | 1 | 0 | X | X | 0 | 0 | 0 | P5 | 0 | **r2:** H1 with REGEN LOW (State 98 `J`, REGEN 0) and a bus sag: off (H1 alone no longer bypasses UVB) |
| 1 | X | 1 | X | 1 | X | X | 0 | 1 (stuck QUAL, P5 fall) | H2c | H2c | HIGH | per H1R | **r2:** QQ retrigger with FCC HIGH is masked (QQF = 0) |
| 1 | X | 1 | 0 | 1 | 1 | 0 | X | 0 | 0 | 0 | P5 | 0 | **ceiling blank** (raised registers, V-MOT back near VBUS) |
| X | X | X | X | X | X | X | X | X | X | 0 | HIGH | X | **ARM_OK = 0** (heartbeat lost): charge inhibited, converter held, in every mode |
| X | X | X | X | X | X | X | X | X | X | 0 | HIGH | X | **r6: OVN = 0** (a cell > 4.35 V for 1.6-4.9 s, T22 open, BQ29200 unpowered): ARM_OK' = 0, charge inhibited, converter held, in every mode; firmware latches `CHG_PACK_OV` |
| mid (0.45-1.74 V, or T5 open) | X | X | X | X | 1 | X | X | X | H1q = 0, H2c = 0 | 0 (QQF = 0) | P5 | H1R | **r6:** D-BC-FC EN at an intermediate level: FCC_OFF = FCC_ON = 0, so no regen permit, no FC permit, FC clamp unless H1R |
| X | mid (<= 1.74 V, or T4 open) | X | 1 | X | 1 | X | X | 0 | H1q = 0; H2c only via UVB . FCCEIL | per H2c | P5 | FCCN | **r6:** D-BC-RG EN at an intermediate level: RGN_ON = 0, so H1 neither releases the converter nor bypasses the UVB shed / FCCEIL blank |

### B.2 Comparators (values from `calc/r3_calc.py`)

| Ref | Function | Part | Network |
|---|---|---|---|
| U102 | **H1** | TLV3012BIDBVR (push-pull, POR, fail-safe inputs, SBOS300C) | IN+ = V-MOT via R170 10.0 kOhm (MB joint) + R109 487 kOhm (0805) / R110 56.2 kOhm (all 0.1 %), C106 470 pF, D104 BAV199 clamp to 3V3/GND; IN- = node T2C via R111 442 kOhm (0805) / R112 56.2 kOhm (0.1 %), C107 470 pF, D105 BAV199; R113 6.49 MOhm OUT -> IN+; REF unused (open); C110 100 nF on V+ |
| U103 | **UVB** | TLV3012BIDBVR | IN+ = node T2C via R114 1.00 MOhm (0805) / R115 104 kOhm (0.1 %), C108 1 nF (tau 94 us), D106 BAV199; R116 10.0 MOhm OUT -> IN+ (r2: CRCW0603 stops at 10 MOhm, Vishay doc 20035); IN- = own REF (1.223-1.260 V at 25 C, 100 ppm/C max, SBOS300C §6.9); C111 100 nF |
| U104 | **BT_OK** | TLV3012BIDBVR | IN+ = own REF via R141 61.9 kOhm / R142 1.00 kOhm to the T9 Kelvin (19.75 mV); R143 100 ohm from R142's bottom to the CR plane; IN- = BT-CURR via R140 10 kOhm + C140 10 nF (tau 100 us); R144 1.00 MOhm from the T8 side of R140 to 3V3; C112 100 nF |
| U115 | **BTB_OFF** | TLV3012BIDBVR | IN+ = own REF / 3 via R117 20.0 kOhm / R118 10.0 kOhm (C109 100 nF on the tap); IN- = D-BT-EN net (T3) via R120 10.0 kOhm, **R119 10.0 MOhm** to 3V3 (r2); C113 100 nF |
| **U119 (r6)** | **FCC_OFF** | TLV3012BIDBVR | as U115 on the D-BC-FC EN net: IN+ = own REF / 3 via R184 20.0 kOhm / R185 10.0 kOhm (C130 100 nF on the tap); IN- = FCC tap (T5, after R122 1 kOhm) via R186 10.0 kOhm, **R187 3.30 MOhm** to 3V3 (not 10 MOhm: the U120 divider's 1.45 MOhm to GND hangs on the same tap, and an open tap must still read "may be on", H.22(h)); output = net FCCN; C131 100 nF; R134 DNP |
| **U120 (r6)** | **FCC_ON** | TLV3012BIDBVR | IN+ = FCC tap x R189/(R188 + R189), R188 453 kOhm / R189 1.00 MOhm 1 %; IN- = own REF: trip 1.75-1.88 V at the EN net (REF tolerance and drift, 1 % resistors, Vos, hysteresis, H.22(h)), 0.35 V above VEN_R max 1.4 V; output -> U108 A; C132 100 nF |
| **U121 (r6)** | **RGN_ON** | TLV3012BIDBVR | as U120 on the D-BC-RG EN net (T4, after R121 1 kOhm; R133 100 kOhm pull-down kept): R190 453 kOhm / R191 1.00 MOhm; output -> U118A B and U109 B; C133 100 nF. U112 (keep-alive, DNP) stays on the raw RGN tap |
| U117 (DNP) | FCI_OK option | TLV3012BIDBVR | IN- = FC_CURRENT (T19) via R162 10.0 kOhm + C127 10 nF to GND (tau 100 us, as C140); IN+ = own REF via R160 10.0 kOhm / R161 1.18 kOhm 1 % (131 mV nominal), **R161 select-on-test** for a measured falling trip of 1.30 +- 0.03 A (the unselected band is 1.10-1.52 A because Vos +-9 mV is +-0.09 A at 0.1 V/A, H.19); R163 1.00 MOhm OUT -> IN+ (3.5 mV = 35 mA hysteresis); output replaces R137 into U107. Fitted only if T-F-04b fails (r3, finding u117-option-values-missing) |

Node T2C is the CR end of the single VBUS tap (T2 through R171). The H1 and UVB dividers load it together, so the two are
solved as one network in `r3_calc.py` H.1/H.2 (including the coupling through R116 when UVB switches).

- **H1 trips** (worst case: 0.1 % dividers, Vos +-9 mV, VHYS 2-8 mV, CMRR 54 dB, both UVB states): rise 17.31 V / fall 17.01 V
  nominal at VBUS 15.9 V (ratio 1.089, hysteresis 0.30 V); fall >= 16.81 V (guard 0.91 V over VBUS); at VBUS 16.39 V fall
  17.34-17.76 V and rise <= 18.05 V; at VBUS 15.2 V (loaded FC-only bus) fall >= 16.05 V (guard 0.85 V).
- **UVB trips:** fall 13.33 V nominal (band 12.89-13.78 V), rise 13.72 V (band 13.26-14.16 V), including REF drift over 0-45 C
  and the CMRR term (re-solved with R116 10.0 MOhm in r2). The fall band sits 0.34 V below the FC VINDPM floor (14.5 V - 2.6 % =
  14.12 V, T-B-13) and the rise band 1.04 V below the loaded FC-only bus (assumed >= 15.2 V, T-E-08).
- **BT_OK trip:** 19.75 mV nominal; 6.0-33.5 mV worst case = 0.06-0.34 A of BT boost forward current. The INA253A1
  zero-current output can reach 10 mV (SLOS954A §6.5 swing to GND +10 mV max, §7.5), so with an unselected R142 a false "not OK"
  at zero current is possible on an in-spec board. **r3 (finding btok-selftest-floor-overlap):** (1) **R142 is select-on-test
  per unit:** T-E-10 measures the Kelvin floor with a DMM, T-C-03 measures U104's actual falling and rising trip, and R142 is
  chosen (H.19 table, 0.604-1.40 kOhm) so that the falling trip >= floor + 4 mV and the rising trip <= 29 mV (the 0.29 A R8
  bound); the static Vos/VHYS spread then drops out and only ~0.5-1 mV of drift remains over 0-60 C. (2) A BT_OK self-test
  failure refuses **FC windows only**, never regen arming (H1q has no BT_OK term; FR-12).
- **BTB_OFF threshold:** 0.39-0.44 V worst case (REF tolerance, drift, Vos, hysteresis), 0.16 V below VEN_F min 0.6 V
  (RT1987 DS-00 EC p.7). With pin 28 driven LOW the input sits at 3 mV; with the Teensy in reset (EN net held by the 10 kOhm
  bodge pull-down) the EN net is at 3 mV and IN- at 7 mV; with pin 28 accidentally `INPUT_PULLUP` the EN net reaches about
  1.02 V, which may keep D-BT-EN on, and U115 reads it as "may be on" (permit removed). **r2 (finding btb-pullup-backdrives-en):**
  with R119 1.00 MOhm, an open 10 kOhm EN bodge pull-down plus pin 28 high-Z (reset, bootloader) left only the RT1987's own
  REN_PD (475-985 kOhm, EC p.7) against the pull-up and lifted EN to 1.06-1.63 V, inside or above the enable band: BT_BUS could
  turn on during an MCU reset. With R119 10.0 MOhm that case gives 0.15-0.30 V (< VEN_F min 0.6 V); the open-tap detection
  still works (TLV3012 bias pA), and the R119 current shifts the U115 input by only 3.3 mV. T-D-01 checks it. **r6:** U105
  sections 1 and 3 are spare, inputs tied to GND (section 1 was the FCC inverter, replaced by U119).
- **FCC_OFF / FCC_ON / RGN_ON (r6, H.22(h)):** FCC tap open: 0.97 V (R187 against the 1.45 MOhm U120 divider) -> FCC_OFF "may be on",
  FCC_ON off; tap connected with pin 31 high-Z and the 10 kOhm EN bodge open: EN 0.31-0.48 V, below VEN_F min 0.6 V (the switch stays
  off; FCC_OFF may read "may be on", the safe side); pin 31 or pin 30 left `INPUT_PULLUP` (~22 kOhm pad pull-up, TODO(verify: PJRC
  core pinMode / IMXRT1060RM PUS), T-D-01): EN 1.02 V / 0.95 V, every comparator reads the safe value. Driven LOW: ~10 mV. Driven HIGH:
  > 3 V against a 1.88 V maximum trip. The R187 current shifts the U119 input by 10 mV.
- **Input protection:** an open divider bottom (R110, R112 or R115) would put up to 22 V on a comparator input through about
  0.5-1 MOhm. The BAV199 pairs (D104-D106) clamp each input to 3V3 + one diode (36 uA at 22 V) and keep it inside the TLV3012
  7 V absolute maximum, which TI says must be enforced externally beyond (V+) (SBOS300C §6.1 note 2). BAV199 leakage
  (nA class at 25 C) on the 50-90 kOhm divider nodes shifts the trips by < 1 mV; T-A-07 measures it hot.
- **Tap faults:** R170/R171 at the MB joints make every tap wire a 10 kOhm-sourced signal: a tap shorted to GND draws 2.2 mA
  (48 mW in an 0805) instead of shorting the V-MOT node or the bus.

### B.3 Logic parts (all VCC = 3V3 via T6, 100 nF each; SN74LVC: VIH 2.0 V / VIL 0.8 V at 3.0-3.6 V, Ioff)

| Ref | Part | Function | Inputs -> output |
|---|---|---|---|
| U105 | SN74LVC3G04DCTR (SCES363L) | inverters | P5 -> P5N; **r6: sections 1 and 3 spare, inputs to GND** (FCCN now comes from U119) |
| U106 | SN74LVC2G32DCTR (SCES201N), gate A | OR | UF, H1R -> X |
| U106 | gate B | OR | FCCN (= FCC_OFF, r6), H1R -> RFC_OFF |
| U107 | SN74LVC1G11DCKR (SCES487I) | 3-AND | BT_OK, X, FCI_OK -> Y1 |
| U108 | SN74LVC1G11DCKR | 3-AND | **FCC_ON** (r6), BTB_OFF, Y1 -> **H2c** |
| U109 | SN74LVC1G11DCKR | 3-AND | H1, **RGN_ON** (r6), W -> **H1q** |
| U110 | SN74LVC2G32DCTR, gate A | OR | H1q, H2c -> GATE |
| U110 | gate B | OR | GATE, QQF -> ILIM_PRE |
| U111 | SN74LVC1G123DCTR (SCES586E) | monostable | QUAL (B), CLR = P5N -> **QQ** |
| U113 | SN74LVC1G123DCTR | monostable | HB (B), CLR = 3V3 -> **ARM_OK** |
| U114 | SN74LVC2G08DCTR (SCES198N), gate A | AND | P5, **ARM_OK'** (r6) -> **CE_DRV** |
| U114 | gate B | AND | ILIM_PRE, **ARM_OK'** (r6) -> **ILIM_REL** |
| U116 | SN74LVC2G08DCTR, gate A | AND | UVB, FCCEIL -> UF |
| U116 | gate B | AND | FCCN (= FCC_OFF), UVB -> W |
| U118 | SN74LVC2G08DCTR (SCES198N), gate A (r2) | AND | H1, **RGN_ON** (r6) -> **H1R** |
| U118 | gate B (r2) | AND | QQ, FCCN -> **QQF** |
| **U122 (r6)** | SN74LVC1G08DCKR (SCES217AA) | AND | ARM_OK, OVN -> **ARM_OK'** (to U114 pins 2 and 6) |
| **U123 (r6)** | SN74LVC1G14DCKR (SCES218AA), Schmitt input (VT+ 1.5-1.87 V, VT- 0.84-1.14 V at VCC 3 V) | inverter | N_BAL (BQ29200 OUT via R178) -> **OVN** |

Readbacks to Teensy (all `INPUT_PULLDOWN`, i.MX RT1062 pad pull-down ~100 kOhm, TODO(verify: i.MX RT1060 RM, T-C-07), so a
dead or unpowered source reads LOW): H1 -> pin 34 (R126 1 kOhm), H2c -> pin 16 (R127), BT_OK -> pin 23 (R128); the far-end
ILIM_HIZ sense U203 -> pin 33 (EIB R265 **470 ohm** (r4) + CR R125 1 kOhm) and the far-end /CE sense U204 -> **pin 7** (EIB R264 **470 ohm** (r4)
+ CR R148 1.00 kOhm, tap T20 at the vacated MB ROS pad; r2, finding eib-pin8-backpower-unpowered-outputs). Ribbon drivers:
CE_DRV (R130), ILIM_REL_A (R131A), ILIM_REL_B (R131B) and RFC_OFF (R132) leave CR through 100 ohm series resistors to damp the
0.30 m flat cable. **Edge rate (r2 restatement, finding lvc-slow-edges-reset):** every plain SN74LVC input sees a CMOS-speed
edge (<= 10 ns/V, Recommended Operating Conditions of every SN74LVC datasheet used here) **in normal operation**: no RC filter
sits in front of a plain logic input, and TLV3012B push-pull outputs switch in 10 ns typ (SBOS300C §6.10). **Exception:** when a
Teensy pin goes high-Z (reset, boot, flashing) or a tap opens, CHG_ARM (R108 47 kOhm) and FCCEIL (R124 47 kOhm) fall only through
their pull-downs, about 0.4-0.5 us/V through the 0.8-2.0 V band, so CE_DRV, ILIM_REL and H2c may chatter for microseconds while
ARM_OK is still HIGH (r6: the FCC/RGN EN nets now reach the logic only through the U119-U121 comparators, push-pull outputs, so they
leave this list; the slow BQ29200 OUT edge reaches it only through the U123 Schmitt input). The prior state is the enabled one and every chatter
edge moves toward the safe state, so no new hazard arises; the exception is accepted and tested (T-D-01: 20 resets with P5 HIGH,
no LOW-to-HIGH glitch on ILIM_REL and no new /CE LOW edge). Fallback if T-D-01 fails: Schmitt buffers (SN74LVC3G17) on CHG_ARM and
FCCEIL at the CR inputs. The two RC-timed nodes are the SN74LVC1G123 Rext/Cext pins, which are designed for it,
and its A/B inputs are Schmitt inputs.

### B.4 eFuse (VCHG-IN protection)

| Ref | Part / value | Connection | Basis (SLVSE94G, `references/Datasheets/tps2663.pdf`, r8) |
|---|---|---|---|
| U101 | **TPS26630RGER** (VQFN-24, 4 x 4 mm; 60 V, 31 mOhm, 1x active limit, adjustable OVP cutoff) | IN (1, 2), IN_SYS (5) <- VCHGIN; OUT (17, 18) -> VCHGOUT | Device comparison table p.2; IN_SYS shorted to IN when no blocking FET (Table 5-1) |
| R101 | 8.06 kOhm 1 % | ILIM (10) -> GND | I_OL = 18/R(kOhm) = 2.23 A (Eq.5); 2.05-2.41 A with the +-8 % spread from the EC table |
| R102 / R103 / R104 | 845 kOhm (0805, r2) / 66.5 kOhm / 49.9 kOhm, **0.1 %** | IN_SYS - UVLO (6) - OVP (7) - GND | Eq.9/10: UVLO 9.91 V rising (9.70-10.13 V); **OVP 23.12 V (22.61-23.63 V)**: 0.33 V above the 22.28 V design clamp, 0.37 V below the BQ25798 recommended VBUS maximum 24 V (SLUSDV2C §6.3) and below its VBUS_OVP 25.2-26.2 V |
| C101 | 22 nF X7R | dVdT (9) -> GND | >= 10 nF required (§6.3); ramp 7.3 ms at 15.9 V (Eq.2), 2.19 V/ms, 0.11 A into 51.4 uF nominal (EVM C11, C12, C29, C30, C31 5 x 10 uF + C13, C32, C14, C15 4 x 0.1 uF = 50.4 uF, SLUUCB5E Fig 4-5 / Table 4-1, + C103 1 uF); effective value at 16-21 V after EM14 from T-A-04 |
| C102a | **1.0 uF 100 V X7R 1206** (r3) | IN -> GND, within 3 mm of pins 1/2/5, via pair to L2 GND | §9.5.1: >= 1 uF on IN where the input inductance can lift IN above the absolute maximum when the FET interrupts current |
| C102b | **4.7 uF 100 V X7R/X7S 1210** (r4: 100 V because D107 may now clamp up to 60 V; r3 was 50 V); effective >= 3 uF at 23.6 V checked in T-A-04 | IN -> GND, within 5 mm of U101 IN | local bulk that absorbs the ~50-150 nH MB-trace energy (H.19: IN peak 134 V with the r2 100 nF, 67 V with 1 uF alone, <= 33 V with C102a + C102b, ideal simulation) |
| C102c | 100 nF 100 V X7R 0603 | IN -> GND, at pins 1/2 | high-frequency decoupling; >= 0.1 uF on IN (§6.3) |
| D107 | **unidirectional TVS, fitted by default; r4 (finding d107-tvs-crowbars-vmot-regen): VRWM >= 30 V, VBR(min) >= 36 V, Vc <= 60 V at the T-C-04 residual current (U101 IN abs max 67 V, §6.1), IR <= 5 uA at 23.6 V and 60 C**; class **SMAJ33A** (r5: SMA is what the courtyard-checked IN strip holds, A.8; same 33 V class, catalogue VBR 36.7-40.6 V, Vc 53.3 V at Ipp; the IN-side event is <= ~1 mJ, 0.5 x 150 nH x (117 A)², far inside an SMA rating; all confirmed from the chosen datasheet in T-A-05); **no MPN until its datasheet is in the library** | cathode IN, anode CR GND, within 3 mm of pins 1/2/5 | backstop for the IN-side spike (§9.5.1), **protecting U101 IN only (r6, finding tc04-in-spike-criterion-omits-mb-vchgin-ratings): its Vc <= 60 V sits above the RT1987 VOUT 40 V absolute maximum (DS-00 §10) and the 35 V C-D8/C-D10, so D107 does not protect the MB end of VCHG-IN; T-C-04 step (2) scores that end separately (H.5 MB-end row)**; not conditional on T-C-04, because T-C-04 step (2) is the event that would destroy U101. **Why D107 can no longer become the regen sink (r4):** D107 sits upstream of the eFuse and, with D-BC-RG closed through Run, on V-MOT through ~20 mOhm; the r3 limits (VBR(min) > 23.6 V, SMBJ26A class at 28.9 V) put its turn-on inside the reachable V-MOT range (spec.md row B: the 47 ohm chopper sinks only ~0.46 A; peak unmeasured; the U101 OVP removes the charger load at 22.6-23.6 V), where nothing limits its current (RT1987 SCP only in soft-start, §17.5). With VBR(min) >= 36 V the RT1987 OVP (33 V minimum, no maximum, DS-00 p.7) turns D-BC-RG off after tBLK_OVP 512 us typ, provided its actual trip sits >= 2 V below D107's VBR(min) (T-A-05b); D107 then conducts <= ~0.5 ms per event. **r5 (findings rt1987-ovp-otp-restart-contradiction, rt1987-ovp-latch-vs-autorestart-contradiction): DS-00 contradicts itself on what follows** (EC p.7 tBLK_OVP "Latch off. No restart." and §17.7 "re-enabled by toggling the EN pin or cycling the input power supply", against §17.4 Table 1 "OVP: Auto-restart with soft-start at fault removal"; the same split exists for OTP, §17.8 vs Table 1). D107's exposure is bounded either way (the OVP turn-off happens before any restart); what differs is whether D-BC-RG re-soft-starts into VCHG-IN on its own once V-MOT falls below the trip. T-A-05b settles it; the firmware (FR-30, T9) is written to be correct for both H.19 already shows IN <= 33 V from C102a/b alone, so the higher VBR costs no needed protection |
| C103 | 1.0 uF 50 V X7R 0805 | OUT -> GND, within 3 mm of pins 17/18 | >= 0.1 uF on OUT (§6.3); slows the turn-off edge so D103 takes the lead current |
| D103 | **>= 40 V** low-IR Schottky (r3: >= 40 V is enough against the 23.63 V OVP maximum; the r2 "45-60 V" wording excluded nothing it needed to), **SMA** (r5: the courtyard-checked OUT strip, A.8; SMB was allowed up to r4), **sized for the hard short** (r2). Selection criteria in precedence order (all from the chosen part's datasheet, checked in T-A-05): (1) IR at VR = 23.6 V and 60 C <= 0.1 mA (H.15), (2) IFSM >= 75 A, (3) VF at a >= 20 A pulse and at 3 A from the curve, (4) (r8) a non-repetitive peak current >= 130 A for <= 1 us from the IFSM-versus-pulse-width curve (H.23(p)), TODO(verify: D103 datasheet). No candidate MPN is named until its datasheet is in the library. **Bench-only fallback:** Diodes Inc. B340A-13-F (DS13005: VFM 0.50 V max at 3 A, IFSM 100 A, IRM 0.5 mA at 25 C / 20 mA at 100 C at the rated 40 V) meets (2)/(3) but fails (1) by up to 200x; it may be fitted for the T-B/T-C bench only, and on the vehicle only by an operator ruling that waives the standby budget (T-A-05 fail branch, finding d103-fallback-contradicts-criteria) | cathode VCHGOUT, anode CR power GND, within 3 mm of pins 17/18 and the exposed pad | §9.5.1 and §11: Schottky across OUT and GND to absorb the negative spike when the FET interrupts current into an inductive output. Two cases (H.5): **overload / fast-trip (4.1-4.8 A):** OUT is near VIN (~16 V) when the FET opens and dips by I x sqrt(L/C103) ~ 1.9 V; it never goes negative and D103 does not conduct. **Hard short at the EVM J1 end:** C103 + the ~0.15 uH lead ring with a 0.61 us quarter period (r8: 116-205 nH at 290-310 mm and <= 0.711 us with the A.3 wire, H.23(p)), shorter than the 1 us hot-short response (§6.6), so OUT crosses 0 V before the FET opens and D103 freewheels the W1/W2 lead current, r8: up to 130 A at 290 mm at the L' minimum (128 A when the FET opens) for < 1 us (H.5, H.23(p), H.23(y) row (3)) (**superseded in r8:** "D103 freewheels a lead current of the order of I_SCP 45 A for < 1 us"), clamping OUT at -VF(I), about -0.5 to -1 V. That is below the -0.3 V absolute minimum (§6.1); **accepted as a deviation under TI's own §9.5.1 / §11 Schottky guidance**, which states such transients "can exceed the Absolute Maximum Ratings" (TODO(verify: TI E2E acceptability of a ~-0.6 to -1 V, < 1 us excursion), T-C-04). No diode can hold -0.3 V at those currents; the only other lever is the OUT-loop inductance: W1/W2 tightly twisted at the fixed 0.30 m +- 10 mm, because a shorter W1/W2 raises the hard-short IN-side spike at U101 (H.5, D-F3), in the A.3 wire (r8: 20 AWG stranded copper, insulation OD 1.60-1.75 mm, twist pitch 20-25 mm, L' 0.399-0.661 uH/m, H.23(p)) (**superseded in r7:** W1/W2 tightly twisted and as short as possible). Leakage costs energy only while the eFuse is on, which in the always-powered regen design is all of Run (H.15) |
| R105, C105 | 27.4 kOhm 1 % (0402, r5); **C105 DNP (r6, footprint kept)** | IMON (13) -> GND | IMON 27.9 uA/A (25.66-30.14, **specified only for 0.6 A <= I(OUT) <= 2 A**, SLVSE94G EC; below 0.6 A typical only, Fig 6-14) -> 0.764 V/A; 1.31 V at 1.72 A; <= 1.99 V while current-regulated at I_OL (2.05-2.41 A is above the specified range; the 1.99 V figure uses the typical gain). r5: R105's ground is the CR plane, so the MB-GND drop to the Teensy AGND adds 1.31 A/V of apparent current (A.6, T-F-15). **r6 (finding imon-bypass-cap-against-datasheet):** SLVSE94G §8.3.9: "The IMON pin must not have a bypass capacitor to avoid delay in the current monitoring information"; the r5 10 nF (tau 274 us) contradicted it and made the H.5 fast-trip figures describe a node that did not exist. R129/C129 at the Teensy end are the only filter. FR-11 runs at 0.3-0.9 A, below the specified range, so its band comes from the T-B-14 calibration at 0.3/0.6/0.9/1.7 A, not from the EC figure |
| R129, C129 | 10.0 kOhm 1 %, 1 nF | IMON node -> pin 22 (T17); C129 at the pin side | Replaces the r0 BAT54 clamp (D102 deleted: its leakage read as 37 mA per uA, finding imon-clamp-leakage). In the <= 4.5 us fast-trip window IMON can reach 3.96 V (typical gain; r6: valid with C105 not fitted); R129/C129 (tau 10 us) pass at most 1.44 V to the pin. Above I_OL the current is regulated, so IMON never exceeds 1.99 V for longer |
| R106 | **DNP (r4)**, footprint kept on the F17 side of R106s (r8) | footprint `CHG_EFUSE_FLT` - 3V3; r8: FLT (14, open drain) -> R106s -> F17 -> pin 35, pulled up only by the Teensy pad (`INPUT_PULLUP`, FR-01) (**superseded in r8:** "FLT (14, open drain) -> pin 35, pulled up only by the Teensy pad") | FLT LOW on overload, OVP, UVLO, TSD. Behaviour below 4.5 V IN is unspecified: T-C-04. r4 (finding pin35-flt-floats-on-open-tap): with the pull-up at the Teensy end an open T16 reads "no fault" (monitors stay armed). r8: with FLT asserted, FLT sinks <= 0.288 mA of pad pull-up current through R106s (11 kOhm pull-up, ASSUMPTION, H.23(n); pad pull-up value TODO(verify: PJRC core pinMode / IMXRT1060RM PUS), T-C-05) (**superseded in r8:** "FLT sinks the ~0.15 mA pad pull-up"). Neither `N_FLT` nor `CHG_EFUSE_FLT` connects to the CR 3V3 rail, so the pin-35 pull-up has no path into the CR rail (r4 rationale unchanged) |
| **R106s (r8)** | **1.00 kOhm 1 %, 0402** (E) | FLT (14) -> `N_FLT` -> R106s -> `CHG_EFUSE_FLT` -> F17 (T16) -> pin 35; placement A.8 (r8 R106s placement) | §6.1: FLT sink current 10 mA absolute maximum. §6.5: FLT pull-down resistance R(FLT) 36/70/130 ohm min/typ/max, leakage <= 150 nA; the FLT output is specified as a resistance, so V_OL = I x R(FLT). **Pad bridge (A.8 F05-F17, F06-F17; finding CHG-R1-01):** with a push-pull Teensy output HIGH bridged to F17 and FLT asserted, R106s holds the FLT current to 2.657-3.377 mA; the maximum is at 3V3 +5 %, R106s -1 %, R(FLT) 36 ohm and a 0 ohm driver, 0.338 of the absolute maximum (a factor of 2.96 below it); the FLT pin rises to <= 0.402 V and R106s dissipates <= 11.5 mW (H.23(n)). R106s does not stop the bridge from masking a fault while the bridged output is HIGH (A.8); it removes the overstress of the FLT output. **Readback (no bridge):** FLT asserted gives pin 35 = 3V3 x (R(FLT) + R106s) / (R_pu + R(FLT) + R106s), that is V_OL plus the pull-up drop: 0.153 V typical, 0.325 V maximum against VIL 0.940 V, margin 0.615 V; FLT released gives pin 35 >= 3.130 V (H.23(n); 3V3 +-5 %, pull-up 11-33 kOhm and VIL 0.30 x 3V3 are ASSUMPTIONs, TODO(verify: PJRC Teensy 4.1 schematic, IMXRT1060CEC)). **Value (r8 decision):** 1.00 kOhm, the agreed value of finding CHG-R1-01. A larger value raises the asserted readback level toward VIL; a smaller value reduces the factor below the absolute maximum. 1.00 kOhm keeps both a factor of 2.96 and a 0.615 V margin. T-C-05c measures both |
| MODE (11) | open | latch-off | Table 8-1: latch reset by SHDN cycle, UVLO low-to-high or IN_SYS power cycle; VCHG-IN goes to 0 V in every Idle, so each Run entry resets it |
| SHDN (12) | open (internal 2.48-3.3 V) | enabled | EC "LOW IQ SHUTDOWN" |
| PGTH (15), PGOOD (16) | both to GND | fast-recovery feature off, PGOOD unused (tying it LOW is allowed) | §8.3.2 |
| B_GATE (3), DRV (4) | open | no blocking FET (the RT1987s already block reverse) | Table 5-1 |
| N.C. (19-24) | open | - | Table 5-1 |

**r4 residuals of the higher D107 VBR (r5: restart-mode independent):** a V-MOT excursion above the D-BC-RG OVP trip removes the
regen path; if the part latches (EC p.7, §17.7) it stays off until REGEN EN is toggled, and if it auto-restarts (Table 1) it
re-soft-starts into VCHG-IN by itself once V-MOT falls below the trip, so the charger may see a POR and resume converting without
the firmware having toggled REGEN. **Firmware rule (FR-30, r5):** any V_chg collapse below 10.2 V and return with REGEN HIGH is a
charger POR whatever the RT1987 did: P5 LOW on the detecting tick, the clamp-latched / harvest-lost flags, and re-qualification
through T9 (T1 steps 4-9 from the REGN marker) before P5 rises again (I-3); a toggle of REGEN EN at the next safe point re-arms a
latched part. Harvest is lost meanwhile; an excursion above 35 V exceeds C-D8/C-D10 and approaches the RT1987 40 V absolute maximum
whatever D107 is, and D107 is not credited for it (J.2).

Fault behaviour: overload above I_OL is regulated at I_OL for 129-202 ms (tCL_PLIM), then latch; above 2 x I_OL (4.1-4.8 A)
the fast-trip turns the FET off in 2.2-4.5 us; a hot short above I_SCP (45 A) in 1 us (§6.6). D103 clamps OUT on each of
these turn-offs and on the OVP shutoff. **IN side (r3):** the input current keeps rising during the 1 us response, so the
energy in the 50-150 nH MB VCHG-IN path at turn-off corresponds to 40-117 A, not 45 A (H.19); C102a/C102b take it (IN <= 33 V
in the ideal simulation) and D107 backs them up. The overload case (4.1-4.8 A) adds only a few volts. The limit sits above the 1.76 A regen clamp maximum (margin 0.30 A) and above OC_FC
(1.4 A), so in an FC window a charger-side short latches OC_FC (State 99) first: a firmware stop, not a boost death.
**Unprotected segment (r2, finding w8-unfused-hot-lead):** the board-side VCHG-IN segment (C-D8, C-D10, MB trace, the pad-10
pin, the CR VCHGIN copper, U101 IN) is upstream of the eFuse and has **no current limit for all of Run** in the always-powered
design: the RT1987 SCP is active only during soft-start ("both the SCP current limit and shutdown functions are disabled after
tON", DS-00 §17.5), so only OTP (~140 C) remains. Bus-fed fault current passes the INA253s and is bounded by the OC_FC/OC_BT
single-sample firmware latches; the CAL 470 uF + VESC bulk discharge through D-BC-RG is not bounded and may exceed the RT1987
20 A / 10 ms peak rating. Mitigation is mechanical: W8 deleted (no flying lead on this segment), CR copper from the pad-10 pin to
U101 <= 5 mm and solder-masked (A.8), inspection T-F-12 (J.1).

### B.5 Keep-alive option (R9; **do not populate in the baseline**)

Fit only if T-B-09 fails. Source: battery-derived 5 V rail at CO-5V (T18).

| Ref | Part | Connection | Basis |
|---|---|---|---|
| U112 | TPS22810DBVR load switch (2.7-18 V, IQ 62-80 uA on, 0.5-2.3 uA off, SLVSDH0C §7.5) | VIN <- 5V_KA; EN/UVLO <- `RGN` (D-BC-RG EN net, 3.3 V; VENR 1.13-1.3 V); CT C152 2.2 nF (DNP); QOD open | EN thresholds §7.5 |
| D101 | BAT54HT1G (30 V 0.2 A Schottky) | U112 VOUT -> anode; cathode -> R_KA | blocks VCHG -> 5 V when VCHG > 5 V (charging) |
| R_KA | 680 ohm 0.25 W 1206 | D101 -> `VCHG` | VCHG held at 3.63-4.46 V (H.10): above the RT1987 UVLO-rising maximum 3.35 V and VBAT_SHORTZ 2.25 V, below the 7.4 V pack floor |

Drain 0.65-1.28 mA plus 0.06-0.08 mA **only while REGEN is closed (Run)**; 0.5-2.3 uA parked. The round-2 M8 (1 kOhm from VBT,
always on) drew 1.2-1.7 mA continuously (29-41 mAh/day). The Run-time standby draw of the always-powered regen design itself is
3.5-5.0 mA from the bus (56-80 mW, H.15, r3 recount with the REGN loads and R272b), which the energy statistics must carry whether or not the keep-alive is fitted.
**Second fallback (r5: a fused link, never a plain 0 ohm bridge; finding fallback2-pack-unfused-on-w3-and-bridge-rating):**
remove D-BT-SQ (a 3 x 3 mm 12-VDFN at (29.72, 50.04): a chip jumper cannot bridge VIN-VOUT under it) and fit a **fused link
from C-D12 pad 1 (VBT, (34.29, 50.04)) to C-D11 pad 1 (VCHG, (26.16, 50.29))**, ~8 mm across the vacated site, before the CR is
fitted, Kapton over the exposed joint. The fuse is placed where pack energy enters the newly exposed net, so one part protects all
of it: the VCHG pour, C-D11, header pins 18/19, the CR VCHG copper, W3, EVM J5, JP5 and the EVM BAT ceramics, which in the
baseline are fed only by the current-regulated charger (D-BT-SQ blocks VBT -> VCHG, DS-00 §17.6). **Fuse requirements, all read
from the chosen part's datasheet in T-A-05 (no MPN before then):** nominal >= 5 A (3.21 A ICHG maximum at <= 75 % derating,
H.21); DC voltage rating >= 16 V (2x the 8.4 V pack maximum; 32 V acceptable, not required); interrupting rating >= the
prospective pack fault current measured in **T-A-05c** (pack DCIR by pulse step, never a dead short; H.21 shows 120-420 A for
10-60 mOhm); I2t below the short-time limits of the C-D11 pads, the 0.64 mm header pins, the 18 AWG W3 and the CR VCHG pour;
a 1206-2410 class body or a fuse plus a >= 20 AWG link spanning the ~8 mm, link rated >= 6 A. If no SMD fuse meets the
interrupting rating, fallback 2 is not permitted without a current-limiting eFuse in the link (a second TPS26630-class part on
its own small carrier, limit >= 3.5 A). The pack then sits on the BQ25798 BAT pin. Parked drain is the BQ25798 battery-only quiescent, 17-24 uA with ADC off (IQ_BAT_ON) or 11-16 uA in ship mode
(IQ_BAT_OFF), SLUSDV2C EC p.8. **Trade-off (r4 restatement, finding fallback2-dbtsq-disconnect-claim):** in the baseline
BT_SEQUENCE_ENABLE is never turned off (IO CSV row 32) and D-BT-SQ conducts VCHG -> VBT whenever VCHG > VBT (RT1987 DS-00
§17.6), so it never disconnects a forward fault; a charger power-stage short is bounded by the eFuse and the FR-33 REGEN/FCC drop
in the baseline **and** in this fallback. What the fallback loses is D-BT-SQ's **reverse block**: the pack then sits on BAT, so
the parked BAT draw and the OTG/backup never-write rules (G.1: REG0B-REG0D, REG47, REG0F EN_BACKUP 0) become load-bearing for
pack drain and pack-sourced outputs. The r3 text ("the hardware pack disconnect is lost") misstated the delta. **r5:** losing the
reverse block also turns the VCHG/W3/EVM-BAT nodes from charger-limited into **pack-fed**: a chafed W3, a W3-W4 short at J5 or a
cracked MLCC on that net (C-D11, the EVM BAT/SYS ceramics) becomes a pack short circuit, bounded only by the link fuse above
(T-A-05c, T-F-12, T-B-16). **r6 (finding dbtsq-short-unfused-pack-on-vchg): the baseline reaches the same topology with one fault, a
shorted D-BT-SQ FET, and then has no fuse at all.** The design answers it by detection, not a baseline fuse: with D-BT-SQ healthy,
VCHG decays below 3 V within <= 0.78 s whenever the charger is not converting (Idle, or regen-armed cruise with ILIM held, H.9), and
with it shorted VCHG sits at the pack voltage, a difference of > 4 V even with the keep-alive fitted (<= 4.46 V). FR-48 checks it in
Idle (an ACK from 0x6B with VCHG-IN unpowered means the BQ25798 runs from BAT; the VBAT ADC, which works in battery-only mode with
ADC_EN = 1 above 2.9 V, SLUSDV2C §7.3.10, confirms it against pin-25 V_batt) and every second of regen-armed cruise (VBAT ADC, REG3B,
Table 7-63). A confirmed short latches `CHG_DBTSQ_SHORT`: P5, REGEN and FCC LOW, windows and regen refused, and a request to the
operator to power down and disconnect the pack before touching W3 or the EVM; the motor path is unaffected. The exposure window
is therefore one cruise second or one boot, not a power cycle. A fuse in series with W3 on the CR was considered and not adopted
(L.6): it would add resistance in every regen burst and protect only the CR-to-EVM part of the net. T-D-15 tests the detection.

### B.6 EVM interface board (EIB)

| Ref | Part / value | Connection | Function |
|---|---|---|---|
| U201 | **SN74LVC3G06DCTR** (triple inverter, open drain; VO 0-5.5 V recommended, 6.5 V abs max in any state; Ioff; SCES364J) | VCC = EIB 3V3 (ribbon pins 1 and 2, r2; each through CR R176/R177 200 ohm, r4: EIB rail 3.13 V, 3.09 V with one conductor open, H.20); C201 100 nF | Outputs float when VCC = 0 |
| ch1 | 1A = CE_DRV (ribbon 5) via R250 1 kOhm, R267 47 kOhm to AGND | 1Y -> E5 -> /CE (TP36) | CE_DRV HIGH -> /CE LOW (charge allowed); else R272 and R272b pull /CE to REGN |
| R272, R272b | 47.0 kOhm 1 % each (r3: two, finding ce-pullup-link-sense-divider-fails-low) | on the EVM: R272 from the /CE pad of the vacated R42 footprint -> link L1 -> TP27 (REGN); R272b from the TP36 loop base -> link L2 -> JP12 REGN pin | replace EVM R42 (to PULLUP); survive an E5 lead-off; /CE has no internal pull and "must be pulled HIGH or LOW, do not leave floating" (SLUSDV2C pin table); VIH 1.3 V, abs max 6 V (EC p.16, §6.1). /CE HIGH >= 4.49 V with both, >= 4.17 V with either one open, at REGN 4.8 V with IIN_BIAS_CE 1 uA, U201 Ioff 10 uA and the U204 divider load (H.19) |
| ch2 | 2A = ILIM_REL_A (ribbon 7) via R251 1 kOhm, R268 47 kOhm to AGND | 2Y -> Q203 gate | ILIM_REL_A HIGH -> gate pulled LOW -> Q203 on -> release current flows |
| Q203 | BSS84-class P-MOSFET, SOT-23 (candidate onsemi BSS84LT1G; \|VGS(th)\| max <= 2.0 V, T-A-03) | S -> REGN (E1; **r7:** the C205 node, which E1 reaches through R276), D -> R255, G -> R271 47 kOhm to S | off unless 2Y sinks its gate |
| R255 | 48.7 kOhm 1 % | Q203 drain -> E2 -> **JP14 pin 2**, which reaches ILIM_HIZ through EVM R21 = 0 ohm (EM3, r2) | release feed (takes the role of the stock R21 127 kOhm) |
| U202 | **SN74LVC1G06DCKR** (single inverter, open drain, SCES295AB) | VCC = 3V3; C202 100 nF; A = ILIM_REL_B (ribbon 8) via R266 1 kOhm, R270 47 kOhm to AGND | separate driver on its own conductor for the hold-down |
| Q201 | 2N7002K (SOT-23) | D -> E3 -> TP33 (ILIM_HIZ), S -> AGND, G -> R252 47 kOhm to REGN; U202 Y sinks the gate | holds ILIM_HIZ < 0.75 V (converter off, REGN on, SLUSDV2C §7.3.4.3) unless ILIM_REL_B is HIGH |
| ch3 | 3A = RFC_OFF (**ribbon 10**, r4) via R253 1 kOhm, R269 47 kOhm to AGND | 3Y -> Q202 gate | RFC_OFF HIGH -> Q202 off -> regen clamp |
| Q202 | 2N7002K | D -> R257 -> E3 (ILIM_HIZ), S -> AGND, G -> R254 47 kOhm to REGN | R257 in parallel with EVM R23 = FC clamp |
| R257 | 59.0 kOhm 1 % | ILIM_HIZ -> Q202 drain | FC leg |
| U203 | TLV3012BIDBVR | IN+ = E4 (JP21 pin 1) via **R258 10.0 kOhm** (r3; was 100 kOhm), R259 10.0 MOhm to 3V3 on the comparator side; IN- = own REF x R261/(R260+R261) (R260 10.0 kOhm, **R261 10.0 kOhm**, r2): 0.59-0.65 V at IN+, **0.587-0.650 V referred to the ILIM_HIZ pin** (r3: the R259 current through R258 lifts IN+ 2.6-2.7 mV above the pin; with R258 100 kOhm it was 27-33 mV and the pin-referred band fell to 0.563-0.626 V, finding u203-threshold-ignores-sense-offset), below VIL_ILIM_HIZ max 0.75 V (SLUSDV2C §6.5), so a "held" reading guarantees no switching; C203 100 nF | **far-end ILIM_HIZ sense**, output via **R265 470 ohm** (r4, finding tlv3012-ribbon-driver-short-current: a conductor-to-GND short then sources 6.7 mA, inside the TLV3012B 10 mA output short-circuit absolute maximum, SBOS300C §6.2; the r3 100 ohm gave 33 mA) -> ribbon 11 -> CR R125 -> pin 33 (HIGH = released) |
| U204 | TLV3012BIDBVR | IN+ = E6 (JP17 /CE-side pin) via R262 1.00 MOhm, R263 1.00 MOhm to AGND (/CE / 2); IN- = own REF (1.22-1.26 V): /CE threshold about 2.5 V; C204 100 nF | **far-end /CE sense**, output via **R264 470 ohm** (r4, as R265) -> ribbon 13 -> CR R148 1.00 kOhm -> T20 -> **pin 7** (HIGH = /CE HIGH = inhibited; r2) |
| R273 | 10 ohm 1 % 0603 | J201 GND pins 3, **9**, 12, 14 (joined; pin 6 is the key, r3; 9 and 10 swapped in r4) -> EIB AGND | **single DC ground of the EIB is E8/TP49** (r2, A.6): the ribbon GND conductors cannot carry EVM power-return current |
| R274 | 10.0 kOhm 1 % 0603 | EIB 3V3 -> AGND | rail bleed (330 uA, tau ~4 ms with C201-C204): a lost 3V3 makes the rail collapse fast and swamps any residual back-feed (r2, finding eib-pin8-backpower-unpowered-outputs) |
| **R275 (r5)** | **1.00 kOhm 1 % 0603** | E7 (TP38, STAT) -> **R275** (at the E7 pad end) -> J201.4 -> ribbon 4 | STAT series limiter (findings ribbon-4-5-stat-sink-abs-max, ribbon-adjacent-short-stat-cedrv): a 4-5 ribbon short (STAT sinking while CE_DRV is HIGH) is held to 2.6-2.9 mA against the 6 mA STAT absolute maximum (SLUSDV2C §6.1) and U201 1A stays >= 2.72 V; normal STAT LOW reads 0.31 V at pin 6 through CR R107 10 kOhm (0.29 mA; i.MX VIL 0.99 V) (H.21). STAT is static (<= 1 Hz blink), so the series resistance costs no edge rate. T-C-13 meters J201.4-TP38 = 1.00 kOhm +-1 % |
| **R276 (r7)** | **10.0 ohm 1 % 0603** (CRCW060310R0FKEA, the R273 MPN) | E1 (JP12 REGN pin lead) -> **R276** (at the E1 pad end) -> EIB REGN node (C205, Q203 source) | E1 damping (H.23(k)). The E1 lead, its E8 return and C205 form a series LC near the 1.5 MHz BQ25798 switching frequency (JP24, EM19). At the 90 mm E1 maximum f0 is 1.430 MHz (1.471 MHz at the r6 85 mm). The undamped Q is 19.1 (19.3 at 85 mm), an upper bound from the DC wire resistance; the skin-effect Rac gives 13.0. With R276 the Q is 0.111 (zeta 4.5, overdamped). R276 x C205 is a 159 kHz low-pass: a 1.5 MHz REGN ripple reaches C205 at 0.106 of its EVM amplitude (T-C-16). **E1 load (r7 correction):** E1 carries only the EIB REGN loads, namely the gate pull-ups R252 (Q201) and R254 (Q202), the Q203 gate-source resistor R271 and, while released, the feed through Q203 and R255. R272 and R272b sit on the EVM and draw from REGN there, not through E1. I_E1 is 0-0.111 mA held and 0.272-0.396 mA released (REGN 4.8-5.2 V). The R276 drop is 1.02 mV at the H.15 E1 load (0.102 mA, held, R254 only) and at most 3.96 mV (released, regen clamp, REGN 5.2 V). That drop lowers the released ILIM_HIZ level by at most 1.786 mV, which lowers IINDPM by 2.23 mA (the safe direction for the converter and the eFuse; 0.13-0.17 % of the 1.33-1.76 A regen clamp, so no H.7 effect). Held levels do not change: Q203 is off and no feed flows. R276 open acts as an E1 lead off (fault table, first row); R276 shorted restores the undamped r6 circuit, which is also a pickup-budget fault on E3/E4 through the shared E8 return (A.5); T-A-02 meters R276 at 10.0 ohm +-1 %, and T-C-16 fails a shorted R276 (predicted C205/TP27 ratio 7.8-8.8 against the 0.2 limit) |
| J201 | 2x7 **1.27 mm** header mating the W5 cable assembly (r4), keyed | ribbon W5 | - |

EVM side (EM list C): **EVM R21 replaced by a 0 ohm link, JP14 shunt removed and JP14 pin 1 (REGN) removed** (r2, EM3: a stray
shunt could otherwise tie REGN straight onto ILIM_HIZ), **EVM R20 and JP13 pin 1 removed** (r3: the parallel REGN -> JP13 -> R20
255 kOhm path has the same topology), JP21 open, **EVM R23 replaced by 49.9 kOhm 1 %**, R256 200 kOhm and C252 2.2 nF across
the JP21 posts, R272 and R272b 47.0 kOhm from /CE to REGN on separate joints and links.

**r7:** R276 is the only change to the EIB circuit. Every fail-safe argument of this section holds unchanged: the r1-r2 release through two series switches (Q201 hold, Q203 feed), the R272/R272b /CE pull-ups to REGN, the U203/U204 far-end senses and the single DC ground at E8 through R273. The EIB now sits on the EVM plate on its two M3 nylon standoffs (A.7, EM23), so the EVM and the EIB share one mounting plate (E-lead relative motion 0.03-0.12 mm at 30 g, ASSUMED materials, and at most the 0.3 mm stop play; A.5, A.7).

ILIM levels (H.4, including +-1.5 uA pin leakage, 1 uA FET leakage and the sense pull-up): **regen clamp 1.33-1.76 A** (pin
2.06-2.40 V), **FC clamp (Q202 on) 0.65-0.95 A** (pin 1.52-1.76 V), **held <= 0.11 V** with Q203 off even if Q201 has failed
open (<= 0.57 V if EVM R23 has also failed open: R256 alone). These held figures **require EVM R20 to be absent** (EM3, r3:
with a shunt on JP13 and R20 fitted, REGN reaches ILIM_HIZ through 255 kOhm and the pin sits at 0.65 V, or 2.11 V with R23 also
open). The pin-referred U203 threshold (0.587-0.650 V, r3) sits above the held level (margin 17 mV in the R23-open case; if it
reads "released" there, the fault announces itself as a trip), 100 mV below VIL_ILIM_HIZ max 0.75 V and below the lowest
released level.

Single faults on the EIB/EVM side (all inhibit nodes now observed at the EVM pin):

| Fault | Converter | Detected by |
|---|---|---|
| E2 (feed) lead off, R255 open, Q203 open, U201 2Y stuck open, ribbon 7 open (R268 pulls 2A LOW); **r7: E1 lead off or R276 open** (no REGN at the EIB, so no feed; the Q201/Q202 gates then float, but no feed current exists for them to switch) | stays in HIZ (no release current) | U203 reads held while GATE expected: non-latching "permit stuck LOW" (FR-08) |
| Q201 open, R252 open (gate floats, may turn off), U202 stuck open, ribbon 8 open | held by Q203 off (no feed) | latent until Q203 also fails; T-C-05 at every build (J.2) |
| Q203 drain-source short, U201 2Y stuck sinking | held by Q201 | latent until Q201 also fails; T-C-05 (J.2) |
| Q201 drain-source short | permanent HIZ (safe) | U203 stuck LOW while released expected |
| E3 lead off | Q203 off still leaves no feed (HIZ); FC leg lost -> regen clamp in FC windows | FC clamp loss not visible to U203; bounded by the FC image register, FR-09 and OC_FC (H.12) |
| E4 sense lead off, U203 dead | none | lead off: R259 pulls IN+ to 3.3 V -> reads released (dangerous direction) -> trip latch when GATE expected 0. U203 output dead or unpowered: the pin-33 pad pull-down reads held -> stuck-LOW flag when GATE expected 1 |
| EVM R23 open | held by Q201 and by Q203 off; R256 alone keeps the pin <= 0.57 V (H.4) | released level rises (bottom = R256 only), so REG19 at qualification reads far above the regen band -> T1 refuses to arm; R23 also checked power-off in T-A-02 |
| E5 lead off, U201 1Y stuck open, ribbon 5 open (R267 pulls 1A LOW) | /CE pulled HIGH by R272/R272b (inhibit) | U204 reads /CE HIGH while P5 armed: **r6: latched `CHG_PACK_OV` / carrier-inhibit trip (FR-47)**; was a non-latching stuck-inhibit flag |
| U201 1Y stuck sinking | /CE stuck LOW (charge allowed) | U204 reads /CE LOW while P5 LOW and `regnExpected` -> FR-08(b) trip latch; at Run entry PG_STAT = 1 (or T_REGN_MAX) with the /CE sense still LOW latches it before QUAL is ever raised (T1 step 5, r3) |
| **R272 or R272b, or either link L1/L2, open** (r3) | /CE held HIGH by the other pull-up (>= 4.17 V) | latent; found by T-C-05 at every rebuild (J.2) |
| **R272 and R272b both open** (r3) | /CE pulled toward 0 V by R263 (charge allowed when U201 is off) | U204 reads /CE LOW while P5 LOW -> FR-08(b) trip; QUAL never raised; the ILIM hold remains |
| E6 sense lead off, U204 dead | none | lead off: R263 pulls IN+ to 0 -> reads /CE LOW; U204 dead or unpowered: the pin-7 pad pull-down (no other pull on that net) reads LOW = "/CE LOW" -> trip latch whenever P5 is LOW (dangerous direction, announces itself) |
| **Ribbon conductor shorted to a neighbour** (IDC crush, r4; r5 list complete) | per pair (A.3 W5): 2-3 held to 16 mA by R177; **3-4 pin 6 stuck LOW (no damage); 4-5 STAT current <= 2.9 mA through R275, /CE unaffected (r5)**; 8-9 holds ILIM (safe); 9-10 FC clamp (safe); 10-11 pin 33 follows RFC_OFF; **11-12 pin 33 held, U203 6.7 mA through R265 (r5)** | 3-4 / 4-5: FR-44 STAT plausibility (r5); 10-11: FR-08(a) trip (released while expected 0) or the T1 step-6 proof (held while expected 1); 11-12: T1 step-6 proof / FR-08 safe-direction shed; 12-13/13-14: FR-08(b); 2-3: none needed (rail stays >= 3.1 V); swept in T-C-05/T-C-07 |
| 3V3 lost on the EIB (both ribbon 3V3 conductors open; one alone changes nothing) | all open-drain outputs float: /CE HIGH (R272/R272b), Q201 on (R252), Q203 off (R271), Q202 on (R254): HIZ + FC clamp. **r2:** no external source back-powers the rail (the CE readback is on pin 7, which has no pull-up; the r1 path MB RENC2 -> pin 8 -> U204 output clamp held the rail at ~2.6 V, above the 1.65 V LVC/TLV3012B minimum, and masked the loss); R274 drains it below 1.5 V within ~20 ms | pin 7 and pin 33 fall to LOW through the pad pull-downs: with P5 LOW and `regnExpected`, pin 7 LOW = "/CE LOW" -> FR-08(b) trip; with P5 HIGH, /CE goes HIGH via R272 and charging stops (safe direction; firmware sees only the charge current vanish, FR-08 safe-direction shed) |

REGN exists whenever the converter can run (SLUSDV2C §7.3.4.1), so the stages are biased exactly when they are needed. While
REGN is absent /CE and ILIM_HIZ read 0 V. **REGN is absent not only when the charger is unpowered (r3):** after VBUS valid it
comes on only 150 ms (typical, no maximum) after VBUS_PRESENT_STAT (SLUSDV2C §7.3.4 step 5) while I2C answers from 20 ms (step
4); it is off whenever EN_HIZ = 1 (§7.3.6.5), which the charger sets itself on a failed poor-source qualification (§7.3.4.2),
on IBUS_OCP and on VSYS_SHORT, and which firmware sets in the I-6/T9 retries; and the eFuse latch removes EVM VBUS while pin 38
(board side of U101) stays high. Holding ILIM_HIZ below 0.75 V by pin, by contrast, keeps REGN on (§7.3.4.3). FR-08(b) and the
safe-direction "permit stuck LOW" rule are therefore gated on `regnExpected` (FR-23), which is TRUE only once REGN is proven
(PG_STAT = 1 or a /CE-sense HIGH with P5 LOW) or must exist by now (T_REGN_MAX after VBUS_PRESENT or the last EN_HIZ clear,
with EN_HIZ 0, FLT HIGH, fresh I2C); FR-08(a) is gated only on V_chg > 10.2 V and FLT HIGH, because an ILIM sense HIGH without
REGN can only be a fault (r3, findings t1-ce-check-before-regn, fr08-powered-predicate-ignores-regn, ce-sense-gating-before-regn).
2N7002K and BSS84 thresholds, on-resistance, Ciss and off-state leakage at 2-3 V are not in the library: T-A-03.

### B.7 Power-up and reset states of every node

| Condition | P5 | QUAL / QQ | FCCEIL | HB / ARM_OK | H1, UVB, BT_OK, BTB_OFF | GATE | ILIM_HIZ | /CE | Charger |
|---|---|---|---|---|---|---|---|---|---|
| Teensy unpowered / pack disconnected | - | - | - | - | unpowered (LOW) | - | (EVM unpowered) | - | no input power: every RT1987 EN LOW |
| Teensy reset / boot (pins high-Z) | LOW (R108) | LOW / 0 | LOW | no edges / 0 after tw | valid | 0 (RGN = FCC = 0) | LOW if REGN up | HIGH | unpowered (REGEN/FCC EN pull-downs) |
| Monostable power-up | any | QQ = 0 (glitch-free reset, SCES586E) | any | ARM_OK = 0 until the first HB edge | - | - | held | HIGH | - |
| Comparator POR (<= 1.9 ms) | any | any | any | any | LOW (r6: also FCC_OFF, FCC_ON, RGN_ON) | H2c = 0, H1q = 0 (FCCN = 0, so QQF = 0 and RFC_OFF = H1R = 0) | held (QQF = 0) | P5 AND ARM_OK' | inhibited |
| **r6: T22 open, BQ29200 unpowered (J-BL unplugged), or OUT HIGH (cell OV)** | any | any | any | running | valid | per mode | **held** (ARM_OK' = 0) | **HIGH** | inhibited in every mode. Firmware sees pin 7 HIGH while P5 HIGH and latches `CHG_PACK_OV` (FR-47); at Run entry the T1 step-8 self-test fails first (carrier fault, no arming). The unpowered-BQ29200 level of OUT (ESD path into a floating VDD) is measured in T-F-17 |
| **r6: BQ29200 OUT stuck LOW, U123 output stuck HIGH or U122 stuck HIGH** | any | any | any | running | valid | per mode | per mode | per P5 | the pack-OV backstop is lost; FR-46 read-back and OV_BATT (8.5 V) remain. **Latent**: no in-service observable; T-F-17 at every rebuild and every 6 months (J.2) |
| **r6: D-BC-FC or D-BC-RG EN at an intermediate level** (pin left `INPUT_PULLUP`, ~1 V; tap open) | any | any | any | any | valid | FCC_OFF = FCC_ON = 0 (or RGN_ON = 0): H1q = H2c = 0 | held unless QQ (QQF = 0) | per P5 | converter off; FR-49 refuses arming on the boot pad check; T-C-12, T-D-01 |
| CR 3V3 lost while armed (T6 open; r2) | (Teensy may still drive; LVC Ioff blocks back-feed through the inputs) | - | - | - | unpowered | logic unpowered: no external **logic** source feeds the rail (I2C pull-ups moved to the MB, R145/R146 DNP; CE readback on pull-up-free pin 7; R107/R144 pull up nets that no source drives, R106 DNP and pin 35 pulled up at the Teensy end (r4); R119 10 MOhm). **The only residual source (r3, finding bav199-clamps-backfeed-cr-rail) is the BAV199 upper-diode current from the live H1/UVB dividers (V-MOT and VBUS dividers at 1.5-1.8 V behind 50-94 kOhm, <= ~50 uA), which holds the rail near 0.3-0.45 V across R274, below every logic minimum (LVC 1.65 V, TLV3012 1.8 V)**; r6: with a cell in OV the D108 clamp adds <= 57 uA from the BQ29200 OUT (H.22(b)), same order, same conclusion | LOW (Q201 via REGN, Q203 off) | HIGH (R272/R272b) | off, FC clamp. **Detected:** pin 7 LOW while P5 LOW and `regnExpected` -> FR-08(b) trip (r3: the separate FR-08(b) is merged into FR-08(b); "carrier rail lost" is a diagnostic label in the fault log only), T-C-07 |
| Charger POR (input glitch) | as before | as before | as before | running | valid | per mode | per mode | per P5 | EN_CHG = 1, ICHG default, IINDPM = pin clamp at that instant, VINDPM = VBUS0 - 1.4 V; firmware re-images (G.2) |
| Teensy hang (pins frozen), or a stalled 1 kHz monitor with `loop()` still running (r3) | frozen | frozen QUAL: QQ ends after tw_QQ | frozen | **no edges (FR-28 completion token): ARM_OK = 0 within TW_HB (20-46 ms, H.17)** | valid | hardware | **held** | **HIGH** while at least one of R272/R272b is intact (r3) | inhibited and converter off in every mode; BT_BUS stays where it was. **r4:** in an FC window the next purge would then collapse the FC-only bus under a frozen MCU, so FC windows run only with the R5 watchdog fitted and proven (T-W-01: reset within 50 ms drops every EN through the 10 kOhm pull-downs, then a State-0 cold start with the low-voltage pre-charge; F.4) |

### B.8 Pin-level netlist (CR and EIB; the source for the KiCad capture, PM0 / T-A-06)

Pin numbers from the datasheet pin tables: TLV3012 DBV (SBOS300C Table 5-1: 1 OUT, 2 V-, 3 IN+, 4 IN-, 5 REF, 6 V+);
SN74LVC3G04/3G06 DCT (SCES363L/SCES364J: 1 1A, 2 3Y, 3 2A, 4 GND, 5 2Y, 6 3A, 7 1Y, 8 VCC); SN74LVC2G32/2G08 DCT
(SCES201N/SCES198N: 1 1A, 2 1B, 3 2Y, 4 GND, 5 2A, 6 2B, 7 1Y, 8 VCC); SN74LVC1G11 DCK (SCES487I: 1 A, 2 GND, 3 B, 4 Y, 5 VCC,
6 C); SN74LVC1G123 DCT (SCES586E: 1 A, 2 B, 3 CLR, 4 GND, 5 Q, 6 Cext, 7 Rext/Cext, 8 VCC); SN74LVC1G06 DCK (SCES295AB: 1 NC,
2 A, 3 GND, 4 Y, 5 VCC); **r6: SN74LVC1G08 DCK (SCES217AA: 1 A, 2 B, 3 GND, 4 Y, 5 VCC); SN74LVC1G14 DCK (SCES218AA: 1 NC, 2 A, 3 GND, 4 Y, 5 VCC)**; TPS26630 RGE (SLVSE94G Table 5-1, VQFN column); TPS22810 DBV (SLVSDH0C Pin Functions, SOT23 column: 1 VIN, 2 GND, 3 EN/UVLO,
4 CT, 5 QOD, 6 VOUT); SOT-23 MOSFETs 1 G, 2 S, 3 D (TODO(verify) against the chosen MPN datasheets, T-A-05); **BAV199 SOT-23
(r5, finding b8-netlist-omits-cr-holes-pads): 1 = anode of the lower diode (-> GND), 2 = cathode of the upper diode (-> 3V3),
3 = the common node (-> clamped input)**, from the Nexperia pinning as recalled, **not yet in the library** (the Nexperia
datasheet download was refused by the vendor CDN on 2026-11-06): TODO(verify: Nexperia BAV199 datasheet, pinning table) before
the capture, checked in T-A-05. No gate input is left floating: every unused input is tied to GND or VCC.

**Carrier (CR):**

| Ref | Pin -> net |
|---|---|
| C102a / C102b / C102c / D107 (r3) | VCHGIN - GND each (1 uF 1206, 4.7 uF 1210, 100 nF 0603); D107 K -> VCHGIN, A -> GND |
| U101 TPS26630RGER | 1, 2 IN -> VCHGIN; 3 B_GATE nc; 4 DRV nc; 5 IN_SYS -> VCHGIN; 6 UVLO -> N_UV; 7 OVP -> N_OV; 8 GND -> GND; 9 dVdT -> C101; 10 ILIM -> R101; 11 MODE nc; 12 SHDN nc; 13 IMON -> N_IMON; 14 FLT -> N_FLT (r8; **superseded in r8:** 14 FLT -> CHG_EFUSE_FLT); 15 PGTH -> GND; 16 PGOOD -> GND; 17, 18 OUT -> VCHGOUT; 19-24 nc; PAD -> GND (>= 9 vias) |
| R102 / R103 / R104 | VCHGIN - N_UV / N_UV - N_OV / N_OV - GND |
| R101, C101 | ILIM - GND; dVdT - GND |
| C103, D103 | VCHGOUT - GND; D103 K -> VCHGOUT, A -> GND |
| R105, C105 / R129 / C129 | N_IMON - GND (R105; **C105 DNP, r6**) / N_IMON - CHG_IIN (F18) / CHG_IIN - GND (r5: R101, C101, R103, R104, R105 and the C105 footprint in 0402, A.8 pocket) |
| R106 | **DNP (r4)**: footprint CHG_EFUSE_FLT - 3V3; CHG_EFUSE_FLT -> F17 (pull-up is the Teensy pin-35 pad) |
| **R106s (r8)** | N_FLT - CHG_EFUSE_FLT (1.00 kOhm 1 % 0402; N_FLT is U101 pin 14 and the R106s terminal only; both nets solder-masked, every via tented, no test pad, A.8) |
| U102 (H1) | 1 OUT -> H1; 2 V- -> GND; 3 IN+ -> N_H1P; 4 IN- -> N_H1M; 5 REF nc; 6 V+ -> 3V3 (C110) |
| R109 / R110 / C106 / R113 / D104 | F01 - N_H1P / N_H1P - GND / N_H1P - GND / H1 - N_H1P / D104 3 -> N_H1P, 1 -> GND, 2 -> 3V3 |
| R111 / R112 / C107 / D105 | T2C (F03) - N_H1M / N_H1M - GND / N_H1M - GND / as D104 on N_H1M |
| U103 (UVB) | 1 OUT -> UVB; 2 -> GND; 3 IN+ -> N_UVP; 4 IN- -> REF103; 5 REF -> REF103; 6 -> 3V3 (C111) |
| R114 / R115 / C108 / R116 / D106 | T2C - N_UVP / N_UVP - GND / N_UVP - GND / UVB - N_UVP / as D104 on N_UVP |
| U104 (BT_OK) | 1 OUT -> BT_OK; 2 -> GND; 3 IN+ -> N_BTP; 4 IN- -> N_BTM; 5 REF -> REF104; 6 -> 3V3 (C112) |
| R141 / R142 / R143 | REF104 - N_BTP / N_BTP - KELVIN (F10) / KELVIN - GND |
| R140 / C140 / R144 | F09 (BT_CURR) - N_BTM / N_BTM - GND / F09 - 3V3 |
| U115 (BTB_OFF) | 1 OUT -> BTB_OFF; 2 -> GND; 3 IN+ -> N_BBP; 4 IN- -> N_BBM; 5 REF -> REF115; 6 -> 3V3 (C113) |
| R117 / R118 / C109 | REF115 - N_BBP / N_BBP - GND / N_BBP - GND |
| R120 / R119 | F04 (BTB) - N_BBM / N_BBM - 3V3 (R119 10.0 MOhm) |
| U117 (DNP) | as U102 with IN- -> N_FCM, R162 F23 - N_FCM (10.0 kOhm), C127 N_FCM - GND (10 nF), IN+ -> N_FCP, R160 REF117 - N_FCP (10.0 kOhm), R161 N_FCP - GND (1.18 kOhm nominal, select-on-test), R163 FCI_OK - N_FCP (1.00 MOhm), 5 REF -> REF117, OUT -> FCI_OK (all DNP); R137 0 ohm FCI_OK - 3V3 fitted when U117 is not; C124 (DNP) on its V+ |
| R121 / R133 | F05 (RGN tap) - RGN / RGN - GND (r6: RGN feeds only U121 and the DNP U112) |
| R122 / R134 | F06 (FCC tap) - FCC / FCC - GND: **R134 DNP (r6)** |
| **U119 (FCC_OFF, r6)** | 1 OUT -> FCCN; 2 V- -> GND; 3 IN+ -> N_FOP; 4 IN- -> N_FOM; 5 REF -> REF119; 6 V+ -> 3V3 (C131) |
| R184 / R185 / C130 / R186 / R187 | REF119 - N_FOP / N_FOP - GND / N_FOP - GND / FCC - N_FOM / N_FOM - 3V3 (3.30 MOhm) |
| **U120 (FCC_ON, r6)** | 1 OUT -> FCC_ON; 2 -> GND; 3 IN+ -> N_FNP; 4 IN- -> REF120; 5 REF -> REF120; 6 -> 3V3 (C132) |
| R188 / R189 | FCC - N_FNP (453 kOhm) / N_FNP - GND (1.00 MOhm) |
| **U121 (RGN_ON, r6)** | 1 OUT -> RGN_ON; 2 -> GND; 3 IN+ -> N_RNP; 4 IN- -> REF121; 5 REF -> REF121; 6 -> 3V3 (C133) |
| R190 / R191 | RGN - N_RNP (453 kOhm) / N_RNP - GND (1.00 MOhm) |
| **BAL input (r6)** | R178 F08 (T22, BQ29200 OUT) - N_BAL (100 kOhm); D108 BAV199 3 -> N_BAL, 1 -> GND, 2 -> 3V3; R179 N_BAL - 3V3 (1.00 MOhm) |
| **U123 SN74LVC1G14 (r6)** | 1 NC -> GND; 2 A <- N_BAL; 4 Y -> OVN; 3 GND; 5 VCC (C135) |
| **U122 SN74LVC1G08 (r6)** | 1 A <- ARM_OK; 2 B <- OVN; 4 Y -> ARM_OKP (ARM_OK'); 3 GND; 5 VCC (C134) |
| R108 | CHG_ARM (CHG pad 11) - GND |
| R147 / R123 | F11 (QUAL) - QUAL / QUAL - GND |
| R124 | FCCEIL (F12) - GND |
| R135 / R136 | F21 (HB) - HB / HB - GND |
| U105 SN74LVC3G04 | **1 1A -> GND (r6); 7 1Y nc**; 3 2A <- CHG_ARM; 5 2Y -> P5N; 6 3A -> GND; 2 3Y nc; 4 GND; 8 VCC (C114) |
| U106 SN74LVC2G32 | 1 1A <- UF; 2 1B <- H1R; 7 1Y -> X; 5 2A <- FCCN; 6 2B <- H1R; 3 2Y -> RFC_OFF; 4 GND; 8 VCC (C115) |
| U107 SN74LVC1G11 | 1 A <- BT_OK; 3 B <- X; 6 C <- FCI_OK; 4 Y -> Y1; 2 GND; 5 VCC (C116) |
| U108 SN74LVC1G11 | 1 A <- **FCC_ON** (r6); 3 B <- BTB_OFF; 6 C <- Y1; 4 Y -> H2C; 2 GND; 5 VCC (C117) |
| U109 SN74LVC1G11 | 1 A <- H1; 3 B <- **RGN_ON** (r6); 6 C <- W; 4 Y -> H1Q; 2 GND; 5 VCC (C118) |
| U110 SN74LVC2G32 | 1 1A <- H1Q; 2 1B <- H2C; 7 1Y -> GATE; 5 2A <- GATE; 6 2B <- QQF; 3 2Y -> ILIM_PRE; 4 GND; 8 VCC (C119) |
| U111 SN74LVC1G123 | 1 A -> GND; 2 B <- QUAL; 3 CLR <- P5N; 5 Q -> QQ; 6 Cext - C150 - 7; 7 Rext/Cext - R150 - 3V3; 4 GND; 8 VCC (C120) |
| U113 SN74LVC1G123 | 1 A -> GND; 2 B <- HB; 3 CLR -> 3V3; 5 Q -> ARM_OK; 6 Cext - C151 - 7; 7 Rext/Cext - R151 - 3V3; 4 GND; 8 VCC (C121) |
| U114 SN74LVC2G08 | 1 1A <- CHG_ARM; 2 1B <- **ARM_OKP** (r6); 7 1Y -> CE_DRV; 5 2A <- ILIM_PRE; 6 2B <- **ARM_OKP** (r6); 3 2Y -> ILIM_REL; 4 GND; 8 VCC (C122) |
| U116 SN74LVC2G08 | 1 1A <- UVB; 2 1B <- FCCEIL; 7 1Y -> UF; 5 2A <- FCCN; 6 2B <- UVB; 3 2Y -> W; 4 GND; 8 VCC (C123) |
| U118 SN74LVC2G08 (r2) | 1 1A <- H1; 2 1B <- **RGN_ON** (r6); 7 1Y -> H1R; 5 2A <- QQ; 6 2B <- FCCN; 3 2Y -> QQF; 4 GND; 8 VCC (C126) |
| Readbacks | R126 H1 - F14; R127 H2C - F15; R128 BT_OK - F16; R125 J101.11 (ILIM_SENSE) - F13; R148 J101.13 (CE_SENSE) - F20 (r2) |
| Ribbon drivers | R130 CE_DRV - J101.5; R131A ILIM_REL - J101.7; R131B ILIM_REL - J101.8; R132 RFC_OFF - **J101.10** (r4) |
| 3V3 feed (r4) | **R175 68 ohm 1 % 1206**: F07 (T6) - 3V3 (the CR rail; every CR decoupler incl. C125 is on the rail side); **R176 / R177 200 ohm 1 % 0603**: 3V3 - J101.1 / 3V3 - J101.2 |
| J101 (2x7 1.27 mm SMT vertical, keyed, r4) | **1 <- R176, 2 <- R177 (3V3, r4)**; 3, **9**, 12, 14 GND; **6 omitted (key, r3)**; 4 STAT; 5 CE_DRV; 7 ILIM_REL_A; 8 ILIM_REL_B; **10 RFC_OFF**; 11 ILIM_SENSE; 13 CE_SENSE |
| CHG pins | 10 -> VCHGIN (no VCHGIN2 pad, r2); 4, 14, 15 -> GND; 18, 19 -> VCHG; 3 -> STAT (R107 to 3V3, J101.4); 11 -> CHG_ARM; 8 -> SDA (W7; R145 footprint to 3V3 **DNP**); 7 -> SCL (W7; R146 footprint **DNP**); 13 -> TS_EXT (W6); others anchors |
| Tap field (r2: renamed F01-F24 so no identifier names two nets; r3: top-side SMT pads, no holes) | F01 T1, F02 T7b (GND shield), F03 T2 (= T2C), F04 T3, F05 T4, F06 T5, F07 T6 3V3, **F08 T22 (BQ29200 OUT, r6)**, F09 T8, F10 T9 KELVIN, F11 T10, F12 T11, F13 T12, F14 T13, F15 T14, F16 T15, F17 T16, F18 T17, F19 T17r (GND shield), F20 T20, F21 T21, F22 T18 (DNP), F23 T19 (DNP), F24 spare; **r7:** nets unchanged; F01-F07, F11-F21, F23 and F24 sit on the tab X field, F08, F09, F10 and F22 on the footprint low row, F22 at (41.68, 35.80) (A.4, H.23(g)) |
| **Power holes and pads (r5)** | **W1** (1.3 mm hole, 2.3 mm pad, (30.3, 61.2)) -> VCHGOUT; **W2** (1.3 mm, 2.3 mm pad, (27.7, 61.2)) -> GND; **W3** (1.5 mm, 2.5 mm pad, (24.3, 45.4)) -> VCHG; **W4** (1.5 mm, 2.5 mm pad, (24.3, 55.6)) -> GND; **W6** SMT 1.2 x 1.5 mm: TS_EXT (33.0, 57.5) -> CHG pin 13, GND (35.0, 57.5) -> GND; **W7** SMT 1.2 x 1.5 mm: SCL (27.0, 57.5) -> CHG pin 7, GND (29.0, 57.5) -> GND, SDA (31.0, 57.5) -> CHG pin 8 |
| **Mechanical (r7)** | FT2 fill hole: 1.0 mm NPTH at (28.00, 73.250), no net, with a 2.0 mm copper and part keep-out disc on the CR top and a >= 0.5 mm copper pull-back around the hole on L2-L4 (H.23(i)); FT1 and FT2 are bonded feet without a CR pad or net, with their body outlines on the bottom silkscreen (A.7, A.8) |
| Keep-alive (DNP) | U112 TPS22810 (DBV): **1 VIN <- F22, 3 EN/UVLO <- RGN, 4 CT -> C152, 6 VOUT -> D101 A, 2 GND -> GND, 5 QOD open (r5)**; D101 K -> R_KA -> VCHG; on the MB: **F101 fuse + R172 33 ohm 1206** in series between CO-5V pad 1 and the T18 wire (r4) |
| Decoupling | C110-C123 and C126 100 nF X7R 0603 at each VCC/V+ pin as listed (C110 U102, C111 U103, C112 U104, C113 U115, C114 U105, C115 U106, C116 U107, C117 U108, C118 U109, C119 U110, C120 U111, C121 U113, C122 U114, C123 U116, C126 U118; **r6: C131 U119, C132 U120, C133 U121, C134 U122, C135 U123; C130 the U119 REF/3 tap**); C124 (U117, DNP); C125 10 uF 10 V X7R 0805 bulk on the CR 3V3 rail **downstream of R175** (r4: a cracked C125 is then current-limited, and its charge from the Teensy rail is 49 mA peak with tau 0.68 ms) |

**EIB:**

| Ref | Pin -> net |
|---|---|
| U201 SN74LVC3G06 | 1 1A <- N_CEIN; 7 1Y -> nCE_DRV (E5); 3 2A <- N_RAIN; 5 2Y -> Q203_G; 6 3A <- N_RFIN; 2 3Y -> Q202_G; 4 GND -> AGND; 8 VCC -> 3V3 (C201) |
| R274 | 3V3 - AGND (bleed, r2) |
| R250 / R267 | J201.5 - N_CEIN / N_CEIN - AGND |
| R251 / R268 | J201.7 - N_RAIN / N_RAIN - AGND |
| R253 / R269 | **J201.10** - N_RFIN / N_RFIN - AGND (r4) |
| U202 SN74LVC1G06 | 1 NC; 2 A <- N_RBIN; 4 Y -> Q201_G; 3 GND; 5 VCC -> 3V3 (C202) |
| R266 / R270 | J201.8 - N_RBIN / N_RBIN - AGND |
| Q203 BSS84 | 1 G -> Q203_G; 2 S -> REGN (**r7:** the C205 node; E1 reaches it only through R276); 3 D -> R255 -> ILIM_FEED (E2); R271 Q203_G - REGN |
| Q201 2N7002K | 1 G -> Q201_G; 2 S -> AGND; 3 D -> ILIM_HOLD (E3); R252 Q201_G - REGN |
| Q202 2N7002K | 1 G -> Q202_G; 2 S -> AGND; 3 D -> R257 -> ILIM_HOLD (E3); R254 Q202_G - REGN |
| U203 TLV3012B | 1 OUT -> R265 (470 ohm, r4) -> J201.11; 2 -> AGND; 3 IN+ -> N_ISP; 4 IN- -> N_ISM; 5 REF -> REF203; 6 -> 3V3 (C203) |
| R258 / R259 / R260 / R261 | E4 (ILIM_SNS) - N_ISP / N_ISP - 3V3 / REF203 - N_ISM / N_ISM - AGND |
| U204 TLV3012B | 1 OUT -> R264 (470 ohm, r4) -> J201.13; 2 -> AGND; 3 IN+ -> N_CSP; 4 IN- -> REF204; 5 REF -> REF204; 6 -> 3V3 (C204) |
| R262 / R263 | E6 (nCE_SNS) - N_CSP / N_CSP - AGND |
| R275 (r5) | E7 (TP38, STAT) - J201.4, at the E7 pad end |
| **R276 (r7)** | REGN_E1 (E1 pad, the JP12 REGN pin lead) - REGN, at the E1 pad end; the REGN node carries only Q203 S, R271, R252, R254 and C205 |
| J201 (2x7 1.27 mm, keyed, r4) | as J101 (1, 2 -> EIB 3V3); 4 STAT <- **R275** <- E7 (TP38) (r5); **6 no connection (r3)**; 10 RFC_OFF; GND pins 3, **9**, 12, 14 joined -> **R273 10 ohm** -> AGND; AGND -> E8 (TP49) only |
| Local | C205 100 nF REGN - AGND at Q203 source (**r7:** on the REGN side of R276, so R276 x C205 filters the E1 lead, H.23(k)) |

### B.9 What the carrier and the EIB need from the firmware

The hardware above needs these firmware behaviours, specified in G.2: the heartbeat toggled only by a completed 1 kHz monitor
tick (FR-28, r3), QUAL raised only after EN_CHG = 0 is verified and REGN is proven, and LOW on every P5 change (FR-04, I-5,
T1), the two far-end senses compared in the dangerous direction with the heartbeat timeout HB_dead, the one-shot length
TW_QQ_MAX and the `regnExpected` gate (FR-08, FR-23), FC_CHARGE/BT_BUS never HIGH
together (FR-06, I-9), REG14 never written (FR-03), readback pins `INPUT_PULLDOWN` (FR-01), and an I2C bus clear at boot and
after any bus-busy timeout (FR-07). **r5:** the qualified brake feed-forward and BRAKE state (FR-41), the independent pre-emption
backstop (FR-42), flash writes only in quiescent states with the watchdog windowed on the heartbeat (FR-43) and the STAT path
plausibility check that pairs with EIB R275 (FR-44). **r6:** the 1 kHz timer domain for the window-time-critical set (FR-45), the
same-transaction read-back of every limit write (FR-46), the `CHG_PACK_OV` latch on an unexpected /CE-sense HIGH (FR-47), the
D-BT-SQ short check (FR-48) and the boot pad check that keeps every RT1987 EN pin a driven output (FR-49).

## C. EVM modification list (BQ25798EVM BMS034A/B-003, SLUUCB5E Table 1-3, Fig 4-5/4-6, BOM Table 4-1)

Make every change **before the first power-up**. Never move a PROG jumper with power applied. **r7:** the carrier extension and the EVM placement change the electrical function of no EM item, so every EM item stays necessary. r7 changes only the text of EM5 (JP21 post identity) and EM23 (EVM mount). Parts on the EVM are written
"EVM Rnn" elsewhere in this document.

| ID | Item | Stock | Change | Reason / evidence |
|---|---|---|---|---|
| EM1 | JP17 | installed (/CE to GND) | **remove the shunt**; its /CE-side header pin (pin 1) becomes the U204 sense joint (E6). **r5 (finding evm-jp17-stray-shunt): also remove JP17 pin 2 (AGND)** (desolder, or clip flush and cover with Kapton), as EM3 does for JP13/JP14 | Stock EVM charges at POR (SLUSDV2C Table 7-9 p.41). /CE now driven by EIB ch1. With pin 2 left in place, a stock shunt put back (the UG default is "Installed", SLUUCB5E Table 1-3) or a solder bridge while E6 is soldered beside it would ground /CE permanently: charging enabled whatever P5 and ARM_OK do, the /CE hang barrier gone (FR-08(b) catches it only with P5 LOW and `regnExpected`). T-A-02 checks it |
| EM2 | R42 (10.0 kOhm, /CE -> PULLUP) | fitted | **remove**; fit **R272 47.0 kOhm** from the /CE pad of the vacated footprint to TP27 (REGN) with link L1 (<= 10 mm Kynar), and **R272b 47.0 kOhm** from the TP36 (/CE) loop base to the JP12 REGN pin with its own link L2 (<= 15 mm) (r3) | Redundant /CE pull-up to REGN that survives an E5 lead-off and any single open pull-up, resistor or link (B.6, H.19); SLUSDV2C pin table: /CE must not float |
| EM3 | R21 (127 kOhm; the stock path is REGN -> JP14 pin 1 -> JP14 pin 2 -> R21 -> ILIM_HIZ, SLUUCB5E Fig 4-6) | 127 kOhm | **r2: replace R21 with a 0 ohm 0603 link (CRCW06030000Z0EA); remove the JP14 shunt; remove JP14 pin 1 (the REGN pin: desolder, or clip flush and cover with Kapton)**; **r3: also remove EVM R20 (255 kOhm 0603) and remove or clip JP13 pin 1 (REGN)**; JP21 open. JP14 pin 2 (on ILIM_HIZ through R21 = 0 ohm) becomes the feed joint E2, JP21 pin 1 the sense joint E4. Fallback if no 0 ohm part is at hand: keep R21 removed and land E2 on the vacated R21 pad on the ILIM_HIZ side (mechanically weaker, strain-relieve it) | Release current comes only through EIB Q203 + R255 (B.6). The r1 text removed R21, which left JP14 pin 2 on an empty pad: the release never reached ILIM_HIZ (finding evm-jp14-feed-joint-floating, blocker). Removing JP14 pin 1 makes it impossible for a stray shunt to tie REGN straight onto ILIM_HIZ (bypassing Q203/R255) or short REGN through Q201. **r3 (finding evm-jp13-regn-pin-stray-shunt):** JP13 is the same topology (REGN -> JP13 pin 1 -> pin 2 -> R20 255 kOhm -> ILIM_HIZ, SLUUCB5E Fig 4-6); a loose shunt there would make the release single-switch (R20 replaces Q203 + R255), sit the held pin at 0.65 V (2.11 V with R23 also open) and lift the FC clamp level from 1.58 V to 1.77 V and the regen level from 2.16 V to 2.37 V. Removing R20 breaks the branch at the resistor, so neither a shunt nor a bridge across the JP13 posts can feed ILIM_HIZ. T-A-02 and T-B-03 check it |
| EM4 | R23 (100 kOhm, ILIM_HIZ -> GND) | 100 kOhm | **replace with 49.9 kOhm 1 % 0603** (measure the removed part and the new one, T-A-02) | Halves the leakage error of the clamps (H.4) |
| EM5 | JP21 posts | - | **add R256 200 kOhm 1 % and C252 2.2 nF C0G (0603) tacked between JP21 pin 1 (ILIM_HIZ) and JP21 pin 2 (AGND)**; E4 on the pin-1 post on its own joint (r3). **r7:** JP21 pin 1 is the lower, square post at (75.312, 64.769) EVM mm (ILIM_HIZ; bottom-layer trace to TP33); the upper, round post at (75.312, 67.309) is pin 2 (AGND). The r3-r6 A.5 pixel point (902, 408) is pin 2 (`round4/work/evm_geometry.md` Table 1 and section 7.2; H.23(k); **superseded in r7:** the r3-r6 identification of that point as JP21 pin 1) | R23-open guard (H.4) and release-glitch filter (H.13); JP21 pin 2 is AGND (SLUUCB5E Fig 4-6), which keeps the parts off PGND (layout note 7). T-A-02 meters the bottom terminal (r7: the R256/C252 terminal on pin 2, the upper post) to AGND |
| EM6 | R39, R40 (10.0 kOhm SCL/SDA -> PULLUP) | fitted | **remove** | The board's RSDA/RSCL, changed to 2.7 kOhm on the MB 3V3 side (PM9, r2), are the only pull-ups; CR R145/R146 are DNP so no pull-up sits on the carrier rail; no back-powering (spec §3.2, finding cr-3v3-single-tap-backpower) |
| EM7 | J2, J3, J4 terminal blocks | fitted | **J2: remove (desolder) or insulate. r3: J3 (SYSTEM) and J4 (VPMID) likewise desoldered, or capped with insulating caps / heat-shrink** | J2 is live at VCHG-IN through JP4; J4 follows VBUS through the internal blocking FET (PMID, via R12) and J3 sits at SYS (pack voltage, via R11), both live through all of Run in the always-powered design (SLUUCB5E Table 1-2, Fig 4-5; finding evm-j3-j4-live-terminals). T-F-12 inspects them |
| EM8 | JP32 (STAT LED) | installed | **remove** | STAT swings only to Teensy 3V3 via CR R107 |
| EM9 | JP9 | 2 to J5 pin 1 | **2-3 (BATP at the BAT pin)** | CV sensed at the IC; never floating |
| EM10 | JP1, JP2 | 1-2 (ACDRV to FETs) | **2-3 (GND)** | No input FETs; EN_ACDRV locks at 0 (SLUSDV2C Table 7-29) |
| EM11 | JP3, JP4 | not installed (SLUUCB5E Table 4-1: SH-JP3/SH-JP4 QTY 0) | **r2: JP3 = soldered 20 AWG link** (it carries the input current J1 -> R2 -> JP3 -> VBUS, up to the eFuse 2.41 A); **JP4 = a 2.54 mm shunt** (no current; ordered, E). **r4 (finding evm-jp3-jp5-link-pin-rating):** desolder the JP3 header (HTSW-102, SLUUCB5E Table 4-1) and solder the link straight into its plated holes; T-A-02 measures the hole diameter first; if 20 AWG does not pass, the link goes onto the header pins only after T-A-05 finds a per-pin rating >= 3.5 A at the build temperature, and T-B-16 checks the joint's temperature rise | VAC1/VAC2 tied to VBUS; VAC2 must not float with ACFET2/RBFET2 absent (SLUSDV2C Table 5-1 p.5, §7.3.5.2). A shunt's current rating and contact resistance are not in the library (finding evm-power-shunts-unsourced) |
| EM12 | JP5 | not installed (SH-JP5 QTY 0) | **r2: soldered 18 AWG link; r4: header desoldered, link soldered into the plated holes** (fallback onto the pins only with a >= 3.5 A per-pin rating from T-A-05) | BAT to BATTERY bypass (ship FET Q5 bypassed); it carries the full charge current (3.10 A regen image, 1.6 A in windows; **r5: rated for <= 3.21 A, the ICHG +3.5 % upper bound**) in series with EVM R13 10 mOhm; both are in the H.11 CV drop. The stock 0.64 mm header pins have no current rating in the library; T-B-16 checks the JP5 joint at max(measured ICHG, 3.21 A) (rise < 20 C) |
| EM13 | JP8 | 2-3 | **1-2** | SLUUCB5E Table 1-3: JP8 1-2 with JP5 when ship mode is not used |
| EM14 | C11, C12 (VBUS), C29, C30, C31 (PMID) | 10 uF 25 V X5R 0805 (C2012X5R1E106K125AB) | **10 uF >= 35 V, 0805** (candidate Murata GRM21BR6YA106KE43L, 35 V X5R; effective totals at 23.6 V DC bias checked against SLUSDV2C §6.3 in T-A-04: C11 + C12 >= 2 uF, C29 + C30 + C31 >= 4 uF) | VCHG-IN reaches 21.2-21.5 V measured, design clamp 21.98-22.28 V; eFuse OVP now <= 23.63 V |
| EM15 | JP30 | installed (PULLUP LDO U2 fed from VBUS via D11/R35 and from BAT via D12) | **remove the shunt** | The PULLUP rail has no load left (R39, R40, R42, JP32 gone; /INT unused; TS fed from REGN via JP12). Removing it de-energises U2 and C43/C44 (0.1 uF 25 V, which would otherwise see VCHG-IN minus one diode) and stops the D12 drain from VCHG. If /INT is ever used, pull it to Teensy 3V3, not to PULLUP |
| EM16 | JP6, JP10, JP11 | installed | **remove** | No D+/D-; AUTO_INDET_EN written 0 (G.1) |
| EM17 | JP7 | USB_VIN to VAC1 | **remove** | Otherwise J6 (micro-USB VBUS pin) is live at VCHG-IN |
| EM18 | TS: JP18 / J7 | JP18 installed | **if a pack NTC is fitted (T-E-09): remove JP18, wire J7 (W6). Otherwise keep JP18**; JP12 stays installed ("must remain connected"); JP15, JP16, JP19, JP20 open | Table 1-3; never rely on TS_IGNORE (reset by WD, Table 7-34) |
| EM19 | JP24 | installed (2S, 1.5 MHz) | **keep**; JP22, JP23, JP25-JP29 open | POR VREG 8.4 V 2S (Table 7-2). EVM R29 is 6.04 kOhm in Fig 4-6 but 6.20 kOhm in the BOM: read back CELL = 1h, PWM_FREQ = 0 (T-B-01) |
| EM20 | JP31, JP33 | open | keep open | no EV2400/USB2ANY pull-ups |
| EM21 | RSNUB1/CSNUB1 (no footprint) | - | not fitted | The UG note applies to hot-plugging adapters > 15 V; here VCHG-IN is ramped by the RT1987 (12 V/ms) and the eFuse dVdT (2.2 V/ms) |
| EM22 | S1 (QON) | - | do not press | ship/reset |
| EM23 | Bumpons H1-H4 (3M SJ-5303, 11.18 mm diameter, 5.08 mm tall; SLUUCB5E Table 4-1) and the EVM mount (r7) | fitted (adhesive, underside, centred 7.620 mm in from each corner) | **r7:** keep the bumpons; they rest on the EVM plate (insulating, fixed to the chassis; A.7). Hold the EVM with two nylon clamp bars or four corner L-clamps with 0.5 mm silicone pads. Each clamp presses an edge lip no wider than 2.0 mm. Notch the clamp at J8. Keep every clamp clear of TP48/TP49, the terminal-block wire faces and the fiducials. Bond no EVM copper to the plate, the CR or the chassis with a fastener or adhesive. Mount the EIB on the same plate on its two M3 nylon standoffs. Do not drill the EVM. Fit lateral stops at the EVM board edges with at most 0.3 mm of play per axis. Limit the clamp preload so that each bumpon compresses by no more than 1.0 mm. Tack each E lead to the EIB within 10 mm of its pad. Plate, clamp and stop geometry: TODO(design: from MS2, MS5 and MS7). The r6 instruction is withdrawn because the EVM has no mounting holes (**superseded in r7:** remove; M3 nylon standoffs (hole diameter checked, T-A-02)) | The EVM has no mounting holes: its largest drill is 1.25 mm (the J1-J5 pins), and the corner circles are the fiducials FID1-FID6 (SLUUCB5E Figs 4-1 to 4-4, Table 4-1). A hole at a bumpon centre cuts the ground pour and 7-17 stitching vias, and two bumpon zones overlap the TP48/TP49 AGND pads (`round4/work/evm_geometry.md` sections 3 and 9). One plate carries the EVM and the EIB, so the two ends of every E lead share one mount. The bumpons allow 0.03-0.12 mm of relative motion at 30 g (ASSUMED materials), and the stops bound it at 0.3 mm, far below the 6.4 mm smallest E-lead slack (A.5 maxima). The 1.0 mm compression cap keeps the 2.4 mm terminal tails at least 1 mm off the plate. Edge features for the clamp design: the J5/J3 wire faces 2.41 mm in from the right edge, J1/J2 at the left edge, J4 at the top edge, J7 at the bottom edge, the J8 pins over the bottom edge to y -6.24 mm, and J6 1.0 mm over the left edge (`round4/work/evm_geometry.md` section 9). T-A-02 checks the clamp fit, the stop play, the bumpon compression and the insulation (EVM copper to plate and chassis > 1 MOhm); T-F-18b repeats these checks after the vehicle run; T-A-05 checks the plate, clamp and pad materials |
| EM24 | **No input capacitor** of any kind added | - | - | Death-5 class; EVM input is 50.4 uF ceramic only nominal (C11, C12, C29-C31 5 x 10 uF + C13, C32, C14, C15 4 x 0.1 uF; C9, C10, C26-C28, C1 DNP, SLUUCB5E Fig 4-5 / Table 4-1), no electrolytic |
| EM25 | Bring-up procedure | - | skip the SLUUCB5E §2.4.1 step that checks the PULLUP rail for 3.3 V; instead confirm **TP41 (PULLUP)** to TP49 < 0.1 V with VCHG-IN at 18.5 V (T-B-01) | JP30 out. SLUUCB5E §2.4.1 calls TP42 "PULLUP"; the schematic (Fig 4-5 test-point row) and the silkscreen (Fig 4-1) give TP41 = PULLUP, TP42 = SCL, TP43 = SDA. This design follows the schematic and silkscreen (finding evm-tp42-is-scl) |

## D. Motherboard modification list

### D.1 Rework

| ID | Change | Procedure / check |
|---|---|---|
| PM0 | **Capture CR (4-layer, double-sided under the bottom clearance rule of A.7) and EIB in KiCad from B.8 and A.7/A.8** (**superseded in r8:** double-sided outside the bottom keep-out; the named bottom keep-out retired in r7), run ERC/DRC, generate Gerbers and drill files (pick-and-place optional: hand assembly). **r6 (finding cr-coordinate-convention-mirror-ambiguity): do not hand-enter the 22 header holes.** Import `references/Scale Car Board PCB 20260625.brd` into KiCad (its Eagle importer converts the y axis), copy the imported CHG/AG105 footprint with its pad names into the CR as the header footprint and place every other CR part relative to it; the A.8 "enter y as -y" rule then applies only to the added W/F/U101/J101 coordinates. Add pin-1 / pin-11 markers to the silkscreen; the outline chamfer is at (17.70, 76.00), below (**superseded in r8:** Add the A.7 pin-11 corner chamfer to the outline). **r7:** capture the CR on the r7 outline of A.7 (H.23(a)). The r7 outline is the r6 rectangle (x 17.70-48.70, y 34.14-67.14) plus tab X (x 48.70-65.00, y 56.30-68.30) and tab Y (x 17.70-37.56, y 67.14-76.00): 1394.06 mm² gross, bounding box 47.30 x 41.86 mm. Put the 1.0 mm x 45 degree chamfer at the tab Y -x/+y corner (17.70, 76.00), on the pin-11 side; it is the only chamfered corner. The r6 chamfer corner (17.70, 67.14) becomes a point on the straight left edge. Give the three concave corners (48.70, 56.30), (48.70, 67.14) and (37.56, 67.14) the fab's minimum inside-corner router radius (TODO(verify: MS8)). Split the tap field per A.4 and H.23(g): F01-F07, F11-F21, F23, F24 and R175 on tab X; F08, F09, F10 and F22 on the footprint low row y 35.80 (x 26.44, 28.98, 31.52, 41.68). Put R175 and the 0.1 % divider resistors R109, R110, R111, R112, R114, R115 on the top; C106, C107, C108 and C140 stay on the bottom (A.8; top 73.55 %, bottom 69.04 %, H.23(e)). Keep both foot keep-outs free on the bottom (H.23(i)): FT1 x 59.220-64.220, y 65.405-68.005 with its RTV lane to the tab X top edge (y 68.005-68.300); FT2 x 25.500-30.500, y 70.750-75.750, no lane. Drill the FT2 fill hole, 1.0 mm NPTH at (28.00, 73.250), with a 2.0 mm copper and part keep-out disc on the CR top. Run the bottom DRC with the bottom clearance rule on the footprint and on both tabs. Measure the rule from the `.brd` layer-1 copper rims (polygon outline width and 0.7564 mm via pads included). Apply the thermal band content rule of A.7 on tab X | Gate before PM4: T-A-06 (step 0 pin identity by script and by punch-through print; netlist diff against B.8 = zero; placement DRC on the r7 outline (**superseded in r8:** on the 31 x 33 mm outline); 1:1 print of the hole pattern and the assembled placement over the bare CHG footprint (r7: and over both tabs); dry fit of both tabs and both feet; no spacer, the TSW body seats on the sheet, H.23(j) (**superseded in r8:** spacer dry fit)). **r7:** T-A-08 (the pre-capture survey MS1-MS8; its MS1a part is taken before PM1 and gates nothing (D-H), and its MS6 reading at the CHG holes gates PM4) gates PM0 (**superseded in r8:** its MS1a part gates PM1); a tab trim re-runs `round4/calc/r7_calc.py`. T-A-06 adds the bottom-clearance-rule overlay on the `.brd` copper rims, the print of the r7 sheet outline with its trims and the chamfer check at (17.70, 76.00) |
| PM1 | **Remove the Ag105 (CHG)** | Pack unplugged at J-BT, all supplies off, VBUS/V-MOT discharged (< 1 V on C-D2 and CAL). Desolder all 22 pins (1.1 mm holes) with a vacuum station; protect CO-5V (0.1 mm away) and OP-FC with Kapton. Inspect D-BT-SQ, C-D11, C-D12, C-DC11, C-DC12 under the footprint. **Do it only after the T-B and T-C gates pass on the bench** (study condition 13). **r7:** record MS1a first (`docs/reviews/battery_isolation_2026-11-07/detailed_design_IC1.md` section 15.2): the Ag105 standoff at the four corners and the module top height above the MB (T-A-08). The module must be in place for this reading, so it comes before the removal; it has no pass/fail (D-H). (**superseded in r7 (D-H):** 'gate D-2, unchanged' and 'MS1a decides the r7 stack top, >= 12.265 mm plus the cable, against the nominal 13.14 mm Ag105 envelope (H.23(j))'.) After the removal, weigh the module and record the mass as MS1b (T-A-08; it gates nothing). Before PM4, measure the MB thickness at the empty CHG holes by caliper (MS6, T-A-08) |
| PM2 | **Replace C-D8 and C-D10** (GRM21BZ71E106KE15L, 10 uF 25 V, **0805 footprint CAPC2012**) with 10 uF >= 35 V 0805 (candidate GRM21BR6YA106KE43L; T-A-04) | Inrush in H.6 uses 20 uF nominal; a lower effective value only lowers the inrush |
| PM3 | **Fit R170 and R171** (10.0 kOhm 0.1 % 0805): one end soldered to C-D6 pad 1 (R170) and C-D2 pad 1 (R171), the T1/T2 wires soldered to the free ends, Kapton over each | Every divider tap is then high-impedance at the source. **r7:** C-D2 pad 1 lies outside tab X: the C-D2 box is 2.181 mm and the R171/T2 joint 3.118 mm from the tab X right edge (H.23(b)) (**superseded in r7:** "the C-D2 box is 3.64 mm from the FT1 body, H.23(i); orient R171 and the T2 wire away from tab X"). Point the R171 body toward +y, away from tab X and from C-D2 pad 2. Do not lay R171 across C-D2. Run the T2 wire from F03 (50.80, 66.56) into the gap y 65.29 and along it to x 64.77. Then run it over the tab X right edge to the R171 free end (20.7 mm dressed, A.4). Do not route the T2 wire under the tab overhang. Record the R171 position and height. Before PM4, confirm in the T-A-06 item (8) tab dry fit that R171 is clear of tab X |
| PM4 | **Bond the polyimide sheet, then fit CR** (r4 ordered procedure, finding pm4-header-solder-sequence-ambiguous; r5 finding pm4-header-solder-sequence-ambiguous-reopen): **(1a) (r6) only if T-A-06c found the MB VBT path thinner than 1 oz, or the operator rules for margin: scrape the solder mask along x 34.8, y 31.75-48.65 and across the D-BT-SQ VOUT pour neck and solder a 0.5 mm tinned-copper overlay (BOM line "Overlay wire"), finished height <= 0.8 mm so the A.7 >= 1.5 mm air rule under the header body still holds; re-measure per T-A-06c; (1b) (r6) bond a fine type-K thermocouple to the MB VBT trace at about (34.8, 41) with Kapton, lead out under the CR's low-y edge at y ~34 (read in T-F-16);** (1) bond the polyimide sheet of A.7 (0.125 mm, silicone adhesive, the r7 sheet outline of A.7, that is the r7 outline + 1 mm trimmed to >= 0.5 mm from the CO-5V, J-NTC, L-FC, OP-FC and ROP1-FC bodies and pads, bounding box 49.30 x 43.86 mm, H.23(m) (**superseded in r8:** CR outline + 1 mm; the r6 outline + 1 mm overlapped the CO-5V body by 0.400 x 3.700 mm), 2.2 mm relief holes at the 22 header pads, cut-outs over D-BT-SQ, C-D11, C-D12, C-DC11, C-DC12 (**r7 review 7 close:** each cut to its part body joined with its own pads + 0.5 mm, in two openings, A.7)) on the MB; (2) insert the 1x10 and the 1x12 strip into the CR from its **bottom** side, each on its own column, plastic body against the CR underside, and solder the 22 joints **at the CR top**; **(2b) (r5) insert W1-W4 from the CR top, fully inserted with no splayed strands, and solder them; trim the underside protrusion, fillet included, to <= 0.5 mm; measure each of the four with calipers or a height gauge against the CR bottom copper, check under a loupe that no strand end stands proud, and record the four values; **(r8)** bond the B1R wedge to the CR top with the 0.05 mm transfer tape inside its A.3 footprint (x 23.55-26.05, y 62.54-67.10), ramp face toward +y; lay W1 and W2 on the ramp face; apply the A.3 adhesive strain relief over >= 5.0 mm of each W1-W4 jacket from its joint, continued on the ramp face for W1 and W2 (H.23(s)); in (3c), keep the weight clear of B1R (**superseded in r8:** apply the A.3 adhesive strain relief). From here on the CR is handled with the W1-W4 leads attached: W1/W2 at the fixed 0.30 m +- 10 mm; W3/W4 at the 0.30 m cap until MS2 and at their A.3 route maxima after it (**superseded in r8:** with the 0.30 m leads attached (r7: the W1-W4 leads at their A.3 build maxima, that is the 0.30 m caps until MS2 and the route-rule maxima after it)). This is the last point at which the W1-W4 underside can be reached: after (3) it sits one header body (2.54 mm) above the sheet, 6-17 mm inside the outline, behind the 1x12 body, where no cutter fits;** **(2c) (r7) tape the two feet to the CR underside (A.7, H.23(i)).** (**superseded in r7:** an RTV bond cured before (3) and h_f 2.24 mm.) Use foot blocks of h_f 2.19 mm (+0/-0.05 mm). **(r8)** If the T-A-09 step 0 bond coupon failed, cut the sheet under each foot within its A.7 foot keep-out before this step. Measure the thickness of the removed sheet stack, film and PSA together, with a micrometer to +-0.01 mm, and record it as t_rm. Remove any PSA residue from the mask inside the cut-out with isopropyl alcohol, and let it dry (r8). At those feet, use re-made foot blocks of h_f' = 2.19 mm + t_rm (+0/-0.05 mm) (A.7, H.23(r)). Measure each block height and record it. Apply 0.05 mm acrylic transfer tape to the top face of each foot. Punch a hole of >= 1.5 mm in the FT2 tape, centred on the foot hole. Place FT1 inside its bottom-silkscreen outline under tab X, long axis along x. Pass a 0.9-1.0 mm pin through the CR fill hole into the FT2 hole. Press FT2 onto the CR inside its outline, then remove the pin. Look into the fill hole from the CR top and make sure that light passes. Measure with calipers the FT1 top and right edges to the tab X top and right edges. Measure the FT2 +y edge to the tab Y +y edge. Record the three values. If a value is out of its limit, remove the foot and tape it again. Keep the W1-W4 leads clear of tab X and of the FT1 lane until (6). Their joints stay in (2b); only their dressing waits;** **(2d) (r7) dry-seat gate, before any MB joint (A.7, H.23(i)).** Seat the CR in the MB holes without solder, on the (3a)-(3d) fixture. Press both header bodies against the sheet. Try a 0.05 mm feeler at both ends of each header body. Try 0.15 mm and 0.45 mm feelers under each foot. Reach FT1 from the tab X +y edge, across its 0.795 mm overhang. Reach FT2 from its -y, -x and +x sides. Record the readings. If a check fails, remove the foot, correct its height, then repeat (2c) and (2d);** (3) seat the CR assembly into the MB holes (plastic body resting on the sheet) and solder the 22 joints **at the MB bottom**, **(r7) in this order** (**superseded in r7:** loose props that touch the CR without lifting it, with no fixture and no check)**: (3a) support the MB top side up on standoffs, with >= 15 mm of clear access under the CHG footprint; (3b) seat the CR assembly into the 22 MB holes, header bodies on the sheet; (3c) put a 50-100 g weight or a soft clamp on the CR over both header columns, never on a tab; (3d) restrain the W1-W4 leads so that they do not pull on the CR; (3e) if a tab needs support, rest its tip on a loose FR-4 or PTFE shim, never on a foot spot; (3f) repeat the (2d) feeler checks; (3g) solder two diagonal corner pins at the MB bottom (pin 1 and pin 11, or pin 10 and pin 22); (3h) repeat the (2d) feeler checks; if a check fails, desolder the two pins and re-seat; (3i) solder the other 20 joints. No adhesive is wet during soldering**; (4) cut the MB-bottom tails to <= min(1.0 mm, MS2 under-MB clearance - 0.5 mm) (T-A-08) (**superseded in r8:** to <= 1.0 mm (or less if the chassis clearance under the MB requires it, measured in T-A-06)) (r7: the MB-bottom protrusion is 4.115 mm before the cut, H.23(j)); the W1-W4 tails were trimmed and measured in (2b) and are not reachable after (3) (the header pins leave no tail on the CR underside: the body sits there; 0.5 mm tails leave >= 2.0 mm of air above the sheet, A.7). Post length = MB 1.6 mm + body 2.54 mm + CR 1.6 mm + top fillet; the TSW post option is chosen in T-A-05 so the CR-top protrusion is >= 0.5 mm for a fillet. **r7:** with the sheet, the TSW-1xx-07 post leaves a 0.940 mm CR-top protrusion (H.23(j); MB and CR 1.6 mm assumed, TODO(measure: MS6)). **(5) (r7)** remove the shims and the weight. Inspect the 22 MB joints under a loupe. Bed FT1 through its RTV lane at the tab X top edge (x 59.220-64.220, y 68.005-68.300). Stop when RTV shows along the FT1 -y and +x faces, sighted from the tab X tip. Seat a 21-22 G blunt needle (OD <= 0.82 mm) in the FT2 fill hole from the CR top. Inject until RTV appears at the FT2 -y, -x and +x faces. Use the flowable alkoxy-cure bed RTV of E only. Cure the beds for the datasheet through-cure time of a 2.0 mm path, and for at least 24 h. (**superseded in r7:** any neutral-cure RTV, and the note "the bed is 0.30 +- 0.15 mm thick and carries no preload"; (2d) now sets and checks the bed gap.) **(6) (r7; r8 riser and stack)** After the cure and T-A-09, dress the leads in this order (A.3). Cover the CR-top tips of pins 7-10 with a dome of the BOM RTV or a Kapton patch. Let an RTV dome cure. Solder W7, and W6 if an NTC is fitted (A.3). Inspect each tie-base zone (A1, A2: the base +- 1.5 mm) for unrecorded parts, wires and bodges. When a zone is clear, bond its tie base on the MB solder mask at the A.3 centre. Lay the polyimide strip along the A.3 path and stop it at each tie-base footprint. Bond the B3 post on the CR top so that the trunk jacket bottom sits 10.7 mm above the CR top (A.3, H.23(s)). Dress W1-W4, W6 and W7 along the A.3 trunk and group paths, never over tab X. Keep every jacket >= 2 mm in plan from the pin-10 joint, the IN strip, the U101 courtyard, the +x pocket and the tap pads. Lay the trunk on the B1R ramp face from the toe to the apex, then on the B3 post. Bind the trunk leads into one round bundle with RTV and bond the bundle to the ramp face from the toe to the apex (r8, A.3 lateral support). Bond the W6 and W7 jackets with RTV over >= 5.0 mm from each joint. Fit the off-CR support of A.3 so that the trunk follows the A.3 profile off the CR. Mate W5 and dress it along its A.3 path on S1 and S2 at the 8 mm fold. From (28.70, 64.01) to A1, lay W5 on top of the trunk and bond it to the trunk with RTV. Do not put a trunk lead above W5 (H.23(t)). Apply the bead on the B3/S3 union spot over both runs, and the beads S1 and S2. Strap each group to A1 and A2. Fit the W1, W2, W6 and W7 chassis tie <= 2.4 mm past the MB +y edge. Fit the W3/W4 tie <= 16.4 mm and the W5 tie <= 17.4 mm past it. Dress the W1/W2 and W5 slack as service loops anchored on the EVM plate. Then solder the taps (PM6) (**superseded in r8:** (6) (r7) after the cure and T-A-09, dress W1-W4 over tab X toward the MB +y edge (A.3). Mate W5 and dress it per A.3, clear of the tap pads. Then solder W6, W7 and the taps (PM6) (superseded in r7: the following dressing order of the A.3 r7 review 7 note, D-F2). Cover the CR-top tips of pins 7-10 with a dome of the BOM RTV or a Kapton patch. Let an RTV dome cure. Solder W7, and W6 if an NTC is fitted (A.3). Inspect each tie-base zone (A1, A2: the base +- 1.5 mm) for unrecorded parts, wires and bodges. When a zone is clear, bond its tie base on the MB solder mask at the A.3 centre. Lay the polyimide strip along the A.3 path and stop it at each tie-base footprint. Dress W1-W4, W6 and W7 along the A.3 trunk and group paths, never over tab X. Keep every jacket >= 2 mm in plan from the pin-10 joint, the IN strip, the U101 courtyard, the +x pocket and the tap pads. Mate W5 and dress it along its A.3 path on the spacers S1-S3. Apply the beads B1, B3 and S1-S3, and strap each group to A1 and A2. (r7 review 7 close, 3-D switched-conductor rule, A.3): Set the B1 and B3 spacer posts so that the trunk jacket bottom is >= 10.14 mm above the CR top. Set S2 and S3 so that the W5 ribbon bottom is >= 10.735 mm above the CR top. Keep S1 at the 8 mm fold. Fit the off-CR support of A.3 so that both runs follow the H.23(l) profile between x 37.75 and 46.7. Fit the W1, W2, W6 and W7 chassis tie <= 2.4 mm past the MB +y edge. Fit the W3/W4 tie <= 16.4 mm and the W5 tie <= 17.4 mm past it. Dress the W1/W2 and W5 slack as service loops anchored on the EVM plate. Then solder the taps (PM6)) | (2b) the four recorded W1-W4 underside heights <= 0.5 mm incl. fillet (rework before (3) if not). **r7:** (2c) block height 2.14-2.19 mm (**r8:** a re-made foot h_f' - 0.05 mm to h_f', with h_f' = 2.19 mm + the measured t_rm, H.23(r)); FT1 top edge to the tab X top edge 0.501-1.089 mm; FT1 right edge to the tab X right edge 0.976-1.584 mm; FT2 +y edge to the tab Y +y edge 0.500-1.000 mm (the A.7 placement tolerance, H.23(i)); light through the fill hole; fail: re-tape. (2d), and (3f)/(3h): the 0.05 mm feeler does not enter under either header body at either end; at each foot the 0.15 mm feeler enters and the 0.45 mm feeler does not (H.23(i)); fail: re-make the foot (2d) or re-seat (3). (5) no cracked or lifted joint under the loupe before the beds; the RTV witness at the FT1 -y and +x faces and at the FT2 -y, -x and +x faces; after the cure, T-A-09 (cure probe, feeler 0.05 mm at the FT1 interfaces, FT2 witness fillets, sheet-to-mask feeler, 0.4 N pull at each grip for 10 s, joint resistance unchanged; **superseded in r7:** feeler at both interfaces of both beds and a 5 N tab-tip pull). Fail: re-bed through the FT1 lane or the FT2 fill hole. **(r8)** The sheet cut-out fallback of A.7 is executable only before the 22 joints are soldered (H.23(r)), so the T-A-09 step 0 bond coupon decides it before (1). The cut-out lies within the foot keep-out coordinates, never sized to an as-found foot, so the MPPT-DISABLE trace stays covered (H.23(i)), and the foot is re-made at h_f + t_rm. A bond to polyimide that fails after soldering: desolder the CR before the fallback (A.7) (**superseded in r8:** Fail: re-bed; if the RTV does not hold on polyimide, use the sheet cut-out fallback of A.7.) After (4): continuity CR VCHGIN to C-D8, CR VCHG to C-D11, CR GND to J1.01; VCHG-IN-to-GND resistance and no exposed VCHG-IN copper within 2 mm of GND or chassis (T-F-12). **r7 (D-F2):** after (6), the pin 7-10 covers are intact; every W lead lies on the A.3 path, >= 2 mm in plan from the pin-10 joint, the IN strip, the U101 courtyard, the +x pocket, the post tips and the tap pads (W5 exceptions of A.3 only); every anchor is in place (T-F-12); **r7 review 7 close:** every jacket-bottom height meets the A.3 3-D rule at its controlling points, and every chassis tie is within its A.3 limit (T-F-12); **r8:** the trunk meets the B1R / B3 profile at every T-F-12 check point, no trunk lead lies above W5 at any point of the overlap, W5 is in contact with the trunk and bonded to it from (28.70, 64.01) to A1 (**superseded in r8:** "W5 lies on top of the trunk over the whole overlap"), and the W1/W2 bead covers >= 5.0 mm of jacket from each joint (A.3, H.23(s), H.23(t)) |
| PM5 | **Deleted (r2): no W8.** The pad-10 pin alone carries the input current (T-A-05 requires >= 3 A). Conditional fallback only per A.3 W8 (fused at the C-D8 end) | Finding w8-unfused-hot-lead |
| PM6 | **Taps** per A.4: T1/T2 to R170/R171, T7b to C-D6 pad 2 (shield, insulated at that end), T9 to the SNS-BT GND/REF1 pad (or nearest via), T20 to ROS pad 2 (PM10), T22 to BQ29200 pin 8 (PM11, r6), the rest into J1/J2 with single male pins; no T7. **r7:** the tab X field carries 20 pads (F01-F07, F11-F21, F23, F24) and R175 at the H.23(g) centres. T22, T8, T9 and T18 land on F08, F09, F10 and F22 on the footprint low row y 35.80. Fit the tap wires only after the PM4 (5) beds have cured. Dress each tab X wire on the A.4 gap path. Lead the wire from its pad into the adjacent inter-row gap. Run it toward +x in that gap to x 64.77. Then turn it to its MB point. Never dress a wire across the REG-5V box (x 50.97-62.31, y 36.87-54.51), CO-5V, a header post or a neighbouring pad. Keep the stripped length of each wire on its own pad. Dress T8 from F09 toward +y to y 37.55, then along y 37.55 to x 43.43. Dress it down to y 34.64, then along y 34.64 to x 63.50 (the A.4 upper lane). (**superseded in r7:** the low-edge lane y 34.40, which calc revision 4 found infeasible.) (**superseded in r7:** "Dress each tab X wire toward +y in the inter-row gaps until x > 63 ... T1, T7b and T5 need this dressing".) After the taps, before the first power-up, do the r7 T-F-12 tap-to-tap check and the loupe check of every 1.04 mm pad gap. The 20 straight lengths sum to 859.3 mm and the dressed lengths to 898.7 mm (**superseded in r7:** 895.5 mm) (r6 1308.0 mm, -34.3 %, H.23(g); **superseded in r7:** 850.9 mm, -34.9 %); the A.4 maxima stay the upper bounds | T-A-01, T-A-01b and T-A-01c first. **r7:** the tap pads F20 (T20) and F21 (T21) lie over the FT1 body (H.23(g)): solder them last, <= 350 C and <= 3 s per joint; then repeat T-A-09 on FT1 |
| PM7 | **T18 (keep-alive) only if T-B-09 fails**, and then always behind **F101 (0603 fast fuse, ~50 mA class) + R172 33 ohm 1206** in series, soldered at CO-5V pad 1 with Kapton over them (r4); T19 only with the U117 option; else leave the DNP parts unpopulated. **r7:** the T18 CR end is F22 at (41.68, 35.80) on the footprint low row, 10.54 mm straight to CO-5V pad 1 (H.23(g)). The CO-5V pad 1 joint sits 0.172 mm from the REG-5V box, so T-A-05 adds a temperature-derating check of F101 and R172 there | A shorted T18 would otherwise put the LM1084 (the Teensy supply) into current limit through 26 AWG (finding t18-5v-tap-unprotected); the r3 10 ohm 0805 would have dissipated 2.5 W in that short (finding r172-0805-short-dissipation): now 152 mA until F101 opens (H.20) |
| PM8 | **No trace cuts.** No change to D-BT-SQ in the baseline. Replacing D-BT-SQ is fallback 2 only, and then **only by the fused link of B.5** (C-D12 pad 1 to C-D11 pad 1), never a 0 ohm bridge, after T-A-05c (r5). C-DC4 (D-BT-EN soft-start) stays 5.6 nF unless the operator rules lever 3(i) (F.4) | - |
| PM9 | **RSDA and RSCL 10 kOhm -> 2.7 kOhm 1 % 0603** (MB, at (112.5, 70.4) and (112.5, 73.9) mm) (r2) | The I2C pull-ups then sit on the MB 3V3 (the Teensy's own rail) only, so I2C neither depends on nor feeds the carrier rail; net Rp 2.7 kOhm, 1.07 mA sink at 0.4 V, Cb limit 131 pF for 300 ns (H.16); T-C-06 scopes tr (finding cr-3v3-single-tap-backpower) |
| PM11 | **(r6) BQ29200 OUT tap T22** (finding vreg-corruption-no-fixed-pack-ovp): pack unplugged at J-BT and J-BL. Under magnification, tin the exposed outer toe of BAL pad 8 (board (25.86, 30.44); 0.35 mm wide, 0.65 mm pitch to pin 7 VDD) and solder a 30 AWG Kynar wire to it, leaving pin 7 untouched; a dot of the BOM RTV over the joint and the first 5 mm of jacket, Kapton over the package; route the wire to F08 (<= 0.05 m) along the MB, away from the VBAL+ trace (y 32.77) | T-A-01c first (pad access, J-BL plugged on the vehicle); after fitting, DMM: T22 to pin 7 VDD > 1 MOhm (bridge check; a bridge reads OV permanently, safe but blocks charging), T22 to GND reads the OUT low state (< 0.2 V with the balance lead plugged); T-F-17 on the vehicle in T-F |
| PM10 | **Remove MB ROS** (0603, 100 ohm in the `.sch`, 160 ohm in the BOM; at (81.5, 70.6) mm) and land T20 on **ROS pad 2** (net N$21 = Teensy pin 7 only) (r2) | Isolates pin 7 from the retired ENC-EN net whatever that net now carries after the 2026-08-16 bodge; pin 7 then has no pull-up, so the U204 readback fails LOW. T-A-01b first records whether ROS is still fitted and what ENC-EN carries (if ENC-EN is tied to 5 V with ROS fitted, pin 7 is being back-driven today: report it as a finding in its own right). Recorded as a bodge (D.4) |

### D.2 Firmware-visible pin changes

Pin 5 changes meaning (MPPT_DISABLE LOW = Ag105 MPPT inhibited -> CHG_ARM LOW = BQ25798 charge inhibited); both are LOW =
safe, so the boot level in `setup()` stays LOW. Pin 6 polarity inverts (Ag105 HIGH = charging -> BQ25798 LOW = charging,
SLUSDV2C Table 7-11). **Pin 7** (was ENC_ENABLE, undriven since 2026-08-16) becomes the /CE far-end readback input
(`INPUT_PULLDOWN`, no pull-up on its net after PM10); pin 8 and its encoder net are not touched (r2); pin 21 becomes the
heartbeat output. Readback pins 7, 16, 23, 33, 34 are `INPUT_PULLDOWN`.
**r6 (finding fcc-rgn-lvc-threshold-vs-rt1987-en-band):** every RT1987 EN pin (27, 28, 29, 30, 31, 32) is a driven `OUTPUT` from early in
`setup()`, never `INPUT_PULLUP` and never left with a pad keeper; FR-49 reads each pad's IOMUXC setting at boot and refuses charger
arming on a mismatch.
**The EVM must not be connected until the CSV is amended and firmware with the new pin map is flashed** (fw v37 State 98 `4`
toggles pin 5 raw; study §2.8).

### D.3 IO CSV amendments (`references/Scale Car Teensy IO - IO.csv`; the CSV is authoritative, amend it first)

Replace rows 5, 6, 7, 19, 31; **r6: amend the Notes of rows 27, 29, 32 (never `INPUT_PULLUP`; finding fcc-rgn-lvc-threshold-vs-rt1987-en-band) and replace the r5 texts of rows 30, 31 below**; **amend the Notes of rows 28, 30, 41 (r5, finding csv-rows-28-30-41-carrier-taps-unrecorded: the carrier now loads those nets and row 28 carries a pad-setting safety rule)**; add rows 10, 16, 17, 20, 21, 22, 23, 33, 34, 35 (exact text; r2: the /CE readback is row 7, not row 8; r3: row 20 reserved and the row 19 note, finding csv-pin20-reservation-missing):

```
5,Output,Digital,Charger arm (BQ25798 /CE through the CHG carrier),CHG_ARM,"HIGH = charging allowed (carrier ANDs it with the heartbeat; EIB U201 pulls /CE LOW). LOW or high-Z = inhibited (47 kOhm pull-down on the carrier). Was MPPT_DISABLE (Ag105 removed)"
6,Input,Digital,Charger status (BQ25798 STAT),CHARGER_STAT,"Open drain: LOW = charging, HIGH = complete/disabled/HIZ, 1 Hz blink = fault (SLUSDV2C Table 7-11). 10 kOhm pull-up to 3V3 on the carrier; 1.00 kOhm in series at the EIB (STAT LOW reads ~0.31 V). Plausibility-checked against REG1C CHG_STAT and CHG_ARM (FR-44)"
7,Input,Digital,Charger /CE far-end readback,CHG_CE_RB,"HIGH = /CE HIGH at the EVM pin (charging inhibited). From a comparator on the EIB via the vacated MB ROS pad 2 (ROS removed; ENC_ENABLE retired 2026-08-16). INPUT_PULLDOWN, no pull-up on the net: a dead source reads LOW = /CE LOW. Evaluated only while regnExpected (REGN present or due; FR-23)"
10,Output,Digital,Charger input-qualification trigger,CHG_QUAL,"Rising edge starts a 0.20-0.46 s hardware one-shot that releases ILIM_HIZ only while FC_CHARGE is LOW; cleared while CHG_ARM is HIGH. Raise only after EN_CHG = 0 is read back; LOW whenever CHG_ARM changes. 47 kOhm pull-down"
16,Input,Digital,Charger FC-window permit readback,CHG_H2_RB,"H2c = FC_CHARGE AND BTB_OFF AND BT_OK AND FCI_OK (= 1 unless the U117 option is fitted) AND ((UVB AND CHG_FCCEIL) OR (H1 AND REGEN_ENABLE)); FC_CHARGE and REGEN_ENABLE are read by comparators as on only above 1.75-1.88 V (r6). INPUT_PULLDOWN"
17,Output,Digital,Charger FC ceiling confirmed,CHG_FCCEIL,"HIGH only while the BQ25798 IINDPM/ICHG registers hold verified FC-window values. LOW blanks the converter in an FC window whenever V-MOT is not above 1.089 x VBUS with REGEN on. 47 kOhm pull-down"
19,Communication,I2C,SCL,SCL,"Used for battery charger (BQ25798 on the EVM, I2C 0x6B; MB RSDA/RSCL 2.7 kOhm). Never route WDOG1_B here (AD_B1_00 ALT4): WDOG1_B goes to pin 20 only"
20,Reserved,Digital,MCU watchdog output (WDOG1_B; R5 future work),WDOG1_B_RSVD,"Do not assign. WDOG1_B is routed only here (AD_B1_10 ALT1); never to pin 19 (SCL) or pin 34 (CHG_H1_RB). Left unconfigured until the R5 watchdog lands"
21,Output,Digital,Charger heartbeat,CHG_HB,"Completion token: toggle only from the 1 kHz monitor tick after the FR-08 evaluation, the timed detectFaults() checks and a fresh ADC set have all completed; never from an ISR or once per loop(). No rising edge for TW_HB (20-46 ms, set by T-C-10) drops the charge enable and holds ILIM_HIZ in hardware. 100 kOhm pull-down"
22,Input,Analog,Charger input current (eFuse IMON),CHG_IIN,"TPS26630 IMON 27.9 uA/A into 27.4 kOhm = 0.764 V/A; 10 kOhm + 1 nF to the pin. pinMode INPUT_DISABLE (pad keeper off) before the first analogRead: 37 kOhm source, 1 uA of keeper current = 49 mA error"
23,Input,Digital,BT boost current below the FC-window threshold,CHG_BTOK_RB,"HIGH = INA253 BT output below 19.75 mV (0.06-0.34 A worst case). INPUT_PULLDOWN"
27,Output,Digital,Fuel cell bus enable,FC_BUS_ENABLE,"Allow fuel cell regulator to contribute to Vbus. Driven OUTPUT LOW early in setup(); never INPUT_PULLUP, never a pad keeper (RT1987 EN may turn on anywhere up to 1.4 V)"
28,Output,Digital,Battery bus enable,BT_BUS_ENABLE,"Allow battery regulator to contribute to Vbus. EN net also read by the CHG carrier U115 BTB_OFF comparator (R120 10 kOhm, R119 10 MOhm pull-up to 3V3). Never INPUT_PULLUP (that lifts the EN net to ~1.02 V, inside the RT1987 enable band). LOW is the FC-window loop barrier; never HIGH together with FC_CHARGE_ENABLE"
29,Output,Digital,Motor power enable,MOT_PWR_ENABLE,"Allow power to flow to VESC / motor. Driven OUTPUT early in setup(); never INPUT_PULLUP, never a pad keeper (RT1987 EN band up to 1.4 V)"
30,Output,Digital,Regen charging enable,REGEN_ENABLE,"Allow regen power to flow to the battery charger. Also read by the CHG carrier RGN_ON comparator (R121 1 kOhm, divider 453k/1.00M, trip 1.75-1.88 V; R133 100 kOhm pull-down). Held HIGH through Run in the always-powered regen design (operator ruling 2026-11-05). Never INPUT_PULLUP, never a pad keeper (~0.95 V, inside the RT1987 enable band)"
31,Output,Digital,Fuel cell charging enable,FC_CHARGE_ENABLE,"Allow Vbus (fuel cell) to flow to the battery charger. BT_BUS_ENABLE *must* be off before this is turned on, and the two are never on together. REGEN_ENABLE MAY stay on (operator ruling 2026-11-05, R7); requires the BQ25798 carrier permit logic (FCC_OFF comparator below 0.39-0.44 V, FCC_ON comparator above 1.75-1.88 V). Never INPUT_PULLUP, never a pad keeper (~1.02 V, inside the RT1987 enable band)"
32,Output,Digital,Battery sequencing enable,BT_SEQUENCE_ENABLE,"Must initialize in off state, turn on once system is powered up and does not need to be turned off after. Driven OUTPUT LOW early in setup(); never INPUT_PULLUP, never a pad keeper"
33,Input,Digital,Charger ILIM_HIZ far-end readback,CHG_ILIM_RB,"HIGH = ILIM_HIZ above 0.587-0.650 V at the EVM pin (converter may be released; below it the BQ25798 is guaranteed non-switching, VIL 0.75 V). From a comparator on the EIB; a broken sense wire reads HIGH; INPUT_PULLDOWN"
34,Input,Digital,V-MOT above bus comparator readback,CHG_H1_RB,"HIGH = V-MOT > 1.089 x VBUS (+0.30 V hysteresis). Pad GPIO_B1_13: keep it GPIO, never WDOG1_B (ALT0). INPUT_PULLDOWN"
35,Input,Digital,Charger input eFuse fault,CHG_EFUSE_FLT,"Open drain, LOW = fault. INPUT_PULLUP (the Teensy pad is the only pull-up; carrier R106 not fitted), so an open tap reads no fault and keeps the interlock monitors armed. Plausibility-checked against the charger VBUS_PRESENT_STAT"
41,Input,Analog,Battery current measurement,BT_CURRENT,"INA253 BT output; also feeds the CHG carrier U104 BT_OK comparator (R140 10 kOhm, R144 1 MOhm pull-up to 3V3) and MDAC-BT IOUT1"
```

Conditional row, only if T-E-02 adopts a purge-valve tap: `2,Input,Digital,H-20 purge valve sense,PURGE_SENSE,"Optocoupler from the H-20 purge-valve drive; LOW = valve open"`.

**r7:** the r7 carrier extension changes no Teensy pin, direction, pad setting or note, so r7 requires no IO CSV change beyond the rows above.

### D.4 CLAUDE.md bodge record (add under the never-rotated hardware records once built)

**r7:** the record stays a proposal for `CLAUDE.md` (D.5). r7 adds tab X and tab Y, the feet FT1 and FT2 with their beds and the FT2 fill hole, the r7 sheet, the EVM plate and R276. **r8:** the record adds R106s, the B1R wedge with the B3 post, the W5-on-trunk stack and the W1/W2 wire specification (D.5).

```
### Hardware bodge record (20XX-XX-XX): Ag105 removed, BQ25798EVM fitted through the CHG carrier

- The Silvertel Ag105 (`CHG`) is desoldered. A 4-layer carrier PCB (eFuse TPS26630 + output Schottky, comparators H1/UVB/BT_OK/
  BTB_OFF, permit logic, QUAL one-shot and heartbeat monostables) is soldered into the 22 CHG holes on one 1x10 and one 1x12
  header strip; a TI BQ25798EVM sits off-board on <= 0.30 m leads (input 20 AWG pair, battery 18 AWG pair, I2C twisted triple
  to EVM J8 with its GND bonded at the carrier only, 14-way ribbon to an EVM interface board (r7: on the EVM plate with the EVM) that drives /CE and
  ILIM_HIZ from REGN and senses both at the EVM pins).
- C-D8 and C-D10 are 10 uF >= 35 V 0805 (were 25 V GRM21BZ71E106KE15L).
- MB RSDA/RSCL are 2.7 kOhm (were 10 kOhm). MB ROS is removed; Teensy pin 7 (ex ENC_ENABLE) is the /CE readback, tapped at ROS
  pad 2. Pin 8, RENC2 and the encoder nets are untouched. Teensy pin 20 is reserved for WDOG1_B.
- A 0.125 mm polyimide sheet is bonded on the MB under the carrier; every carrier tail is flush-cut to <= 0.5 mm; the carrier
  taps are top-side SMT pads, and its bottom carries passives only (<= 1.0 mm), >= 1.0 mm in plan from every non-GND MB
  layer-1 feature and every MB part box (the bottom clearance rule), on the footprint and both tabs (superseded in r7: outside
  the MB VBT / VCHG / VCHG-IN copper).
- The signal ribbon is a 1.27 mm-pitch 14-way cable assembly, keyed (shrouded pair, or J101 position 6 omitted with a plug),
  pin-1 marks at both ends; conductor 9 is GND and 10 RFC_OFF; STAT has a 1.00 kOhm series resistor (R275) on the EVM interface
  board (the EIB E-pad row is E8 - E3 E4 E2 - E7 - E1 - E5 E6, top to bottom, r6). Carrier power holes W1/W2 at (30.3/27.7, 61.2); their underside tails were trimmed before seating. The carrier 3V3 feed has R175 68 ohm and each ribbon 3V3
  conductor 200 ohm in series. The carrier eFuse U101 is rotated (IN edge toward the board centre) and its input bulk is 100 V.
- r6: BQ29200 (BAL) pin 8 OUT (net BAL-NOK, an orphan until now) is tapped with a 30 AWG wire to the carrier (T22) and gates the
  charger in hardware (cell > 4.35 V for 1.6-4.9 s, an open tap or an unplugged balance lead -> /CE HIGH and ILIM_HIZ held); there is
  still no firmware BAL-NOK input. Charging needs the balance lead (J-BL) plugged. The carrier reads the pin-30/31 EN nets through
  comparators (FCC_OFF < 0.39-0.44 V, FCC_ON / RGN_ON > 1.75-1.88 V); every RT1987 EN pin is a driven output, never INPUT_PULLUP.
  The carrier outline has a chamfer at the pin-11 corner (r7: at the tab Y -x/+y corner (17.70, 76.00), still on the
  pin-11 side); carrier coordinates are Eagle (+y up). A thermocouple sits under the
  polyimide sheet on the MB VBT trace [and the trace carries a 0.5 mm tinned-copper overlay: yes | no, T-A-06c].
- r7: the carrier extends past the CHG footprint by tab X (x 48.70-65.00, y 56.30-68.30, toward the Teensy) and tab Y
  (x 17.70-37.56, y 67.14-76.00, toward L-FC); no MB part lies under either tab. Two PA66/PBT feet carry the tab ends:
  FT1 4.0 x 1.6 mm at (61.72, 66.705) and FT2 4.0 x 4.0 mm at (28.00, 73.250). Each foot (h_f 2.19 mm) is taped to the carrier with
  0.05 mm acrylic transfer tape, gap-checked dry before the 22 MB joints were soldered, and bedded on the polyimide sheet
  in a flowable alkoxy-cure RTV (nominal 0.30 mm, gated 0.15-0.45 mm) after them; FT2 is
  bedded through a 1.0 mm fill hole in tab Y. The MB solder mask is never bonded: to remove, cut the beds and peel the
  sheet. The sheet is cut to the carrier outline + 1 mm, trimmed at CO-5V, J-NTC, L-FC and ROP1-FC. Twenty tap pads
  (F01-F07, F11-F21, F23, F24) sit on tab X; T22, T8, T9 and T18 land on the footprint low row (F08, F09, F10, F22).
  The EVM rests on its stock bumpons on an insulating EVM plate under edge clamps with lateral stops (no drilling); the EVM interface
  board sits on the same plate on two M3 nylon standoffs; R276 10.0 ohm is in series with E1 at the EIB.
- Bodge parts and wires: R170/R171 10.0 kOhm at C-D6 pad 1 (V-MOT) and C-D2 pad 1 (VBUS) feeding the carrier dividers; a
  Kelvin wire from the SNS-BT GND/REF1 pad; taps into the J1/J2 breakout for the EN nets of pins 28/30/31, 3V3, BT-CURR and
  pins 10/16/17/21/22/23/33/34/35; T1 and T17 twisted with GND shields bonded at the carrier only. No W8, no trace cut.
- EVM mods per docs/charger_bq25798_wiring_design_2026-11-05.md section C (JP17, R42, R39, R40, JP32, JP7, JP30, JP14 shunt
  removed; JP14 pin 1, JP13 pin 1 and JP17 pin 2 removed; R20 removed; R21 = 0 ohm; R23 49.9k; R256/C252 across JP21 pins 1-2; R272 and
  R272b 47k /CE -> REGN on separate links; JP1/JP2 2-3, JP3 and JP5 soldered links, JP4 shunt, JP8 1-2, JP9 2-3; input caps
  >= 35 V; J2 removed, J3/J4 insulated).
- Keep-alive: [not fitted | fitted: TPS22810 + BAT54 + 680 ohm from the 5 V rail through F101 + R172 33 ohm at CO-5V, enabled by the REGEN net] (decided by T-B-09).
- Charger VREG: [8.32 V interim | 8.40 V after the BT_VOLTAGE calibration T-E-13, BT_CAL_GAIN = ...]. FC-charge windows: [disabled until the
  R5 MCU watchdog passed T-W-01 | enabled after T-W-01 on <date>].
- r8: R106s 1.00 kOhm 1 % (0402) sits between U101 FLT (pin 14) and the F17 tap pad, with R106 still DNP. A machined
  insulating wedge B1R (65 deg ramp, apex 9.78 mm above the carrier top) carries the W1-W4, W6 and W7 trunk from the W1/W2 joints, and
  an insulating post at B3 holds it 10.7 mm above the carrier top; the W5 ribbon rests on the trunk from (28.70, 64.01) on the
  footprint interior to A1. W1/W2
  are 20 AWG stranded copper, insulation OD 1.60-1.75 mm, twisted at a 20-25 mm pitch.
- IO CSV rows 5, 6, 7, 10, 16, 17, 19, 20, 21, 22, 23, 27, 28, 29, 30, 31, 32, 33, 34, 35, 41 amended in lockstep. Any rework that removes the carrier must
  revert firmware, CSV and tests together.
```

### D.5 Proposals for files this design does not edit (r7)

The r7 revision changes the carrier's mechanics, its placement map and the EVM mount. It changes no pin, threshold, timing or firmware requirement (G). The following table gives the r7 proposal for each file that this design does not edit.

| File | r7 proposal |
|---|---|
| `CLAUDE.md` | No change beyond the D.4 bodge record. The record gains the r7 items (tab X, tab Y, FT1/FT2 with their beds, the FT2 fill hole, the r7 sheet, the EVM plate, R276) and is added under the never-rotated hardware records once the carrier is built |
| `teensy_controller/teensy_controller.ino` | No change: r7 changes no pin, direction, threshold or timing |
| `WORK_QUEUE.md` | One queue item for the operator measurements MS1-MS8 with their gates (text below) |
| `references/Scale Car Teensy IO - IO.csv` | No change (D.3) |

The proposed `WORK_QUEUE.md` item is:

```
- BQ25798EVM carrier r7: operator measurements MS1-MS8 (docs/charger_bq25798_wiring_design_2026-11-05.md, T-A-08).
  Order: MS1a (Ag105 standoff at four corners, module top height; information, no gate) before PM1; MS1b (module mass) after
  PM1, information only. MS2-MS5 and MS7 before PM0; MS6 MB thickness at the board edge before PM0, at the CHG holes
  after PM1 and before PM4. MS2 enclosure and chassis room (EVM plate position, chassis-tie positions, the 45.3 mm past the MB -x
  edge for corridor fallback (i), chassis clearance under the MB, USB plug and bend) -> W-lead route maxima;
  MS3 unrecorded items inside each tab outline + 0.5 mm and under each foot spot, L-FC body -> tab outlines
  and the 3-D spacer heights;
  MS4 LM1084 thermal survey -> thermal band; MS5 vibration -> foot design (T-F-18 after the build);
  MS6 MB and CR thickness (the CR in T-A-06 step (c)) -> post arithmetic; MS7 EVM as received -> clamp design.
  MS8 fab rules (stack-up, L4 tenting, inside-corner router radius, 2 oz minimum space) before the PM0 DFM check.
  A tab trim re-runs docs/reviews/charger_eval_2026-11-05/round4/calc/r7_calc.py. Until MS2, W3, W4, W6 and W7 stay
  within 0.30 m; W1/W2 are 0.30 m +- 10 mm at every placement, and W5 is the fixed 0.30 m cable (T-A-02).
```

(**superseded in r7 (D-H):** the queue item named gate D-2 at MS1a and an MS2 lid clearance; both retire with the operator statement of 2026-11-10 that the MB and its PCBs have no maximum height.) (**superseded in r7:** 'Until MS2, every W lead stays within 0.30 m', which the fixed W1/W2 length of 0.30 m +- 10 mm exceeds by up to 10 mm, D-F3.)

**r8 proposals.** Revision r8 adds one CR part (R106s), the B1R wedge and the W1/W2 wire specification (A.3, A.4, B.4,
H.23(n), H.23(p), H.23(s)). It restates the firmware requirements FR-07/FR-46 (the T3 write-first exception), FR-12(b) (the
pin-38 criterion), FR-12(b3)/FR-22/FR-48(a) (the Idle probe, FR-23 exception EX1), FR-23 (the bounded FLT-LOW diagnostic read) and
FR-43 (separate flash and SD gates) (G.1, G.2, G.3). It changes no pin, direction or threshold of the IO CSV. The r7
proposals above stay valid; the following table adds the r8 proposal for each file.

| File | r8 proposal |
|---|---|
| `CLAUDE.md` | The D.4 bodge record gains three items once built: R106s (1.00 kOhm 1 %, U101 FLT to the F17 pad), the B1R wedge, and the W1/W2 wire (20 AWG stranded copper, insulation OD 1.60-1.75 mm, twist pitch 20-25 mm). No other change |
| `teensy_controller/teensy_controller.ino` | No edit from this design. The orchestrated firmware round that implements G.2 implements the r8 statements of FR-07/FR-46, FR-12(b), FR-22/FR-48, FR-23 and FR-43, with the host tests that G.2 and G.3 list for them |
| `WORK_QUEUE.md` | One more queue item for the r8 verifications (text below) |
| `references/Scale Car Teensy IO - IO.csv` | No change: r8 changes no pin or direction |

The proposed r8 `WORK_QUEUE.md` item is:

```
- BQ25798EVM carrier r8: open verifications (docs/charger_bq25798_wiring_design_2026-11-05.md, J.2 items 64-68).
  Sheet PSA thickness (H.23(r), the foot fallback height); eFuse IN-side current in the latched state
  (H.23(q), the FR-12(b) 12 V / 0.5 s criterion, T-C-04); Teensy 3V3 tolerance and pin-35 pull-up range (H.23(n));
  the B1R 65 deg ramp dressing at the T-A-06 dry fit (H.23(s)); the T-B-16 qualification waveform against a measured
  braking-duty statistic (J.2 item 64).
```
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
