Tangineering/DC-Balancer-Board-Teensy/docs/operations/FCHEV_PostRun_Analysis_WSL2.docx

Getting a Run Off the Pi and Plotting It

rosbag2 → Windows → WSL2 → plots

After a run, the data lives on the Pi as a rosbag2 recording. This is how you get it onto your laptop and turn it into figures. Everything here happens after the experiment — nothing in this document touches the car.

# One-time setup

Do this once per laptop. The plotting runs inside WSL2, not PowerShell, because WSLg renders the matplotlib window the same way it renders rqt.

WSL2 terminal (type wsl in PowerShell to get here)

sudo apt install python3-pip -y

pip3 install mcap mcap-ros2-support matplotlib --break-system-packages

NOTE The --break-system-packages flag is required on Ubuntu 24.04, which otherwise refuses system-wide pip installs. It is safe here.

You do not need ROS 2 installed on the laptop for any of this. The .mcap file carries its own message schemas, so a plain Python reader can decode it.

# Folder layout

Scripts and data are kept apart so that Logs can be archived or cleared without disturbing tooling.

Scale_Car\Scale_Car\

├── Analysis\

│ fchev_plot.py ← the plotting script lives here

└── Logs\

rosbag_2026-09-07_22-06-29\ ← runs land here

metadata.yaml

rosbag_..._0.mcap

# Step 1 — Copy the run off the Pi

First check the run is worth keeping. On the Pi:

Pi SSH session

ls ~/fchev/logs/

ros2 bag info ~/fchev/logs/rosbag_2026-09-07_22-06-29

Confirm the duration matches what you expect and that /vehicle_state message count is roughly 50 × duration. If it is far short, the run ended early — find out why before analysing it.

PowerShell on the laptop (NOT inside the Pi SSH session)

cd "C:\Users\siddh\OneDrive\Documents\Scale_Car\Scale_Car\Logs"

scp -r pi5@kuro.local:~/fchev/logs/rosbag_2026-09-07_22-06-29 .

WARNING The -r flag is required — a rosbag is a directory, not a single file. Without it scp fails or copies nothing useful.

You should see two files transfer: metadata.yaml and a .mcap file. Both are needed.

# Step 2 — Plot it

WSL2 terminal

cd /mnt/c/Users/siddh/OneDrive/Documents/Scale_Car/Scale_Car/Analysis

python3 fchev_plot.py ../Logs/rosbag_2026-09-07_22-06-29

Your Windows drive appears at /mnt/c/ inside WSL2, so no copying between the two is needed — the same files are visible from both sides.

The script first prints a summary, then opens the figure window on your Windows desktop.

To also export CSVs for MATLAB, add --csv:

python3 fchev_plot.py ../Logs/rosbag_2026-09-07_22-06-29 --csv

That writes one CSV per topic into a csv/ subfolder inside the bag directory, with proper column names (SOC, fault_flags, power_share_actual) rather than raw array indices.

# What the output tells you

## The printed summary

Before any plotting, the script reports message counts and actual achieved rates per topic, then run-level numbers. Check these first — they catch a bad run faster than looking at plots.

Line | What to check
/vehicle_state rate | Should be ≈50 Hz. Lower means dropped telemetry.
/ems_command rate | Should be ≈20 Hz. Lower means the EMS node struggled.
duration | Matches the drive cycle length, unless you stopped it early.
faults | 'none (clean run)' is what you want. Any code listed means the Teensy latched mid-run.

## The four panels

Panel | Shows | Why it matters
1 | v_ref vs v_actual | Whether the car followed the commanded drive cycle. Gaps are velocity-loop or motor problems.
2 | power share — commanded vs achieved | The core EMS result. Whether the droop loop delivered the split the EMS asked for.
3 | I_fc, I_batt, V_bus | Where the current actually came from, and whether the bus held regulation.
4 | SOC with 0.32 / 0.78 guards | Whether SOC stayed in the band, and where the EMS switched modes.

NOTE Panel 2 is the one to look at first for EMS work. Commanded and achieved share should converge under load. Divergence means the droop loop is not tracking, which is a hardware or firmware question, not an EMS algorithm question.

WARNING When the car is stationary, power_share_actual is meaningless. It is computed as I_fc/(I_fc+I_batt), so with both currents near zero the ratio is numerical noise. Expect a garbage trace during idle sections — that is not a bug.

# Troubleshooting

Problem | Fix
pip / pip3 not recognised | In WSL2: sudo apt install python3-pip -y
externally-managed-environment error | Add --break-system-packages to the pip3 command.
No .mcap file found | Wrong folder, or scp ran without -r so the bag copied incompletely.
Figure window never appears | WSLg not running. Check rqt or another GUI app works from WSL2 first.
Plots look empty or flat | Often genuine — car stationary, or run ended before motion. Check duration and v_actual max in the summary.

A run that was not copied off the Pi and checked is not yet data. Do this the same day, while you still remember what was different about the run.

UC Davis Future Mobility Lab | FCHEV Scaled Test Platform

Companion to the FCHEV Experiment Operations Guide, Section 7 Page

FCHEV — Post-Run Data Analysis | UC Davis Future Mobility Lab | Rev 2026-09-07A
