Tangineering/DC-Balancer-Board-Teensy/docs/operations/checklists/Pi_Setup_Checklist_2026-03-16B.xlsx

Sheet: Overview
Raspberry Pi 5 Setup — FCHEV EMS Bring-Up Checklist
UC Davis Future Mobility Lab | Rev 2026-03-16A | Pi 5 + Teensy 4.1 + W5500 Ethernet | H-20 FC + 2S LiPo
Phase | Title | Detail Sheet | # Steps | Est. Time | Status ✓
1 | Pi OS & Basic Config | Phase1_OS | 12 | 20 min | ☐ Not started
2 | Network & Ethernet Setup | Phase2_Network | 10 | 15 min | ☐ Not started
3 | Python & File Transfer | Phase3_Python | 8 | 10 min | ☐ Not started
4 | Simple EMS Bring-Up Test | Phase4_BringUp | 12 | 30 min | ☐ Not started
5 | ROS 2 Install & Workspace Build | Phase5_ROS2_Install | 14 | 45 min | ☐ Not started
6 | ROS 2 Nodes & Launch File Test | Phase6_ROS2_Nodes | 12 | 30 min | ☐ Not started
7 | rosbag2 Logging & rqt Plots | Phase7_Logging | 8 | 20 min | ☐ Not started
8
1. Work through each Phase sheet in order — do not skip phases.
2. Click the ☐ checkbox cell and type X or ✓ when a step is complete.
3. Yellow cells = commands to type exactly as shown in your terminal.
4. Green cells = what you should see if the step worked.
5. Red-background rows = STOP and fix before continuing — safety critical.
6. Keep this file open alongside your terminal while working.
7. Date/initial the Status column in Overview when each Phase is done.

Sheet: Phase1_OS
Phase 1 — Raspberry Pi 5: OS Install & Basic Configuration
Do this on your laptop/desktop first, then move to Pi terminal | Est. 20 min
✓ | Step | Task | Command / Action | Expected Result | Notes / Troubleshooting
PART A — Flash the OS (done on your laptop)
PART A — Flash the OS (done on your laptop)
☐ | 1.1 | Download Raspberry Pi Imager | Go to: raspberrypi.com/software | Imager app downloaded and installed | Available for Mac, Windows, Linux
☐ | 1.2 | Insert microSD card (≥16 GB) into laptop | Use USB adapter if needed | Card visible in Finder / File Explorer | Recommend 32 GB+ for log file storage
☐ | 1.3 | Open Imager → Choose OS | Select: Raspberry Pi OS Lite (64-bit) Under: Raspberry Pi OS (other) | 'Raspberry Pi OS Lite (64-bit)' selected NO desktop — faster boot, less RAM | Lite = no GUI. You SSH in from laptop. Do NOT pick the full desktop version.
☐ | 1.4 | Click gear icon ⚙ → Advanced options | Enable SSH ✓ Set username: pi Set password: (your choice) Set hostname: fchev-pi Configure WiFi if needed for initial setup | Options saved | WiFi only needed for first-time apt updates. You'll use Ethernet for EMS.
☐ | 1.5 | Flash the SD card | Click WRITE → confirm | Write successful — card ejected automatically | Takes 3–5 min. Do not unplug card during write.
☐ | 1.6 | Insert SD card into Pi 5, connect power | Use official Pi 5 USB-C power supply (27W) Do NOT use phone chargers | Green LED blinks during boot (~30s) | Red LED = power OK. Green LED = SD activity. Wait for green to stop blinking.
PART B — First SSH Connection (from your laptop terminal)
☐ | 1.7 | Find Pi IP address | On Mac/Linux: ping fchev-pi.local On Windows: ping fchev-pi.local | Reply from 192.168.x.x — note this IP | If ping fails: check router admin page for DHCP leases, or connect Pi to monitor with HDMI temporarily
☐ | 1.8 | SSH into Pi from your laptop | ssh pi@fchev-pi.local (or ssh pi@192.168.x.x) | Welcome to Raspberry Pi OS message pi@fchev-pi:~ $ | First time: type 'yes' to accept host key fingerprint
☐ | 1.9 | Update package list and upgrade OS | sudo apt update && sudo apt upgrade -y | ...done pi@fchev-pi:~ $ (takes 5–10 min first time) | Must have internet via WiFi or USB tethering. Do this before anything else.
☐ | 1.10 | Set timezone to US/Pacific | sudo raspi-config → 5 Localisation Options → L2 Timezone → US → Pacific | Timezone set. Back at main menu. | Correct time matters for log timestamps
☐ | 1.11 | Enable SSH permanently | sudo raspi-config → 3 Interface Options → I2 SSH → Enable | SSH enabled | Should already be on from Imager step 1.4 — confirm here
☐ | 1.12 | Reboot Pi | sudo reboot | Connection drops, reconnects in ~30s SSH back in: ssh pi@fchev-pi.local | Always reboot after raspi-config changes

Sheet: Phase2_Network
Phase 2 — Network & Ethernet Setup (Pi ↔ Teensy)
Set static IPs so Pi and Teensy always find each other | Est. 15 min
✓ | Step | Task | Command / Action | Expected Result | Notes / Troubleshooting
PART A — Set Static IP on Pi Ethernet Port (eth0)
☐ | 2.1 | Check current IP / interface names | ip addr show | See eth0 (Ethernet) and wlan0 (WiFi) listed | Pi 5 built-in Ethernet = eth0. Confirm name before editing config.
☐ | 2.2 | Edit dhcpcd config to set static IP | echo " interface eth0 static ip_address=192.168.1.100/24 static routers=192.168.1.1 static domain_name_servers=8.8.8.8" | sudo tee -a /etc/dhcpcd.conf | Lines appended to /etc/dhcpcd.conf | This sets Pi Ethernet to 192.168.1.100. Must match TEENSY_IP in code (192.168.1.50).
☐ | 2.3 | Verify the file was written correctly | tail -8 /etc/dhcpcd.conf | Shows the 4 lines you just added | If wrong, edit with: sudo nano /etc/dhcpcd.conf
☐ | 2.4 | Restart networking service | sudo systemctl restart dhcpcd | No errors printed
☐ | 2.5 | Verify eth0 has static IP | ip addr show eth0 | inet 192.168.1.100/24 shown under eth0 | If not: sudo reboot and check again
PART B — Physical Connection: Pi ↔ Teensy
☐ | 2.6 | Connect Pi to Teensy via Ethernet | Option A: Direct cable Pi eth0 → W5500 RJ45 (modern NICs auto-detect crossover) Option B: Both into same network switch | Cable seated, link light on both ends | Direct cable is simplest for lab bench. A cheap 5-port switch works fine too.
☐ | 2.7 | Set Teensy static IP in firmware | In Arduino sketch (next phase): byte ip[] = {192, 168, 1, 50}; byte mac[] = {0xDE,0xAD,0xBE,0xEF,0xFE,0xED}; | Teensy always has IP 192.168.1.50 | The MAC address can be any unique value. Use the one shown or make your own.
☐ | 2.8 | After Teensy is flashed — ping it from Pi | ping 192.168.1.50 -c 4 | 4 packets transmitted, 4 received, 0% loss rtt min ~0.5 ms | If no reply: check W5500 wiring (MOSI/MISO/SCK/CS pins), check Teensy IP in sketch
☐ | 2.9 | Test UDP from Pi to Teensy (quick check) | python3 -c " import socket,time s=socket.socket(socket.AF_INET,socket.SOCK_DGRAM) s.sendto(b'hello',('192.168.1.50',5001)) print('Sent')" | Sent (no error = Pi can transmit UDP) | Teensy won't respond yet — just confirms Pi UDP stack works
☐ | 2.10 | Test UDP receive on Pi (in separate terminal) | Terminal 1: python3 -c " import socket s=socket.socket(socket.AF_INET,socket.SOCK_DGRAM) s.bind(('0.0.0.0',5000)) print('Listening...') print(s.recvfrom(64))" Terminal 2 (on laptop or Pi): send any UDP to Pi port 5000 | Pi prints received bytes | Confirms Pi can receive UDP on port 5000 before running EMS code

Sheet: Phase3_Python
Phase 3 — Python Setup & File Transfer to Pi
Install dependencies, copy your code and .mat file | Est. 10 min
✓ | Step | Task | Command / Action | Expected Result | Notes / Troubleshooting
PART A — Python & Dependencies
☐ | 3.1 | Check Python version on Pi | python3 --version | Python 3.11.x or higher | Pi OS Bookworm ships with Python 3.11. Good — no need to install Python.
☐ | 3.2 | Install scipy and numpy | pip install scipy numpy --break-system-packages | Successfully installed scipy-x.x numpy-x.x | The --break-system-packages flag is required on Pi OS Bookworm. Takes ~3 min.
☐ | 3.3 | Verify imports work | python3 -c "import scipy, numpy; print('OK')" | OK | If ImportError: re-run step 3.2. Check internet is connected.
☐ | 3.4 | Create project folder on Pi | mkdir -p ~/fchev/EMS/SDP mkdir -p ~/fchev/logs | Folders created (no error) | All your code and log files go here
PART B — Copy Files from Laptop to Pi (run on your LAPTOP, not Pi)
☐ | 3.5 | Copy simple EMS test script to Pi | scp simple_ems_test_2026-03-16A.py pi@192.168.1.100:~/fchev/EMS/ | simple_ems_test_2026-03-16A.py 100% | Run from your laptop terminal in the folder where file is saved
☐ | 3.6 | Copy SDP standalone script to Pi | scp sdp_ems_standalone_2026-03-16A.py pi@192.168.1.100:~/fchev/EMS/SDP/ | sdp_ems_standalone_2026-03-16A.py 100%
☐ | 3.7 | Copy scaled J matrix to Pi | scp CostToGo_J_scaled_2026-03-16A.mat pi@192.168.1.100:~/fchev/EMS/SDP/ | CostToGo_J_scaled_2026-03-16A.mat 100% | This is the precomputed cost-to-go for the H-20 hardware
☐ | 3.8 | Verify files arrived on Pi | ls -lh ~/fchev/EMS/ ls -lh ~/fchev/EMS/SDP/ | All 3 files listed with correct sizes | simple_ems ~12KB, sdp_ems ~18KB, CostToGo_J ~1MB

Sheet: Phase4_BringUp
Phase 4 — Simple EMS Bring-Up Test (Pi + Teensy, NO battery/FC yet)
Confirm UDP comms work end-to-end before connecting power hardware | Est. 30 min
✓ | Step | Task | Command / Action | Expected Result | Notes / Troubleshooting
PART A — Flash Teensy Firmware (on your laptop in Arduino IDE)
☐ | 4.1 | Install Arduino IDE + Teensyduino | Download: arduino.cc/en/software Download: pjrc.com/teensy/td_download.html Install Teensyduino on top of Arduino IDE | Teensy 4.1 visible in Tools → Board menu | Must install Teensyduino AFTER Arduino IDE. Teensyduino version must match Arduino IDE version.
☐ | 4.2 | Install NativeEthernet library | Arduino IDE → Tools → Manage Libraries Search: NativeEthernet Install: NativeEthernet by Paul Stoffregen | 'NativeEthernet' shows INSTALLED | This is Teensy-specific. Do NOT install the standard 'Ethernet' library — wrong chip.
☐ | 4.3 | Wire W5500 to Teensy 4.1 | W5500 → Teensy 4.1: MOSI → Pin 11 MISO → Pin 12 SCK → Pin 13 CS → Pin 10 3.3V → 3.3V GND → GND | All 6 wires connected securely | Double-check MOSI/MISO not swapped — most common wiring mistake. Use short wires (<10cm).
☐ | 4.4 | Flash the Teensy firmware sketch | Open: Teensy_FCHEV_firmware.ino (You will write this next — see note) Tools → Board → Teensy 4.1 Sketch → Upload | Teensy LED blinks, serial monitor shows: Ethernet initialized Listening on port 5001 | Firmware code: ask for it next — it sends the 54-byte packet and receives 22-byte commands
PART B — Run Simple EMS on Pi (NO high-voltage hardware connected)
☐ | 4.5 | SSH into Pi (two terminals open) | Terminal 1 (Pi): ssh pi@192.168.1.100 Terminal 2 (Pi): ssh pi@192.168.1.100 | Two separate Pi sessions open | One for running EMS, one for watching logs
☐ | 4.6 | Run simple EMS test script | cd ~/fchev/EMS python3 simple_ems_test_2026-03-16A.py | Script starts, prints: 'Listening on port 5000...' 'UDP rx=:5000 tx=192.168.1.50:5001' | If error: check file is there (ls), check Python version (python3 --version)
☐ | 4.7 | Confirm Teensy telemetry received | (watch Terminal 1 output) | [t= 1.0s] V_batt=7.42V V_fc=0.00V V_bus=18.0V SOC=0.500 power_share=0.500 mode=HYBRID | If 'Waiting for Teensy...' stays > 10s: check ping 192.168.1.50, check Teensy firmware, check cable
☐ | 4.8 | Verify power_share logic is correct | (watch output as Teensy sends varying V_batt) Or temporarily hard-code V_batt in firmware to test: 7.0V → SOC~0.20 → FC_ONLY (share=1.0) 7.4V → SOC~0.50 → HYBRID (share~0.5) 8.1V → SOC~0.90 → BATT (share=0.0) | mode changes as SOC changes share_echo tracks power_share with 1-step lag | share_echo is Teensy echoing back what Pi sent — confirms Pi→Teensy direction works
☐ | 4.9 | Check log file is being written | In Terminal 2: tail -f ~/fchev/logs/simple_ems_test.csv | New rows appear every 0.05s (20Hz) Columns match: t_wall, V_batt, SOC, power_share... | Ctrl+C in Terminal 2 when done watching
☐ | 4.10 | Let it run for 60 seconds minimum | (just watch Terminal 1 output) | No 'Loop overrun' warnings No 'Teensy stale' warnings Dropped packets = 0 | Overruns mean Pi is too slow — unlikely at this load. Drops mean network issue.
☐ | 4.11 | Stop EMS cleanly with Ctrl+C | Press Ctrl+C in Terminal 1 | Script prints: 'Sending SAFE command...' 'Shutdown complete' Teensy enters safe mode | Always stop with Ctrl+C — never kill -9 while Teensy is running
☐ | 4.12 | Confirm log file has data | wc -l ~/fchev/logs/simple_ems_test.csv | > 1200 lines for 60s run at 20Hz (60s × 20Hz = 1200 rows + header) | If file is tiny (<10 rows): logging had an issue — check step 4.9

Sheet: Phase5_SDP
Phase 5 — SDP EMS Deployment (only after Phase 4 passes completely)
Replace simple EMS with full SDP controller — same Teensy firmware, same network | Est. 20 min
✓ | Step | Task | Command / Action | Expected Result | Notes / Troubleshooting
PART A — Verify J Matrix Loads Correctly
☐ | 5.1 | Test SDP loads without errors | cd ~/fchev/EMS/SDP python3 -c " import scipy.io, numpy as np J = scipy.io.loadmat('CostToGo_J_scaled_2026-03-16A.mat')['cost_J'] print('J shape:', J.shape) print('inf count:', np.isinf(J).sum()) print('OK')" | J shape: (250, 50) inf count: 293 OK | If shape is wrong: you may have the old J file — make sure it's CostToGo_J_SCALED not J_new
☐ | 5.2 | Run SDP self-test (timing benchmark) | python3 -c " from sdp_ems_standalone_2026-03-16A import SDPController ctrl = SDPController('CostToGo_J_scaled_2026-03-16A.mat') r = ctrl.step(50.0, 0.45) print(f'P_fc={r.P_fc_optimal:.2f}W share={r.power_share:.3f} solve={r.solve_time_ms:.3f}ms')" | P_fc=24.00W share=1.000 solve=0.15ms (values depend on SOC — FC should fire at SOC=0.45) | If solve_time > 5ms something is wrong — check scipy installed correctly
☐ | 5.3 | Create a minimal drive cycle CSV for testing | python3 -c " import csv, math with open('test_dc.csv','w',newline='') as f: w=csv.writer(f) w.writerow(['time_s','v_mps']) for t in range(120): v=3.0+2.0*math.sin(2*math.pi*t/30) w.writerow([t, round(v,3)]) print('test_dc.csv written — 120s sine wave drive cycle')" | test_dc.csv written — 120s sine wave drive cycle | This gives you a 2-minute sine-wave speed profile to exercise the EMS without a real drive cycle file
☐ | 5.4 | Run SDP EMS (no hardware power — Teensy still just sending test packets) | python3 sdp_ems_standalone_2026-03-16A.py \ --cost_j CostToGo_J_scaled_2026-03-16A.mat \ --drive_cycle test_dc.csv \ --mass 5.0 \ --log ~/fchev/logs/sdp_test_run1.csv | Starts cleanly Prints SOC, P_fc, power_share each 5s No 'stale' or 'infeasible' warnings | Run for full 120s until drive cycle ends and script exits cleanly
☐ | 5.5 | Inspect SDP log | head -5 ~/fchev/logs/sdp_test_run1.csv python3 -c " import csv rows=list(csv.DictReader(open('~/fchev/logs/sdp_test_run1.csv'))) print(f'{len(rows)} rows logged') solve=[float(r['solve_ms']) for r in rows] print(f'Solve ms: mean={sum(solve)/len(solve):.3f} max={max(solve):.3f}')" | > 2400 rows Solve ms: mean < 0.5ms, max < 5ms | If max solve_ms > 10ms: scipy may not be optimized — try reinstalling with: pip install scipy --break-system-packages --force-reinstall
☐ | 5.6 | Tune alpha if FC engagement is too low | Run with higher penalty weight: python3 sdp_ems_standalone_2026-03-16A.py \ --alpha 5000 ... | P_fc > 0 more frequently in log FC fires at mid-SOC not just low-SOC | Start at alpha=500 (default), try 2000, 5000. Watch P_fc in log. Your dissertation should document the alpha you chose and why.
☐ | 5.7 | Verify Ctrl+C shutdown is clean | Press Ctrl+C during run | SAFE command sent Shutdown complete Log file closed cleanly | Always verify clean shutdown before connecting real hardware
☐ | 5.8 | SDP Phase PASSED — ready for hardware | (confirm all above steps checked) | All steps 5.1–5.7 checked ✓ No errors in any step | NOW you can connect FC and battery to Teensy power circuits

Sheet: Phase6_Validate
Phase 6 — Validation & Data Logging (with real hardware connected)
First real hardware run — FC + battery connected, start with low power | Est. 30 min
✓ | Step | Task | Command / Action | Expected Result | Notes / Troubleshooting
SAFETY FIRST — read all red rows before connecting hardware
☐ | 6.1 | Check all Teensy safety limits in firmware | Verify in firmware: I_fc > 3.5A → cutoff V_batt < 6.2V → cutoff V_bus > 18.5V → cutoff PI_TIMEOUT > 500ms → safe mode | All limits confirmed in firmware code | DO NOT skip this. Review firmware safety section before powering on.
☐ | 6.2 | Connect FC first (no battery) | Connect H-20 FC output to boost regulator input Do NOT connect battery yet | FC shows OCV ~12V at terminals No current flowing | Start with FC only to confirm voltage levels are correct before adding battery
☐ | 6.3 | Power on Teensy + FC only (no motor load) | Connect Teensy USB power FC hydrogen OFF for now Check V_fc reading in EMS console | V_fc shows correct OCV (~12.2V) V_bus shows 0 (boost not enabled yet) | Just checking Teensy reads sensors correctly. No hydrogen flowing.
☐ | 6.4 | Run simple EMS first (not SDP) | python3 simple_ems_test_2026-03-16A.py | V_fc, V_batt values look physically correct power_share commanded correctly No faults | Use simple EMS for first real hardware test — SDP comes after this is confirmed
☐ | 6.5 | Enable hydrogen and run FC at low load | Enable H2 supply at regulator Set low demand manually (10W) Watch V_fc, I_fc in console | V_fc drops from OCV to ~10-11V under small load I_fc > 0 No FC_STALL fault | H-20 needs ~30s warmup. V_fc will stabilize. If FC stalls, it means H2 pressure is too low.
☐ | 6.6 | Connect battery and check charging/droop | Connect 2S LiPo Check V_batt reading Verify I_batt, I_charge signals make sense | V_batt shows 7.0–8.4V (real pack voltage) I_batt changes with load No OC_BATT fault | If V_batt reads wrong: check current monitor wiring. If OC_BATT immediately: reduce load.
☐ | 6.7 | Run full SDP EMS with real hardware | python3 sdp_ems_standalone_2026-03-16A.py \ --cost_j CostToGo_J_scaled_2026-03-16A.mat \ --drive_cycle test_dc.csv \ --mass 5.0 \ --log ~/fchev/logs/sdp_hw_run1.csv | EMS runs for full drive cycle P_fc varies with SOC as expected No hardware faults Log file has clean data | Watch power_share vs share_actual — they should be close. Big difference = Teensy droop not executing correctly.
☐ | 6.8 | Copy log file to laptop for analysis | On your laptop: scp pi@192.168.1.100:~/fchev/logs/sdp_hw_run1.csv ~/Desktop/ | File copied to Desktop Open in Excel / MATLAB for analysis | Columns: t, v_ref, v_actual, SOC, V_batt, V_fc, I_fc, V_bus, P_dem, P_fc, P_batt, power_share, share_actual...

Sheet: Phase5_ROS2_Install
Phase 5 — ROS 2 Jazzy Install & Workspace Build on Pi
Install ROS 2, create fchev_ems package, copy all nodes | Est. 45 min | Needs internet
✓ | Step | Task | Command / Action | Expected Result | Notes / Troubleshooting
PART A — Install ROS 2 Jazzy on Raspberry Pi 5
☐ | 5.1 | Set locale | locale sudo apt update && sudo apt install locales -y sudo locale-gen en_US en_US.UTF-8 sudo update-locale LC_ALL=en_US.UTF-8 LANG=en_US.UTF-8 export LANG=en_US.UTF-8 | locale shows: LANG=en_US.UTF-8 | Required before ROS 2 install. Skip if locale already correct.
☐ | 5.2 | Add ROS 2 apt repository | sudo apt install software-properties-common curl -y sudo curl -sSL https://raw.githubusercontent.com/ros/rosdistro/master/ros.key \ -o /usr/share/keyrings/ros-archive-keyring.gpg echo "deb [arch=$(dpkg --print-architecture) \ signed-by=/usr/share/keyrings/ros-archive-keyring.gpg] \ http://packages.ros.org/ros2/ubuntu \ $(. /etc/os-release && echo $UBUNTU_CODENAME) main" \ | sudo tee /etc/apt/sources.list.d/ros2.list > /dev/null | No errors. /etc/apt/sources.list.d/ros2.list created. | Pi OS Bookworm = Debian 12. ROS 2 Jazzy supports it.
☐ | 5.3 | Install ROS 2 Jazzy base | sudo apt update sudo apt install ros-jazzy-ros-base -y | Successfully installed ros-jazzy-ros-base (takes 10-15 min, ~500MB) | Use ros-base not ros-desktop (no GUI on Pi). Desktop version wastes 2GB.
☐ | 5.4 | Install ROS 2 dev tools | sudo apt install python3-colcon-common-extensions \ python3-rosdep python3-vcstool -y | All packages installed | colcon is the build tool. rosdep resolves dependencies.
☐ | 5.5 | Source ROS 2 in .bashrc | echo 'source /opt/ros/jazzy/setup.bash' >> ~/.bashrc source ~/.bashrc | ros2 --help shows ROS 2 help text | Do this once. Every new terminal will auto-source ROS 2.
☐ | 5.6 | Verify ROS 2 works | ros2 topic list | /parameter_events /rosout (these are always present) | If 'command not found': re-run step 5.5 and open a new terminal
☐ | 5.7 | Create ROS 2 workspace | mkdir -p ~/ros2_ws/src cd ~/ros2_ws colcon build source install/setup.bash | Summary: 0 packages finished (empty workspace build — OK) | Just confirms colcon works. The workspace is empty for now.
PART B — Create fchev_ems Package & Copy Nodes
☐ | 5.8 | Create fchev_ems Python package | cd ~/ros2_ws/src ros2 pkg create fchev_ems \ --build-type ament_python \ --dependencies rclpy std_msgs | fchev_ems/ folder created with: package.xml, setup.py, fchev_ems/__init__.py | This scaffolds the package. You'll add your nodes inside fchev_ems/
☐ | 5.9 | Copy all node files into package | cp ~/fchev/EMS/SDP/sdp_ems_node_2026-03-16A.py \ ~/ros2_ws/src/fchev_ems/fchev_ems/sdp_ems_node.py cp ~/fchev/ROS2/teensy_bridge_node_2026-03-16A.py \ ~/ros2_ws/src/fchev_ems/fchev_ems/teensy_bridge_node.py cp ~/fchev/ROS2/drive_cycle_node_2026-03-16A.py \ ~/ros2_ws/src/fchev_ems/fchev_ems/drive_cycle_node.py | All 3 .py files in fchev_ems/fchev_ems/ | First scp files from laptop to ~/fchev/ROS2/ if not already there
☐ | 5.10 | Create launch directory and copy launch file | mkdir -p ~/ros2_ws/src/fchev_ems/launch cp ~/fchev/ROS2/fchev_launch_2026-03-16A.py \ ~/ros2_ws/src/fchev_ems/launch/fchev_launch.py | launch/fchev_launch.py exists
☐ | 5.11 | Edit setup.py — add entry points and launch data | nano ~/ros2_ws/src/fchev_ems/setup.py # In entry_points add: 'console_scripts': [ 'sdp_ems_node = fchev_ems.sdp_ems_node:main', 'teensy_bridge = fchev_ems.teensy_bridge_node:main', 'drive_cycle_node = fchev_ems.drive_cycle_node:main', ], # In data_files add: ('share/fchev_ems/launch', ['launch/fchev_launch.py']), | setup.py saved with all 3 entry points | Entry points = how ROS 2 finds your Python node executables
☐ | 5.12 | Install scipy in ROS 2 Python env | pip install scipy numpy --break-system-packages | Already installed from Phase 3 — confirm with: python3 -c "import scipy; print('OK')" | ROS 2 uses the same system Python 3 — same scipy install works
☐ | 5.13 | Build the workspace | cd ~/ros2_ws colcon build --packages-select fchev_ems source install/setup.bash | Summary: 1 package finished [fchev_ems] | If build fails: check setup.py entry_points syntax carefully. Missing comma = build error.
☐ | 5.14 | Verify nodes are discoverable | ros2 pkg list | grep fchev ros2 node list # (nothing running yet, just checks install) | fchev_ems appears in package list | If not found: re-run 'source ~/ros2_ws/install/setup.bash' and try again Add to .bashrc: echo 'source ~/ros2_ws/install/setup.bash' >> ~/.bashrc

Sheet: Phase6_ROS2_Nodes
Phase 6 — Test ROS 2 Nodes Individually Then Together
Verify each node works in isolation before running the full launch file | Est. 30 min
✓ | Step | Task | Command / Action | Expected Result | Notes / Troubleshooting
PART A — Test Each Node Individually (3 terminals on Pi)
☐ | 6.1 | Terminal 1: run teensy_bridge node | ros2 run fchev_ems teensy_bridge | TeensyBridgeNode ready | Teensy=192.168.1.50 rx=:5000 tx=:5001 | pub=50Hz | Teensy must be running and connected. If Teensy offline: node starts but logs 'Teensy stale'
☐ | 6.2 | Terminal 2: echo /vehicle_state topic | ros2 topic echo /vehicle_state | data: [v_actual, V_batt, I_batt, I_charge, V_fc, I_fc, V_bus, P_motor, share_echo, share_actual, droop_FC, droop_BT, charger, faults, SOC] Publishing at ~50 Hz | You should see real sensor values from Teensy. If all zeros: check Teensy firmware is flashed and Ethernet connected
☐ | 6.3 | Terminal 3: check topic bandwidth | ros2 topic hz /vehicle_state ros2 topic bw /vehicle_state | average rate: 50.0 Hz bandwidth: ~2 kB/s | Rate should be very close to 50 Hz. Jitter > 5ms = network issue.
☐ | 6.4 | Terminal 2: run drive_cycle_node | # Stop echo (Ctrl+C), then: ros2 run fchev_ems drive_cycle_node \ --ros-args -p csv_path:=~/fchev/EMS/test_dc.csv | Drive cycle loaded: test_dc.csv duration=120s | v_max=5.00m/s DriveCycleNode ready | If no CSV: uses built-in sine wave profile automatically
☐ | 6.5 | Terminal 3: echo /drive_cycle topic | ros2 topic echo /drive_cycle | data: [v_ref, P_demand, elapsed_s, progress] Publishing at 20 Hz | v_ref should vary smoothly. P_demand should fluctuate with acceleration.
☐ | 6.6 | Terminal 2: run SDP EMS node | ros2 run fchev_ems sdp_ems_node \ --ros-args \ -p cost_j_path:=~/fchev/EMS/SDP/CostToGo_J_scaled_2026-03-16A.mat \ -p alpha:=500.0 | SDPController loaded: J=(250,50) SDPEMSNode ready | 20 Hz | alpha=500 | If 'cost_J not found': check path. Use absolute path if ~ doesn't expand.
☐ | 6.7 | Terminal 3: echo /ems_command and /ems_diagnostics | ros2 topic echo /ems_command # In another terminal: ros2 topic echo /ems_diagnostics | /ems_command: [v_sp, share, chg, mode, droop] /ems_diagnostics: [P_fc, P_batt, share, feasible, clamped, solve_ms, mode] | power_share should vary with SOC. solve_ms should be < 1.0ms.
☐ | 6.8 | Verify full chain: Teensy → bridge → EMS → command → bridge → Teensy | (all 3 nodes running, watch /ems_diagnostics) Change SOC by varying battery load manually or set param: ros2 param set /sdp_ems_node alpha 5000.0 | share_actual in /vehicle_state changes share_echo tracks /ems_command power_share solve_ms stays < 5ms | This confirms end-to-end data flow through all ROS nodes
PART B — Run Full System with Launch File
☐ | 6.9 | Run full system with launch file (simple EMS first) | ros2 launch fchev_ems fchev_launch.py ems:=simple | All 3 nodes start in one command: [drive_cycle_node] [teensy_bridge_node] [sdp_ems_node / simple_ems_node] | Use ems:=simple for first launch test. Swap to ems:=sdp once confirmed working.
☐ | 6.10 | In second terminal: watch all topics | watch -n 1 'ros2 topic list && ros2 topic hz /vehicle_state --window 5' | 6 topics visible /vehicle_state at 50 Hz
☐ | 6.11 | Swap to SDP EMS without restarting | Ctrl+C the launch ros2 launch fchev_ems fchev_launch.py ems:=sdp | SDP node starts instead of simple EMS All other nodes unchanged | This is the key ROS2 advantage — algorithm swap in one CLI arg
☐ | 6.12 | Tune alpha at runtime (no restart needed) | ros2 param set /sdp_ems_node alpha 5000.0 ros2 param get /sdp_ems_node alpha | Set parameter successful alpha: 5000.0 | Watch /ems_diagnostics — P_fc should increase after alpha increase

Sheet: Phase7_Logging
Phase 7 — rosbag2 Data Logging & rqt Live Plots
Record all data for offline analysis, replay, and dissertation figures | Est. 20 min
✓ | Step | Task | Command / Action | Expected Result | Notes / Troubleshooting
PART A — rosbag2 Recording on Pi
☐ | 7.1 | Run full system WITH rosbag recording | ros2 launch fchev_ems fchev_launch.py \ ems:=sdp \ log:=true \ csv:=~/fchev/EMS/test_dc.csv | rosbag2 starts recording to: ~/fchev/logs/rosbag_YYYY-MM-DD_HH-MM-SS/ | log:=true enables the rosbag2 record process inside the launch file
☐ | 7.2 | Check bag is growing during run | watch -n 2 'du -sh ~/fchev/logs/rosbag_*' | Size increases every 2s (~50-200 kB/min at 50Hz) | If size stays at 0: rosbag2 didn't start. Check launch file log:=true was parsed.
☐ | 7.3 | After run: inspect bag contents | ros2 bag info ~/fchev/logs/rosbag_2026*/ | Shows: 6 topics Duration, message counts per topic Files: rosbag_xxx.db3
☐ | 7.4 | Replay bag to verify data | ros2 bag play ~/fchev/logs/rosbag_2026*/ # In another terminal: ros2 topic echo /vehicle_state | Topics republished from bag Data matches original recording | Replay is how you re-run analysis without the hardware
☐ | 7.5 | Export bag to CSV for MATLAB/Python analysis | pip install ros2bag-to-csv --break-system-packages # OR use mcap tools: ros2 bag convert -i ~/fchev/logs/rosbag_2026*/ \ -o ~/fchev/logs/exported/ --output-format csv | CSV files exported, one per topic | Alternatively: use Python to read .db3 directly with sqlite3 module
☐ | 7.6 | Copy bag to laptop for analysis | On laptop: scp -r pi@192.168.1.100:~/fchev/logs/rosbag_2026*/ ~/Desktop/ | Bag folder copied to laptop
PART B — rqt Live Plots (run on laptop, Pi, or both)
☐ | 7.7 | Install rqt on Pi (or use laptop — see Phase 8) | sudo apt install ros-jazzy-rqt \ ros-jazzy-rqt-common-plugins -y | rqt installed | If running headless Pi: do this on your laptop instead and connect over network (Phase 8)
☐ | 7.8 | Open rqt_plot while system is running | rqt # Then: Plugins → Visualization → Plot # Add topics: /ems_diagnostics/data[0] (P_fc) /ems_diagnostics/data[1] (P_batt) /vehicle_state/data[4] (SOC approximated) /ems_diagnostics/data[5] (solve_ms) | Live scrolling plots of P_fc, P_batt, SOC, solve_ms | Use array index notation for Float64MultiArray: /topic/data[N] where N is 0-indexed

Sheet: Phase8_MultiMachine
Phase 8 — Multi-Machine Setup: Pi + Laptop on Same ROS 2 Graph
See all Pi topics from your laptop — rqt, topic echo, param set — over WiFi | Est. 20 min
✓ | Step | Task | Command / Action | Expected Result | Notes / Troubleshooting
PART A — Install ROS 2 Jazzy on Laptop (if not already)
☐ | 8.1 | Install ROS 2 Jazzy on laptop | Mac: use RoboStack (conda) conda install -c robostack-staging ros-jazzy-desktop Ubuntu 24.04: Follow same steps as Phase 5.1-5.6 on laptop Windows: use WSL2 + Ubuntu 24.04 | ros2 topic list works on laptop | Mac users: RoboStack is the easiest path. brew install doesn't work for ROS2.
☐ | 8.2 | Connect laptop to SAME network as Pi | Connect laptop to same WiFi router or direct Ethernet to Pi (need 2nd NIC or USB-Ethernet) | ping 192.168.1.100 succeeds from laptop | Both machines MUST be on same subnet (192.168.1.x). This is the only requirement for ROS 2 discovery.
☐ | 8.3 | Set same ROS_DOMAIN_ID on both machines | On Pi (add to ~/.bashrc): export ROS_DOMAIN_ID=42 On laptop (add to ~/.bashrc or ~/.zshrc): export ROS_DOMAIN_ID=42 Then: source ~/.bashrc on both | Same number on both = they see each other Different number = isolated | Use any number 0-101. 42 is arbitrary. This prevents interference with other ROS2 setups on the same network.
☐ | 8.4 | Start system on Pi | On Pi: ros2 launch fchev_ems fchev_launch.py \ ems:=sdp log:=true | All nodes running on Pi
☐ | 8.5 | See Pi topics from laptop | On laptop: ros2 topic list | /vehicle_state /ems_command /ems_diagnostics /drive_cycle /comms_status (all Pi topics visible on laptop) | If no topics visible: check ROS_DOMAIN_ID matches. Check firewall (sudo ufw allow 7400:7500/udp).
☐ | 8.6 | Open rqt on laptop — plots Pi data live | On laptop: rqt → Plugins → Visualization → Plot → Add /ems_diagnostics/data[0] (P_fc) → Add /vehicle_state/data[0] (SOC) | Live plots of Pi EMS data on laptop screen Data flowing at 20-50 Hz | This is your live monitoring dashboard during hardware tests
☐ | 8.7 | Tune parameters on Pi from laptop | On laptop: ros2 param set /sdp_ems_node alpha 5000.0 ros2 param list /sdp_ems_node | Set parameter successful Change visible in Pi terminal immediately | You can adjust EMS tuning from your laptop without touching the Pi
☐ | 8.8 | Record bag from laptop (optional) | On laptop: ros2 bag record -o ~/Desktop/fchev_run1 \ /vehicle_state /ems_diagnostics \ /drive_cycle /ems_command | Bag recording on laptop (same data as Pi bag, just recorded remotely) | Useful if you want bag files on your laptop directly without scp after every run
