Tangineering/DC-Balancer-Board-Teensy/controller_design/figures/MATLAB_shipped_step_ramp.png

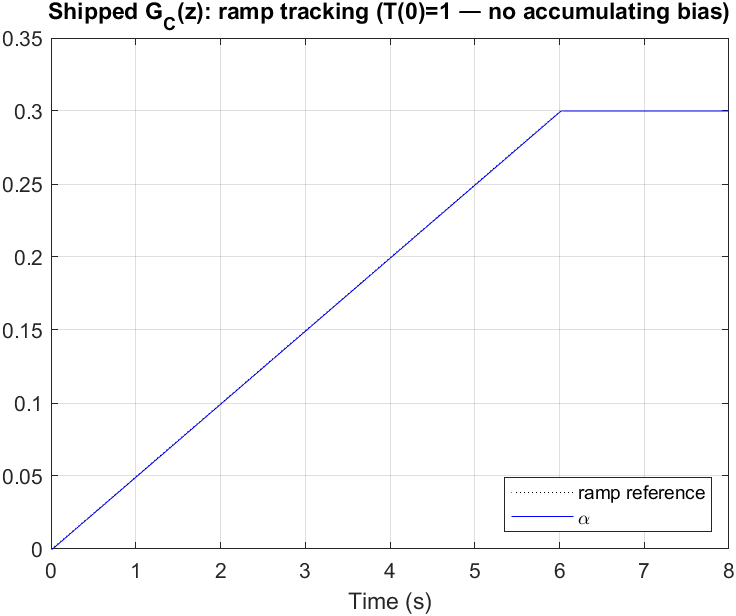
controller_design/figures/MATLAB_shipped_step_ramp.png
