Tangineering/DC-Balancer-Board-Teensy/docs/balancer_board_showcase_20260817/balancer_board_showcase_20260817/01_velocity_tracking/velocity_step_family.png

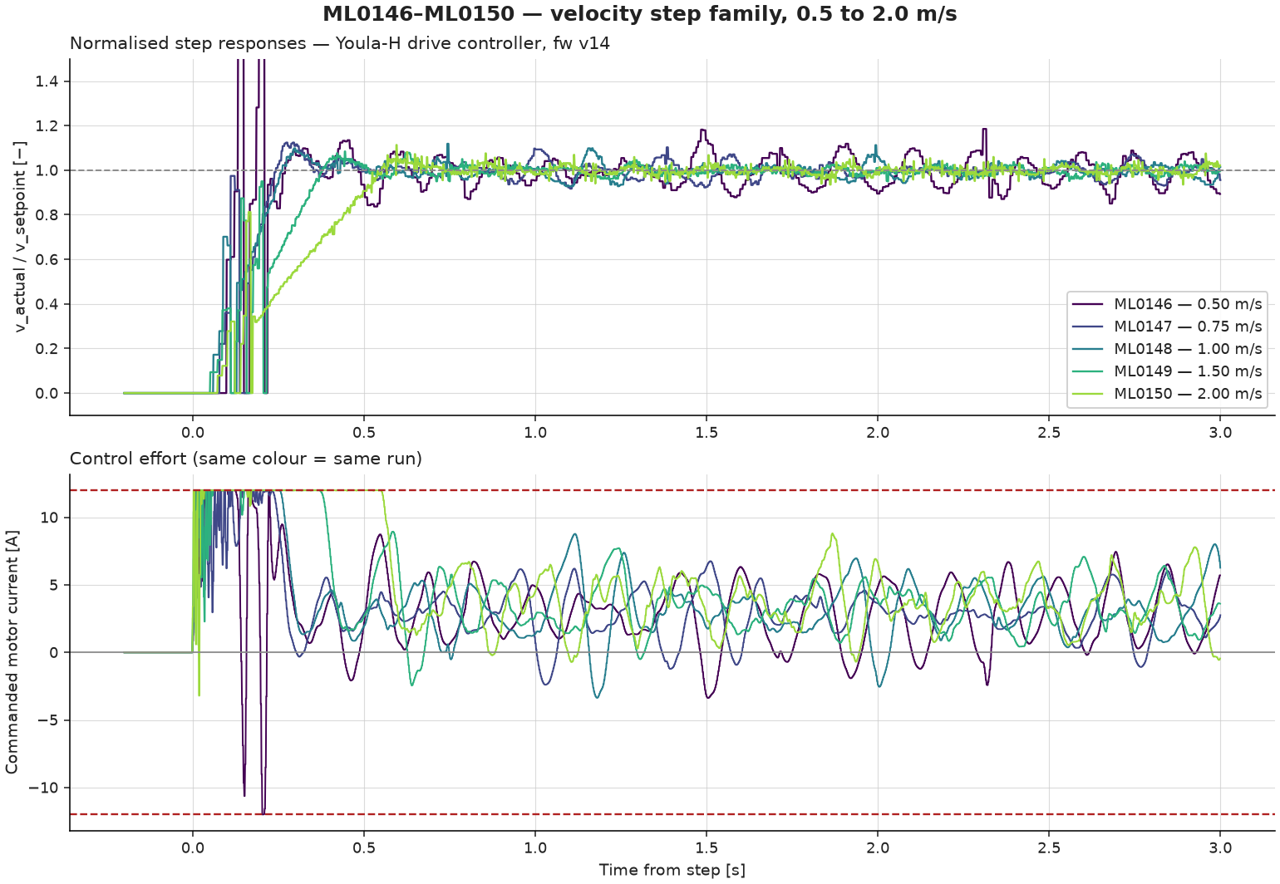
docs/balancer_board_showcase_20260817/balancer_board_showcase_20260817/01_velocity_tracking/velocity_step_family.png
