Tangineering/DC-Balancer-Board-Teensy/controller_design_MIMO/MATLAB_mimo_results_5A.txt

*** SUPERSEDED (2026-08-04) ***
This log validates the +-5 A (MOTOR_I_CMD_MAX = 5 A) MIMO controller and was
renamed from MATLAB_mimo_results.txt when the design was recalibrated to +-20 A
(Du = diag(0.35, 20.0)).  It is KEPT for traceability, not as a current result.
Re-run mimo_crosscheck.m to produce a current MATLAB_mimo_results.txt.
=*** SUPERSEDED (2026-08-04) ***
This log validates the +-5 A (MOTOR_I_CMD_MAX = 5 A) MIMO controller and was
renamed from MATLAB_mimo_results.txt when the design was recalibrated to +-20 A
(Du = diag(0.35, 20.0)).  It is KEPT for traceability, not as a current result.
Re-run mimo_crosscheck.m to produce a current MATLAB_mimo_results.txt.
=*** SUPERSEDED (2026-08-04) ***
This log validates the +-5 A (MOTOR_I_CMD_MAX = 5 A) MIMO controller and was
renamed from MATLAB_mimo_results.txt when the design was recalibrated to +-20 A
(Du = diag(0.35, 20.0)).  It is KEPT for traceability, not as a current result.
Re-run mimo_crosscheck.m to produce a current MATLAB_mimo_results.txt.
=*** SUPERSEDED (2026-08-04) ***
This log validates the +-5 A (MOTOR_I_CMD_MAX = 5 A) MIMO controller and was
renamed from MATLAB_mimo_results.txt when the design was recalibrated to +-20 A
(Du = diag(0.35, 20.0)).  It is KEPT for traceability, not as a current result.
Re-run mimo_crosscheck.m to produce a current MATLAB_mimo_results.txt.
=*** SUPERSEDED (2026-08-04) ***
This log validates the +-5 A (MOTOR_I_CMD_MAX = 5 A) MIMO controller and was
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
Re-run mimo_crosscheck.m to produce a current MATLAB_mimo_results.txt.
=*** SUPERSEDED (2026-08-04) ***
This log validates the +-5 A (MOTOR_I_CMD_MAX = 5 A) MIMO controller and was
renamed from MATLAB_mimo_results.txt when the design was recalibrated to +-20 A
(Du = diag(0.35, 20.0)).  It is KEPT for traceability, not as a current result.
Re-run mimo_crosscheck.m to produce a current MATLAB_mimo_results.txt.
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
