Tangineering/DC-Balancer-Board-Teensy/controller_design_MIMO/calibration/drag_curve_20260816.png

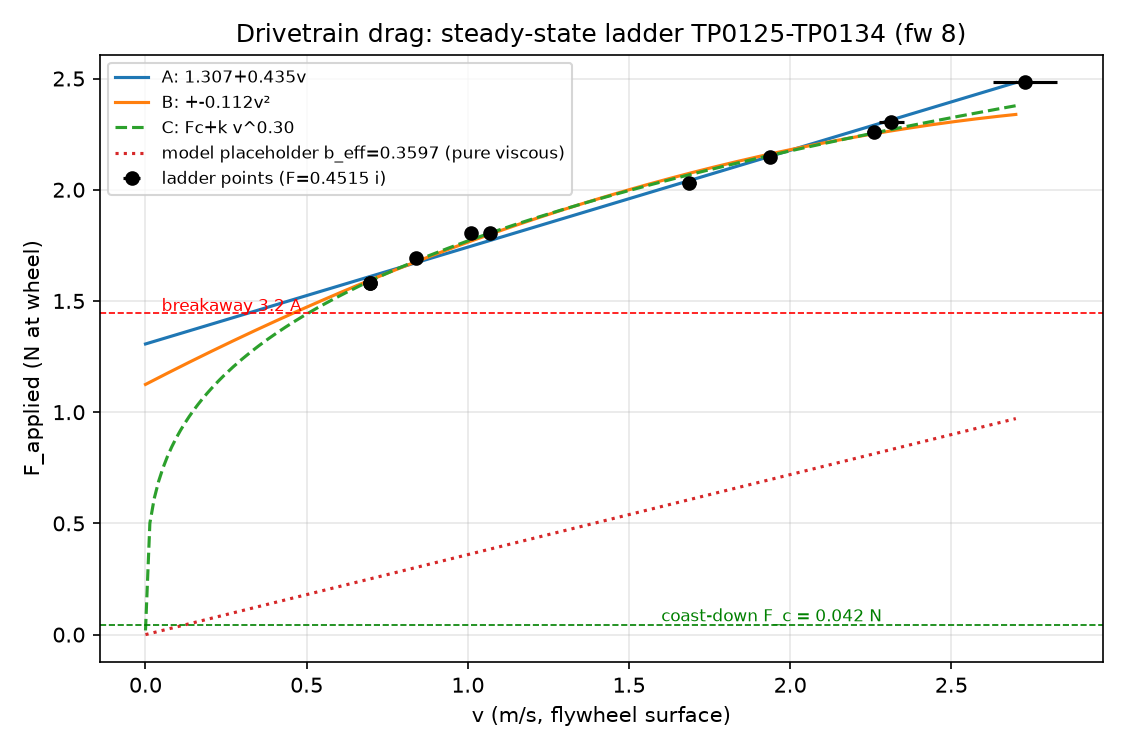
controller_design_MIMO/calibration/drag_curve_20260816.png
