Tangineering/DC-Balancer-Board-Teensy/docs/reviews/charger_eval_2026-11-05/round2/figs/fig1_measured_regen_pulses.png

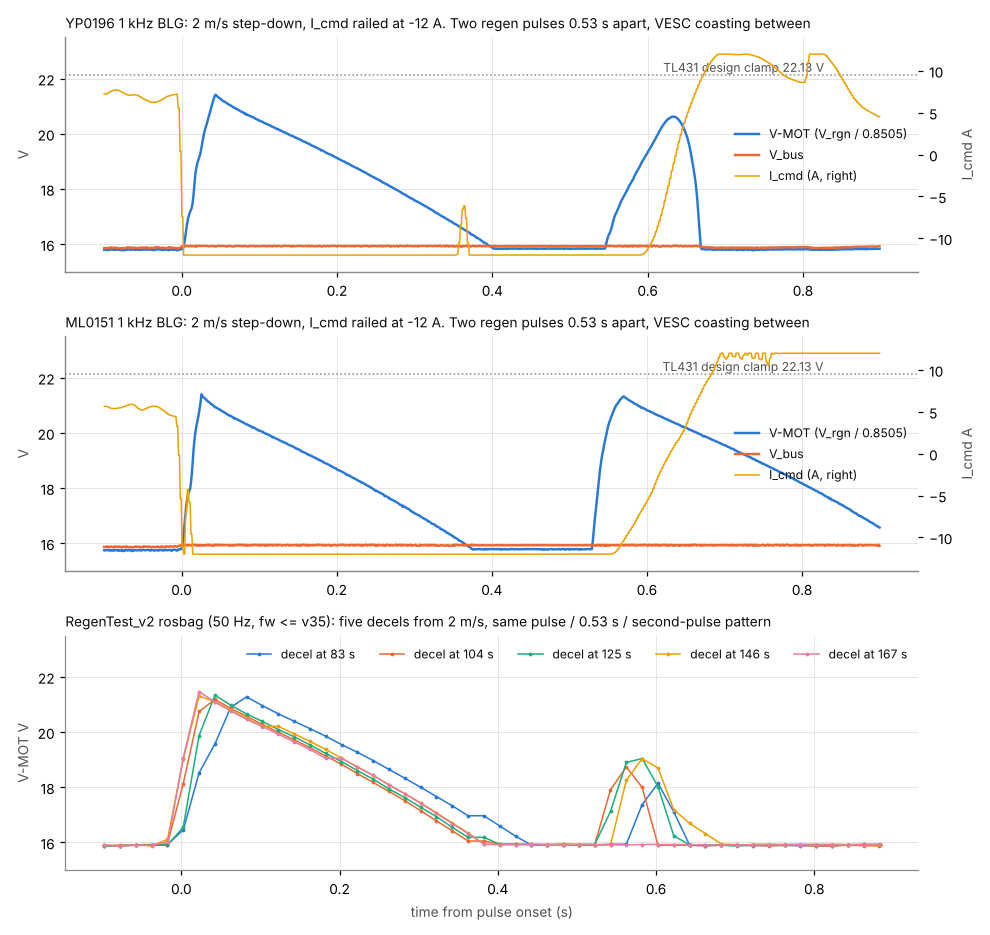
docs/reviews/charger_eval_2026-11-05/round2/figs/fig1_measured_regen_pulses.png
