Tangineering/DC-Balancer-Board-Teensy/docs/reviews/vrgn_rootcause_2026-11-05/agent_work/verify-physics/fig82.png

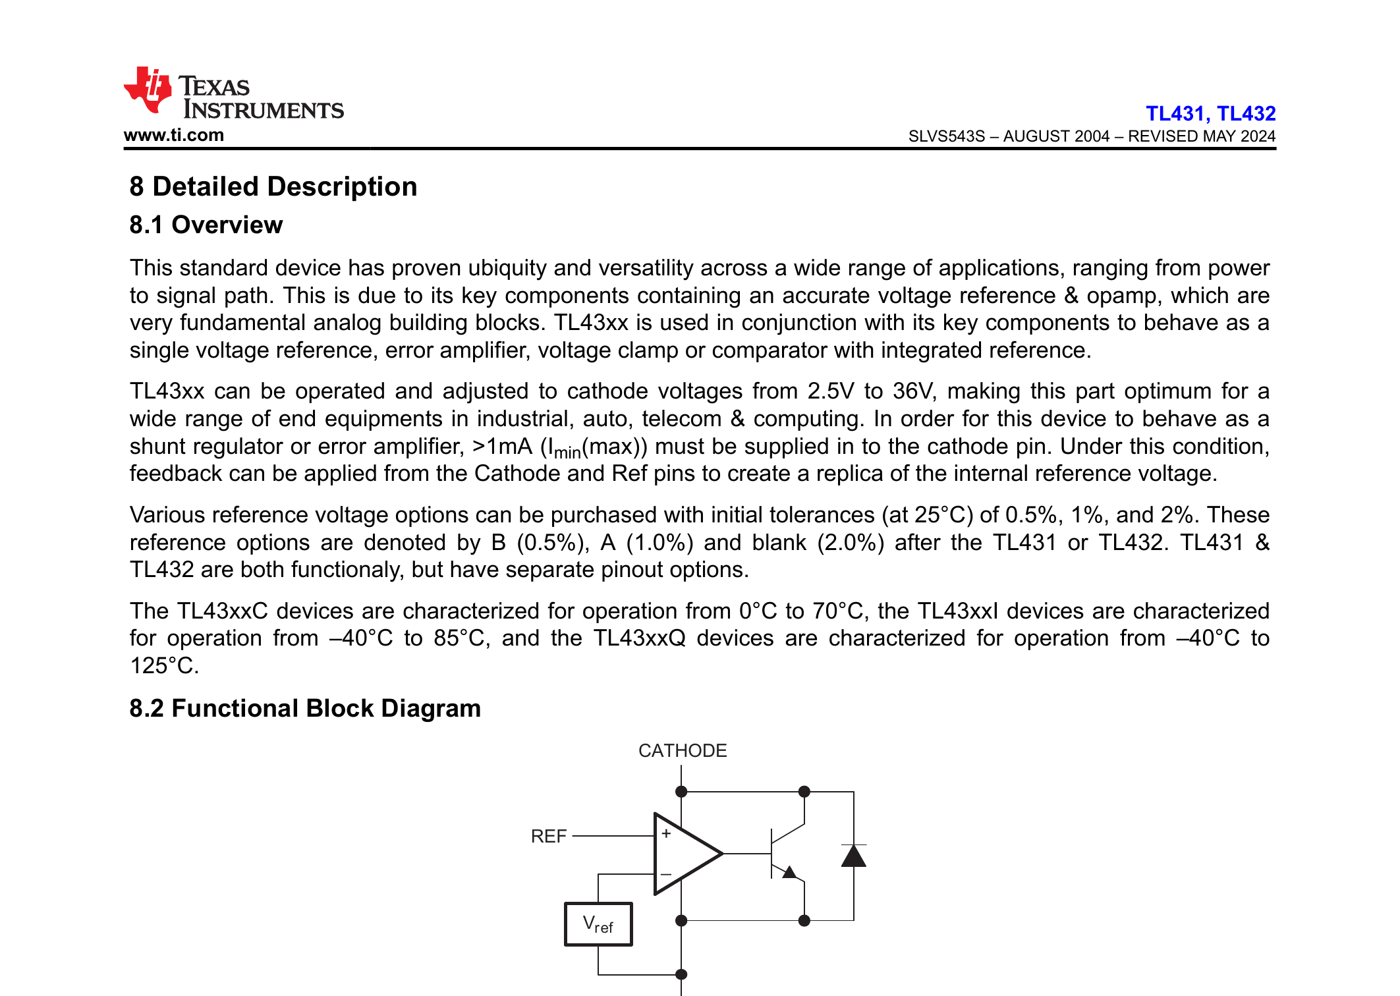
docs/reviews/vrgn_rootcause_2026-11-05/agent_work/verify-physics/fig82.png
