Tangineering/DC-Balancer-Board-Teensy/logs/rosbags/plots/FCHEV_Test_fault.png

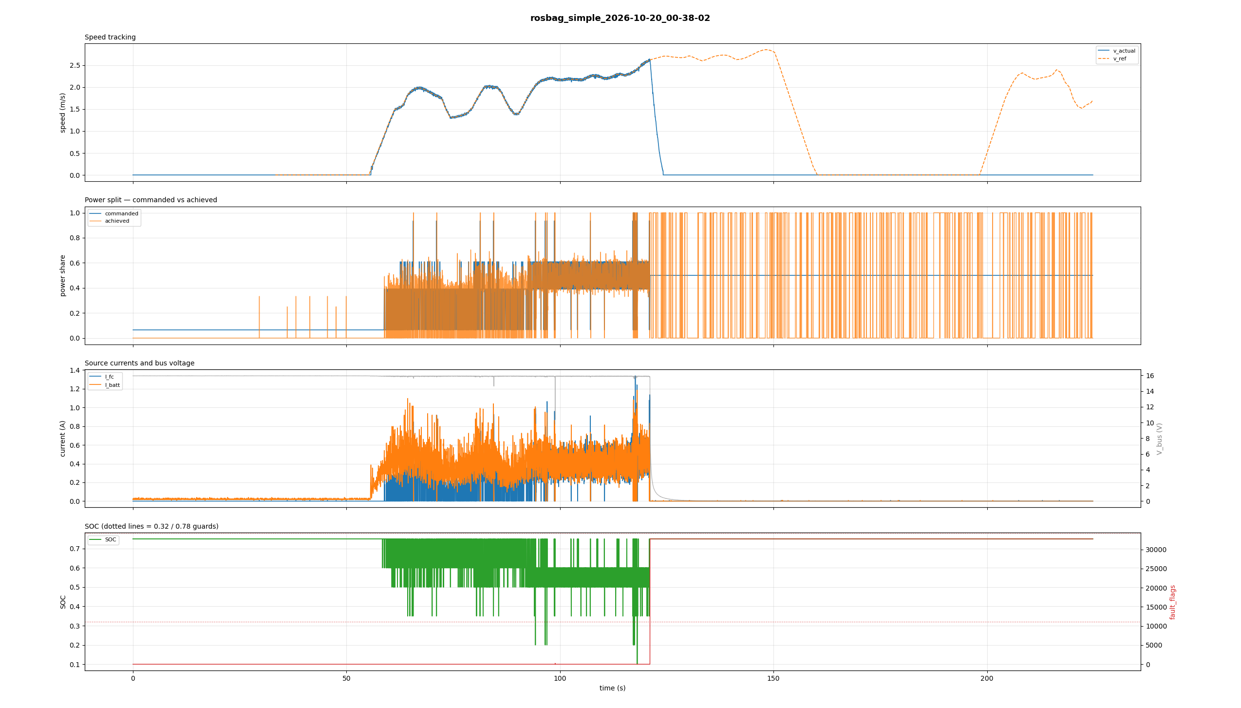
logs/rosbags/plots/FCHEV_Test_fault.png
