Tangineering/DC-Balancer-Board-Teensy/logs/rosbags/plots/FCHEV_Test_fault_trimmed.png

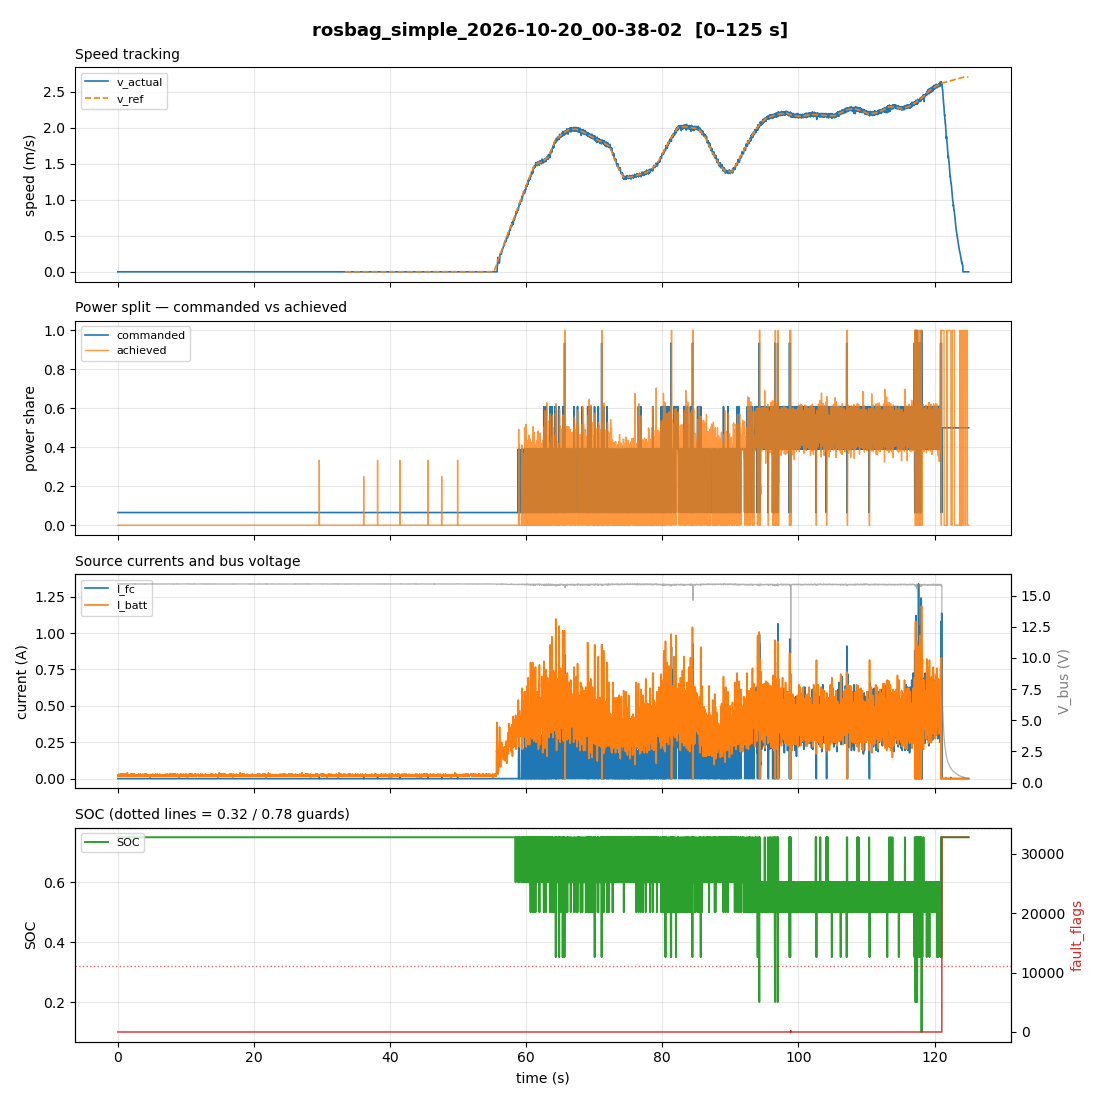
logs/rosbags/plots/FCHEV_Test_fault_trimmed.png
