Tangineering/DC-Balancer-Board-Teensy/logs/rosbags/plots/FCHEV_Test_mk1.png

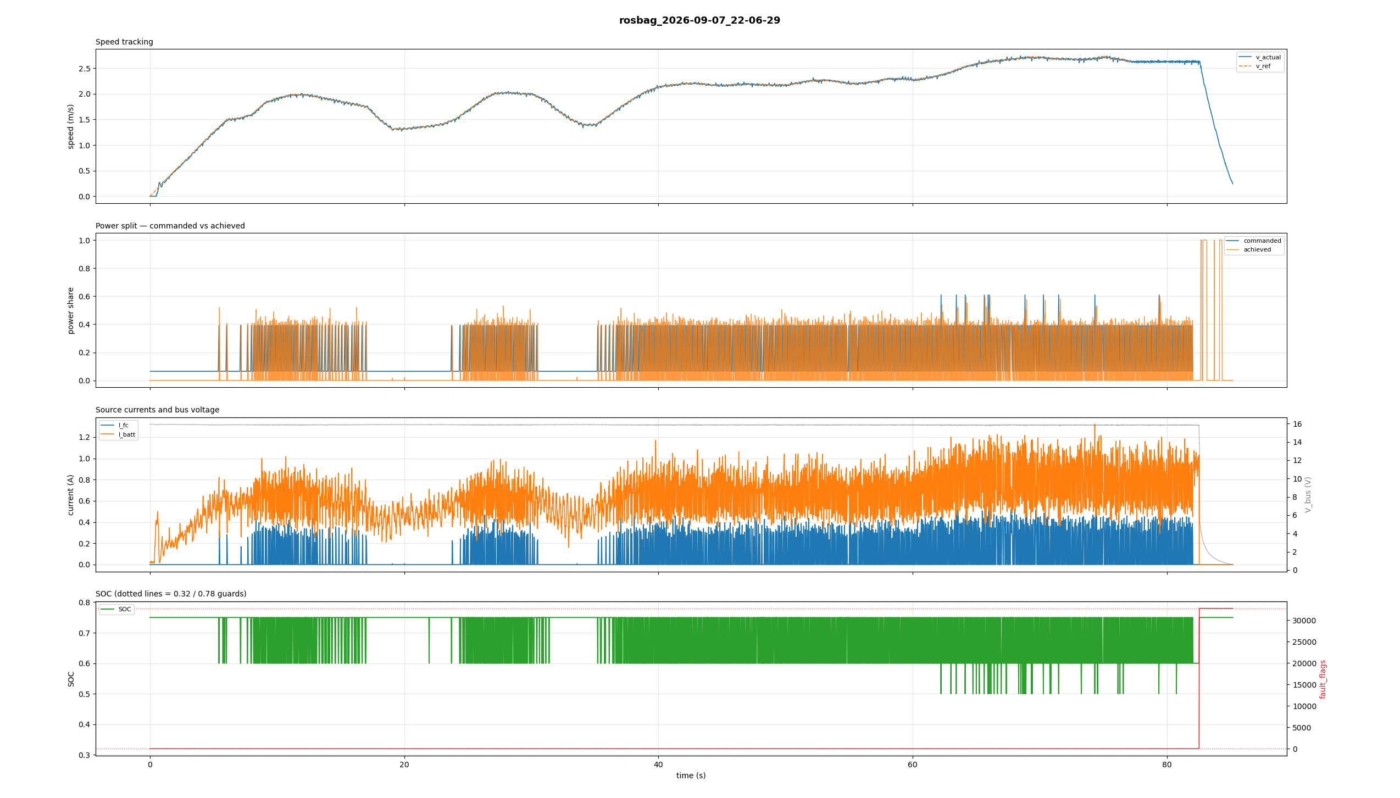
logs/rosbags/plots/FCHEV_Test_mk1.png
