Tangineering/DC-Balancer-Board-Teensy/logs/rosbags/plots/FCHEV_Test_sweep2.png

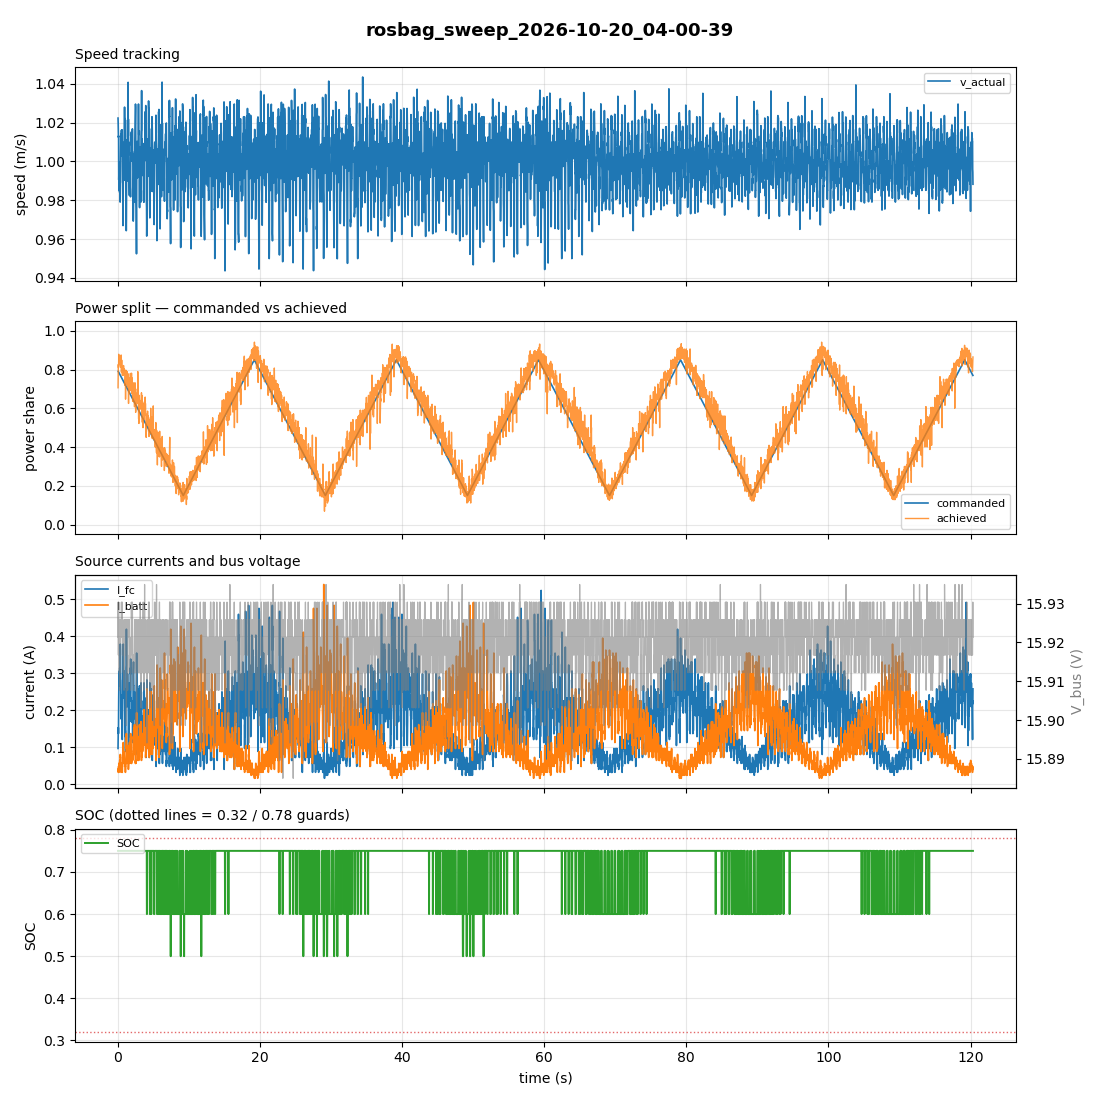
logs/rosbags/plots/FCHEV_Test_sweep2.png
