Tangineering/DC-Balancer-Board-Teensy/papers/A_Practical_Youla_Gain_Tuning_Framework_for_H__Controller_Realization/antiwindup_study/figures/python/YH-AW-18.png

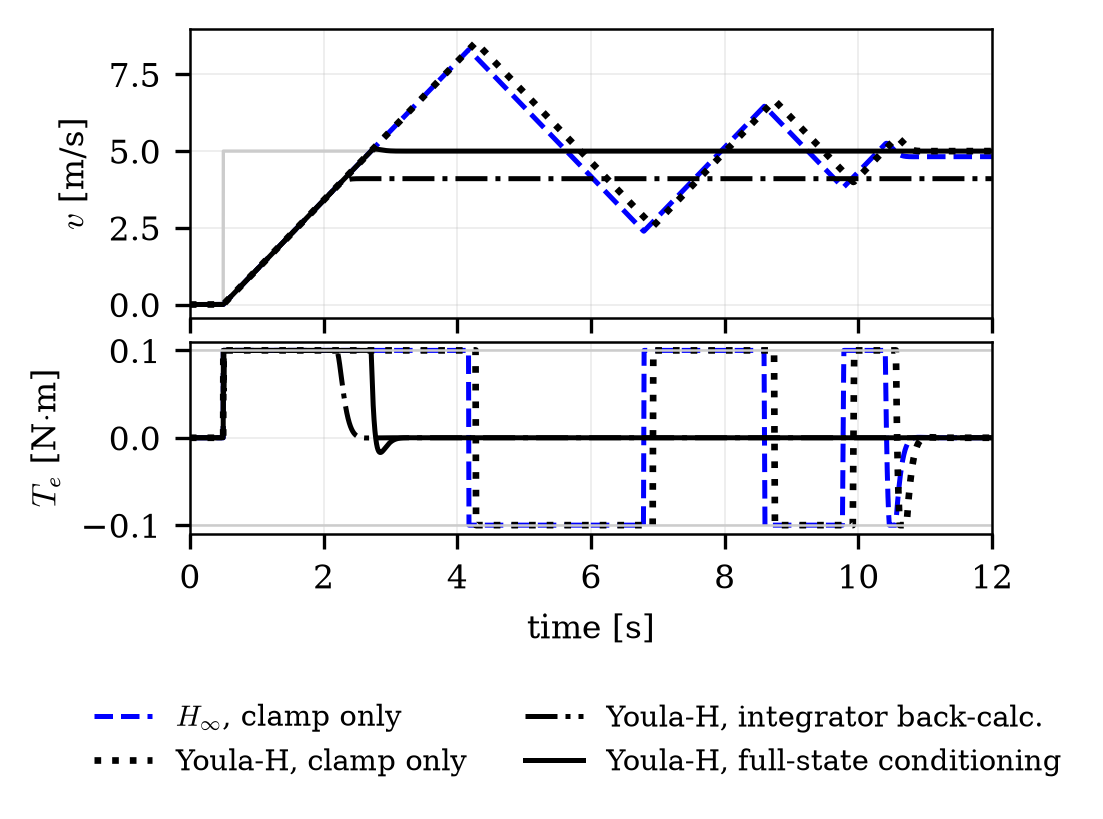
papers/A_Practical_Youla_Gain_Tuning_Framework_for_H__Controller_Realization/antiwindup_study/figures/python/YH-AW-18.png
