Tangineering/DC-Balancer-Board-Teensy/papers/A_Practical_Youla_Gain_Tuning_Framework_for_H__Controller_Realization/Figures/compressed/H-TSY-18.png

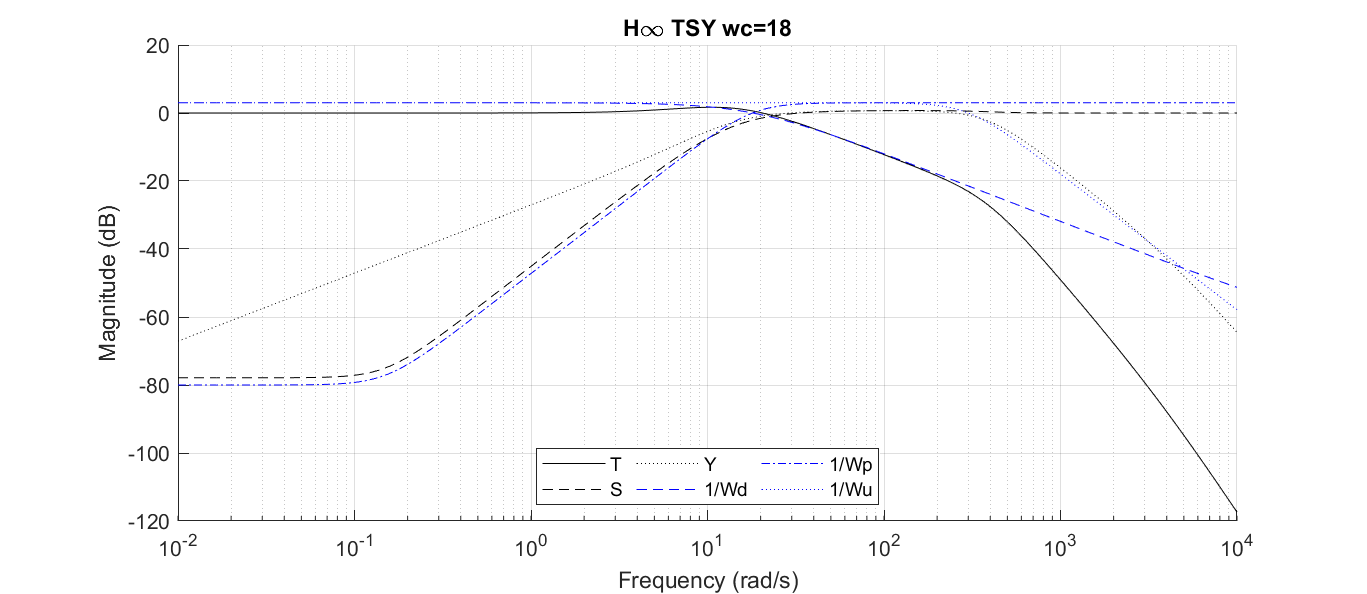
papers/A_Practical_Youla_Gain_Tuning_Framework_for_H__Controller_Realization/Figures/compressed/H-TSY-18.png
