Tangineering/DC-Balancer-Board-Teensy/references/EMS/matlab_governor_results.jpg

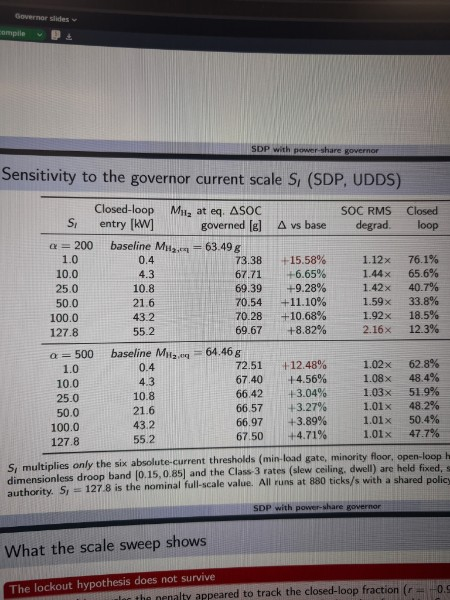
references/EMS/matlab_governor_results.jpg
