Tangineering/DC-Balancer-Board-Teensy/hardware/charger_evm_r8/fab/cr_2026-11-13/docs/cr-pcb.pdf

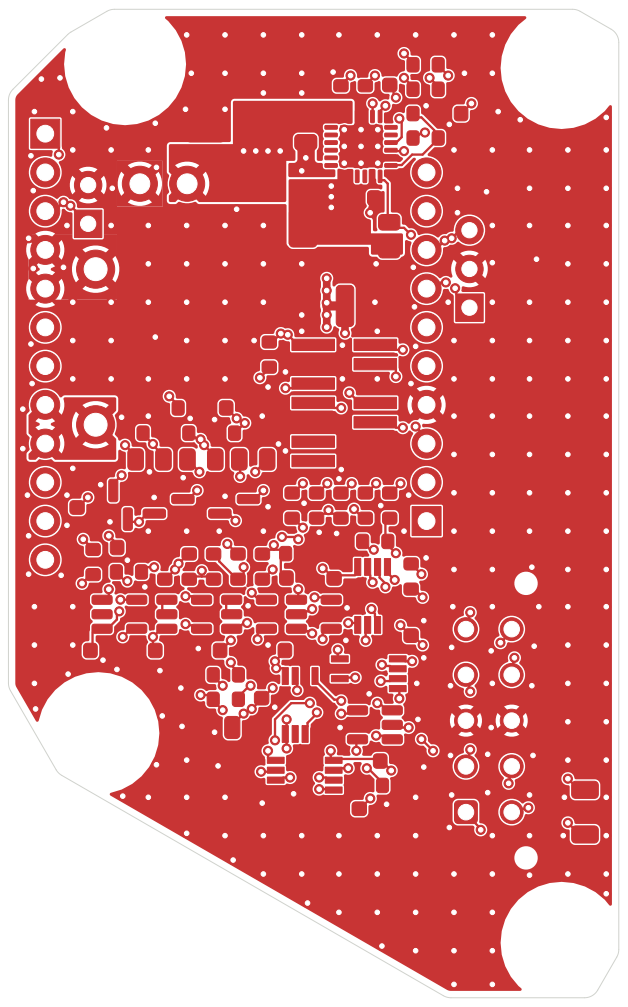
[picture p168: page 1]

Id: 1/10 Title: File: cr.kicad_pcb Sheet:

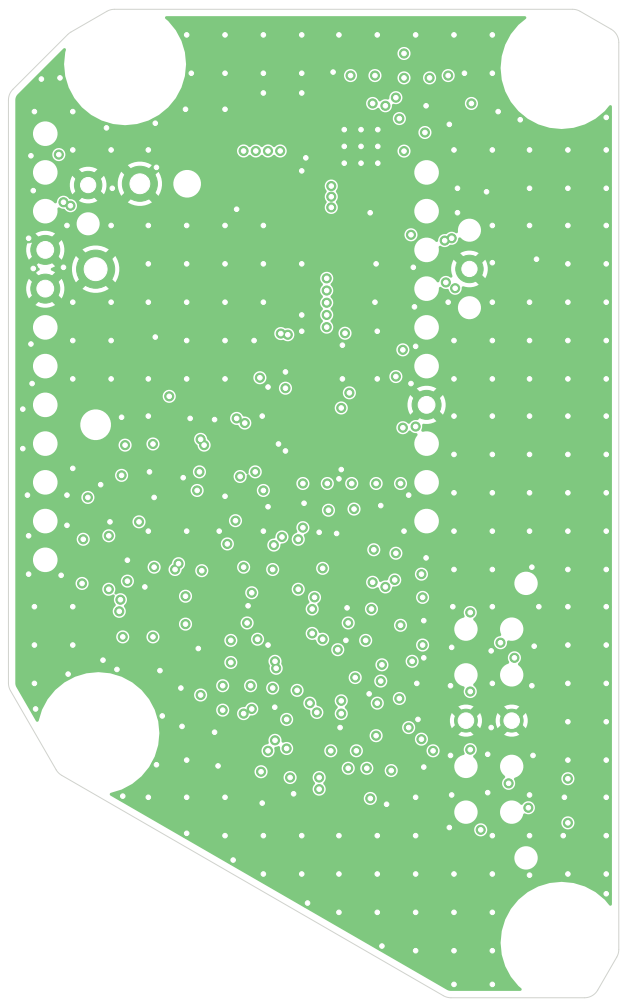
[picture p169: page 2]

Id: 2/10 Title: File: cr.kicad_pcb Sheet:

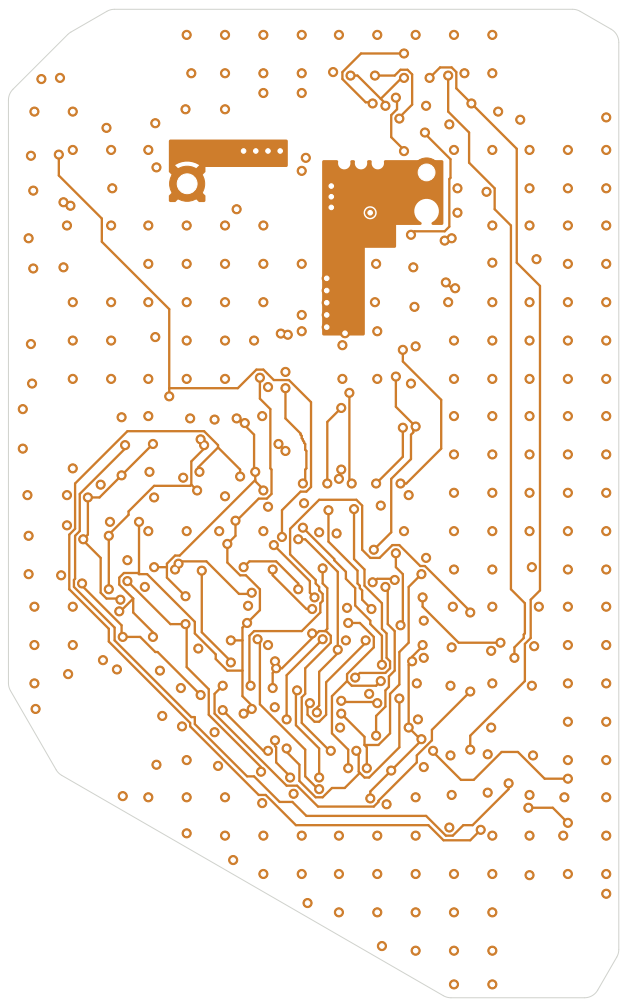
[picture p170: page 3]

Id: 3/10 Title: File: cr.kicad_pcb Sheet:

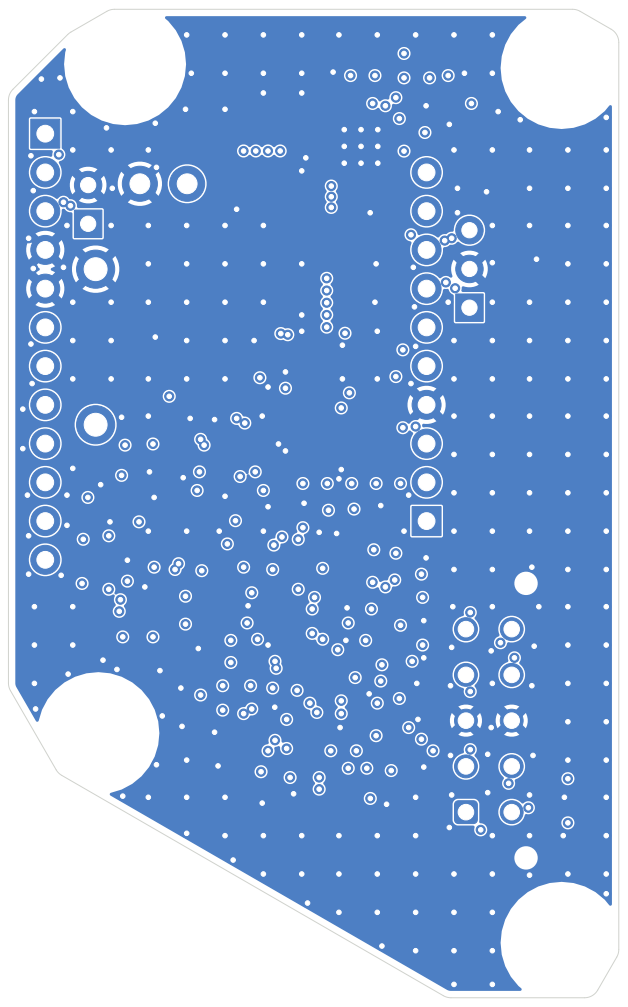
[picture p171: page 4]

Id: 4/10 Title: File: cr.kicad_pcb Sheet:

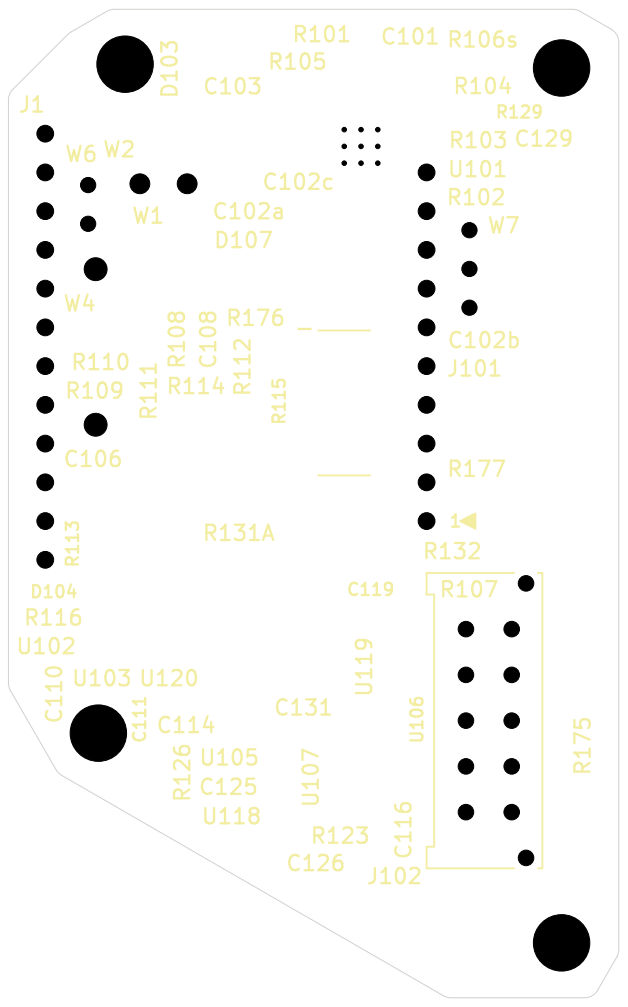
[picture p172: page 5]

Id: 5/10 Title: File: cr.kicad_pcb Sheet:

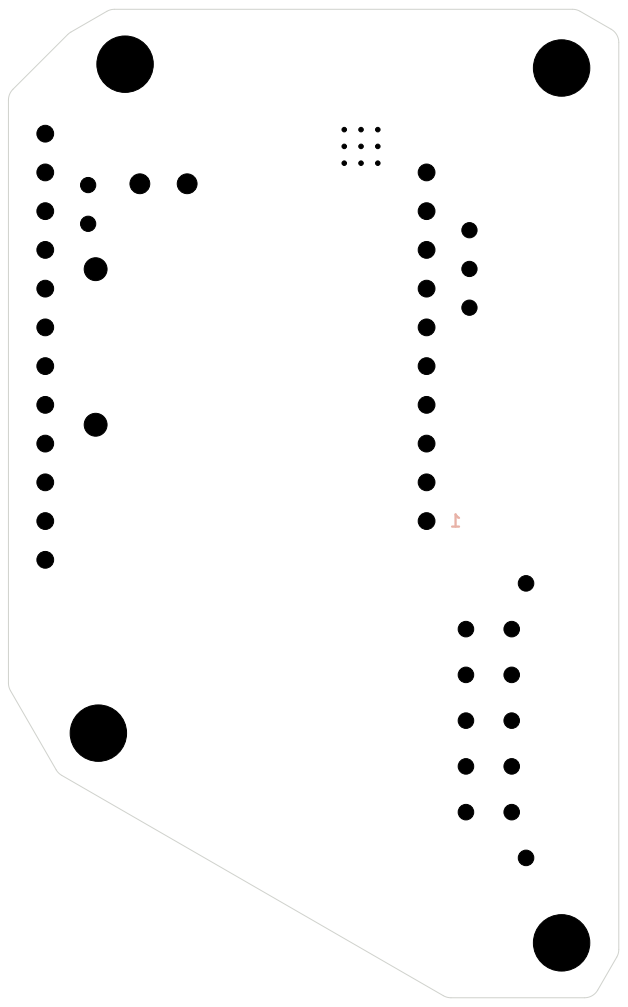
[picture p173: page 6]

Id: 6/10 Title: File: cr.kicad_pcb Sheet:

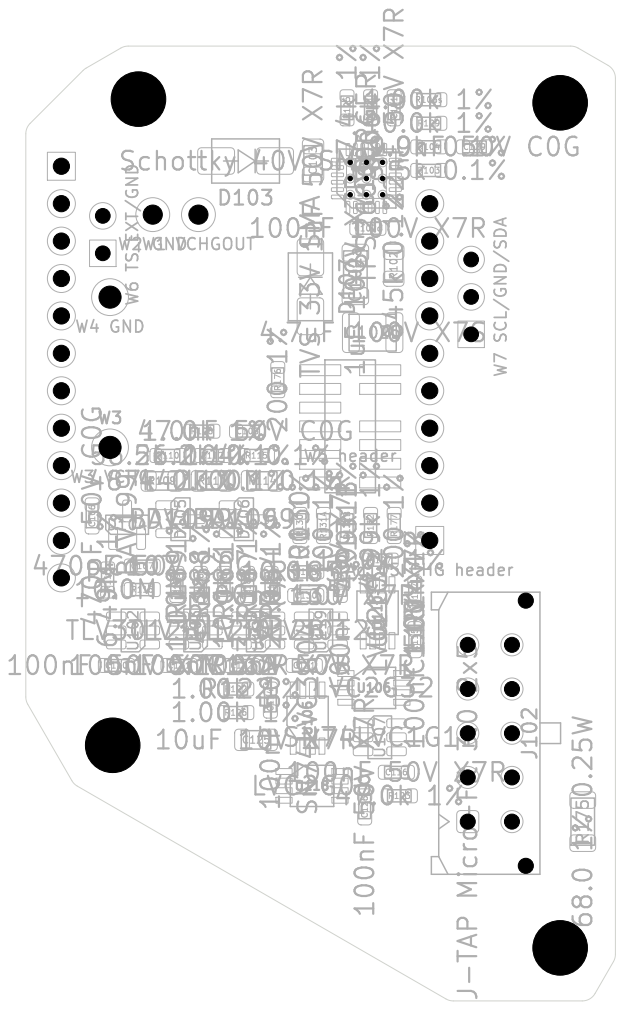
[picture p174: page 7]

Id: 7/10 Title: File: cr.kicad_pcb Sheet:

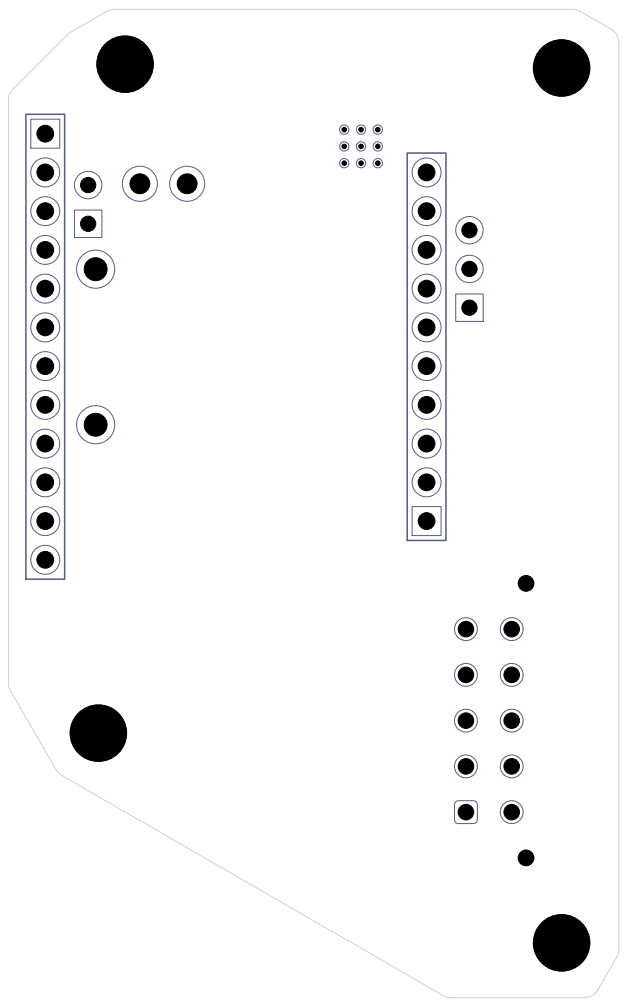
[picture p175: page 8]

Id: 8/10 Title: File: cr.kicad_pcb Sheet:

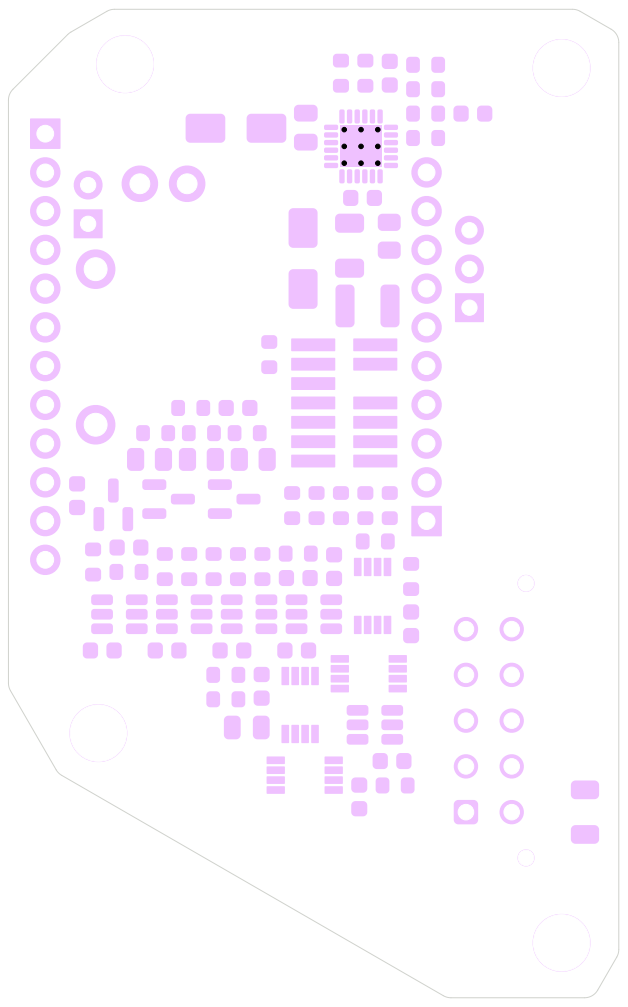
[picture p176: page 9]

Id: 9/10 Title: File: cr.kicad_pcb Sheet:

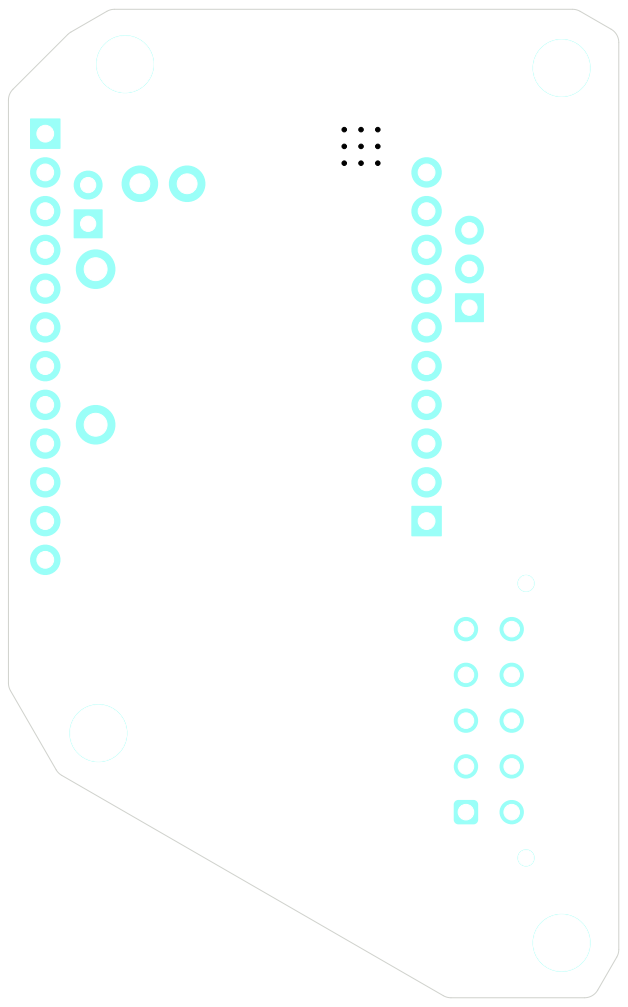
[picture p177: page 10]

Id: 10/10 Title: File: cr.kicad_pcb Sheet:
