Tangineering/DC-Balancer-Board-Teensy/hardware/charger_evm_r8/fab/cr_2026-11-13/docs/cr-schematic.pdf

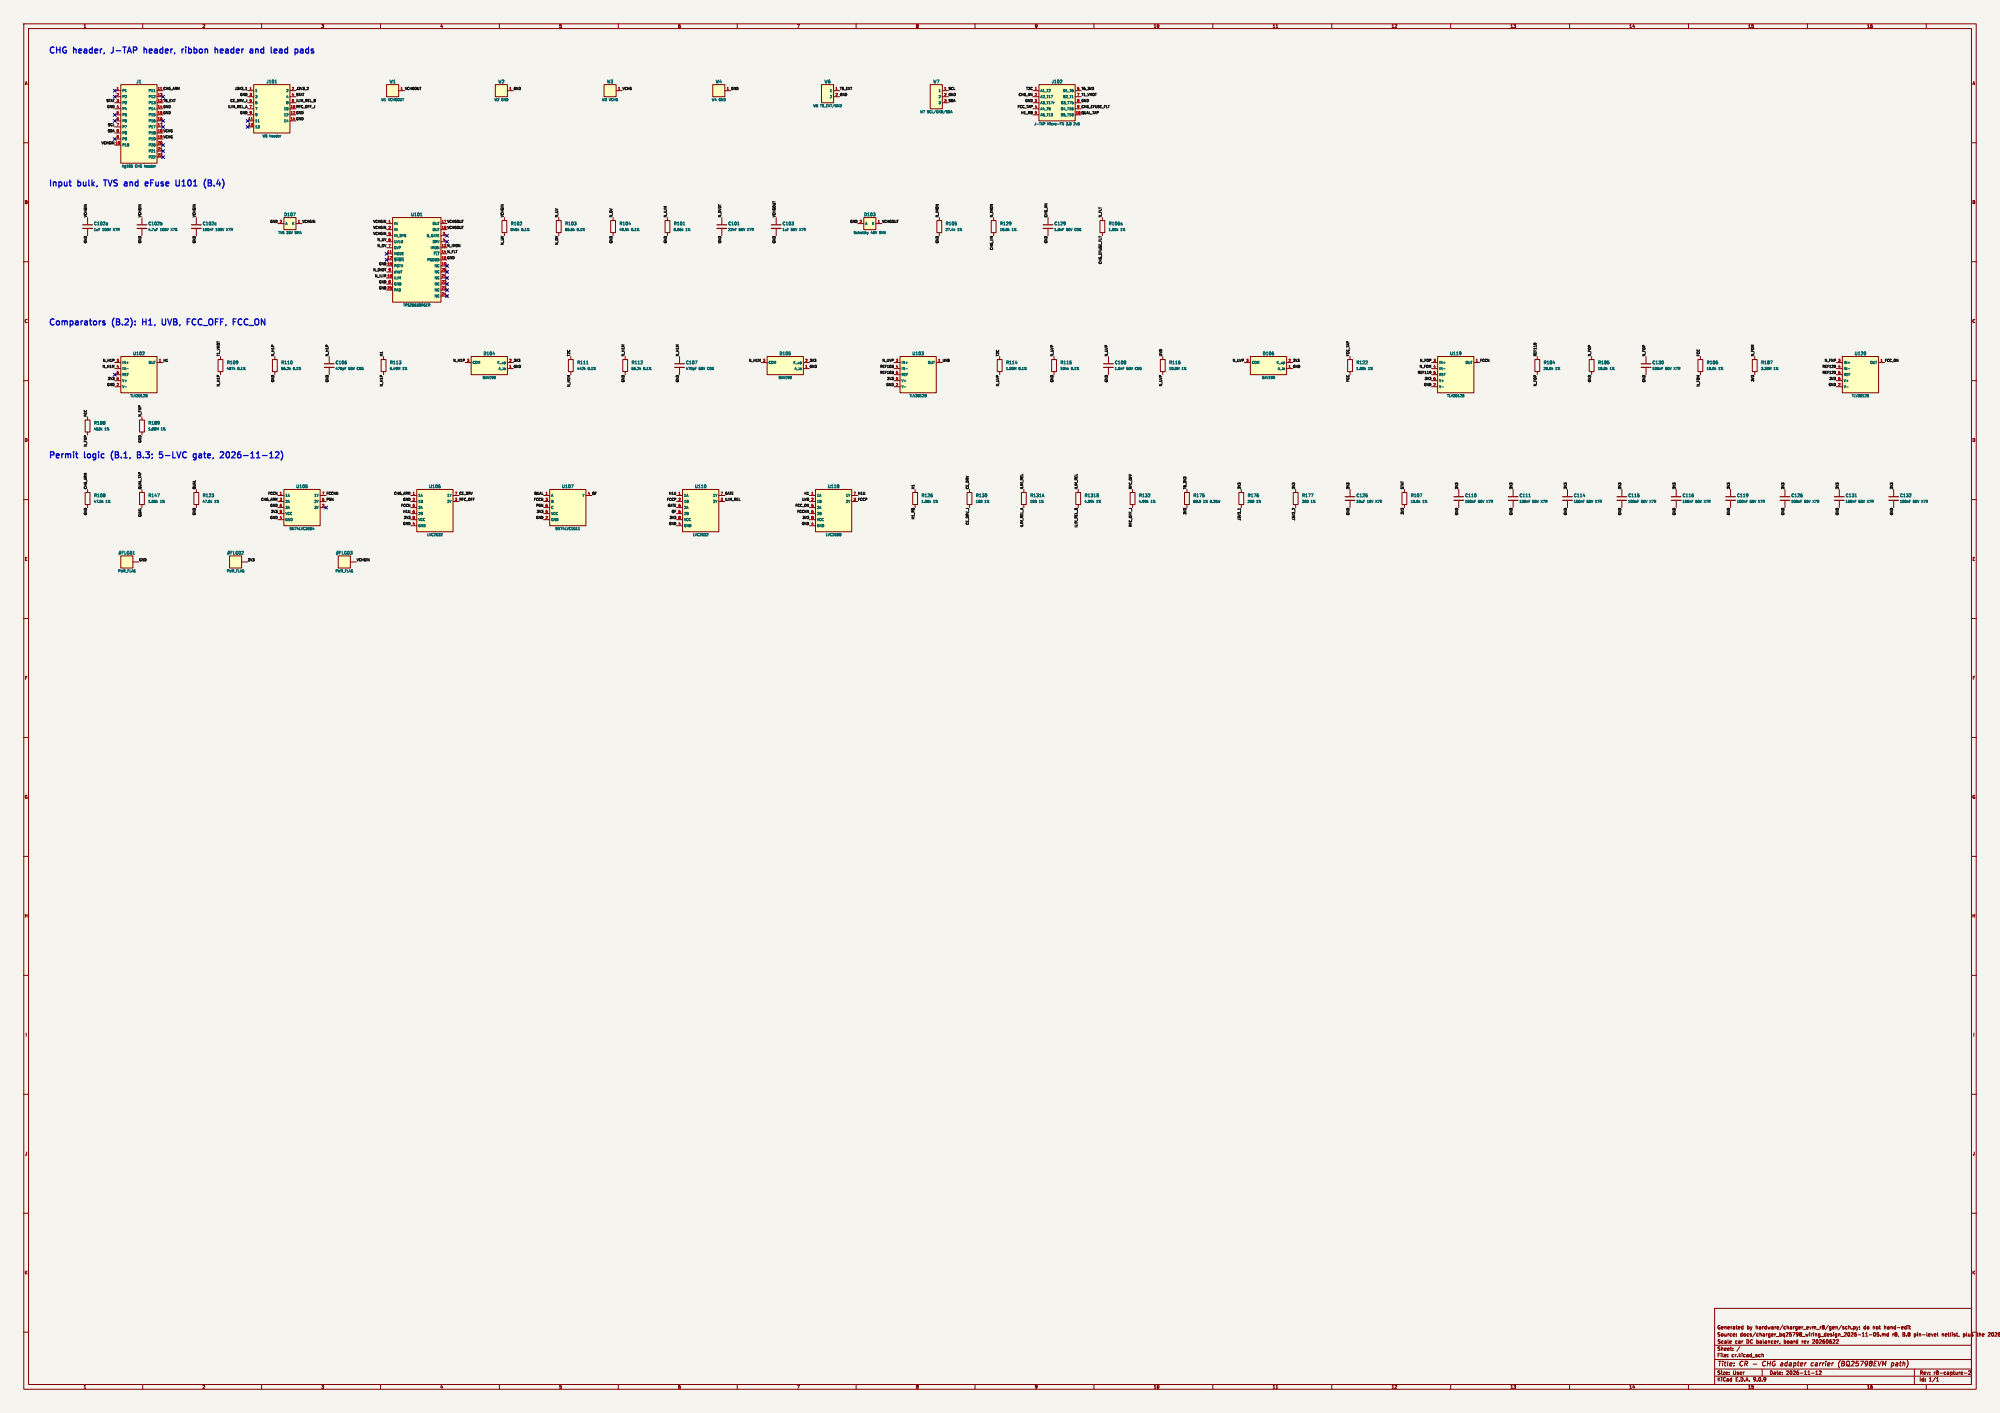
[picture p178: page 1]

CHG header, J-TAP header, ribbon header and lead pads

Input bulk, TVS and eFuse U101 (B.4)

IMON 13 ~{FLT}14 PGOOD 16 NC 19 NC 20 NC 21 NC 22 NC 23 NC 24 U101
GND GND GNDH1 VCHGIN

IN_SYS 5 UVLO 6 OVP 7 MODE 11 ~{SHDN} 12 PGTH 15
