Tangineering/DC-Balancer-Board-Teensy/hardware/charger_evm_r8/fab/eib_2026-11-11/docs/eib-pcb.pdf

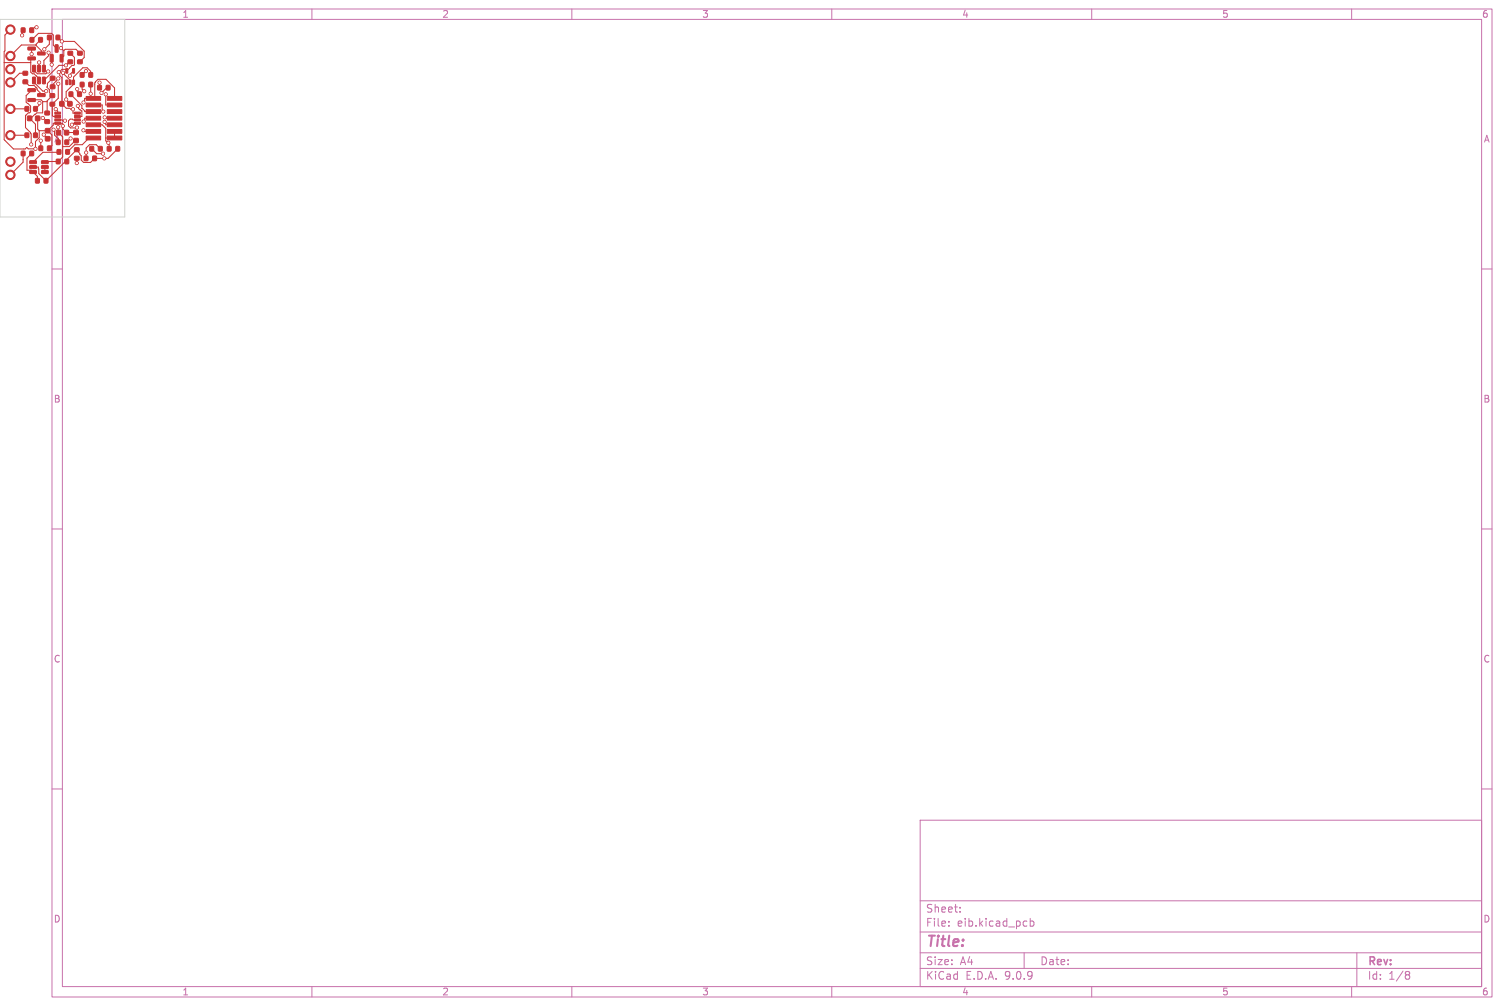
[picture p179: page 1]

Id: 1/8 Title: File: eib.kicad_pcb Sheet:

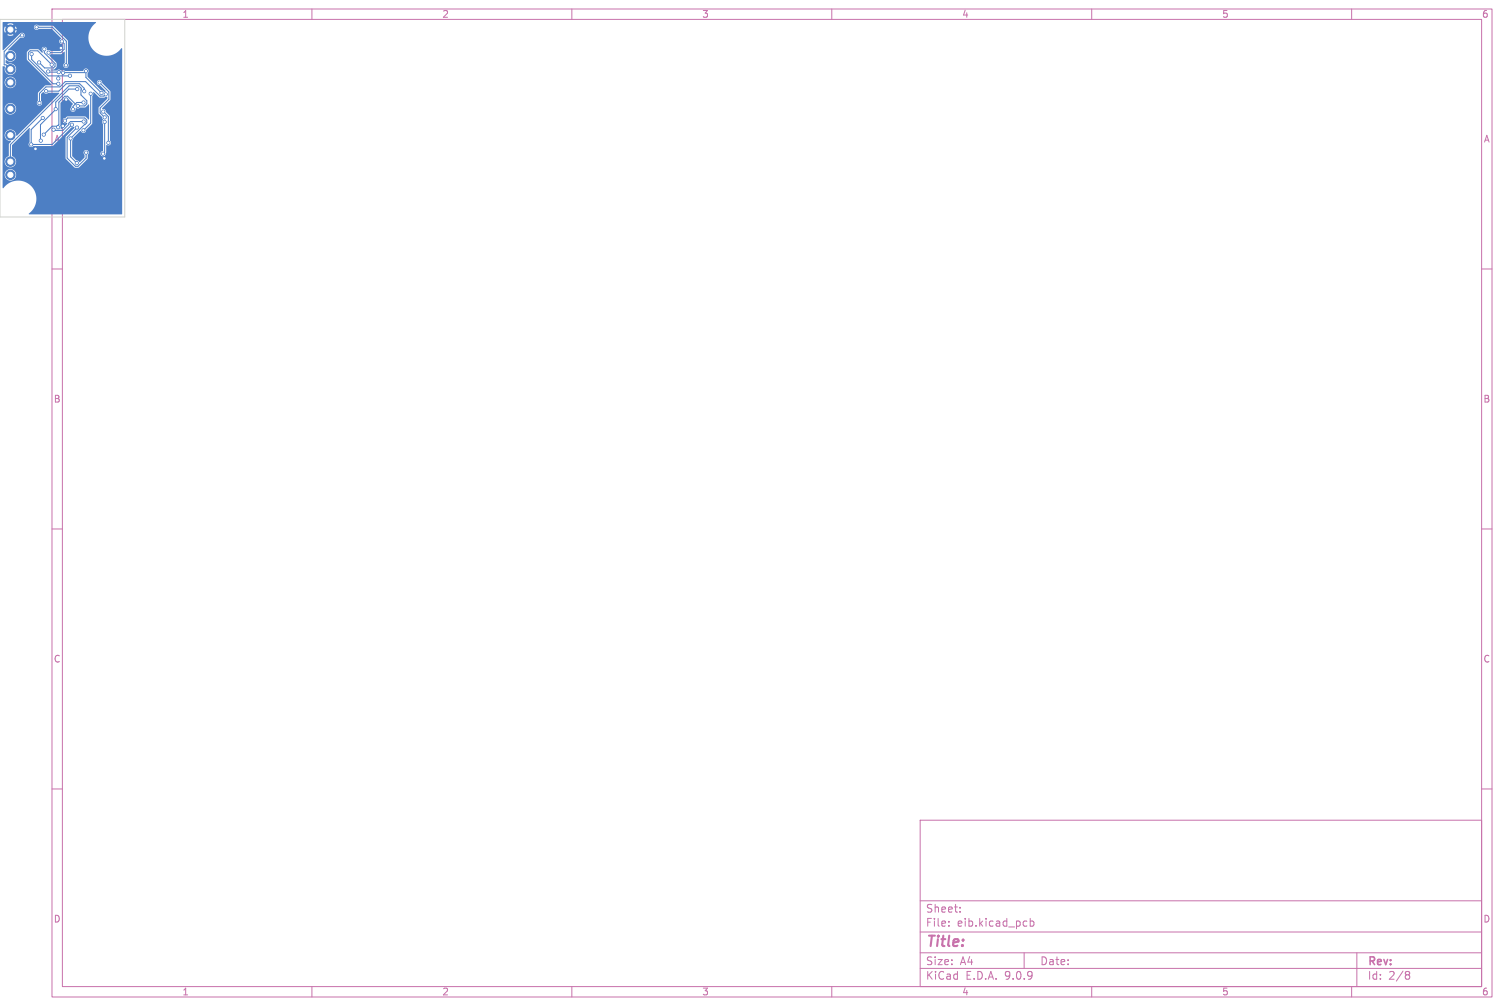
[picture p180: page 2]

Id: 2/8 Title: File: eib.kicad_pcb Sheet:

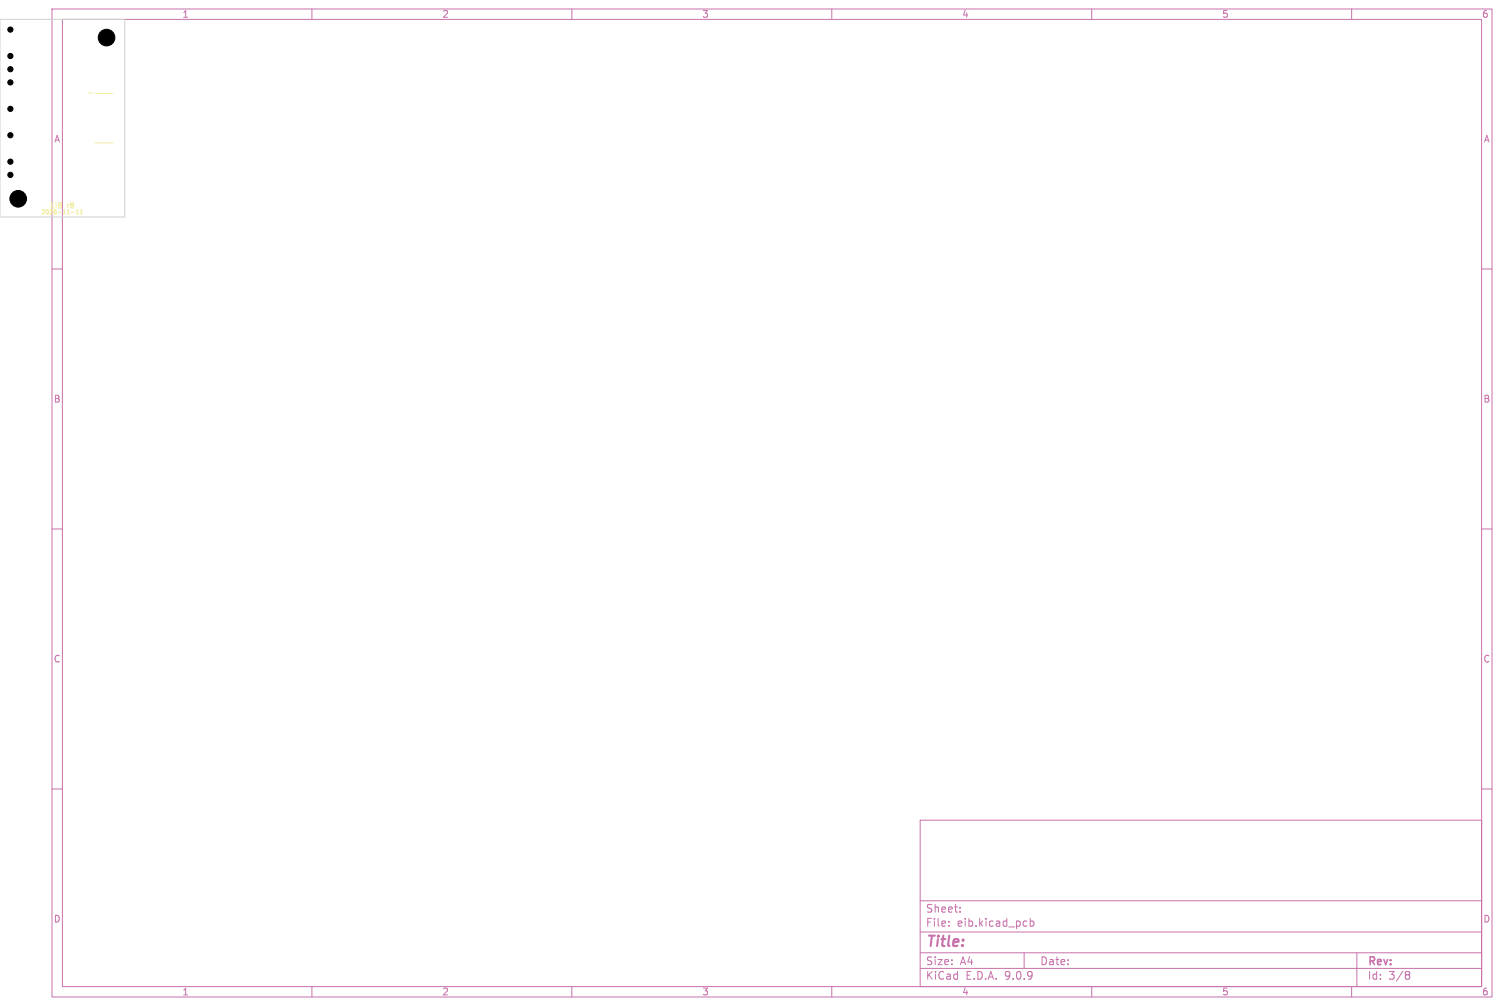
[picture p181: page 3]

Id: 3/8 Title: File: eib.kicad_pcb Sheet:

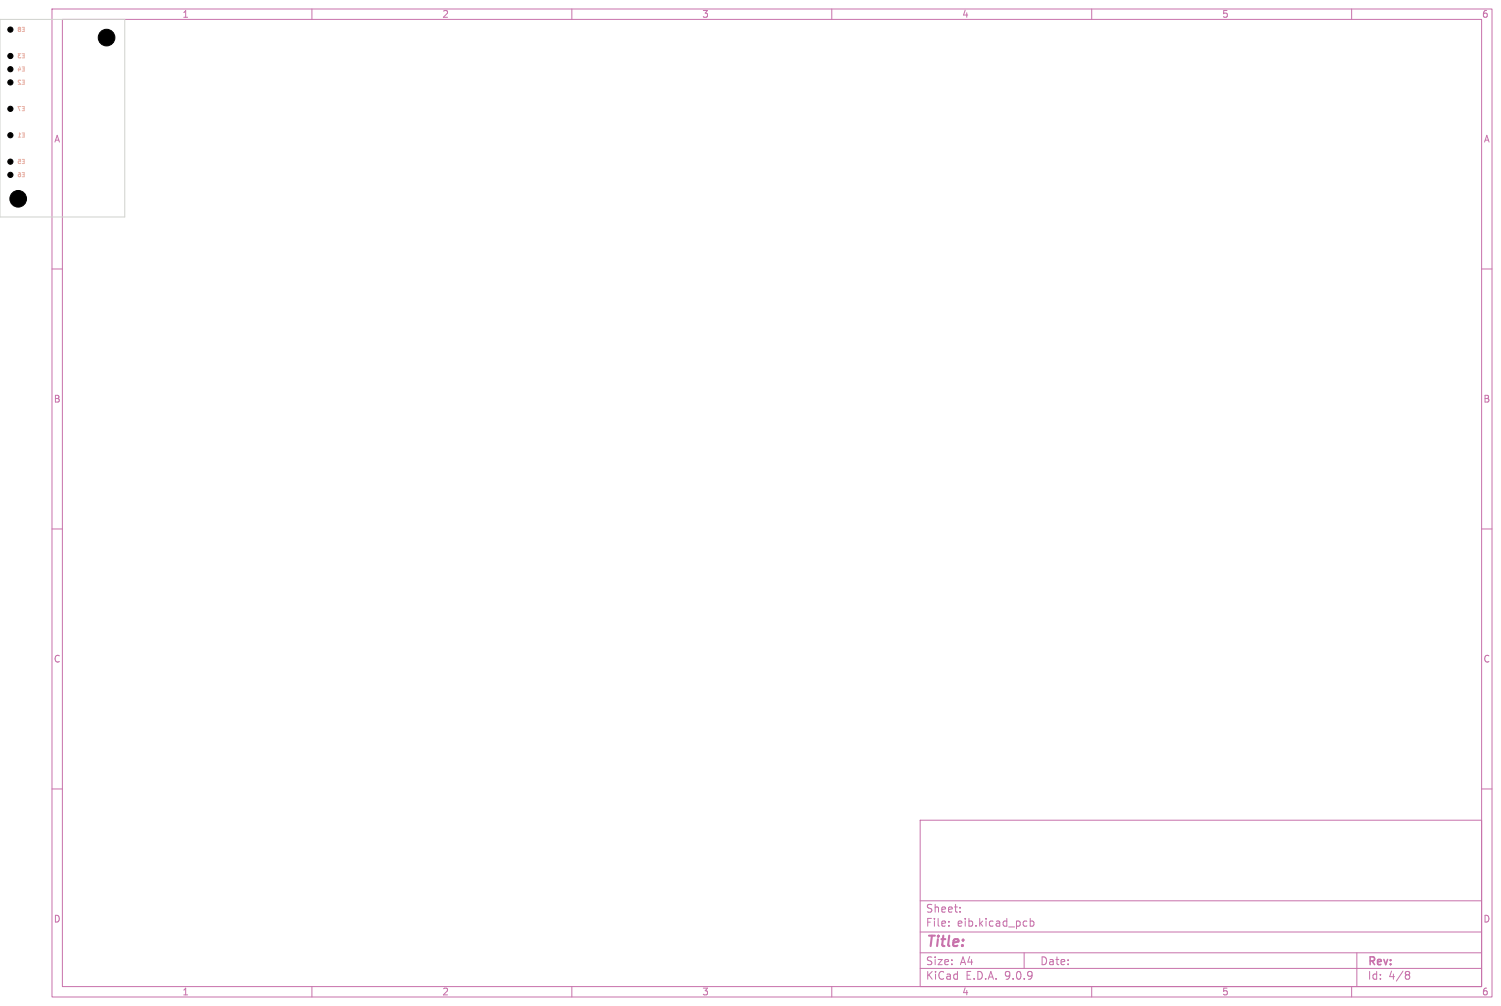
[picture p182: page 4]

Id: 4/8 Title: File: eib.kicad_pcb Sheet:

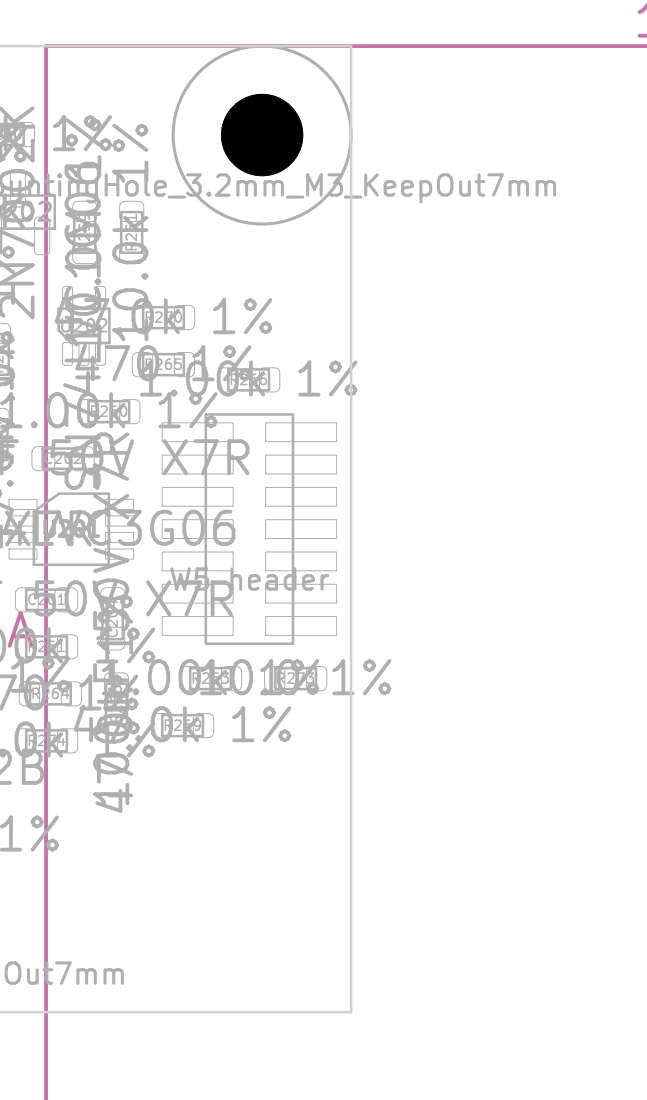
[picture p183: page 5]

Id: 5/8 Title: File: eib.kicad_pcb Sheet:

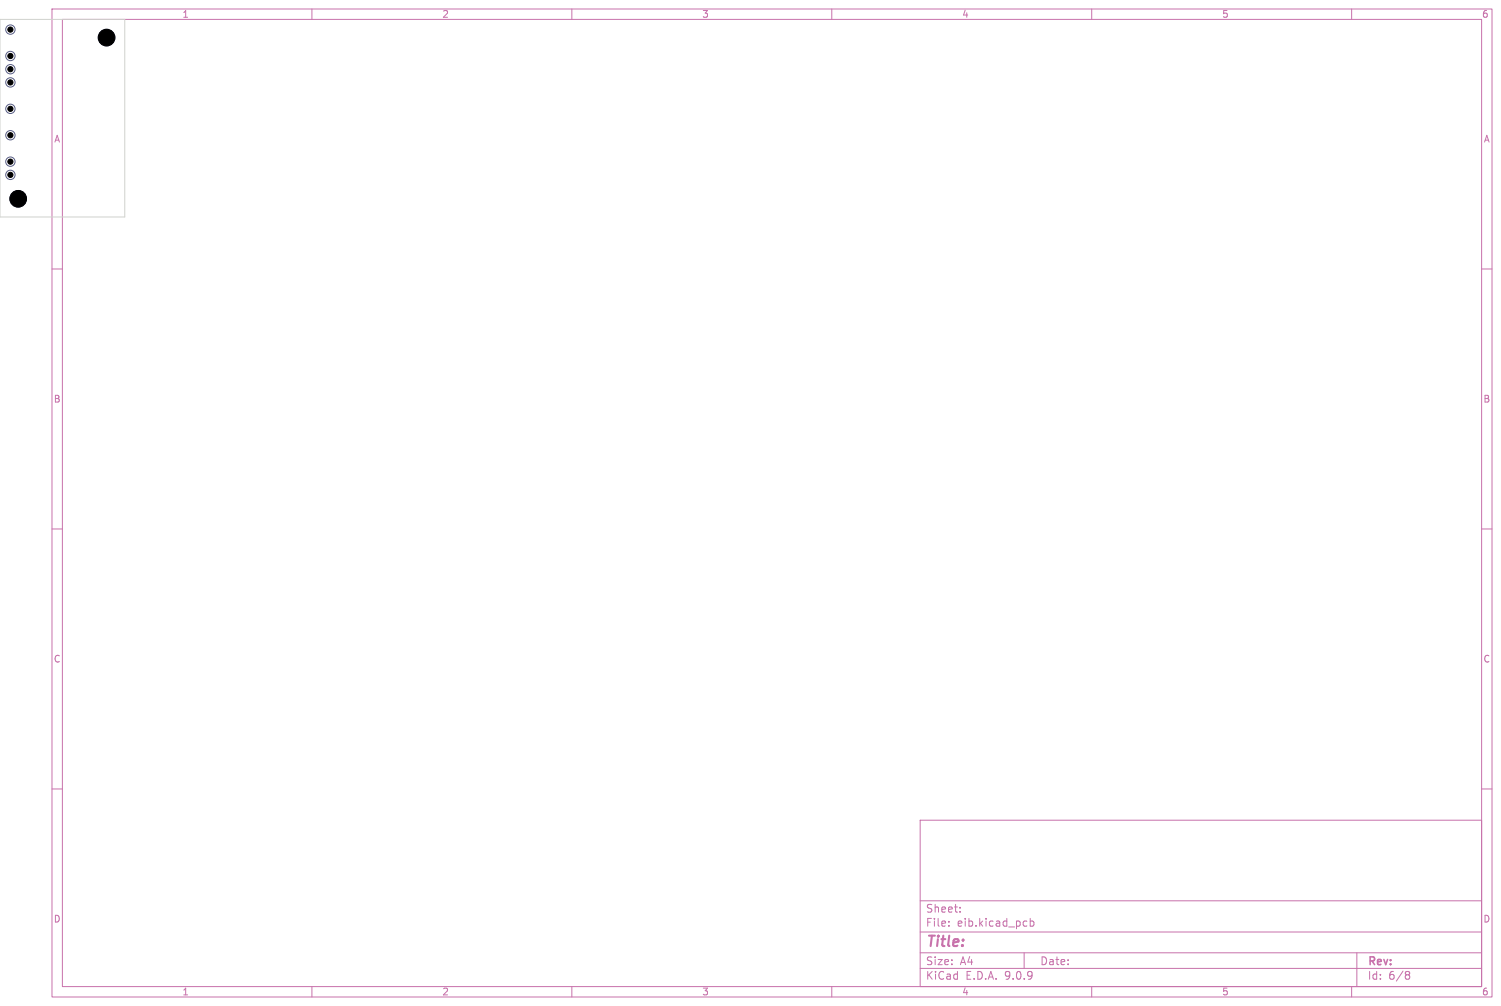
[picture p184: page 6]

Id: 6/8 Title: File: eib.kicad_pcb Sheet:

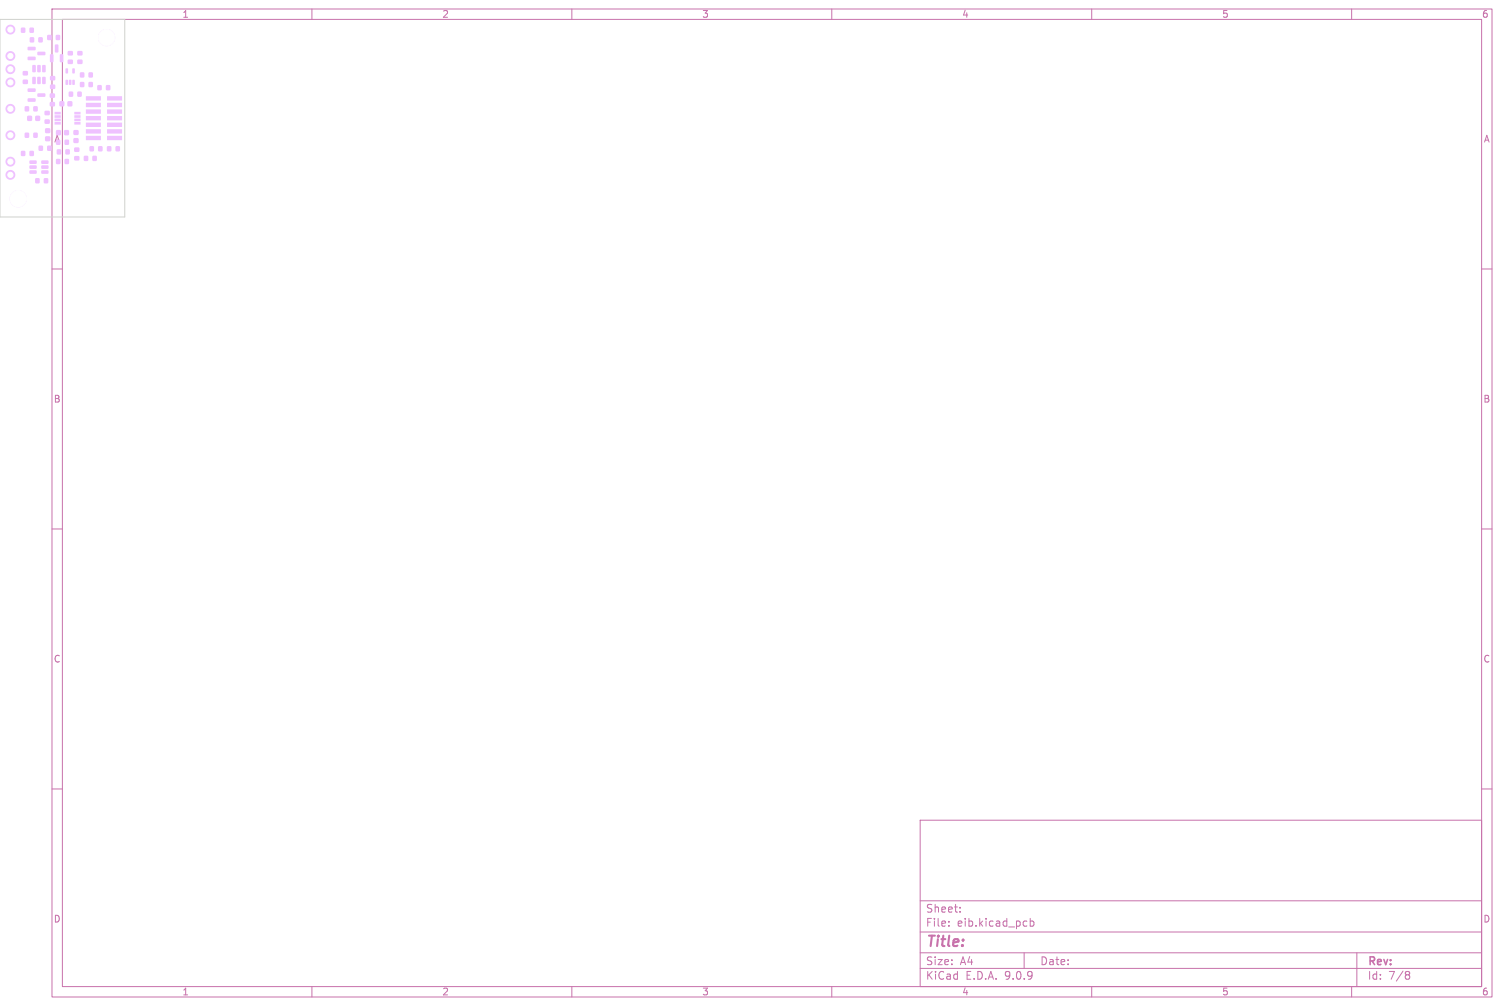
[picture p185: page 7]

Id: 7/8 Title: File: eib.kicad_pcb Sheet:

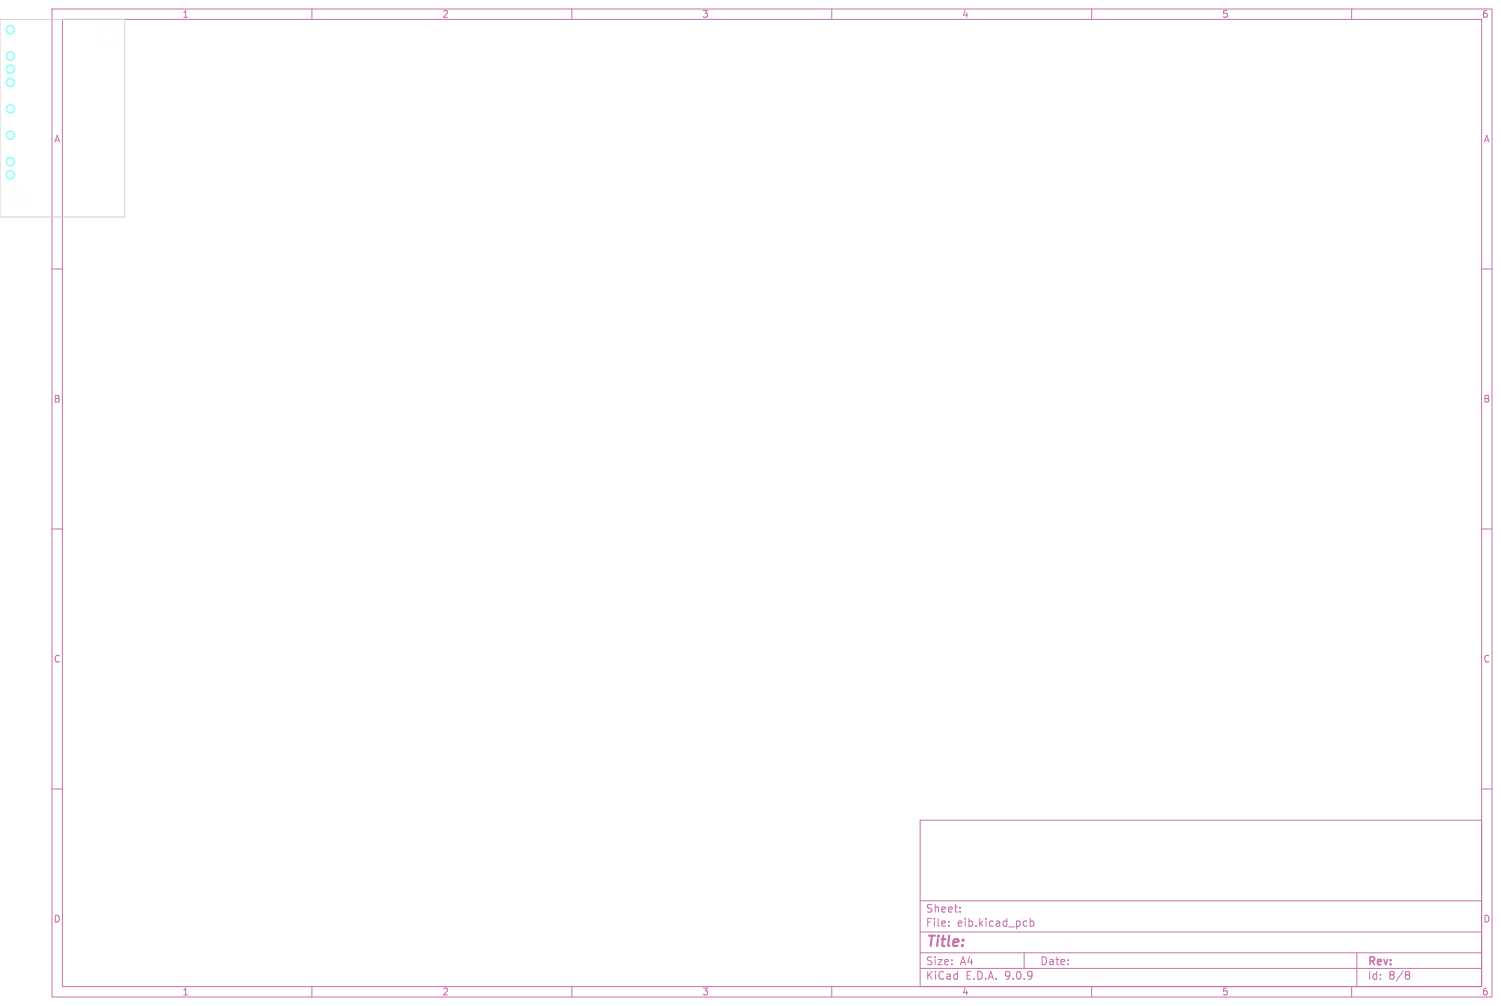
[picture p186: page 8]

Id: 8/8 Title: File: eib.kicad_pcb Sheet:
