Tangineering/DC-Balancer-Board-Teensy/hardware/charger_evm_r8/fab/eib_2026-11-11/docs/eib-schematic.pdf

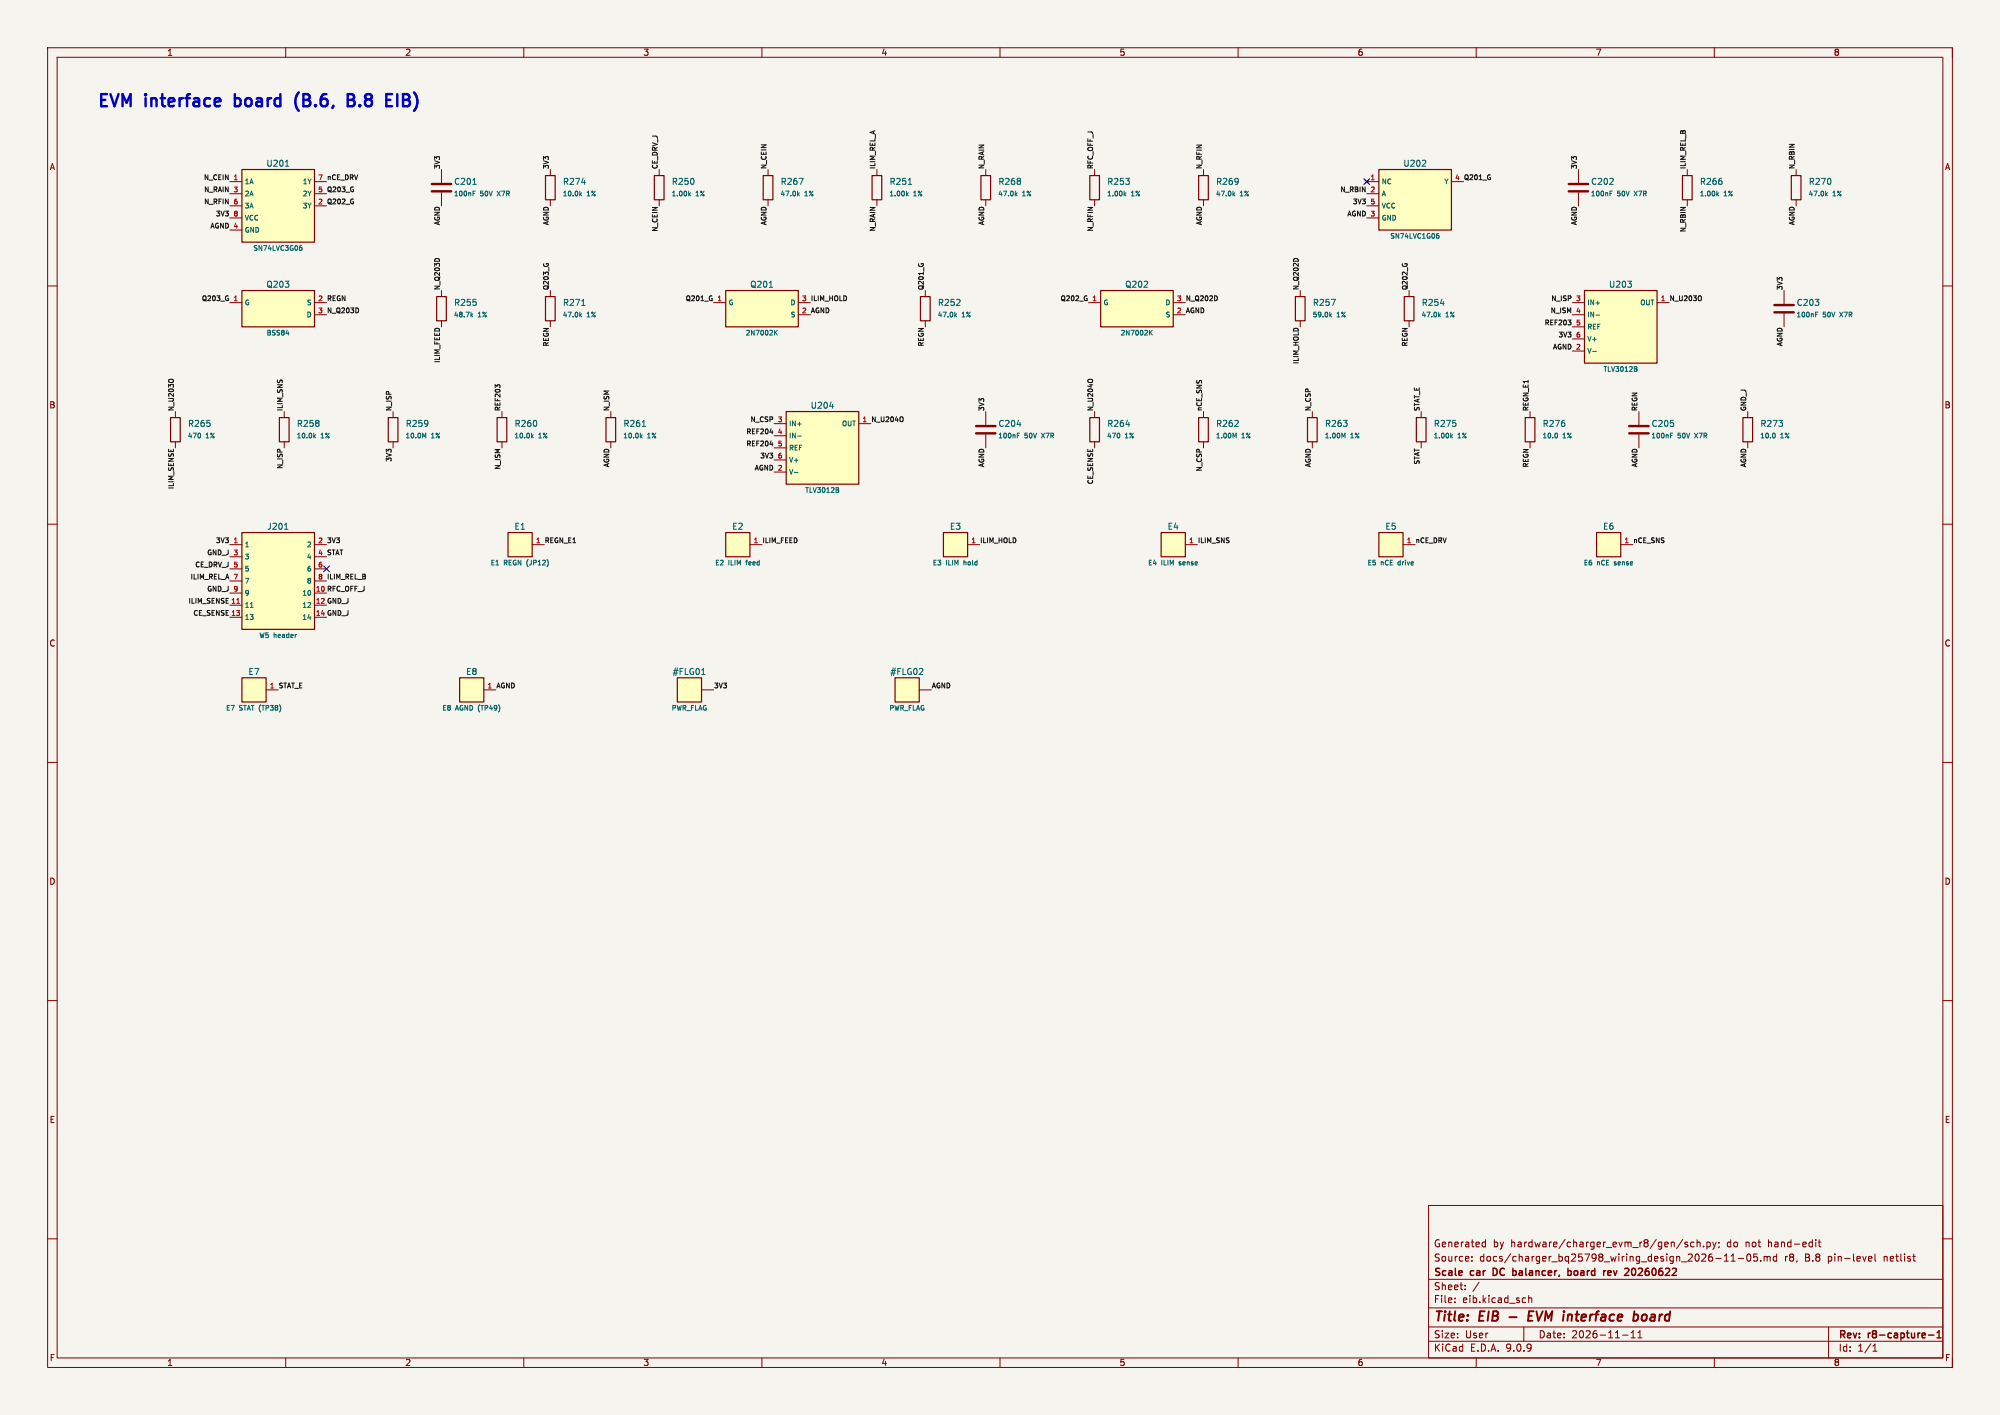
[picture p187: page 1]

EVM interface board (B.6, B.8 EIB)

Id: 1/1 Title: EIB - EVM interface board
