Tangineering/DC-Balancer-Board-Teensy/papers/MIMO_Droop_Drive_Comparison/Figures/fig_transient_small.pdf

# ΔV0 = +0.4 V

# ΔV0 = −0.4 V

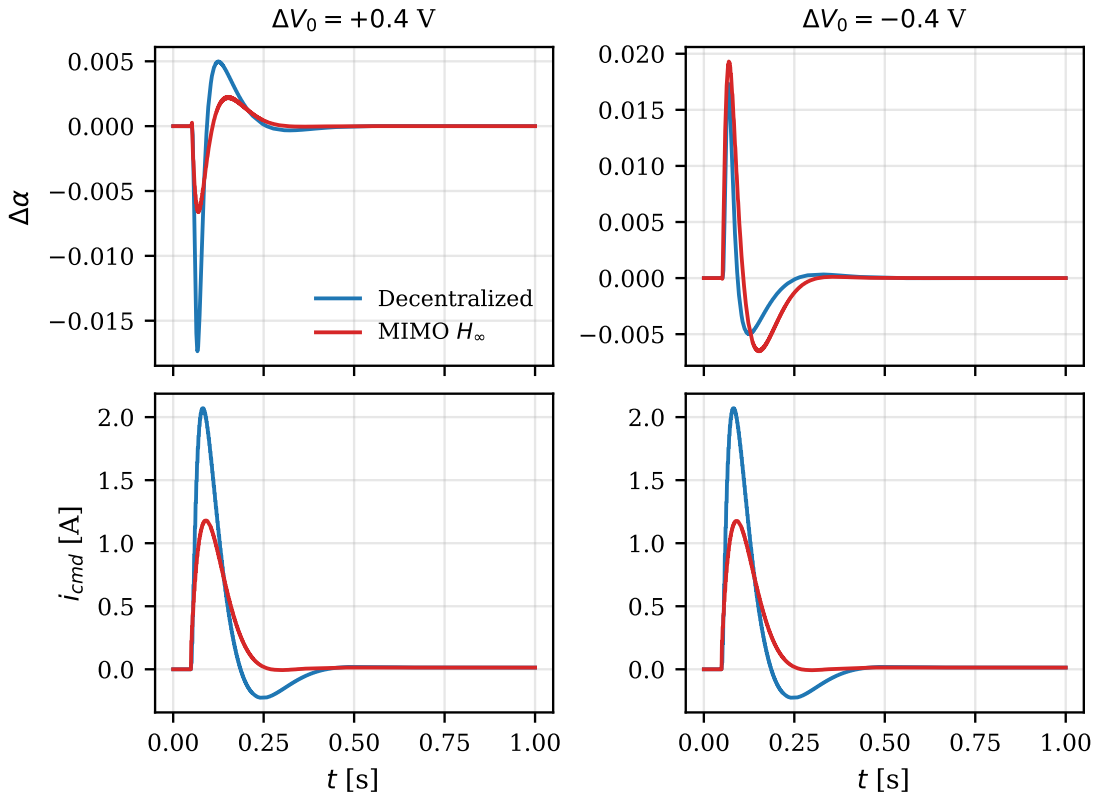
[picture p188: page 1]
Decentralized; MIMO H∞; icmd [A]
