Tangineering/DC-Balancer-Board-Teensy/papers/Droop_Control/Figures/loopshapes_youla_h.pdf

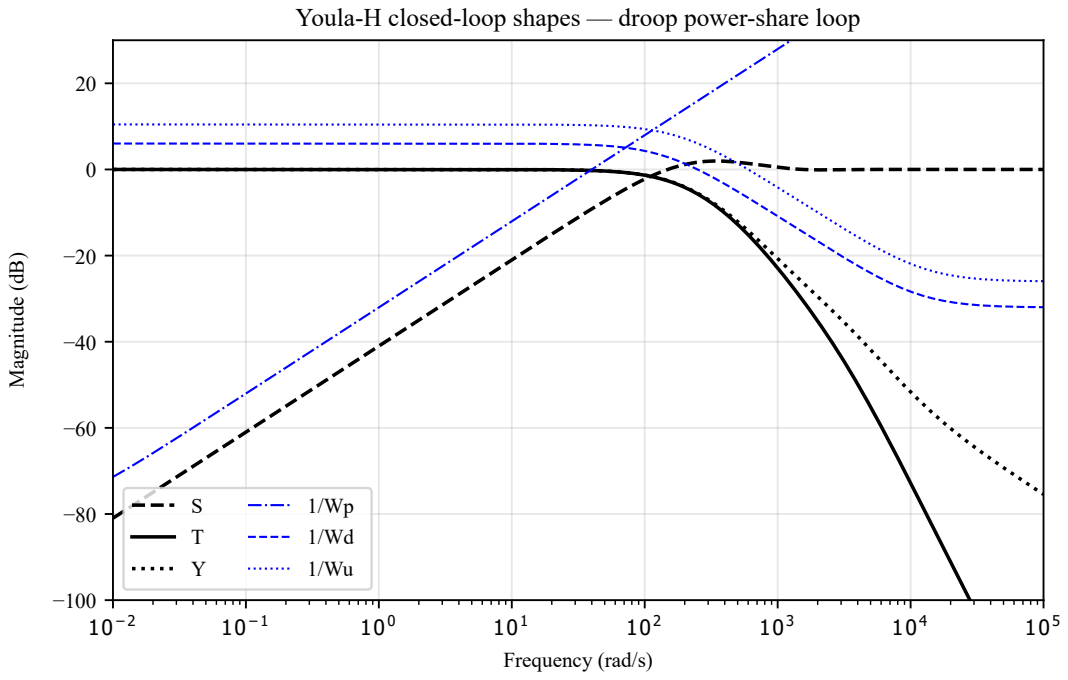
[picture p189: page 1]
Frequency (rad/s); Magnitude (dB)

Youla-H closed-loop shapes — droop power-share loop

S | 1/Wp
T Y | 1/Wd 1/Wu
