Tangineering/DC-Balancer-Board-Teensy/papers/A_Practical_Youla_Gain_Tuning_Framework_for_H__Controller_Realization/antiwindup_study/figures/YH-AW-18.pdf

### Drivetrain wc=18: Saturated Step Response

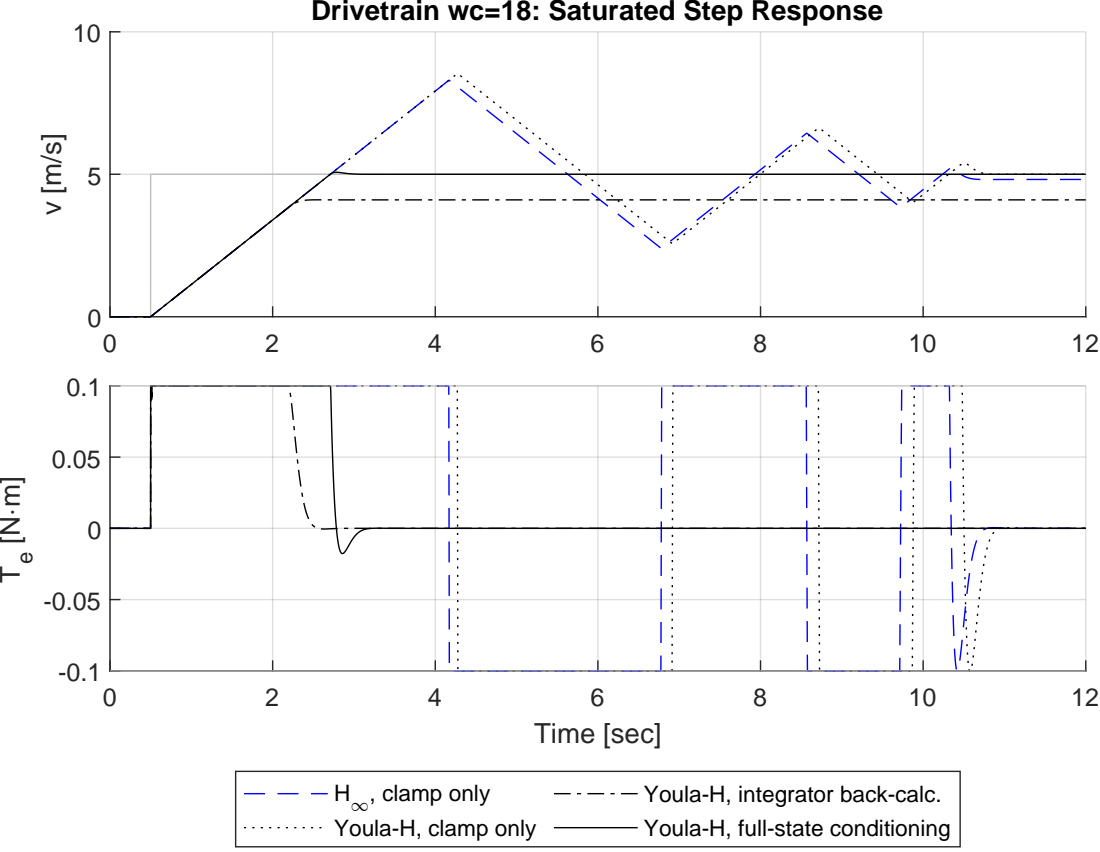
[picture p190: page 1]
Time [sec]; , clamp only

Youla-H, clamp only

Youla-H, integrator back-calc.
Youla-H, full-state conditioning
