Tangineering/DC-Balancer-Board-Teensy/papers/A_Practical_Youla_Gain_Tuning_Framework_for_H__Controller_Realization/antiwindup_study/figures/YH-AW-2nd.pdf

### Example Plant wc=1: Saturated Response

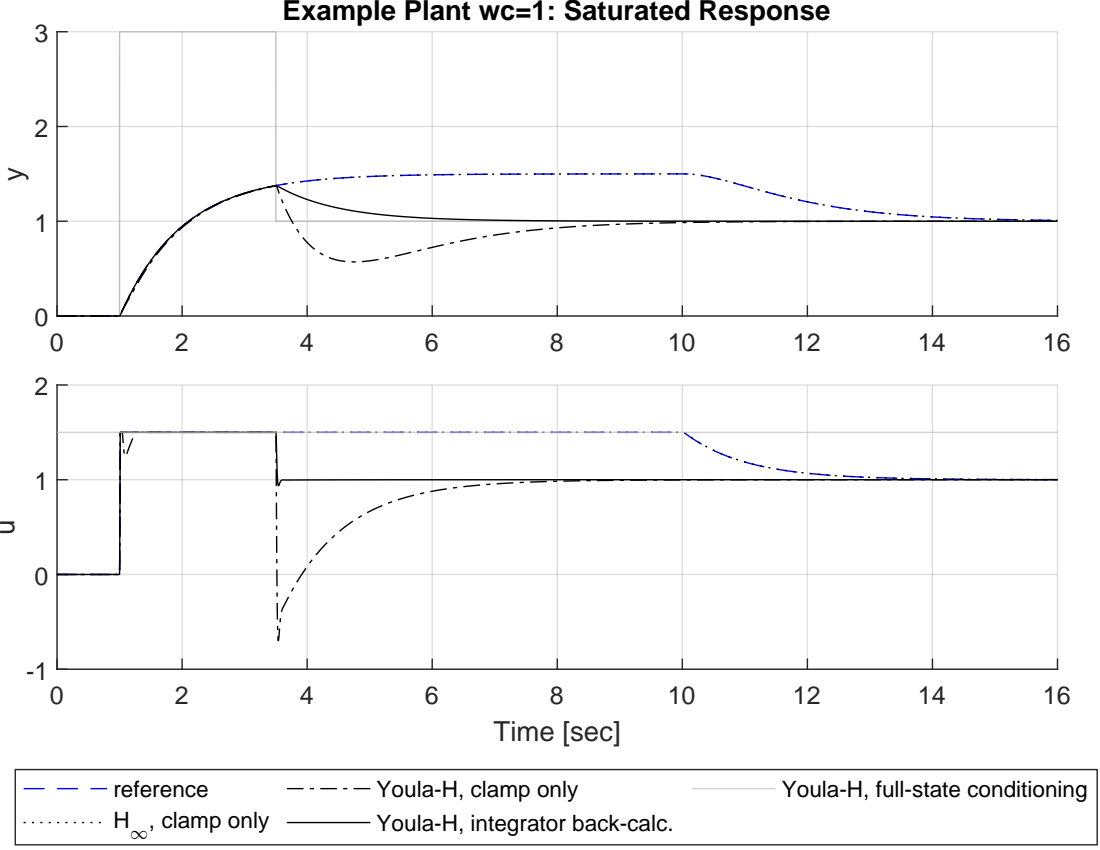
[picture p191: page 1]
Time [sec]; reference H1; , clamp only

Youla-H, clamp only
Youla-H, integrator back-calc.

Youla-H, full-state conditioning
