Tangineering/DC-Balancer-Board-Teensy/papers/A_Practical_Youla_Gain_Tuning_Framework_for_H__Controller_Realization/antiwindup_study/figures/YH-AW-3rd.pdf

### Example Plant wc=0.3: Saturated Response

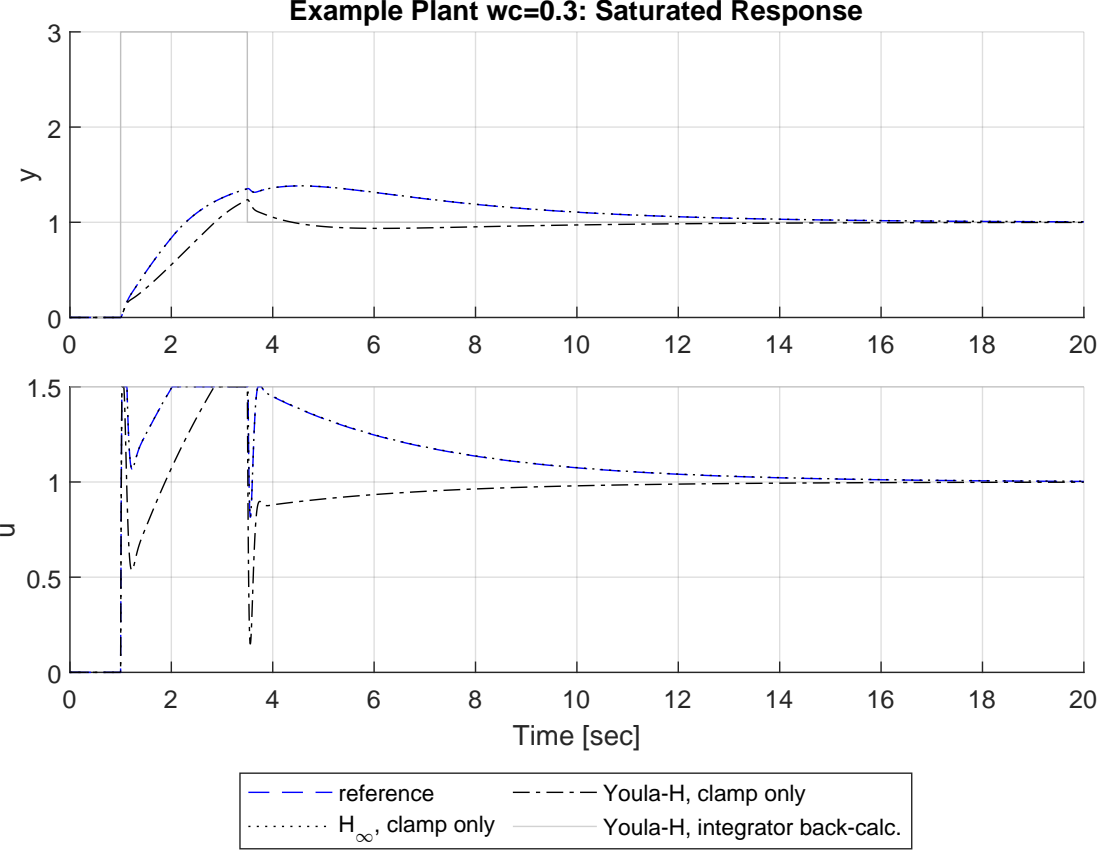
[picture p192: page 1]
Time [sec]; reference H1; , clamp only

Youla-H, clamp only
Youla-H, integrator back-calc.
