Tangineering/DC-Balancer-Board-Teensy/hardware/charger_evm_r8/eib/route_bot.pdf

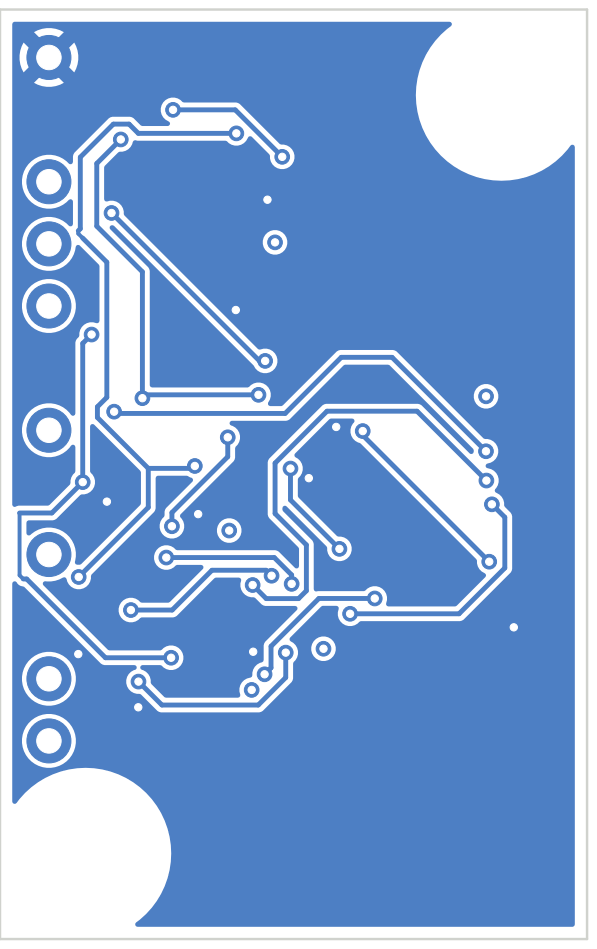
[picture p193: page 1]
