Tangineering/DC-Balancer-Board-Teensy/hardware/charger_evm_r8/eib/route_top.pdf

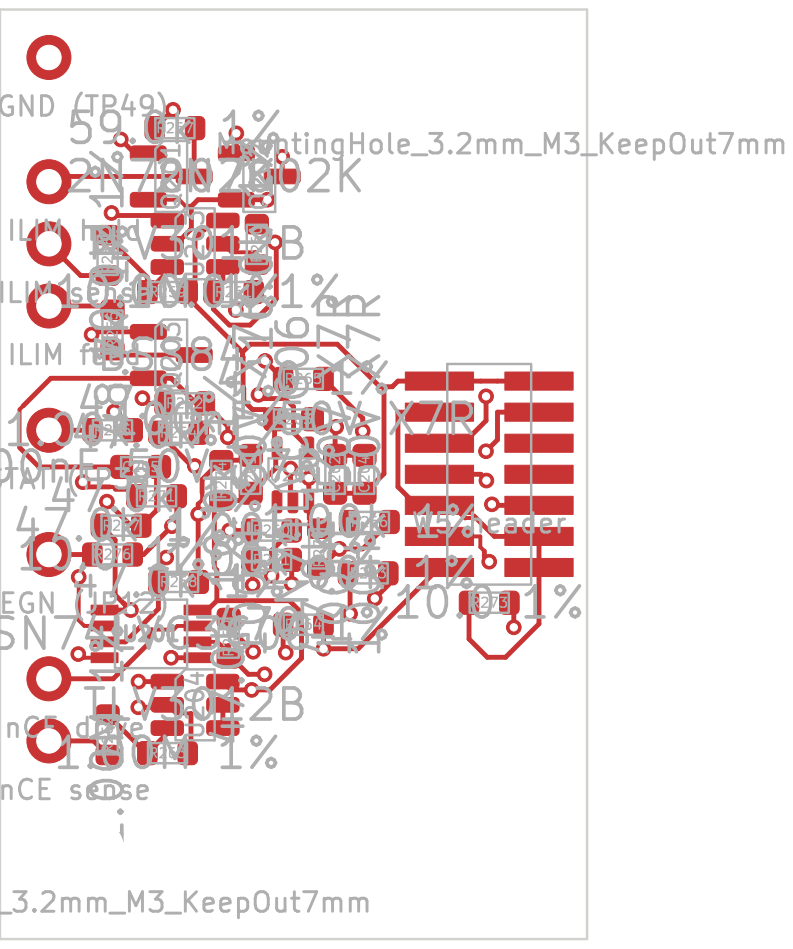
[picture p194: page 1]
