Tangineering/DC-Balancer-Board-Teensy/docs/reviews/charger_eval_2026-11-05/round4/work/evm/parts/onshore_ED120XDS.pdf

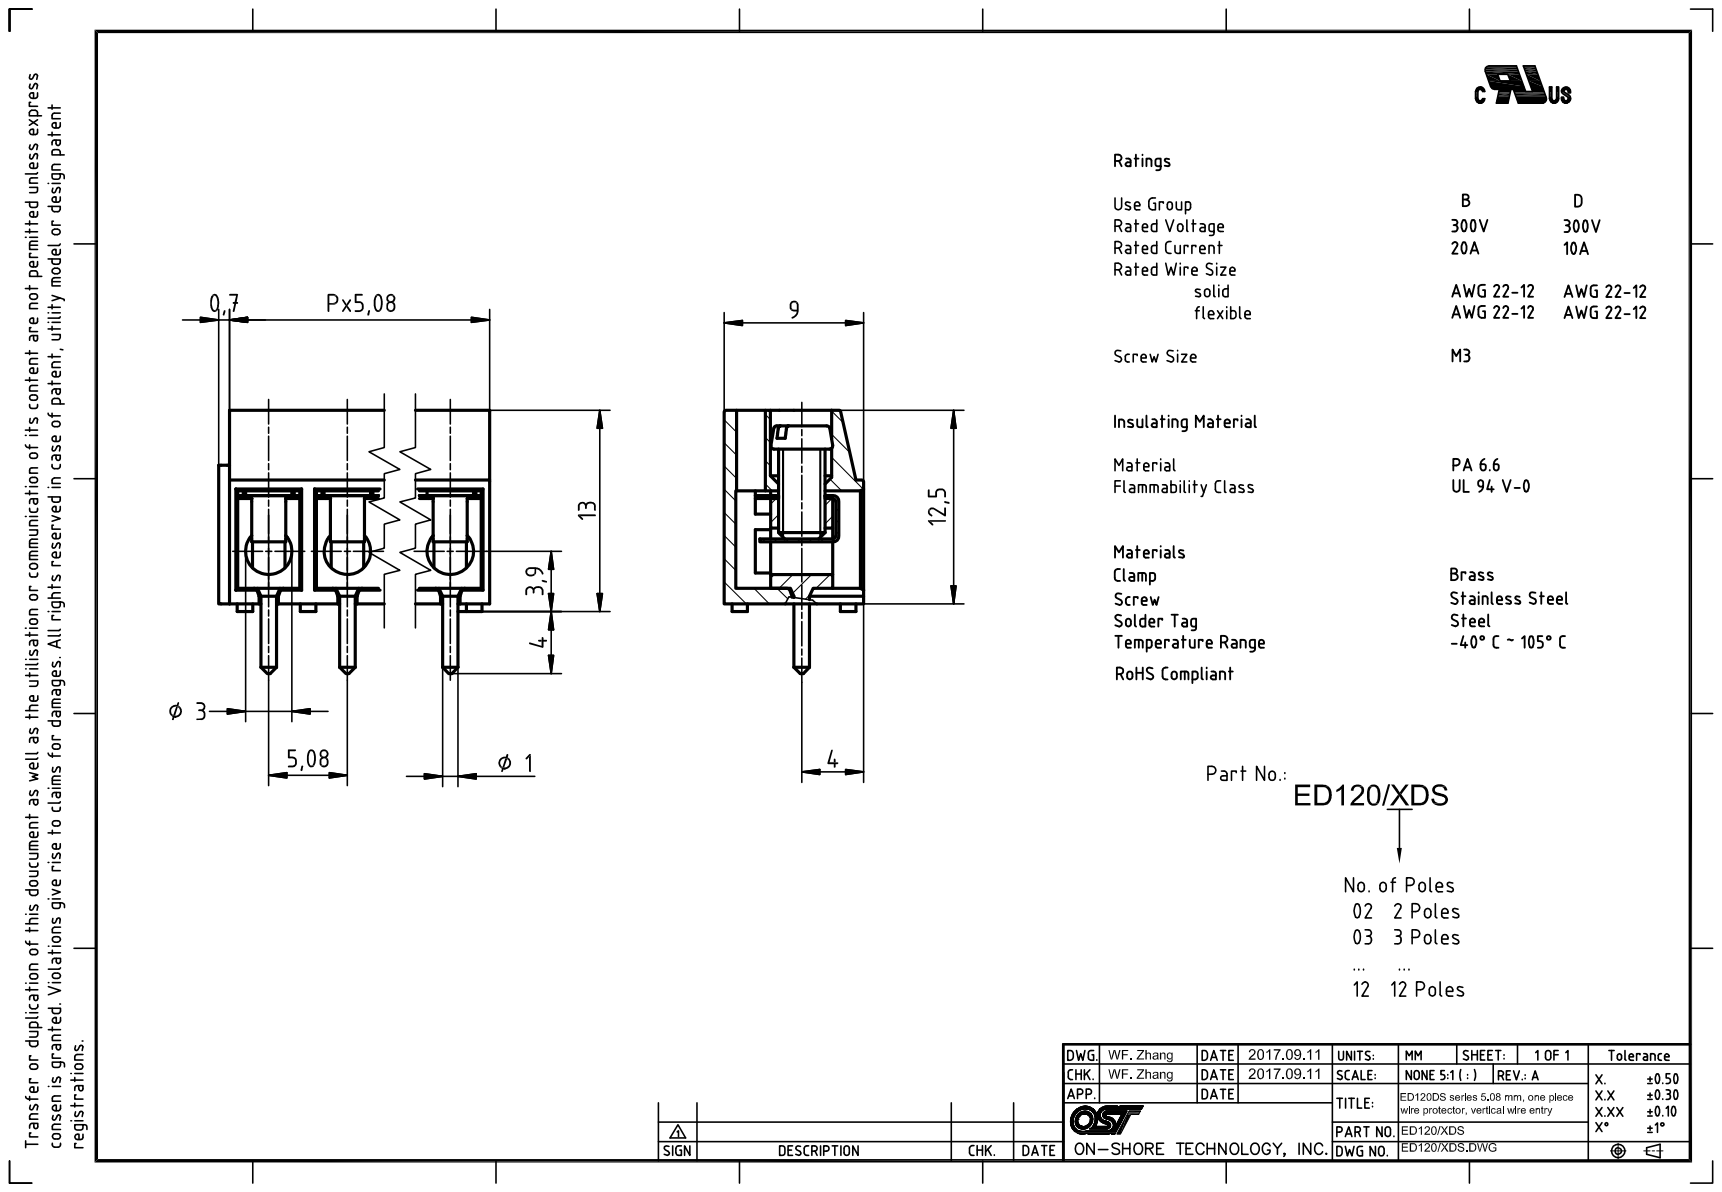
[picture p195: page 1]
