Tangineering/DC-Balancer-Board-Teensy/papers/MIMO_Droop_Drive_Comparison/Definitions/logo-updates-eps-converted-to.pdf

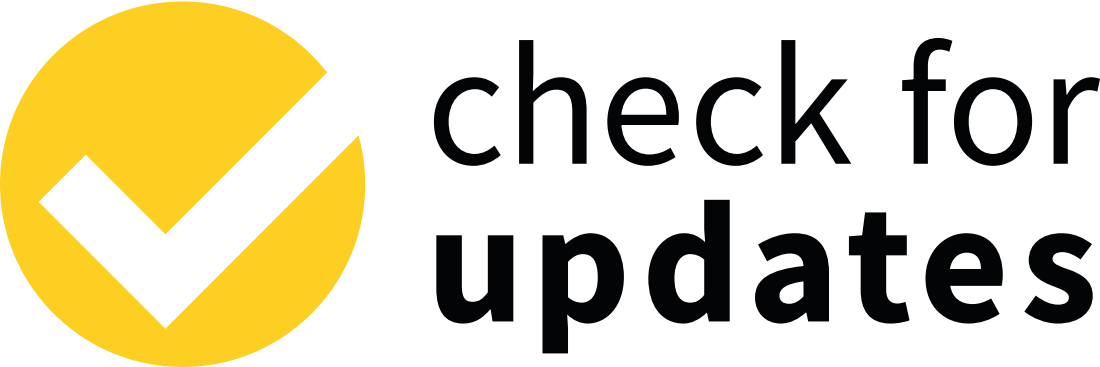
[picture p196: page 1]
