Tangineering/DC-Balancer-Board-Teensy/papers/MIMO_Droop_Drive_Comparison/Figures/fig_corner_scatter.pdf

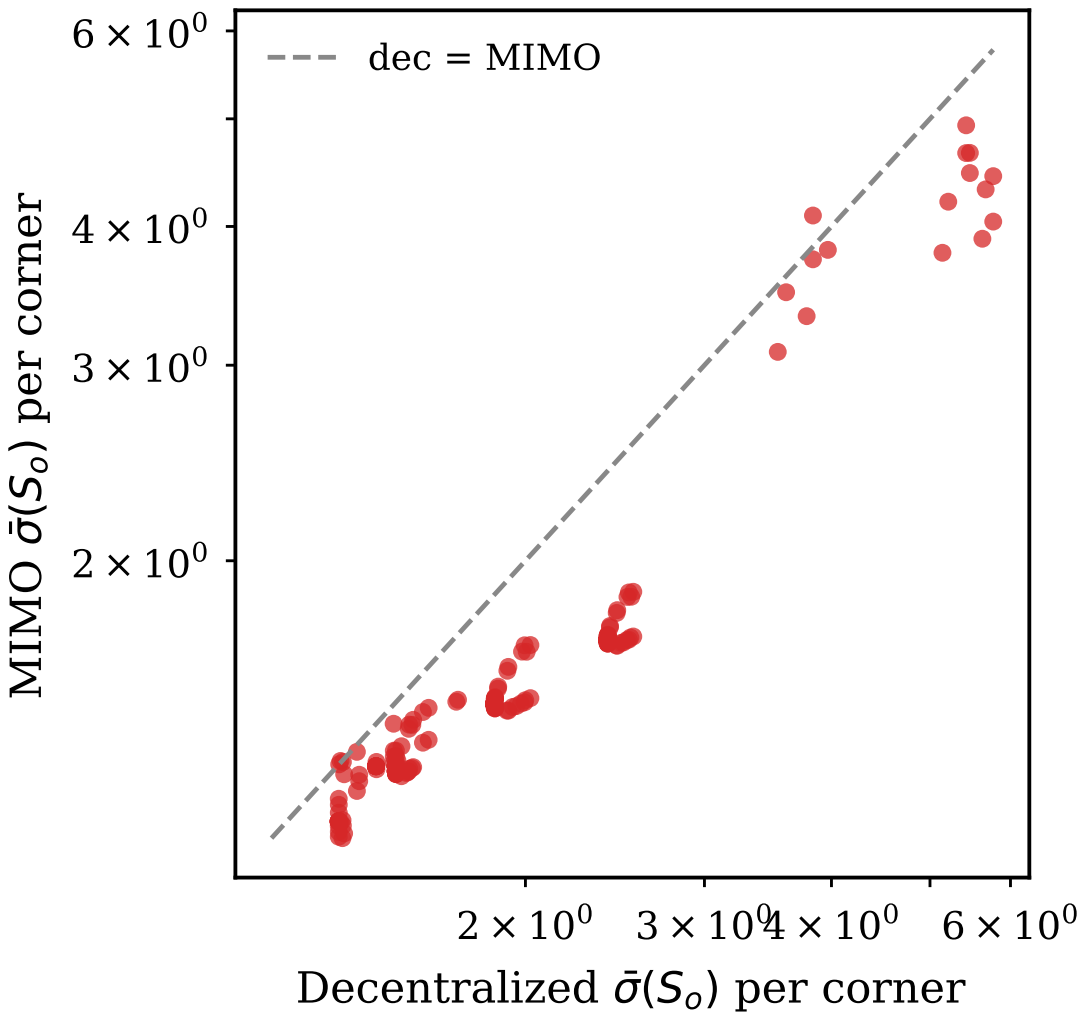
[picture p197: page 1]
Decentralized σ(̄So) per corner; MIM; dec = MIMO

O ̄ σ(So) per corner
