Tangineering/DC-Balancer-Board-Teensy/papers/Droop_Control/Figures/fullorder_bode_overlay.pdf

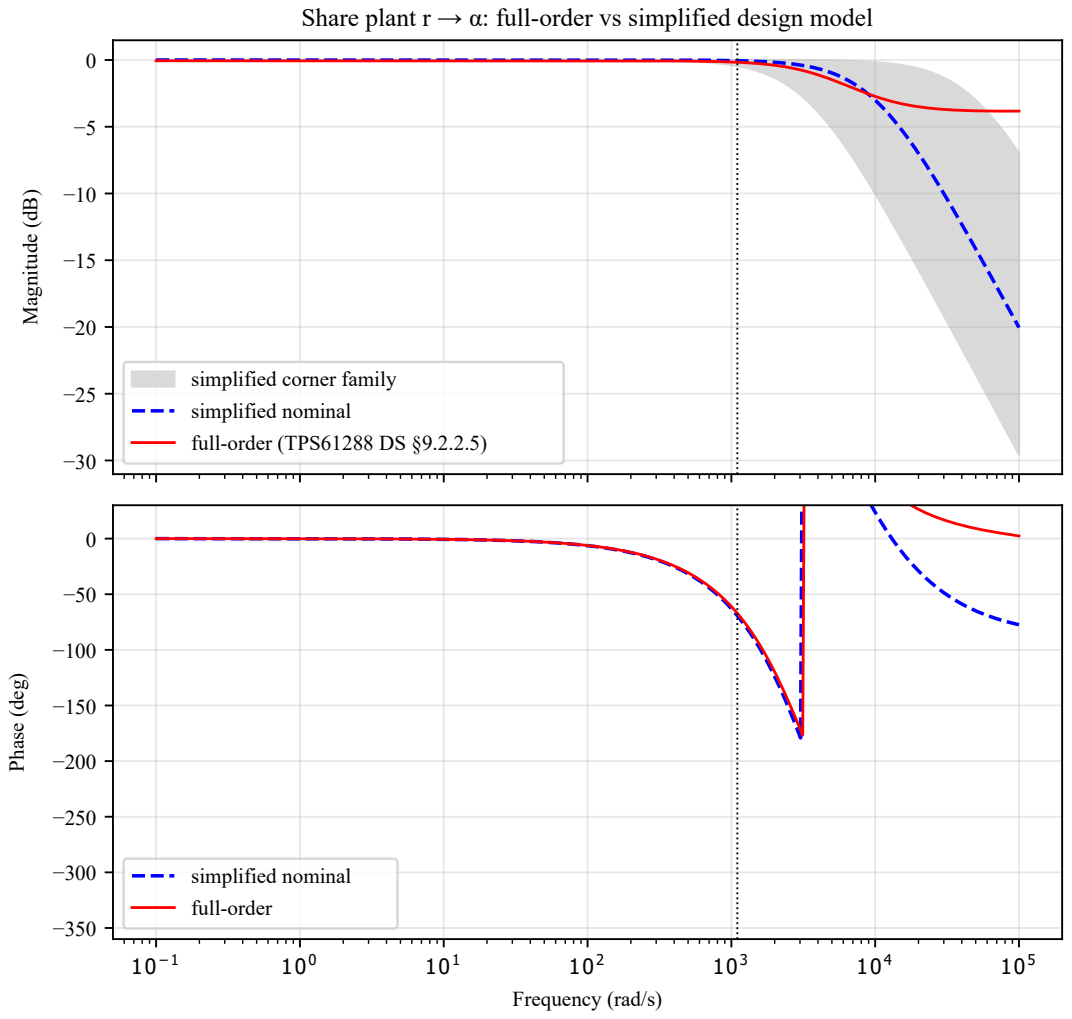
[picture p198: page 1]
Magnitude (dB); Frequency (rad/s); Phase (deg)

Share plant r → α: full-order vs simplified design model

simplified corner family
simplified nominal full-order (TPS61288 DS §9.2.2.5)

simplified nominal
full-order
