Tangineering/DC-Balancer-Board-Teensy/papers/Droop_Control/Figures/fullorder_envelope.pdf

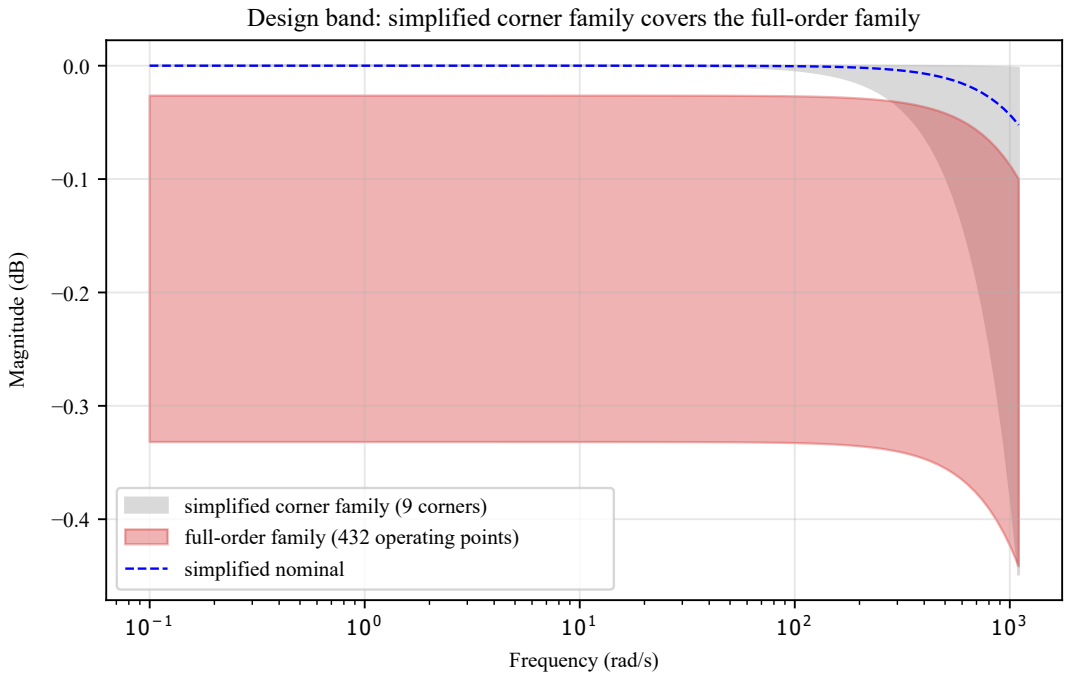
[picture p199: page 1]
Frequency (rad/s); Magnitude (dB)

Design band: simplified corner family covers the full-order family

simplified corner family (9 corners)
full-order family (432 operating points) simplified nominal
