Tangineering/DC-Balancer-Board-Teensy/papers/A_Practical_Youla_Gain_Tuning_Framework_for_H__Controller_Realization/Figures/compressed/FTP75.pdf

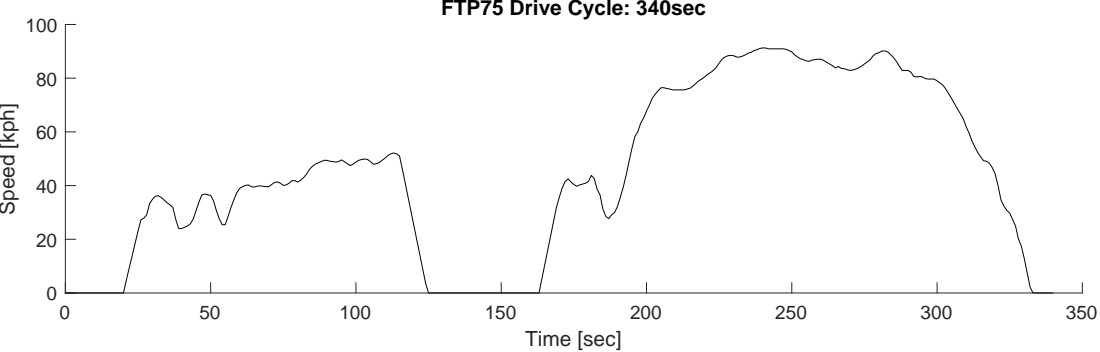
[picture p200: page 1]
Time [sec]; Speed [kph]; FTP75 Drive Cycle: 340sec
