Tangineering/DC-Balancer-Board-Teensy/papers/A_Practical_Youla_Gain_Tuning_Framework_for_H__Controller_Realization/Figures/compressed/H-&-YH-Gc-18.pdf

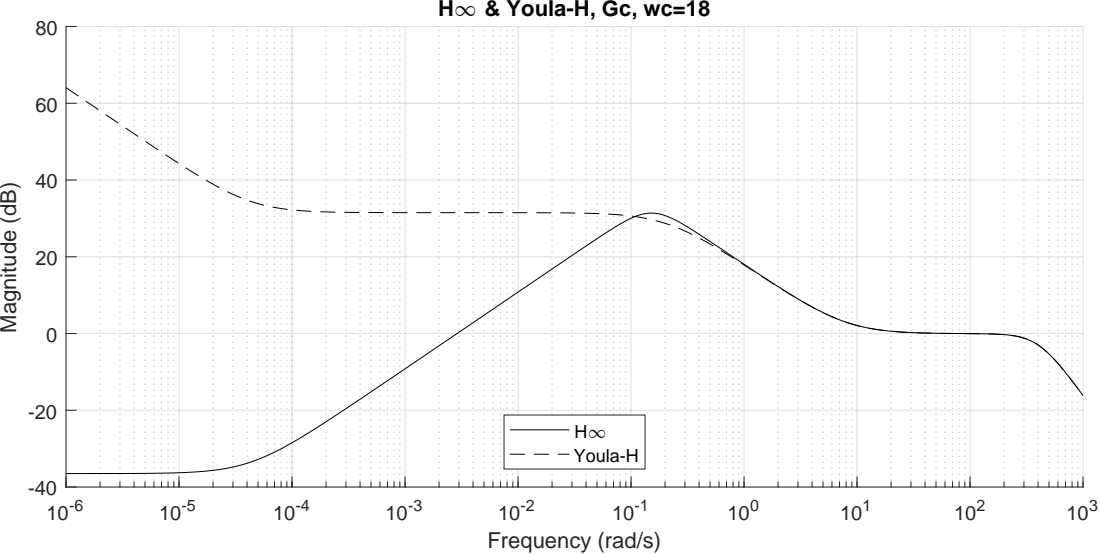
[picture p201: page 1]
Frequency (rad/s); Magnitude (dB); Youla-H

1 & Youla-H, Gc, wc=18 H1
