Tangineering/DC-Balancer-Board-Teensy/papers/A_Practical_Youla_Gain_Tuning_Framework_for_H__Controller_Realization/Figures/compressed/H-TSY-18.pdf

-200

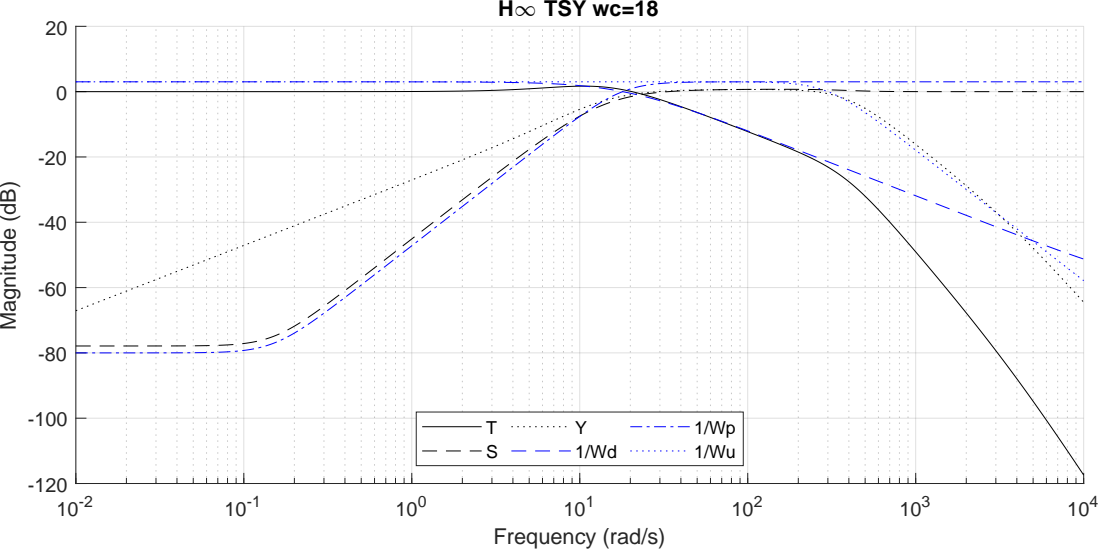
[picture p202: page 1]
Frequency (rad/s); Magnitude (dB); 1 TSY wc=18
