Tangineering/DC-Balancer-Board-Teensy/papers/A_Practical_Youla_Gain_Tuning_Framework_for_H__Controller_Realization/Figures/compressed/H-TSY-2nd.pdf

-100

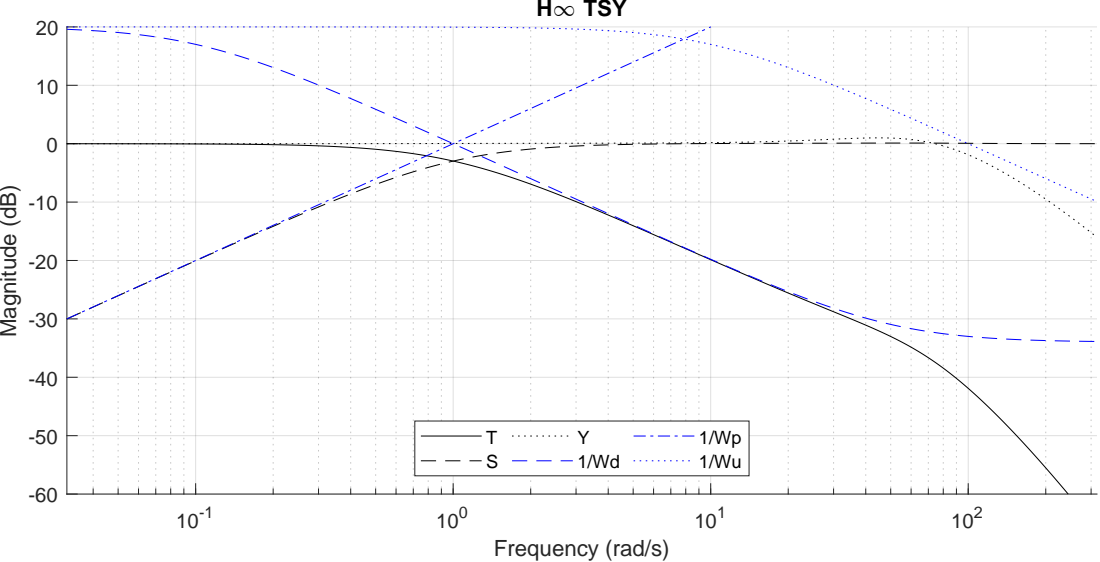
[picture p203: page 1]
Frequency (rad/s); Magnitude (dB); 1 TSY
