Tangineering/DC-Balancer-Board-Teensy/papers/A_Practical_Youla_Gain_Tuning_Framework_for_H__Controller_Realization/Figures/compressed/YH-TSY-18.pdf

-200

# Youla-H TSY wc=18 TS Y

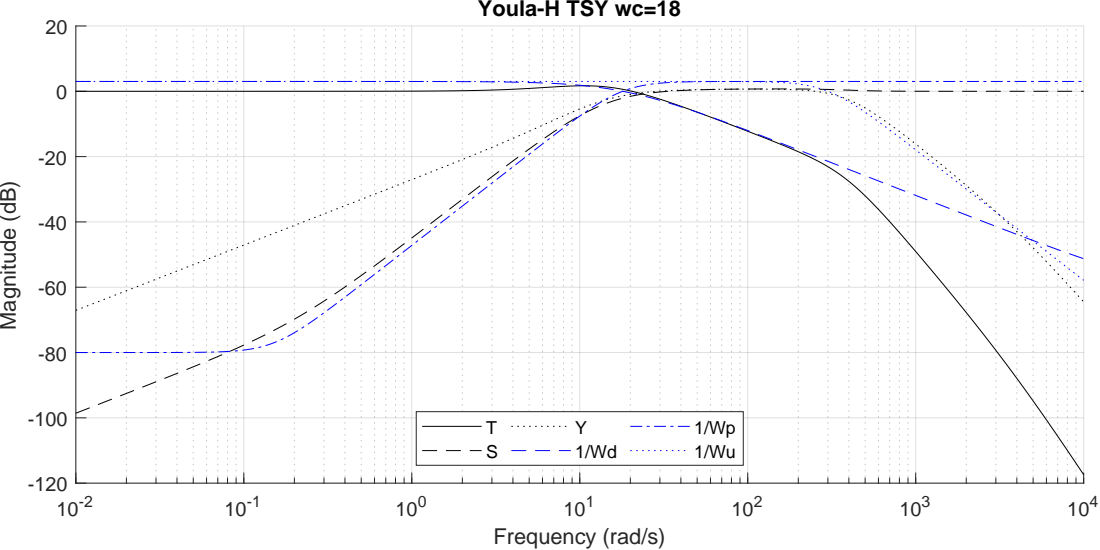
[picture p204: page 1]
Frequency (rad/s); Magnitude (dB)
