Tangineering/DC-Balancer-Board-Teensy/papers/A_Practical_Youla_Gain_Tuning_Framework_for_H__Controller_Realization/antiwindup_study/figures/YH-TSY-3rd.pdf

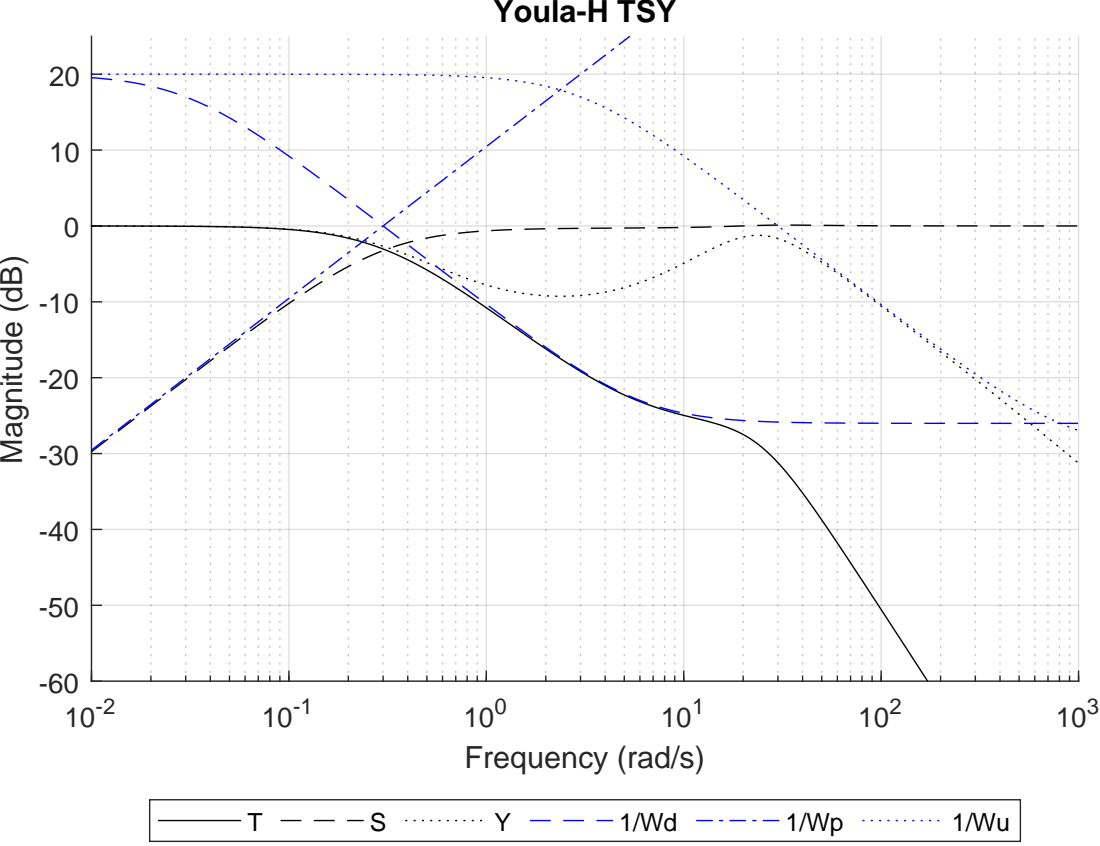
[picture p205: page 1]
Frequency (rad/s); Magnitude (dB); Youla-H TSY
