Tangineering/DC-Balancer-Board-Teensy/papers/A_Practical_Youla_Gain_Tuning_Framework_for_H__Controller_Realization/antiwindup_study/figures/YH-vs-H-cond-18.pdf

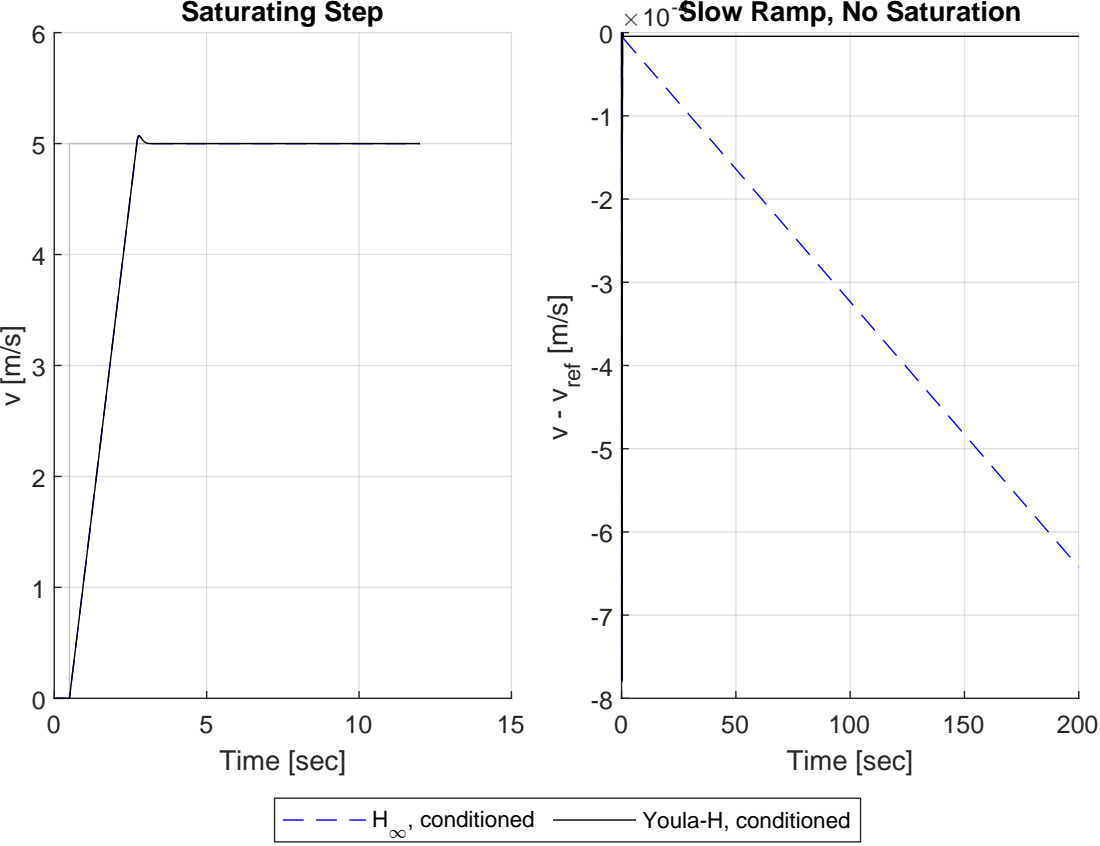
[picture p206: page 1]
Time [sec]; Saturating Step; v - vref [m/s]; , conditioned; Youla-H, conditioned

#10⁻⁴Slow Ramp, No Saturation
