Tangineering/DC-Balancer-Board-Teensy/(list of files, drawings)

Other design files:
references/TI_BQ25798_design_files/TIDA-050047/altium_TIDM752/REV_A1/PD_BQ_Ref_Design_BlankSheet.SchDoc
references/TI_BQ25798_design_files/TIDA-050047/altium_TIDM752/REV_A1/TPS25750D.SchDoc
references/TI_BQ25798_design_files/TIDA-050047/altium_TIDM752/REV_A1/Type_C_Port.SchDoc
