Tangineering/DC-Balancer-Board-Teensy/hardware/charger_evm_r8/cr/cr.kicad_pcb

## KiCad design hardware/charger_evm_r8/cr/cr.kicad_pcb (2026-11-11)

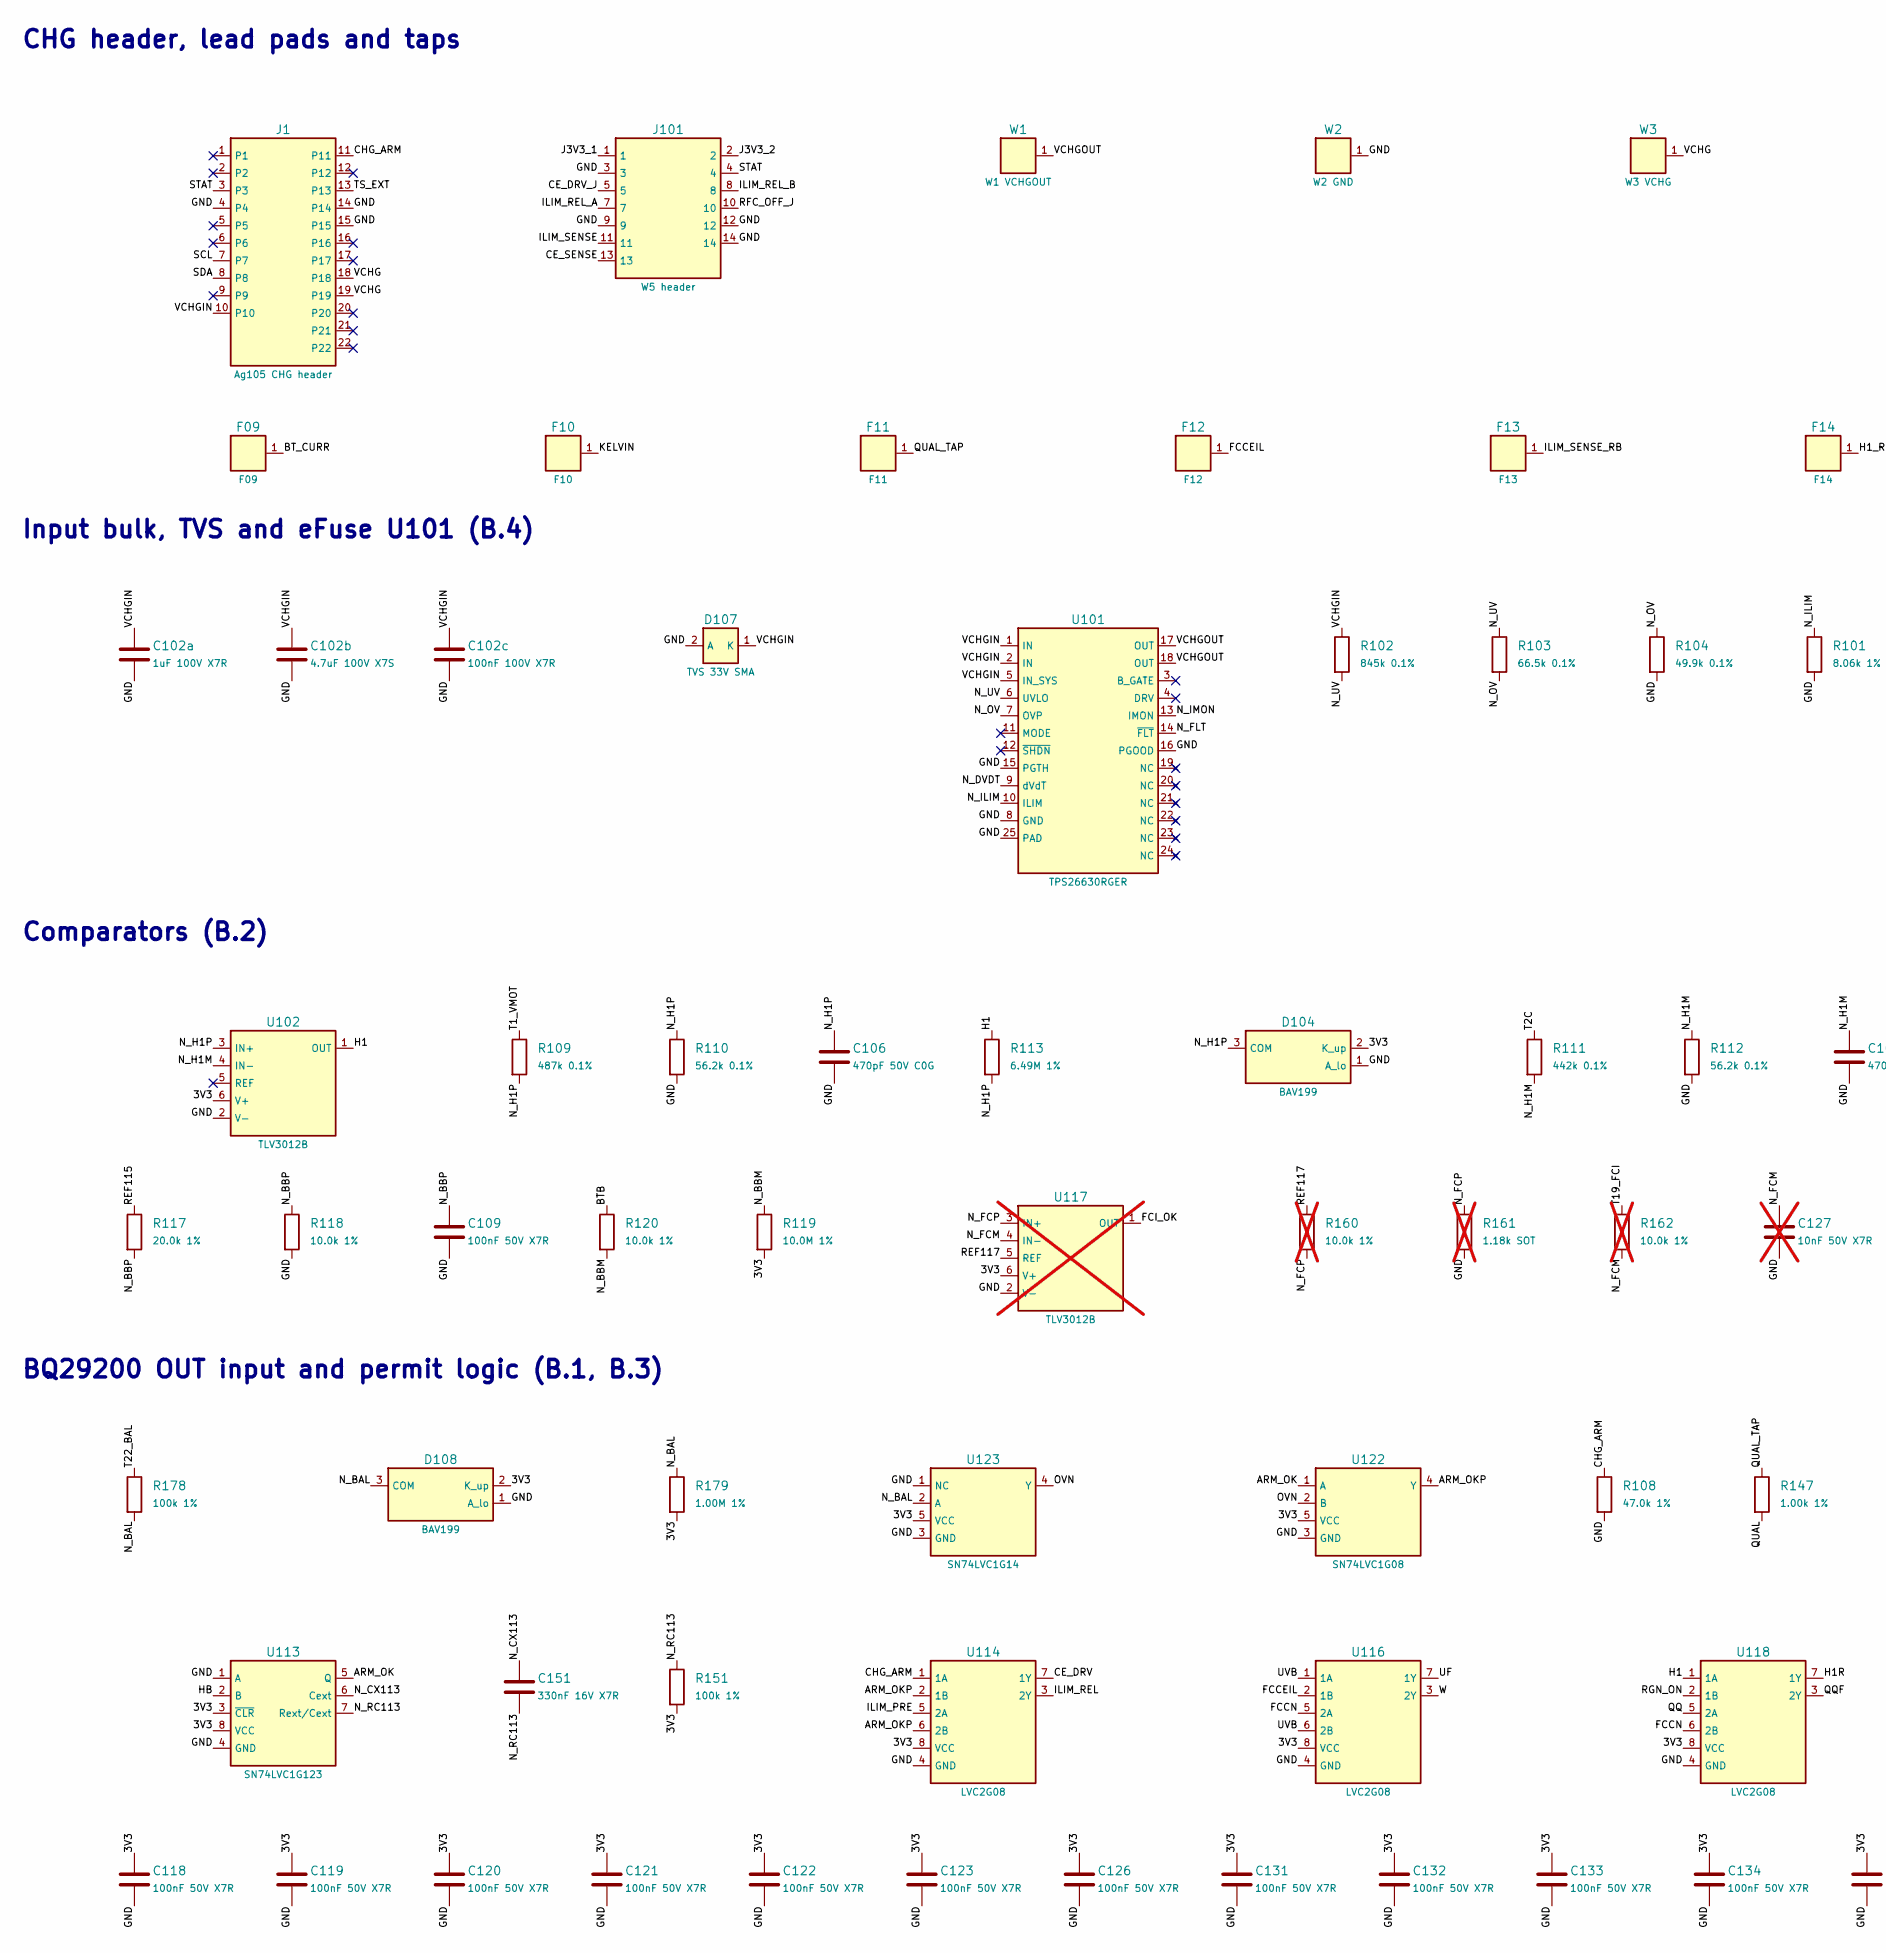
[picture p207: schematic cr.kicad_sch, CR - CHG adapter carrier (BQ25798EVM path), part in row 1, column 1]

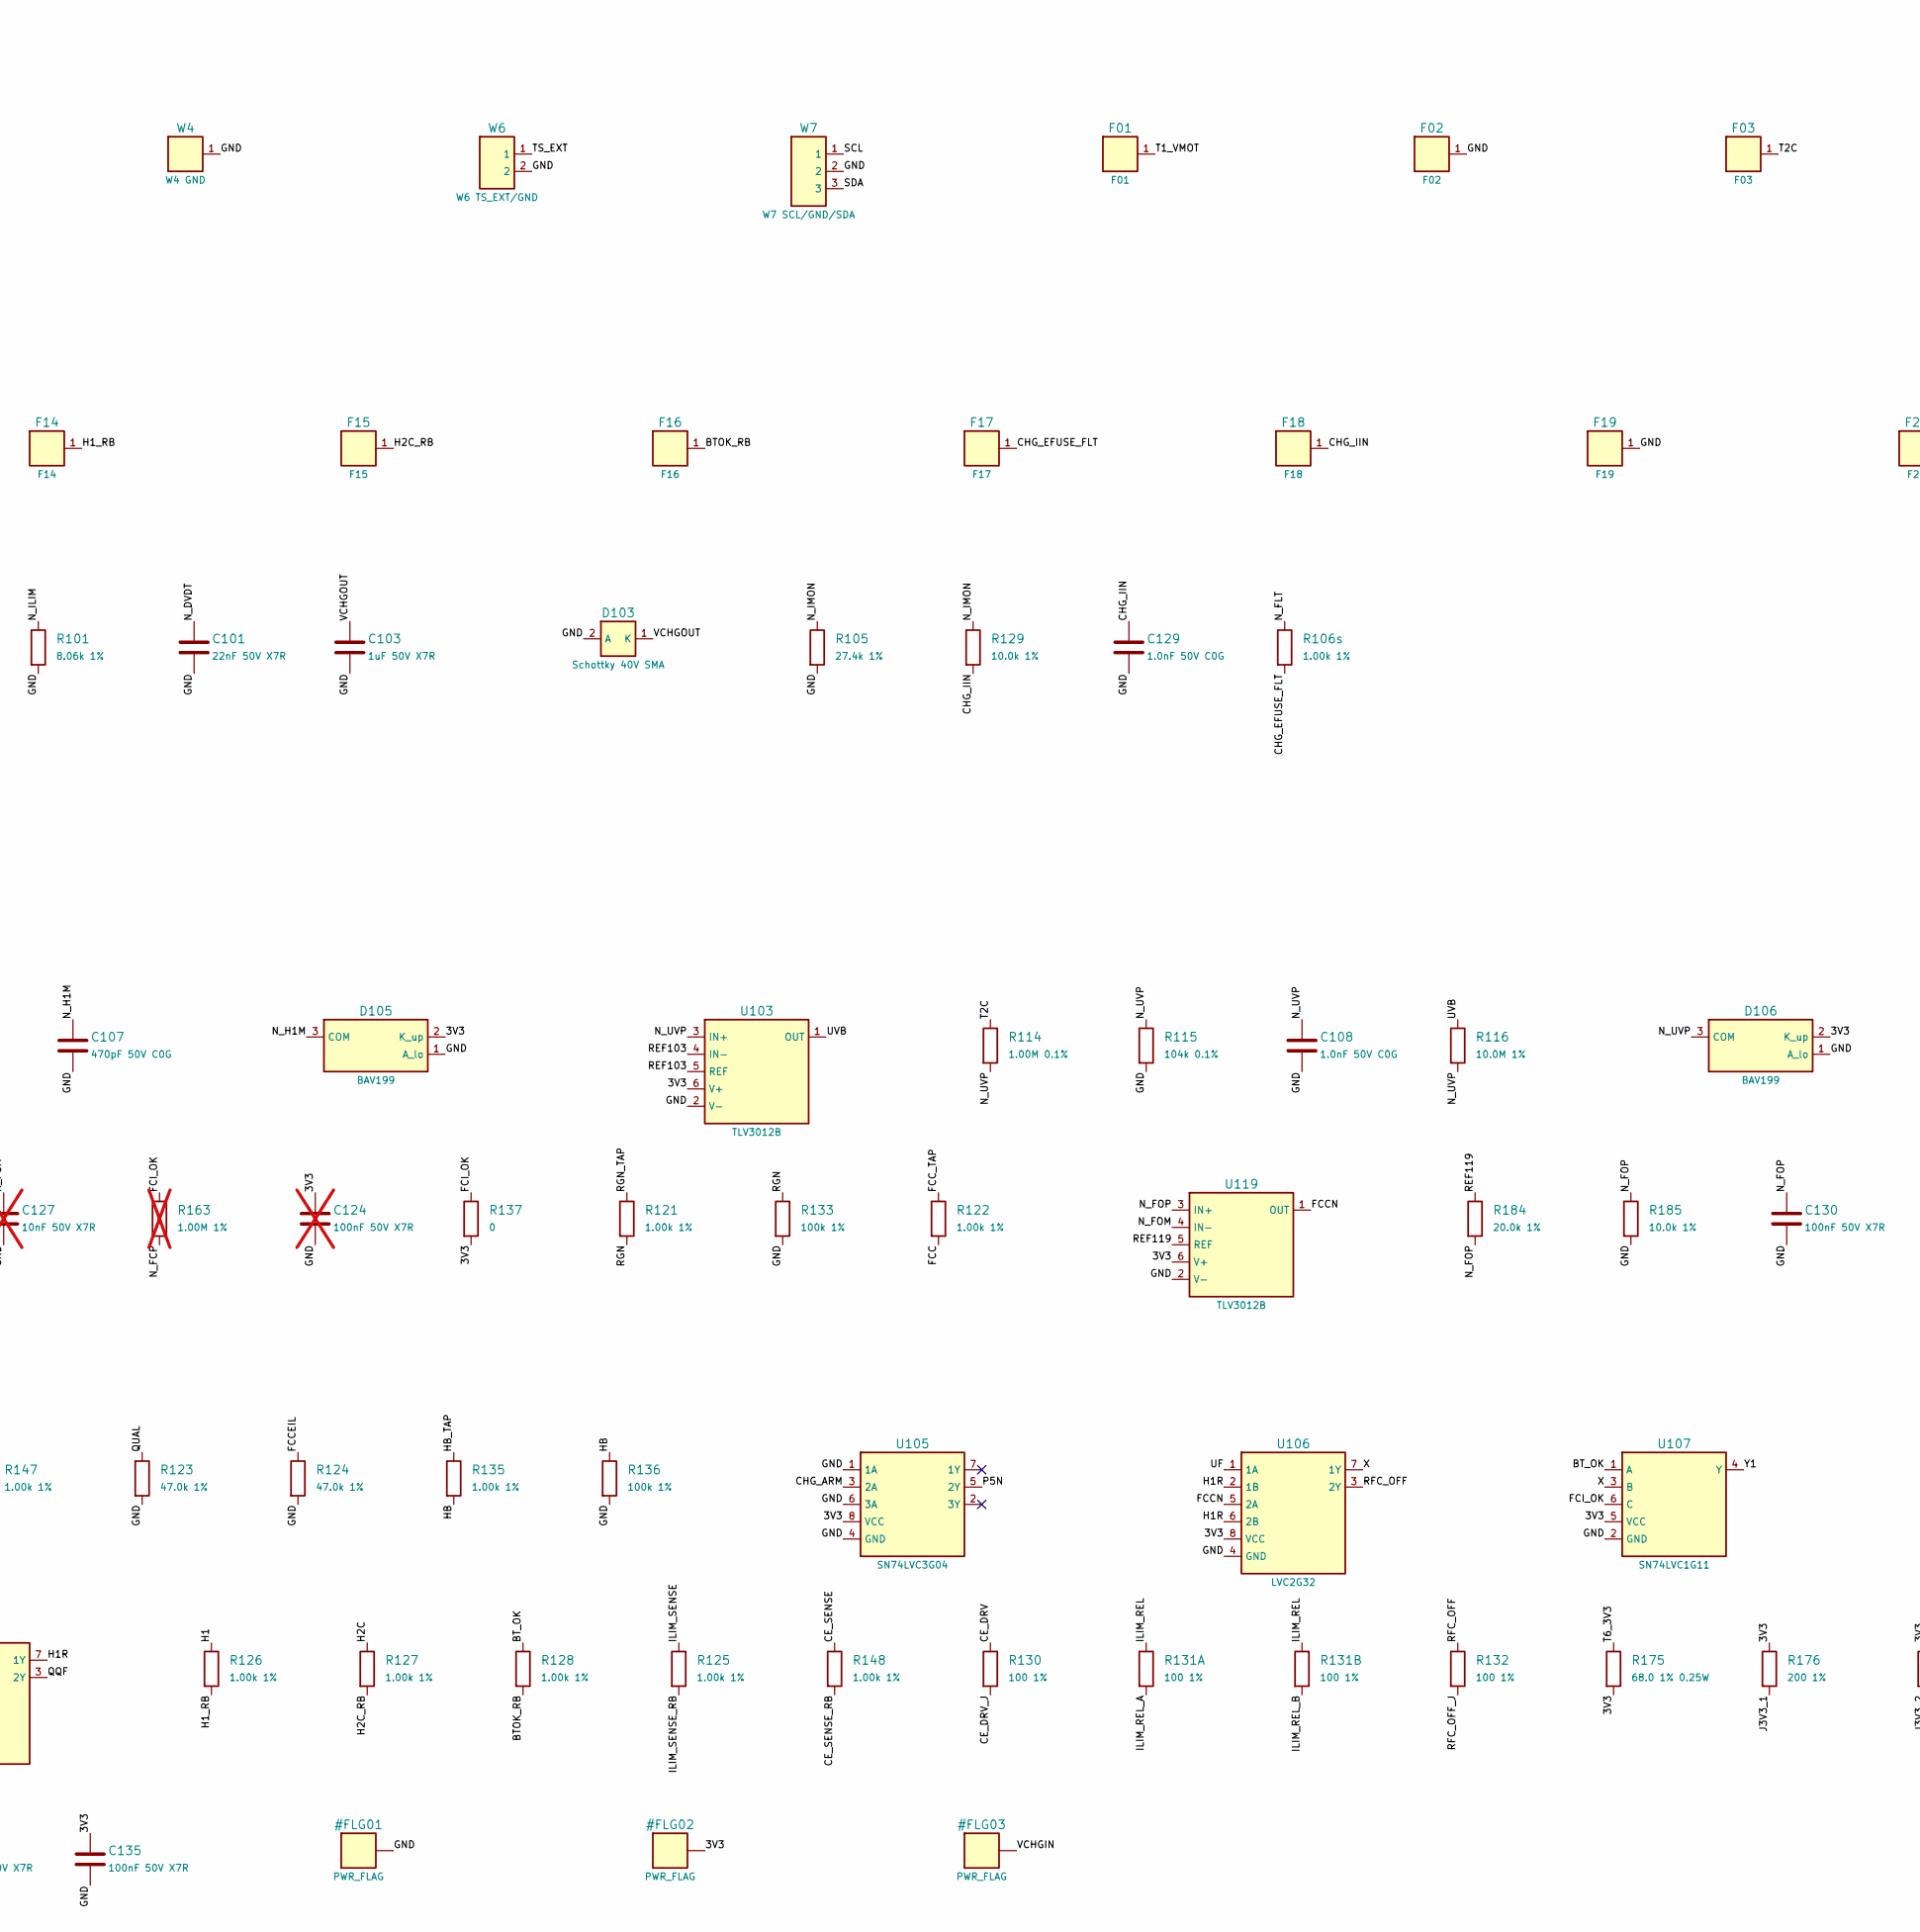
[picture p208: schematic cr.kicad_sch, CR - CHG adapter carrier (BQ25798EVM path), part in row 1, column 2]

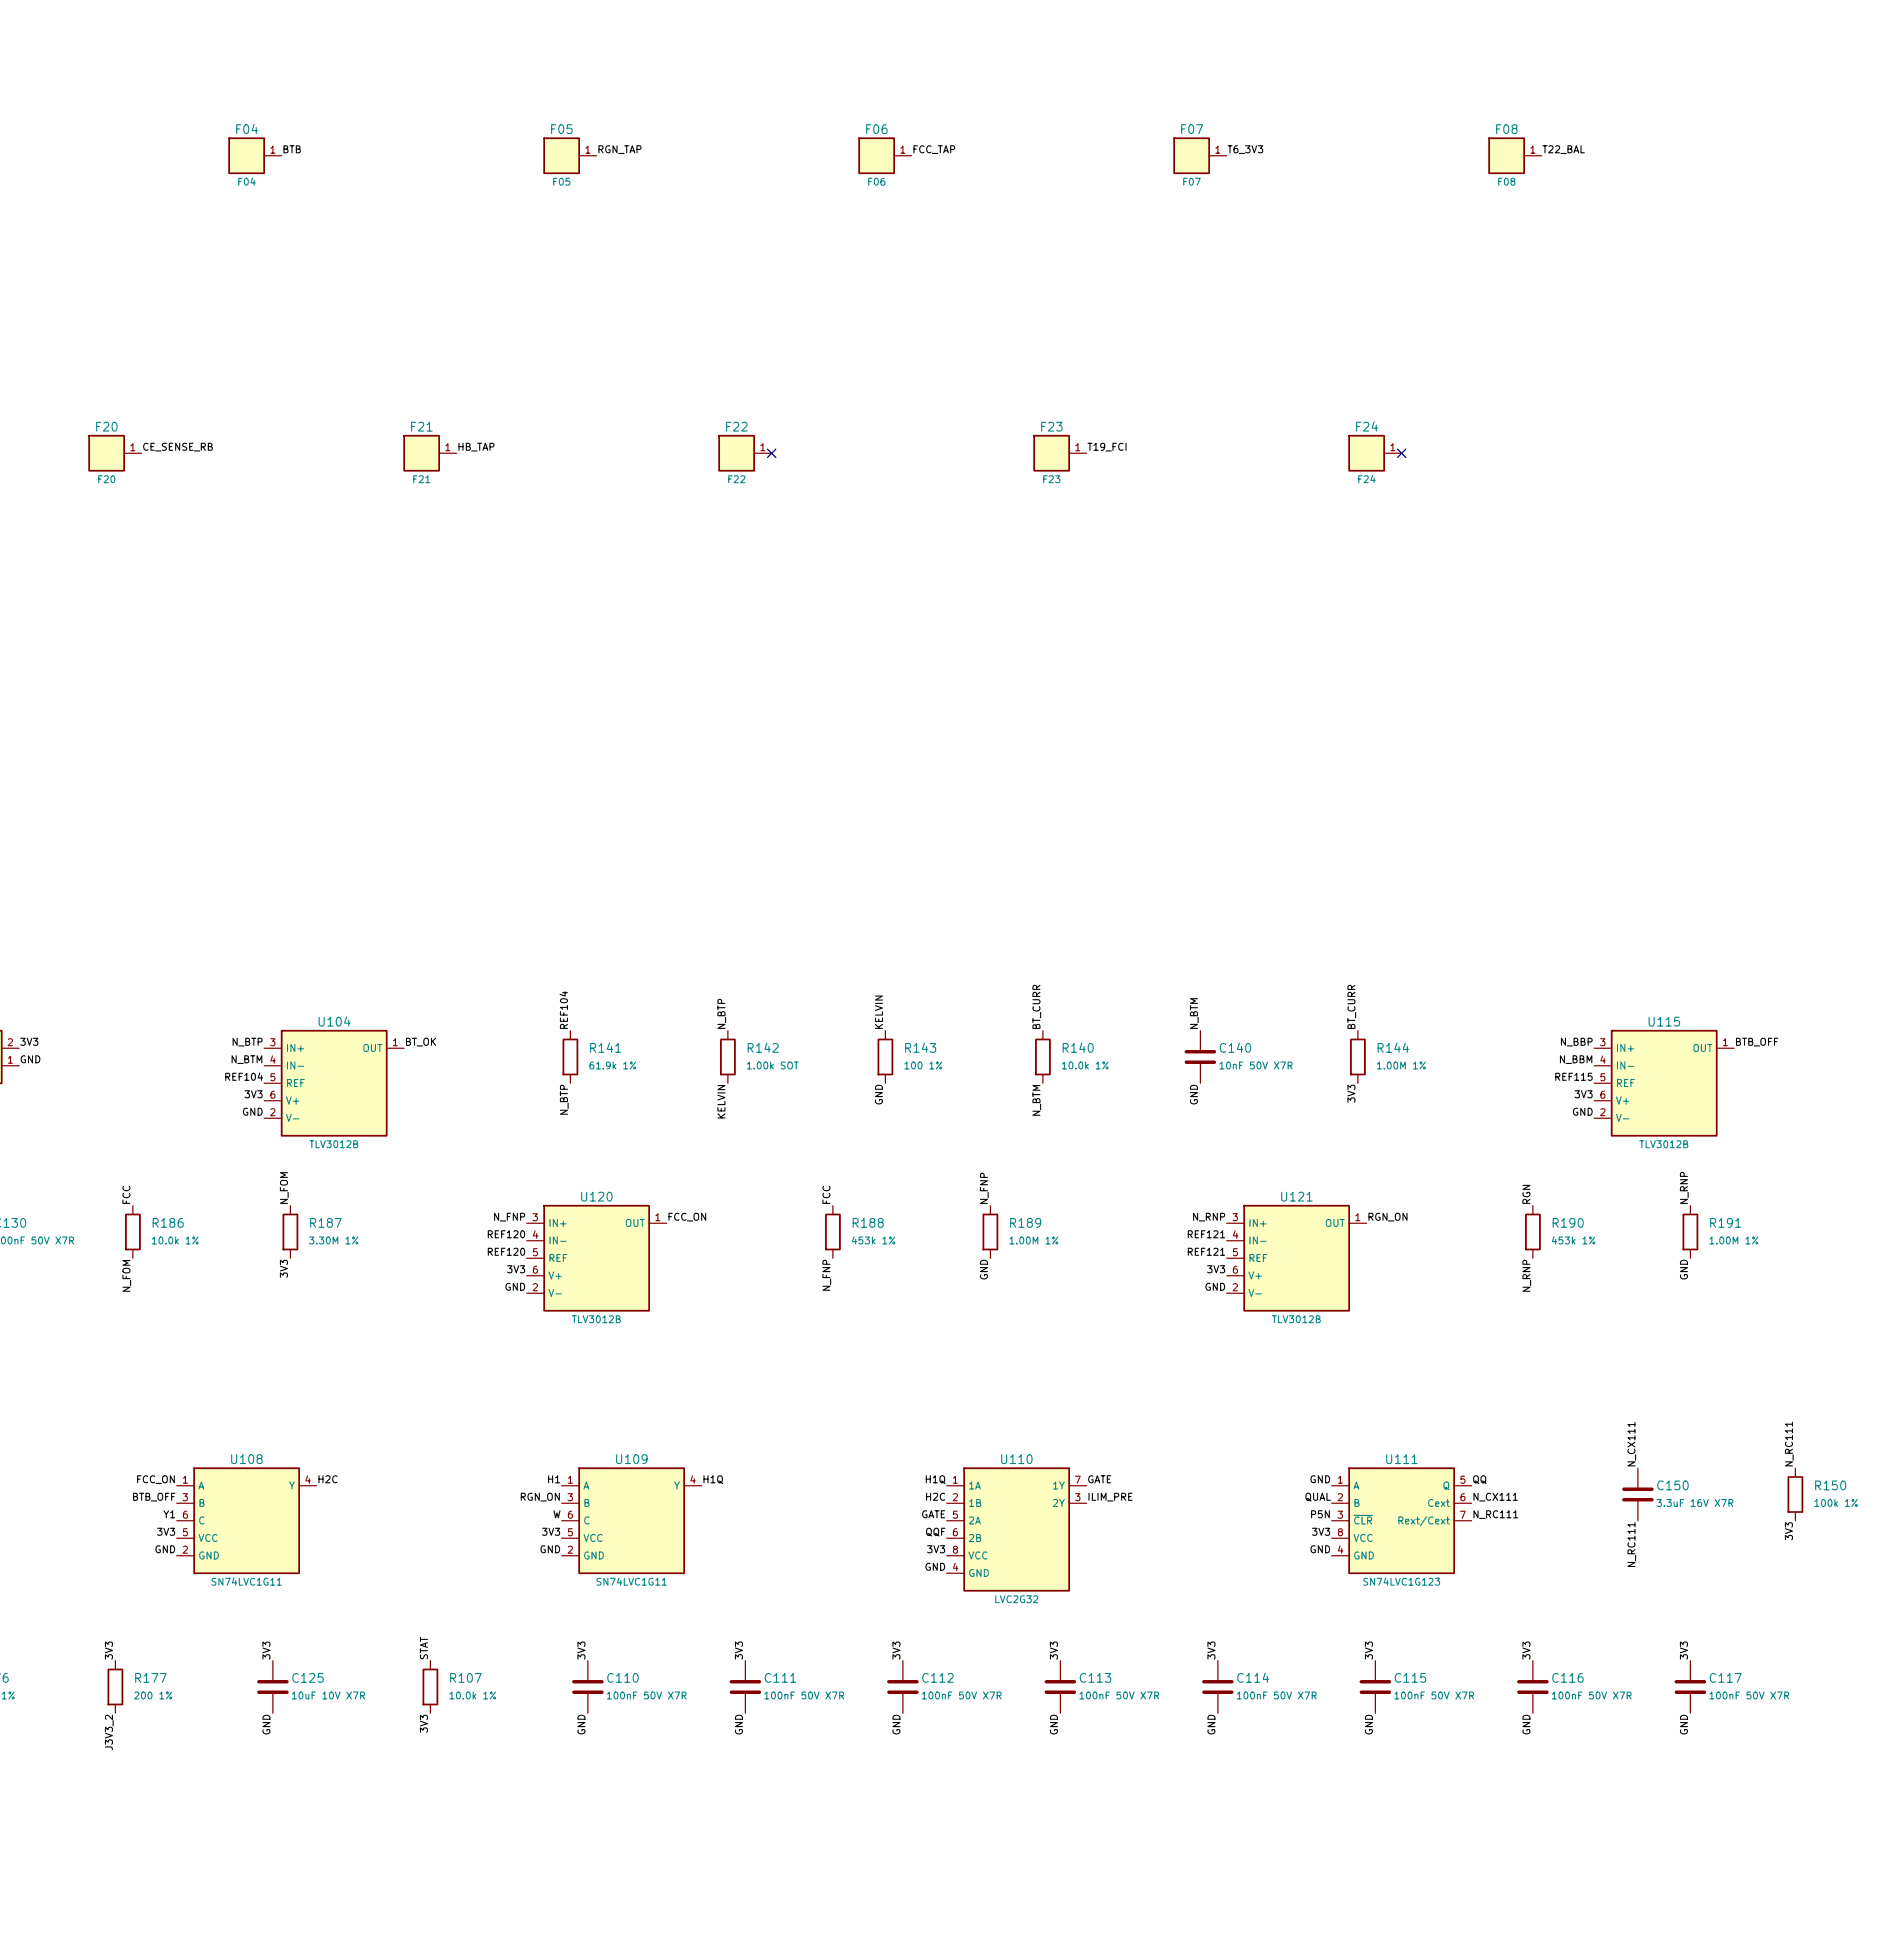
[picture p209: schematic cr.kicad_sch, CR - CHG adapter carrier (BQ25798EVM path), part in row 1, column 3]

Parts:
C101: 22nF 50V X7R; C_0402_1005Metric_CrtYd0.10; MPN GRM155R71H223KA12D
C102a: 1uF 100V X7R; C_1206_3216Metric_CrtYd0.10; MPN GRM31CR72A105KA01L
C102b: 4.7uF 100V X7S; C_1210_3225Metric_CrtYd0.10; MPN C3225X7S2A475K
C102c: 100nF 100V X7R; C_0603_1608Metric_CrtYd0.10; MPN GRM188R72A104KA35D
C103: 1uF 50V X7R; C_0805_2012Metric_CrtYd0.10; MPN GRM21BR71H105KA12L
C106, C107: 470pF 50V C0G; C_0603_1608Metric_CrtYd0.10; MPN GRM1885C1H471JA01D
C108, C129: 1.0nF 50V C0G; C_0603_1608Metric_CrtYd0.10; MPN GRM1885C1H102JA01D
C109, C110, C111, C112, C113, C114, C115, C116, C117, C118, C119, C120, C121, C122, C123, C126, C130, C131, C132, C133, C134, C135: 100nF 50V X7R; C_0603_1608Metric_CrtYd0.10; MPN GRM188R71H104KA93D
C124: 100nF 50V X7R; C_0603_1608Metric_CrtYd0.10; MPN GRM188R71H104KA93D; not fitted
C125: 10uF 10V X7R; C_0805_2012Metric_CrtYd0.10; MPN GRM21BR71A106KE51L
C127: 10nF 50V X7R; C_0603_1608Metric_CrtYd0.10; MPN GRM188R71H103KA01D; not fitted
C140: 10nF 50V X7R; C_0603_1608Metric_CrtYd0.10; MPN GRM188R71H103KA01D
C150: 3.3uF 16V X7R; C_0805_2012Metric_CrtYd0.10; MPN GRM21BR71C335KA73L
C151: 330nF 16V X7R; C_0603_1608Metric_CrtYd0.10; MPN GRM188R71C334KA01D
D103: Schottky 40V SMA; D_SMA_CrtYd0.10; MPN selected in T-A-05 (bench fallback B340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
D104, D105, D106, D108: BAV199; SOT-23_CrtYd0.10; MPN BAV199,215
D107: TVS 33V SMA; D_SMA_CrtYd0.10; MPN SMAJ33A (candidate, T-A-05)
F01: F01; TapPad_SMD_1.5x1.5mm
F02: F02; TapPad_SMD_1.5x1.5mm
F03: F03; TapPad_SMD_1.5x1.5mm
F04: F04; TapPad_SMD_1.5x1.5mm
F05: F05; TapPad_SMD_1.5x1.5mm
F06: F06; TapPad_SMD_1.5x1.5mm
F07: F07; TapPad_SMD_1.5x1.5mm
F08: F08; TapPad_SMD_1.5x1.5mm
F09: F09; TapPad_SMD_1.5x1.5mm
F10: F10; TapPad_SMD_1.5x1.5mm
F11: F11; TapPad_SMD_1.5x1.5mm
F12: F12; TapPad_SMD_1.5x1.5mm
F13: F13; TapPad_SMD_1.5x1.5mm
F14: F14; TapPad_SMD_1.5x1.5mm
F15: F15; TapPad_SMD_1.5x1.5mm
F16: F16; TapPad_SMD_1.5x1.5mm
F17: F17; TapPad_SMD_1.5x1.5mm
F18: F18; TapPad_SMD_1.5x1.5mm
F19: F19; TapPad_SMD_1.5x1.5mm
F20: F20; TapPad_SMD_1.5x1.5mm
F21: F21; TapPad_SMD_1.5x1.5mm
F22: F22; TapPad_SMD_1.5x1.5mm
F23: F23; TapPad_SMD_1.5x1.5mm
F24: F24; TapPad_SMD_1.5x1.5mm
J1: Ag105 CHG header; Ag105_CHG_Carrier_22pin_P2.54mm; MPN TSW-110-07-G-S + TSW-112-07-G-S
J101: W5 header; Samtec_FTSH-107-01-DV_2x07_P1.27mm_SMD_NoPin6; MPN FTSH-107-01-L-DV class (T-A-05)
R101: 8.06k 1%; R_0402_1005Metric_CrtYd0.10; MPN CRCW04028K06FKED
R102: 845k 0.1%; R_0805_2012Metric_CrtYd0.10; MPN TNPW0805845KBEEA
R103: 66.5k 0.1%; R_0402_1005Metric_CrtYd0.10; MPN TNPW040266K5BEED
R104: 49.9k 0.1%; R_0402_1005Metric_CrtYd0.10; MPN TNPW040249K9BEED
R105: 27.4k 1%; R_0402_1005Metric_CrtYd0.10; MPN CRCW040227K4FKED
R106s: 1.00k 1%; R_0402_1005Metric_CrtYd0.10; MPN CRCW04021K00FKED
R107, R118, R120, R129, R140, R185, R186: 10.0k 1%; R_0603_1608Metric_CrtYd0.10; MPN CRCW060310K0FKEA
R108, R123, R124: 47.0k 1%; R_0603_1608Metric_CrtYd0.10; MPN CRCW060347K0FKEA
R109: 487k 0.1%; R_0805_2012Metric_CrtYd0.10; MPN TNPW0805487KBEEA
R110, R112: 56.2k 0.1%; R_0603_1608Metric_CrtYd0.10; MPN TNPW060356K2BEEA
R111: 442k 0.1%; R_0805_2012Metric_CrtYd0.10; MPN TNPW0805442KBEEA
R113: 6.49M 1%; R_0603_1608Metric_CrtYd0.10; MPN CRCW06036M49FKEA
R114: 1.00M 0.1%; R_0805_2012Metric_CrtYd0.10; MPN TNPW08051M00BEEA
R115: 104k 0.1%; R_0603_1608Metric_CrtYd0.10; MPN TNPW0603104KBEEA
R116, R119: 10.0M 1%; R_0603_1608Metric_CrtYd0.10; MPN CRCW060310M0FKEA
R117, R184: 20.0k 1%; R_0603_1608Metric_CrtYd0.10; MPN CRCW060320K0FKEA
R121, R122, R125, R126, R127, R128, R135, R147, R148: 1.00k 1%; R_0603_1608Metric_CrtYd0.10; MPN CRCW06031K00FKEA
R130, R131A, R131B, R132, R143: 100 1%; R_0603_1608Metric_CrtYd0.10; MPN CRCW0603100RFKEA
R133, R136, R150, R151, R178: 100k 1%; R_0603_1608Metric_CrtYd0.10; MPN CRCW0603100KFKEA
R137: 0; R_0603_1608Metric_CrtYd0.10; MPN CRCW06030000Z0EA
R141: 61.9k 1%; R_0603_1608Metric_CrtYd0.10; MPN CRCW060361K9FKEA
R142: 1.00k SOT; R_0603_1608Metric_CrtYd0.10; MPN CRCW06031K00FKEA (select-on-test kit)
R144, R179, R189, R191: 1.00M 1%; R_0603_1608Metric_CrtYd0.10; MPN CRCW06031M00FKEA
R160, R162: 10.0k 1%; R_0603_1608Metric_CrtYd0.10; MPN CRCW060310K0FKEA; not fitted
R161: 1.18k SOT; R_0603_1608Metric_CrtYd0.10; MPN CRCW06031K18FKEA; not fitted
R163: 1.00M 1%; R_0603_1608Metric_CrtYd0.10; MPN CRCW06031M00FKEA; not fitted
R175: 68.0 1% 0.25W; R_1206_3216Metric_CrtYd0.10; MPN CRCW120668R0FKEA
R176, R177: 200 1%; R_0603_1608Metric_CrtYd0.10; MPN CRCW0603200RFKEA
R187: 3.30M 1%; R_0603_1608Metric_CrtYd0.10; MPN CRCW06033M30FKEA
R188, R190: 453k 1%; R_0603_1608Metric_CrtYd0.10; MPN CRCW0603453KFKEA
U101: TPS26630RGER; TPS26630_RGE0024_VQFN-24_4x4mm_P0.5mm_ThermalVias; MPN TPS26630RGER
U102, U103, U104, U115, U119, U120, U121: TLV3012B; SOT-23-6_CrtYd0.10; MPN TLV3012BIDBVR
U105: SN74LVC3G04; Texas_DCT0008A_SSOP-8_TI-land_CrtYd0.10; MPN SN74LVC3G04DCTR
U106, U110: LVC2G32; Texas_DCT0008A_SSOP-8_TI-land_CrtYd0.10; MPN SN74LVC2G32DCTR
U107, U108, U109: SN74LVC1G11; SOT-363_SC-70-6_CrtYd0.10; MPN SN74LVC1G11DCKR
U111, U113: SN74LVC1G123; Texas_DCT0008A_SSOP-8_TI-land_CrtYd0.10; MPN SN74LVC1G123DCTR
U114, U116, U118: LVC2G08; Texas_DCT0008A_SSOP-8_TI-land_CrtYd0.10; MPN SN74LVC2G08DCTR
U117: TLV3012B; SOT-23-6_CrtYd0.10; MPN TLV3012BIDBVR; not fitted
U122: SN74LVC1G08; Texas_DCK-5_SC-70-5_CrtYd0.10; MPN SN74LVC1G08DCKR
U123: SN74LVC1G14; Texas_DCK-5_SC-70-5_CrtYd0.10; MPN SN74LVC1G14DCKR
W1: W1 VCHGOUT; LeadPad_PTH_D1.3mm_P2.3mm
W2: W2 GND; LeadPad_PTH_D1.3mm_P2.3mm
W3: W3 VCHG; LeadPad_PTH_D1.5mm_P2.5mm
W4: W4 GND; LeadPad_PTH_D1.5mm_P2.5mm
W6: W6 TS_EXT/GND; LeadPads_SMD_1x02_1.2x1.5mm_P2.0mm
W7: W7 SCL/GND/SDA; LeadPads_SMD_1x03_1.2x1.5mm_P2.0mm

Connections:
/3V3: C110.1, C111.1, C112.1, C113.1, C114.1, C115.1, C116.1, C117.1, C118.1, C119.1, C120.1, C121.1, C122.1, C123.1, C124.1, C125.1, C126.1, C131.1, C132.1, C133.1, C134.1, C135.1, D104.2 (K_up), D105.2 (K_up), D106.2 (K_up), D108.2 (K_up), R107.2, R119.2, R137.2, R144.2, R150.2, R151.2, R175.2, R176.1, R177.1, R179.2, R187.2, U102.6 (V+), U103.6 (V+), U104.6 (V+), U105.8 (VCC), U106.8 (VCC), U107.5 (VCC), U108.5 (VCC), U109.5 (VCC), U110.8 (VCC), U111.8 (VCC), U113.3 (~CLR), U113.8 (VCC), U114.8 (VCC), U115.6 (V+), U116.8 (VCC), U117.6 (V+), U118.8 (VCC), U119.6 (V+), U120.6 (V+), U121.6 (V+), U122.5 (VCC), U123.5 (VCC)
/ARM_OK: U113.5 (Q), U122.1 (A)
/ARM_OKP: U114.2 (1B), U114.6 (2B), U122.4 (Y)
/BTB: F04.1, R120.1
/BTB_OFF: U108.3 (B), U115.1 (OUT)
/BTOK_RB: F16.1, R128.2
/BT_CURR: F09.1, R140.1, R144.1
/BT_OK: R128.1, U104.1 (OUT), U107.1 (A)
/CE_DRV: R130.1, U114.7 (1Y)
/CE_DRV_J: J101.5, R130.2
/CE_SENSE: J101.13, R148.1
/CE_SENSE_RB: F20.1, R148.2
/CHG_ARM: J1.11, R108.1, U105.3 (2A), U114.1 (1A)
/CHG_EFUSE_FLT: F17.1, R106s.2
/CHG_IIN: C129.1, F18.1, R129.2
/FCC: R122.2, R186.1, R188.1
/FCCEIL: F12.1, R124.1, U116.2 (1B)
/FCCN: U106.5 (2A), U116.5 (2A), U118.6 (2B), U119.1 (OUT)
/FCC_ON: U108.1 (A), U120.1 (OUT)
/FCC_TAP: F06.1, R122.1
/FCI_OK: R137.1, R163.1, U107.6 (C), U117.1 (OUT)
/GATE: U110.5 (2A), U110.7 (1Y)
/GND: C101.2, C102a.2, C102b.2, C102c.2, C103.2, C106.2, C107.2, C108.2, C109.2, C110.2, C111.2, C112.2, C113.2, C114.2, C115.2, C116.2, C117.2, C118.2, C119.2, C120.2, C121.2, C122.2, C123.2, C124.2, C125.2, C126.2, C127.2, C129.2, C130.2, C131.2, C132.2, C133.2, C134.2, C135.2, C140.2, D103.2 (A), D104.1 (A_lo), D105.1 (A_lo), D106.1 (A_lo), D107.2 (A), D108.1 (A_lo), F02.1, F19.1, J1.4, J1.14, J1.15, J101.3, J101.9, J101.12, J101.14, R101.2, R104.2, R105.2, R108.2, R110.2, R112.2, R115.2, R118.2, R123.2, R124.2, R133.2, R136.2, R143.2, R161.2, R185.2, R189.2, R191.2, U101.8 (GND), U101.15 (PGTH), U101.16 (PGOOD), U101.25 (PAD), U102.2 (V-), U103.2 (V-), U104.2 (V-), U105.1 (1A), U105.4 (GND), U105.6 (3A), U106.4 (GND), U107.2 (GND), U108.2 (GND), U109.2 (GND), U110.4 (GND), U111.1 (A), U111.4 (GND), U113.1 (A), U113.4 (GND), U114.4 (GND), U115.2 (V-), U116.4 (GND), U117.2 (V-), U118.4 (GND), U119.2 (V-), U120.2 (V-), U121.2 (V-), U122.3 (GND), U123.1 (NC), U123.3 (GND), W2.1, W4.1, W6.2, W7.2
/H1: R113.1, R126.1, U102.1 (OUT), U109.1 (A), U118.1 (1A)
/H1Q: U109.4 (Y), U110.1 (1A)
/H1R: U106.2 (1B), U106.6 (2B), U118.7 (1Y)
/H1_RB: F14.1, R126.2
/H2C: R127.1, U108.4 (Y), U110.2 (1B)
/H2C_RB: F15.1, R127.2
/HB: R135.2, R136.1, U113.2 (B)
/HB_TAP: F21.1, R135.1
/ILIM_PRE: U110.3 (2Y), U114.5 (2A)
/ILIM_REL: R131A.1, R131B.1, U114.3 (2Y)
/ILIM_REL_A: J101.7, R131A.2
/ILIM_REL_B: J101.8, R131B.2
/ILIM_SENSE: J101.11, R125.1
/ILIM_SENSE_RB: F13.1, R125.2
/J3V3_1: J101.1, R176.2
/J3V3_2: J101.2, R177.2
/KELVIN: F10.1, R142.2, R143.1
/N_BAL: D108.3 (COM), R178.2, R179.1, U123.2 (A)
/N_BBM: R119.1, R120.2, U115.4 (IN-)
/N_BBP: C109.1, R117.2, R118.1, U115.3 (IN+)
/N_BTM: C140.1, R140.2, U104.4 (IN-)
/N_BTP: R141.2, R142.1, U104.3 (IN+)
/N_CX111: C150.1, U111.6 (Cext)
/N_CX113: C151.1, U113.6 (Cext)
/N_DVDT: C101.1, U101.9 (dVdT)
/N_FCM: C127.1, R162.2, U117.4 (IN-)
/N_FCP: R160.2, R161.1, R163.2, U117.3 (IN+)
/N_FLT: R106s.1, U101.14 (~FLT)
/N_FNP: R188.2, R189.1, U120.3 (IN+)
/N_FOM: R186.2, R187.1, U119.4 (IN-)
/N_FOP: C130.1, R184.2, R185.1, U119.3 (IN+)
/N_H1M: C107.1, D105.3 (COM), R111.2, R112.1, U102.4 (IN-)
/N_H1P: C106.1, D104.3 (COM), R109.2, R110.1, R113.2, U102.3 (IN+)
/N_ILIM: R101.1, U101.10 (ILIM)
/N_IMON: R105.1, R129.1, U101.13 (IMON)
/N_OV: R103.2, R104.1, U101.7 (OVP)
/N_RC111: C150.2, R150.1, U111.7 (Rext/Cext)
/N_RC113: C151.2, R151.1, U113.7 (Rext/Cext)
/N_RNP: R190.2, R191.1, U121.3 (IN+)
/N_UV: R102.2, R103.1, U101.6 (UVLO)
/N_UVP: C108.1, D106.3 (COM), R114.2, R115.1, R116.2, U103.3 (IN+)
/OVN: U122.2 (B), U123.4 (Y)
/P5N: U105.5 (2Y), U111.3 (~CLR)
/QQ: U111.5 (Q), U118.5 (2A)
/QQF: U110.6 (2B), U118.3 (2Y)
/QUAL: R123.1, R147.2, U111.2 (B)
/QUAL_TAP: F11.1, R147.1
/REF103: U103.4 (IN-), U103.5 (REF)
/REF104: R141.1, U104.5 (REF)
/REF115: R117.1, U115.5 (REF)
/REF117: R160.1, U117.5 (REF)
/REF119: R184.1, U119.5 (REF)
/REF120: U120.4 (IN-), U120.5 (REF)
/REF121: U121.4 (IN-), U121.5 (REF)
/RFC_OFF: R132.1, U106.3 (2Y)
/RFC_OFF_J: J101.10, R132.2
/RGN: R121.2, R133.1, R190.1
/RGN_ON: U109.3 (B), U118.2 (1B), U121.1 (OUT)
/RGN_TAP: F05.1, R121.1
/SCL: J1.7, W7.1
/SDA: J1.8, W7.3
/STAT: J1.3, J101.4, R107.1
/T1_VMOT: F01.1, R109.1
/T2C: F03.1, R111.1, R114.1
/T6_3V3: F07.1, R175.1
/T19_FCI: F23.1, R162.1
/T22_BAL: F08.1, R178.1
/TS_EXT: J1.13, W6.1
/UF: U106.1 (1A), U116.7 (1Y)
/UVB: R116.1, U103.1 (OUT), U116.1 (1A), U116.6 (2B)
/VCHG: J1.18, J1.19, W3.1
/VCHGIN: C102a.1, C102b.1, C102c.1, D107.1 (K), J1.10, R102.1, U101.1 (IN), U101.2 (IN), U101.5 (IN_SYS)
/VCHGOUT: C103.1, D103.1 (K), U101.17 (OUT), U101.18 (OUT), W1.1
/W: U109.6 (C), U116.3 (2Y)
/X: U106.7 (1Y), U107.3 (B)
/Y1: U107.4 (Y), U108.6 (C)

Notes on the sheet:
CHG header, lead pads and taps
Input bulk, TVS and eFuse U101 (B.4)
Comparators (B.2)
BQ29200 OUT input and permit logic (B.1, B.3)

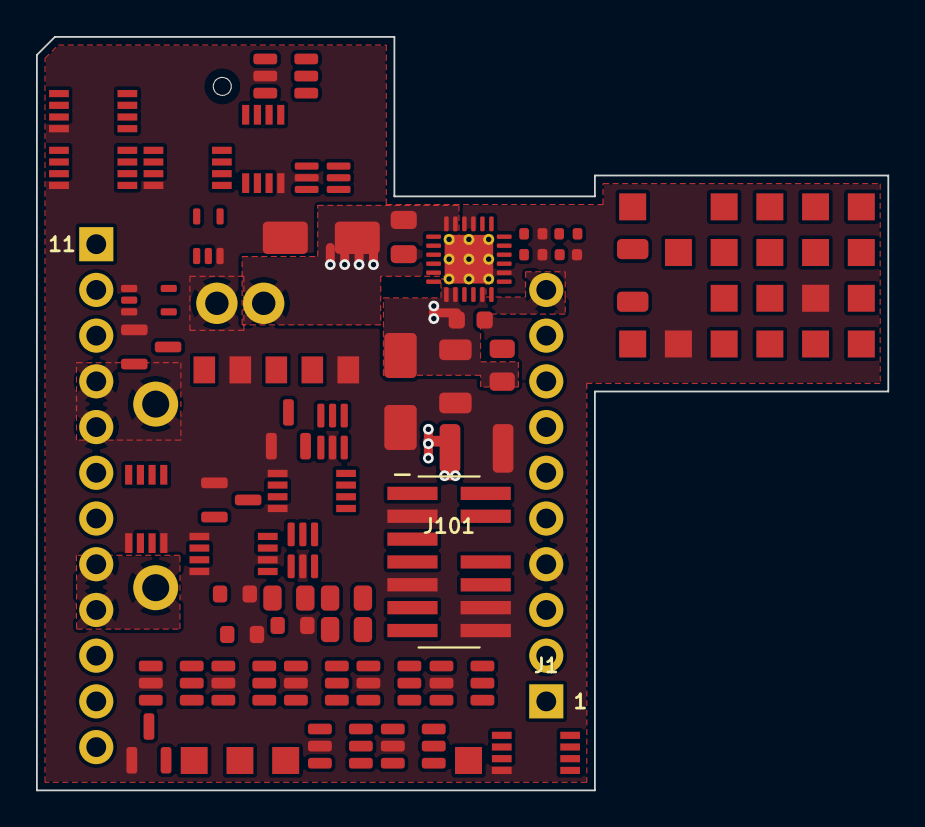
[picture p210: board cr.kicad_pcb from above]

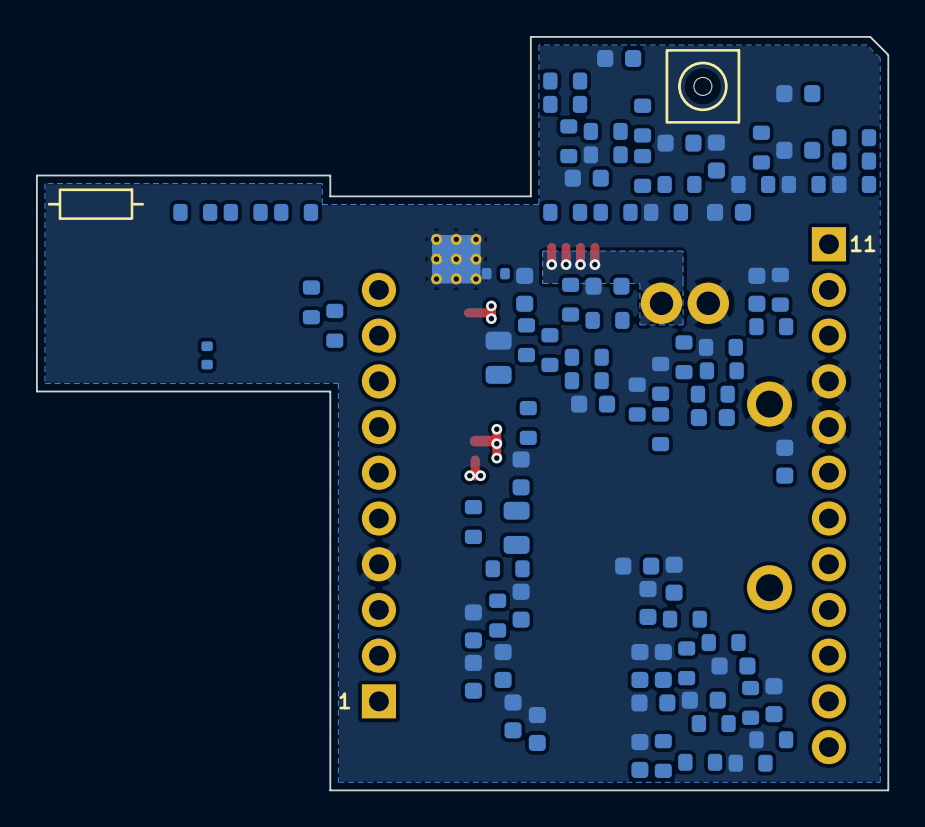
[picture p211: board cr.kicad_pcb from below]

Board: 4 copper layers, 47.3 x 41.9 mm, 163 parts (84 on the bottom side), 99 nets.

Other parts of the board:
FT1M: FT1_Foot_4.0x1.6mm_BottomMark
FT2H: FT2_FillHole_NPTH_1.0mm_KeepOut
FT2M: FT2_Foot_4.0x4.0mm_BottomMark
