Tangineering/DC-Balancer-Board-Teensy/hardware/charger_evm_r8/eib/eib.kicad_pcb

## KiCad design hardware/charger_evm_r8/eib/eib.kicad_pcb (2026-11-11)

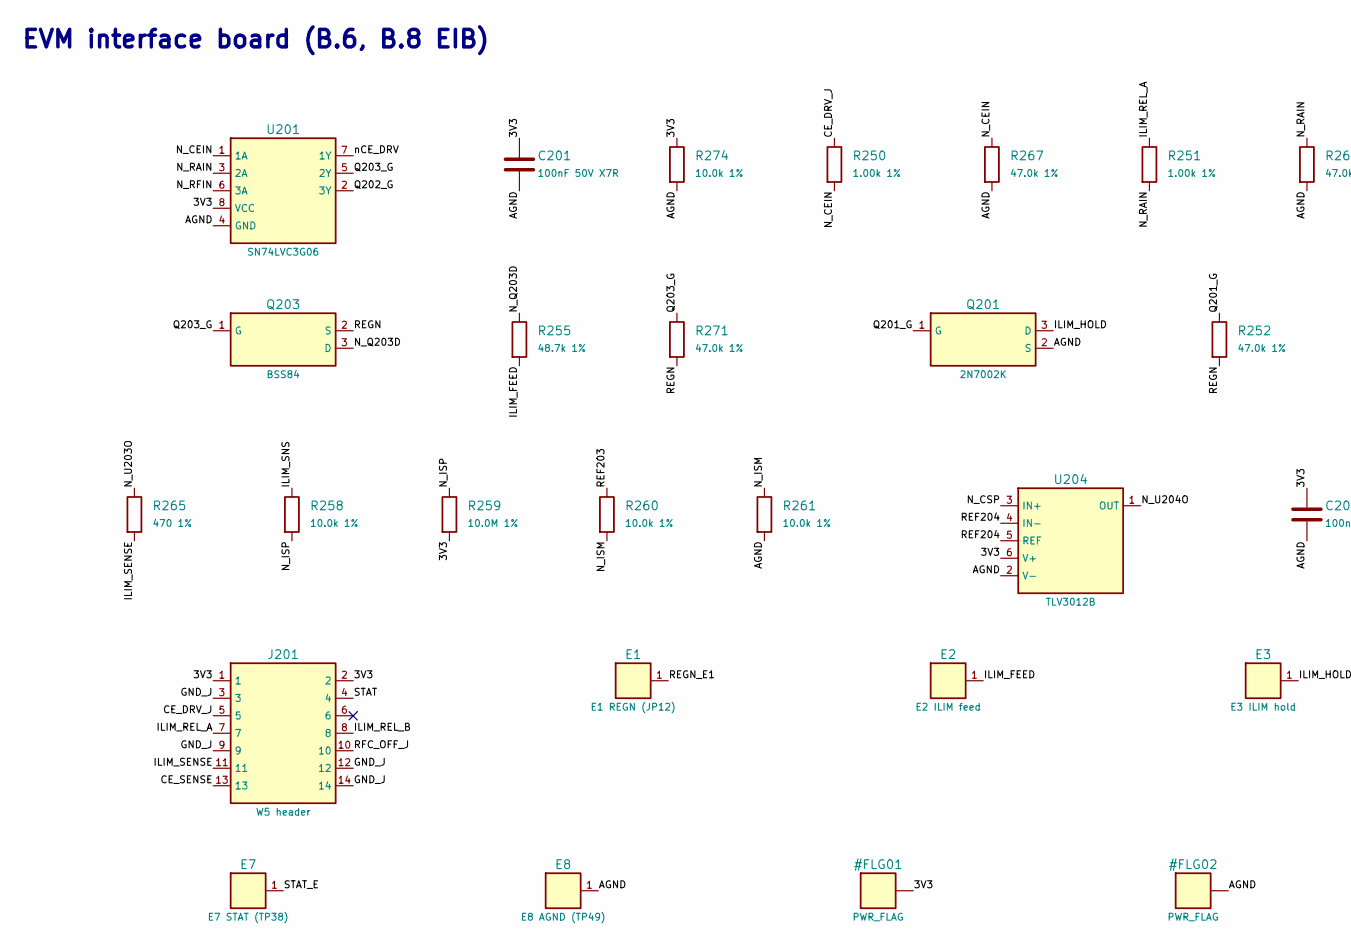
[picture p212: schematic eib.kicad_sch, EIB - EVM interface board, part in row 1, column 1]

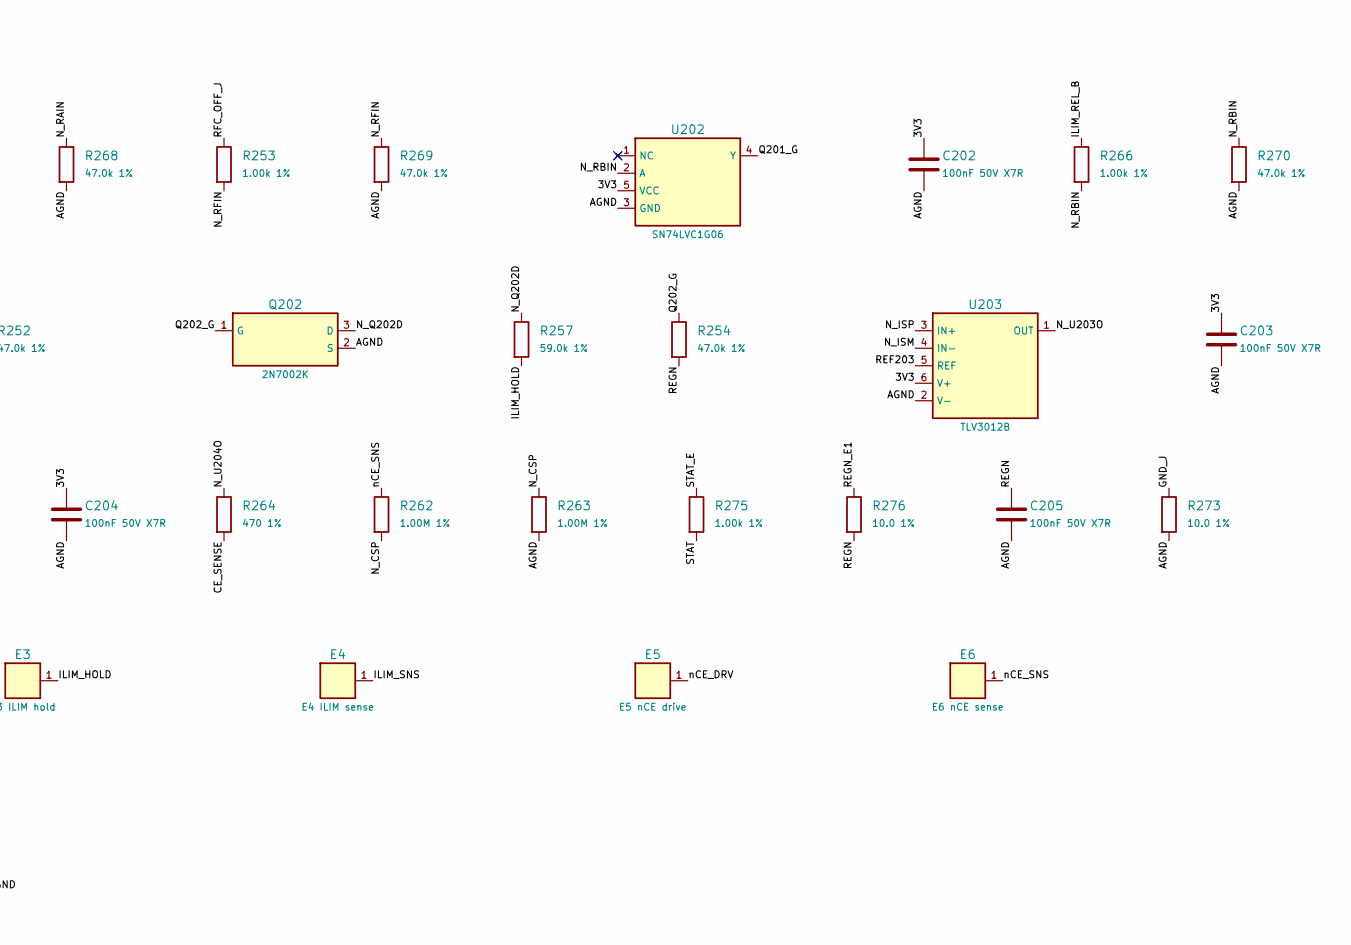
[picture p213: schematic eib.kicad_sch, EIB - EVM interface board, part in row 1, column 2]

Parts:
C201, C202, C203, C204, C205: 100nF 50V X7R; C_0603_1608Metric_CrtYd0.10; MPN GRM188R71H104KA93D
E1: E1 REGN (JP12); LeadPad_PTH_D1.0mm_P1.8mm
E2: E2 ILIM feed; LeadPad_PTH_D1.0mm_P1.8mm
E3: E3 ILIM hold; LeadPad_PTH_D1.0mm_P1.8mm
E4: E4 ILIM sense; LeadPad_PTH_D1.0mm_P1.8mm
E5: E5 nCE drive; LeadPad_PTH_D1.0mm_P1.8mm
E6: E6 nCE sense; LeadPad_PTH_D1.0mm_P1.8mm
E7: E7 STAT (TP38); LeadPad_PTH_D1.0mm_P1.8mm
E8: E8 AGND (TP49); LeadPad_PTH_D1.0mm_P1.8mm
J201: W5 header; Samtec_FTSH-107-01-DV_2x07_P1.27mm_SMD; MPN Samtec FTSH/SHF-107 class (T-A-05)
Q201, Q202: 2N7002K; SOT-23_CrtYd0.10; MPN 2N7002KT1G
Q203: BSS84; SOT-23_CrtYd0.10; MPN BSS84LT1G
R250, R251, R253, R266, R275: 1.00k 1%; R_0603_1608Metric_CrtYd0.10; MPN CRCW06031K00FKEA
R252, R254, R267, R268, R269, R270, R271: 47.0k 1%; R_0603_1608Metric_CrtYd0.10; MPN CRCW060347K0FKEA
R255: 48.7k 1%; R_0603_1608Metric_CrtYd0.10; MPN CRCW060348K7FKEA
R257: 59.0k 1%; R_0603_1608Metric_CrtYd0.10; MPN CRCW060359K0FKEA
R258, R260, R261, R274: 10.0k 1%; R_0603_1608Metric_CrtYd0.10; MPN CRCW060310K0FKEA
R259: 10.0M 1%; R_0603_1608Metric_CrtYd0.10; MPN CRCW060310M0FKEA
R262, R263: 1.00M 1%; R_0603_1608Metric_CrtYd0.10; MPN CRCW06031M00FKEA
R264, R265: 470 1%; R_0603_1608Metric_CrtYd0.10; MPN CRCW0603470RFKEA
R273, R276: 10.0 1%; R_0603_1608Metric_CrtYd0.10; MPN CRCW060310R0FKEA
U201: SN74LVC3G06; Texas_DCT0008A_SSOP-8_TI-land_CrtYd0.10; MPN SN74LVC3G06DCTR
U202: SN74LVC1G06; Texas_DCK-5_SC-70-5_CrtYd0.10; MPN SN74LVC1G06DCKR
U203, U204: TLV3012B; SOT-23-6_CrtYd0.10; MPN TLV3012BIDBVR

Connections:
/3V3: C201.1, C202.1, C203.1, C204.1, J201.1, J201.2, R259.2, R274.1, U201.8 (VCC), U202.5 (VCC), U203.6 (V+), U204.6 (V+)
/AGND: C201.2, C202.2, C203.2, C204.2, C205.2, E8.1, Q201.2 (S), Q202.2 (S), R261.2, R263.2, R267.2, R268.2, R269.2, R270.2, R273.2, R274.2, U201.4 (GND), U202.3 (GND), U203.2 (V-), U204.2 (V-)
/CE_DRV_J: J201.5, R250.1
/CE_SENSE: J201.13, R264.2
/GND_J: J201.3, J201.9, J201.12, J201.14, R273.1
/ILIM_FEED: E2.1, R255.2
/ILIM_HOLD: E3.1, Q201.3 (D), R257.2
/ILIM_REL_A: J201.7, R251.1
/ILIM_REL_B: J201.8, R266.1
/ILIM_SENSE: J201.11, R265.2
/ILIM_SNS: E4.1, R258.1
/N_CEIN: R250.2, R267.1, U201.1 (1A)
/N_CSP: R262.2, R263.1, U204.3 (IN+)
/N_ISM: R260.2, R261.1, U203.4 (IN-)
/N_ISP: R258.2, R259.1, U203.3 (IN+)
/N_Q202D: Q202.3 (D), R257.1
/N_Q203D: Q203.3 (D), R255.1
/N_RAIN: R251.2, R268.1, U201.3 (2A)
/N_RBIN: R266.2, R270.1, U202.2 (A)
/N_RFIN: R253.2, R269.1, U201.6 (3A)
/N_U203O: R265.1, U203.1 (OUT)
/N_U204O: R264.1, U204.1 (OUT)
/Q201_G: Q201.1 (G), R252.1, U202.4 (Y)
/Q202_G: Q202.1 (G), R254.1, U201.2 (3Y)
/Q203_G: Q203.1 (G), R271.1, U201.5 (2Y)
/REF203: R260.1, U203.5 (REF)
/REF204: U204.4 (IN-), U204.5 (REF)
/REGN: C205.1, Q203.2 (S), R252.2, R254.2, R271.2, R276.2
/REGN_E1: E1.1, R276.1
/RFC_OFF_J: J201.10, R253.1
/STAT: J201.4, R275.2
/STAT_E: E7.1, R275.1
/nCE_DRV: E5.1, U201.7 (1Y)
/nCE_SNS: E6.1, R262.1

Notes on the sheet:
EVM interface board (B.6, B.8 EIB)

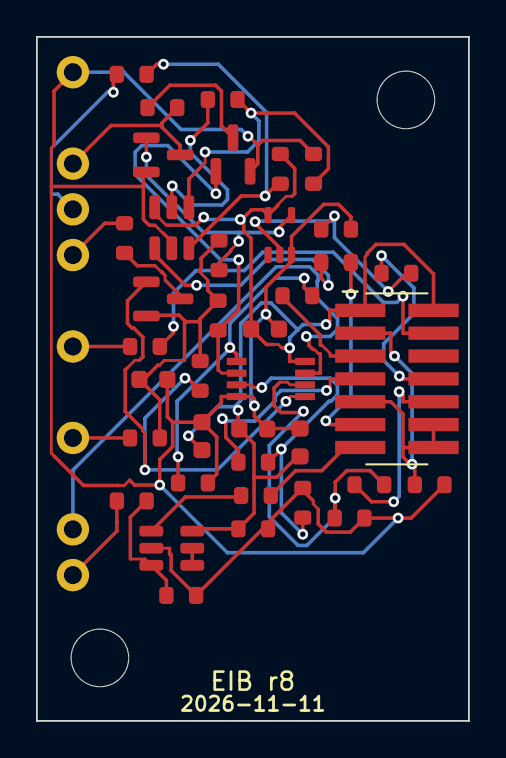
[picture p214: board eib.kicad_pcb from above]

Board: 2 copper layers, 24.0 x 38.0 mm, 48 parts (0 on the bottom side), 34 nets.

Other parts of the board:
H1, H2: MountingHole_3.2mm_M3_KeepOut7mm
