Tangineering/DC-Balancer-Board-Teensy/docs.diff.txt

diff --git a/PLAN.md b/PLAN.md
index 1fabddc..dce3cd0 100644
--- a/PLAN.md
+++ b/PLAN.md
@@ -944,6 +944,40 @@ appear as `t_us` gaps (the decoder reports max interval / missed periods). A sam
 
 **Record layout (52 bytes, little-endian, packed):**
 
+> **Format note (current: v7, 106 B, fw v20).** The table below is the ORIGINAL v1 record and is
+> kept because every field in it still holds its v1 byte offset — the format has only ever been
+> APPENDED to. Subsequent versions: v3 (68 B) added `V_fc`/`V_batt`/`V_chg`/`V_rgn`; v4 (68 B,
+> header-only) added the committed per-run profile parameters; v5 (76 B, fw v11) added `u_unsat`
+> and `drive_x0`; v6 (92 B, fw v16) added `encoder_pos`, `enc_period_ref_us`,
+> `enc_multi_pitch_count`, `enc_spurious_drop_count`; **v7 (106 B, fw v20) added
+> `enc_edge_count_a` (offset 92), `enc_edge_count_b` (96), `enc_phase_ewma` (100),
+> `enc_duty_a_ewma` (102) and `enc_duty_b_ewma` (104)**. The header layout is unchanged from v4;
+> only `hdr[4]` (the format version, now 7) and `hdr[5]` (the record size, now 106) differ.
+> Decoders read the record stride from `hdr[5]`, never assume it.
+>
+> The two v7 **counters** are the raw per-channel ISR edge counts — the direct before/after metric
+> for the Schmitt front-end fix, and the only signal that separates a dead channel from a dead
+> estimator offline. The three v7 **levels** are quadrature geometry: shift-based integer EWMAs
+> (α = 1/4), fixed point in **1/256ths of one slot pitch**, computed in the ISRs. Phase is the
+> last accepted A-rising edge to the next B-rising edge over `encPeriodRefUs` (the sensor pair's
+> mount geometry, direction-gated to forward and plausibility-gated at `dt < period_ref`); the two
+> duties are each channel's rise-to-fall high time over the same reference (that channel's optical
+> health, independent of the mount). Expected healthy on this board: **phase 64 (0.25 pitch), both
+> duties 128 (0.50)** — the 43° sensor offset is 10.75 pitches, but the sensors were physically
+> swapped with the 90-slot wheel, so A leads B forward and the fraction is the complement. All
+> three are printed in the State-98 `'S'` dump as pitch fractions.
+>
+> **Decoder contract — three field classes, and mixing them up produces plausible nonsense:**
+> **levels** (`enc_period_ref_us`, `enc_phase_ewma`, `enc_duty_a_ewma`, `enc_duty_b_ewma`) are read
+> directly and NEVER differenced, and a 0 means "no measurement yet" rather than a real zero;
+> **reset-cleared counters** (`enc_multi_pitch_count`, `enc_spurious_drop_count`) are diffed for a
+> rate, where a negative diff is a mid-run `encoderVelReset()` — which also clears all four levels,
+> since they are normalised by `enc_period_ref_us`;
+> **boot-monotonic counters** (`enc_edge_count_a`/`_b`) are never cleared by anything, so a
+> negative diff there is a uint32 wrap or an MCU reset. The authoritative per-field layout is the
+> `BenchLogRecord` struct in `teensy_controller/teensy_controller.ino`, whose `offsetof`
+> static_asserts pin every offset.
+
 | Field | Type | Source |
 |---|---|---|
 | `t_us` | u32 | `micros()` at sample |
diff --git a/docs/firmware-versions.md b/docs/firmware-versions.md
index b52008b..04b8403 100644
--- a/docs/firmware-versions.md
+++ b/docs/firmware-versions.md
@@ -39,3 +39,4 @@ and `PS0003`â€“`TP0005` (`analogReadAveraging(8)`).
 | 17 | 2026-08-17 | **Velocity-estimator integrity: the Ã—2 rounding basin and the mid-run `v = 0` injection.** Two independent defects found in the ML0164â€“ML0180 analysis round, both of which put a wrong velocity into the ~545 A/(m/s) drive loop. **No BLG format change (stays v6 / 92 B), no UDP, command, pin, sequencing, fault, controller or coefficient change.** (1) **FRACTIONAL-PITCH LEDGER.** fw v15 rounded the decoder pitch count `pitches = (|Î” encoderPos| + 1) >> 1` to the nearest **whole** pitch, so a spurious mid-pitch A-edge â€” which carries `|Î”| = 1`, a genuine **half** pitch â€” rounded **up**, and a `T/2` interval was stored as a full pitch: `v_actual` read exactly **2Ã— true speed**, self-sustaining once the EWMA seeded at `T/2` (the 0.625 low-side gate is keyed to `ref`). Every run in the batch entered it at breakaway (0.08â€“0.24 m/s); the locked runs (ML0164/ML0168) show an accepted-interval rate of exactly 2.00 per true slot and `ref/T_true = 0.500`, escaping only above ~1.0â€“1.6 m/s. `|Î”|` is already in **half-pitch units** (Ã—2 decode), so the stored per-pitch period is now `period Ã— 2 / |Î”|` â€” a ledger, not a count. `|Î”| = 2` takes an arithmetic-free fast path and is **byte-identical** to fw v12â€“v16 (clean-stream `v_act` traces stay comparable); `|Î”| = 1` stores `T`, `|Î”| = 3` (1.5 pitches) stores `2/3 Ã— period` where fw v15 stored `period/2`, and `|Î”| = 2k` stores `period/k` as before. Still **one UDIV** per accepted interval, none in the `|Î”| = 2` common case; the per-pitch `ENC_PERIOD_MIN_US` floor now applies to the fractional value. `encLastPitches`/`encMultiPitchCount` deliberately stay whole-pitch **display** quantities. (2) **MID-RUN RESET â€” ROOT CAUSE.** `updateWheelSpeed()` latched `now = micros()` several instructions **before** snapshotting `encLastEdgeUs`; an A-rising edge accepted inside that window writes a timestamp **greater** than `now`, the unsigned age `(now - lastEdge)` wraps to ~2^32, and the edge-age stale test declared a fast, healthy wheel stopped and forced a full `encoderVelReset()`. Nanosecond window Ã— ~380 accepted edges/s Ã— 25 s runs â‰ˆ 0.5 hits per long run â€” matching YP0166 (t = 26.2398 s: `v_act` â†’ 0 for ~6 ms, both ISR counters cleared, drive controller answered +12 A then âˆ’12 A within 12 ms) and TP0171 (t = 11.844 s, during coast). Fixed by a **signed** age comparison in both age tests: a future timestamp has age 0. (3) **DEFENCE IN DEPTH.** An `encoderVelReset()` taken while the last published `|v|` exceeded `ENC_VEL_CORROB_MIN_MPS = 0.30 m/s` now **captures that reading and holds it** instead of publishing a naked 0, until a FULL-ring reading of either sign corroborates it (depth only, no sign term â€” safety review MED-1: a full-ring opposite-sign reading is a vetted genuine reversal); the magnitude defence against TP0171's half-pitch re-seed (`ref = 925 Âµs`) is the fractional-pitch ledger, not this gate. The hold is bounded at `ENC_VEL_TIMEOUT_US` (100 ms) from the reset, the same class as every other hold in the reader; the two stale paths explicitly disarm it, so boot and standstill zero exactly as before (a State-3 reset above 0.30 m/s now holds the true coasting value for up to 100 ms into Idle â€” log-trace change only). The documented "forced to 0 on exactly FOUR events" contract becomes **three**. (4) **PER-PATH DROP ATTRIBUTION** (diagnostic): `encDropRawFloor` / `encDropLowGate` / `encDropPitchFloor` split the fw v16 `encSpuriousDropCount` sum by cause; the sum keeps its exact semantics and remains the only one logged (v6 decoders untouched), and the three new counters appear in the State-98 `'S'` dump only. Tooling in lockstep: the `encoder_diagnostics` panel (b) now compares the reference-implied speed against the `encoder_pos` truth velocity instead of against `v_act` â€” the old pairing was self-confirming, since both traces are estimator outputs and agree with each other inside a basin. | *(pending first flash; fw v16 is on the board â€” confirmed in every logs-164â€“180 header â€” so this flash carries v17 alone)* |
 | 18 | 2026-08-25 | **Encoder wheel replaced: 120 slots â†’ 90 slots, and the constants that derive from the slot pitch.** A HARDWARE change, reconciled in firmware. The flywheel encoder disc was physically swapped on the bench; source is an **operator hand count (2026-08-25) cross-checked against the decoder â€” one hand-turned flywheel revolution reads `encoderPos == 180`**, which confirms the slot count and, again, the Ã—2 quadrature decode. `FLYWHEEL_RADIUS_M` is **unchanged** at 0.0762 m (same flywheel, new disc), so `v_actual` remains flywheel SURFACE speed and the surface-speed convention is untouched. **No pin, sequencing, fault, telemetry (UDP v4 / 58 B), BLG format (stays v6 / 92 B) or command change, and no control-code edit** â€” the ISR, decoder, drive-controller wrapper and both PIs are byte-for-byte as fw v17 left them. (1) **SCALE.** `ENCODER_SLOTS_PER_REV` 120.0f â†’ **90.0f**, so the derived `ENCODER_COUNTS_PER_REV` 240 â†’ **180** and `ENC_SLOT_PITCH_M` = 2Ï€Â·0.0762/90 = **5.3198 mm** (was 3.990 mm). âš ï¸ `v_actual` and the BLG `v_act` column read **4/3 Ã—** their fw v17 value for identical motion: **a v18 trace is NOT comparable with a v12â€“v17 trace**, and pre-v18 logs were taken on a physically different wheel. The header `fwVersion` disambiguates, and `tools/benchlog_analysis/figures.py` now selects the pitch from each log's own `fw_version`. `VELOCITY_CHAIN_CALIBRATED` stays **1** â€” a direct slot count cross-checked against the decoder is the strongest source the chain has had. (2) **`ENC_ADAPT_MAX_REF_US` 13000u â†’ 15000u, RE-DERIVED, not retuned.** The low-side gate's arming speed is the fw v13 S1 decel condition `v_arm = sqrt(3Â·a_maxÂ·pitch)` at `a_max = 6.96 m/sÂ²`: `sqrt(3 Ã— 6.96 Ã— 5.3198e-3) = 0.3333 m/s`, armed ~6 % inside at 0.3533 m/s, `ref = pitch/0.3533 = 15058 Âµs`, rounded to the clean **15000 Âµs** (arms at 0.3546 m/s = 1.064 Ã— v_arm). The firmware-unmitigated low-speed band therefore widens from 0.04â€“0.31 to **0.05â€“0.36 m/s**; it still belongs to the 74HC14 Schmitt hardware fix, which remains outstanding. (3) **`ENC_VEL_CORROB_MIN_MPS` 0.30f â†’ 0.35f**, tracking the arming point it is deliberately pinned to â€” the fw v17 rationale is unchanged, only the speed it names moved. (4) **`V_SP_ZERO_THRESH` 0.05f â†’ 0.07f.** The wider pitch raises the estimator's reportable zero-speed floor (`pitch / ENC_VEL_TIMEOUT_US`) from 0.0399 to **0.0532 m/s**, which the existing `static_assert` no longer admitted against 0.05. 0.07 restores a ~24 % margin â€” the same class as the pairing it supersedes â€” and stays far below the 0.5 m/s slowest gate-checked speed of the drive synthesis. **Zero-cutoff logic is unchanged.** `ENC_PERIOD_MIN_US` stays 200 Âµs; the speed it bounds rises 19.95 â†’ **26.6 m/s** with the pitch, widening the margin over `MANUAL_MOTOR_V_MAX`. (5) **DRIVE COEFFICIENTS REGENERATED.** `controller_design_MIMO/plant_mimo.py` `ENC_SLOTS` 120 â†’ 90 (and `V_EST_MIN` 0.03 â†’ 0.053, the same floor), then `synthesize_drive_siso.py` re-run at the **SAME weight rung WC = 60, Wu(0.25, 300, 12.5) â€” no weight retune**. The estimator transport delay `(N+1)Â·pitch/(2v)` scales with the pitch, so it grew Ã—4/3 at every corner (0.5 m/s: 11.97 â†’ **15.96 ms**; 2 m/s: 2.99 â†’ 3.99 ms; 5 m/s: 1.20 â†’ 1.60 ms). **ALL GATES PASSED**: crossover **17.25 rad/s** (was 17.52), PM **50.2Â°** (was 50.8), DM **50.76 ms**, GM 15.7 dB, 72/72 corners stable, worst-corner â€–Sâ€–âˆž **2.867 cont / 3.017 disc** (was 2.427/2.535 â€” the binding corner is `K_v = 1.35, pole_factor = 0.5, v0 = 0.5 m/s`; the continuous figure passes the < 3 gate but now exceeds the < 2.5 *target*, and the discrete figure is above 3 â€” worth watching, it is the price of the longer estimator delay at the validity floor), estimator phase at crossover **3.94Â°** at 2 m/s, and PM at the 0.5 m/s validity-floor corner **38.4Â°** (was 41.8Â°, gate > 30Â°). `validate_drive_siso.py` **15/16** â€” the one failure is the documented float32-STATE regen divergence (1.555e-2 A), unchanged in kind. âš ï¸ **A v18 `'V'` trace is a DIFFERENT CONTROL LAW from a v17 one**; `figures/drive_siso_step.csv` was regenerated with it and is the correct overlay reference. (6) **ANTI-WINDUP REALIZATION CHANGED â€” a SAFETY fix found by this round's test agent and folded in so it ships in the same flash.** `drive_controller.h`'s state update becomes the GENERAL Hanus conditioned form `x_next = ADÂ·x + BDÂ·e + LÂ·(u âˆ’ u_unsat)`, with a new pole-placed coefficient `DRIVE_CTRL_L`, replacing the fw v10â€“v17 SELF-conditioned special case `L = BD/DD` (`x_next = ACÂ·x + BDÂ·u/DD`). **Root cause:** `eig(AC)` are the discrete controller's transmission ZEROS, and one sits at **exactly z = âˆ’1** â€” structurally, because the controller is a PARALLEL sum of two TUSTIN branches whose numerators both carry `(z+1)` (Tustin of the integrator is `(kIÂ·Ts/2)(z+1)/(zâˆ’1)`), so the factor survives at any weight rung on any plant. Zero damping at Nyquist in the saturated mode let a relay limit cycle live against the Â±12 A clamp. **Measured** on constant-error rail dwells (e âˆˆ [0.25, 12.0] step 0.25, 2000 ticks, shipped float32 coefficients + double state): **fw v17 fails 14 of 48 cases (e = 8.25â€¦11.75), fw v18-pre-fix 15 of 48**, every failure a full **24 A peak-to-peak period-4 (++âˆ’âˆ’) square wave at 125 Hz**. âš ï¸ **The defect shipped from fw v10 onward and is NOT a v18 regression** â€” the v18 coefficients merely moved a basin boundary onto the `e = 5.0` probe the tests used; fw v17 would have failed at `e = 9.0`. Hardware-reachable wherever a large error persists at the rail with no vehicle response, e.g. the ML0151 ~428 ms VESC post-reversal dead window. **Unsaturated behaviour is unchanged** â€” the conditioning term is identically zero off the clamp â€” so `AD/BD/CD/DD`, the corner sweep and every linear gate are untouched. `L` = `[+1.45551145e-1, âˆ’8.581254e-3, âˆ’1.9437848e-2, +2.904284e-3, +2.403627e-3]`, placed by **minimal perturbation** of `eig(AC)`: only the z = âˆ’1 mode moves (to **+0.5**); the slow positive-real modes (0.999695, 0.983988) are deliberately left alone, because pulling them inward destroys the integrator's conditioning memory (measured on that attempt: âˆ’0.227 m/s standing error and a 17.9 mm/s hunting cycle, six Â§8 gates failed). Achieved `eig(AD âˆ’ LÂ·CD)` = {âˆ’0.591196, +0.245326, +0.500000, +0.983988, +0.999695}. **Two NEW synthesis gates (Â§8e):** (a) every *oscillatory* (non-positive-real) eigenvalue < 1 âˆ’ 1e-3 â€” worst is 0.591196; the slow real modes are exempt as a documented deviation, since a decaying exponential cannot sustain oscillation and forcing margin on them breaks the controller; and (b) **load-bearing**, the 48-case dwell sweep, worst tail p-p **0.000e+00 A**. Gate (a) is acceptance-checked to FAIL both the fw v17 (âˆ’1.0000009) and fw v18-pre-fix (âˆ’0.9999990) spectra â€” a plain `max|eig| < 1` test would have passed the latter and still limit-cycled. A third replay episode **`dwell`** (600 ticks at e = 5.0 m/s, tolerance 0.10 mA) ships in `drive_replay_vectors.h` as the firmware-side regression; neither existing episode could detect this (`small` never clamps, `regen` releases after ~0.8 s). `validate_drive_siso.py` is now **17/17** â€” the long-standing float32-STATE "expected failure" is GONE: re-measured, a float32 state recursion diverges only ~1.1e-5 A on the regen episode (was ~1.4e-2) because the conditioned trajectory no longer rides the clamp boundary. **The state stays DOUBLE regardless** (only ~2 decades of margin, and nothing gates float32 off these two trajectories). Stale claims in `drive_controller.h` and the emitted coefficient header were corrected in lockstep. | *(pending first flash; fw v16 is on the board, so the next flash carries v17 + v18)* |
 | 19 | 2026-08-25 | **Two changes: encoder fields on the `'L'` Serial-Plotter stream, and a conduction-aware handoff slew for the droop share ratio. No pin, sequencing, fault, controller-coefficient, BLG-format (stays v6 / 92 B) or UDP-telemetry (stays v4 / 58 B) change; no edit to the motor/drive controller, the encoder ISRs or estimator, the quadrature decode, `applyShareRatio()`, the share controller, or the PIs.** **(a) `'L'` stream: eight fields -> ELEVEN.** Appended after `v_act`, in order: `enc_pos` (`encoderPos`, the raw x2 quadrature count), `edgeA` (`encEdgeCountA`) and `edgeB` (`encEdgeCountB`). Operator request: watch position and raw per-channel edge counts live while hand-rotating the wheel, which separates "a channel is dead" from "the decode is wrong" without dropping into the `'S'` dump - the fw v8 observability lesson applied to the live stream rather than the dump. All three are ISR-written diagnostic volatiles already read by the `'S'` dump (and `encoderPos` by `logSampleTick()`); they are read as plain single 32-bit reads, atomic on Cortex-M7, and deliberately NOT snapshotted as a set (one-edge skew is irrelevant at the 20 ms plot cadence). No control path reads them and no new state is introduced. The fixed-field-count rule is UNCHANGED - the IDE plotter keys its series off the labels and re-legends the graph if the count varies mid-run, so it is eleven now, always eleven. Backpressure guard **110 -> 192 B**. The itemized worst-case line is labels+separators 76 + 8 floats x 7 B = 56 + int32 11 + 2 x uint32 20 + CRLF 2 = **exactly 165 B**; 165 was rejected in review as an exact fit rather than a guard (one 8-character float such as `-123.456` overruns it, and Teensy USB-CDC `write()` then BLOCKS - the loop stall this guard exists to prevent), so 192 ships, leaving ~one extra character per float of headroom. The itemization lives at the guard so any future field is re-derived, not estimated. **(b) Conduction-aware handoff slew (TP0201 mitigation, safety-relevant).** New `SHARE_HANDOFF_MIN_A` = **0.15 A** (dark threshold), `SHARE_HANDOFF_LIVE_A` = **0.20 A** (live re-entry), `DROOP_RATIO_SLEW_HANDOFF_PER_TICK` = **0.002/tick** (10x slower than `DROOP_RATIO_SLEW_PER_TICK` = 0.02) and `SHARE_HANDOFF_DWELL_MAX_TICKS` = **175** (~200 ms at the ~880 Hz loop rate, counted only on ticks where the ratio actually MOVED). `updateShareSlewMode()` runs **once per `powerBalance()` tick**, above the open-loop feedforward branch so feedforward ticks advance the state too, and stores the tick's ceiling in `shareSlewStepThisTick`; **all three** in-band slew sites (open-loop feedforward, fw v6 effective-setpoint reference, closed-loop actuation) READ that stored value, which makes the fw v6 requirement - reference and actuation cannot disagree about how fast the split may move - structural rather than accidental. **Evidence chain - TP0201 (fw v18, 2026-08-25):** the share loop armed OPEN->CLOSED while FC was the sole conductor (`share_act` ~ 1.0, `I_batt` 0.06-0.08 A of trickle). Seeded at `droopSlew_prev` ~ 0.85, the controller walked toward the governor-clipped ~0.556 at the full 0.02/tick, crossing the FC->BT conduction handoff in ~20 ms. FC ceased conducting - **`V_fc` ROSE 0.66 V, the unloaded signature** - before BT's reactive RT1987 ideal diode picked up; the bus ran **unsourced for ~5.7 ms** and decayed capacitively **15.86 -> 12.185 V**, 0.185 V above `LIMIT_V_BUS_MIN` and 10 ms inside the 20 ms fault dwell, so nothing faulted. TP0200 took the identical arming step harmlessly because BT was already conducting 0.556 A. The hazard precondition is therefore NOT arming but: **the ratio is slewing while a channel that must pick up load is not meaningfully conducting** - which is why the fix is keyed to conduction, not to the arming transition. The `V_fc` rise also **refutes the supply-transient hypothesis for TP0201**; see `docs/boost-bringup-debug.md`. **Review-round mechanism detail (all three findings changed the shipped design):** the conduction test runs on per-channel **EMAs** of `fabsf(I_fc)`/`fabsf(I_batt)` at `SHARE_GOV_FILT_ALPHA` (0.05/tick, ~20 ms - the same weight and doctrine as `share_govTotAFilt`), not on raw ADC reads, because a raw test would chatter the ceiling near 0.15 A and the governor doctrine forbids a raw measurement gating the reference; and the dark/live decision is **hysteretic** (dark below 0.15 A, live only at 0.20 A) so the boundary cannot dither. The filters advance only on ticks that reach the update, which is correct because both earlier returns in `powerBalance()` (the setpoint-latch cutoff and the `SHARE_I_TOT_MIN_A` minimum-load gate) freeze the entire loop - no slew site can consume a stale value. State is seeded **DARK** at boot and by `resetShareControlState()`: dark selects the slower, more conservative ceiling, so a cold start or reset cannot begin by slamming the ratio across an unmeasured conduction state. **The `SHARE_HANDOFF_DWELL_MAX_TICKS` cap is load-bearing, and an earlier draft of this feature's rationale was WRONG.** That draft claimed the fw v6 review-S4 regime and the handoff regime were disjoint (S4 accepts a ~35-tick governor floor-clip walk because it is far shorter than a ~50-60 ms TP0010/TP0013 dropout cycle). **The claim is struck:** the dropped-out half of a dropout cycle IS a sub-0.15 A channel, and S4's post-load-fall walk is the same dark-minority regime, so the reduced rate applies exactly where S4's bound was load-bearing. What actually bounds the exposure is the dwell allowance - each **distinct** dark event gets **one** allowance of at most 175 slow ticks ON WHICH THE RATIO ACTUALLY MOVED, after which the FULL rate resumes even while the channel stays dark, the allowance re-arming only on a LIVE transition. So S4's bound is **relaxed, not preserved**: at most `SHARE_HANDOFF_DWELL_MAX_TICKS` of slow WALK plus the fast remainder, once per dark event (the motion gate leaves that walk-length bound intact - S4's hazard is the walk itself, not elapsed time), instead of the unbounded ~350-tick slow walk an uncapped design would have permitted. **The MOTION GATE on the dwell counter is load-bearing, and its absence was a HIGH finding in the orchestrator's final review (O1).** An elapsed-tick counter would have defeated this mitigation in the very scenario it was built for: TP0201's pre-arm was a ~1.7 s (~1500-tick) **in-band feedforward HOLD** at sp = 0.85 with BT dark, and every one of those ticks passes the latch and minimum-load gates and selects the handoff rate - so the 175-tick allowance is spent ~1.3 s BEFORE the closed-loop arming, and the arming walk (the hazardous conduction crossing itself) then runs CAPPED at the FULL rate. Motion is detected as a delta in `droopSlew_prev` - the MDAC-truth ratio `applyShareRatio()` records - between consecutive `updateShareSlewMode()` calls, giving a deliberate one-tick lag that only makes the budget one tick more generous. The CEILING selection is NOT motion-gated (it must already be the handoff rate on the first moving tick); only the BURN is. `shareHandoffPrevRatio` is seeded FROM `droopSlew_prev` in `resetShareControlState()` rather than from a literal, because that function deliberately does not touch `droopSlew_prev` and a literal seed would read as spurious first-tick motion. Consequence for the `'S'` dump: CAPPED means the allowance is SPENT, not that the channel has been dark a long time - a long static hold reads HANDOFF with dwell unchanged. A short slow \*\*prefix\*\* followed by the full rate was considered and **rejected**: TP0201's conduction crossing sat at the END of its walk (gains roughly equal ~24.5 ms in), so a prefix-only allowance would not have covered the very event this mitigates. **Known residual, DEFERRED:** at the handoff rate the slew limiter becomes the dominant actuator dynamic and is invisible to `youlaController_Power()`, whose anti-windup back-calculates only against its own [0,1] authority span - its integrator can advance against a split the MDACs have not reached. Exposure is bounded by the dwell cap (~200 ms per event); extending the anti-windup would mean editing the share controller, which is on the do-not-change list, so it is documented at the actuation site rather than fixed. **Observability (`'S'` dump):** a new `share slew mode:` line reports FULL / HANDOFF / CAPPED, both filtered magnitudes with the two thresholds, the dwell counter against its cap, and the tick's step. This is the **only** observable for the mode - it is NOT reconstructible from the logged raw currents (filtered + hysteresis + dwell state, none of which are in the BLG record), and that is noted in the benchlog skill's `log-conventions.md`. **Operator note:** a setpoint-latch release with the re-closed channel still dark walks at the handoff rate for up to ~200 ms before reverting; that lag is the mitigation working, not a stuck loop. **Behaviour invariants:** converged holds with both channels conducting are **bit-identical** to fw v18 (full rate; `constrain()` lands exactly on target once within one step); no change to arming or seed logic, the setpoint latch, governor bounds, `applyShareRatio()`, or the Youla share controller. **NEXT BENCH - both gates are required before this mitigation is trusted, and the S4 relaxation is argued, not measured:** (1) repeat the **light-load dropout condition** (the TP0010/TP0013 class) and confirm the dwell-capped walk does not lengthen a dropout cycle; (2) **re-validate the fw v19 share sweep** end-to-end, watching for a settling overshoot after a dark-event walk (the deferred anti-windup residual); (3) repeat the TP0200/TP0201 arming condition with a deliberately dark standby channel and confirm the bus no longer decays below ~15 V through the handoff - scope-armed, since the ~5.7 ms gap is at the edge of what the ~882 Hz log resolves. Read the `'S'` dump's slew-mode line on every run. | *(pending first flash; fw v18 is not yet flashed either, so the next flash carries v18 + v19)* |
+| 20 | 2026-08-25 | **BLG bench-log RECORD FORMAT v7 (92 B -> 106 B, `hdr[4]` = 7): the two raw per-channel ISR edge counters plus three new quadrature phase / duty-asymmetry statistics.** Observability only. No pin, sequencing, fault, command, controller-coefficient or UDP-telemetry (stays v4 / 58 B) change; the header LAYOUT is unchanged (only `hdr[4]` and `hdr[5]`, the record size decoders already read from the header, differ), and every v1-v6 record field keeps its byte offset. **(a) Edge counters:** `enc_edge_count_a` (uint32, offset 92) and `enc_edge_count_b` (uint32, offset 96) - every `ENC_A`/`ENC_B` CHANGE interrupt taken, pre-decode and pre-filter. The v6 counters describe what the ESTIMATOR did with the edge stream; these describe the stream itself, which makes them the direct before/after acceptance metric for the pending 74HC14 Schmitt bodge and the only signal that separates a DEAD CHANNEL from a DEAD ESTIMATOR offline (A rising with B flat = sensor fault; both rising with `encoder_pos` flat = decode/quadrature fault; both flat = no motion). Until fw v20 they existed only LIVE, on the fw v19 `'L'` stream and the `'S'` dump. **(b) Geometry levels (new firmware feature, not just a log field):** `enc_phase_ewma` (uint16, offset 100), `enc_duty_a_ewma` (102), `enc_duty_b_ewma` (104) - shift-based integer EWMAs (alpha = 1/4, the fw v13 reference-filter idiom), fixed point in **1/256ths of one slot pitch**, computed entirely in the ISRs. Phase is the last ACCEPTED A-rising edge to the next B-rising edge over `encPeriodRefUs` (the sensor pair's MOUNT geometry); the duties are each channel's rise-to-fall high time over the same reference (that channel's OPTICAL/threshold health, independent of the mount). Phase alone cannot separate a mis-mounted sensor from an off-centre logic threshold on a slow phototransistor edge - duty moves for the second and not the first - so together they **replace a scope for verifying the quarter-pitch offset UNDER ROTATION**, the only condition that matters and the one a static probe cannot reproduce. **Expected healthy on this board: phase 0.25 pitch (64), both duties 0.50 (128).** The 90-slot wheel's sensor offset is 43 deg = 10.75 pitches (fractional part 0.75), but the two sensors were **physically swapped** when that wheel was installed, so A leads B forward and the measured A-rise-to-B-rise fraction is the complement, 0.25. **Bench acceptance, first spin:** phase 0.25 +- 0.05, duties 0.50 +- 0.05 each; drift of phase toward 0.00 or 0.50 is the ALIGNED-EDGES failure this catches (at either limit the channels leave quadrature and the `AfirstUp`/`BfirstUp` handshake loses cycles silently - the fw v8 observability lesson). **Gates:** phase is DIRECTION-GATED to `encPeriodDir == +1`, because a mixed-direction average of phi is meaningless (reverse reads `1 - phi`, so averaging 0.25 with 0.75 lands on exactly the fault signature); every sample is PLAUSIBILITY-GATED at `dt < period_ref`, bounding pollution from a spurious B-edge or an unseen fall injecting phi ~ 0.5. Nothing else is filtered - raw-edge visibility is the point. Samples are valid only once the period estimator is seeded (acceptable: the target is geometric and read at cruise). **ISR budget:** two timestamp latches, one subtract, one shift-EWMA per edge; the ONE divide per sample is confined to the rising/falling branches that produce one (~3.3 kHz worst case at the 5 m/s ceiling), and the common A-rising period path gains NO division beyond the fw v17 fractional-pitch ledger's. **"What NOT to change" exception, same class as fw v15/v17:** this is a TAP - the quadrature decode blocks are untouched, no control path reads any of the three, and the estimator's inputs and outputs are unchanged. All three are also printed in the State-98 `'S'` dump as pitch fractions (value/256.0). **(c) DECODER CONTRACT - the record now carries THREE field classes** and mixing them up produces plausible nonsense: **LEVELS** (`enc_period_ref_us` + the three new ones - read directly, NEVER differenced; a 0 means "no measurement yet", not "0.00 pitch"); **RESET-CLEARED CUMULATIVE COUNTERS** (`enc_multi_pitch_count`, `enc_spurious_drop_count` - negative diff = a mid-run `encoderVelReset()`); **BOOT-MONOTONIC CUMULATIVE COUNTERS** (`enc_edge_count_a/b` - never cleared by anything, the only writes in the firmware are the two ISR increments, so a negative diff is a uint32 wrap or an MCU reset). No clear site may be added for the edge counters: the `'L'`/`'S'` consumers rely on the monotonicity. The three levels ARE cleared by `encoderVelReset()`, together with their latch timestamps, because they are normalised by `encPeriodRefUs`, which that reset also clears. **(d) Ring/drain math re-derived at 106 B:** ring = 106 x 1024 = 108544 B (106 KB, still DMAMEM/RAM2); the ~250 ms stall rationale is stated in RECORDS (1024 samples = 1.024 s at 1 kHz) and is therefore unaffected by the record growing; whole-record chunk floor 512/106 = **4 rec = 424 B/tick** against a 106 B/ms fill = **4.0x catch-up** (down from 5.0x at 100 B and 6.0x at 76 B - still four times the fill; a full ring drains in ~0.34 s); 32 MB preallocation covers 33554432 / 106000 = 316 s (**~5.3 min**, down from ~6.1). No buffer grew; `LOG_RING_RECORDS`, `LOG_CHUNK_MAX`, `LOG_PREALLOC_BYTES` unchanged; `LOG_REC_SIZE <= 255` still holds with 149 to spare. `logSampleTick()` stays a **pure copy** - all five new fields are plain aligned volatile reads (atomic on the Cortex-M7, no IRQ masking) in the build-independent diagnostics section. `offsetof` static_asserts pin 92/96/100/102/104 and `sizeof == 106`. **Decoder/tooling lockstep required** (`tools/decode_benchlog.py` + the analysis pipeline) before the next log round; the phase/duty columns want a LEVEL plot, not a rate. **Next bench:** flash (the flash now carries v18 + v19 + v20); read the `'S'` dump's `phase=`/`dutyA=`/`dutyB=` line on a forward hand-spin FIRST and confirm 0.25/0.50/0.50 before trusting any velocity number on the new wheel; then keep one pre-Schmitt run as the "before" edge-rate baseline, so the same fields quantify exactly what the 74HC14 fixed. | *(pending first flash; fw v18/v19 are not yet flashed either, so the next flash carries v18 + v19 + v20)* |
