Tangineering/DC-Balancer-Board-Teensy/docs/reviews/battery_isolation_2026-11-07/calc/bt6_logic_seq_enum.py

"""Battle-test round 6, LOGIC / SEQUENCING lens: model check of IC1 revision 9 (FC windows between purges).

Target: detailed_design_IC1.md revision 9, section 9.11 (9.11.1-9.11.7, Tables 20-27), 9.7, 9.7a, 9.7b, 9.9,
12.4 items 6-7, Table 16 `ERR_FC_ONLY_COLLAPSE`, rows F57-F62, Appendix G.  Extends calc/bt5_logic_seq_enum.py
(which reuses the bt4 network hw()) with:
  - an IDEAL predictor input (purge_tto, purge_active, UNKNOWN; PI-1..PI-7, design 9.11.2);
  - the pre-purge sequence (9.11.3 steps 1-6) and the post-purge re-entry (9.11.4);
  - the State-2 standstill window (variant D-s, 9.7) and the share latch / source selector of fw v37 rev 2
    (updateShareSetpointCutoff() ino:13357-13420, powerBalance() re-entry rule ino:14096-14125,
    chargingControl() F1 disarm ino:15444-15463, assertFcChargeEnable() ino:12743-12759);
  - the unpredicted-purge teardown (policy E2, Table 23) re-using the five-node model of calc/purge_collapse_sim.py
    (function run() copied and extended below; every constant is that script's, cited there).
Re-proves (a) no charger powered with the pack bonded, (b) never BT_BUS effective while in charge mode, (c) safe
defaults, (d) feed removed before the bond on every exit, (e) no re-close onto a collapsed node on FC recovery,
(f) no healthy-board latch across a predicted purge train.

Stdlib only.  Run:  .venv_hil/Scripts/python.exe calc/bt6_logic_seq_enum.py > calc/bt6_logic_seq_enum_output.txt

Numeric inputs (all cited):
  loop median 1.131 ms, p99 1.341 ms, one 9.76 ms gap                                       facts_firmware s8
  D-BT-EN conduction after the write onto a live bus: t_D_ON + 19.77 ms (CSS 100 nF)        design Table 20
  survivor blanking SHARE_CUT_SURVIVOR_BLANK_MS 30 ms                                        ino:4869
  SHARE_CUT_MAX_HANDOFF_A 0.5 A; gate 2*SHARE_MINORITY_I_MIN_A 0.25 A                         ino:3218; ino:14110
  V_BUS_CHARGED_THRESH 13.5 V (busHotPlugUnsafe guard on every BT_BUS re-close)              ino:2317, ino:13043
  LIMIT_V_BUS_MIN 12.0 V, UV_BUS 20 ms dwell, leak 0.05, dt cap 5 ms                         ino:2163, 2189-2193
  LIMIT_V_FC_MIN 4.5 V, UV_FC 1000 ms dwell, armed at V_FC_ARM_THRESH 7.0 V while routed     ino:2148, 2243, 2278
  purge period 10.34 s, duration 100-140 ms (+/-20 ms per edge), floor ~1 V                facts_prior s7
  VCHG-IN bleed tau 0.984 s, ERR_VCHG_FED 11 V with 1.0 s blanking after a feed drop          design 9.11.4
  FC recovery t_rec 80 / 100 ms after the onset                                              pc header
"""
import itertools
import math
import os
import sys

sys.path.insert(0, os.path.dirname(os.path.abspath(__file__)))
import bt5_logic_seq_enum as bt5   # noqa: E402  (main-guarded; hw5 only)

LOOPS = (1.131e-3, 1.341e-3)
GAP = 9.76e-3
T_SS = 19.77e-3
BLANK = 30e-3
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
