Tangineering/DC-Balancer-Board-Teensy/(commit log)

2026-06-23 Adding signal tables
    [FCHEV_Signal_Table_2026-03-16A.xlsx, FCHEV_Signal_Table_2026-06-23A.xlsx]
2026-06-24 Updated signal table and README
    [FCHEV_Signal_Table_2026-06-23A.xlsx]
2026-06-24 Signal table formatting
    [FCHEV_Signal_Table_2026-06-23A.xlsx]
2026-06-24 Reorganized for Arduino IDE compilation
2026-06-24 Updated charger behavior for dynamic status
2026-06-24 Updating power path sequencing to avoid rail slam
2026-06-25 Boost regulator debugging
    [Scale Car Board PCB 20260625.brd, Scale_Car_Board_20260624.sch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]
2026-07-09 VESC startup procedure
2026-07-23 Balance controller design
    [controller_bode.csv, fullorder_bode_overlay.csv, fullorder_envelope.csv, fullorder_step_overlay.csv, loopshapes_youla_h.csv, step_response_mismatch.csv, step_response_nominal.csv, timedomain_step_ramp.csv]
2026-07-30 Add design review documentation for DC Balancer Board firmware
    This commit introduces a comprehensive design review document for the DC Balancer Board firmware, dated 2026-07-28. The review includes a detailed analysis of the current firmware, host-native tests, PCB artifacts, and boost bring-up history. Key findings highlight critical issues in State 98, including unsafe command transitions, inadequate motor current management, and unverified as-built power stage assumptions. The document outlines required fixes, high-priority findings, correctness and observability issues, and necessary physical preflight checks. It also emphasizes the importance of regression tests for the upcoming firmwa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
    [mock_wire.h]
2026-07-31 Added current test profile
2026-07-31 Updated current test profile
2026-08-05 MIMO design
    [coupling_cond_grid.csv, coupling_dalpha_dItot.csv, coupling_freq.csv, drive_cycle.csv, drive_siso_step.csv, fccruise.csv, mimo_antiwindup_recovery.csv, mimo_controller_freqresp.csv]
2026-08-11 Log analysis, analog averaging
    [PS0001.csv, TEST0001.csv]
2026-08-11 Power share hysteresis, noise analysis
    [PS0002.csv, PS0003.csv, TP0004.csv, TP0005.csv]
2026-08-12 Power share measurements, testing updates
    [TP0007.csv, TP0008.csv, TP0009.csv, TP0010.csv, TP0011.csv, TP0012.csv, TP0013.csv, dv0_sweep_20260811.csv]
2026-08-12 Power share governor updates
    [TP0014.csv, TP0015.csv, TP0016.csv, TP0017.csv, TP0018.csv, TP0019.csv, TP0020.csv, TP0021.csv]
2026-08-13 Governor bimodal implementation
    [TP0041.csv, TP0042.csv, TP0043.csv, TP0044.csv, TP0045.csv, TP0046.csv, TP0047.csv, TP0048.csv]
2026-08-13 Share mode handoff improvements v6
    [TP0074.csv, TP0075.csv, TP0076.csv, TP0077.csv, TP0078.csv, TP0079.csv, TP0080.csv, TP0081.csv]
2026-08-16 Velocity control updates
    [TP0102.csv, TP0103.csv, TP0104.csv, TP0105.csv, TP0106.csv, TP0107.csv, TP0108.csv, TP0109.csv]
2026-08-16 Encoder updates
2026-08-16 Encoder pin reassignment
    [Scale Car Teensy IO - IO.csv]
2026-08-16 Manual data logging
    [TP0125.csv, TP0126.csv, TP0127.csv, TP0128.csv, TP0129.csv, TP0130.csv, TP0131.csv, TP0132.csv]
2026-08-16 Velocity controller implementation
    [ML0135.csv, drive_siso_replay.csv, drive_siso_step.csv]
2026-08-17 Velocity estimation improvements
    [ML0136.csv, ML0137.csv, ML0138.csv, ML0139.csv, drive_siso_replay.csv, drive_siso_step.csv]
2026-08-17 Estimator improvements
    [ML0140.csv, ML0141.csv, ML0142.csv, ML0143.csv, ML0144.csv, ML0145.csv, drive_siso_replay.csv, drive_siso_step.csv]
2026-08-17 fw v14 first-flash log round (ML0146-151, YP0152) + 16.0 V bus-nominal doc sweep
    Seven-agent analysis of the first fw v14 velocity runs. K_F validated on
    hardware (rail accel ratio 0.968; hold currents 0.89-0.92x model); the
    ML0141 gain excess is closed. Hanus conditioning, zero-cutoff/reset, and
    the retirement of the 2.3-2.6 Hz boxcar limit cycle all confirmed. New
    findings: permanent ~2.2x mechanical drag step-change at ML0151 t~27.5 s
    (tire/roller), and a ~428 ms VESC dead window after hard regen->drive
    reversal. YP0152 share loop never closed (load below the 0.60 A gate) -
    not a cross-coupling test.
    Doc sweep: bus nominal corrected from the stale pre-retune 17.5 V to
    16.0 V (V0 = 15.91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
    [ML0146.csv, ML0147.csv, ML0148.csv, ML0149.csv, ML0150.csv, ML0151.csv, YP0152.csv]
2026-08-17 Signal table plus extras
    [FCHEV_Signal_Table_2026-08-17A.xlsx]
2026-08-17 fw v15: dpos-based pitch count in the edge-period estimator ISR
    The fw v13 adaptive period filter had an absorbing slow-reading poison
    basin at ref ~ 2T: real edges rejected by the 0.625 gate, merged 2T
    intervals accepted as one pitch, EWMA re-anchored, v_actual reading
    exactly half and the drive controller doubling the real speed
    (bench-observed 2026-08-17; candidate explanation for the ML0151
    t~27.5s event). The k-branch tripwire was structurally blind to it and
    its reset could seed the basin.
    Pitch count is now measured from the quadrature decoder's position
    delta (pitches = round(|dpos|/2), uncapped, unconditional) instead of
    inferred from the period/ref ratio; rejected edges advance ne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
2026-08-17 Encoder and log updates
2026-08-17 fw v16
    [ML0153.csv, ML0154.csv, ML0155.csv, ML0156.csv, ML0157.csv, ML0162.csv, WP0160.csv, WP0161.csv]
2026-08-18 fw v17 + logs 153-180 analysis rounds
    Firmware (fw v17, pending flash):
    - Fractional-pitch ledger in doEncoderA(): store period*2/|dpos| so a
    spurious mid-pitch edge (dpos=1 over T/2) stores T, killing the x2
    rounding basin found live in ML0164/ML0168; |dpos|==2 fast path stays
    bit-identical to fw v12-v16.
    - Root cause + fix of the mid-run v=0 injections (YP0166/TP0171): TOCTOU
    race between now=micros() and the encLastEdgeUs snapshot wrapped the
    unsigned edge age; both stale tests now use signed ages.
    - Post-reset corroboration hold (depth-only gate per safety review MED-1),
    per-path drop counters in the 'S' dump, ENC_VEL_CORROB_MIN_MPS rename.
    - Tests: 3007 production + 175 benc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
    [ML0164.csv, ML0165.csv, ML0168.csv, ML0169.csv, TP0170.csv, TP0171.csv, TP0172.csv, TP0173.csv]
2026-08-25 fw v18: 90-slot encoder wheel + general-Hanus anti-windup fix
    - ENCODER_SLOTS_PER_REV 120->90 (180 counts/rev, operator hand count 2026-08-25);
    re-derived ENC_ADAPT_MAX_REF_US 15000us, ENC_VEL_CORROB_MIN_MPS 0.35,
    V_SP_ZERO_THRESH 0.07; new pitch-coupling static_asserts
    - drive controller re-synthesized for the 5.3198 mm pitch (same rung, all gates pass)
    - STRUCTURAL fix: general Hanus gain L (pole-placed, z=-1 mode -> +0.5) replaces the
    self-conditioned form, killing a +-12 A 125 Hz saturated-mode limit cycle shipped
    since fw v10; new dwell-sweep + oscillatory-eigenvalue synthesis gates, dwell
    replay episode; validate_drive_siso 17/17
    - benchlog tooling pitch per-log by fw_version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
    [drive_siso_replay.csv, drive_siso_step.csv]
2026-08-25 fw v19: 'L' encoder fields + conduction-aware handoff slew; logs 194-203 analysis
    Logs 194-203 (fw v18 first flash, 90-slot wheel + Schmitt): anti-windup and
    encoder front end validated on hardware; TP0201 bus sag root-caused as the
    share-loop arming gain walk crossing the FC->BT conduction handoff with a
    dark standby channel (supply-transient hypothesis refuted); once-per-rev
    disc defect found at counts ~42-74 mod 180.
    fw v19: 'L' plot stream 8->11 fields (enc_pos/edgeA/edgeB, guard 110->192 B);
    conduction-aware droop-ratio handoff slew (filtered+hysteretic dark test at
    0.15/0.20 A, 10x slower 0.002/tick ceiling, motion-gated 175-tick dwell cap
    per dark event). Tests: 3372 production + 175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
    [ML0194.csv, ML0195.csv, ML0203.csv, TP0199.csv, TP0200.csv, TP0201.csv, TP0202.csv, WP0197.csv]
2026-08-25 docs: governor whitepaper — flow diagrams + MATLAB/Simulink section
    Adds a per-tick Mermaid flowchart with thresholds on edges, a state
    diagram of the three hysteretic machines, and implementation guidance
    (architecture, reference skeleton, interface, fidelity notes).
2026-08-25 docs: governor whitepaper — simplified overview diagram (new SS9)
    Adds a Figure-0 flowchart isolating the three mechanisms (loop-mode
    handoff, current-dependent clamp, conduction-arming handoff), slew
    detail omitted; downstream sections renumbered.
2026-08-25 docs: governor whitepaper — medium-detail flow diagram (new SS10)
    Figure 0b between the simplified and complete diagrams: adds the
    setpoint latch, deferral path, and minimum-load gate; slew detail
    still omitted. Downstream sections renumbered.
2026-08-25 docs: governor whitepaper — table of contents
2026-08-25 fw v20 and docs
    [ML0215.csv, ML0216.csv, ML0217.csv, TP0205.csv, TP0206.csv, TP0207.csv, TP0208.csv, TP0209.csv]
2026-08-26 WIP: HIL mode (fw v21) — frame codec + injection wiring (orchestrated round in progress)
    Claude-Session: https://claude.ai/code/session_01Rb2mffPLN9VwA7JyJZUyJd
2026-08-26 HIL mode (fw v21): plant simulator, HIL_MODE doc, ledger row
    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
2026-08-26 WIP: HIL mode tests (test-writer stage in progress)
    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
2026-08-26 HIL mode review fixes: bounded UDP drain, stale-link motor halt + ERR_HIL_STALE fault, host lock, BLG HIL flag bit, provenance markers, docs
    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
2026-08-27 HIL charger extension: 40-byte injection frame (I_charge + Ag105 status), pollAg105 HIL bypass, simulator charger model
    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
2026-08-27 HIL_PLANT.md: accuracy review pass — 40-byte frame reconciliation, Ag105 charger model section
    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
2026-08-27 Tests: 40-byte HIL frame goldens, legacy-frame drop, pollAg105 HIL bypass coverage
    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
2026-08-27 WIP: HIL Updates 2026-08-26a round in progress — replay suite (complete) + hi-fi electrical (in progress)
    Orchestrated round mid-flight; tools/hil_replay_suite.py + docs/HIL_REPLAY_LOGS.md are the
    finished I2 workstream; other files may be a partial implementer snapshot. Not yet reviewed
    or test-covered — final commit follows the review/fix stages.
    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
2026-08-27 WIP: hi-fi electrical engine + source models + charging scenarios (implementer complete, pre-review)
    I1 workstream complete: mode-aware measured K_DROOP_BUS (0.074/0.16 V/A, x4 design-vs-measured
    flagged), tools/hil_electrical.py (6-node BE network, RT1987 state machines, droop FB
    superposition, analytic parasitic ring events), FuelCellSource/BatterySource (Yadav & Assadian
    2025 forms, rig-fitted), PiCommander (verified 22-byte layout), SCENARIOS registry + 7 new
    scenarios, CSV soc/elec columns. Reviews and tests still pending.
    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
2026-08-27 WIP: Stage-2 test coverage complete (169 pytest green), pre-review
    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
2026-08-27 WIP: Stage-4 review fixes applied (2 HIGH, 6 MED, 9 LOW + 2 contract findings), regression tests pending
    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
2026-08-27 HIL Updates 2026-08-26a round: hi-fi electrical sim, FC/battery source models, 26-log replay suite, suite runner + report
    Measured K_DROOP_BUS (0.074/0.16 V/A mode-aware, x4-vs-design flagged open),
    tools/hil_electrical.py hi-fi engine (RT1987 state machines, droop FB superposition,
    analytic parasitic ring events, adaptive ~30-40 kHz substeps), FuelCellSource/
    BatterySource (Yadav & Assadian 2025), PiCommander + 7 new scenarios,
    tools/hil_replay_suite.py (26 entries, 8 check kinds, fw-version-aware) +
    docs/HIL_REPLAY_LOGS.md, tools/run_hil_suite.py (38-run plan -> REPORT.md/results.json).
    Review round: 2 HIGH + 8 MED + 9 LOW accepted and fixed. 255 pytest green.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
2026-08-27 Regen chopper: bench-calibrated 18.1 V clamp + 20 W dissipation check
    Clamp level calibrated from the observed 13.3->18.1 V bench excursion (16.5 V
    TODO retired). The chopper model's purpose is the power question: track worst
    V_rgn^2/47 dissipation (chopper_peak_w in summary()), emit chopper_over_power
    once per excursion past the resistor's 20 W rating (crossover ~30.7 V), and
    fail the suite check on it. Fixed a latch bug the new tests caught (excursion
    ending below the clamp left the once-per-excursion latch stuck). 259 pytest.
    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
2026-08-27 Per-channel analog noise measured from the bench-log corpus
    NoiseConfig.suggested() now carries sigmas fitted from all 206 BLGs (1 s
    windows, 75 ms moving-mean detrend, quiescent plateaus, additive component
    sqrt(sd^2 - LSB^2/12)): V_fc 19 mV (6.3 LSB outlier, genuine analog, feeds
    the share loop — scope-look candidate), V_batt 2.4 mV, V_bus 1.8 mV, V_rgn
    4.0 mV, V_chg adopted from V_rgn (own channel censored — charger never
    powered in any logged run), currents 4.4 mA floor (load-dependent ripple
    excluded as physics, not sensor noise). INA253 zero offset measured
    ASYMMETRIC: I_fc +19.9 mA (0.02 default confirmed), I_batt ~0 — offset is
    now a per-channel dict with float back-compat. Doc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
2026-08-27 HIL live terminal dashboard (--dash / suite --dashboard)
    Stdlib ANSI dashboard: v_sp/v_act, share_sp/share_act, V_bus/I_tot/I_fc/I_bt
    with sparklines, switch/aux/state/fault indicators, hifi substep rate. Hot
    path = one scalar-dict assignment per tick (999.9 vs 1000.0 Hz measured);
    5 Hz daemon renderer; terminal-size adaptive; suite flag default OFF with
    stdout passthrough + labeled rate-gate skip. Review round 4 MED + 6 LOW all
    fixed. 296 pytest green.
    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
2026-08-27 Fix Arduino IDE build: 'HilInjectFrame has not been declared'
    The Arduino builder auto-generates a prototype for every .ino function lacking
    one and inserts it above the FIRST function definition (rateLimitDue, ~line
    2150) — far earlier than the HIL codec's struct (~2602). hilParseInjectFrame()
    is the only function in the sketch taking a sketch-defined type as a parameter
    without an explicit prototype, so its generated prototype failed to compile;
    the builder's #line mapping reports the error against the definition's own
    line, which is why it points at code where the type looks well-defined.
    trapPhaseStr() has the identical shape and compiles because of its manual
    prototype (line ~3285)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
2026-08-27 Restore checked-in Windows test binaries
    Accidentally removed by a 'make clean' during the Arduino build-fix
    verification; these are tracked artifacts, not build scratch.
    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
2026-08-27 HIL compile fix
    [ML0218.csv, ML0219.csv, ML0220.csv]
2026-08-27 Bench test turned off
    [ML0221.csv, ML0222.csv, ML0223.csv, ML0224.csv, ML0225.csv]
2026-08-28 WIP: EMS/pi-live round test coverage (Stage 2), review + fix round pending
    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
2026-08-28 HIL Mode A/B: emulated EMS (hold-5050) + Pi-in-the-loop + operator manual
    Mode A: EMS_STRATEGIES policy layer on PiCommander (50 Hz fb view with
    telemetry-equivalence contract + obs_age_s), hold-5050 strategy,
    ems-drive-cycle scenario. Mode B: --pi-live (injection-only; PiCommander
    never constructed; refusals enforced both layers). Suite: pi-live skip
    records incl. the whole replay half, cmd_mode tagging, SKIPPED rendering,
    narrowest-correct PI_TIMEOUT excusal (exactly 0x8010 + continuous tx —
    review HIGH: old excusal was a no-op vs FAULT_ERROR). docs/HIL_USER_MANUAL.md
    with three-node Mode-B sequencing verified against firmware constants.
    Review 1 HIGH + 4 MED + 9 LOW all fixed. 357 pytes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
2026-08-30 Add PSCAD simulation design doc (draft, pre-review)
    Two-tier PSCAD/EMTDC simulation design for the droop control circuit:
    Tier 1 teaching/basic-verification project and Tier 2 HIL-comparable
    detailed simulation (T2-SYS averaged + T2-FAST switching/parasitic
    configurations). Built from a five-agent research round over the repo's
    authoritative sources, including a transcript/bodge reconciliation sweep;
    all constants are as-fitted values with provenance. Carries the T2-X1
    droop-realization audit targeting the open x4 design-vs-measured droop
    discrepancy, an HIL validation/signal-mapping plan, and a 19-item open
    questions section for operator review.
    Review round (Opus fidelity + Sonnet correct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
2026-08-30 PSCAD design doc: apply two-lens review round + close OQ-14
    Review round (hardware-fidelity + correctness lenses, 6 HIGH / 17 MED /
    13 LOW, all applied):
    - CLOSED the INA253 A3/A1 x4 hypothesis with a cancellation proof (the
    sense gain divides the reported current and multiplies the commanded
    gain, so it cancels exactly in the measured V/A slope) — a paper-only
    narrowing of the open x4 droop finding.
    - New lead candidate for the x4 gap: the injection attenuation
    R_D1/R_inj = 4.011 (0.30/4.011 = 0.0748 vs measured 0.074 +/- 0.004),
    now T2-X1's first sweep, hedged as coincidence with the k_eq precedent.
    - Log audit folded in: ML0165 ran gFC=gBT=0 for its entire log yet sat in
    the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
2026-08-30 fw v22: HIL sequential runs + regen-node topology fix + HIL Results routing
    - Sim topology fix (schematic sheet 4): REGEN switch links V-MOT -> shared
    VCHG-IN node; V_rgn/chopper on the MOT node; validated on hardware (first
    clean Mode-A ems-drive-cycle run, bring-up P0-P3 on injected sensors).
    - fw v22: State-0 injection wait gate + staged bring-up on HIL builds (both
    BENCH_TEST values), auto-recovery from the exact dead-link latch (0x8010 +
    ERR_HIL_STALE, 500 ms debounce) via hilWarmReset(), mid-bring-up link loss
    aborts instead of latching INIT_FAIL.
    - HIL_SIM source default back to 0; test Makefile pins -DHIL_SIM=0 on the
    non-HIL targets (they had silently become HIL builds).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
    [mock_arduino.h]
2026-08-30 hifi RT1987 SOFT-state physics fix: time-aligned ramp target, physical INA currents (fixes false SCP cuts + production-HIL FAULT_OC_FC)
2026-08-31 fw v23: any-fault HIL recovery + CSV auto-name/meta sidecar + warm-reset tripwire
    - fw v23: State-99 auto-recovery admits ANY latched fault, gated on a run
    boundary (1000 ms link silence anchored at the last accepted frame); the
    exact-0x8010 signature test is removed. hilWarmReset() prints the outgoing
    fault evidence before clearing; 1 Hz [STATE 99] line carries live
    boundary/arm/phase status. Review anchor fix (S1/C1): first-dead-tick
    anchoring would have made a literal 1 s outage unrecoverable.
    - Tooling: hil_plant_sim.py logs CSV by default (auto-name into HIL Results/,
    --no-csv, refusal of existing explicit paths without --force) and writes an
    atomic .meta.json sidecar per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
2026-08-31 HIL suite/scenario fix round: grace-aware scoring, FAULT_EXPECTATIONS, replay rework
    Implements the fix list from the first fw v23 suite analysis (HIL_FINDINGS.md,
    hil_report_20260830_181426), under the operator rulings that LIMIT_I_FC_MAX
    1.4 A is correct (OC_FC on bench-supply traces is correct hardware replication)
    and FC-charge + hard accel is infeasible by design.
    - Grace-aware fault scoring: no_unexpected_fault/expected_fault judge the
    post-grace union (WARM_RESET_GRACE_S imported from the sim); carried-in
    settle-latch bits are named and excused, never failed. Converts the 23
    false FAILs; self-guarding (a still-latched board fails post-grace).
    - FAULT_EXPECTATIONS replaces FAULT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
2026-08-31 Post-suite HIL fix round + SOFT-start TRCB physics fix + hil-agent-analysis skill
    Follows the second fw v23 campaign (hil_report_20260830_203006: 38 runs,
    36 PASS / 1 FAIL / 1 SKIP, every verdict correct — the grace/expectation round
    validated on hardware; regen path, GENSTAT collapse, share-cut, and SOFT-state
    SCP cut all reached for the first time).
    - hil_electrical.py: SOFT-start pre-charged-node artifact fixed (comm-loss root
    cause — 3.9-6.8x non-physical current on a warm MOT_PWR close). Pre-charged
    entries use a per-episode VIN high-water mark; cold staged bring-up is
    byte-identical (P0/P3 0.2226/0.4739 A, triple-corroborated on hardware).
    Review round: TRCB/reverse-compar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
2026-08-31 HIL report analysis pipeline: tools/hil_report_analysis.py + tests + skill/doc updates
    Adopts the parallel session's work (2026-08-30e addendum): post-campaign
    analyzer for run_hil_suite report folders (per-run subfoldering, benchlog
    figure reuse, replay overlay/fidelity figures, ANALYSIS_SUMMARY), its 110-test
    pytest suite, the hil-agent-analysis skill Stage-0 integration, and the
    CLAUDE.md addendum. teensy_controller.ino local flag flips stay uncommitted.
2026-08-31 HIL command replay + soc-depletion gate fix + replay metrics + duration trims
    --replay-commands: replay mode drives the 22-byte Pi command packet at 50 Hz
    from the BLG's recorded v_sp/share_sp (MODE_SAFE in preamble, MODE_HYBRID
    after; ZOH from the injection tick's record). drive_loop_stepped check kind +
    NOT-EXERCISED tagging de-vacuates the replay half; 14/26 entries opt in, the
    UV trio and current-mode logs stay command-free. A5: replay results.json/
    REPORT.md now carry truthful final fault flags. A1: soc-depletion scored by a
    disjunctive gate (dSOC >= 0.05 OR post-13s UV_BATT latch), soc0 0.20, 400 s.
    A3 doc note; scenario durations trimmed to last-event + ~3 s (suite ~23 min).
    Tests: 67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
2026-08-31 Round-1 fix round: share_loop_actuated, drive_min_frac ratchet, whole-run fault times
    From the overnight round-1 campaign analysis (39/39 verified): share axis gains
    its first check kind (share_loop_actuated on the five varying-share entries;
    actuation-only — open-loop windup makes tracking unassertable); drive_loop_stepped
    gains per-entry drive_min_frac floors at ~half the round-1 measured activity so a
    degraded command path fails; fault_first_t_whole_run exposes in-grace latch onsets;
    switch_transitions metric surfaces ML0203's cut chatter; scp-inrush i_cut band
    tightened to 6.0-6.6 A (0.076% cross-campaign repeat); INA253 output-side schematic
    confirmation + pack-current range comments;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
2026-08-31 scp-inrush two-outcome expectation: the fold race is physics, not a defect
    Round 2 (38/39) exposed the scp-inrush knife-edge: the sim's SCP cut and the
    firmware's OC teardown are 0-1 ticks apart, decided by the observation round-trip
    (L=1 or 2); the 0.076% i_cut "repeat" was two draws of the same L=2 coin. A
    headless bench proved the re-margin infeasible (tick-S cut needs ~12.7 A, 1.49x
    the fold ceiling), so the expectation is now declarative events_any_of:
    A_fold_fired (1 scp_cut, i_cut 6.0-6.6, STRONGER) or B_fold_approached (0 cuts +
    MOT_PWR sw_ring i_cut 3.5-5.5 + the OC latch, WEAKER) - the check names the
    outcome and tracks the L distribution instead of scoring a coin flip. Both round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
2026-08-31 Overnight close-out: campaign ledger + CLAUDE.md addendum (rounds 1-4, 156 runs)
    Four autonomous full-suite campaigns: 39/39, 38/39 (the scp knife-edge, root-caused
    and resolved as a two-outcome expectation), 39/39, 39/39 with zero structural diffs.
    TRCB fix confirmed on hardware; command replay proven at scale 1.00; both tracked
    anomalies resolved (L bimodal by mechanism; handoff latency uniform over the 20 ms
    share tick). Decision log and resume points in OVERNIGHT_LOG.md.
2026-08-31 Round A: scp deterministic-fold redesign + FU4 synthetic replay entry (SY0001)
    scp-inrush: three-phase stimulus (unloaded ramp -> 6.5 A pulse at V-MOT 1.2 V
    mid-soft-start -> one-shot -> 5.0 A run load) makes the SCP cut fire inside the
    pulse tick, phase-independent of the firmware teardown; single-outcome
    events_require restored, band [6.15, 6.55] derived from 3 live runs (i_cut
    6.3797373 A bit-identical); one-shot re-arms on warm-reset edge (M1);
    events_any_of kept table-unused. FU4: synthetic BLG v3 entry SY0001 + stdlib
    generator + steps_onto_rail_within check kind (0.15 s budget incl. the Run
    transition packet). Reviews: 1 HIGH (grace-window figure) + 3 MED + 9 LOW, all
    applied. Tests: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
2026-08-31 Round B: DP-informed EMS (soc-band + dp-replay) + Gfc H2 consumption metric
    H2Consumption (Gfc modal ZOH 1 kHz, stack-power input, pinned vectors, DC-gain
    import assert); scale-portability RESOLVED per operator ruling (720 = full-size
    FC OCV; systemic-scaling paper) — banners swept repo-wide. soc-band causal
    charge-sustaining strategy + ems-soc-band scenario; dp-replay offline-optimal
    benchmark: gen_dp_ems_table.py DP port (linear-interp Bellman, stored policy,
    raise-on-infeasible, plant battery model, cruise-masked charging), checked-in
    byte-deterministic table with fingerprint + accounting + drift refusals,
    ems-dp-replay scenario (hifi-only), final_h2_cum_g/delta_soc metrics. Offline:
    DP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
    [dp_ems_table_ems-dp-replay.csv]
2026-09-01 Round C: scenario expansion — Y-profiles x4, FTP75 x2, MPPT emulation, pi-silence, share-staircase, charge-to-full
    Ten new scenarios (plan 52 runs): four ems-y-* reproducing the firmware Y table
    bit-for-bit (b00 variants add the suite-first latch-RESTORE checks; live cut at
    34.311 s vs 34.31 predicted); two ems-ftp75-* on the first 340 s of the EPA
    FTP75 (committed + sha-pinned + generator-bound; --with-ftp75 gate); Ag105 MPPT
    corrected to the datasheet threshold regulator + emulated (the 18 V-default
    hunt CONFIRMED live, 138 toggles/80 ms — open R1: MPPTS header); pi-silence
    (first-ever Pi watchdog exercise: latch at 8.498 s = mute + 500 ms);
    share-staircase (governor rails 0.915/0.300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
2026-09-01 SDP EMS round: sdp-v1 strategy + ems-sdp scenario + offline solver + H2 proxy
    Ports references/EMS/SDP_EnergyManagement2.m onto the HIL sim, consuming
    the TPM toolchain (db6e7ce):
    - tools/sdp_ems_solver.py (miniforge): value iteration over SoC x demand
    bins from TPM_dt1_hil.mat + sidecar; declared decisions D1-D10 (D1:
    linear J interpolation over SoC -- nearest-grid provably freezes the
    policy at scale-car dSoC); alpha 500 -> 0.2569 (coulombic-energy
    scaling, level-form measured degenerate); charge_forbidden_bins 12-24
    (operator ruling b). Bakes tools/sdp_policies/sdp_policy_v1.json
    (policy-block sha dbe42d1b..., the stable identity).
    - sdp-v1 strategy (hil_plant_sim.py, stdlib,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
2026-09-01 Campaign 191509 addendum + mppt hunt-period record correction (40 ms)
    First full post-Round-A/B/C+SDP campaign: 52 PASS / 0 FAIL / 1 SKIP over 53
    runs, live-analyzed (10 per-run agents + adversarial replay audit), zero
    scoring defects, zero board defects. EMS lever pricing hardware-measured on
    two stimuli (share-shift 0.41 SoC/g, charging 0.156); three-way EMS trio
    compared; fw v23 recovery acceptance datapoint; L ~= 1.9 ms measured.
    Fix queue (5 MED + LOWs) and suite evaluation recorded in HIL Results/.
2026-09-01 Fix round (campaign 191509) + SDP demand-map re-normalization (sdp_policy_v2)
    SDP: consumer-owned --demand-map [0,25] W (D11), sdp_policy_v2.json
    (policy sha 740c802e), sdp-v1 -> sdp-v2 rename, cmd_share_sp_raw column,
    ems-sdp re-derived to 8 checks incl. charge-window + provisional notes.
    Fix queue: all 16 items (dp_table provenance, v_bus_min_in_band,
    persisted-latch not_before_s, fc_bus_restored 900, socband 0.95,
    Y_AUX_LOAD_A 0.85 + measured _Y_FC_FLOOR {0.50,0.66}, FTP75 h2 bands,
    SY0001 de-provisionalized, doc corrections). Reviews: 7 MED + 9 LOW,
    no HIGH, all applied. Tests: 1042+26 stdlib / 272 miniforge green.
2026-09-01 fw v24: dynamic Ag105 MPPT threshold (reg 0x02) management
    Adjudicated dual-design round (Fable + Opus decision pair). V_chg windowed-min
    tracker, monotone-lower ratchet (floor 12.320 V / ceil 13.376 V anchored to
    V_BUS_CHARGED_THRESH minus the RT1987 path drop), attempt-counted EPROM budget
    (<=8/boot + boot-scoped fail gate), 0xFF-sentinel-aware VERIFY, reg-0x07
    discriminator, 1 s MPPT_DISABLE release holdoff, UV backoff 12.8/13.6 V 15 ms
    (hover-band, gated vs busHotPlugUnsafe + share latch), I_charge 0xFF sentinel
    fix, HIL observation frame 16->17 B, State-98 'N' command, 'S' dump block.
    Reviews: 1 HIGH + 8 MED + 8 LOW, all applied. Tests 3787/175/4268 green;
    test/mppt_assert_probes.sh pin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
    [mock_wire.h]
2026-09-01 Campaign-222036 fix round: ML0217 elapsed anchor, sdp-v2 charge hysteresis, calibrated pins
    ML0217 re-anchored to elapsed-from-State-0 [0.20,0.45]s (P0/300ms record
    corrected — the audit's F1); TP0053 burst-quantized band; sdp-v2 8.0s
    minimum-dwell charge hysteresis w/ self-load-subtracted bin (kills the
    measured 4.63x chatter loss); ems-sdp provisional pins calibrated + note
    deleted; WP0097 latch_precedes_uv; b30 clip bands + floors {0.65,0.85} +
    I_tot companion; carried-in wording de-boilerplated; raw-share figure.
    Tests 1091+26 / 278 green.
2026-09-01 SDP v3 (calibrated alpha) + interior scenarios + EMS frontier check
    Charge-economics adjudication (dual decision pair): the ported alpha sat 7.4%
    above the charge-admission break-even it was never tested against; v3 re-derives
    alpha by two-sided lever calibration (0.1629624, window tripwire) - charging
    rejected ENDOGENOUSLY (sha 0443febf, share map identical at operating rows).
    Roles: sdp-v3 benchmark / sdp-v2 demonstration (byte-frozen). Three interior
    scenarios (ems-ftp75-sdp soc_ref-offset flip ~196s; ems-sdp-cross crossing +
    charge cycle; ems-sdp-braking decel windows) with offline-walk provisional
    bands. EMS_FRONTIER cross-run eq-H2 check (C2 numbers FAIL / C1 PASS pinned;
    KNIFE-EDGE ba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
    [dp_ems_table_ems-ftp75-5050.csv]
2026-09-01 Campaign-024231 calibration: phase-free S2 checks, measured pins, frontier honesty
    Replaces the phase-locked absence check that failed C3 (walk period wrong
    5.7x - the open-loop-hold boundary below 0.55 A; now documented as a
    strategy-authoring rule) with max_continuous_ticks / released-fraction /
    window-count kinds; de-provisionalizes S1/S2/S3 with campaign-measured
    pins incl. three new OC-margin tripwires; frontier vs-bound arm re-described
    as a lever-class detector (structurally ~1.0 for charge-free candidates,
    implied-lever metric rendered; 1.03 tightening forbidden on such readings).
    Tests 1196+26 / 302 green; all three entries replayed 27/27 vs the C3 CSVs.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
2026-09-01 fw v24 tooling lockstep: 17 B observation frame + dynamic MPPT threshold
    - parse_output() accepts 16 B (legacy, mppt_cnt=None) and 17 B (fw v24:
    mppt_thresh_count at offset 15, XOR 1..15) frames; pack_output();
    one-shot provenance print per length, both-lengths warning.
    - MPPT emulation threshold follows the observed count (11+0.088*N V,
    18 V fallback for 0xFF/legacy/no-frame); AG105_MPPT_* constants
    mirrored from .ino:1671-1690; R1 recorded resolved (Table 7 encoding).
    - CSV column mppt_thresh_cnt appended (both schemas, blank=unknown);
    dashboard mpptCnt indicator; report-analysis threshold overlay.
    - FAULT_EXPECTATIONS["mppt-tracking"] flipped hunt->no-hunt: rise census
    (3,8) r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
2026-09-01 fw v25: share-cut load guard + survivor-turn-on blanking + 18 B HIL frame
    - applyShareRatio() r-based cut branches gain the fw v6 load guard
    (|I_doomed| <= SHARE_CUT_MAX_HANDOFF_A 0.5 A) they never had — the
    campaign-080905 OC_BT root cause (i_cut 0.6371 A into a dark survivor).
    - Survivor-turn-on blanking on BOTH cut paths: writeBusSwitch() chokepoint
    (all 26 FC/BT_BUS_ENABLE write sites) timestamps rising edges; cuts refused
    while the survivor's edge is younger than SHARE_CUT_SURVIVOR_BLANK_MS 30 ms
    (t_D_ON 8 + CSS 100 nF soft-start tON 19.8 ms, RT1987 DS; TODO(calibrate),
    conservative direction documented).
    - Refused cuts fall through to a SLEW-LIMITED band-edge clip on the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
2026-09-01 Regen-fidelity plant model + fw v25 lockstep + FTP75 DP leg + measured droop + H2/SoC figures
    WP-C regen model: regen power floor removed — VESC_REGEN_I_MAX_A 1.5 A clips
    regen current before force (one number sets braking force AND electrical
    return, ETA_REGEN 0.80, both TODO(verify)); bounded-Norton injection on N_MOT;
    chopper rebuilt as a linear clamp with coalesced chopper_clamp events; two
    model bugs fixed en route (1/47 stamp could not clamp; RT1987 ON stamp went
    negative under 35 mV — strict_forward scoped to MOT_PWR/REGEN/FC_CHARGE, scp
    i_cut record verified bit-identical). New scenario regen-harvest-true (S3-full
    un-tabled). Baseline era: ems-y quartet + charge-regen + mppt-trac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
    [dp_ems_table_ems-dp-replay.csv, dp_ems_table_ems-ftp75-dp.csv]
2026-09-01 CLAUDE.md: 2026-09-01d addendum (fw v25 + regen-fidelity round) — checkpoint before rotation
2026-09-01 Documentation alignment round: CLAUDE.md rotation + full repo doc sweep
    - CLAUDE.md 207 -> 103 KB: 24 superseded addenda (fw v8-v20 encoder/BLG era +
    the HIL tooling bring-up narrative) rotated VERBATIM to
    docs/claude-md-archive.md with per-fact survival verified (ledger, PLAN.md,
    HIL docs); all three bodge records, the core sections, fw v18, the campaign
    addenda (only committed record - HIL Results/ is gitignored) and the EMS
    design rounds retained. R1 marked CLOSED AS MOOT; 'N' command documented;
    three-target test instructions; new HIL build-flag paragraph.
    - WORK_QUEUE.md rewritten post-round: flash fw v25 + triple validation on top;
    FTP75 preload ruling; Pi bridge audit UN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
2026-09-01 Track PSCAD project, Pi bridge source drop, and SDP governor MATLAB (operator-approved 2026-09-01)
    - PSCAD/: droop study project files (dc_balancer.pswx, droop_t1.pscx/.psmx)
    - references/EMS/Pi_2026-09-01/: the Raspberry Pi bridge + ROS2 EMS node source
    (teensy_bridge_node_2026-08-17A.py et al.) — unblocks the Mode B v4-parser audit
    - references/EMS/SDP_EnergyManagement_Governor2.m + main_SDP_governor_convexfc.m:
    governor/convex-FC SDP source material
2026-09-01 WORK_QUEUE: untracked-material decisions resolved (567a3ed)
2026-09-01 WORK_QUEUE: five EMS test-program goals (zero aux preload, dSoC-matched DP, alpha sweep, DP-deviation comparison, governor-aware MPC)
    Operator directive 2026-09-01. Supersedes the FTP75 preload ruling (all legs
    to 0 A restores frontier stimulus coherence by construction).
2026-09-01 WORK_QUEUE: converter-asymmetry calibration + HIL plant physics review (USER_NOTES items)
2026-09-02 Round 2026-09-01e: fw v25 first campaign + EMS test-program tooling round
    Campaign hil_report_20260901_151156 (first fw v25): T1 share-cut guard, T2 regen
    baselines, T3 error_code attribution all validated; 3 false FAILs classified and fixed.
    New: tools/governor_model.py + tools/ems_walk.py (firmware governor port + offline
    EMS walk); tools/dp_results_db.py + tools/dp_db/ + hil_report_analysis --matched-dp
    (ΔSoC-matched DP baselines, item 2/4); tools/sdp_alpha_sweep.py + 21 sweep artifacts
    (item 3); tools/benchlog_analysis/asymmetry_fit.py + converter-asymmetry doc (item 6);
    Pi bridge v4 audit + change request + stdlib test (§2).
    Changed: preload removed from the FTP-75 drive cycles (B1;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
    [dp_ems_table_ems-dp-replay.csv, dp_ems_table_ems-ftp75-5050.csv, dp_ems_table_ems-ftp75-dp.csv, sweep_eval_ems-ftp75-sdp.csv, sweep_eval_ems-sdp.csv, windows.csv]
2026-09-02 dp_db: matched DP baselines for campaign 151156's four FTP-75 legs (run-era preload/ceiling overrides)
2026-09-02 Round 2026-09-01f: power-balance figure in every HIL report + refined alpha-sweep
    hil_power_balance figure (motor / FC / net battery / chopper + sum + residual panel) with six
    append-only CSV power columns computed in the plant for both engines; legacy CSVs render
    source powers only with an explicit annotation; backfilled across all report folders.
    Exposed: the hi-fi Ag105 is a 1:1 current-transfer element (charger-efficiency decision queued).
    Refined alpha-sweep: both transition points bisected (0.111000 / 0.239250 = the admission-window
    ends), 20 refined artifacts (idx 21-40), walk-synthesized plots per point (walk_ prefix),
    h2-vs-alpha step figures, doc sections 10-11; refined eq-H2 pric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
    [sweep_eval_all_ems-ftp75-sdp.csv, sweep_eval_all_ems-sdp.csv, sweep_eval_ems-ftp75-sdp.csv, sweep_eval_ems-sdp.csv, sweep_eval_refined_ems-ftp75-sdp.csv, sweep_eval_refined_ems-sdp.csv, walk_trace.csv]
2026-09-02 Docs: offline EMS toolchain section, Mode B audit pointer, power-balance conventions, README test pointer
2026-09-02 WP-1 (A + B1 + A fix round): Ag105 charge efficiency 0.88 in both HIL engines; eta-era charger accounting in DP/SDP/walk/db; tables regenerated
    Plant: energy-conserving buck/boost charger (chord-conductance stamp, floor AG105_V_IN_MIN,
    output-referred regen cap, p_chg_loss_w column, eta_chg sidecar + fingerprint key).
    Tooling: tools/charger_power.py era helper (absent eta_chg = old V_bus billing), generator D12,
    solver D13 (lever + charge-edge alpha modes, --eta-chg-none), walk eta parameter, db optional
    key field, sweep --eta-chg/--sweep-dir, matched-DP era fix. Physics change record in
    docs/HIL_PLANT.md 4.6.1-4.6.2 with a six-item reversal path.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
    [dp_ems_table_ems-dp-replay_old_era.csv, dp_ems_table_ems-ftp75-5050.csv, dp_ems_table_ems-ftp75-dp.csv]
2026-09-02 WP-1B2a: sdp_policy_v4 (lever mode, eta 0.88), eta-era alpha sweep + live picks, era-aware sweep script
    [sweep_eval_all_ems-ftp75-sdp.csv, sweep_eval_all_ems-sdp.csv, walk_trace.csv]
2026-09-02 WP-1B2b + WP-1C: sdp-v4 registered and bound (ems-sdp, ems-ftp75-sdp); certificate allowance for the eta-era UNDECIDABLE measured window; DP-table charger-era guard; fingerprint omits eta_chg when No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
2026-09-02 MPC core fix round: callback-rate roll slicing, merge-publish, bind signature, per-tick roll chunking, self-load subtraction, artifact demand map, charge-window transitions, max_candidates, TPM valid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
2026-09-02 WP-1B1 fix round (era-correct DP backward pass, db CLI, fingerprint reachability, tables regenerated) + MPC registration (mpc-det/mpc-sto, four ems-mpc* scenarios, CSV columns, config.mpc, frontier t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
    [dp_ems_table_ems-dp-replay.csv, dp_ems_table_ems-ftp75-5050.csv, dp_ems_table_ems-ftp75-dp.csv]
2026-09-02 Review: hil-plant adversarial review run 001 (HIL_PLANT.md) — 8 findings verified, adjudicated, ledger opened
2026-09-02 Docs: HIL_PLANT.md physics-review fixes (F1-F8, N1/N2), campaign-B conventions (asymmetry era field, probe-point bus-draw ratio, replay share-guard coverage), 18 B frame statement, walk rule = hold A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
2026-09-02 Campaign-B fix round: cp1252-lossless console + sidecar finalize in finally; numeric min_ticks in scan_signals + spec guard; MPC cap 1029; mppt mirror pin peak-form + relabels; socband tripwire split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
2026-09-02 Docs: campaign B into the 2026-09-02 addendum, WORK_QUEUE 0a fix-queue ledger, MORNING DIGEST draft (campaign C pending)
2026-09-02 Post-campaign fix round (fix-round review + campaign C): socband mask settling hold (exclude_hold_ms 10); finalize-in-finally test; substep gate -> warning with collapse fraction; guarded teardown be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
2026-09-02 EMS-comparison analysis stage + PLANT-R1-N4 resolved (rejected)
    - tools/hil_ems_comparison.py: per-profile H2-vs-dSoC plane with dSoC-matched DP
    bounds and eq-H2 contours, cumulative H2/SoC trace overlay, ranking table
    (deviation vs DP, eq-H2, vs reference/bound, suite frontier verdict);
    hand-written Commentary carried forward across re-renders; runs at the end of
    hil_report_analysis.analyze_report() in lookup mode; standalone --matched-dp
    solve for missing bounds. 38 tests.
    - dp_db: matched-DP solves for ems-ftp75-socband (0.0394139 g) and ems-ftp75-mpc
    (0.0220421 g), both converged.
    - hil-agent-analysis skill: EMS-comparison stage in Stage 0 and Stage 4.
    - PLANT-R1-N4 (FC_BUS.i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
2026-09-02 MPC: feedforward-aware open-stage model, asymmetry map wired from the run, adaptive budget + transition-aware ladder coarsening (nonlinearity survey)
    - Open stages now model the firmware's two open-loop submodes: HOLD under the
    powerBalance() conditions, otherwise the setpoint slews at
    DROOP_RATIO_SLEW_PER_TICK / handoff rate on the droop ratio, integrated in
    closed form (ramp_mean, exact to 1.5e-14 vs a tick loop) and mapped to
    delivered share; transition rolls seed/publish the handoff state. Old path
    byte-identical without the seeds.
    Gate 1 (ems-soc-band share_pred_err): mpc-det 0.010334/0.250 -> 0.000095/0.00356
    (PASS at 5e-3); at the measured plant dv0 0.013522 with the asy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
2026-09-02 DP bound stage 1: per-node bus bleed (30k bus / 60k nodes), structural loss map in the DP demand, droop-mode bus law, mpc-sto promoted to the frontier MPC
    Physics (operator rulings 2026-09-02):
    - R_NODE_BLEED 2 kOhm (never calibrated) -> R_NODE_BLEED_BUS 30 kOhm / R_NODE_BLEED_OTHER
    60 kOhm, per-node conductances in ElectricalSim; simple-engine R_BUS_BLEED 30 kOhm
    (tau 0.94 s -> 14.1 s). TODO(calibrate) with a bench decay-capture procedure.
    Every h2 anchor moves (61 s -1.7 %, FTP-75 -2.9 %, soc-depletion latch ~+1.5 s;
    scp-inrush/handoff-sag cuts lose bit-exactness) - BLEED-ERA block, re-pin on the
    next campaign. Physics change record + reversal path in docs/HIL_PLANT.md.
    - The dp-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
    [dp_ems_table_ems-dp-replay.csv, dp_ems_table_ems-ftp75-5050.csv, dp_ems_table_ems-ftp75-dp.csv]
2026-09-03 fw v26: FC/BT current-ceiling share clamp (PENDING FLASH) + WORK_QUEUE rulings
    Operator directive 2026-09-02: keep OC_FC; when the fuel-cell current nears its limit,
    clamp the delivered FC share so the battery supplies the excess; battery-side ceiling too.
    - applyShareCurrentCeilings(): sp <= SHARE_GOV_I_FC_CEIL_A (1.25 A) / I_tot_filt and
    sp >= 1 - SHARE_GOV_I_BT_CEIL_A (2.70 A) / I_tot_filt, hysteresis 0.05 A on engagement,
    minority clip first, constrained into the setpoint band (can never command a cut),
    downstream of share_actedSp (no HOLD/FEEDFORWARD toggling), suppressed under a
    deferred cut, bit-identical to v25 below the ceilings. Flags cleared on every
    frozen-loop return,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
2026-09-03 DP round stage 2: ftp75c compressed cycle on scaled-air drag, regen manager + signed regen DP term; DP grid and MPC ladder widened to [0.15, 0.85]; MPC single-source foundation
    Stage 2 (design: docs/modeling/ftp75c_regen_cycle_design_20260902.md):
    - ftp75c: FTP-75 raw 0..340 s at time factor 0.5, velocity unchanged (234 points, worst
    error 4.4e-16, t 5..175 s, peak accel +/-0.349 m/s^2); gen_ftp75_profile.py --time-factor.
    - --drag rig|scaled-air|scaled-air-matched (k_air 0.0598069 / 0.0133300 N/(m/s)^2, F_c 0,
    M_EFF 3.5); campaign legs on scaled-air (51 % regen share; operator ruling).
    - tools/regen_power.py: the one regen chain (VESC clip, ETA_REGEN, output-referred Ag105
    cap, choppe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
    [dp_ems_table_ems-dp-replay.csv, dp_ems_table_ems-ftp75-dp.csv, dp_ems_table_ems-ftp75c-dp.csv]
2026-09-03 fw v26 tools mirror: governor clamp port + firmware equivalence harness, delivered-share semantics (feasibility on commanded FC / delivered BT), fw26-clamp-cruise/-sweep scenarios, aux-bit masks, BLG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
    Reachability corrected: ems-y-b30-v3 is the only registered stimulus over the 1.25 A ceiling
    (11 ticks predicted from campaign C; campaign D measured 12). Three committed DP tables regenerate
    byte-identical; sdp_policy_v3/v4 reproduce exactly; constants_hash unchanged (FW26_ excluded).
    Suites: .venv_hil 2087 passed / 80 skipped; miniforge 2778 passed / 1 skipped (+1 known wall-clock
    flake under load, passes in isolation). Firmware suites untouche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
    [common.py, gov_ceiling_harness.cpp]
2026-09-03 Post-campaign-D fix round: scoring defects (ftp75c chopper aggregator, MPC share band from SHARE_BAND_DP, sw_ring load-dump verdict gate at 0.5 A, mppt cruise window after the mirror goes live, ftp75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
    Campaign D (hil_report_20260902_220604, fw v26, tooling 201de7b): 70/70 executed runs correct,
    0 board defects; eight FAILs were tooling artefacts, all re-judged to PASS offline under this
    round. Loss-map DP bound validated o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
2026-09-03 MPC single-source (0/1 share) enumeration: rollout-time cut-guard admissibility, block-0 candidates on the measured single-source bus law, guards (regen bit + host key, FC-charge, deferred cut, latch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
    Transport: the firmware constrains the received setpoint to [0, 1] (.ino:5663), so exact 0/1
    reaches updateShareSetpointCutoff() unchanged; no protocol change. Finding: the share-cut load
    guard never refuses permanently inside the OC-admissible region above 0.6 A total (the d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
2026-09-03 Conventions: fix-round D-items left unstaged in d941170 (comm-loss bleed-era re-close, ML0217 chain exception, replay zero coverage of fw v26, census as a spread, parse-the-last-number); overnight lo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
2026-09-03 Campaign-E fix round: clamp sweep bridged (velocity first, share 1.5 s later at both both-axes boundaries; walked 1.311 A bridged vs 1.722 A unbridged), cruise step pins (reach_within_ms spec kind), 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
    Campaign E (hil_report_20260903_031220, tooling d941170): 72/72 executed runs correct, 0 board
    defects; all eight campaign-D FAILs closed by their fixes; the fw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
2026-09-03 hil-plant review run 002: Codex round 1 + 8 verifications + counter-review + adjudication (1 major: the governor split law missing the droop-slope term and the 0.033 Ohm floor; 7 minor; 6 adjacent); 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
2026-09-03 Governor split law: rho + 0.033 ohm series floor (PLANT-R2-F3/N1/N2)
    GovernorModel.delivered_share() now carries the full M2 asymmetry pair
    (ASYM_DROOP_SCALE_FC 0.9434) and DROOP_FIXED_SERIES_OHM, with a closed-form
    inverse; _apply_simple_asymmetry() uses the same law; both parameters are
    resolved from the live engine beside dv0_v (walk, MPC, probe). Board windows
    reproduced to <= 1.1e-4, CAL-1 RMS 0.006414, engine equality 9.3e-5. Re-pins
    on the old law's path only: sweep regions 1/8/12, new region 10 (declared 5 %
    band), clamped region 2, cruise r_applied 0.6125, unbridged peak 1.7120 A.
    Gate 1 mpc-det 0.000740 PASS. DP tables and K_G byte-identical. Review fixes:
    MPC-side wiring tests, on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
2026-09-03 HIL_PLANT.md physics review run 002: documentation corrections + fix-round record
    F1/N10 mppt count is mirror evidence; F2/N6 section 4.8 classification and
    95.15 % / 58.20 s on 970 uF (also CLAUDE.md, HIL_SCENARIOS unbridged peak);
    F4/N7 accounting-boundary statement; F5/N4 hot-loop current-scaled ring bound
    (hil_electrical comment); F6 offline model-optimum reference with the signed
    0.09-0.80 % magnitude (hil_ems_comparison, hil_report_analysis note); F7/N5
    transient-realization exclusion, cut deferral, race formula 24.9 ticks; F8/N3
    date-scoping, band [0.15, 0.85], section 9.4.3 moved, rail K_eff figures.
    Run record and ledger carry the fix-round status; WORK_QUEUE 0c item 9.
    Co-Authored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
2026-09-03 Test: MPPT threshold manager excludes regen from its window (PLANT-R2-N9)
    test_mppt_regen_excluded_from_window (35 checks): OBSERVE abandons to IDLE
    when REGEN_ENABLE rises, the regen-window sample never lowers the minimum, no
    I2C traffic, budgets untouched, clean restart after a fresh settle wait, the
    ratchet guard's dwell also breaks. 3961 / 175 / 4443, 0 warnings. Firmware
    unchanged. Residuals recorded (level test at the 50 Hz tick; stale minimum in
    the State-98 diagnostics).
2026-09-03 sdp_policy_v5: alpha re-solved on the five measured lever readings (D14, lever-measured mode) - registered NON-frontier pending a ruling
    alpha = 0.05/sqrt(0.4165286 * 0.3337114) = 0.134110 (mean of B-F; measured
    window (0.120040, 0.149830), v4 1.43 % below it). --alpha-mode lever-measured
    with --lever-share/--lever-chg/--lever-source; v4 regenerates to the same
    policy sha (8ca7dcee). FINDING: the stage cost bills charging at the model's
    ETA_CHG 0.88 while the board's round trip is 0.801173, so the measured-lever
    alpha sits 6.3 % above the MODEL window and admits charging on 558 of 2525
    cells (40 rows inside the reachable band). v4 keeps the frontier; sdp-v5 is
    registered frontier_eligible Fa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
2026-09-03 Operator rulings 2026-09-03 (part A): MPC share-step guard, fw26-clamp-joint 1.65 A leg, orphaned DP table deleted, ftp75c socband charge-free note
    SHARE_STEP_GUARD_I_TOT_A 1.65: block-0 candidate columns above the committed
    ratio are refused when the predicted two-source total exceeds the guard and
    rises versus the previous decision; inert on all six registered MPC scenarios
    (largest 1.4714 A; guard-off/on streams sha-identical); refusal census in the
    sidecar. aux_preload_step scenario key (ramp then true steps, era-safe, DP
    mirrors inherit it); fw26-clamp-joint: motor-free, preload 1.20 -> 1.65 A
    coincident with share 0.40 -> 0.84, walked peak 1.3303 A (structural bound
    (I_tot - 0.30) - 1.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
    [dp_ems_table_ems-ftp75-5050.csv]
2026-09-04 Low-current share stability exploration: five stdlib probes (HIL governor-regime census, gate sensitivity, BLG noise/spectrum, effective-offset current, droop-schedule table), the exploration note, W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
2026-09-04 Afternoon rulings 2026-09-03: sdp_policy_v6 at the measured 0.801 round trip (frontier), I_AUX_A 5 V dropout floor, N8 settled, Step-0 margin refutation, 4x droop loss localized
    sdp_policy_v6: --eta-chg measured (ETA_CHG_MEASURED_ROUND_TRIP 0.801172836631146 derived
    from the five lever readings) --alpha-mode lever-measured; alpha 0.134110 inside both windows
    (model (0.111000, 0.138547), measured (0.120040, 0.149830)), 0 charge cells, D12 tripwire
    silent, certificate clean; charger.eta_chg_basis declared and accepted at bind time. v4/v6
    share maps differ on rows 4-5 (50 cells) 45 nodes below target: ems-sdp, ems-ftp75-sdp,
    ems-ftp75c-sdp rebound to sdp-v6 with every expectation transferring v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
2026-09-04 fw v27 (PENDING FLASH): governor minority clip on the open-loop FEEDFORWARD path; at shipped constants the band is empty below the 0.60 A gate so the reference HOLDS (never collapses to 0.5)
    shareFeedforwardClipTarget()/shareFeedforwardClipHolding(): band
    [I_min/I_tot_filt, 1 - I_min/I_tot_filt] on share_govTotAFilt, run first in the
    FEEDFORWARD branch, then the fw v26 ceilings (inert below the gate), the slew
    limiter and applyShareRatio(); an empty band holds droopSlew_prev, so the
    open->closed handover carries no jump (the TP0105/TP0115 mechanism; answers the
    fw v5 TP0053 argument, which was a commanded move). Review fixes: the clip is
    bypassed while a controller cut is outstanding (shareI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
2026-09-04 WORK_QUEUE 0d: fw v27 rev 2 course correction (D = 0.30 V, I_min 0.15 A, gate 0.30 A)
2026-09-04 I_AUX_A 0.15 -> 0.09 A (operator ruling, plant era boundary): both engines, era-named fingerprint refusal, three DP tables re-solved, AUX-ERA anchors re-walked and pinned provisional for campaign G
    Basis: the Teensy runs from the battery's 5 V regulator, the VESC draws ~1.2 W
    from the bus (0.075 A at 15.9 V), the INA253s/RT1987s/OPA197s ride the bus
    chain; 98 logged standstill windows (VESC unpowered) read 0.0150 A inside the
    0.020 A INA offset. Walked h2 deltas -6.0 % (ems-sdp) to -30.4 % (ems-ftp75c-sdp)
    = the fixed 0.060 A as a fraction of each run's draw. Four fw26 stimulus
    preloads raised 0.06 A so the designed totals hold (joint step stays 1.65 A).
    Host-native re-pins (P0 peak 0.151185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
    [dp_ems_table_ems-dp-replay.csv, dp_ems_table_ems-ftp75-dp.csv, dp_ems_table_ems-ftp75c-dp.csv]
2026-09-04 fw v27 rev 2 (PENDING FLASH, supersedes 2d200b1): governor package - battery-only start, closed-before hold, load-scheduled droop scale (D = 0.30 V, s = 0.9, I_min 0.15 A, gate 0.30 A), BLG v8
    1. Never-closed profile runs battery-only: a one-shot arm at the six profile
    starts commands share 0 through the existing cut path (load guard, deferral,
    survivor blanking; suppressed in an FC-charge window and while the survivor's
    regulator is off; disarmed by an out-of-band setpoint); the frozen cut path
    advances the total filter so the release can fire at the 0.30 A gate.
    2. Closed-before hold kept (rev 1); the cut-outstanding bypass now accumulates
    its proposal (shareIsoPropRatio) so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
2026-09-04 fw v27 rev 2 tools mirror: governor model, walk, MPC, DP guard, plant k_d recovery, FW27-ERA suite expectations, HIL_PLANT.md - campaign G tooling
    governor_model: SHARE_MINORITY_I_MIN_A 0.15, battery-only arm/release, hold with
    the accumulating cut bypass, k_d schedule (s 0.9, hold/hysteresis/slew,
    g-guard), survivor-regulator guard, CEILING_REACHABLE_I_TOT_A 1.4706 A;
    firmware equivalence harness test/gov_fw27_harness.cpp +
    tools/test_governor_fw27_equivalence.py: 16 cases, 13 288 rows, 3 458
    code-comparable, max MDAC code delta 0 (23 constants pinned to the .ino).
    ems_walk arms the battery-only start; mpc_ems: ShadowGovernor arms it too
    (review H2), delivery_table's open-feedforward arm ho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
2026-09-04 Overnight log + WORK_QUEUE: campaign G complete (63/75; zero board defects; fw v27 sequencing defect at the charge-window entry, forced-0.5 regime, k_d saturation in charge windows; comm-loss sim art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
2026-09-04 Overnight log + WORK_QUEUE: G replay audit (27/27 real; three unscored fw v27 axes), G2 findings (ftp75c sequencing defect at scale, share-cut chatter, re-entry transient), fw v27 rev 3 / v28 spec se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
2026-09-04 Post-campaign-G fix round (tools only): teardown anchor on latches, RT1987 SOFT one-sided stamp, aux-era stimulus/threshold re-pins, MPC battery-only branch, replay topology/tagging/windows, ftp75c r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
    From campaigns G (hil_report_20260903_233736, fw v27 rev 2 + I_AUX_A 0.09 A,
    63/75) and G2 (hil_report_20260904_003108, the ten long-cycle legs, 3/10);
    every FAIL classified in the folders' HIL_FINDINGS.md; zero board defects
    outside fw v27's own new mechanisms (F1-F7 in WORK_QUEUE 0d for the operator).
    - share_cut_load_hazard anchors on the union of the whole-run and post-grace
    LATCH maps (a carried-in bit or a bare transient no longer shadows or shifts
    the teardown cu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
2026-09-04 Overnight log: D-4 campaign H launched (c708d71, full plan incl. long-cycle legs); MORNING DIGEST 2026-09-04
2026-09-04 Overnight log retrospective 2026-09-03/04; overnight skill: eight additions (opt-in legs, tracked watchers, stdin hang, carried-in anchors, era axes, stimulus re-derivation, pre-classification, sim-f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
2026-09-04 Overnight log: campaign H complete (63/75; the twelve FAILs = the pre-classified set; every re-pin validated on the board; two ftp75c legs latched UV_BUS); stop after H
2026-09-04 Overnight close-out: campaign H result (63/75, pre-classified set, every fix validated; F1 latched on two legs via a third trigger; joint bound needs a third reading; ftp75 frontier verified), CLAUDE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
2026-09-08 WORK_QUEUE 0e: fw v28 round briefs (F1 disarm-before-open, never-closed source selector, sliver hold, I_min 0.125 A, handoff 0.10/0.12, charge-window k_d hold), open-item triage; bench manual CAL-6 (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
2026-09-08 Host-native encoder-defect harness (WORK_QUEUE 7d): edge-list generator with five defect scripts, run_tests_encoder target (43 checks), first 2676-run sweep, design/findings record
    - tools/encoder_edge_script.py: mechanical law transcribed from hil_plant_sim.PlantState.step (constants imported, equivalence pytest bit-identical), geometry asserted against the .ino, defects positioned by slot, JSON manifest naming every altered edge, atomic writes; 41 pytest checks.
    - test/encoder_defect_harness.cpp: edges applied at their own micros through the real ISRs, updateWheelSpeed()/motorControlGated() unmodified at the shipped cadence, plant closed on the firmware's own estimate; regression mode (43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
2026-09-08 fw v28 (PENDING FLASH): the source-selector package - F1 disarm-before-open + conduction-gated charge window, never-closed BT/FC source selector (inclusive 0.85/0.15), bounded sliver hold, I_min 0.12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
    Operator rulings 2026-09-08 (WORK_QUEUE 0e) after campaigns G/G2/H on fw v27 rev 2.
    1. F1: chargingControl() disarms the selector (either cut) instead of calling
    assertFcChargeEnable(true) while it holds a channel off the bus; FC_CHARGE opens
    only when FC_BUS reads HIGH and is out of its turn-on blanking. The latch's own
    guarded release re-closes FC_BUS onto the battery-fed bu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
2026-09-08 CLAUDE.md addendum 2026-09-08 (fw v28 built + reviewed, PENDING FLASH; encoder harness findings; mirror queued); rotate the 2026-09-02b fw v26 addendum to the archive (range 9); WORK_QUEUE 0e/7d ticks
2026-09-08 Encoder-defect regression wired into run_tests (ENCODER_HARNESS_EMBEDDED include; 4207 -> 4250 checks; bench/HIL builds unchanged; standalone run_tests_encoder still 43); WORK_QUEUE 7d hook tick
2026-09-08 fw v28 rev 2 (PENDING FLASH): encoder direction-sense AUTO-FLIP on positive-feedback runaway, no fault (operator ruling 2026-09-08 from the harness finding); safety-review fixes F2-F6
    Operator: detect the runaway of an inverted assumed encoder direction and flip
    the sign in firmware without a fault, with a significant threshold against
    chatter; wanted regardless because the connector can be plugged in reversed.
    - encDirSign (+1/-1) applied through encDirApply() at the six non-zero v_actual
    publish sites of updateWheelSpeed(); the ISRs, the velocity math and
    encoderVelReset() are byte-identical; the holds stay in the decoder frame so a
    flip re-signs held and live values together. Struct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
    [encoder_defect_harness.cpp, gov_fw28_harness.cpp]
2026-09-08 fw v28 tools mirror, part 1: governor_model port (selector, F1 either-cut disarm, S2 raw escape, bounded sliver hold, k_d hold/freeze, S7 sub-gate ceiling, 0.125/0.10/0.12 A), fw v28 equivalence harn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
    - governor_model.py: GOV_CONST 0.125 / 0.10 / 0.12, SHARE_SELECTOR_FC_SP, RT1987_T_D_ON_MS;
    selector state + effective sp; step(charge_intent) disarm-before-open on either cut;
    inclusive rails with hold; selection-agnostic gate release; raw |I_fc| escape; sliver
    hold bounded by SHARE_HANDOFF_MIN_A/I_tot; _update_droop_scale freeze under any cut,
    K_DROOP + frozen input in a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
2026-09-08 fw v28 tools mirror, part 2: MPC surrogate selector-aware (per-column cut mask, FC release preview, Gate 1 in-band on all six legs), the fw v28 per-anchor re-walk table (23 legs, provisional pins, no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
    - mpc_ems.py: selector_choice() (inclusive rails, hold); batt_only_cut_mask(pre_fc_release,
    selector_fc) with the F1 disarm at a charge stage and the raw |I_fc| > 1.25 A escape; masks
    memoized per selection; per-column sel_fc/cut_src/cut_d/cut_lim billing the SELECTED source;
    ShadowGovernor.selector_fc; preview_fc_release mirrors preview_bt_release via one _stage_release();
    share_pred_err_band_* over in-band commits. Gate 1 (i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
2026-09-08 fw v28 rev 3 (PENDING FLASH): the encoder direction sense PERSISTS across power cycles (operator ruling 2026-09-08 evening) - EEPROM record, boot restore, State-98 'Z' clear key
    - 4-byte record at EEPROM 4276 (magic 0xE7 / sign 0x01|0xFF / generation u8 /
    checksum (magic+sign+gen) XOR 0x5A); read in setup() ahead of any
    updateWheelSpeed(); a valid record sets encDirSign and prints
    "ENC DIR SIGN: -1 restored from EEPROM (gen N)"; blank or corrupt records
    leave +1 and write NOTHING (a virgin board never spends a cycle).
    - Written only at a runaway flip, via EEPROM.update(), after the sign flip,
    the same-tick v_actual correction, resetDriveControlState() and the print
    (so the blocki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
    [EEPROM.h]
2026-09-08 fw v28 rev 4 (PENDING FLASH): the EEPROM commit deferred off the flip tick (loop-level, logDrainTick discipline, survives a State-99 latch, 'Z' cancels a pending commit); the k_d single-source hold k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
    - encDirCommitTick() after logDrainTick() in loop(): one commit per iteration, gated
    like the SD close (never in State-99 phases 0-2; executes in phase 3, so a flip
    followed by a latch keeps its record); the flip tick keeps the sign flip, the
    v_actual correction, resetDriveControlState() and the print, and only sets a flag.
    'Z' stays synchronous and cancels an outstanding comm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
2026-09-09 RT1987 constant-slew ramp A/B (operator ruling 2026-09-08): --rt1987-ramp {legacy,constant-slew} selectable and era-fingerprinted; DECISION legacy stays the default - constant-slew moves the cold bri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
    - hil_electrical.py: rt1987_slew_v_s(css_nf) from DS 17.1/17.3 (VIN cancels): 645.48 V/s at
    100 nF, 11 992.6 V/s at 5.6 nF; Rt1987._ramp_t_on() is the single fork shared by the SOFT
    operating point and the completion test; TD_ON gate, one-sided SOFT stamp, reverse branch,
    HWM scoping, precharged threshold, foldback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
2026-09-09 fw v28 rev 5 (PENDING FLASH): the re-entry rule (operator ruling 2026-09-08 evening) - in the closed-before open-loop region an out-of-band command RE-ARMS the selector, in-band commands keep the hol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
    - Re-arm conditions (top of powerBalance()): not armed, shareClosedLoopRun, !shareClosedLoopMode,
    share_govTotAFilt <= 2*I_min (required: the mode flag lags the filter by a tick), command
    <= DROOP_R_MIN or >= DROOP_R_MAX (inclusive), FC_CHARGE LOW, and no re-arm inhibit. The
    selection is the triggering command's; from then on the never-closed machinery applies
    (holds through in-band commands, releases at the gate, F1 disarm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
2026-09-09 fw v28 rev 6 (PENDING FLASH): rev 5 safety-review fixes - the F1/raw-escape inhibit survives a full iteration and any latched cut (S1), a 250 ms selection-change dwell (S2, <= 4 commutations/s), the 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
    - S1: shareSelectorReArmInhibitFresh - an in-band command consumes the freshness token
    instead of clearing the inhibit, and the clear is gated on no latched setpoint cut; the
    reviewer's path (window intent, in-band hold, refused release, rail command next tick)
    no longer re-arms before the window opens.
    - S2: SHARE_SELECTOR_DWELL_MS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
2026-09-09 Tools round (operator rulings 2026-09-08 evening): BLG v9 decoder (116 B, selector_bits incl. rev 6 bit4 = re-arm inhibit, signed enc_dir_sign), ASYM_SIMPLE_I_MIN_A 0.10 -> 0.08 A, --droop measured s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
    - decode_benchlog.py RECORD_FMT_V9 / CSV_HEADER_V9 (37 columns), v7/v8 unchanged-by-v9 tests,
    non-block-aligned decode (464 B drain chunk); benchlog_analysis/common.py; make_test_blg --v9;
    PLAN.md 9g (v8 + v9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
2026-09-09 WORK_QUEUE 0e item 19: ems-sdp accepted as a clamp witness (operator ruling)
2026-09-09 SDP alpha sweep re-run at the MEASURED charger billing (operator ruling 2026-09-08): charge boundary 0.126136 -> 0.138547 (x0.88/0.801173 exactly), degeneracy boundary unmoved at 0.111000; the measur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
    - tools/sdp_alpha_sweep.py: --eta-chg / --walk-eta-chg accept the literal 'measured' (resolved
    through the solver's own resolver, passed through so every artifact declares
    charger.eta_chg_basis); manifest records eta_chg_basis and a plant block (constants_hash
    e7c5f452..., I_AUX_A 0.09, ASYM_SIMPLE_I_MIN_A 0.08). 41 artifacts + manifest + live_picks
    under tools/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
    [sweep_eval_all_ems-ftp75-sdp.csv, sweep_eval_all_ems-sdp.csv]
2026-09-09 Alpha legs rebound to the measured-billing sweep (SDP_LIVE_PICKS_PATH -> sweep_20260908_meas; greedy idx 3 / cal idx 8 = sdp_policy_v6 byte-identical / charge idx 15); the greedy walk discrepancy set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
    - Reproduced both numbers on the same policy digest: sweep-native 0.002766191 g; suite
    configuration (loss_map, dv0_v 0.013522, droop_scale_fc 0.9434) 0.000844288 g; either
    asymmetry term alone carries the whole gap; the file's 0.0009750 was one commit stale
    (c11a464's governor mirro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
2026-09-09 WORK_QUEUE 0e item 21: the mpc-det/mpc-sto cross-leg test re-adjudicated for the fw v28 selector (mechanism named, no tolerance widened)
    - Divergence traced: commands differ from tick 0, delivered first differs at tick 450 -
    under the fw v28 never-closed selector an in-band command only HOLDS the selection, so
    det's 0.5000 and sto's 0.2375 are the same instruction; 73 of 110 differing ticks sit on
    the battery-only rail, 23 ticks (1.15 %) deliver differently and they are the same rung
    pair in opposite order (a phase difference against the selection dwell).
    - Claim restated: delivered min/max identical, the rail-tick SET identical, wide walk never
    reached; billing identity (rel h2 de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
2026-09-09 Overnight log: campaign I launched (60abb34, full plan + opt-in legs)
2026-09-09 Overnight log: campaign I interim at 25/75 (zero board defects; F1 conduction gate, k_d hold, FC-only selection measured; ems_walk floor defect found)
2026-09-09 Full-scale governor penalty sub-project: Python port of SDP_EnergyManagement_Governor3.m + sweep, MATLAB-validated, attribution; governor eq-H2 slide
    - tools/fullscale_governor/: sdp_governor3.py (port), sweep_governor_scale.py, udds_demand.py (road-load stand-in),
    attribution.py (ablation), compare_with_matlab.py, MATLAB drivers and validated sweep JSONs.
    Port matches MATLAB R2024b to four decimals on every table column (stand-in and student's UDDS file);
    reproduces the student's slide exactly (his +8.82 % at alpha 200 / S_I 127.8 is a transcription slip for +9.73 %).
    - Finding: the 3-16 % penalty is an operating-point effect of the convex fuel map under a supervisor that idles
    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
2026-09-09 Overnight log: campaign I interim at 34/75 - F1 validated on the board (disarm path on three compressed-cycle legs, zero UV_BUS); chatter and MPC-rung findings
2026-09-09 Overnight log: incident - ems-mpc-cross host stall (315 ms tx gap, HIL link latch); D-2 cap concurrent analysis agents at two
2026-09-09 Overnight log: campaign I scenario half analyzed (48/48, zero board defects, F1 closed on all triggers)
2026-09-09 Overnight log: campaign I complete (66/75, ftp75c frontier verified first time); git note on the branch switch and cherry-picks
2026-09-09 Campaign I close-out: CLAUDE.md addendum 2026-09-08/09 (first fw v28 campaign, F1 closed on all triggers, zero board defects, ftp75c frontier verified; the chatter and MPC-rung findings; two tooling 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
2026-09-09 hil-conventions: host-load rule from the campaign-I stall (two-agent cap, one-pass briefs, the link-latch triage) and the fw v28 selector observables
2026-09-09 H-20 convex hydrogen map (phase A): tools/h2_map.py replaces the linear Gfc DC gain as the scored H2 model across plant, DP, SDP, walk, MPC; era switches; DP tables regenerated
    Orchestrated tooling round (Opus implementer, Sonnet tests, two-lens review, fix round + test-fix round).
    Operator decisions 2026-09-08: constant-offset loss model (purge + blower + controller, A0 = 6.633e-5 g/s);
    no stack shutdown state (hook SHUTDOWN_ENABLED, default off); Gfc kept documented, not scored;
    electrical FuelCellSource refit deferred to its own round.
    - tools/h2_map.py (NEW): rate(P_stack) = A0 + K_FARADAY(13 cells) * I(P_stack) through the brochure U-I
    curve; P_MAX 23.416 W stack = 1.247 A bus; finge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
    [dp_ems_table_ems-dp-replay.csv, dp_ems_table_ems-ftp75-dp.csv, dp_ems_table_ems-ftp75c-dp.csv]
2026-09-09 H-20 phase B items 1-3: lever prices, sdp_policy_v7, charge admission
    The 2026-09-08 handoff's central quantitative premise is refuted by the
    campaign record. Campaign I's ems-sdp Run window has a MEDIAN STACK POWER OF
    13.3654 W (map-inverted from its own h2_rate_gps column, 54 982 ticks), not the
    3.2 W design estimate, so the rig runs at 0.4314 LHV efficiency against the
    map's 0.4329 peak rather than far below it, and A0 is 26 % of the rate there
    rather than 63 %. Every downstream number moves with it, mostly opposite to the
    predicted direction.
    ITEM 1 - LEVER PRICES. Walked the three alpha legs under the H-20 map on the
    suite's anchor configuration plus the full split law (r_series 0.033;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
    [sweep_eval_all_ems-ftp75-sdp.csv, sweep_eval_all_ems-sdp.csv]
2026-09-09 WORK_QUEUE 0f: item 12 closed by D-4; item 13 the convex-map admission ruling (46 cells); item 14 the handoff corrections (13.37 W, lambda 0.423, the split-arm 1010)
2026-09-09 0f-1 root cause: the low-rail reference is INFEASIBLE in band, not an unsolvable inverse
    Campaign I adjudicated ems-sdp-alpha-greedy's zero-delivery cruise as a failed
    split-law inverse in ems_walk falling back to 0. Refuted, with the board as the
    reference:
    * `_ratio_for_delivered(0.15, 1.4114)` solves cleanly and returns 0.130273 -
    no exception, no fallback, no clip. It is simply BELOW DROOP_R_MIN (0.15) by
    0.0197, so no in-band ratio delivers a 0.15 share at this operating point;
    the law's minimum with both channels live is alpha(0.15) = 0.171538.
    * `delivered_share()`'s exact 0.0 is its documented topology branch after the
    r-based FC cut that the out-of-band ratio tr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
2026-09-09 Overnight log: agent C refuted the 0f-1 mechanism (an infeasible low-rail reference vs the one-tick surrogate); D-5 port the real share controller into the walk (agent E); agent D on the suite items
2026-09-09 WORK_QUEUE 0f-1: mechanism corrected (infeasible low-rail reference vs the one-tick surrogate; the real controller port is the fix)
2026-09-09 0f-2: port the real Youla share controller into governor_model (fidelity boundary 1 closed)
    `GovernorModel._closed_loop()` modelled `youlaController_Power()` with a one-tick
    surrogate - the demanded ratio stepping straight to the split-law inverse. At the
    greedy alpha leg's operating point that inverse (0.130273 at share 0.15,
    I_tot 1.4114 A) is out of the droop band, so the surrogate cut FC on the first
    tick and every tick after: delivered share exactly 0 on 401 of 610 cruise stages.
    WHAT IS PORTED, and from where. `_youla_step()` reproduces
    teensy_controller/share_controller.h - the three DF2T biquad sections, the
    trapezoidal integrator, the back-calculation anti-windup on the [0, 1] auth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
2026-09-09 Overnight log: agent E landed (real controller in the walk; low-rail cut rate still 75x the board); D-6 campaign II is the hydrogen calibration source; WORK_QUEUE 0f-15 the reseed hypothesis
2026-09-09 WORK_QUEUE 0f items 1-8: the campaign-I suite and doc round
    Every bound here is re-derived from a named mechanism or a measured population;
    nothing is widened toward the board. Evidence: hil_report_20260908_200836.
    1. ems-y-b00-* bt_bus_restored is now EVENT-SHAPED (follow_within_ms, a new
    signal kind): BT_BUS was LOW at the region-7 edge and came back within 50 ms
    of the selector releasing. The fw v27 tick floor (2000 ticks in [24, 27] s)
    assumed an in-band command releases an isolation cut; campaign I measured a
    THIRD mechanism - region 6 drops v_setpoint to 0.30 m/s, the total falls to
    0.14 A under the 0.25 A gate, the selector RE-ARMS FC-only, region 7's 0.35
    holds it,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
2026-09-09 Overnight log: agent D landed (event-shaped checks, the stall tripwire, the cut census); agent C' dispatched
2026-09-09 Overnight log: lens-1 review rejects A's lambda/alpha core (pre-phase-A inversion; the cal leg substituted); the handoff's ~0.57 stands; D-7 fix round A' after C'
2026-09-09 0f Part 0: re-pin the fw26 clamp walk figures on the corrected share loop
    Agent E's real Youla recursion (849ff13) replaced the one-tick surrogate in
    `governor_model`'s closed loop and moved four pinned walk figures. Re-pinned
    from the corrected walk, with the mechanism in each comment; nothing widened.
    * joint, simultaneous peak 1.3188 -> 1.2877 A; the surrogate slammed the
    reference to the band edge in one tick, the real controller is slew- and
    dynamics-limited.
    * the commander-skew TIE is gone: the peaks now order monotonically in the
    skew direction (1.3185 / 1.3149 / 1.2877 / 1.2596 / 1.2521 A at -40 / -20 /
    0 / +20 / +40 ms), share-first worst. FW26_CLAMP_JOINT_WALK_PEAK_A is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
2026-09-09 0f-2/0f-3: the MPC hold mechanism REFUTED and re-diagnosed, exclude_hold_ms, the corrected-loop 23-leg re-walk
    0f-2, the queued mechanism does not hold. The item read: `delivery_table()`
    arms a column only while THAT column's own share is on a rail, so an in-band
    stage after a 0.15 -> 0.2375 step is predicted two-source while the board holds
    battery-only. That per-column test is real, but it is not what carries the
    residual, and the walk says so twice:
    * `re_arm_ok` is true at ZERO decisions on five of the six registered MPC legs
    (11 of 222 table builds on ems-ftp75c-mpc), so a per-column re-arm fix cannot
    move them. Extending the arm to in-band columns was implemented and measured:
    b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
2026-09-09 Overnight log: agent C' landed (joint walk re-pins, the MPC HOLD fix refuted by the release-preview lead, the re-walk column; the hydrogen-axis question)
2026-09-09 Overnight log: the hydrogen axis settled from source (both H-20); A' and lens 2 relaunched on filled briefs
2026-09-09 Overnight log: host reboot at 03:18 killed A' and lens 2 (partial A' diff kept); both resumed at 08:25
2026-09-09 Overnight log: lens-2 review (accept; the inert joint re-key HIGH; six lesser); D-8 fix pass after A'
2026-09-09 D-7 lens-1 fixes: the 14.6440 W reference, the corrected cal lever leg, lambda 0.4673, the run-window hydrogen basis and the saturation refusal
    F1, the operating point. H2_BASIS_REF_P_STACK_W and ALPHA_MISMATCH_REF_P_STACK_W
    13.3654 -> 14.6440 W. The 13.3654 W figure came from inverting the H-20 map on
    campaign hil_report_20260908_200836's h2_rate_gps column, which the RETIRED
    gfc-linear law produced: 35.96 % of its 54 982 Run-window ticks carry a rate
    below the map's own A0 offset, the ratio against the linear law has median
    0.9999958, and the run carries no h2_gfc_cum_g column. The shipped reference is
    the source-side electrical proxy p_fc_w/ETA_BOOST over the same window, which
    transfers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
2026-09-09 D-9 + D-8: frontier SDP reverts to v6; the seven lens-2 fixes
    D-9 (item 0): `sdp_policy_v7` re-solved at the corrected 14.6440 W operating
    point carries alpha 0.142475472567, 6.7 % above the corrected walked admission
    window [0.0882, 0.1335]; it does not certify and hil_plant_sim correctly
    refuses to bind it to the EMS-frontier role, which blocked every ems-sdp leg.
    The three frontier-scored SDP scenarios point back at `sdp-v6` (certified, 0
    charge cells), v6 demands the certificate again and v7 drops the demand so it
    stays loadable as the record of the re-solve and of its failure. The three
    strict xfails become live tests carrying the reason as a comment, plus a new
    pin, test_d9_frontier_sd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
2026-09-09 Overnight log: D-8 landed (v6 bound, the joint windows disjoint, the lens-2 items); CLAUDE.md ems-sdp-cross cut census corrected
2026-09-09 Phase-B close: two stale pins re-derived (sdp-v6 is the frontier role per D-9; the ems-sdp eq-H2 pin follows lambda 0.423 -> 0.4673 exactly)
    Suites on the final tree: stdlib 2476 / 96 / 1 xfail; numpy 3245 / 18 / 2 xfail + these two, now green (266 in their modules).
2026-09-09 Overnight log: phase B closed at db9b146; campaign II launched (H-20 calibration campaign)
2026-09-09 Overnight log: campaign II interim at 10/75 (H-20 era as predicted; the Gfc bridge; saturation on stack power)
2026-09-09 Overnight log: campaign II headline - the H-20 levers measured on the board (L_share 0.5656, L_chg 0.3845, ratio 0.680 != eta; lambda 0.4799 in band)
2026-09-09 Overnight log: campaign II second headline - the MPC plan inverted polarity under H-20 (0.85 modal, FC +86 %, drain halved); FTP-75 bands calibrated
2026-09-09 OVERNIGHT_LOG: campaign II interim at 36 of 75 (F1 clean on all five ftp75c legs; ftp75c-mpc inverted; the ftp75c bound arm)
2026-09-09 WORK_QUEUE 0h: campaign II rulings and fix queue; OVERNIGHT_LOG interim at 48/48 scenario legs analyzed
2026-09-09 Campaign II matched-DP: the H-20 re-solve for all 26 EMS rows (tools/dp_db, 27 records); MPC legs +0.2..1.2 % above their bounds, the SDP v6 / socband legs +2.4..7.5 %; addendum and log updated
2026-09-09 hil_ems_comparison: Figure N.3 - the lambda-free regret of every strategy against its delta-SoC-matched DP bound, tabulated, with the bound leg's own deviation as the plant-vs-stage-cost floor; Table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
2026-09-13 Bond graph: revamp as an executable BondGraphTools model with drawn sheets
    Adds docs/modeling/bond_graph_bgt.py (hierarchical model of the rev 20260622
    power paths: sources, boosts, six RT1987 switches, VBUS/V-MOT/CHG/BAT nodes,
    drivetrain, chopper, Ag105 charger) and the sheets it renders through
    BondGraphTools.draw() under docs/modeling/bond-graph-bgt/, plus a companion
    note mapping the first-pass bond-graph.md elements onto the library's
    primitives. No existing file is modified.
    Claude-Session: https://claude.ai/code/session_01DELyapJSRsew84MZnc8Egd
2026-09-16 Youla paper: draft discretization/anti-windup section and figure
    Adds a draft subsection (with generator script and PDF/PNG figure) showing
    that the exact Youla-H integrator splits G_CYH into kI/s + R(s), which makes
    the digital realization and anti-windup well posed. The figure compares
    clamp-only, integrator-only back-calculation and full-state Hanus
    conditioning on the paper's drivetrain controller under a saturating step.
    Claude-Session: https://claude.ai/code/session_011EhRZdeVMRmcgUmZ5KM413
2026-09-16 Youla paper: alternative anti-windup figure on the example plant
    Re-synthesizes the 1/(s+1) example-plant controller with the repo's H-inf
    solver (first-order weights read off the paper's figure), applies Youla-H,
    and renders the same clamp-only / integrator-only / full-state comparison
    as the drivetrain figure. Adds a matching alternative paragraph for the
    draft section. The drivetrain version is kept untouched.
    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
2026-09-16 Youla paper: H-inf vs Youla-H, both with full-state conditioning
    Comparison script and figure for the drivetrain plant: identical
    saturated-mode spectra and saturation recovery, the Youla-H DC-tracking
    difference is the only one that survives.
    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
2026-09-16 Youla paper: MATLAB script for all anti-windup variants and figures
    antiwindup_variants.m re-runs the drivetrain, conditioned-comparison and
    both example-plant cases in MATLAB with the paper's figure style, writing
    PNG and PDF to Figures/antiwindup/.
    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
2026-09-16 Youla paper drafts: fold in the conditioned-comparison finding, wrap prose
    The drivetrain draft now states that full-state conditioning serves the
    H-inf controller equally (identical saturated-mode spectra) and that the
    Youla-H benefit is the preserved DC tracking and the well-posed split; the
    other two drafts are aligned with that framing. All three are wrapped at
    ~90 columns.
    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
2026-09-16 gitignore: the repo-level scratchpad/ and the encoder harness binary; the h20 governor sweep slide data alongside its 2026-09-08 sibling
2026-09-16 Youla paper study: larger figures, legends moved below the axes
    All five figures re-rendered at roughly double the pixel size with the
    legends placed outside the plotting area so no trace is covered; the
    MATLAB script uses 'southoutside' legends and larger figure windows.
    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
2026-09-16 Youla paper study: figure-7 colour scheme, shared bottom legends
    MATLAB script: each figure is a tiledlayout with one legend in the south
    tile below every subplot; H-inf traces blue, Youla-H black with distinct
    styles; heavier lines; loop-shape weights blue as in the paper's Figure 7.
    Python generators mirror the scheme and now write to figures/python/ so
    the committed MATLAB renders are not overwritten.
    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
2026-09-16 Youla paper: MATLAB script regenerating Figs 2-5, 7, 8 with a compressed aspect ratio
    Re-synthesizes the drivetrain controllers from the Appendix A weights, reads
    the FTP-75 table from references/drive_cycles, and writes screen-resolution
    PNG plus vector PDF to Figures/compressed/. Figure 7 carries placeholder
    weights to be replaced with the originals.
    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
2026-09-16 fw v29 (PENDING FLASH, real testbench: BENCH_TEST 0 / HIL_SIM 0): the FC minority chatter fix - the Youla share controller's authority span follows the command
    An in-band commanded share (inclusive rails) bounds the controller's output to
    [DROOP_R_MIN, DROOP_R_MAX] with the existing back-calculation anti-windup at the
    rail; a deferred cut keeps [0, 1] bit-identically to fw v28. Closes WORK_QUEUE
    0h-2 / 0f-9: a sustained 0.15 command against the split law's ~0.17 minimum wound
    the output below the band under the fw v3-v28 unconditional [0, 1] span and
    applyShareRatio()'s r-based branch cut FC at ~0.8 Hz (71-78 FC_BUS falls / 90 s
    on campaigns I and II, ems-ftp75-sdp). The r-based cut is now r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
2026-09-16 fw v30 (PENDING FLASH, real testbench: BENCH_TEST 0 / HIL_SIM 0): the H-20 purge-dip UV rework, the source-depleted ruling, the FC-only lockout, the battery limits
    Supersedes fw v29 before any flash (the chatter fix rides along). The H-20 ran
    on the bench for the first time on 2026-09-15 and its output dips to ~1 V on
    every H2 purge; the fw v6 FAULT_UV_FC tuning (20 ms / 6.0 V, set on bench-supply
    collapses) latches on one purge. DESIGN RULE: the discriminator is DURATION,
    not threshold. Built on the operator brief's WORKING FIGURES, every constant
    TODO(calibrate) against the bench K-command log (WORK_QUEUE 0i-1 is the gate):
    - FAULT_UV_FC: LIMIT_V_FC_MIN 6.0 -> 4.5 V, UV_FC_DWELL_LATCH_MS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
2026-10-30 docs: regen-enable redesign brief — decouple REGEN_ENABLE from charge_goal, gate on an estimate of available regen power
    Design brief (not a firmware version) written against fw v30. Records the
    current chargingControl() behaviour, the motor physics behind a
    regenPowerEstimateW(v, i_cmd) gate with hysteresis/dwell/rate cap, the
    first-round rule that an open FC charge window is not pre-empted by a brake,
    the full requirement list for reversing that rule later, interface and
    tools-mirror notes, the bench measurement that calibrates the constants, and
    the items to re-check when the PhD student's branch lands.
    Claude-Session: https://cl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
2026-11-04 fw v30 (student build): forward-declare busBringupFail()
    FW_VERSION stays 30. The only change from the committed v30 is one forward
    declaration of busBringupFail() ahead of its first use, the sketch as the
    student built it in the Arduino IDE (student folder Code/Teensy/teensy_controller/).
    Headers (drive_/share_controller*.h) are byte-identical to the committed ones
    in every student firmware folder, so only the .ino changes in this series.
    Host-native tests at this commit (test/, unmodified):
    run_tests 4563/0 fail, run_tests_bench 210/0, run_tests_hil 4870/0, run_tests_encoder 51/0 - all pass.
    Imported from origin/phd/siddhesh-2026-11-03 (64fb553).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
2026-11-04 fw v31 rev a (FW_VERSION still 30): regen-only charging policy, early-out branch
    Adds FC_CHARGE_ALLOWED (0): charge_goal may open the REGEN path only; the
    FC->charger harvest branch of chargingControl() is skipped by a new
    'else if (!FC_CHARGE_ALLOWED)' branch that holds the charge_goal==0 terminal
    state (FC_CHARGE off, REGEN low, MPPT inhibited, BT re-closed unless shareSpCutBT).
    Superseded by rev b: the early-out skipped assertFcChargeEnable(true), which
    also restores FC_BUS / clears shareSpCutBT, so a latched share cut left both
    bus switches open (source-less bus -> UV_BUS; bench 2026-10-27).
    Student folder: Code/Teensy/teensy_controller_V31/.
    Host-native tests at this commit (test/, unm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
2026-11-04 fw v31 rev b: FC_CHARGE_ALLOWED gates only the assertFcChargeEnable(true) call
    FW_VERSION 31. Removes rev a's early-out branch; FC_CHARGE_ALLOWED now gates
    the single conduction-gated assertFcChargeEnable(true) in the cruise branch,
    so the fw v28 F1 disarm-before-open, the REGEN close and the fw v24 MPPT
    holdoff still run. Boot banner prints FC_CHARGE_ALLOWED.
    Student folder: Code/Teensy/Teensy_v31b/.
    run_tests 4553 pass / 10 FAIL, run_tests_bench 210/0, run_tests_hil 4860 / 10 FAIL, run_tests_encoder 51/0. Failures: 9 FC-charge-path tests (FC_CHARGE_ALLOWED 0) + 'pin: FW_VERSION == 30'.
    Imported from origin/phd/siddhesh-2026-11-03 (64fb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
2026-11-04 fw v31 rev c: restore BT_BUS in the cruise branch when FC charging is suppressed
    With the assertFcChargeEnable(true) call gated off, the cruise branch was the
    only chargingControl() branch without a BT_BUS re-close, so a share-selector
    cut on BT was never undone while the Pi held charge_goal up with no braking
    current -> source-less bus -> ERR_UV_BUS (bench 2026-10-27, SDP EMS).
    Adds 'else if (!FC_CHARGE_ALLOWED) { if (!shareSpCutBT) writeBusSwitch(BT_BUS_ENABLE, HIGH); }'.
    Student folder: Code/Teensy/Teensy_v31c/.
    run_tests 4552 pass / 11 FAIL, run_tests_bench 210/0, run_tests_hil 4859 / 11 FAIL, run_tests_encoder 51/0. Failures: FC-char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
2026-11-04 fw v35 (flashed on the board): FC charge-window safeties and the purge-lockout gate
    FW_VERSION 35. Carries the student's fw v32a and v33b work; no separate
    v32-v34 sketches were committed (student README: v31-v34 superseded).
    - v32a: FC_CHG_ENTRY_V (= V_BUS_CHARGED_THRESH), FC_CHG_MAX_MS 30 s dwell limit
    with lockout, FC_CHG_COOLDOWN_MS 2 s; window open/close stamps.
    - v32a: busHotPlugUnsafe() guard on the window-close BT re-close (Death-5).
    - v32a: the refused/closed window is now explicitly shut (FC_CHARGE off, REGEN
    low, guarded BT re-close); this replaces the v31c branch.
    - v33b: a charge window also requires !fcUvLockoutActive() (H-20 purge ->
    UV_FC + UV_BUS pair latched on the be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
2026-11-04 fw v36 (NOT FLASHED): ungate regen from charge_goal
    FW_VERSION 36. regenActive (current < -0.1 A) is hoisted above the
    charge_goal <= 0.05 early return, which now also requires !regenActive, so a
    run that never raises charge_goal can still arm REGEN_ENABLE
    (rosbag_sweep-noclip_2026-10-30_01-30-16: charge_goal 0/4033 samples,
    REGEN_ENABLE high 0/10081 across six wheel-locking decelerations).
    The regen branch closes an open FC charge window (cooldown stamp) and its
    BT re-close gains the busHotPlugUnsafe() guard.
    Student README: not flashed; v35 is on the board.
    Student folder: Code/Teensy/Teensy_v36/.
    run_tests 4553 pass / 10 FAIL, run_test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
2026-11-04 firmware_archive/: the student's pre-board sketches and the fw v19 sketch
    Byte-for-byte copies from phd/siddhesh-2026-11-03 (64fb553):
    - pre_board_Scale_Car_Teensy/ - the original stale (BQ25690-era) sketch
    - pre_board_Scale_Car_Teensy_Sid_2026-04-21/ - the student's 2026-04-21 fixes
    - fw19_sketch_aug25a/ - FW_VERSION 19, the only fw v19 source in git
    Kept out of teensy_controller/ because the Arduino IDE compiles every .ino in
    a sketch folder. The student's duplicate controller headers (identical to
    teensy_controller/) are not duplicated; README.md explains.
    Claude-Session: https://claude.ai/code/session_012EEAHmHf6xakjd3uHQnPYE
2026-11-04 tools/rosbag_analysis/: the student's rosbag analysis scripts, verbatim
    From phd/siddhesh-2026-11-03 (64fb553) scale_car/Analysis/: overview and power
    plots (fchev_plot.py, plot_power.py, plot_ab.py), SDP / regen / wheel / noise
    checks, the FC and P_demand fits, the TPM and cost-to-go generators and their
    newbuild .mat outputs. Usage: python3 <script> <bag directory>; the readers
    need mcap_ros2 (fchev_plot.py --csv writes the per-topic CSVs the csv-based
    checks read). The path defaults are updated in the next commit.
    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
2026-11-04 logs/rosbags/: the student's Pi rosbags, plots and FC voltage captures
    22 ROS 2 bags (.mcap + metadata.yaml, some with csv/ topic dumps) from the
    2026-09-07 to 2026-10-30 bench runs (sweep / clip / no-clip / simple / SDP
    EMS), the student's PNG figures (plots/) and two fuel-cell voltage .mat
    captures (fuel_cell_v_plots/), byte-for-byte from phd/siddhesh-2026-11-03
    (64fb553) scale_car/Logs/. ~77 MB.
    README.md indexes every bag (type, duration, /vehicle_state count, size) and
    records that the firmware version is NOT in the telemetry; it lists the dated
    firmware references that bound which build ran which bag, and the student's
    open items (no regen charge current; FC not delivering power as of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
2026-11-04 docs/firmware-versions.md: ledger rows 31, 32-34, 35, 36 for the student's line
    One row per imported version (fw v31 with its revs a/b/c, the uncommitted
    v32-v34, v35 = flashed, v36 = not flashed), each with the change, the host
    test result at that commit, and the flash status from the student README.
    Records that v31 rev c's BT re-close is unguarded (a hot-plug-guard test
    fails; v35 restores the guard). docs/operations/README.md: attribute the Ops
    Guide 2.4/9.4 caveat to the launcher header.
    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
2026-11-04 CLAUDE.md: addendum for the 2026-11-04 import of the student's fw v31-v36 line
    Records that the tree tip is fw v36 (not flashed; the board runs v35), the
    failing-test status the student left, and where the imported Pi software,
    analysis scripts, rosbags and docs now live.
    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
2026-11-04 fw v36 review + rosbag regen analysis: review record, figures, fw v37 proposal; skill conventions extended
    Six-agent round (regen chain, safety, tests; regen bags, faults, sweeps). WORK_QUEUE 0k
    carries the bench gate, rulings and the fw v37 round. Corrects the rosbags README's 10-28
    charge-window account (no bag shows one).
    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
2026-11-04 fw v37 planning record (draft): rulings, charger power answers, regen response-time measurement, telemetry v5 proposal, BLG/rosbag pairing
    Section 6 (encoder/noise) pending the running analysis.
    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
2026-11-04 fw v37 planning: R3 no bus-fed charging (three-layer regen interlock), RTC pairing layer dropped
    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
2026-11-04 fw v37 planning: section 6 - current noise is rotation-locked loop ripple; bad tooth real in Aug BLGs (178 counts/rev), absent in Pi bags; SD capture plan and decoder options
    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
2026-11-04 tools/rail_spectral: voltage-rail spectra vs flywheel speed over the bench logs
    Spectral study of every logs/*.BLG (fw v8+, non-HIL): 2 s windows, rotation
    rate from encoder_pos, order-tracked spectra against the drivetrain orders
    (tire 2.309, intermediate 6.56, motor 15.84), tone tests against a
    speed-shuffled null, ripple vs speed/current correlations, three figures.
    - blg_arrays.py: vectorised BLG reader sharing decode_benchlog's record
    constants and end-of-data rules (trailer, bad step)
    - rail_spectral.py: CLI; writes report.txt + figures to logs/rail_spectral/
    (git-ignored); optional --cache for the ~1 GB of window spectra
    - test_rail_spectral.py: stdlib self-test (80 checks): load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
2026-11-04 docs: record the fitted motor's pole count (Castle 1406, 4 poles / 2 pole pairs)
    VESC_MOTOR_INTEGRATION.md still described the Traxxas BL-2s as the motor and
    the pole count as [measure], although the Castle 1406 1900 KV was fitted and
    its 2 pole pairs confirmed on 2026-08-15 (lambda cross-check in
    controller_design_MIMO/calibration/motor_id_20260815.md).
    - status line and section 8: motor decision resolved, section kept as record
    - section 2: BL-2s marked no longer fitted; new "Motor as fitted" table
    - section 4: Motor Poles should be 4; the x2 RPM-display artifact implies
    the VESC Tool field is still at the wizard default 2 (inferred, to verify)
    - section 9: pole count settled; ERPM-cap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
2026-11-04 Planning: fw v37 scope (v35 + lower-crossover drive law + State-98 Ag105 commissioning key); Schmitt buffer recorded as fitted; rail_spectral merged
    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
2026-11-04 fw v37 base: restore teensy_controller.ino to fw v35 (ab4a705, the flashed build)
    fw v36 (7588ed3, never flashed) is excluded from v37 by operator ruling R3: its
    regen un-gating makes the bus-fed charger path live on every run. v37 = v35 plus
    one control-law change (lower drive crossover) and a State-98 Ag105 commissioning
    key, so the current-noise reduction can be measured in isolation.
    docs/fw37_planning_2026-11-04.md section 9.
    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
2026-11-04 fw v37 (WIP, stage 1 of the orchestrated round; tests and review pending): lower-crossover drive law + State-98 'J' Ag105 commissioning key
    Drive controller re-synthesised with the Wp corner 60 -> 12 rad/s (Wu unchanged): achieved
    crossover 17.25 -> 6.55 rad/s, PM 50.2 -> 58.1 deg, worst-corner ||S|| 2.87 -> 1.48, rotation-band
    |C*S| 0.41/0.33/0.29/0.28 of v35 at 2.1/3.1/4.6/5.6 Hz. ALL GATES PASSED (crossover band re-scoped
    to 5-30 rad/s by operator ruling; new |C*S| <= 0.5x gate); validate_drive_siso.py 17/17.
    'J' line prompt: start/stop a bench-attended charger session fed from the bus through MOT_PWR +
    REGEN, auto-config inhibited, round-robin register reads at 10 Hz, operator-commanded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
2026-11-04 fw v37 tests (stage 2): re-pin the FC_CHARGE_ALLOWED 0 checks, FW_VERSION 37, replay-tail ULP floor, 'J' key coverage
    - 9 FC-charge-path checks re-pinned to ALLOWED 0 behaviour with setup checks that every other
    window-entry condition holds (mutation: ALLOWED=1 fails 15 of them).
    - Replay 'regen' tail check: max(0.1*worst, 1e-5 A) floor; v37 vectors carry 1 ULP in the tail.
    - reset_test_state() resets the v35 window timers and every ag105Comm* global.
    - 13 test_j_* functions (~190 checks): prompt, start refusals, start, auto-config inhibit with a
    non-vacuous control, profile/threshold writes, MPPT toggle, bounded I2C + 10 Hz monitor,
    ownership refusals, every stop path, the State-99 ab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
2026-11-04 fw v37 (WIP, stage 4 fix round from the safety review; 15 fixture checks pending in the test stage)
    Accepted safety findings: the 'J' session refuses C, 1 2 3 6, A V P O and N writes; start
    requires CBAL_DISABLE LOW (cell OVP active), manual motor off and power-balance not live; stops
    on a 3S profile in reg 0x01 (Table 3 values 9-12) and on V_bus under V_BUS_CHARGED_THRESH for
    20 ms; latches as-found register values and warns (with the restore line) if a below-bus reg 0x02
    threshold is left behind; NAK back-off to 100 ms; worst read time and first-500 ms V_bus/V_chg/
    V_rgn extremes in the summary; MPPTD-LOW semantics marked TODO(verify: Silvertel). New 'J 1 2'
    start-and-fix: writes the 2S/2.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
2026-11-04 fw v37 tests (stage 4): fixture repairs and coverage for the safety-review fix round and 'J 1 2'
    Fixtures tick the session's own round-robin reads (no poking as-found flags). New: refusal
    before the as-found latch; 1 2 3 6 C A V P O and N-write refusals; CBAL / manual-motor /
    live-share start preconditions; the 3S reg 0x01 stop; the 20 ms V_bus dwell (boundary, re-arm,
    NaN); as-found latch and the restore warning; NAK back-off and worst read time; first-500 ms
    extremes; '1 2' start-and-fix. mock_wire.h gains an optional requestFrom hook. 15 mutations,
    all caught. Counts: 4821/0, bench 210/0, hil 5130/0, encoder 51/0, 0 warnings.
    Claude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
2026-11-04 fw v37 (WIP, stage 4 fix round 2 from the correctness review; 5 message-text checks pending in the test stage)
    'J' session: fw-version NAK no longer starves the round robin (one retry, then skip); '1 2'
    advances only on ACK until 0x00/0x01 latch, keeps the 0x01 exemption until the fix runs, and
    reports 'never wrote the profile'; the live ACK releases the NAK back-off; 'J 3' warning keyed
    on LIMIT_V_BUS_MAX with V_bus/V_chg; as-found latch times; out-of-range reg 0x01 worded apart
    from 3S; 'EPROM write attempts'; U/E/I refused, VESC watch turned off at start. Docs: v37 gain
    figures where comments state current behaviour; |S| wording (the reduction is all |C|); WC=8 is
    slow convergence, not hu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
2026-11-04 fw v37 (PENDING FLASH): final tests round 3 and docs - ledger row 37 counts, planning/WORK_QUEUE status, CLAUDE.md addendum
    Tests round 3: re-pins for the correctness-review fixes; fw-version retry, '1 2' hold-on-NAK,
    live-ACK back-off release, fix-window exemption, as-found ms, U/E/I refusals, parser variants,
    '3 0' and the FAIL path, settle boundary, full restart reset. Final: run_tests 5027/0,
    run_tests_bench 210/0, run_tests_hil 5337/0, run_tests_encoder 51/0, 0 warnings (fresh binaries).
    Orchestrator check: every Run-path function code-identical to v35; the 180 deg encoder case
    still flips once.
    Claude-Session: https://claude.ai/c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
2026-11-04 HIL drive-ripple scenarios (stage 1 of the orchestrated tooling round; tests and review pending)
    tools/drive_ripple.py (new): drive-controller header parser, frozen v35 coefficients, C(z)/S/T
    predictor around the HIL plant's own mechanics with the measured loop latency (1.5 ms nominal),
    tick-exact closed-loop simulator (predictor agrees within 1.1 %), revolution-locked lock-in,
    step metrics. hil_plant_sim: opt-in measurement-ripple (encoder artefact) and force-ripple hooks
    locked to the flywheel angle; off = byte-identical streams and an unchanged constants_hash;
    v_true/fly_theta CSV columns only on the ripple scenarios; drive-ripple-meas (0.020 m/s) and
    drive-ripple-force (1.0 N), 67 s: hol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
2026-11-04 HIL drive-ripple (fix round from the data-integrity review; new tests pending)
    Latency budget re-derived: the simulator's delay mapping is (d_in+d_out)*dt (predictor vs
    tick-exact simulation now 0.022 %), nominal 1.0 ms, band [0, 3] ms, the board's controller-period
    jitter 2.0-2.1 ms modelled; ~4.3 % accounted against +/-15 %. The scored discriminator is
    documented as a plant-hook + loop-gain check (needs v_true; not a bench discriminator) and a
    report-only bench-transferable bus-current 1x signature is added. Law identification needs >= 3
    holds and a within-tolerance majority ('matches NEITHER law' otherwise); header parsed once, sha256
    of the scored law recorded; sidecar drag/ripple config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
2026-11-04 HIL drive-ripple tests: test_drive_ripple.py (67) + 36 plant + 73 suite tests
    Invariance (simple and hi-fi, bit-identical with the hooks off or at zero), constants exclusion,
    config validation, sub-V_STICTION gating incl. a phase-pi/2 breakaway case, theta rate/wrap, exact
    measurement-hook algebra with untouched true mechanics, force-hook dv per tick, CSV/sidecar
    conditionality, scenario geometry and the import-time validator, header parser and its 9 error
    cases, frozen-v35 bit-identity to ab4a705 + digest, predictor identities, predictor vs tick-exact
    simulator within 0.2 %, lock-in, step metrics, suite scan/judge on synthetic closed-loop CSVs for
    both laws and both hooks, band edges, law i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
2026-11-04 HIL drive-ripple (final fix round from the contract review) + close-out docs
    ripple_config_consistent FAILs 'NOT VERIFIED' when the run's sidecar is unreadable; the NEITHER
    verdict carries per-hold deviations and four next steps; the summary row shows 'law: repo OK /
    v35-like / NEITHER / unmeasured'. Docs: HIL_USER_MANUAL section 5 'Running a subset' (globs,
    registry order, the fast-set and ripple-pair commands, stale counts fixed), HIL_SCENARIOS section
    6a (drive-law scenarios), HIL_MODE / HIL_PLANT tables, clamp-reachability claim qualified,
    hil-agent-analysis conventions note. CLAUDE.md addendum line; WORK_QUEUE 3b/3c.
    Tests: test_run_hil_suite 814 + 1 xfail, test_drive_ripple 67.
    Co-Aut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
2026-11-04 fw v37 first HIL session (hil_report_20261104_125053): ripple amplitudes and step metrics
    9-leg subset on the HIL Teensy (fw v37 + local HIL_SIM 1, not committed): 8/9 PASS,
    comm-loss = the standing sim artefact. Drive-ripple legs law: repo OK, current 1x within
    0.22 % of the repo-law prediction; step 0->2 m/s settle 1.82 s, overshoot 8.6/9.2 %.
    Recorded as a note on docs/firmware-versions.md row 37 and a CLAUDE.md addendum line.
2026-11-04 Telemetry v5 proposal: add main-loop rate fields (loop_hz_avg10, loop_dt_max_us)
    Operator request: record the Teensy's actual loop rate in every rosbag, not
    only in runs with an SD log. Planning doc section 4 and WORK_QUEUE 0j updated;
    proposed v5 size 73 B. Lands with fw v38.
    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
2026-11-04 fw v37 bench session: ML0226 analysis and the ML0227 J-session incident
    ML0226 (fw v37, BENCH_TEST 1, USE_ETHERNET 0; the card's ML0001, renumbered):
    the bad tooth is gone (180.00 counts/rev, matches the 1800/10-rev hand turn);
    the board runs the new drive law and the 1x current fell to 0.30-0.40x the old
    law at 1.0-2.0 m/s for ~2x the settle time; the open-loop shortfall is the
    linear drag model (rig follows F ~ 2.92 v^0.26 N). Planning doc section 10.
    ML0227 (the card's ML0002): the first 'J' '1' Ag105 session drew a 1 s ramp
    to ~11 A bus-side (~170 W) the charger did not report, once its output passed
    the pack voltage; the bench supply dropped out, BT boost 16.5 A, bus 6.84 V,
    FC channel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
2026-11-04 fw v37 rev 2: J session trip guards, reboot-only latch, VBat- charger-feed gate
    Hardens the State-98 'J' Ag105 commissioning session after the ML0227
    incident (docs/boost-bringup-debug.md, 2026-11-04). FW_VERSION stays 37.
    - G1: bus-side I_fc+I_batt > 1.0 A for 5 ms stops the session.
    - G2: V_bus*(I_fc+I_batt) - pre-edge baseline - min(P_chg, 21 W)/0.75
    > 3 W for 20 ms stops it (credit only on a live I_charge and a reg-0x05
    read within 200 ms).
    - G3: live GENSTAT 5/6/7 stops it, independent of BENCH_TEST.
    - A trip drops REGEN before MPPT, prints nothing before the pin writes,
    and sets a latch only a reboot clears.
    - AG105_VBATN_ISOLATED (default 0 on real boards, 1 under HIL_SIM): whi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
2026-11-05 fw v37 rev 2 flashed on the bench; post-incident G bring-up passes
    Ledger row 37, CLAUDE.md and the incident entry's safety rule now record rev 2
    as flashed 2026-11-04 (BENCH_TEST 1 / USE_ETHERNET 0, boot verified, gate
    CLOSED in 'S'). The incident entry adds the post-incident staged 'G' bring-up
    (PASS, operator report, no scope); open item: confirm the FC channel sources
    current under load.
2026-11-05 Re-spin power-architecture design note and the 1x drive-notch queue item
    docs/respin_power_architecture_2026-11-04.md: design discussion after the
    2026-11-04 J incident (Ag105 VBat- tied to GND by design) - charger-return
    options and the bidirectional-converter architecture. WORK_QUEUE item 3 adds
    the encoder-angle-referenced 1x drive notch (planning section 9.5).
2026-11-05 docs: BQ25713EVM-017 as an Ag105 replacement - feasibility note
    Datasheet (SLUSD83C) and EVM guide (SLUUBT8B) facts, wiring to the existing
    Ag105 pads, open issues (fail-safe off polarity, host-terminated charging,
    R3 threshold, I2C pull-up rail) and a bench plan.
2026-11-05 docs: charger replacement evaluation round 1 (Ag105 -> high-side-sense charger) + working material
    Round 1 of the multi-agent evaluation: board interface spec at the Ag105 pads, incident
    mechanism re-check, firmware blast radius, eight candidate dossiers with adversarial
    verdicts, the LTC4015 (DC2039A) wiring mockup and the re-spin comparison. Candidate-side
    numbers are UNVERIFIED (vendor datasheets unreachable this round); regen framing superseded
    by the operator's 2026-11-05 ruling that regen and FC charging are both hard requirements.
    Claude-Session: https://claude.ai/code/session_012EEAHnBrsh1uomxfToSB4n
2026-11-05 docs: V_rgn 0.85x measurement error - history, cause narrowing, chopper trip never reached
    New docs/vrgn_measurement_error_2026-11-05.md and tools/rgn_ratio_scan.py.
    - Pin 39 taps the TL431 chopper's own feedback divider (R1/R2-SNT, TL431 REF).
    About 31-33 uA is drawn off that node at 15.9 V. The ADC chain and previous-channel
    carry-over are ruled out (V_chg on the identical divider reads 0.994x; the V_rgn ratio
    is the same with V_chg at 0 V or 15.8 V).
    - Present since the first V_rgn log (TP0074, fw v5, 0.8365). 0.834-0.854 across 132
    BLGs and 21 Pi bags; falls with uptime (r = -0.80 to -0.97 in 7 of 8 sessions).
    No firmware or incident step.
    - Chopper: max reading 18.26 V = 2.05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
2026-11-05 docs: V_rgn record - resolve the 19.91 V trip figure (earlier R1-SNT 69.8k design; fitted 78.7k = 22.1 V)
    Claude-Session: https://claude.ai/code/session_012EEAHizSCW93HfJtiChrKs
2026-11-05 docs: V_rgn record - correct the resistive-leak bracket in section 5a
    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
2026-11-05 references: add Diodes Inc BZT52C series datasheet (DS18004; chopper gate zener Z-SNT, BZT52C12)
    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
2026-11-05 docs: V_rgn root-cause investigation - superlinear knee sink on the RGN-V node, TL431 REF path most likely
    Multi-agent investigation (8 investigators, synthesis, 3 adversarial reviews). The record is in
    docs/vrgn_measurement_error_2026-11-05.md section 7. Raw agent outputs and scripts are in
    docs/reviews/vrgn_rootcause_2026-11-05/.
    - Small-signal dV_rgn/dV_bus 0.48-0.65 vs static ratio 0.834-0.852, so the sink is superlinear.
    Every linear mechanism (resistor, contamination, ADC, firmware), the keeper and the swapped
    pinout are refuted.
    - Bus-dip I-V: knee 1.19-1.25 V at the node + 9.2-9.5 k; warm-up is a 3 % forward-junction
    shift with tau 5.4 min.
    - Ranked site: TL431 REF path (open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
2026-11-05 docs: charger replacement feasibility study round 2 (Path A on the current board)
    Round 2 against the operator rulings of 2026-11-05 (regen and FC charging both hard
    requirements; no circular loop / runaway as the true requirement replacing R3; the
    always-powered charger with a comparator-gated permit; MCU hardware watchdog recorded as
    required future work). Primary datasheets and EVM guides read for nine candidates;
    loop/runaway state analysis, regen dynamics from nine BLGs and the RegenTest_v2 bag,
    requirement matrices with adversarial reviews, full BQ25798 and BQ25713 designs, a
    verdict panel and a critic round.
    Verdict: UNDETERMINED - Path A credible, BQ25798EVM chosen, BQ25713EVM-017 r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
2026-11-06 docs: BQ25798EVM wiring design - work in progress (review loop interrupted by a container restart)
    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
2026-11-06 fw v37 noise round: rosbag analysis, share-ratio noise breakdown, re-spin noise notes
    Analyse the first fw v37 rev 2 Pi bag (rosbag_sdp_2026-11-05_20-09-52, from
    phd/siddhesh-2026-11-03 6b1ca57) against the matched fw v35 bag (10-30_01-49-38).
    - docs/reviews/noise_fw37_2026-11-05/: findings record, agent reports with
    adversarial verdicts, figures. Under matched windows the 1x line fell
    0.20-0.38x on every channel, share included; the SDP staircase and H-20
    purges hid it. The share loop rejects the 1x band (|S(4.6 Hz)| 0.26) and
    needs no bandwidth change; the remaining steady 1x share term is the
    governor minority floor 0.125/share_govTotAFilt. Firmware actions F1-F7.
    - docs/respin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
2026-11-06 docs: BQ25798EVM wiring design after review round 6
    Six review rounds (five lenses each, every serious finding independently verified)
    applied. The loop hit its six-round cap with round 6 still producing major findings
    (no blockers); the final independent audit did not run (account spend limit).
    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
2026-11-06 docs: record rulings 6-10 and the round-3 design consequences in the charger study
    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
2026-11-06 fw v37 noise round: before/after brief, 2-page PDF, V_bus droop decomposition
    - docs/reviews/noise_fw37_2026-11-05/BRIEF.md + figs/brief_*.png + make_brief_figs.py:
    short before/after write-up on one set of masks. 1x line 0.25-0.28x on I_tot,
    I_batt, I_fc, V_bus and the share (design 0.29); share 2-6 Hz 0.021 -> 0.010
    once purges and SDP command steps are removed.
    - pdf/noise_fw37_brief.{tex,pdf}: shareable two-page version.
    - README.md section 2.4 (new): V_bus is the droop image of I_tot at 1x only.
    |Z| 67 -> 73 mOhm at 1x (unchanged; ~0.2 of the design droop), 159 mOhm
    battery-only; in fw v37 I_tot explains 21 % of V_bus variance at 2-6 Hz and
    5-7 % above 6 Hz, so the remaining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
2026-11-06 fw v37 noise round: V_bus ripple vs switching noise and the RT1987 ideal diodes; 4-page brief
    - README section 9 (new): the remaining bag V_bus noise is mostly content
    above 23.8 Hz folded by the 21 ms snapshot (72-98 % of the snapshot
    variance on ML0226). Largest source: real bus current at the motor's
    6x electrical order (397 Hz per m/s, 600-1000 Hz at cruise, coherent
    with I_tot 0.94-0.99, |Z| 81-133 mOhm). TPS61288 ripple <= 1.2 mV per
    sample on V_bus; RT1987s add no measurable noise (regulated ~35 mV drop
    below ~1.75 A, ~10 mOhm incremental, no dropout or chatter). The loop
    and BLG run at ~875 Hz, not 1 kHz. PFM boundaries corrected to BT
    0.45 A / FC 0.57-0.75 A; inter-c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
2026-11-06 fw v37 noise brief: add the ML0226 V_bus spectrogram as Figure 5
    - figs/brief_vbus_spectrogram.png (make_vbus_figs.py): the switching
    agent's spectrogram regenerated in true units - the log's mean sample
    rate (876 Hz; ticks are bimodal 1128/1332 us), logged time, and the
    motor 6x electrical line (397 Hz per m/s x v_act) folded at 438 Hz.
    The original assumed a 1 kHz rate (455 Hz per m/s, folded at 500 Hz).
    - pdf/noise_fw37_brief: Figure 5 with a short paragraph; figures now
    float, headings tighter, RT1987/boost paragraphs and two conclusion
    bullets condensed so the brief stays at four pages.
2026-11-06 fw v37 noise round: the motor 6x line is back-EMF harmonic power ripple; 5-page brief
    - analyze_6x_scaling.py (+ figs/vbus_6x_scaling.png, vbus_6x_scaling_windows.npz):
    least-squares fit of the 6x bus-current line in 2 s windows of ML0226 on
    the logged timestamps (aliased line, irregular ticks), phase tracked from
    the smoothed speed, +/-12 rotation sidebands, noise-debiased.
    Result (294 windows, 0.3-2.0 m/s): line frequency 397.2 Hz per m/s
    (= 6 x f_e exactly); A6 ~ v^0.99 +/- 0.10 at fixed 4.2 A; A6/I rises
    1.5 -> 11.8 mA/A; k6 = A6/(P_mech/V_bus) constant at 0.12-0.13 above
    1.1 m/s. Supports non-sinusoidal back-EMF; rejects dead time and cogging
    as the main source. Current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
2026-11-09 docs: BQ25798EVM design walkthrough with simplified schematics
    A short guided tour of the round-3 wiring design: power path, why the
    BQ25798 / always-powered 19 V threshold / eFuse / D-BT-SQ choices, the
    permit logic and stop-pin drivers, operating modes with concurrency and
    purge pre-emption, and a ranked list of how the design can still fail,
    each tied to its registry test. Four new SVG figures.
    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
2026-11-10 docs: battery isolation feasibility study with the Ag105 kept (2026-11-07) and its review material
    FMEA battle-test rounds 1-8, brainstorm, calc scripts with outputs, and the IC1 detailed design.
2026-11-10 docs: BQ25798EVM wiring design r7 (round 4 carrier extension) - design phase, H.23 calc, in-place revision
    Round 4 lets the carrier extend past the Ag105 footprint: tab X and tab Y with
    feet FT1/FT2, the bottom clearance rule, the r7 polyimide sheet, the EVM plate,
    R276 on the E1 lead, E-lead maxima from the vector EVM figure, H.23 and the
    round-4 work notes. Review round 7 and the final audit follow.
2026-11-10 docs: custom BQ25798 charger board in the CHG footprint, design r1 (2026-11-10)
    Design document for a third charger path beside round-3 Path A and Path B:
    one board in the 22 Ag105 holes carrying the BQ25798 power stage, the
    round-3 carrier interlock and the EIB drivers. Mechanics, schematic and
    pin-level netlist, layout plan copied from the TIDA-050047 power stage,
    BOM with TI stock/price, firmware/IO proposals, test-registry delta,
    comparison and the 203-finding ledger. Revision r1 applies the 22
    findings of review run 001 (ledger in the review folder).
    Adds TI reference material under references/TI_BQ25798_design_files/
    (SLUSDV2C, SLUUCB5E, TIDA-050047 Altium project and Gerbers).
    Co-Au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
2026-11-11 docs: custom charger board design r2 - stationary testbench, board fan, no height limit
    Applies three operator facts (2026-11-10): the rig is a stationary
    testbench, a fan may be mounted on the charger board, and the board has
    no height restriction. Adds the forced-air thermal model (layout_calc.py
    section 8) and the tall-stack check (tall_stack_calc.py): fan-on junction
    78-90 C at 2.9 W on a 25 C bench, gap 5 mm minimum / 5-8 mm working,
    fan-off relies on the FR-50 TDIE trip, new soak test T-K-20 and
    measurements M15-M17. Supersedes the envelope rule, gate D-2 as a height
    limit, the gap pad, the T_MB,0 heater-step gate and the vibration items,
    kept as records. Records N-25: without the W1/W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
2026-11-11 docs: BQ25798EVM wiring design r7 - review round 7 fixes, D-H (no height limit), calc rev 4, closing sweep
2026-11-11 docs: custom charger board walkthrough README with figures; fix new-item count
    Expands the review-folder README into a guided walkthrough of the r2
    custom BQ25798 charger board design, with 12 SVG figures generated by
    figs/make_figs.py from the calc scripts' models (power path, top view to
    scale, side view and gap rule, block diagram, permit logic, floor plan
    and TIDA-050047 power cell, fan-on and fan-off thermal, electrical
    checks, cost/effort/schedule, test gates and the finding ledger).
    Corrects the design document's verdict: the CCB opens 27 new items
    (N-01 to N-27), not 24.
2026-11-11 docs: drop the stale new-item count note from the custom charger board README
2026-11-11 docs: charger-design final audit run 001 (Codex + verifiers + counter-review), round-4 review log and evaluation 0.1a summary
2026-11-11 docs: round-4 design walkthrough (r7) with plots and diagrams; TPS2663 datasheet; PCB toolchain notes and fab rules
    tools/pcb/ was written by the PCB toolchain setup session; committed here so the board-design session's worktree has it.
2026-11-11 docs: charger design r8 - apply final audit run 001 (13 findings) and CHG-R1-W01; calc rev 7; walkthrough to r8
2026-11-11 hardware: charger EVM r8 capture - netlist, generators, CR placement checkpoint
    Scripted KiCad 9 capture of the r8 BQ25798EVM charger design (B.8 netlist):
    project-local libraries, generated schematics (ERC clean), CR placement by
    fixed A.8 coordinates plus a raster packer under the bottom clearance rule.
    Includes the ordering BOM draft (unverified prices) and the land-pattern check.
2026-11-11 hardware: EIB routed (ERC/DRC clean); routing pipeline and finishing router
    EIB 24 x 38 mm 2-layer: Freerouting in three rounds plus a grid A* finishing
    router with rip-up; silkscreen kept clear of pads by library design.
2026-11-11 hardware: charger EVM r8 CR at 5/5 mil, DNP tiers 1-2, PathFinder router; handoff
    CR (4-layer): placement and power copper complete, ERC clean; signal routing
    not closed (best PathFinder run 29-35 of 95 nets in conflict). Operator
    rulings applied: 5/5 mil with 1 oz outer copper (new fab_4layer_5mil rule
    file), DNP tiers 1 and 2 removed. Fixes: U101 +y escape channel, pocket
    re-site, power-via placement keep-outs, VCHGOUT L1 corridor, inner-layer
    hole clearance, CHG pads off unused inner layers. EIB unchanged (complete).
    Decision log rewritten; HANDOFF.md gives the next session's starting point.
2026-11-11 tools: corridor-routing skill draft (plan corridors, check capacity, route inside them)
2026-11-12 tools: routing skills round 1 - three method skills, race orchestrator, scored plan-driven router
    Lessons from three dry tests (4-layer CR twice, 2-layer EIB) and a review of public
    KiCad routing skills. Router: grid at the fab pitch, board-edge clearance, hard pours
    with zone clearance, footprint keep-outs, via-to-hole and same-net via spacing,
    unflashed through-hole pads as obstacles, per-group width, layer cost, layer
    directions, reserved corridors, legalisation by connections lost, recovery pass,
    BLOCKED/CONGESTED diagnosis. Plan check: real pitch, shared channels summed, solo
    routability, crossings, congestion estimate. New: flows.py, score.py, autoroute.py
    (Freerouting), race.py, refer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
2026-11-12 tools: router - a net's own copper stays out of its unflashed through-hole pads; dru hole and edge floors
2026-11-12 tools: routing skills round 2 - pad-exit clearance, grid rule, thermal cost ring, fair score, seeds and keep-routes
    Lessons from twelve race workers on four boards (2-layer easy and hard, 4-layer easy and
    real). Router: legal pad start cells, polygon margin, quarter-pitch grid above 0.13 mm,
    GRID message, thermal-spoke cost ring, 20 iterations with patience and time limit, seeds,
    keep-routes, dangling-end pruning, priority-1 net table. Plan check: end caps, crossing
    corridors, gap message. Score: validity, violation and island positions, hard pours only,
    ground vias not charged. Freerouting gets the rules. Skill texts: corridors only at a
    baseline failure, direction by narrowest channel, noi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
2026-11-12 tools: two-phase routing race - request data, merge and what-if tests, placement relief stage, design intake
    Routing workers file requests as data with report evidence; the orchestrator merges them
    by place, tests net-removing requests by hold-out and part moves by relief workers on
    scratch copies (keep-routes with a legality check), and sends one ranked batch to the
    design owner, who returns placement variants. Placement relief is a shared stage after
    any routing method, not a fourth method.
2026-11-12 tools: routing options for every method - staged routing, finishing pass, routing order, layer assignment from crossings, global routing with guide corridors
2026-11-12 tools: fixes from round three - track runs break at junctions, kept vias checked on a moved board, site-limited rip-up, what-if baseline refilled and absolute paths
2026-11-12 skills: one board-routing skill replaces the three method skills; relief move limit 2 mm; plane via-site screen in the route report
2026-11-12 tools: plane-via step that ties ground fill pieces to the plane; apply_routes can add without removing
2026-11-12 tools: relief trial takes the refilled control board, argument order fixed, lost nets judged against the control
2026-11-12 skills and tools: request format with the move, frame and commit; intake steps for approved changes, packer side effects and verdicts
2026-11-12 docs: charger EVM r8 handoff - operator rulings 2026-11-11 (OSH Park, no via in pad, /3V3 to the PCB session, routing skills on main)
2026-11-12 hardware: charger EVM r8 CR - DNP tier 3 removed (U117, R160-R163, C127, C124; F23 pad without net), board rebuilt with pours
    DRC 200 unconnected (was 212), ERC 0, schematic parity 0, constraint check 0 FAIL.
    Placement PNGs not regenerated (matplotlib missing from the pcbnew venv).
2026-11-12 docs: charger EVM r8 overnight review skeleton
2026-11-12 hardware: charger EVM r8 CR - routing round 1 variants A/B (strap keep-out, grid re-pack), D-34/D-35, decisions
    Variant A: the VCHGOUT L4 strap outline is a bottom packer keep-out (R147.2 /QUAL was enclosed).
    Variant B: A plus tap/divider grid courtyards grown 0.225 mm. CR_PLACE_VARIANT unset rebuilds the
    5ddc21a placement unchanged (verified: 0 parts moved). D-35 scopes the A.8 divider-top rule.
2026-11-12 hardware: charger EVM r8 CR - D-35 amendment (fixed-pin exemptions, U105/U109 interim), checker rows for parked parts and the divider zone
    A placement variant keeping packer-placed logic out of the divider-top zone left U111 (then U105/U118)
    unplaced and was withdrawn; the three U105/U109 pads go to the operator.
2026-11-12 hardware: charger EVM r8 CR - strap keep-out adopted as default placement (D-34), round 2 results in the morning review
    The rebuilt base equals variant r1_A (0 parts moved): ERC 0, DRC 200 unconnected / 4 starved thermals /
    2 silk, constraint check 0 FAIL. CR_PLACE_VARIANT=BASE0 rebuilds the 5ddc21a placement.
2026-11-12 docs: charger EVM r8 morning review - branch state
2026-11-12 hardware: charger EVM r8 CR - interactive routing instance and the 2026-11-12 operator rulings (D-36)
    cr/interactive/ is the start board for the operator's interactive pass: adopted placement, round 2 r2_A seed 1
    routes and scripted GND plane vias (173/199 signal, 31 GND open), divider-top zones drawn on Cmts.User.
    D-36: decisions 1-6 approved, plain via in pad allowed, divider-top rule all-layer as a soft metric.
2026-11-12 docs: charger EVM r8 CR routability options (physical and functional), with claim verification
2026-11-12 docs: charger EVM r8 CR routability options - round 3 results (via in pad, soft divider metric)
2026-11-12 hardware: charger EVM r8 CR - D-37 via-in-pad order of use (no via in pad first; D-36 is the fallback)
2026-11-12 docs: charger EVM r8 CR - re-assessment of the plug-on outline and reflow-assembly change request
    Seven item analyses with independent checks; the r7 interactive pass is marked superseded.
2026-11-12 routing skills: fold in the CR study lessons; plane_vias unflashed-pad rule on by default
    plane_vias.py: a new via is kept off the unflashed layers of its own net's through-hole
    pads (Ctx.selfban), the change that was uncommitted in the main checkout as the opt-in
    --respect-unflashed. It is now the DEFAULT. The old behaviour stays reachable with
    --no-respect-unflashed (--respect-unflashed is still accepted). Reason: without it, plane
    vias beside J1.14/J1.15 made KiCad flash those GND pads on In2.Cu onto routed tracks at
    3 of 4 round-3 CR seeds; with it, the same seeds were valid and 1 via site in 8 runs was
    lost with no GND connection lost. Checked on a scratch copy of round-3 seed s2: the
    d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
2026-11-12 hardware/docs: charger EVM r8 - D-38 (r8-17): tap T22 and the BQ29200 pack-OV permit removed, pack OV moves to firmware
    Netlist: F08, R178, D108, R179, U123, U122, C134, C135 removed; ARM_OK drives both U114 inputs. ERC 0, schematic = cr.net
    (145 CR parts). Design doc r8-17 with independent review fixes; ordering BOM quantities updated. cr.kicad_pcb is stale
    until the next layout build.
2026-11-12 docs: charger EVM r8 - design state after the 2026-11-12 operator decisions, tap-review ramifications with independent checks
2026-11-12 hardware: charger EVM r8 - second-round decision records of 2026-11-12; r7-outline layout work moved to archive_r7_outline/
    The seven decision groups (gate, hang defence, firmware rules, EIB, parts and
    assembly, tap connector, process) are recorded under
    decisions_2026-11-12/round2/ with an orchestrator digest. cr/interactive stays
    in place until KiCad releases it.
2026-11-12 hardware/docs: charger EVM r9 - apply the 2026-11-12 decisions to the design doc, CR netlist, LAYOUT_DECISIONS and BOMs
    - Design doc revision r9 (change rows r9-1..r9-8): 10 taps, 5-LVC permit gate with
    U106A CE_DRV buffer, R5 hang defence, firmware rules (CHG_QUAL on pin 33), EIB DNP
    set, all-top SMT and 0603, J-TAP Micro-Fit 2x5, plug-on outline and fab rules.
    - CR netlist regenerated: 145 -> 78 parts, ERC 0 errors / 0 warnings; J102 J-TAP
    added; W6/W7 through-hole placeholder footprints; footprint library rebuilt.
    - LAYOUT_DECISIONS D-39..D-50 and Table 4 amendments; HANDOFF rewritten.
    - Ordering BOM 113 -> 100 rows; EIB assembly CSVs carry the DNP set; generator EIB
    list carries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
2026-11-12 docs: charger EVM r9 - progressive-detail review README (architecture to implementation plan)
    Block diagram first, then the 2026-11-12 change record (thermocouple and polyimide
    removal up front), concepts, permit gate, modes, firmware requirements, physical
    implementation, status, the D-50 round plan and the operator's open items.
    DESIGN_STATE gets a status note that the second-round decisions are applied.
2026-11-13 docs: charger EVM r9 - operator accepts the J-TAP T5-T10 diagonal (D-46, J.2 item 63)
2026-11-13 docs: charger EVM r9 - fix the r9-1 change-row annotation of the T5-T10 acceptance
2026-11-13 docs: charger EVM r9 - README figures as rendered images; T-F-16 retired
    - gen/readme_figures.py (matplotlib) renders figures/fig2_1_block_diagram and
    figures/fig5_1_permit_gate (SVG + PNG); the README ASCII block diagram is replaced
    by Figure 2.1 and the gate equations gain the logic diagram Figure 5.1.
    - Operator ruling 2026-11-12: T-F-16 retired. Design doc section I row withdrawn,
    new J.1 item 25 (MB VBT trace rise accepted unmeasured), J.2 items 45 and 72(a)
    closed; LAYOUT_DECISIONS D-43, HANDOFF, DESIGN_STATE and README updated.
2026-11-13 hardware/docs: charger EVM r9 - D-50 steps 2-4 (H re-run, audit run 002, plug-on generator); IO CSV 2026-11-12 applied
    Step 2 (r9-9): round4/calc/r9_calc.py re-derives section H against cr.net (r3/r7 scripts kept
    as the r8 record); new H.24 ribbon-short, EN-level and CSV-figure checks.
    Step 3 (r9-10): audit run 002 adjudicated (run-002-2026-11-12.md): 0 blocker, 8 major, 21 minor;
    Table L.9-1 final. No fix applied; fixes await check-in 2.
    Step 4 (D-51, D-52): new-outline generator (mb_brd.py, cr_geometry.py, layout_cr.py rewrite,
    CR constraint rows, 0.25 mm courtyards); height survey closed by operator ruling; the CR -x edge
    clears J-BT by 2.200 mm and J-BL/J-FC by 2.454 mm.
    IO CSV (operator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
2026-11-13 hardware/docs: charger EVM r9-12 - audit run 002 fixes applied and verified; CR netlist frozen (D-53)
    All 29 run-002 fixes applied (operator approval 2026-11-12); check-in 2 rulings R1-R6 taken as
    orchestrator defaults. R131B/R132 100 ohm -> 4.99 kOhm (R9.H24(d): a ribbon 9-10/8-9 short no
    longer browns out the CR rail). J-TAP map kept in this commit (no zero-severity-3 map exists).
    cr.net regenerated: 78 parts, ERC 0/0, footprints on the 0.25 mm courtyard basis.
2026-11-13 hardware/docs: charger EVM r9-13 - J-TAP re-map (T6-T7b and T5-T17 removed), netlist re-frozen
    Map A: T2 T17 T17r T5 T13 / B: T6 T1 T7b T16 T10 (four cavities moved). Severity-3 pairs 3 -> 1
    (T7b-T17 kept, guarded by the FR-11 lead-alive rule); weighted sum 25.0 -> 21.5. Orchestrator
    default overriding the r9-12 R1 fallback; reversible. cr.net ERC 0/0, connectivity changes only
    at J102.
2026-11-13 hardware/docs: charger EVM r9 step 5 - placement variant B selected (D-54); r9-14 J-TAP polarization statement corrected
    Two variants built on the frozen netlist; plain-plan probe at 2 seeds: B ties A on connections
    (106/107) with 35 % less track and 12 % fewer vias. Independent placement review
    (cr/placement_review_r9.md): 1 blocker (+x pocket empty; U101 network packed across the CHG
    column), 4 major, 9 minor - fixed in the next round.
2026-11-13 hardware: charger EVM r9 placement fix round (D-55): U101 network in the +x pocket, paste window panes, pre-vias off C102b, OSH Park-only rule file
    Re-review (cr/placement_review_r9b.md): the M-3 VCHGIN_L1 extension seals four U101-network
    pads (probe 103/107 at 4 seeds); fixed in the next round.
2026-11-13 hardware: charger EVM r9 placement fix round 2 (D-56): pour seal removed, In2 strap widened to 3.645 mm (R9.H25), C103 ground via, escape checks
    Plain-plan probe at 4 seeds: 107/107 at every seed, valid before and after plane vias, 0 sealed
    pads (cr/probe_d56.md). Ready for the route-race (step 6).
2026-11-13 tools: SMD via ban keyed on the pad itself (review N-5); plane-via keep-out follows the plan's via_in_pad
    board_model.py marks every pad item with "drilled" (the pad has its own hole). core.py bans a via on a pad
    without one; keyed on (ref, number), the U101.25 exposed pad escaped the ban because its nine thermal vias are
    holes numbered 25. Models without the field fall back to the old key. smd_ban_test.py asserts that no legal via
    cell lies inside any banned SMD pad grown by the via radius and mask margin, and names U101.25 by default: it
    passes with this change and finds 802 legal cells in U101.25 with the old core.py on the r9 CR model.
    plane_vias.py: the D-55 SMD keep-out now admits the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
2026-11-13 hardware: charger EVM EIB package regenerated from the DNP attributes (fab/eib_2026-11-13); copper identical to 2026-11-11
2026-11-13 hardware: charger EVM r9 C102c ground pad pre-via and strap extension (D-57, route-race R9-01)
    Route-race round 1 found C102c.2 /GND open at every seed of every plan: the
    /N_UV track U101.6 -> R102.2 encloses its L1 fill piece and the In2 VCHGIN
    strap left no plane-via site.
    - /GND pre-via (42.30, 59.30) plus a 0.4 mm F.Cu track to C102c.2; annulus
    gaps 0.195 / 0.239 / 0.330 mm to C102c.2 / C102a.1 / R102.2 (D-37 clear).
    - VIN_L3 extension box(41.95, 57.00, 44.00, 58.50): strap minimum section
    4.174 mm (was 3.630 mm on the same measurement; R9.H25 needs 3.221 mm).
    R9.H25 row added: 2.75 A at 10 degC.
    - Placement, netlist and signal ratsnest unchanged.
    - DRC 124 silk / 107 unconnected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
2026-11-13 hardware: charger EVM r9 CR routed (route-race R9, plan softum seed 1 on the D-57 board)
    Signal routing of the CR on the D-57 board (0e7f22b): 107 of 107 connections, /GND closed by the plane-via step
    (0 open). Plan softum = the D-56 probe plan plus the divider-top soft zones on F.Cu and In2.Cu (reserve 30, /3V3
    and the analog groups exempt), /N_UV, /N_OV, /N_DVDT and /N_ILIM at via cost 200, and rules.mask_margin 0.075 mm.
    The default 0.05 mm round margin left two router vias 0.0045 mm inside the square-cornered mask openings of U106.1
    and U118.8 (check_constraints D-37 row); 0.075 mm clears them (smallest gap 0.027 mm).
    Seed 1 of 4: 148 router vias, 830.8 mm of track, divider-top same-lay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
2026-11-13 hardware: charger EVM r9 CR routing recorded (D-58) and reference designators placed (D-59); DRC 0
    - D-58: route-race r9 plan softum (softu + mask_margin 0.075) seed 1 on the
    D-57 board: 107/107, 148 router vias, 830.8 mm; merged from
    charger-evm-r9-route (621fb28).
    - D-59: gen/silk_refs.py places 60 of 78 references on F.Silkscreen at
    1.0 / 0.8 mm (26 over another courtyard); 18 move to F.Fab. The 124
    silk DRC items clear.
    - DRC 0 violations / 0 unconnected / 0 parity; constraint check 98 pass,
    0 FAIL.
2026-11-13 hardware: charger EVM r9 CR fabrication package (fab/cr_2026-11-13), not ordered
    gen/export.sh cr 2026-11-13 on 6ae73df: ERC 0, DRC 0 violations / 0
    unconnected / parity checked. OSH Park preset complete. KiKit jlcpcb and
    pcbway --assembly wrote no bom.csv (int() parse error); the README says so
    and points to assembly/cr-bom.csv. fab_readme.py gains the CR status line.
2026-11-13 docs: charger EVM r9 morning review (2026-11-13): CR routed, DRC 0, fab package not ordered
2026-11-13 tools: via ban on the square-cornered solder-mask opening of SMD pads (router, score, test)
    The router and score.py kept vias a round 0.05 mm (rules.mask_margin) from SMD pad copper. KiCad grows a
    rectangular pad's mask opening to a rectangle, so its corner lies expansion x sqrt(2) out: on the r9 CR board
    (expansion 0.0508 mm) plan softu seed 2 put two own-net vias 0.0045 mm inside the openings of U106.1 and U118.8.
    KiCad DRC and score.py passed it; only gen/check_constraints.py row D-37 found it.
    - board_model.py: each pad item carries mask_exp, the pad's mask expansion on its layer (0 without a mask).
    - core.py: the SMD via ban is the pad grown by max(mask_exp, rules.mask_margin) with squ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
2026-11-13 docs: charger EVM r9 D-58 and morning review record the mask-corner via ban (114ad04)
2026-11-13 skills: routing lessons of the r9 CR race (quality comparison, enclosed plane pads, crossing nets, branch delivery)
    board-routing: soft-zone groups keep an explicit mode (route only exempts them from the reserve cost); the via
    ban covers the square-cornered mask opening and old models must be rebuilt; smd_ban_test.py after the capacity
    check; via cost 200 for high-impedance nets, not on a net that must cross another; the project's constraint check
    on the reported board; finish seeds one after another; when the plain plan closes, plans are judged on quality
    measures at every seed and the applied seed is chosen by plane-net opens, then vias; enclosed plane-net pads and
    topological crossings ar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
2026-11-13 docs: charger EVM r9 morning review - the 0.027 mm via gap is same-net (smallest different-net gap 0.115 mm)
2026-11-13 hardware: charger EVM fab READMEs - CR rule file is the OSH Park-only file; EIB is a separate order; section numbers
    Copper, drill and assembly files unchanged; only the generated READMEs.
2026-11-13 tools and skills: final routing step - trimmed outline with corner mounting holes (trim_outline.py)
    trim_outline.py proposes a trimmed board outline after routing: the convex hull of the used area (courtyards, pads,
    signal copper, local pours, grown by a margin), any --ear boxes kept for a mechanical reason, and four corner
    mounting holes, clipped to the present outline (it never grows). Each hole is the least-area site within a window
    of its corner whose copper keep-out clears the used area and whose screw-head disc stays on the board; defaults
    suit 6-32 (drill 3.7, head 3.6, keep-out 4.0 mm). --flip-centre / --flip-block report the overlap of the outline,
    turned 180 degrees, with blocks th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
2026-11-13 tools, skills and CR board: GND stitching vias and a straightening pass in the finish step
    Operator requests of 2026-11-13 (relayed by the operator's side session): straighten staircase tracks where it
    does not matter ("it doesn't all have to be perfect"), chosen over a bend cost in the search; via stitching for the
    ground plane.
    - plane_vias.py --stitch PITCH (opt-in): vias of the plane net on a grid inside its fill, at the nearest legal site
    within PITCH/2 of each uncovered node, with the plane-via site rules (routed copper, holes, SMD pads and mask
    openings, unflashed pads, keep-outs); the report counts the nodes without a site.
    - straighten.py: on the finished board, replaces runs o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
2026-11-13 docs: charger EVM README, HANDOFF and LAYOUT_DECISIONS status brought to the routed CR (D-57 to D-59, packages, order blockers); item 18 closed (TI SCES487I), item 24 closed (r9-12 R2)
2026-11-13 hardware: charger EVM r9 CR trimmed outline and four 6-32 holes (D-60, route-race R9-02); package re-exported
    Operator rulings 2026-11-13 (given to the routing session): trim the unused
    area, non-rectangular outline allowed, 6-32 corner holes for a printed
    support, +x key ear kept, design owner implements in the generator.
    - gen/cr_geometry.py: FINAL_OUTLINE (18 vertices, 2241.6 mm2), KEY_EAR,
    MOUNTING_HOLES MH1-MH4 (NPTH 3.70, keep-out r 4.0, head r 3.6); D-41 key,
    D-51, CHG and TSW rows measured on the trimmed outline.
    - gen/trim_cr.py: applies them through trim_outline.py; refuses on > 0.01 mm
    difference. D-39 rectangle stays the placement frame.
    - check_constraints: D-60 outline an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
2026-11-13 skills: finish order on a trimmed board - trim, then stitching, then straightening, then silk
2026-11-13 docs: charger EVM README, HANDOFF and morning review brought to D-60 (trimmed outline, 6-32 holes, 19 F.Fab references)
2026-11-13 skills: trim before stitching in every finish-order statement (D-61); delivery copies board_pv, then trim, stitch, straighten, gap fill
2026-11-13 docs: charger EVM README, HANDOFF and morning review brought to the final D-61 board (stitching, straightening, gap fill; 109 pass, 0 FAIL)
2026-11-13 hardware: charger EVM CR J102 fields per operator ruling (Review 1/2): MPN 43045-1012, cable Molex 2147561101
    Operator ruling 2026-11-13 (Review 1/2): 43045-1012 confirmed against the Molex
    43045 PCB layout; the J-TAP cable is 2147561101 (female), not 2147581101.
    netlist.py fields -> schematic regenerated (only the two J102 fields change),
    ERC 0, netlist exported; gen/sync_fields.py copies MPN/Note onto the board.
    DRC 0 / parity 0; no copper change. fab/cr_2026-11-13 re-exported (BOM shows
    43045-1012).
2026-11-13 tools and skills: trimmed outline with limited edge angles and filleted corners (operator rules 2026-11-13)
    Operator: keep the trim rectilinear or at 30, 45 or 60 degrees; fillets on the corners are good; a fab charges for
    the enclosing rectangle, so the inner trim is for looks and for more of the MB exposed below.
    trim_outline.py --angles A,B,... builds the smallest convex polygon with edges in those directions (mod 180) that
    holds the used area, the ears and the screw heads: the intersection of the supporting half-planes of the hull. A
    slanted edge shorter than --min-edge (default 2.0 mm) is removed by dropping its half-plane. The hole search uses the
    same polygon. --fillet R rounds each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
2026-11-13 docs: Review 1/2 operator rulings recorded (J102 43045-1012 and cable 2147561101; CR J1 TSW 1.1/1.9 mm kept, D-41 stack confirmed; W6/W7 placeholder closed); design doc r9-16
    Source: Review 1/2: J102, J1-TSW, W6-W7 (local_923ffa1c-f985-43ad-8510-7faea2e5f5d7),
    chat 2026-11-13. LAYOUT_DECISIONS section 11 items 12, 14, 16 (header half)
    and 25 closed; D-41, D-45, D-46 amended; bare-board blockers now items 2, 3,
    5, 7 and 9 (Review 2/2). Cable wire gauge stays open (parts check).
2026-11-13 hardware: charger EVM r9 CR outline D-62 (operator ruling 2026-11-13, R9-04): edges at 0/30/45/60 deg, 1.0 mm fillets; finish re-run; package re-exported
    - cr_geometry: TRIM_ANGLES, TRIM_MIN_EDGE 2.0, FILLET 1.0, 10 corners
    (2327.7 mm2), MH2 (54.85, 68.79); P_FINAL filleted; angle/min-edge row.
    - trim_cr.py passes --angles/--min-edge/--fillet; reproduces the proposal
    from the routed board 621fb28 exactly.
    - Arc-aware outline in silk_refs.py and check_constraints.py
    (GetBoardPolygonOutlines); ear checked against the corners before fillets.
    - Finish by the routing session on the trimmed board: plane_vias --stitch
    2.5 (279), straighten (769 segments, 824.5 mm), stitch_gaps (3 vias).
    T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
2026-11-13 docs: Review 2/2 operator rulings recorded (BAV199 pinout and SOT23 footprint; VCHGIN strap on IPC-2152, 0.5 oz clad inner; OSH Park stack-up and 0.0508 mm mask; quote out of scope; inner pads assume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
    Source: Review 2/2: BAV199, strap, OSH Park (fab checks)
    (local_6e36c3a4-f328-44cd-8c31-05ea2fa7bfa3), chat 2026-11-13. Section 11 items
    9, 10 and the VCHGIN half of item 2 closed; item 5 stack-up/mask closed
    (drilled-vs-finished TSW hole stays open); item 7 out of scope; item 3 an
    assumption checked at submission. The VCHGOUT half of item 2 (3.21 A) stays
    open. Rule-file comments only (cr.kicad_dru identical to the rule file).
    C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
2026-11-13 docs: D-62 outline recorded; VCHGOUT path checked at 3.21 A (calc R9.H26: two short F.Cu necks fail the long-conductor IPC-2152 basis); IPC-2221 rows printed as comparisons; package README status line
2026-11-13 docs: operator ruling 2026-11-13 accepts the two short VCHGOUT F.Cu necks ("Accept short necks"); section 11 item 2 closed; no operator-review item blocks the CR bare-board order
2026-11-13 hardware/docs: CR order quantity 6 (operator ruling 2026-11-13: "Use 6"; OSH Park multiples of 3, E BOM 5)
2026-11-13 docs: CR routing study review material (outline change request, morning review, measurement scripts)
2026-11-13 docs: charger IC search for the custom charger board (2026-11-10) and its dossiers and review material
