Tangineering/DC-Balancer-Board-Teensy/(notices)

Notices in the files:
references/PCB Manufacturing Files/Scale Car Board BOM.txt:
1 470uF EEE-FN1V471UPCAP_FN_G_PAN EEE-FN1V471UPCAP_FN_G_PAN CAP_FN_G_PAN CAL Copyright (C) 2026 Ultra Librarian. All rights reserved. Panasonic EEE-FN1V471UP
2 AD5443YRMZ-REEL7RM_10_ADI AD5443YRMZ-REEL7RM_10_ADI RM_10_ADI MDAC-BT, MDAC-FC Copyright (C) 2026 Ultra Librarian.
1 BQ29200DRBTDRB8_1P6X2P4 BQ29200DRBTDRB8_1P6X2P4 DRB8_1P6X2P4 BAL Copyright (C) 2026 Ultra Librarian. All rights reserved. https://www.ti.com/lit/gpn/bq29200 Voltage Protection with Automatic Cell Balance For 2-Cell Li-Ion Batteries OVP=4.35V 8-SON -40 to 85 Texas Instruments BQ29200DRBT
2 OPA197IDD0008A-IPC_A OPA197IDD0008A-IPC_A D0008A-IPC_A OP-BT, OP-FC Copyright (C) 2026 Ultra Librarian. All rights reserved. https://www.ti.com/lit/gpn/opa197 Single 36-V precision rail-to-rail input output low offset voltage op amp 8-SOIC -40 to 125 Texas Instruments OPA197ID RefDes TYPE
1 SQP20AJB-47RRES_SQP20A_YAG SQP20AJB-47RRES_SQP20A_YAG RES_SQP20A_YAG R-SHUNT Copyright (C) 2026 Ultra Librarian. All rights reserved. Yageo SQP20AJB-47R
1 TL431BIDBZRDBZ0003A_N TL431BIDBZRDBZ0003A_N DBZ0003A_N U-SNT Copyright (C) 2026 Ultra Librarian. All rights reserved. https://www.ti.com/lit/gpn/tl431 Adjustable precision shunt regulator 3-SOT-23 -40 to 85 Texas Instruments TL431BIDBZR RefDes TYPE
docs/charger_bq25798_wiring_design_2026-11-05.md:
t); VREG/ICHG after expiry | Whether the charger WD can be cited at all | Charge at 1.6 A, stop kicking | stops in 0.4-1.0 s; EN_CHG reads 0 | Do not cite the charger WD (the heartbeat and R5 carry hangs)
pin38-39-adc-overvoltage-on-vmot-excursion (uncertainty) | cite the i.MX limits; accept with firmware ignore, or add a diode clamp; bench crosstalk test | accepted as an event-limited excursion with the FR-49 over-range rule (no decision for 5 ms after full scale), BAV199 clamp as the T-C-15 fail br
parts and their libraries:
AD5443YRMZ_REEL7: COPYRIGHT: Copyright (C) 2026 Ultra Librarian. All rights reserved.
